xfa273/nightfall-fw/tools/vision/README.md

# Video trajectory and turn-tuning tools

The operational design, current limitations, and hardware-side next steps are
documented in
[`docs/SMARTPHONE_TURN_TUNING.md`](../../docs/SMARTPHONE_TURN_TUNING.md).

Reusable tools in this directory are:

- `aruco_trajectory.py`: carried-ArUco reference extractor for the existing
  8×8 test board
- `markerless_trajectory.py`: fixed board markers plus blue centre and red front
  labels; no vehicle ArUco marker is used
- `extract_board_metric_lattice.py`: detects the full-board flush calibration
  dot lattice after four-marker frame registration
- `fit_board_metric_geometry.py` / `board_metric_geometry.py`: fit and apply a
  held-out-qualified canonical-pixel to board-mm map
- `verify_board_metric_geometry.py`: rejects a moved or changed rig by checking
  a new lattice observation against the qualified map
- `fit_front_label_heading.py`: fits the fixed image-space bias caused by a
  height difference between the two vehicle labels; local diagnostic only
- `label_plane_geometry.py`: validated ray/plane correction shared by fit,
  application, and downstream safety gates
- `fit_label_plane_camera.py`: fits fixed-camera centre/height from four
  stationary board-spanning poses plus one independent held-out pose
- `apply_label_plane_geometry.py`: creates blue-10-mm/red-2-mm corrected
  trajectories without overwriting the apparent reference-plane CSV
- `trajectory_calibration.py`: verifies the corrected trajectory and every
  bound board/tracking/camera-calibration SHA before safety analysis
- `desk_green_pair_probe.py`: raw-pixel feasibility probe that tracks the two
  separated green PCB regions before a marked maze fixture is available
- `generate_fixed_aruco_print_pack.py`: print-ready A4 PDF and vector SVG
  generator for the four fixed maze-plane markers
- `video_timing_qa.py`: checks encoded frame PTS cadence, gaps, and identical
  192-pixel-wide grayscale fingerprints of decoded neighbors
- `fuse_trace_video.py`: aligns video yaw rate or speed with a firmware trace
- `board_layout.py`: validates a measured fixed-marker/grid layout in mm
- `android_camera_probe/`: Camera2 capability probe, experimental HFR recorder,
  and Xiaomi stock-camera slow-motion collector
- `../tuning/turn_video_tune.py`: converts video endpoints to the firmware turn
  frame and prints a bounded candidate without editing source files

The Android real-time HFR recorder and framed F413 optical START/STOP protocol
are implemented. The Pixel classifies the complete synchronized five-slot
short/long codeword before applying the expected recorder state; markerless
body motion remains diagnostic rather than a hard gate.
Pixel 8 has passed a preview plus 1080p/240
manual-exposure recording trial with per-frame-rate CaptureResult metadata,
and both optical edges passed a stationary no-motor integration trial;
the tested Xiaomi 13 Ultra firmware rejects all public Camera2 constrained-HFR
sessions.
The more-than-four-marker solver, multi-LED solver, session-wide QA runner,
trace-phase segmentation, and whole-path fitter are not implemented yet.

## Host setup and timing QA

FFmpeg supplies frame PTS and ADB is used for the static Android probe.
Create the persistent, Git-ignored Python environment with:

```sh
brew install ffmpeg
brew install --cask android-platform-tools
tools/vision/setup_host.sh
```

The Android build additionally needs JDK 17, Android command-line tools, API
36, and build-tools 36.0.0.

The probe additionally needs SDK packages `platforms;android-36` and
`build-tools;36.0.0`; see
[`android_camera_probe/README.md`](android_camera_probe/README.md).

Check an expected real-time 120 fps file before pose extraction:

```sh
./.venv-vision/bin/python tools/vision/video_timing_qa.py \
  /path/to/capture.mp4 \
  --expected-fps 120 \
  --fps-tolerance-percent 1.0 \
  --maximum-gap-rate 0.001 \
  --maximum-cadence-deviation-percent 10 \
  --maximum-cadence-deviation-rate 0.001 \
  --maximum-content-duplicate-rate 0.001 \
  --report-json /path/to/timing_report.json
```

This checks encoded PTS, both short and long cadence deviations, and exact
equality of decoded frames after resizing them to at most 192 pixels wide and
converting them to grayscale. It is not a full-resolution, full-colour byte
comparison. It cannot prove sensor capture rate or detect all duplicated,
interpolated, or retimed frames. A production recorder must save sensor
timestamp, frame duration, exposure, ISO, rolling-shutter skew, and the
encoded-PTS mapping in a sidecar.

For the Xiaomi stock-camera fallback, use:

```sh
tools/vision/android_camera_probe/collect_stock_slowmo.sh \
  "$SERIAL" /path/to/session-artifacts
```

The collector waits for a new stock Camera MP4, validates the
`com.android.capture.fps` tag, and runs the same timing/content QA. The tested
1080p/240 Xiaomi clip contained 2,823/2,823 valid decoded frames, measured
239.981 fps median PTS cadence, no large PTS gaps, and no identical adjacent
decoded frames.

## Unmarked desk feasibility probe

Before the marked maze fixture is ready, a short hand-moved desk clip can
check whether the green PCB remains visible:

```sh
./.venv-vision/bin/python \
  tools/vision/desk_green_pair_probe.py /path/to/stock_hfr.mp4 \
  --output-dir /path/to/desk-probe \
  --render-fps 60
```

The current Nightfall body presents two separated green PCB components. The
probe pairs them using component area, rigid separation, and motion prediction;
their midpoint is the raw-pixel position and their line is an undirected
heading. The desk test on Xiaomi 13 Ultra tracked all 2,823 frames even with a
hand partly occluding the mouse. Median pair separation was 148.6 px.

Outputs are `trajectory_image_px.csv`, `trajectory_image_px.png`, an optional
annotated MP4, and `desk_green_pair_report.json`. These values have no metric
scale, board homography, lens correction, or absolute front/back direction.
They prove visibility only. Use fixed perimeter markers and
`markerless_trajectory.py` for maze measurements.

## Markerless vehicle pose

`markerless_trajectory.py` never detects a carried ArUco ID. Its current
pipeline is:

1. per-frame rectification from the fixed board markers;
2. a narrow blue-colour mask for the 8 mm circular vehicle-centre label;
3. expected metric area, circularity, and temporal prediction to distinguish
   the label from the bluer optical START/STOP LEDs;
4. an 8 mm red label 24 mm in front of the blue label, with expected area,
   baseline, circularity, and temporal prediction to reject red walls and the
   rear status LED;
5. the directed blue-to-red vector as the primary heading measurement;
6. a 41-frame temporal-median background plus the green PCB to estimate the
   body silhouette;
7. the legacy red body-centroid cue and gated foreground principal axis as
   heading fallbacks.

### Full-board metric calibration

The four outer markers are a registration frame, not by themselves a dense
metric calibration. A homography can make all four marker centres exact while
the interior remains wrong because of a measured-layout scale error, lens
distortion, or a non-flat support. This failure was observed on the current
8x8 rig: four ruler-placed blue-label positions were reported 26--30 mm inward
near the corners. The cause was then measured directly with the 90 mm
orthogonal centre-line grid: marker IDs 6/4/5/7 lie on the four outer grid
intersections, so their centres span 720 mm, not the previously declared
780 mm. `board_layout_8x8_60mm.json` now records ID6=(0,0), ID4=(720,0),
ID5=(0,720), and ID7=(720,720) mm. Artifacts bound to the earlier layout SHA
are intentionally invalidated and remain diagnostic-only.

The permanent orthogonal lines provide a quick repeatable distortion check:

```sh
./.venv-vision/bin/python tools/vision/probe_board_line_grid.py \
  path/to/empty-board.mp4 \
  --board-layout tools/vision/data/board_layout_8x8_60mm.json \
  --output-dir path/to/line-grid-probe
```

The tool fixes the ambiguous outer chalk-line peaks to the four detected
marker centres, measures the seven interior lines and local pitch across the
field, and reports global scale separately from residual non-uniformity. Its
residual includes hand-drawn-line error, board flatness, and detector error;
it is a diagnostic and does not by itself produce a safety-qualified metric
map.

Install a distributed reference pattern before using the camera for absolute
turn clearance. The preferred permanent pattern is one matte white circular
mark, 8 mm diameter, centred in every 90 mm half-cell: `(45+90*i,45+90*j)` mm
for `i,j=0..7`. Use a flush vinyl/paint/inlay surface; a raised calibration
piece changes parallax and must declare its measured absolute height. Cell
centres stay 45 mm from maze walls and are less likely to merge with white wall
tops than boundary lines. Periodic lines can also work, but equal lines have
ambiguous correspondences, are occluded by walls, and their elevated wall-top
edges are not coplanar. If lines are used, retain the four unique ArUco anchors
and add indexed/double marks so every detected intersection has a unique grid
coordinate.

Capture one stationary, empty-board 0.5.7 clip without moving the camera or
outer markers. Extract at least 32 of the 64 dots, including at least eight
automatically reserved held-out points:

```sh
./.venv-vision/bin/python tools/vision/extract_board_metric_lattice.py \
  path/to/lattice.mp4 \
  --board-layout tools/vision/data/board_layout_8x8_60mm.json \
  --output-csv path/to/board_metric_observations.csv
```

Inspect the generated overlay: every label must name the actual cell centre.
Then copy `tools/vision/data/board_metric_fit_manifest.template.json`, point it
at the observations, set the physical reference-plane height, and fit:

```sh
./.venv-vision/bin/python tools/vision/fit_board_metric_geometry.py \
  path/to/board_metric_fit_manifest.json \
  --output path/to/board_metric_geometry.json
```

The output is safety-qualified only with 32+ full-board points, 8+ independent
held-out points, fit p95 <=0.75 mm, held-out p95 <=1.0 mm, and held-out maximum
<=1.5 mm. Four corner mouse placements are useful for diagnosing the present
scale error but cannot qualify this map. Pass the qualified artifact to normal
extraction:

```sh
./.venv-vision/bin/python tools/vision/markerless_trajectory.py \
  path/to/capture.mp4 \
  --board-layout tools/vision/data/board_layout_8x8_60mm.json \
  --board-metric-geometry path/to/board_metric_geometry.json \
  --position-source label --label-colour blue \
  --front-label-colour red --cue-colour none
```

The corrected `x_mm/y_mm` and their derivatives then come from the dense map;
canonical pixels remain in the CSV for audit. Add the same
`board_metric_geometry` path to the known-pose label-plane manifest and pass
`--board-metric-geometry` to `apply_label_plane_geometry.py`. Metric mapping
must be qualified before the 10/2 mm label-height fit; otherwise camera-plane
parameters absorb a board scale error and become physically meaningless.
If the dots remain on the maze, extract them from an empty/background clip
after any camera or maze handling and compare against the stored map:

```sh
./.venv-vision/bin/python tools/vision/verify_board_metric_geometry.py \
  path/to/board_metric_geometry.json \
  path/to/current_board_metric_observations.csv \
  --output-json path/to/board_metric_verification.json
```

This requires 32 matched points including eight held out and rejects p95 above
1.0 mm or maximum error above 1.5 mm. Treat failure as a moved rig/board/marker
or damaged pattern and recalibrate before accepting trajectories.

For a future removable target, a rigid ChArUco/dot plate covering the full
board is preferable to hand-drawn lines. It must lie on a measured plane and
the rig must not move after removal. A dedicated low-distortion global-shutter
camera is the next hardware step if calibrated Pixel data still fail the 1 mm
held-out gate; it reduces rolling-shutter and focus-breathing risk, but does not
remove the need for the same full-board calibration.

The blue label is the default position source. Its position and the two-label
heading stay valid even when green-PCB or body extraction fails. This is still
not a general colour tracker: the HSV/channel gates were measured for the
current Pixel 8 exposure, lighting, and labels. Revalidate them after changing
label material, camera processing, or illumination. Maximum yaw rate gates
`heading_valid` independently of position validity. `qa_report.json` records
both label detection rates, areas, observed baseline, selected heading source,
and the applied heading calibration.

The measured `mini_r2_0_unit001` label surfaces are not coplanar: the blue
centre label is 10 mm above the maze floor and the red front label is 2 mm
above it. The old homography reference was the 3D-printed ArUco top surface,
also 2 mm above the floor; it left red unchanged but displaced blue. The new
dense board metric reference is the flush maze floor at 0 mm, so both red and
blue are corrected from their measured 2/10 mm planes. The blue-to-red yaw
error changes across the field of view. `fit_front_label_heading.py` can still fit an older constant
image-space bias, but that result is a local diagnostic only. Do not apply it
in the absolute position/yaw or swept-clearance workflow below.

For full-board correction, use the measured heights and a stationary known-pose
calibration. The current 3D-printed ArUco markers have a user-confirmed common
top surface 2.0 mm above the maze floor, but they are registration anchors only.
With flush painted/inlaid lattice dots, set the qualified board-metric reference
plane to the maze floor at 0.0 mm; the red label is corrected by 2.0 mm and the
blue label by 10.0 mm. A raised removable target must instead declare its own
measured absolute height. Keep the camera
and markers fixed, then record at least five stationary poses spanning the
camera field. A practical 8x8 set is:

- fit: blue centre `(45,45)` mm, heading `0 deg`;
- fit: `(675,45)` mm, heading `180 deg`;
- fit: `(45,675)` mm, heading `0 deg`;
- fit: `(675,675)` mm, heading `180 deg`;
- held-out validation: `(315,405)` mm, heading `90 deg`.

Use a placement jig so the blue centre and cardinal heading are known. The
poses may be non-overlapping holds in one continuous video or five independent
manual one-shot captures. Every pose must be held still for at least three
seconds and its `start_s`/`end_s` interval must be recorded. Use the
same fixed camera, marker layout, Camera2 physical lens/crop/zoom, fixed
1.05-diopter focus, and recording profile as the runs the calibration will
qualify. Absolute qualification requires HFR Recorder 0.5.7 or newer. Recorder
0.5.6 introduced much of the Camera2 geometry metadata, but it does not satisfy
the final same-run SHA/integrity and fixed-focus contract; 0.5.6 and earlier
captures remain diagnostic-only. A qualified 0.5.7 capture must report AF off,
the requested 1.05-diopter focus, stationary and unchanged per-frame lens
metadata, and a matching camera-setup fingerprint.
The manifest schema is `nightfall_label_plane_known_pose_manifest_v3`; it names
the committed board layout, the measured footprint/tracking geometry, the
absolute ArUco reference-plane height, each trajectory interval, and the
`nightfall_camera_capture_session_v1` artifact set used to prove the camera,
physical lens, crop, zoom, raw video, QA, and source trajectory are coherent.
Fit the camera geometry with:

```sh
./.venv-vision/bin/python tools/vision/fit_label_plane_camera.py \
  path/to/known_pose_manifest.json \
  --output path/to/label_plane_geometry.json
```

Copy `tools/vision/data/label_plane_known_pose_manifest.template.json`, replace
the qualified `board_metric_geometry`, the six paths in every placement's
`capture_session`, its matching trajectory, and the five time windows. Its
0.0 mm reference is valid only for a flush floor pattern. If separate captures are used, all five
fingerprints must have the same `camera_setup_sha256`; the fit fails closed on
any camera, lens, focus, crop, zoom, or recording-profile difference. Start each
0.5.7 manual one-shot first, wait at least one second for the fixed-focus camera
pipeline and scene to settle, and only then begin its three-second pose hold.

The fit requires four spatially distinct non-collinear positions spanning at
least 400 mm in both axes and 120000 mm² of convex-hull area, plus an independent
held-out position inside that hull. It fails closed unless stationary
stability, fit residual, and held-out error are
within the recorded limits. It implements the ray/plane relationship
`P=C+(H-h)/(H-h_ref)*(Q-C)` separately for blue and red. The committed board
layout corresponding byte-for-byte to the current 60 mm-marker setup is
`tools/vision/data/board_layout_8x8_60mm.json`.

After qualification, existing trajectory CSVs can be corrected without
decoding their videos again because they retain both rectified label centres:

```sh
./.venv-vision/bin/python tools/vision/apply_label_plane_geometry.py \
  path/to/trajectory.csv \
  --board-layout tools/vision/data/board_layout_8x8_60mm.json \
  --board-metric-geometry path/to/board_metric_geometry.json \
  --tracking-geometry tools/tuning/data/mini_r2_0_footprint.json \
  --label-plane-geometry path/to/label_plane_geometry.json \
  --capture-session-manifest path/to/this_run_capture_session.json \
  --confirm-unchanged-camera-board-setup
```

This writes a new `*_height_corrected.csv` and a hash-bound calibration
sidecar; it never overwrites the apparent reference-plane trajectory.
Parameter proposals and absolute-clearance checks require the matching
sidecar. The capture-session manifest binds and revalidates this run's report,
Camera2 rows, raw video, QA, trajectory, and board calibration. The report's
artifact-integrity SHA-256 values must identify the same-run raw video and
Camera2 sidecar, QA must bind that video and trajectory, and every referenced
artifact is independently hash-bound by the capture fingerprint. Its physical
camera/lens/crop/zoom/fixed-focus setup fingerprint must match the stationary
calibration.
Repeat the stationary calibration after moving the camera or markers, changing
crop or lens selection, or changing either label height. The confirmation
option remains an explicit assertion that the rigid camera-to-board pose was
not moved; metadata can prove the camera configuration but not that physical
rig transform by itself. Do not use it across a moved rig.

For a parameter proposal, all five repeats must use height-correction sidecars
that bind the same board layout, tracking geometry, and label-plane geometry.
The proposal path fixes the tracked anchor at zero (the blue centre is the
machine/turn centre) and does not allow its five-repeat, valid-fraction,
repeatability, or bounded-step limits to be weakened from the command line.

Without `--background-video`, the median background assumes that the vehicle
does not occupy the same pixel in half or more of the sampled run frames.
Prefer a separate empty-maze clip captured with unchanged camera/exposure.

The legacy fixed-marker transform is specific to the existing test board:

- IDs 5, 7, 4, and 6 are top-left, top-right, bottom-right, and bottom-left.
- Only 5, 4, and 6 enter the homography. ID 7 is detection-count QA only.
- Marker centers are assumed to form a square, all markers have the same
  orientation and size, and with the defaults the black-side/center-span ratio
  must be about 4.95%.

Do not place arbitrary perimeter markers and treat the legacy transform as
metric. New setups should copy and then replace the measured values in
`board_layout_4x4_example.json`. Its `nightfall_vision_board_layout_v1` schema
maps marker center, black-side length, rotation, and the analysis grid in mm.
With a measured layout and all four markers visible, the solver uses the four
marker centres. This prevents frame-to-frame switching between incompatible
corner and centre fits in the presence of lens distortion. If a measured
marker is hidden, the bounded fallback first attempts a corner RANSAC with at
least three markers. Legacy mode still uses IDs 5, 4, and 6 for homography and
treats ID 7 as QA-only.
Coordinates are +x right and +y forward/up in the rectified view. At
`rotation_deg: 0`, every printed marker's top edge faces +y and its top edge
runs left-to-right along +x; positive rotation is counter-clockwise in the
maze plane. `canvas_bounds_mm` must be square because the canonical output uses
one metric scale on both axes.

The example's `-55..775 mm` bounds are an 830 mm analysis crop, not a paper
edge, fixture edge, or required-FOV edge. The outer black marker edges reach
`-50..770 mm`. Provide at least 7 mm of white quiet zone outside them; 10 mm is
recommended, giving an approximately 840 mm physical visible span. Add vehicle
travel and placement margin beyond that when selecting the camera FOV.

Generate the fixed-marker print pack with:

```sh
./.venv-vision/bin/python tools/vision/generate_fixed_aruco_print_pack.py
```

The A4 PDF has a recommended 60 mm black-side page and a compact 40 mm page.
Print exactly one page at `100%` / `Actual Size`; do not mix sizes. Verify the
printed 100 mm scale line and measure the black outer square. The four distinct
`DICT_4X4_50` markers are ID 5 top-left, ID 7 top-right, ID 4 bottom-right, and
ID 6 bottom-left. Keep at least the supplied white quiet zone and place all
four marker faces coplanar. The current 3D-printed set has a measured common
top-surface height of 2.0 mm above the maze floor; use 2.0 mm as the label-plane
reference height. A paper/flush marker or a changed fixture requires a new
height measurement and stationary calibration.

For 1080-pixel short-side video, aim for at least 40 pixels across a marker's
black side:

```text
black_side_mm >= visible_short_span_mm * 40 / 1080
```

Thus, 60 mm is suitable up to about a 1.5 m visible short-side span. A wider
view, such as a complete full-size 16x16 maze, needs larger markers and a
different print layout.

For a measured 4×4 setup, run:

```sh
./.venv-vision/bin/python \
  tools/vision/markerless_trajectory.py /path/to/capture.mp4 \
  --board-layout /path/to/board_layout.json \
  --background-video /path/to/empty_background.mp4 \
  --position-source label \
  --label-colour blue \
  --label-diameter-mm 8 \
  --front-label-colour red \
  --front-label-diameter-mm 8 \
  --front-label-distance-mm 24 \
  --cue-colour none \
  --maximum-missing-fraction 0.01
```

This command produces the apparent reference-plane trajectory. For absolute
analysis, do not add the legacy constant-bias calibration; run the qualified
five-pose fit and `apply_label_plane_geometry.py` workflow above instead.

For a one-label position-only analysis, set `--front-label-colour none` and add
`--position-only`. That mode exports any fallback heading but does not make an
unreliable foreground heading accurate. A two-label run does not require the
empty-maze background for its primary position and heading; the background is
still useful for body/fallback diagnostics.

In legacy mode without `--board-layout`, `--grid-cells` is the number of
visible analysis-grid pitches, not the nominal cell count of the complete
maze. A view containing 4×4 standard 180 mm cells has eight 90 mm pitches and
uses `--grid-cells 8 --cell-size-mm 90 --cell-size-confirmed`.

`--cue-yaw-offset-deg` must be calibrated for the chosen cue. The anchor passed
to `turn_video_tune.py` has the direction **control reference to tracked
point**, resolved along the vehicle-right and vehicle-forward axes. For a cue
23 mm behind the control reference, use `--anchor-forward-mm -23`, not `+23`.

Use `--position-source green` when the foreground silhouette touches maze
walls and its centroid becomes biased. This tracks the green-PCB centroid and
still uses the foreground principal axis for cue-less heading. The PCB centroid
is not the vehicle control reference, so measure its fixed right/forward offset
and pass the corresponding anchor correction to downstream turn analysis.

For a rigidly mounted camera, a hand may briefly hide multiple board markers
while starting the vehicle. In that case, set both
`--maximum-consecutive-homography-fallback-frames` and
`--maximum-homography-fallback-fraction` to explicit bounded values. The
tracker reuses the last marker-supported transform during that interval. Keep
the default five-frame consecutive limit when the camera can move.

The board transform alone does not remove lens distortion or height parallax.
The qualified label-plane workflow above corrects the measured 10/2 mm height
planes and uses full-board fit plus held-out residual gates; any residual lens
distortion is included in those measured errors and the downstream position
uncertainty. A future explicit lens-undistortion stage must be recalibrated as
a different pipeline rather than mixed with an existing geometry artifact.

On `IMG_1592.mov`, fixed board markers were the only pose-estimation markers and
ID 3 was used only as post-hoc ground truth. The prototype tracked all 515
frames; a stationary calibration followed by active-run hold-out evaluation
gave about 6.3 mm position RMSE and 4.0 degrees yaw RMSE. This 720p/30 fps
one-video result establishes feasibility only and does not meet the intended
automatic-tuning gate: its detected start pose window has a 21.4 mm/s median
speed and is rejected by the default 10 mm/s stationarity limit.

## Trace alignment

Align one short, distinctive turn and require the stricter operational
correlation gate:

```sh
./.venv-vision/bin/python \
  tools/vision/fuse_trace_video.py \
  /path/to/trajectory.csv /path/to/trace.csv \
  --minimum-correlation 0.70 \
  --yaw-sign same \
  --minimum-correlation-margin 0.02 \
  --output-dir /path/to/analysis/fused
```

The output is `/path/to/analysis/fused/fused.csv` plus
`sync_report.json`. The fused CSV keeps every source trace CSV data row and
column, then adds the video measurements. Parsed `#key=value` comment metadata
is stored in `sync_report.json`; blank lines, other comments, and comment order
are not copied to `fused.csv`. Inspect the selected offset, `video_sign`,
second peak margin, signal gain, bias, and RMSE as well as correlation. The
default expects both Nightfall and video yaw to be CCW-positive. An inverted
sign is a calibration failure, not permission to proceed.

Repeated similar turns can produce an ambiguous correlation peak. Motion
correlation is a provisional synchronizer; start/end LED patterns tied to
firmware ticks are the planned robust synchronizer.

## Endpoint candidate

The current candidate tool uses final position and yaw only. It does not use
the fused trace, path shape, duration, or trace phase in the fit.

Use five identical dedicated trials whose motion boundaries match the turn
model and have at least 150 ms of stationary pose before and after. Do not use
an unsegmented run containing approach/exit straights or multiple turns.
The command below hard-gates each 150 ms pose window at 80% time coverage
(at least 120 ms of samples) and at a median speed no greater than 10 mm/s.
These gates do not replace the requirement to record the full stationary
period.

```sh
./.venv-vision/bin/python \
  tools/tuning/turn_video_tune.py \
  trial01/trajectory_height_corrected.csv \
  trial02/trajectory_height_corrected.csv \
  trial03/trajectory_height_corrected.csv \
  trial04/trajectory_height_corrected.csv \
  trial05/trajectory_height_corrected.csv \
  --height-correction-sidecar \
    trial01/trajectory_height_corrected.calibration.json \
  --height-correction-sidecar \
    trial02/trajectory_height_corrected.calibration.json \
  --height-correction-sidecar \
    trial03/trajectory_height_corrected.calibration.json \
  --height-correction-sidecar \
    trial04/trajectory_height_corrected.calibration.json \
  --height-correction-sidecar \
    trial05/trajectory_height_corrected.calibration.json \
  --runner shortest --mode 2 --code 501 \
  --anchor-forward-mm 0 --anchor-right-mm 0 \
  --minimum-valid-fraction 0.99 \
  --minimum-heading-valid-fraction 0.99 \
  --maximum-pose-window-speed-mm-s 10 \
  --minimum-pose-window-coverage 0.8 \
  --minimum-fit-trials 5 \
  --maximum-endpoint-std-mm 2.0 \
  --maximum-yaw-std-deg 1.0 \
  --maximum-turn-yaw-error-deg 30 \
  --vary angle \
  --propose-fit --feedback-gain 0.5 \
  --report-json turn_report.json
```

The zero anchor is exact for the user-confirmed blue label at the coincident
machine/turn centre. `--vary angle` intentionally overrides the fitter's
multi-parameter default for the first staged tuning pass. The fitter prints an
experiment candidate only. It does not edit params, build, flash, spin the fan,
or start a run. Any floor/maze trial requires explicit authorization for that
specific motion under
`docs/ai/HIL_SAFETY.md`.

When unequal label heights make heading depend on board position, trials with
long initial and final straights can instead use `--heading-source trajectory`.
It fits the ordered centre-label path over cumulative-distance fractions
8--32% and 68--92%. The default gates require at least 30 mm projected span and
at most 3 mm p95 perpendicular residual in both fits. Curved or corrupted fit
windows are rejected. This mode uses position only and therefore requires both
anchor offsets to remain zero.

## Carried-ArUco reference extraction

`aruco_trajectory.py` extracts a mouse trajectory from an overhead video of
the Nightfall 8×8 tracking board.

The default layout is:

- ID 5: board top-left
- ID 7: board top-right
- ID 4: board bottom-right
- ID 6: board bottom-left
- ID 3: marker carried by the mouse

The fixed markers provide a per-frame planar transform, so camera drift and
perspective do not appear as mouse motion. The carried marker is tracked from
its known ArUco bit pattern. Green PCB pixels are used only to constrain the
initial search and any low-confidence recovery search.

The transform consistently uses IDs 5, 4, and 6, which span the board and are
readable throughout the supplied recording. ID 7 is still detected and drawn
for QA, but is not mixed intermittently into the transform because glare makes
its detection much less stable.

## Setup

```sh
tools/vision/setup_host.sh
```

## Run

Without a known physical scale:

```sh
./.venv-vision/bin/python tools/vision/aruco_trajectory.py \
  /path/to/video.mov
```

With a 90 mm grid pitch that has not been independently measured:

```sh
./.venv-vision/bin/python tools/vision/aruco_trajectory.py \
  /path/to/video.mov \
  --cell-size-mm 90
```

Add `--cell-size-confirmed` only when the pitch has been measured or otherwise
confirmed. Cell coordinates remain available regardless of metric scale.

The coordinate system has its origin at the bottom-left grid intersection,
with +x to the right and +y upward. Yaw is zero toward +x and increases
counter-clockwise. The default `--yaw-offset-deg 90` matches the ID 3 mounting
in `IMG_1592.mov`; use the measured marker-to-vehicle rotation for other
mountings. The reported position is the marker center, not a separately
calibrated geometric vehicle center.

## Outputs

The default output directory is `<video stem>_trajectory` beside the input:

- `trajectory.csv`: raw and smoothed positions, yaw, velocity, marker score,
  fixed-marker IDs, and homography residual
- `trajectory.png`: time-colored top-view path
- `trajectory_overlay.mp4`: trajectory over the source view
- `trajectory_topview.mp4`: stabilized top view with the trajectory
- `reference_topview.png`: stabilized reference frame
- `calibration.json`: marker/grid coordinate mapping
- `qa_report.json`: detection rates and trajectory quality metrics

Metric columns in the CSV are blank unless `--cell-size-mm` is supplied.
If the local OpenCV build cannot encode MP4, the two videos use `.avi`
instead; `qa_report.json` always records the actual filenames.

Generated CSV, image, JSON, and video files are run artifacts and should stay
outside Git. Only the reusable files under `tools/vision/` belong in the
repository.

## Notes

- The detector uses OpenCV `DICT_4X4_50`. Larger OpenCV 4×4 dictionaries share
  these low-numbered code words, so the exact dictionary used to print the
  markers cannot be inferred from the video alone.
- The planar transform removes camera motion but does not model lens
  distortion. If sub-millimetre accuracy is required, calibrate the camera and
  undistort frames first.
- `--no-videos` skips the two MP4 renders when only numeric output is needed.
