xfa273/nightfall-fw/_sandbox/f413_preorder/README.md

# _sandbox/f413_preorder

このディレクトリは実験・作業途中データの退避用です。

正式な参照先は以下です。

- ハードウェア資料: `hardware/mini_r2_0/`
- F413 CubeMX/platform 素材: `platform/stm32f413/HM_Nightfall_f413_preorder/`

以後の更新は上記の正式ディレクトリ側で実施してください。
