xfa273/nightfall-fw/_sandbox/f413_preorder/cubemx_project/README.md

# _sandbox/f413_preorder/cubemx_project

この配下は旧配置（互換保持）です。

正式な更新先は `platform/stm32f413/HM_Nightfall_f413_preorder/` です。
