xfa273/nightfall-fw/_sandbox/f413_preorder/notes/README.md

# _sandbox/f413_preorder/notes

この配下は旧配置（互換保持）です。

正式な更新先は `hardware/mini_r2_0/` の `cad/` と `notes/` です。
