xfa273/nightfall-fw/hardware/mini_r2_0/notes/kicad/README.md

# KiCad migration notes for mini_r2_0

`HM_Nightfall-mini-2e_v1` を KiCad 10.0.3 で Eagle から初回インポートした結果を保存します。

## 生成ファイル

- `cad/kicad/HM_Nightfall-mini-2e/HM_Nightfall-mini-2e_v1.kicad_pro`
- `cad/kicad/HM_Nightfall-mini-2e/HM_Nightfall-mini-2e_v1.kicad_sch`
- `cad/kicad/HM_Nightfall-mini-2e/HM_Nightfall-mini-2e_v1.kicad_pcb`
- `cad/kicad/HM_Nightfall-mini-2e/HM_Nightfall-mini-2e_v1-eagle-import.kicad_sym`
- `cad/kicad/HM_Nightfall-mini-2e/sym-lib-table`

## 初回チェック結果

- ERC: 46 errors / 88 warnings
- DRC: 544 errors / 306 warnings
- JLCPCB 向けルール適用後 DRC: 4 errors / 112 warnings
- 本体基板は Eagle 原本の `GND` / `GND2` ポリゴンを KiCad ゾーンとして復元済みです。

## JLCPCB 発注データ

- 2026-09-21に本体基板の取付穴4か所をØ1.6 mmへ変更し、周辺配線を調整しました。[更新後の発注用ZIP・加工図](../../cad/export/jlcpcb/main_mount_1p6_20260921/README.md) を使用してください。以下の20260606候補は変更前です。詳細は [MAIN_MOUNT_HOLES.md](MAIN_MOUNT_HOLES.md) を参照してください。
- 旧 Eagle 発注済み Gerber: `cad/export/reference/eagle_ordered_2026-03-22/HM_Nightfall-mini-2e_v1_eagle_ordered_2026-03-22.zip`
- KiCad 正式候補 Gerber: `cad/export/jlcpcb/HM_Nightfall-mini-2e_v1_kicad_jlcpcb_candidate_20260606/HM_Nightfall-mini-2e_v1_kicad_jlcpcb_candidate_20260606.zip`
- Eagle 参照アーカイブ: `cad/export/reference/eagle_archive_20260606/mini_r2_0_eagle_sources_20260606.zip` / `mini_r2_0_eagle_exports_20260606.zip`
- KiCad 正式候補は JLCPCB Gerber Viewer で旧 Eagle 発注データと比較し、外形・穴・主要配線・旧 `GTO` 相当のトップシルクが概ね一致することを確認済みです。
- Eagle 参照アーカイブには、本体基板・左右エンコーダ基板・ST-LINK変換基板・UART変換基板の Eagle 原本、CAM出力、ドリル、ネットリスト、部品表、ボード画像を保存しています。

## レビュー方針

- 初回インポート直後の ERC/DRC 違反は変換レビュー対象として残します。
- 回路図では未接続ピン、未解決テキスト変数、電源駆動、フットプリントライブラリ参照を優先確認します。
- PCBではクリアランス、外形、GNDポリゴン、モータドライバ周辺、SWD/UART、IMU/FRAM SPI2 周辺を優先確認します。
- レビュー完了までは Eagle 原本を併存させます。
- 詳細な分類と優先度は `REVIEW.md` に記録します。

## サブ基板

### 2026-09-21: エンコーダ端子の半穴化

左右エンコーダ基板のKiCad PCBを編集正として、端の4端子を
Ø0.30 mmのめっき半穴と表裏ランドへ変更しました。
外形を維持するための特殊加工案です。寸法、DRC差分、製造照会条件は
[ENCODER_CASTELLATED_PADS.md](ENCODER_CASTELLATED_PADS.md)を参照してください。
以下の初回レポートとEagleアーカイブは変更前の記録です。

以下の Eagle 原本は本体基板とは独立した小基板として、KiCad でも 1 基板 1 プロジェクトで管理します。

| 用途 | Eagle 原本 | KiCad 出力先 |
| --- | --- | --- |
| 左エンコーダ基板 | `cad/eagle/HM_Nightfall-mini-2e_Encoder-PCB-L_v1.sch` / `.brd` | `cad/kicad/HM_Nightfall-mini-2e_Encoder-PCB-L/` |
| 右エンコーダ基板 | `cad/eagle/HM_Nightfall-mini-2e_Encoder-PCB-R_v1.sch` / `.brd` | `cad/kicad/HM_Nightfall-mini-2e_Encoder-PCB-R/` |
| ST-LINK 変換基板 | `cad/eagle/STLink-Adapter.sch` / `.brd` | `cad/kicad/STLink-Adapter/` |
| UART 変換基板 | `cad/eagle/UART-Adapter.sch` / `.brd` | `cad/kicad/UART-Adapter/` |
| WeAct 5 V変換基板 | ST-LINK変換基板から派生 | `cad/kicad/WeAct-Adapter-5V/` |

### 左エンコーダ基板 初回チェック結果

- ERC: 7 errors / 7 warnings
- DRC: 12 errors / 13 warnings
- JLCPCB 向けルール適用後 DRC: 10 errors / 0 warnings

### 右エンコーダ基板 初回チェック結果

- ERC: 6 errors / 7 warnings
- DRC: 5 errors / 12 warnings
- JLCPCB 向けルール適用後 DRC: 10 errors / 0 warnings

### ST-LINK 変換基板 初回チェック結果

- ERC: 3 errors / 5 warnings
- DRC: 40 errors / 6 warnings
- JLCPCB 向けルール適用後 DRC: 0 errors / 26 warnings

### UART 変換基板 初回チェック結果

- ERC: 4 errors / 8 warnings
- DRC: 39 errors / 35 warnings
- JLCPCB 向けルール適用後 DRC: 0 errors / 26 warnings

### WeAct 5 V変換基板 チェック結果

- KiCad 10.0.3で設計
- ERC: 3 errors / 6 warnings（Eagleインポート由来の既知事項）
- DRC: 0 errors / 26 warnings、未配線0（警告数はST-LINK変換基板と同じ）
- 発注用Gerber: `cad/kicad/WeAct-Adapter-5V/fabrication/WeAct-Adapter-5V-gerbers.zip`
