xfa273/nightfall-fw/docs/blog/machines/nightfall-air-2025/README.md

# Nightfall-Air (2025)

## 写真

（ここに写真を挿入）

## スペック

| 項目 | 内容 |
| --- | --- |
| 機体名 | Nightfall-Air |
| 主な大会結果 | （編集してください） |
| 寸法 | （編集してください） |
| 重量 | （編集してください） |
| モータ | （編集してください） |
| バッテリ | （編集してください） |
| マイコン | （編集してください） |
| IMU | （編集してください） |
| モータドライバ | （編集してください） |
| 紹介記事 | （関連する記事リンクを追記してください） |

## コメント

（ここにコメントを記載）
