xfa273/nightfall-fw/hardware/mini_r2_0/cad/export/jlcpcb/main_mount_1p6_20260921/README.md

# 本体基板 発注用データ（取付穴 Ø1.6 mm、2026-09-21）

`HM_Nightfall-mini-2e_v1` の取付穴4か所をØ1.6 mmに変更した基板製造用データです。

- [発注用ZIP](HM_Nightfall-mini-2e_v1_mount-1p6_order_20260921.zip)
- [加工図PDF（ZIPにも同梱）](HM_Nightfall-mini-2e_v1_mount-1p6_fabrication.pdf)

発注先へ提出するファイルは上記ZIPです。20260606版の本体発注候補ZIPを置き換えるものです。
左右Encoder基板のZIPとは混ぜず、別の基板設計として提出してください。
単板の裸基板データで、面付け・実装BOM・実装座標・ペースト層は含みません。

## 内容物（14ファイル）

- Gerber 7層: 表裏銅箔、表裏レジスト、表裏シルク、外形
- Excellon 2ファイル: めっき穴199個、非めっき穴Ø0.9 mmを2個
- `-job.gbrjob`: レイヤー対応・基板設定
- `docs/` 内: 加工図PDF、英語加工指定、出力元・SHA-256を記録したmanifest
- `SHA256SUMS.txt`: 内容物のチェックサム

**Ø1.6 mmの取付穴4個は、非めっきの内形として外形Gerberに含まれます。**
Excellonには含まれないため、ドリル穴数へ重複して追加しないでください。
上側2穴と基板端の残り幅は各0.20 mmです。この寸法と加工時の保持条件を
同梱の加工図・英語指定文で発注先へ伝えます。

## 発注設定

- 2層FR-4、外形の概寸39 × 70 mm、元PCBの板厚設定は1.60 mm。
- 銅厚・レジスト色・表面処理は発注時に指定してください。jobの銅厚35 µmは
  KiCadの既定値、`Finish: None` は表面処理未指定を表します。
- 表シルクは以前の発注候補で確認済みのEagle由来データを、そのまま継承しています。
  裏シルクは空です。KiCadインポート時の大きな部品参照番号は使っていません。
- 全レイヤーは共通の絶対原点です。裏面を個別に反転しないでください。

## 出力元と検証

- ソースcommit: `e2ba19b74438`。PCB、プロジェクト、ルール、継承シルクの
  元ファイルパス・SHA-256はZIP内の `docs/SOURCE_MANIFEST.json` に収録。
- KiCad 10.0.3で銅箔・レジスト・外形・ドリルを再出力。今回PCB自体は変更していません。
- 変更後に確認したCAMとの銅箔・レジスト・外形の一致、Ø1.6 mm円4個、
  めっき/非めっき穴数、移動したBOOT0ビアの新座標を確認。
- 継承シルクと拡大穴が重ならないことを確認（最小間隔0.1969 mm）。
- DRCは既存エラー4件・警告112件・未配線0件で、新規違反0件。
  既存エラーはC14の外形クリアランス2件とU5のサーマル接続不足2件。
- 加工図を描画して確認し、ZIPのCRC、全チェックサム、同梱PDFと単独PDFの一致を検証。
- 取付強度・実物の組付け・発注先の加工承認は未確認。発注・決済は行っていません。

寸法・配線変更の詳細は [設計記録](../../../../notes/kicad/MAIN_MOUNT_HOLES.md) を参照してください。
