xfa273/nightfall-fw/hardware/mini_r2_0/cad/export/jlcpcb/HM_Nightfall-mini-2e_v1_kicad_jlcpcb_candidate_20260606/README.md

# KiCad JLCPCB candidate 2026-06-06

This directory stores the KiCad-generated JLCPCB candidate Gerber data for `HM_Nightfall-mini-2e_v1`.

- Zip: `HM_Nightfall-mini-2e_v1_kicad_jlcpcb_candidate_20260606.zip`
- Generated with KiCad 10.0.3 from `hardware/mini_r2_0/cad/kicad/HM_Nightfall-mini-2e/HM_Nightfall-mini-2e_v1.kicad_pcb`
- Top silkscreen is based on the previously ordered Eagle `GTO`, translated to KiCad Gerber coordinates.
- Bottom silkscreen is based on the previously ordered Eagle `GBO`, which is effectively empty.

JLCPCB Gerber Viewer comparison against the previous Eagle order showed matching board outline, drills, major routing, and top silkscreen placement.
