xfa273/nightfall-fw/hardware/mini_r2_0/notes/kicad/HM_Nightfall-mini-2e_v1.erc-report.txt

ERC report (2026-06-06T14:10:01, Encoding UTF8)
Report includes: Errors, Warnings, Exclusions

***** Sheet /
[wire_dangling]: Wires not connected to anything
    ; error
    @(91.44 mm, 137.16 mm): 水平ワイヤー, 長さ 5.08 mm
    @(86.36 mm, 137.16 mm): 垂直ワイヤー, 長さ 2.54 mm
[pin_not_connected]: Pin not connected
    ; error
    @(91.44 mm, 193.04 mm): Symbol U5 ピン 33 [PA12, 双方向, ライン]
[pin_not_connected]: Pin not connected
    ; error
    @(91.44 mm, 215.90 mm): Symbol U5 ピン 40 [PB4, 双方向, ライン]
[pin_not_connected]: Pin not connected
    ; error
    @(91.44 mm, 299.72 mm): Symbol U3 ピン 11 [CM1, 出力, ライン]
[pin_not_connected]: Pin not connected
    ; error
    @(91.44 mm, 302.26 mm): Symbol U3 ピン 7 [CM2, 出力, ライン]
[pin_not_connected]: Pin not connected
    ; error
    @(91.44 mm, 307.34 mm): Symbol U3 ピン 12 [NFAULT, 出力, ライン]
[pin_to_pin]: ピンのタイプ 出力 と 出力 が接続されています
    ; error
    @(91.44 mm, 312.42 mm): Symbol U3 ピン 1 [OUT1_2, 出力, ライン]
    @(91.44 mm, 314.96 mm): Symbol U3 ピン 10 [OUT1, 出力, ライン]
[pin_to_pin]: ピンのタイプ 出力 と 出力 が接続されています
    ; error
    @(91.44 mm, 317.50 mm): Symbol U3 ピン 3 [OUT2_2, 出力, ライン]
    @(91.44 mm, 320.04 mm): Symbol U3 ピン 8 [OUT2, 出力, ライン]
[unresolved_variable]: Unresolved text variable
    ; error
    @(93.98 mm, 373.38 mm): シンボル TP1 [TPB1,27]
[unresolved_variable]: Unresolved text variable
    ; error
    @(93.98 mm, 378.46 mm): シンボル TP3 [TPB1,27]
[unresolved_variable]: Unresolved text variable
    ; error
    @(96.52 mm, 381.00 mm): シンボル TP4 [TPB1,27]
[pin_not_connected]: Pin not connected
    ; error
    @(109.22 mm, 43.18 mm): Symbol U6 ピン 7 [DNU, パッシブ, ライン]
[wire_dangling]: Wires not connected to anything
    ; error
    @(114.30 mm, 50.80 mm): 水平ワイヤー, 長さ 35.56 mm
[unresolved_variable]: Unresolved text variable
    ; error
    @(137.16 mm, 370.84 mm): シンボル EC_L1 [PTR1TP06SQ]
[unresolved_variable]: Unresolved text variable
    ; error
    @(142.24 mm, 370.84 mm): シンボル EC_L2 [PTR1TP06SQ]
[unresolved_variable]: Unresolved text variable
    ; error
    @(147.32 mm, 370.84 mm): シンボル EC_L3 [PTR1TP06SQ]
[power_pin_not_driven]: Input Power pin not driven by any Output Power pins
    ; error
    @(137.16 mm, 373.38 mm): Symbol EC_L1 ピン TP [TP, 入力, ライン]
[unresolved_variable]: Unresolved text variable
    ; error
    @(152.40 mm, 370.84 mm): シンボル EC_L4 [PTR1TP06SQ]
[power_pin_not_driven]: Input Power pin not driven by any Output Power pins
    ; error
    @(142.24 mm, 373.38 mm): Symbol EC_L2 ピン TP [TP, 入力, ライン]
[pin_not_connected]: Pin not connected
    ; error
    @(154.94 mm, 63.50 mm): Symbol U4 ピン 11 [SDO_AUX, 双方向, ライン]
[pin_not_connected]: Pin not connected
    ; error
    @(154.94 mm, 66.04 mm): Symbol U4 ピン 10 [OCS_AUX, 双方向, ライン]
[pin_not_connected]: Pin not connected
    ; error
    @(190.50 mm, 45.72 mm): Symbol U4 ピン 4 [INT1, 出力, ライン]
[pin_not_connected]: Pin not connected
    ; error
    @(190.50 mm, 48.26 mm): Symbol U4 ピン 9 [INT2, 出力, ライン]
[pin_not_connected]: Pin not connected
    ; error
    @(190.50 mm, 299.72 mm): Symbol U2 ピン 11 [CM1, 出力, ライン]
[pin_not_connected]: Pin not connected
    ; error
    @(190.50 mm, 302.26 mm): Symbol U2 ピン 7 [CM2, 出力, ライン]
[pin_not_connected]: Pin not connected
    ; error
    @(190.50 mm, 307.34 mm): Symbol U2 ピン 12 [NFAULT, 出力, ライン]
[pin_to_pin]: ピンのタイプ 出力 と 出力 が接続されています
    ; error
    @(190.50 mm, 312.42 mm): Symbol U2 ピン 1 [OUT1_2, 出力, ライン]
    @(190.50 mm, 314.96 mm): Symbol U2 ピン 10 [OUT1, 出力, ライン]
[pin_to_pin]: ピンのタイプ 出力 と 出力 が接続されています
    ; error
    @(190.50 mm, 317.50 mm): Symbol U2 ピン 3 [OUT2_2, 出力, ライン]
    @(190.50 mm, 320.04 mm): Symbol U2 ピン 8 [OUT2, 出力, ライン]
[wire_dangling]: Wires not connected to anything
    ; error
    @(256.54 mm, 220.98 mm): 垂直ワイヤー, 長さ 15.24 mm
    @(256.54 mm, 205.74 mm): 水平ワイヤー, 長さ 7.62 mm
[wire_dangling]: Wires not connected to anything
    ; error
    @(264.16 mm, 226.06 mm): 水平ワイヤー, 長さ 10.16 mm
    @(264.16 mm, 220.98 mm): 垂直ワイヤー, 長さ 5.08 mm
[power_pin_not_driven]: Input Power pin not driven by any Output Power pins
    ; error
    @(266.70 mm, 50.80 mm): Symbol U1 ピン 3 [VIN, 入力, ライン]
[pin_not_connected]: Pin not connected
    ; error
    @(284.48 mm, 208.28 mm): Symbol POWER0 ピン 3 [3, パッシブ, ライン]
[power_pin_not_driven]: Input Power pin not driven by any Output Power pins
    ; error
    @(292.10 mm, 53.34 mm): Symbol U1 ピン 1 [GND, 電源入力, ライン]
[wire_dangling]: Wires not connected to anything
    ; error
    @(345.44 mm, 185.42 mm): 水平ワイヤー, 長さ 2.54 mm
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
[footprint_link_issues]: 現在の構成にはフットプリント ライブラリ 'HM_Nightfall-mini-2e_v1' が含まれていません
    ; warning
    @(411.48 mm, 375.92 mm): シンボル R4R0 [R-EU_R0402]
[footprint_link_issues]: 現在の構成にはフットプリント ライブラリ 'HM_Nightfall-mini-2e_v1' が含まれていません
    ; warning
    @(416.56 mm, 144.78 mm): シンボル SPK1 [SMT-0540-S-R]
[footprint_link_issues]: 現在の構成にはフットプリント ライブラリ 'HM_Nightfall-mini-2e_v1' が含まれていません
    ; warning
    @(426.72 mm, 218.44 mm): シンボル R27 [R-EU_R0402]
[footprint_link_issues]: 現在の構成にはフットプリント ライブラリ 'HM_Nightfall-mini-2e_v1' が含まれていません
    ; warning
    @(436.88 mm, 218.44 mm): シンボル LED2 [LEDCHIPLED_0603]
[footprint_link_issues]: 現在の構成にはフットプリント ライブラリ 'HM_Nightfall-mini-2e_v1' が含まれていません
    ; warning
    @(439.42 mm, 314.96 mm): シンボル UFR0 [2N7002TQ-7-F]
[footprint_link_issues]: 現在の構成にはフットプリント ライブラリ 'HM_Nightfall-mini-2e_v1' が含まれていません
    ; warning
    @(439.42 mm, 370.84 mm): シンボル UR0 [2N7002TQ-7-F]
[footprint_link_issues]: 現在の構成にはフットプリント ライブラリ 'HM_Nightfall-mini-2e_v1' が含まれていません
    ; warning
    @(462.28 mm, 284.48 mm): シンボル R1FR0 [R-EU_R0402]
[footprint_link_issues]: 現在の構成にはフットプリント ライブラリ 'HM_Nightfall-mini-2e_v1' が含まれていません
    ; warning
    @(462.28 mm, 302.26 mm): シンボル IR_LED_FR0 [LED3MM]
[footprint_link_issues]: 現在の構成にはフットプリント ライブラリ 'HM_Nightfall-mini-2e_v1' が含まれていません
    ; warning
    @(462.28 mm, 340.36 mm): シンボル R1R0 [R-EU_R0402]
[footprint_link_issues]: 現在の構成にはフットプリント ライブラリ 'HM_Nightfall-mini-2e_v1' が含まれていません
    ; warning
    @(462.28 mm, 358.14 mm): シンボル IR_LED_R0 [LED3MM]

 ** ERC messages: 134  Errors 46  Warnings 88

 ** Ignored checks:
    - Global label only appears once in the schematic
    - Four connection points are joined together
    - SPICE model issue
    - Assigned footprint doesn't match footprint filters
