xfa273/nightfall-fw/docs/F413_MACHINE_CONFIG.md

# F413 共通ファームと機種・個体設定

2026-09-06 実装。方針の正本は `NIGHTFALL_FW_DEV_POLICY.md` §7。

## 選んだ方式

`nightfall_stm32f413.elf/.bin` は **全F413機で同じもの**を使用する。
内蔵Flash sector 15のidentityを起動時に検証し、
`(family, board_id, unit_serial)` から設定を一度だけ選択する。
走行中の再選択・設定変更はしない。F405の既存mini/classic別ビルドは変更しない。

| 層 | キー／保存場所 | 内容 |
| --- | --- | --- |
| MCU | `nightfall_stm32f413` | Clock、HAL、固定バッファ上限、割り込み周期 |
| 機種 | `family + board_id`、`board/f413/f413_registry.c` | ピン構成の互換ID、搭載機能、標準ハード設定、既定profile |
| 個体 | 上記 + `unit_serial`、同registry | 配線変更等のハード上書き、個体専用profileへの差し替え |
| 走行profile | `params/<profile>/profile.c`等、共通binary内 | 寸法・PID/FF・フィルタ・壁閾値、探索2組、最短mode2..7各9case、センサLUT |
| 校正 | 各機のFRAM、既存NVM API | 壁オフセット・基準値・距離warp。共通フォーマットで個体ごとに保存 |

`board_id` は `0x00MMNNVV`（major/minor/variant）。miniとclassicは別namespaceで、
同じboard_idでも衝突しない。`unit_serial` は機種内連番であり、F413全体の台数ではない。
従って今回の2機目は `mini_r3_0_unit001` とする。

## 現在の登録

| 個体 | family / board_id / unit | 走行profile | 左前進IN2 | Fan |
| --- | --- | --- | --- | --- |
| mini_r2_0_unit001 | mini / `0x00020000` / 1 | `0x00020001` / `f413pre-run-params-t0.2` | Low（元の配線） | なし |
| mini_r3_0_unit001 | mini / `0x00030000` / 1 | `0x00030001` / `mini-r3-runtime-params-t0.24`（共通値、故障機の駆動は禁止） | High（左配線を反転済み） | あり |
| mini_r3_0_unit002 | mini / `0x00030000` / 2 | `0x00030001` / `mini-r3-runtime-params-t0.24`（実機反映待ち） | High（unit001同様の左配線を確認） | あり |

登録済み各機とも現時点は右前進IN2 High、encoder符号 L=+1/R=-1、TIM2 PSC=0/ARR=1000。
r3の左配線反転は**機種標準ではなく各個体の上書き**。
unit002は2026-09-20登録時は標準Lowとし、2026-09-21に実装後の目視とencoderで
左だけ逆回転を確認したため、ユーザ指示でunit001同様のHighへ変更した。
encoder符号は変更せず、以後は正常な方向確認手段として扱う。
unit002のMCU UIDは `001D0038-32345108-36383936`。IMU・壁センサ・エンコーダ・
走行モータ・吸引モータは実装済みで、吸引動作もユーザ確認済み。
unit002の非吸引ゲイン・基本走行は2026-09-21ユーザ確認済み。前壁補正・
距離精度の独立検証、全mode/速度域・吸引・3Sの資格確認を意味しない。
2026-09-21、同じ壁センサをunit001から移植したユーザの指示により、遮光後の
sensor校正68B（offset FR82/FL66/R27/L43）をunit002へ暫定コピー済み。
校正コピー時の距離LUTは共通t0.5で、後述のt0.9で前壁のみ拡張。
unit001の無効な診断用distance blobはコピーしない。
横壁中央基準は保存0のためL1941/R1989の暫定値で、実機確認・調整が必要。
適用範囲と検証は `docs/MINI_R3_UNIT002_BRINGUP.md` を参照。
2026-09-21の浮上粗調整t0.6からt0.7で直進のIMU併用へ戻し、ユーザの床上調整後に
t0.8として速度P0.24・角速度P0.45を保存。他のゲインと角速度profile中のencoder
例外は維持。同日の追加測定を受領しt0.9で前壁40..110mmへ拡張、ゲインは不変。
このLUT更新の実機書込・前壁補正の床上追試、吸引・3Sは未検証。
unit001のU2故障による駆動禁止は解除しない。保存点は
`stable/mini/unit002/s20260921-mini-r3-2s-fan-off/`。
詳細 `docs/MINI_R3_UNIT002_TRANSLATION_TUNING.md`。
旧 `NIGHTFALL_F413_MOTOR_LEFT_FORWARD_IN2_HIGH` ビルド指定は廃止し、指定時はコンパイルエラー。

r2の既存数値は維持した。r3はr2の走行値を独立コピーしたprofileである。
2026-09-06にユーザーが同一外形・足回り構成を確認したため、寸法・encoder CPRを継承する。
unit002の非吸引負荷時ゲインはユーザ調整済み。有効タイヤ径の独立実測や
側壁制御基準値、未試験条件の確認は別途。ターン前壁補正の換算と追加測定条件は
`docs/MINI_R3_FRONT_TURN_REFERENCE.md`を参照。
前壁FR/FL/合計LUTは遮光後の09-12測定40..75mmと09-21追加測定80..110mmを
合成した15点を使用し、80mmは最新FR599/FL568へ置換（90mmは422/422）。
前壁合わせ目標45mmを維持する。t0.11では42.5mmによる打切りを廃止し、
目標－許容誤差43.5mmより近い側があれば後退を優先（飽和・近距離範囲外も対象）。
補正全体1秒・後退12mmの上限は維持し、未収束なら駆動停止する。
遮光前の85..110mmの点は混ぜない。profileの
`front_distance_body_centre` は前壁だけの基準を表し、起動・UART `:`・CSV metaにも表示する。
09-12の側壁測定L/R各12点（中心基準23..80mm）は `side_distance_lut.c` に維持し、
`side_distance_body_centre` はtrueを維持する。45mm時のR/Lは640/733。
側壁距離は診断表示用で、横壁制御・壁切れ判定は引き続きADC deltaを使用する。
生値閾値・ゲイン・FRAMの側壁基準値は変更しない。距離有効判定のdelta>300も保持するため、
測定範囲内でもL/Rとも65..80mmの点はlow-signalとなる。
新規の距離テーブルは機体中心基準で採取する。mini_r2は旧基準のLUT/目標7mmを保持し、
旧測定原点が不明なら中心基準で再測定してから移行する。
基準や元LUTの識別子を持たない既存v1 FRAM warpは中心基準profileでは読込適用しない
（`distance=MISS` / `params=0` が正常）。FRAMの内容は消さず、壁オフセットも保持する。
測定元と再生成手順は `params/mini_r3_0/calibration/README.md`、実機確認は
`MINI_R3_COMMISSIONING.md` を参照。これだけで床上の前壁合わせ制御を検証済みとはしない。
2026-09-23時点ではr3の通常走行fan制御・FAN_ONゲイン選択も接続済み。
モード別の現在値と調整範囲は `MINI_R3_SUCTION_MODE_LADDER.md` を参照。

r3のIMUはKiCad上でr2比180度回転しているため、前進加速度は-Y（r2は+Y）、
yaw gyroは両機+Z。旋回中心より後方2.5mmの補正をr3だけに適用する。
電池電圧の分圧比もr2の3.2からr3の127/27へ機種別に選択する。
これはセル数判定や3Sでのモータ／fan安全上限の実装ではない。
浮上固定での検証結果と次の校正手順は `MINI_R3_COMMISSIONING.md` を参照。

## 起動と保護

1. `HAL_Init()`直後にidentityを読み、checksum/schema/revision整合性を検証する。
2. 機種・個体が登録済みか、対応するpin layoutか、profileのfamily/boardが一致するかを検証する。
3. ID内UIDが非zeroなら実MCU UIDとの一致を必須とする。r3等の新規個体はzero UIDを拒否する。
   r2 unit001のみ既存のzero UIDを互換許可する。
4. `default_param_profile=0` はその個体のregistry指定を使う。非zeroは選択profile IDとの一致を要求する。
   別機種profileへの任意切替スイッチではない。`capability_flags=0` は機種定義を継承し、非zeroなら一致を要求する。
5. 選択完了後にboard GPIO・ADC・SPI・TIM等を初期化する。実効値は外部から書換不能なgetterで使用する。

IDなし、破損、未知機種、未知個体、UID不一致、未対応pin layout、profile不一致はすべて停止する。
その場合はF413共通の診断UART（USART1 PA9/PA10）だけで `[SAFE] machine=...` とUIDを表示し、
board GPIO・motor/fan timer・制御IRQ・OP UIは初期化しない。復旧はSWDで行う。
さらにopen-loop motor、closed-loop start、fan testにもidentity/capability gateを置く。
診断UARTのピン対は将来F413基板でも予約すること。

## 設定の変更方法

- r2の数値: `params/f413_preorder/`（既存調整ツール互換のため旧directory名を維持）。
- r3の数値: `params/mini_r3_0/`。ここを変えてもr2の値は変わらない。
- 配線極性、encoder符号/CPR、トレッド、PWM prescaler、IMU前後軸・中心からの前後距離、電池分圧比: registryの機種定義または個体上書き。
- 同じ機種の個体ごとに走行値を変える場合: 独立profileを作成し、対象unitの`profile_override`で指定する。
  profile IDは非zeroの未使用値を割り当て、family/board_idを元機種に合わせる。
  mode/case配列とLUTを含むprofile全体が切り替わる。個体が増えてもbinaryは増やさない。
- 数値変更時は `PARAMS_TUNE_VERSION` を上げ、共通ファームを再ビルド・書き込む。
  本実装は「IDはNVM、設定値はversion管理した共通binary内」の方式。UARTでの任意値更新や
  走行parameter blobのFRAM保存は追加していない。通常の調整にidentity再書き込みは不要。

`f413_param_fields.def` がruntime scalarの型一覧、`f413_runtime_aliases.h` が既存コード向けの読取facade。
新しいscalarを加える際は両方と全profileの定義・host試験を更新する。
2026-09-23、共通アプリの `params.h` を `board/f413/runtime/params.h` に変更した。
共通コードには特定機体の数値ヘッダをincludeせず、`profile.c` だけが隣の機体ヘッダを読む。
全160 scalar（寸法、PID/FF、フィルタ、壁閾値、GOAL_X/Y・GOAL1..9・START_X/Y、撮影設定等）、
探索2組、最短mode2..7各9case、機体LUTが選択対象となる。
共有 `sensor_distance.c` のF413用SENSOR_DIST_GAIN=1固定も撤去した。
DIR_*の重複した旧固定値は削除し、互換名も選択済み機種/個体hardwareを参照する。
個体の配線上書き、FRAM校正、既存ゲインとfan立上げ手順は維持する。
F405専用の旧制御でだけ使う項目もprofileとして保持するが、この修正でF413に旧機能を追加はしない。

GOAL/STARTは探索の到達判定・歩数マップ・帰路、共有solver、保存迷路からの最短経路で
同じ機体値を使う。全座標の負値/範囲外と全ゴール未設定を起動時に拒否する。
(0,0)は従来どおり未使用ゴールslotで、GOAL1の既定値がGOAL_X/Yに追従する。
診断専用の内蔵迷路previewは明示された中央2x2ゴールを維持する。

**MAZE_SIZEは共通binaryの配列/保存形式・compact plannerの16x16契約**。
profileにも値を取り込み、16以外は設定エラーで起動停止する。
単体host solverが32x32を扱えることは共通F413 binaryの対応を意味しない。
診断刺激の時間とMCU共通の上限は機体profileの項目ではない。
区画寸法（mini half-cell=45mm、classic=90mm）と走行距離はruntime profile値を使う。

ビルド時の `check_f413_param_coverage.py` は全機体ヘッダとschema/aliasの差分を検出する。
`--compile-commands` を付けると実際の52 application TUを前処理し、機体macroが固定値へ
戻っていないかも検査する。新規機体追加時も同じチェックを通す。

## classic F413を追加するとき

classicをmini扱いするfallbackは存在しない。まだclassic実機のピン／寸法／調整値を登録していないため、
現在のbinaryはclassic IDを安全停止させる。将来は以下で同じ仕組みに追加できる。

1. `family=classic` と固有の機種board_idを登録する。
2. 現在のCubeMX pin/peripheral contractと同一なら `F413_LAYOUT_MINI_R2` を使用可能。
   異なる場合は新layoutとplatform初期化分岐を実装する。MCUが同じという理由だけで既存layoutを指定しない。
3. classic固有のprofileを作り、half-cell=90mm、メカ寸法、極性、センサ校正、各走行値を設定する。
4. unitを登録し、下記のID登録と段階的HILを実施する。

型・resolver・profileの仕組みはclassicでも共通。host試験ではminiと同じboard_idのclassic、
異なる寸法／ゲインの選択、mini profile混入の拒否を確認する。

### 事前計算済み経路テーブルの注意

現在のKERI mode2 case6..9用テーブルはr2専用である。
`route_precomputed_compatible` はr2のみtrue、r3はfalse。
別profileでUART `K`、保存迷路からのKERI経路生成を要求すると拒否し、r2用テーブルを流用しない。
mode2 case6の固定検証pathは撤去済み。case6..9は保存迷路と対応profileのテーブルが必要。
新機種へのKERI対応はprofile別のgeometry/timeテーブル生成・選択と実測確認が必要。
r2値を変更した場合も `tools/route_precompute/generate.py` / `--check` を必ず実行する。

## 初回ID登録（現在接続機を必ず確認）

通常のapp更新ではidentityを保持する。新機体は先にcommon appを書き込み、未登録SAFEを確認する。
F413 linkerのアプリFlash上限は1MiBとし、既存ツールの保護対象sector12..15へ
コード／profileが配置される前にビルドエラーにする。CubeMX再生成時もこの予約を維持する。

```sh
python3 tools/flashing/f413_identity.py inspect --sn <STLINK_SN>
python3 tools/flashing/f413_identity.py provision-empty \
  --sn <STLINK_SN> --machine mini_r3_0 --unit-serial 1 \
  --expected-uid <inspectで確認したXXXXXXXX-XXXXXXXX-XXXXXXXX> \
  --backup-dir build/identity/<新しい一意なbackup名> --allow-identity-write
```

このツールはMCU IDとUIDを確認し、sector15全128KiBを退避してから**全域が空の場合だけ**
68byteのidentityを `--skipErase` で書く。eraseコマンドは持たない。
書き込み後は全sectorを再読し、identity以外のbyteが変化していないことも検証する。
既存identity・非blank sector・UID不一致は書き込まない。backupディレクトリは再利用不可。
生成identity.binとmanifestは再登録用に別媒体にも保管する。既存IDの改名／置換はこのツールで行わず、
退避・対象・復旧方法を確認して保護領域の明示的更新手順を別途実施する。

リセット後に `ID machine=... unit_name=...` と `[MACHINE] profile=...`、
極性・encoder符号・half-cell・fan表示を確認する。CSVにはprofile ID、tune version、実効極性を併記する。
設定metaはdump時の設定なので、旧ファームのFRAMログは更新前にdumpして保管する。
調整記録・安定版manifestは `FW_TARGET + family + board_id + unit_serial + FW SHA + tune version` を一組で残す。

## 検証

```sh
sh tools/hil/run_f413_machine_tests.sh
python3 tools/hil/run_f413_runtime_goal_tests.py
python3 tools/hil/check_f413_param_coverage.py --compile-commands build/Debug/compile_commands.json
sh tools/hil/run_f413_motor_pwm_tests.sh
python3 -m unittest discover -s tools/flashing -p test_f413_identity.py
python3 tools/route_precompute/generate.py --check
cmake --build --preset Debug-stm32f413
cmake --build --preset Debug-stm32f405
git diff --check
```

2026-09-06、接続中のr3で以下を確認済み（`GIT=49497cc DIRTY=1`）。

- 空IDでは `[SAFE] machine=identity-invalid`、モータ／ファンtimer未初期化。
- UID `00280047-31335117-34313932` を `mini_r3_0_unit001` として登録。
  全sectorの退避・空判定・eraseなし書込み・全sector読戻し比較が成功。
- 起動時にprofile `0x00030001`、左右前進IN2 High、half-cell 45mmを自動選択。
- UART `i,w` はIMU WHO_AM_I `0x6B`、壁ADC取得ともPASS。
  `K,+` は非対応のr2事前計算テーブル利用を拒否。いずれも非モータ／NVM読取のみ。
- 通常のapp更新を再実施してもidentityと選択結果を保持。
- 最終SWD確認でモータPWM・STBY・方向出力およびfan dutyはOFF、CFSR/HFSR=0。

退避先は `build/identity/mini_r3_0_unit001_20260906_0203/`、詳細・ログ名・hashは
`docs/ai/WORKLOG.md` に記録。host試験とF413/F405ビルドもPASS。
今回モータは動かしていない。r2の実機確認、r3の走行調整、classic実機の追加は別途必要。
モータや床上走行は `docs/ai/HIL_SAFETY.md` に従う。
