xfa273/nightfall-fw/docs/MINI_R3_FRONT_TURN_REFERENCE.md

# mini_r3 ターン前壁補正の換算基準（2026-09-21）

t0.16追記: 吸引調整用mode6の入口距離を0.9 mmへ変更し、r3前壁目標は
89.1 mmとなる（r2のmode6は2.0 mm/50.0 mmのまま）。t0.12のmode4は
入口0.6 mm/目標89.4 mm（r2は4.0 mm/48.0 mm）を維持。
詳細は `MINI_R3_MODE6_SUCTION_TUNING.md` と `MINI_R3_MODE4_SUCTION_TUNING.md`。
以下の「変更しない」はt0.9 LUT更新時の記録。

## 結論

追加測定を受領し、t0.9で前壁LUTを**40..110mmの15点**へ拡張した。
80mmは再測定FR599/FL568で置換、85..110mmを追加、40..75mmは維持。
90mm入口と以下の全目標が測定範囲内になった。補正式・ゲイン・入口距離は
変更しない。今回はソース更新とホスト検証までで、実機書き込み・走行は未実施。

F413の探索小回りと最短小回りは、既に前壁FR+FLの**距離換算値**で
旋回開始位置を補正する。`val_offset_in`（630/650等）や`fwall_kx`は
F405互換のパラメータで、現F413のこの補正処理では使用しない。
これらのADC値を換算してもF413の旋回開始は変わらない。

実処理は `f413_search_step.c` と `f413_path_run.c` の
`drive_front_wall_entry_segment`。両方とも以下の式で目標を作る。

```text
前壁距離目標 = F_ALIGN_TARGET_MM + DIST_HALF_SEC - dist_offset_in
mini_r2     = 7  + 45 - dist_offset_in   （旧テーブルの距離基準）
mini_r3     = 45 + 45 - dist_offset_in   （機体中心から壁まで）
```

従って既存の同じ中心合わせ目標に対応させる換算は **r3 = r2 + 38 mm**。
これは既存の制御目標7/45mmに基づく対応であり、mini_r2の旧治具原点を
今回独立に実測・同定したものではない。mini_r2のLUT自体は変更しない。
mini_r3の `F_ALIGN_TARGET_MM=45` への移行時点でこの換算は適用済み。
今回、幾何パラメータや未使用ADC閾値に追加の変更は行わない。

## 調整の出発値

| 小回りターンの設定 | 入口距離 mm | r2旧基準の目標 mm | r3中心基準の目標 mm | r3現LUT内か |
| --- | ---: | ---: | ---: | --- |
| 探索・標準300 mm/s（配列0） | 8.0 | 44.0 | 82.0 | 範囲内 |
| 探索・低速250 mm/s（配列1） | 10.0 | 42.0 | 80.0 | 範囲内 |
| 最短mode2 | 7.2 | 44.8 | 82.8 | 範囲内 |
| 最短mode3 | 4.0 | 48.0 | 86.0 | 範囲内 |
| 最短mode4（r3 t0.12） | 0.6（r2:4.0） | 48.0 | 89.4 | 範囲内 |
| 最短mode5 | 4.0 | 48.0 | 86.0 | 範囲内 |
| 最短mode6（r3 t0.16） | 0.9（r2:2.0） | 50.0 | 89.1 | 範囲内 |
| 最短mode7 | 10.0 | 42.0 | 80.0 | 範囲内 |

上表は前壁距離の換算であり、t0.12のmode4・t0.16のmode6ターン幾何はmini_r2と異なる。
mode3以降や高速走行を今回検証済みとする表ではなく、式の換算表である。

## 追加測定で解消した範囲不足（履歴）

追加測定前のmini_r3前壁LUTは中心基準40..80mmの実測9点だった。
80mmのFR/FL/合計は **565 / 595 / 1160**、45mmは
**2508 / 2494 / 5002**だった。遠距離の実測不足は今回の追加データで解消した。

`f413_wall_distance_convert_snapshot` はテーブル外の値を無効とし、
`front_unwarped_mm` はその値を制御へ渡さない。ターン入口処理も、開始時に
有効な前壁距離が取れなければ、センサ補正なしのエンコーダ距離走行へ戻る。
区画入口の名目距離は中心から90mmなので、**目標が80mmの設定でも、
入口90mmを測れなければ補正が開始されない**。
この条件はコードからの確認で、ユーザの今回の各走行ログは未取得。

このため、ADC閾値だけの換算では問題を解決できない。
中心基準80..110mmの新しい実測を受領し、PCHIP・有効範囲を更新した。
測定元と再生成手順は `params/mini_r3_0/calibration/README.md` を参照。
遮光前データの混在、外挿値の実測扱い、有効範囲ガードの解除はしない。

前壁補正のみの独立オフセットは現状ない。`dist_offset_in`を変えると
前壁なし時の入口幾何も変わるため、未使用の`val_offset_in`と混同せず、
次は追加LUTを書き込んで前壁あり/なしの差を確認し、必要な調整を決める。

## 保存済みゲイン

ユーザが非吸引調整を完了とした値はsource `929f000`、
profile `mini-r3-2s-fanoff-t0.8` に保存。
復元用記録は `stable/mini/unit002/s20260921-mini-r3-2s-fan-off/`。
前壁補正は未完了として分離し、吸引・3S・unit001の故障解除を含めない。
今回はホスト上の保存・換算監査・ビルドのみ。実機書き込み・走行は行わない。
