xfa273/nightfall-fw/docs/MINI_R3_SUCTION_GAIN_REVIEW.md

# mini_r3 吸引ゲイン再確認（2026-09-22 10:17ログ）

追記: 10:34/10:36のR90/R180で旋回改善を確認。残る発進ずれと停止待ちを
[t0.20の対策](MINI_R3_SUCTION_STARTUP_FIX.md)で修正した。以下はt0.19の記録。

並進FF更新後の90°大回りは1.5 m/sへ到達し、停止も収束した。
ただし開始時の方位ずれと旋回中の角度遅れが残るため、t0.19で角度P・角速度FF・
角加速度FFを追加調整する。新設定を同じmode6/case0/sub1で再確認してから180°へ進む。
新設定の実機書込・駆動は行っていない。

## ログで確認できたこと

`trace_bin_20260922_101705.csv`、3729行、mode6/case0/sub1、schema `0x00060000`。
SHA-256: `d10a3b102e19ae8ba5a62a379157b226ef03bbc204dfe2bfdfdb8f75193a01c8`。
以下は走行開始timestamp=28464 msを0とする。
実機FW SHA・ゲイン・ファンdutyの直接メタデータはない。
定速中の出力再構成はt0.18の速度P0.35/I0.001とFF230‰に一致
（未知の初期積分を含む定数229.868‰、残差RMS0.227‰）。
角速度出力もP0.8/I0.006、4 ms先行補償、角速度FFゼロにRMS0.222‰で一致する。

| 観測 | 結果 |
|---|---|
| 直進後半0.280..0.355 s | 目標1.500、feedback平均1.505、encoder平均1.498 m/s、速度誤差RMS0.0103 m/s |
| 旋回0.163..0.263 s | feedback平均1.453、encoder平均1.450 m/s、feedback最小1.392 m/s |
| 角速度 | 目標ピーク−1695.6、実測ピーク−1707.1 deg/s、旋回中追従誤差RMS67.0 deg/s |
| 方位 | 発進時+1.427°、旋回開始+1.247°、旋回中最大遅れ3.104° |
| PWM | 全ログ最大絶対値50.8%、±100%飽和なし |
| 停止保持0.480..0.577 s | 目標との差はログ上+0.000265 m、feedback平均0.00045 m/s、並進PWM平均0.488% |
| 終了 | 0.577 sにcleanup、0.636 sに出力停止。共通timeout/encoder flagなし。最終角度−89.829° |

停止距離の実測列は0.001 m刻みなので、上記端数は絶対位置の測定精度を意味しない。
前回の停止誤差−0.0136 mと約7%の前進積分残留は解消している。
停止直前にfeedbackは−0.071 m/sとなるが、0.390..0.580 sの左右平均エンコーダに
負方向の移動はなく、IMU併用推定の過渡応答を実際の後退とみなしてゲインを上げない。
UARTの終了理由文字列はなく、正常cleanupと整合するログ状態を確認したもの。

## 全制御ゲインの判断

数値はファーム内のmm・deg・PWM‰基準。Iは1 msごとの誤差和に掛ける。

| FAN_ON制御 | t0.19の値 | 判断 |
|---|---|---|
| 速度P/I/D | 0.35 / 0.001 / 0 | 維持。直進後半・停止は改善、旋回中の約0.05 m/s低下は次も監視 |
| 並進FF static/velocity/accel | 65 / 0.110 / 0.0100 | t0.18を維持 |
| 距離P/I/D、FF | 2 / 0 / 0、1 | 維持。停止は位置許容範囲へ収束し、Iを足す根拠なし |
| 角度P/I/D、FF | **15** / 0.1 / 0、1 | Pのみ10→15。発進前後の方位ずれと角度回復を改善する初期値 |
| 角速度P/I/D | 0.8 / 0.006 / 0 | 維持。発振や飽和を抑える目的でさらにP/Iを増やす根拠はない |
| 角速度FF | **0.040** | 0から追加。回転速度に応じた負荷をP/Iから分担 |
| 角加速度FF | **0.0008** | 0から追加。既存先行補償を含めた不足分のみ |
| 角速度先行補償 | 0.004 s、上限120 deg/s | 維持。FAN_OFFとも共通なので変更しない |
| 壁・斜め壁制御 | 現走行paramsを維持 | このR90ログから壁誤差への閉ループ応答は同定できない。斜め区間もなく調整根拠なし |

角速度FFの符号は既存実装に従う。`(右PWM−左PWM)/2`を正の旋回出力とすると、
FF追加分は百分率で `0.004 ω[deg/s] + 0.00008 α[deg/s²]`。
|ω|=1700 deg/sで6.8%、|α|=60000 deg/s²で4.8%の寄与となる。
全mini_r3吸引モードで共用され、mode4の50%や逆方向への適合は別途確認が必要。
FAN_OFF・mini_r2・F405のゲイン、fan100%と立上げ、走行速度/加減速度・ターン形状は不変。

## 旋回FFの見積もり

1 ms格子へ補間したgyroを中央9サンプル平均し、0.169..0.254 s付近の
15 ms窓（開始2 ms刻み）で、左右出力差/2を角速度と角加速度へ最小二乗近似した。
入力PWMの遅れ0..5 msを比較し、2 ms遅れで再構成RMS0.332 percentage point。
そのモデルはPWM‰で `u ≈ −4.02 + 0.0464 ω + 0.00264 α`。
遅れを0 msに固定すると速度項は約0.0283となり、慣性項は約0.00272。
短い単一右ターンからの同定で、定数項と速度項・遅れの分離には不確かさがある。

速度FFはその範囲の0.040を採用。慣性項を丸ごと追加すると、既存の
`Pω × clamp(0.004 α, ±120)`と重複する。
α=60000で既存先行補償は96‰、同定上の慣性出力は約159‰となるため、
追加加速度FFは48‰に相当する0.0008へ抑えた。

同定モデルへ実測角度指令を入力し、角度/角速度PIと先行補償を含めて試算した。
旧設定は旋回中の角度を実測にRMS0.081°、角速度をRMS27.0 deg/sで近似。
最大角度誤差はモデル上で旧3.18°→候補1.44°、旋回終了時1.19°→0.60°。
慣性±20%・遅れ1..3 msでも候補最大誤差は約1.25..2.17°だが、
これは採用候補の感度確認に過ぎず、新設定の実測値ではない。
停止摩擦・吸引反力・左右差・壁やタイヤの横滑り・速度依存性はモデルに含めていない。
解析コード、出力、実測グラフはGit対象外 `build/suction_gain_101705/`。

## 次の走行

mode6/case0/sub1、現在のファン100%のまま90°大回りを再測定する。
発進前後の方位ずれ、旋回中の角度/角速度誤差、出口での逆振れと停止収束を比較する。
次の180°大回りはsub2。ただし現在の角加速度係数は90°が45500、180°が41000 deg/s²で、
180°の方が大きい設定ではない。cosineプロファイルの実角加速度ピークも
それぞれ約59559 / 53669 deg/s²。180°は主に角速度2200 deg/sへの到達と継続時間が
増える確認になる。係数やオフセットを変える場合は再シミュレーションが必要で、今回は変更しない。

## 検証

機体runtime profile、停止/位置保持、全軸ON/OFF選択、高速feedbackのASan/UBSan試験と
F413/F405 Debug build、diff checkを実施。
既存ゲイン試験の「角速度FFゼロ」前提でPWM比較が失敗したため、FFを含む期待値へ修正し、
両旋回方向・両fan状態で、最初の速度FFと次サンプルの角加速度FF＋先行補償の符号/出力を検証。
修正後は全てPASS。F413 RAM274160 B / Flash371924 B。
共通制御実装・NVM/ログschema・`.ioc`・stable保存点に変更なし。
ハードウェアコマンド列なし、書込・リセット・UART・モータ/ファン・走行・NVM操作なし。
