xfa273/nightfall-fw/docs/MODE_CASE_20260214.md

# 2026-02-14 Mode/Case Matrix

対象状態: `0d4d22052f6977d251987b7f5cd1125abf48541c`

日時: 2026-02-14 21:57:02 +0900

ビルドターゲット:

- mini: `nightfall_mini_v1_1` / `params/mini_v1_1`
- classic: `nightfall_classic_v2` / `params/classic_v2`

## 操作

- `PUSH_IN_1` を押すたびに番号が 1 つ進む。`9` の次は `0`。
- 決定は右前センサだけを見る: `ad_fr > WALL_BASE_FR && ad_fl < WALL_BASE_FL`。
- top-level の mode を選んだ後、mode 内でも同じ操作で case を選ぶ。
- `mode1 case0` と `mode2`-`mode7 case0` はさらに sub-mode を同じ操作で選ぶ。

## Top-Level Mode

| mode | 内容 |
|---:|---|
| 0 | LED 3 個を点灯したまま無限ループ。走行しない |
| 1 | 探索走行 |
| 2 | 最短走行プリセット 2 |
| 3 | 最短走行プリセット 3 |
| 4 | 最短走行プリセット 4 |
| 5 | 最短走行プリセット 5 |
| 6 | 最短走行プリセット 6 |
| 7 | 最短走行プリセット 7 |
| 8 | `test_run()`。ハードコードされた走行テスト |
| 9 | `test_mode()`。センサ/ログ/キャリブレーション系テスト |

## Mode 1: 探索走行

### Case

| case | 内容 |
|---:|---|
| 0 | 探索走行テスト。sub 0-3 を追加選択 |
| 1 | 標準速度: ゴール探索 -> 全面探索。全面探索後にマップ保存 |
| 2 | 標準速度: 最初から全面探索 |
| 3 | 標準速度: ゴール探索 -> スタートへ帰り探索 |
| 4 | 標準速度: ゴール探索のみ。ゴール到達で終了 |
| 5 | 低速: ゴール探索 -> 全面探索。全面探索後にマップ保存 |
| 6 | 低速: 最初から全面探索 |
| 7 | 低速: ゴール探索 -> スタートへ帰り探索 |
| 8 | 低速: ゴール探索のみ。ゴール到達で終了 |
| 9 | 実装なし。選んでも走行処理なし |

### Case 0 Sub-Mode

| sub | 内容 |
|---:|---|
| 0 | 予約。未実装 |
| 1 | 標準速度の小回り R90 テスト。ログは FR=omega / FL=angle |
| 2 | 低速の小回り R90 テスト。ログは FR=omega / FL=angle |
| 3 | 標準速度の直進 3 区画テスト。ログは FR=velocity |

### Search Parameters

探索中の `one_sectionU()` は、直前の `first_sectionA()+half_sectionA()` で作った `speed_now` を等速維持する。下表の「直進目安」はその初期巡航の計算値。
探索走行には最短走行の `velocity_straight` に相当する独立した最高速度パラメータはなく、加速後の `speed_now` が等速直進で使われる。

| 機体 | 種別 | mode1 cases | turn90 [mm/s] | 直進目安 [mm/s] | acc / acc_dash [mm/s^2] | fan | 壁合わせ |
|---|---|---|---:|---:|---:|---:|---|
| mini | 標準 | 1-4, 0-sub1/3 | 300 | 341 | 1000 / 1500 | 0 | 有効 |
| mini | 低速 | 5-8, 0-sub2 | 250 | 284 | 694.44 / 1000 | 0 | 無効 |
| classic | 標準 | 1-4, 0-sub1/3 | 1000 | 1215 | 5555.6 / 7000 | 100 | 有効 |
| classic | 低速 | 5-8, 0-sub2 | 600 | 729 | 2000 / 3000 | 0 | 無効 |

## Mode 2-7: 最短走行

共通動作:

- case 選択後、保存済みマップから `solver_build_path(mode, case)` で経路生成。
- case ごとの直線速度/加速度を適用。
- mode ごとの小回り/大回り/斜めターン速度と fan を適用。
- `drive_fan(fan_power)` 後に `run()`。

経路タイプ:

- case1: 小回り中心。`path_type=0`
- case2-7: 大回り変換あり。`path_type=1`
- case8-9: 斜め変換あり。`path_type=2`

注意: `mode2` の UI だけ、case3 が `run_shortest(2, 4)` を呼ぶ。つまり mode2 case3 は parameter case4 と同じ。mode2 parameter case3 は UI から直接は使われない。

### Mini: Mode Common Turn/Fan Parameters

| mode | small R/L90 [mm/s] | large 90 [mm/s] | large 180 [mm/s] | diagonal turns [mm/s] | fan |
|---:|---:|---:|---:|---:|---:|
| 2 | 300 | 500 | 500 | 500 | 1000 |
| 3 | 600 | 1000 | 1000 | 1000 | 1000 |
| 4 | 800 | 1000 | 1000 | 1200 | 1000 |
| 5 | 1000 | 1200 | 1200 | 0 | 1000 |
| 6 | 1000 | 1400 | 1400 | 0 | 1000 |
| 7 | 1400 | 2200 | 2200 | 0 | 200 |

### Mini: Case Straight Parameters

表記: `直:a/a2/v` = 通常直進の `acceleration_straight / acceleration_straight_dash / velocity_straight`、`斜:da/da2/dv` = 斜め直進の `acceleration_d_straight / acceleration_d_straight_dash / velocity_d_straight`。単位は速度 `[mm/s]`、加速度 `[mm/s^2]`。`S`=標準プロファイル、`SS`=直進強優先。

| mode | case1 | case2 | case3 | case4 | case5 | case6 | case7 | case8 | case9 |
|---:|---|---|---|---|---|---|---|---|---|
| 2 | 直:2000.0/2000.0/1500.0 S | 直:2000.0/2000.0/1500.0 SS | 直:1000.0/3000.0/4000.0 SS | 直:1000.0/3000.0/4000.0 SS | 直:1000.0/3500.0/4000.0 SS | 直:1000.0/2000.0/1000.0 S<br>斜:1000.0/2000.0/1000.0 | 直:1000.0/3500.0/4000.0 S<br>斜:1000.0/3000.0/3000.0 | 直:1000.0/2000.0/1000.0 S<br>斜:1000.0/2000.0/1000.0 | 直:1000.0/3500.0/4000.0 S<br>斜:1000.0/3000.0/3000.0 |
| 3 | 直:4000.0/4000.0/1000.0 S | 直:4000.0/4000.0/1000.0 SS | 直:8000.0/4000.0/2500.0 SS | 直:10000.0/4000.0/2500.0 SS | 直:12000.0/4000.0/2500.0 SS | 直:4000.0/4000.0/4000.0 SS<br>斜:4000.0/8000.0/2500.0 | 直:4000.0/20000.0/4000.0 SS<br>斜:4000.0/8000.0/2500.0 | 直:4000.0/10000.0/3000.0 S<br>斜:4000.0/8000.0/2500.0 | 直:4000.0/14000.0/3000.0 S<br>斜:4000.0/8000.0/2500.0 |
| 4 | 直:6000.0/3000.0/2000.0 S | 直:6000.0/3000.0/2000.0 SS | 直:6000.0/3000.0/2000.0 SS | 直:8000.0/6000.0/2500.0 SS | 直:10000.0/6000.0/2500.0 SS | 直:7111.11/16000.0/3500.0 SS<br>斜:4000.0/8000.0/2000.0 | 直:7111.11/18000.0/3500.0 SS<br>斜:4500.0/9000.0/2500.0 | 直:7111.11/12000.0/2000.0 S<br>斜:4000.0/8000.0/2000.0 | 直:7111.11/12000.0/3000.0 S<br>斜:5000.0/8000.0/2000.0 |
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

mode2 の parameter case3 は `直:1000.0/3000.0/3000.0 SS` だが、UI の mode2 case3 からは呼ばれないため、上表は実際に呼ばれる case4 の値を載せている。

## Mode 8: `test_run()` Cases

ハードコード値を使うテスト。mini/classic で共通ソースだが、距離定数は各ビルドの `params.h` に従う。

| case | 内容 |
|---:|---|
| 0 | 尻当て `set_position()` |
| 1 | 速度ログ用。半区画加速 -> 1 区画等速 -> 半区画減速 |
| 2 | 距離ログ用。半区画加速 -> 3 区画等速 -> 半区画減速 |
| 3 | omega ログ用。半区画加速 -> 小回り R90 -> 半区画減速 |
| 4 | fan 1000、速度 700 で小回り R90 テスト |
| 5 | fan 1000、大回り R90 テスト |
| 6 | `first_sectionA()` -> 半区画等速 7 回 -> 小回り R90 |
| 7 | 大回り速度へ半区画加速 -> 大回り R90 |
| 8 | 前壁センサで非接触中央合わせ `match_position(0)` |
| 9 | 現在のログを出力 |

### Mode 8 Straight Parameters

表記は `a/a2/v` = `acceleration_straight / acceleration_straight_dash / velocity_straight`。単位は速度 `[mm/s]`、加速度 `[mm/s^2]`。case8/9 は直進パラメータを設定しない。

| case | 直進パラメータ |
|---:|---|
| 0 | 2777.778 / 3000 / 500 |
| 1 | 2777.778 / 3000 / 500 |
| 2 | 2777.778 / 3000 / 500 |
| 3 | 2777.778 / 3000 / 500 |
| 4 | 5444.44 / 8000 / 700 |
| 5 | 11111.11 / 10000 / 1000 |
| 6 | 2777.778 / 3000 / 500 |
| 7 | 2777.778 / 3000 / 500 |
| 8 | 設定なし |
| 9 | 設定なし |

## Mode 9: `test_mode()` Cases

| case | 内容 |
|---:|---|
| 0 | 内側ループ調整。axis=速度/omega、set=500/1000/2000、pattern=step/ramp/trapezoid を追加選択 |
| 1 | IMU チェック。fan 250、omega/angle/accel を連続表示 |
| 2 | エンコーダチェック。左右速度と距離を連続表示 |
| 3 | センサ AD 値チェック。R/L/FR/FL/BAT と前距離を表示 |
| 4 | fan ノイズチェック。sub0=fan 500 維持、sub1=fan 700 でノイズログ取得 |
| 5 | モータシーケンス。前後方向、両輪、duty 10/30/60%、各 2 秒 |
| 6 | 大回り R90 を含む周回テスト。classic 寄りの固定値 |
| 7 | 前壁距離 3 点ワープキャリブレーション。Flash Sector 9 へ保存 |
| 8 | 側壁 L/R ベースライン自動キャリブレーション。Flash 保存 |
| 9 | センサパラメータ再キャリブレーションと Flash 保存 |

### Mode 9 Straight Parameters

`test_mode()` で直進パラメータを明示的に設定するのは case6 のみ。

| case | 直進パラメータ |
|---:|---|
| 0 | 設定なし。内側ループテストは axis/set/pattern で制御 |
| 1 | 設定なし |
| 2 | 設定なし |
| 3 | 設定なし |
| 4 | 設定なし |
| 5 | 設定なし |
| 6 | 3555.6 / 10000 / 3000 |
| 7 | 設定なし |
| 8 | 設定なし |
| 9 | 設定なし |
