xfa273/nightfall-fw/docs/blog/README.md

マイクロマウス関連の記事をまとめています．

現行ソフトは[nightfall-fw](https://github.com/xfa273/nightfall-fw)です．

## 機体一覧
### クラシックマウス

- [歴史とはミックスジュース (2019)](./machines/history-mix-juice-2019/README.md)
- [WMMC標準Nucleoマウス (2022)](./machines/wmmc-standard-nucleo-2022/README.md)
- [Nightfall (2023)](./machines/nightfall-2023/README.md)
- [Nightfall-Lite (2024)](./machines/nightfall-lite-2024/README.md)
- [Nightfall-Air (2025)](./machines/nightfall-air-2025/README.md)

### マイクロマウス(ハーフマウス)

- [歴史とは50%ミックスジュース (2020)](./machines/history-half-mix-juice-2020/README.md)
- [CyberRat (2024)](./machines/cyberrat-2024/README.md)
- [Nightfall-mini (2025)](./machines/nightfall-mini-2025/README.md)

## 記事一覧

- [【改良版】既製品で作るクラシックサイズDCマイクロマウスの足回り（公開日: 2026-04-05）](./posts/2026-04-05_classic-dc-footwork-improved/README.md)
- [今年のマイクロマウス振り返り（公開日: 2025-12-14）](./posts/2025-12-14_2025-micromouse-retrospective/README.md)
- [2024シーズンの機体紹介（公開日: 2024-12-26）](./posts/2024-12-26_2024-season-machines/README.md)
- [【既製品で作る】クラシックサイズDCマイクロマウスの足回り（公開日: 2024-05-09）](./posts/2024-05-09_classic-dc-footwork/README.md)
- [クラシックサイズDCマイクロマウス"Nightfall"のパーツ紹介（公開日: 2024-05-04）](./posts/2024-05-04_nightfall-parts/README.md)
- [クラシックマウス "Ca.161/bis" の紹介（公開日: 2023-12-19）](./posts/2023-12-19_ca-161-bis-introduction/README.md)
- [マイクロマウスを持ち運ぶケースを作る（公開日: 2023-12-08）](./posts/2023-12-08_micromouse-carrying-case/README.md)
- [標準マウスのNucleo版を作ってみる ＜WMMCアドベントカレンダーDay15＞（公開日: 2022-12-15）](./posts/2022-12-15_nucleo-standard-mouse/README.md)

## このブログについて

- [xfa273のチラシの裏](https://xfa273-backofchirashi.hatenablog.com/)から移行しました．(移行中)
- これは所詮「チラシの裏」だと思ってください．製作者が書いていたり，AIが書いていたりします．
