xfa273/nightfall-fw/docs/blog/posts/2024-12-26_2024-season-machines/README.md

# 2024シーズンの機体紹介

##### お詫び

東日本大会前の限界開発により力尽き，そして修論の発注を急いでいたため，投稿が間に合いませんでした．大変申し訳ありません．

これはマイクロマウスAdvent Calendar2024の22日目のはずだった記事です．

[adventar.org](https://adventar.org/calendars/9933)

昨日はyukiさんの[「マイクロマウｽﾀｯｸﾁｬﾝハーフ化計画」](https://yuki-maelstrom.hatenablog.com/entry/2024/12/21/060503)でした．ｽﾀｯｸﾁｬﾝはかわいいのでいずれ作ってみたいですね．

今シーズンは去年12月に作った旧作"Nightfall"に加え，新作クラシックマウス"Nightfall-Lite"と（ほぼ）初めて作ったマイクロマウス"CyberRat"を製作し，大会に出場していました．どちらもそれなりに走るようになったので，これから機体を作る人の参考になればと思います．各機体について多少工夫のある部分のみ解説していますが，他にも知りたい箇所があれば[Twitter](https://x.com/xfa273)や[Discord](https://discord.gg/q8m6aqwFR6)で聞いて貰えればと思います．

### クラシックマウス"Nightfall-Lite"

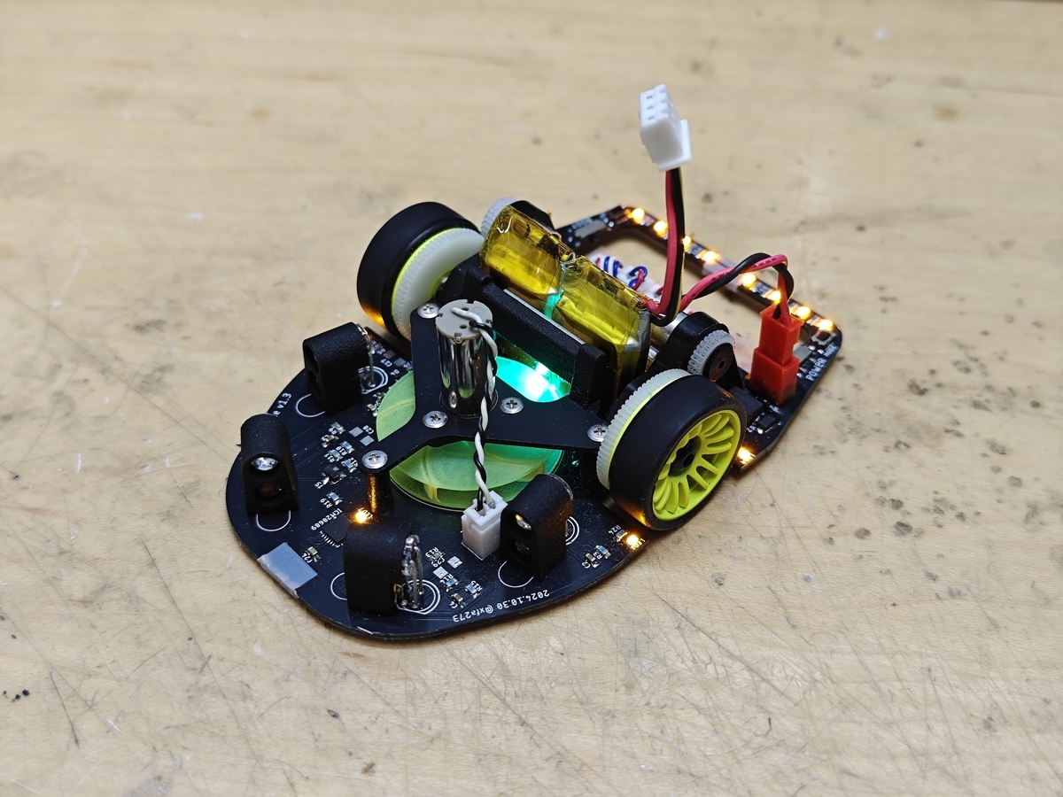
[picture p35: docs/blog/posts/2024-12-26_2024-season-machines/resources/image-1.jpg]


#### 戦績

九州地区大会:  9'538 **優勝**
学生大会:  4'052 **2位**
東日本地区大会:  5'835 4位

#### 概要

前作"Nightfall"を軽量化してより速く走れるようにした新機体です．最近流行りの軽量低イナーシャな2輪機で，パーツ構成は全日本大会で上位だった["XM-702 Carmine"](https://b4rracud4.hatenadiary.jp/entry/20240221/1708511889)，全体的な機体の作りは["雪風8AS"](http://4th-laboratory.cocolog-nifty.com/diary/2024/02/post-bec085.html)を参考にしています．回路は前作からほぼ変更しておらず，前作のソフトがほぼそのまま使えます．
まだ斜め走行ができておらず大回りのみでこのタイムと順位なので，機体性能としてはそれなりに高く作れたのかなと思います．斜め出来ないようなやつが入賞してしまうとは，やはり時代はハーフマウス...
現状のそれなりに走れる最高パラメータは
直進最高速度: 5.0m/s
直進加速度: 28.0m/ss
小回りターン: 1.4m/s
大回りターン: 2.2m/s
です．学生大会の最速タイムはこれだったはずです．

#### 基板

へえ，こんなんで動くんだ...（適当

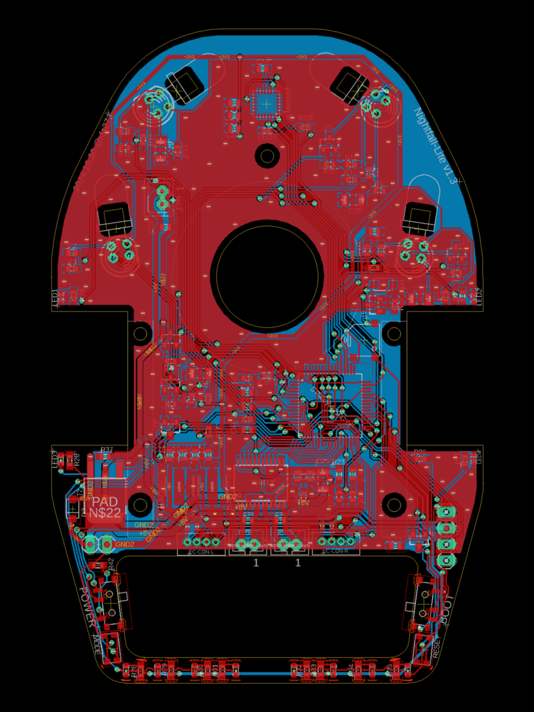
[picture p36: docs/blog/posts/2024-12-26_2024-season-machines/resources/image-2.png]


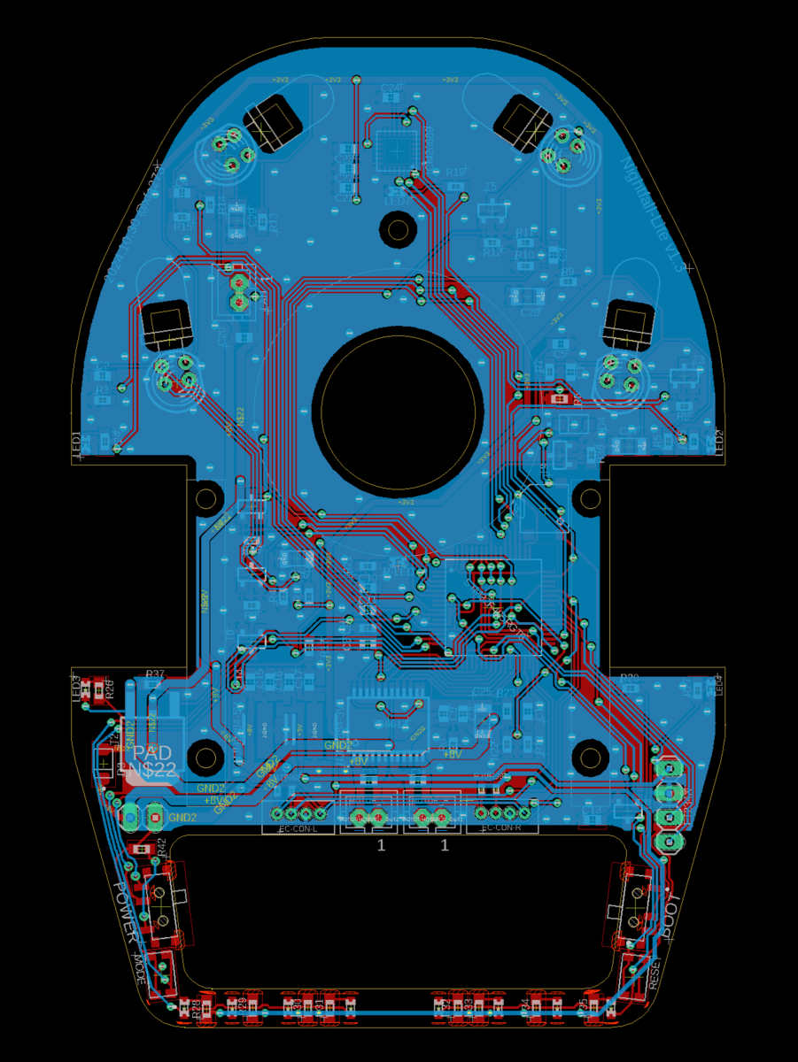
[picture p37: docs/blog/posts/2024-12-26_2024-season-machines/resources/image-3.png]


#### モーターマウント

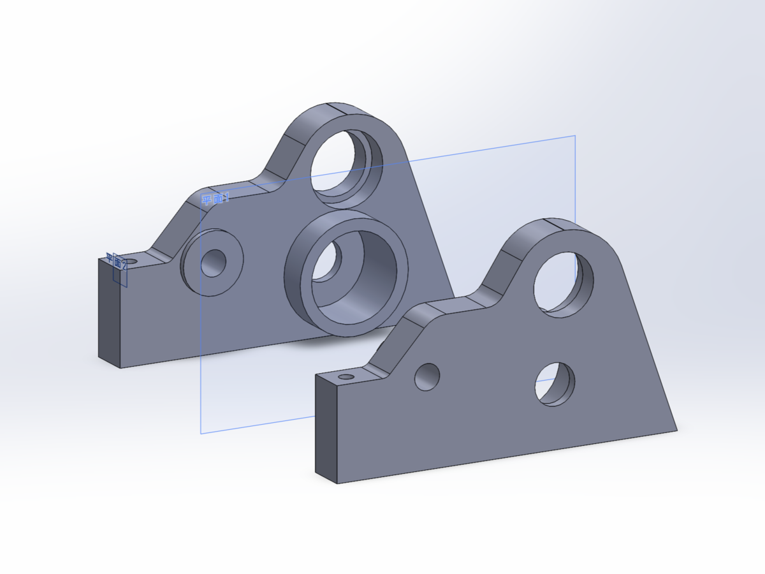
[picture p38: docs/blog/posts/2024-12-26_2024-season-machines/resources/image-4.png]


雪風のものを参考に設計し，JLCPCBのPOM切削で発注しました．ミスミMeviyと比べて仕上がりの個体差は大きいものの，より細かく複雑な形状まで対応してくれるので，マウスの部品を作るのには使いやすいと思います．左右合わせて$45ぐらいでした．（為替レートの影響で予備機の方がちょっと高い）
モーターはカプトンテープを巻いてキツさを調整しながら押し込んで固定，エンコーダはそのまま押し込んで固定しています．
ホイール軸，基板，ファンマウントの固定はM2/M3の下穴をあけるように発注し，手動でタップを切りました．固定用なら問題ありませんが，ホイール軸はタップ切りを上手くやらないと傾くので，他の方法を考えた方が良いかもしれません．

#### モーター

8520サイズで，[AliExpressで購入](https://ja.aliexpress.com/item/1005005530264040.html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)したもの．
理論的なモーター選定は行っていないのですが，以下3点を考慮して選びました．個体の選別はしていません．
・定格7.4V...電流が流れすぎなくて使いやすそうな気がする
・ギヤを通して減速する用途のもの...雪風が小型RC飛行機用のギヤ付きのものを使っていたので，プロペラを直付けする用のものより高トルクで良いのかなという想像
・軸の軸方向の遊びが少ない...機械的な作りが良さそうな気がする

#### ギヤ

XM-702と同じ構成です．バックラッシは0.1mmで設計し，特に問題なさそうです．
モーター側: M0.3 15T t2.0 真鍮 KKPMOで発注
ホイール側: M0.3 71T t2.0 POM ミスミCナビで発注
エンコーダ: M0.3 29T t2.0 POM ミスミCナビで発注
エンコーダのギヤはミスミだと穴径の小さいものが変えないので，3Dプリント製のスペーサーを挟んで使っています．

#### ファン

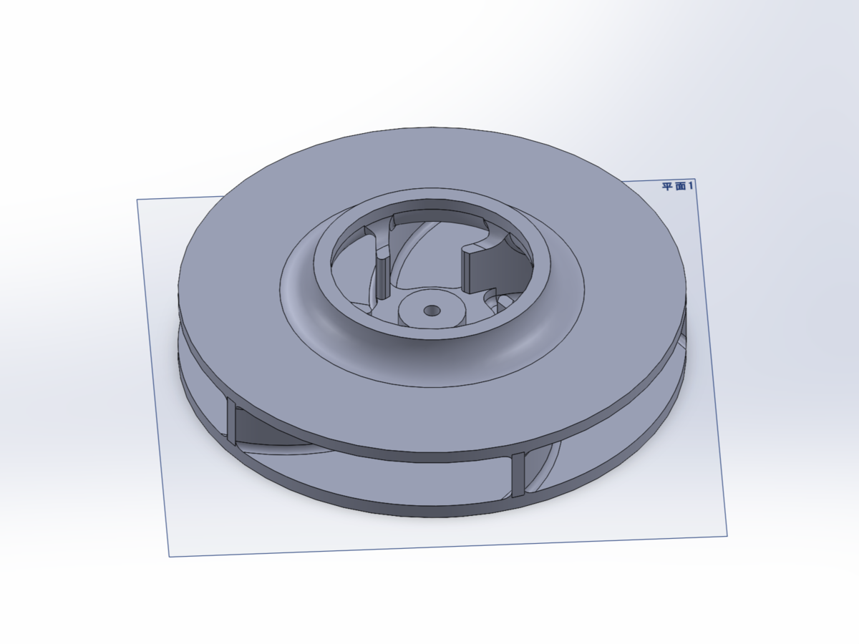
[picture p39: docs/blog/posts/2024-12-26_2024-season-machines/resources/image-5.png]


直径30mm，高さ5mmで，DMM.makeの高精細アクリルで発注しました．
基板のファン下部分に部品はありませんが，ダクト付きの形状にすることでクラッシュ時にファンの羽と基板が当たってファンが割れるのを防止しています．実際，フェイルセーフが上手く機能しない状態で吸引走行を行ってクラッシュしてもファンが割れることはありませんでした．
モーター軸との固定は圧入+接着剤（ロックタイト480）で，穴径はモーター軸径-0.03mmにしました．

#### ファンマウント

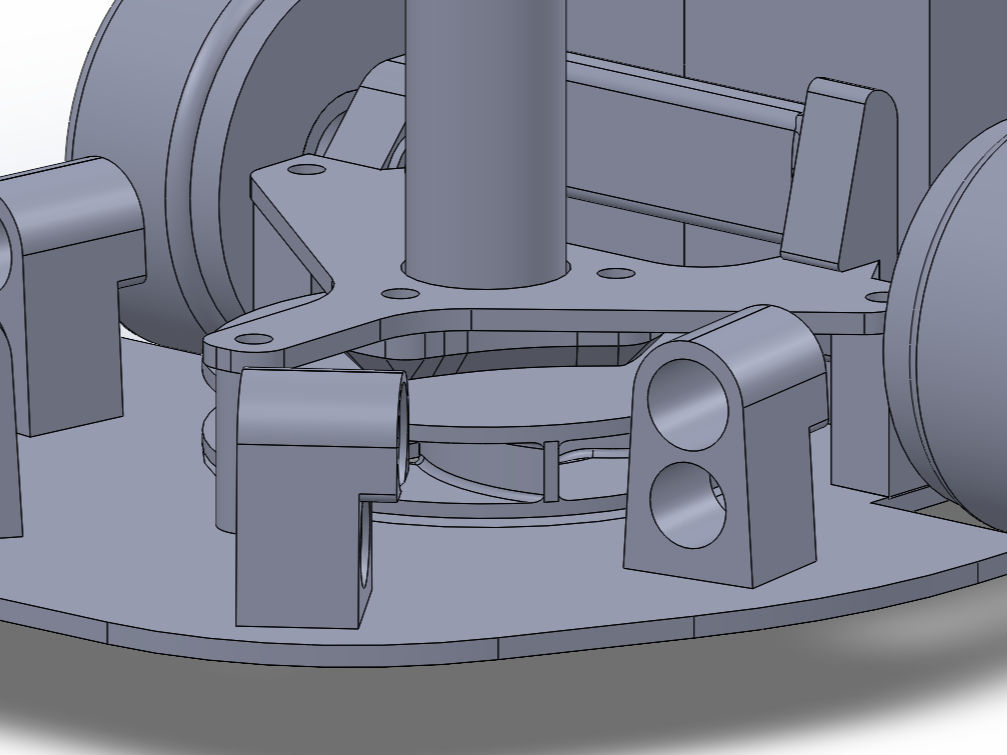
[picture p40: docs/blog/posts/2024-12-26_2024-season-machines/resources/image-6.png]


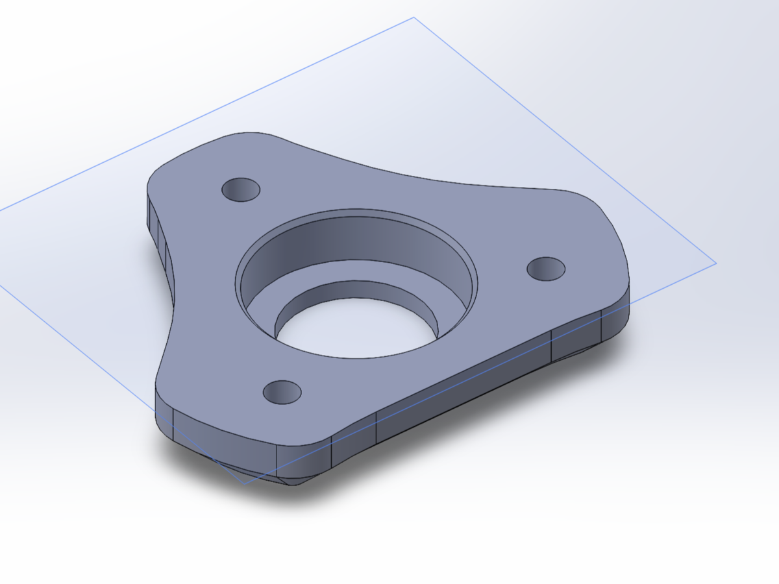
[picture p41: docs/blog/posts/2024-12-26_2024-season-machines/resources/image-7.png]


t1.2mmのPCBと3Dプリント部品（MJF PA12）を組み合わせています．プリント部品には薄い底面（0.8mm）があるため，ファンモータが緩んで落ちることはありません．
モーターとプリント部品は接着（ロックタイト480）し，プリント部品とPCBはプリント部品に下穴をあけて発注してタップを切りM2ねじでPCBに固定しています．
また，PCBに別のプリント部品を接着し，これによってバッテリーを走行モーターとの間で挟み込んで固定しています．

### マイクロマウス（旧ハーフサイズ）"CyberRat"

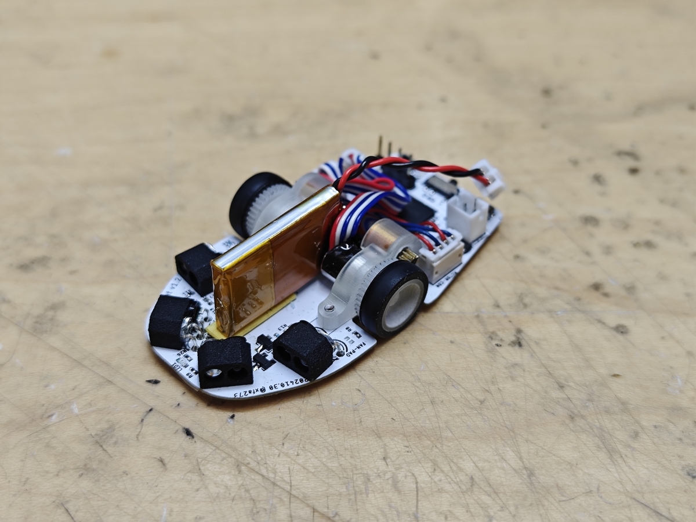
[picture p42: docs/blog/posts/2024-12-26_2024-season-machines/resources/image-8.jpg]


#### 戦績

九州地区大会:  8'005 11位
学生大会:  7'073 8位
東日本地区大会:  9'042 8位

#### 概要

DCモータ搭載のマイクロマウスとしては初めて製作した機体です．ハーフサイズで多く使われている磁気式エンコーダは実用にするのに様々なノウハウが要ると聞くので，[既製品の光学式エンコーダ](http://www.piezon.co.jp/ecc/html/products/detail.php?product_id=6)を使うことでこれを回避して手っ取り早く走るようにしたいという狙いでした．機体性能は大した事ないので上位には入れませんが，毎回最短走行を成功させており，目標としていたちゃんと走るハーフマウスにはなれたと思います．
基板面積を広く取れる設計でクラシックマウスと同じマイコンを搭載しており，ほぼ共通のプログラムで走ることが出来ます．（なので恐らく32x32だと探索が計算量溢れてダメ）
同様の既製品光学式エンコーダを搭載した機体として，["小天旋2 verMTL”](http://anikinonikki.cocolog-nifty.com/blog/2012/10/s-a467.html)を参考にしています．あとはBeeClone．

### 基板

パスコンの置き方が終わってるけど意外と普通に動いた．

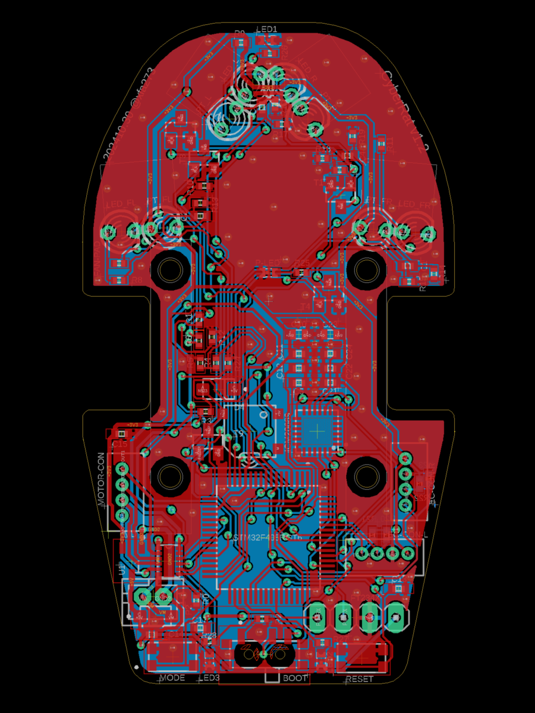
[picture p43: docs/blog/posts/2024-12-26_2024-season-machines/resources/image-9.png]


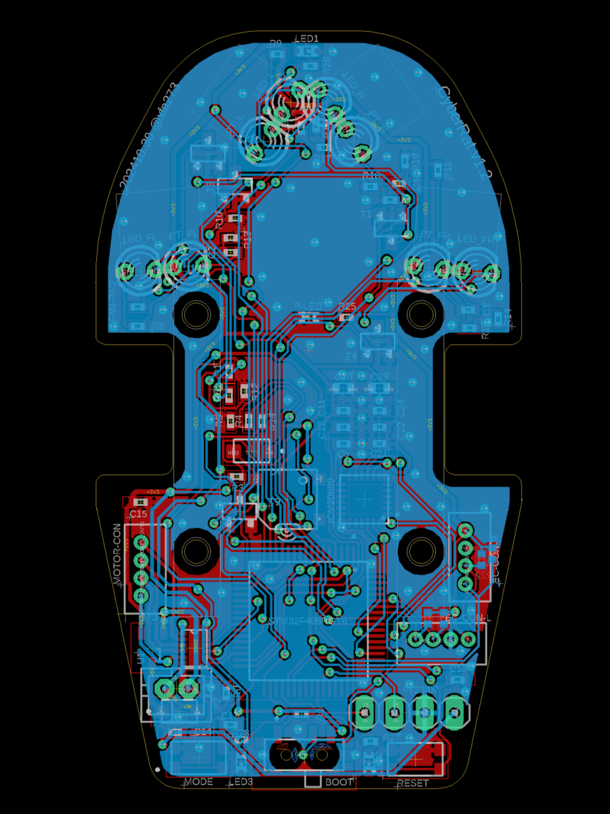
[picture p44: docs/blog/posts/2024-12-26_2024-season-machines/resources/image-10.png]


#### モーターマウント

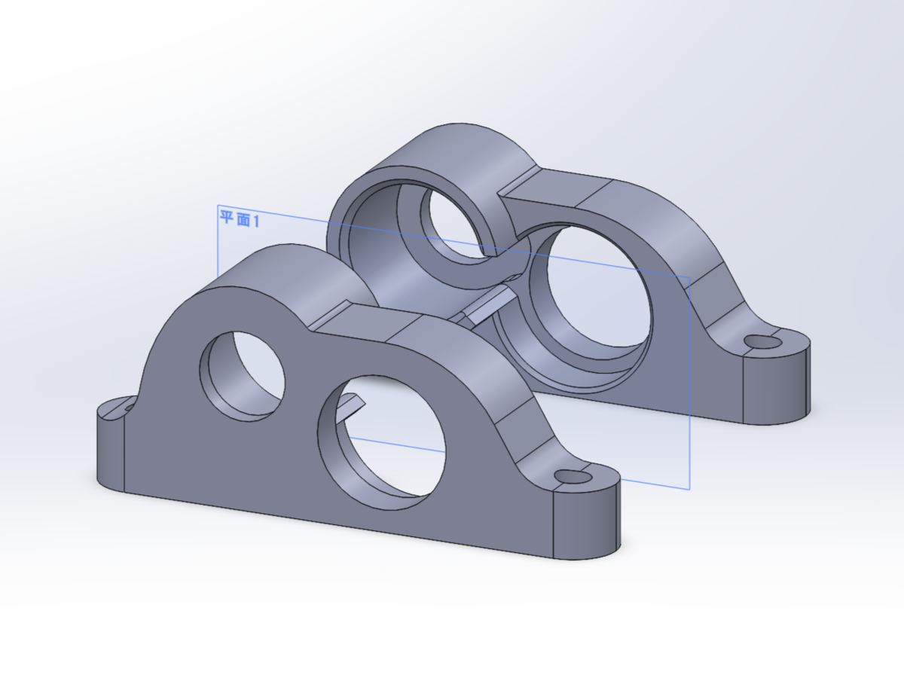
[picture p45: docs/blog/posts/2024-12-26_2024-season-machines/resources/image-11.png]


DMM.makeの高精細アクリルで作りました．クラシックと同様に，モーターはカプトンテープを巻いてキツさを調整しながら押し込んで固定，エンコーダはそのまま押し込んで固定しています．ネミコン7Sエンコーダ（やMTLの6mmのもの）は軸にベアリングが入っているので，エンコーダ軸に直接ホイールを差し込み，ホイールマウントを兼ねています.

#### モーター

何となく機体幅が狭い方が走りやすくて良いかなという理由で[610サイズのアリエク謎モーター](https://ja.aliexpress.com/item/1005005211443718.html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)を使いました．しかし，同仕様のはずなのに挙動の全然違うハズレモーターがあったり，そもそもトルク不足ぎみだったりするので，大人しくMk06とかを使った方が良さそうです．

#### ギヤ

モーター側: M0.3 9T t2.0 真鍮 RTで売っている
ホイール側: M0.3 35T t2.0 POM ミスミCナビで発注
今なら[Zilconia v2用のギヤがRTで売っている](https://www.rt-shop.jp/index.php?main_page=index&cPath=1002_1024_1283)ので，それを使うのが良い気がします．

### まとめ？

という感じで，今シーズンの機体紹介でした．シーズンというと全日本大会が残っていますが，去年と違って流石にもう新しいのは作らない予定です．多少の改修はしたいかもですが...

明日（もうとっくに数日前）の記事はエアプ回路レビュワーさんの[「小容量・小型LiPoバッテリーの研究とスポット溶接」](https://qiita.com/tanutanup/items/c2a9711e5febdee0d3cf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)です．自分も初めてハーフマウスを作ってLi-Po選び難しいなぁとなったので，参考にしたいと思います．お楽しみに．
