xfa273/nightfall-fw/docs/MINI_R3_SUCTION_MODE_LADDER.md

# mini_r3 吸引モード構成（t0.22）

2026-09-22 JST。`mini-r3-suction-modes-t0.22`。
mode3〜7を指定された速度/吸引率で再構成した。
mode2は既存のmini_r2由来設定を維持し、作業前から存在するローカル調整にも触れていない。
本書がt0.15〜t0.21のmode4/6/7構成に優先する。

## 手動調整と自動撮影の切り替え（t0.23）

`params/mini_r3_0/params.h` の `ENABLE_AUTO_VIDEO_CAPTURE` で切り替える。
mini_r3は手動調整用に `0U`（OFF）を初期値とし、`1U`（ON）で自動撮影を使う。
mini_r2は `params/f413_preorder/params.h` の同じ項目で設定し、既存動作を維持する `1U`。
設定を変更したら再ビルド・書き込みが必要。共通F413バイナリは機体IDに対応する設定を使う。

OFFでは全走行の撮影用START/STOP点滅、START後の300 ms待機、
撮影信号中だけの制御停止を省き、自動撮影導入前のログ開始/終了処理に戻す。
UARTの光学信号テスト `;` / `,` もdisabled表示だけになる。
ONでは従来の光学信号と待機を維持する（START 9.75秒+待機0.30秒、STOP 9.75秒）。
通常のモード表示LED・走行ログ・IMU校正・吸引ランプ・吸引到達後300 ms待機は両設定で有効。
走行パラメータ/ゲインと本書の停止位置は変更しない。

ON/OFF両方の実装をhostで確認済み（LED信号、走行開始/終了、吸引順序、機体設定選択）。
実機への書き込み・走行確認は未実施。mini_r3の版名は `mini-r3-manual-tuning-t0.23`。

## モードと当面の操作

| mode | 小回り m/s | 大回り90°/180° m/s | fan | 仮置き斜め m/s |
| --- | ---: | ---: | ---: | ---: |
| 2 | 現状維持 | 現状維持 | 現状維持 | 現状維持 |
| 3 | 0.8 | 1.0 | 50% | 1.0 |
| 4 | 1.0 | 1.4 | 70% | 1.4 |
| 5 | 1.2 | 1.7 | 100% | 1.5 |
| 6 | 1.2 | 2.0 | 100% | 1.5 |
| 7 | 1.4 | 2.2 | 100% | 1.5 |

斜め速度は未指定のため、既存の1.5 m/sを上限とし、大回り以下で仮置き。
各角加速度/オフセットはシミュレータから設定したが、斜めの実走は
mini_r2で安定動作確認後とする。パラメータと選択項目は用意した状態で保留する。

mode3〜7の吸引case0は次の共通配置。

| sub | 試験 | 使用するcase | 当面の扱い |
| --- | --- | --- | --- |
| 0 | 小回りR90 | case1 | 調整対象 |
| 1 | 大回りR90 | case2 | 調整対象 |
| 2 | 大回りR180 | case2 | 調整対象 |
| 3 | R45 in | case8 | 斜め確認後 |
| 4 | L45 out（R45 inから進入） | case8 | 斜め確認後 |
| 5 | L-V90（R45 inから進入） | case8 | 斜め確認後 |
| 6 | R135 in | case8 | 斜め確認後 |
| 7 | L135 out（R135 inから進入） | case8 | 斜め確認後 |
| 8 | 直進 | case1 | 調整対象 |
| 9 | 直進 | case5 | 調整対象 |

通常最短もcase1〜7を当面の対象とし、斜めを含むcase8/9は保留。
case0のターン試験ではt0.21の修正を継承し、前後直進も対象ターン速度以下。
直進のみのsub8/9は各caseの直進設定を使う。
mini_r2のfan-off case0には従来の割当てを適用する。

2026-09-22追記: 後部を壁につけた開始で大回り180°の停止前に接触するという
実機報告を受け、**mode2〜7のcase0にある全180°試験のターン前直進を90 mm延長**した。
吸引mode3〜7/sub2は `S4,R180,S3` → **`S6,R180,S3`**（180→270 mm）。
非吸引側も該当する先行S3/S4をS5/S6へ変更し、mini_r2にも共通適用する。
非吸引mode7の180°試験は従来どおりsub7にある。
ターン速度/角加速度/オフセット、後続直進、停止距離の計算は変えない。

吸引mode3〜7のcase0の設計停止位置（開始時の機体中心を原点、前方/右方向）は次のとおり。
発進10 mmと停止45 mmを含む。ログの累積走行距離とは異なる。

| sub | 試験 | 前方への変位 mm | 右への変位 mm | 停止時の向き |
| --- | --- | ---: | ---: | --- |
| 0 | 小回りR90 | 190 | 225 | 右 |
| 1 | 大回りR90 | 280 | 270 | 右 |
| 2 | 大回りR180 | **100** | **90** | 後ろ |

180°の旧停止位置は前方10 mm・右90 mmだったため、停止位置を開始壁から90 mm離す変更となる。
mode2/sub2の停止位置は前方 `235 - stop_mm`、右90 mm。
現ローカル加減速度2 m/s²の `stop_mm=62.500` では前方172.5 mm、
1 m/s²の `stop_mm=125.000` では前方110 mmとなる。
今回の追記はhost-onlyの経路変更で、延長後の実機停止位置は未確認。

## 直進速度・加減速度

通常の経路生成はcase1が小回りのみ、case2〜7が大回り変換、case8/9が斜め。
そのためcase1の最低値は小回り速度、case2の最低値は大回り速度から計算する。
大回りcase0はcase2に切り替え、case1の上限を引き上げず試験可能にした。

最低加減速度は、ターン速度から半区画0.045 mで停止できる
`a = v_turn² / (2 × 0.045)`を **1 m/s²単位で切り上げた値**。
低速/高速加速度には同じ値を入れ、切替速度は大回り速度とする。

| mode | case1速度 m/s | case1加減速度 m/s² | case2速度 m/s | case2加減速度 m/s² |
| --- | ---: | ---: | ---: | ---: |
| 3 | 0.8 | 8 | 1.0 | 12 |
| 4 | 1.0 | 12 | 1.4 | 22 |
| 5 | 1.2 | 16 | 1.7 | 33 |
| 6 | 1.2 | 16 | 2.0 | 45 |
| 7 | 1.4 | 22 | 2.2 | 54 |

case3〜9はcase2を基準として、`n = case - 2`ごとに
直進速度を`+0.2 × n m/s`、加減速度を`+1 × n m/s²`増やす。
例えばmode7はcase3=2.4 m/s・55 m/s²、case5=2.8・57、case7=3.2・59、case9=3.6・61。
長い直線でこれらの上限へ加速するため、高いcaseの実機追従は順に確認する。

斜め直進は仮置きターン速度をbaselineとし、同じ半区画停止式で加速度を設定。
case3以降は速度+0.1 m/s、加減速度+1 m/s²ずつとした（現時点では運用保留）。
既存の各caseの壁/斜めゲイン、solver profile、モードの壁しきい値は維持。
FAN_ON/OFFのPID・FFゲインも変更していない。

## シミュレータ

[PR #21](https://github.com/xfa273/nightfall-fw/pull/21)、
commit `ab377c8b937db2fdbc515d2d55970becd16866be` の
`turn_simulator.simulation()`、理想応答 `DynamicsModel()` を使用。
全吸引モードで1 kHz、rounding=1.2、`turn_omega_max=3000 deg/s`を明示した。
既存のmini_r2実測モデルは今回のmini_r3吸引条件には流用しない。

alphaを500 deg/s²刻みで走査し、コア終点から正の入口/出口距離を解く。
180°は横方向誤差0.001 m以下を要求し、入口0.001..0.039 mを0.002 m刻みで走査。
オフセットは0.0001 m単位へ丸め、PR21の終点誤差0.001 m以下で絞る。
公称壁余裕の最大から0.00025 m以内の候補のうちalpha最小を選ぶ。
同じ速度・3000 deg/s条件のt0.21候補は再利用し、最終C初期値を全て再検証した。

| mode | ターン | 速度 m/s | alpha deg/s² | 入口 m | 出口 m |
| --- | --- | ---: | ---: | ---: | ---: |
| 3 | 小回り90° | 0.8 | 50000 | 0.0006 | 0.0010 |
| 3 | 大回り90° | 1.0 | 20500 | 0.0036 | 0.0037 |
| 3 | 大回り180° | 1.0 | 18000 | 0.0010 | 0.0015 |
| 4 | 小回り90° | 1.0 | 79000 | 0.0008 | 0.0012 |
| 4 | 大回り90° | 1.4 | 40500 | 0.0038 | 0.0051 |
| 4 | 大回り180° | 1.4 | 35000 | 0.0010 | 0.0011 |
| 5 | 小回り90° | 1.2 | 115000 | 0.0009 | 0.0017 |
| 5 | 大回り90° | 1.7 | 56000 | 0.0008 | 0.0015 |
| 5 | 大回り180° | 1.7 | 52000 | 0.0010 | 0.0022 |
| 6 | 小回り90° | 1.2 | 115000 | 0.0009 | 0.0017 |
| 6 | 大回り90° | 2.0 | 87000 | 0.0057 | 0.0075 |
| 6 | 大回り180° | 2.0 | 72000 | 0.0010 | 0.0015 |
| 7 | 小回り90° | 1.4 | 163500 | 0.0014 | 0.0014 |
| 7 | 大回り90° | 2.2 | 107000 | 0.0062 | 0.0083 |
| 7 | 大回り180° | 2.2 | 105000 | 0.0030 | 0.0036 |

設定alphaは平滑化profileの係数であり、瞬間角加速度の最大値とは異なる。
1.2 m/s小回りは旧mode6の2200 deg/s上限から3000 deg/s上限で再計算し、
alpha134000→115000、名目最大omega約2626.8 deg/sとなる。
1.4 m/s小回りはt0.21と同じalpha163500・3000 deg/sを維持。

斜めの仮置き値（mode5/6/7は共通）:

| mode | ターン | 速度 m/s | alpha deg/s² | 入口 m | 出口 m |
| --- | --- | ---: | ---: | ---: | ---: |
| 3 | 45° in | 1.0 | 30500 | 0.0007 | 0.0200 |
| 3 | 45° out | 1.0 | 30000 | 0.0189 | 0.0007 |
| 3 | V90° | 1.0 | 77000 | 0.0188 | 0.0192 |
| 3 | 135° in | 1.0 | 33000 | 0.0167 | 0.0090 |
| 3 | 135° out | 1.0 | 35000 | 0.0124 | 0.0210 |
| 4 | 45° in | 1.4 | 61500 | 0.0011 | 0.0206 |
| 4 | 45° out | 1.4 | 57000 | 0.0181 | 0.0007 |
| 4 | V90° | 1.4 | 146000 | 0.0179 | 0.0189 |
| 4 | 135° in | 1.4 | 66500 | 0.0181 | 0.0108 |
| 4 | 135° out | 1.4 | 68000 | 0.0117 | 0.0197 |
| 5/6/7 | 45° in | 1.5 | 71000 | 0.0012 | 0.0205 |
| 5/6/7 | 45° out | 1.5 | 65500 | 0.0180 | 0.0006 |
| 5/6/7 | V90° | 1.5 | 144500 | 0.0144 | 0.0144 |
| 5/6/7 | 135° in | 1.5 | 74000 | 0.0162 | 0.0088 |
| 5/6/7 | 135° out | 1.5 | 77000 | 0.0108 | 0.0190 |

左右合計80ターンで終点誤差最大0.000952 m、角度誤差0.000254°、
名目最大角速度3000 deg/s。0.070×0.039 m矩形機体と0.090 m区画・0.006 m壁/柱、
コーナー補間移動量0.0005 m以下で公称衝突なし。
全体最小公称壁余裕0.007461 m、モデル位置誤差0.005 m等を差し引いた
有効最小余裕0.001486 mは要求0.003 m未達。特に斜めは保留のままとする。
シミュレーションは実機追従・duty余裕・実迷路の検証ではない。

ローカル解析ファイル: `build/mini_r3_mode_ladder/`の
`scan_cardinal.py`、`scan_diagonal.py`、`selected_*`、`verify.py`、`final_verified.json`。
alpha走査範囲はcardinal順に小800:40000..100000、小1000:65000..140000、
小1200:90000..180000、大90/1000:18000..35000、大180/1000:14000..30000、
大90/1400:30000..65000、大180/1400:30000..60000、
大90/1700:50000..100000、大180/1700:40000..80000、
大90/2200:90000..170000、大180/2200:75000..180000。
小1400・大2000・斜め1500はt0.21の走査記録を参照。
斜め1000は45in/out:25000..60000、V90:40000..110000、135in/out:25000..65000。
斜め1400は45in/out:50000..100000、V90:85000..180000、135in/out:50000..110000。

## 直近ログ

| CSV時刻（20260922） | mode7 sub | ターン速度 m/s | 最大duty | 飽和サンプル |
| --- | ---: | ---: | ---: | ---: |
| 115632 | 0 | 1.4 | 100% | 13 |
| 115910 | 1 | 2.0 | 85.1% | 0 |
| 120132 | 2 | 2.0 | 85.0% | 0 |

小回りの旋回実角速度最大3276.8 deg/s、目標速度profile最大1.4 m/sで、
前回の1.5 m/s指令問題は再発していない。feedback速度には最大1.606 m/sの追従overshootがある。
大90/180の旋回中feedback速度は1.694..1.996 / 1.573..1.987 m/s。
余裕のある大回りを上げ、小回りは指定の1.4 m/sまでとする構成を設定した。
CSVに実機のFW SHA/全gain情報はないため、実機設定との完全一致は断定しない。

CSV SHA256（ログ本体はGit管理外）:

- 115632: `ee0ae9d932d00e1b5ac09a48cb357127506878dca0d6a181e8320c07b0284f02`
- 115910: `7bf65e17fecae3008e866fade66febfdd706860a14be653e68e20b25245c6e35`
- 120132: `c282cf1ab5e9bb7889fad94606ab4f0deac158d4b7cf7f1a481208668d9f4baf`

## 検証・実機操作

- 全5モード、case0全50項目のpreflightと全速度phase。case1/2最低値から1 m/s²下げると停止条件を満たさないことも検証。
- 各モード2444経路（計12220）。case1は小回り、case2〜9は全ターンの最短S1/DS1接続・開始・停止を壁切れon/offで検証。
- 実production sessionで小回り/大90/大180の15試験が最大速度どおり・正常終了。fan50/70/100%、70%まで840 msを含むrampと到達後300 ms待機を確認。
- mini_r2の全5モード×10 subのlegacy割当て維持。runtime profile/ゲイン非変更、mode4回帰、両機体全6モード×9caseのパラメータ反映、fan中断/cleanup。
- ASan/UBSanホスト検証、F413/F405 build、`git diff --check`。

F413 RAM274160 B / Flash373620 B。HIL区分はhost-only。
実機UART・flash・reset・モータ・ファン・走行・NVMコマンドは実行していない。
制御loop・fan ramp/待機時間・F405ソース・mini_r2パラメータ・NVM/log schema・CubeMX・stable設定は不変。
既存ローカルのmode2加速度、flashing tool、CAD変更は保持し、本コミットから除外する。
