xfa273/nightfall-fw/docs/ai/INDEPENDENT_PR_INTEGRATION_20260923.md

# 2026-09-23 独立PRの統合と保留

ユーザ指示により、mini_r3調整中のファーム本体に影響しないPR #16/#20/#21をmainへ統合する。ファーム/共通経路処理に影響するPR #1/#17/#18/#19は、mini_r3調整完了後まで保留する。

## 今回の統合

| PR | 元head | 範囲 |
|---|---|---|
| [#16](https://github.com/xfa273/nightfall-fw/pull/16) | `cfd8dc836f9dc70b60fb80240a6ec27940411ac6` | WeAct adapterのCAD/製造データ/設計記録 |
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
