xfa273/nightfall-fw/docs/blog/posts/2023-12-19_ca-161-bis-introduction/resources/image-13.jpg

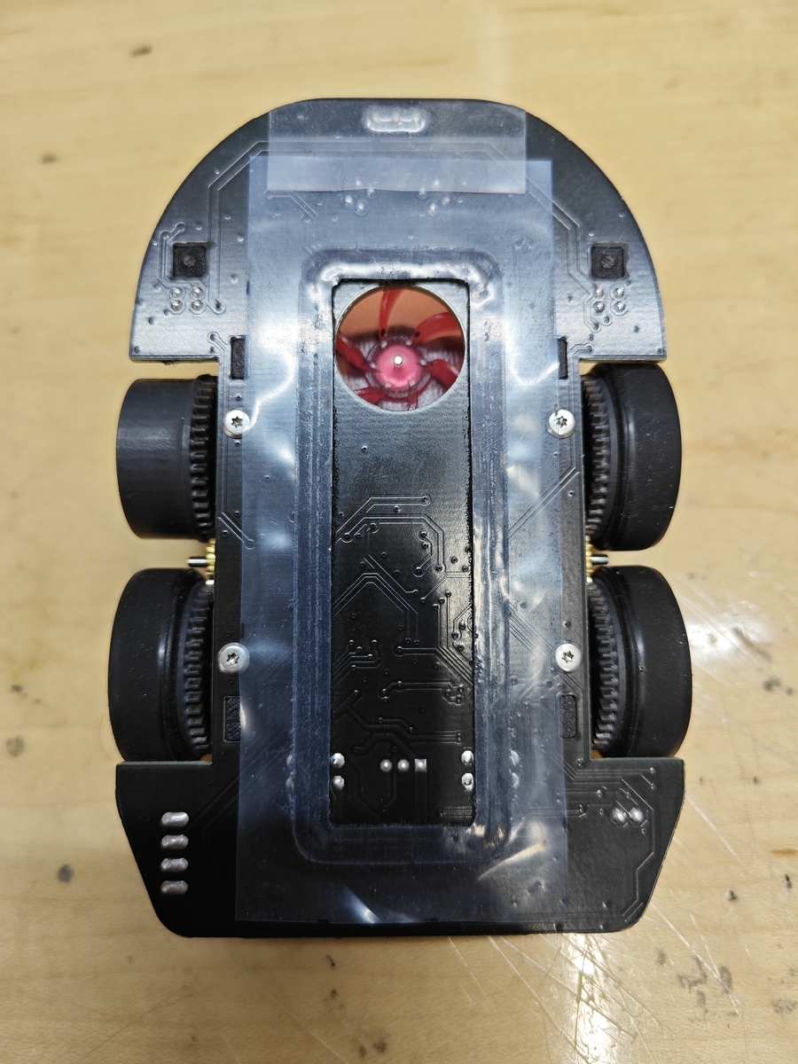
docs/blog/posts/2023-12-19_ca-161-bis-introduction/resources/image-13.jpg
