xfa273/nightfall-fw/hardware/mini_r2_0/cad/kicad/WeAct-Adapter-5V/preview/bottom.png

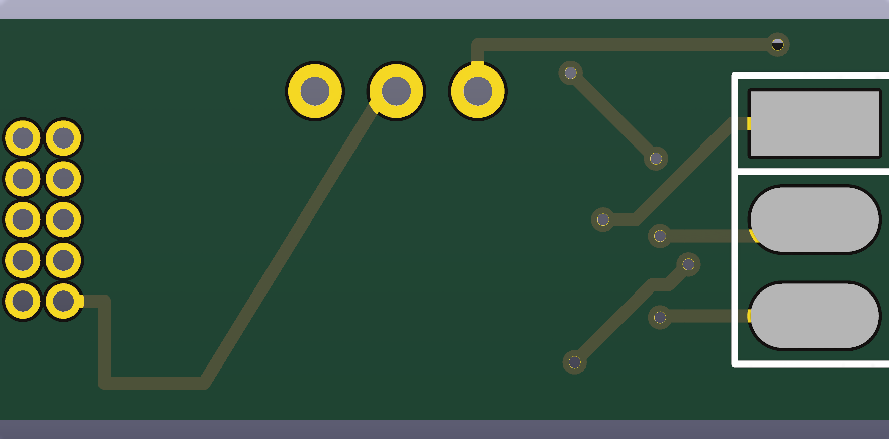
hardware/mini_r2_0/cad/kicad/WeAct-Adapter-5V/preview/bottom.png
