xfa273/nightfall-fw/hardware/mini_r2_0/notes/erc.png

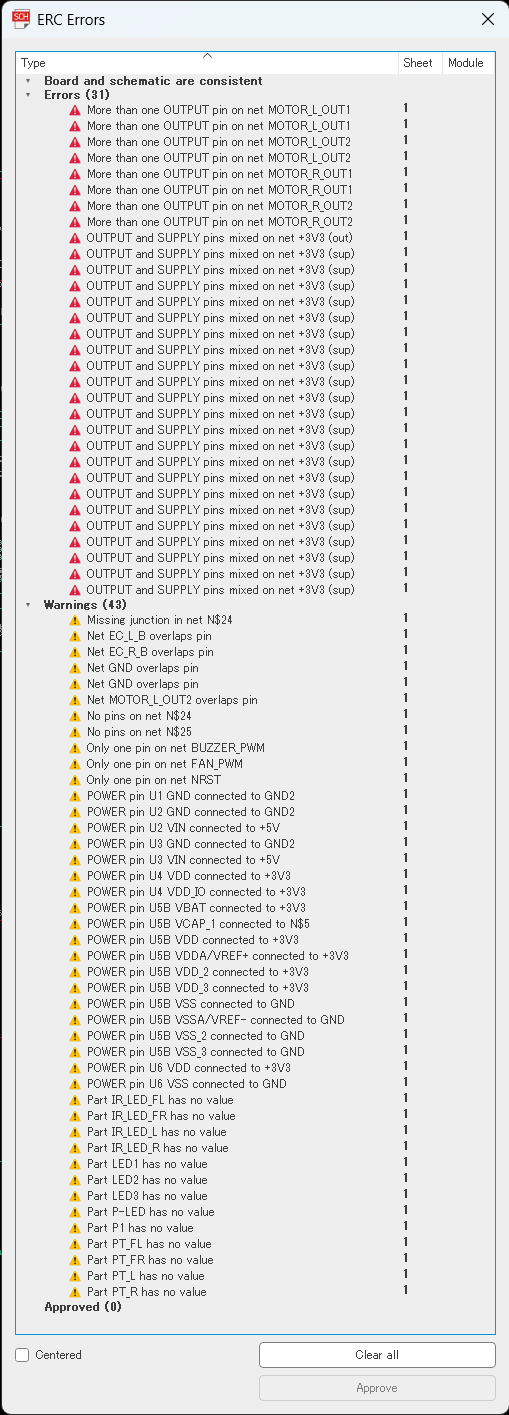
hardware/mini_r2_0/notes/erc.png
