xfa273/nightfall-fw/hardware/mini_r2_0/notes/スクリーンショット 2026-03-22 15.33.39.png

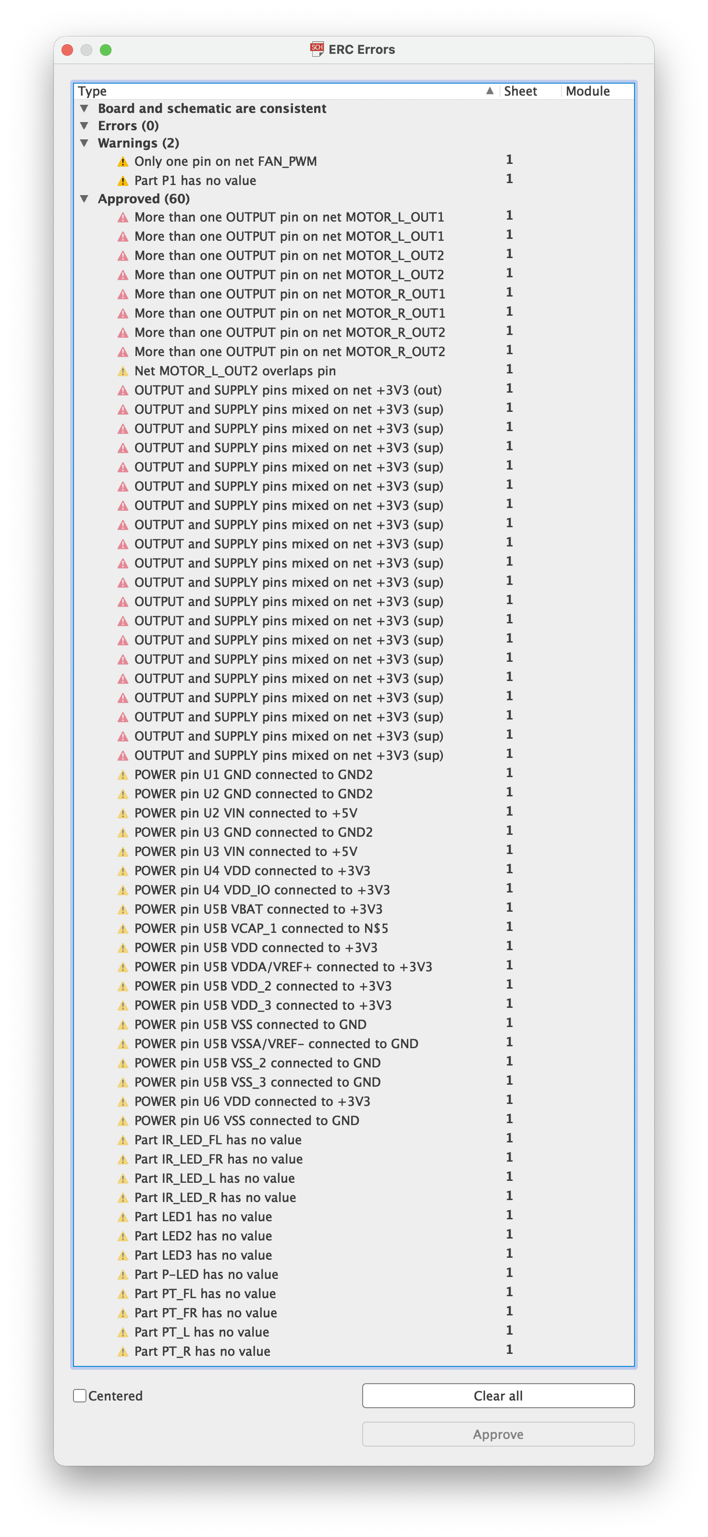
hardware/mini_r2_0/notes/スクリーンショット 2026-03-22 15.33.39.png
