xfa273/nightfall-fw/hardware/mini_r2_0/cad/export/reference/eagle_ordered_2026-03-22/README.md

# Eagle ordered Gerber 2026-03-22

This directory stores the Gerber zip that was actually ordered from JLCPCB and confirmed working for `HM_Nightfall-mini-2e_v1`.

- Source file: `/Users/xfa273/Downloads/HM_Nightfall-mini-2e_v1_2026-03-22.zip`
- Stored file: `HM_Nightfall-mini-2e_v1_eagle_ordered_2026-03-22.zip`
- CAD source: `hardware/mini_r2_0/cad/eagle/HM_Nightfall-mini-2e_v1.sch` / `.brd`
- CAM source: `hardware/mini_r2_0/cad/eagle/HM_Nightfall-mini_v1.cam`

Use this zip as the visual and manufacturing reference when comparing KiCad-generated Gerbers.
