xfa273/nightfall-fw/hardware/mini_r2_0/cad/export/jlcpcb/main_mount_1p6_20260921/HM_Nightfall-mini-2e_v1_mount-1p6_fabrication.pdf

# MAIN PCB | FABRICATION DRAWING

HM_Nightfall-mini-2e_v1 / 2026-09-21

## 4 x D1.60 NON-PLATED MOUNTING HOLES

Units: mm | Nominal dimensions | Do not scale | All CAM files share the same origin

Full profile - viewed from top

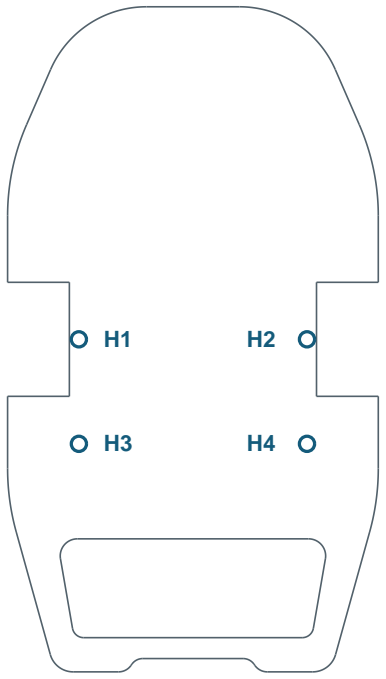
[picture p64: figure]

39.00
Overall nominal size: 39.00 x 70.00

Upper holes - edge detail

0.20

D1.60

BOARD MATERIAL

Edge

0.20 mm web applies to H1 and H2. Preserve hole centers and final profile.

Mounting centers - CAM coordinates (Gerber Y is negative)

Hole | Position | X | Y | Diameter
H1 | Upper left | 136.501098 | -105.003598 | 1.60 NP
H2 | Upper right | 160.501098 | -105.003598 | 1.60 NP
H3 | Lower left | 136.503667 | -116.003598 | 1.60 NP
H4 | Lower right | 160.501098 | -116.003598 | 1.60 NP

### Fabrication instructions

1. Two copper layers, FR-4; nominal board thickness 1.60 mm from the source PCB.
2. H1-H4 are NON-PLATED circular internal profiles in Edge.Cuts, not in the drill files. Produce four finished D1.60 holes. Do not add plating or duplicate these features.
3. Separate drills: 199 plated holes and two D0.90 non-plated switch mounting holes.
4. Keep the 0.20 mm webs at H1/H2. Review routing support before manufacture.
5. Use the included top legend; the bottom legend is empty. Do not mirror CAM layers.
6. Bare PCB package only. Copper weight and finish are selected with the manufacturer.

Source DRC: 4 existing errors / 112 warnings / 0 unconnected. See FABRICATION_NOTES.txt. Physical mounting strength and assembly fit have not been tested.

Source: e2ba19b74438 | KiCad 10.0.3 | Detailed provenance: SOURCE_MANIFEST.json
