xfa273/nightfall-fw/docs/MINI_R3_MODE6_SUCTION_TUNING.md

# mini_r3 mode6 吸引ゲイン調整（2026-09-21）

追記（t0.22）: 現在の速度・吸引率・case0割当ては[吸引モード構成](MINI_R3_SUCTION_MODE_LADDER.md)を参照。以下は変更前の記録。

追記（t0.21）: [mode7追加とcase0速度修正](MINI_R3_MODE7_SUCTION_TUNING.md)。mode6/sub0の前後直進も小回り設定1.2 m/s以下に統一。

追記（t0.20）: [発進時の積分残留対策・case0停止待ち修正](MINI_R3_SUCTION_STARTUP_FIX.md)。

追記（t0.19）: 並進FFの実測改善後、角度Pと旋回FFを追加調整。
[全ゲイン再確認](MINI_R3_SUCTION_GAIN_REVIEW.md)を参照。

追記（t0.18、2026-09-22）: 現在のmode6ファン100%・速度P=0.35・角速度P=0.8を
引き継ぎ、09:52ログから並進FFを65/0.110/0.0100へ更新した。
[FF調整記録](MINI_R3_SUCTION_FF_TUNING.md)を参照。以下のファン50%・ゲイン表は初期値の履歴。

追記（t0.17）: 共通の固定速度制限を撤去し、omega 2200 deg/sはモードの
`turn_omega_max`へ明示。case0の停止距離は設定加速度に従う。
現在の仕様は [固定上書き撤去](F413_RUN_PARAMETER_LIMITS.md) を参照。以下は準備時の記録。

識別版 `mini-r3-mode6-fan50-t0.16`。ユーザからt0.15の吸引走行が安定したと
報告を受け、mode6を小回り1.2 m/s、大回り・斜め1.5 m/sのcase0調整用に設定。
ファン50%、50%到達600 ms・到達後300 ms待機、開始前20 msの位置・角度保持を継承する。
今回の変更はホスト検証までで、実機書込・駆動は行っていない。

## 吸引ゲイン

F413制御が `f413_hw_fan_is_running()` によってゲインを選ぶ。
ファンPWM開始成功後はランプ中から `FAN_ON`、開始前・停止後・開始失敗時は
`FAN_OFF`。PWM駆動状態の判定であり、実回転数の計測ではない。
制御・姿勢基準のリセットは追加しない。mode4にも同じ切替が適用される。

`params/mini_r3_0/params.h` のFAN_ON全19項目を現在のFAN_OFFと同じ数値にした。
独立した定数なので、以後FAN_ONだけを変更して吸引時の調整を進められる。

| 制御 | P | I（1 ms周期） | D | FF |
|---|---:|---:|---:|---|
| 速度 | 0.24 | 0.001 | 0 | static=35、velocity=0.035、accel=0.004 |
| 距離 | 2 | 0 | 0 | 1 |
| 角度 | 10 | 0.1 | 0 | 1 |
| 角速度 | 0.45 | 0.006 | 0 | omega=0、alpha=0 |

## シミュレータによるターン初期値

[PR #21](https://github.com/xfa273/nightfall-fw/pull/21)の
`ab377c8b937db2fdbc515d2d55970becd16866be` にある
`turn_simulator.simulation()` の理想モデルを使用。1 kHz、rounding=1.2、
omega上限2200 deg/s、角度は正確な90/180/45/135度とした。
既存のmini_r2右135-in・500 mm/sの実測モデルは今回の条件に外挿しない。
alphaはファームのプロファイル係数であり、実角加速度ピークではない
（上限非飽和時のcosine微分ピークは約1.309倍）。左右には同じ係数・距離を設定した。

| ターン | 速度 mm/s | alpha deg/s² | 入口 mm | 出口 mm | 理想終点誤差 mm | 最小外形余裕 mm |
|---|---:|---:|---:|---:|---:|---:|
| 小回り90 | 1200 | 134000 | 0.9 | 1.7 | 0.788 | 11.758 |
| 大回り90 | 1500 | 45500 | 2.8 | 2.9 | 0.223 | 15.751 |
| 大回り180 | 1500 | 41000 | 1.0 | 1.3 | 0.994 | 14.308 |
| 45-in | 1500 | 71000 | 1.2 | 20.5 | 0.737 | 7.834 |
| 45-out | 1500 | 65500 | 18.0 | 0.6 | 0.925 | 8.006 |
| V90 | 1500 | 159500 | 11.1 | 11.7 | 0.980 | 5.947 |
| 135-in | 1500 | 98000 | 17.4 | 10.2 | 0.407 | 7.648 |
| 135-out | 1500 | 117000 | 13.7 | 22.8 | 0.984 | 7.689 |

同PRの自動tune既定alpha上限40000では今回の高速ターンが閉じないため、
simulationをalpha刻み500で走査。表の順に探索範囲は110000..200000、
40000..90000、30000..60000、60000..160000、60000..140000、
90000..200000、55000..140000、55000..140000。
`turn_clearance.canonical_scene()` の目標へ入口・出口を解き、0.1 mmに丸め、
各距離0.5..60 mmかつPR21の終点誤差1 mm以内の候補を選ぶ。
180度はコア横誤差1 mm以内、入口1..39 mmを2 mm刻みで走査し出口を解く。
70×39 mm外形・90 mm区画・6 mm壁/柱で外形余裕を比較し、最大余裕から
0.25 mm以内の候補中で最小alpha、次に最小終点誤差を採用した。

実際のC初期値を読み戻し、左右16ターンをPR21で再計算した結果は
終点誤差最大0.995 mm未満、角度誤差0.001度未満。
外形の角の移動を0.5 mm刻みまで補間した名目軌道では接触しない。
ただし位置/モデル誤差5 mmと既定の機械・角度・補間誤差を引くと、
斜めの有効余裕は約-0.027..2.032 mmで、要求3 mmを満たさない。
特にV90はomega上限2200 deg/sに達し、実角加速度ピーク約208283 deg/s²、
横加速度約57.6 m/s²となる。実機の追従性・飽和・壁余裕は未確認で、
`safe_recommendation_available=false`。case0調整用の初期値であり、
迷路走行のクリアランスを保証するものではない。
計算スクリプト・各候補・再検証JSONはローカル `build/mini_r3_mode6/` に保存（Git対象外）。

## case0操作

通常のOP UIでmode6 → case0 → subを選択する。ファン始動順序は
[mode4の記録](MINI_R3_MODE4_SUCTION_TUNING.md)と同じ。

| sub | 対象 | 実際の経路 |
|---|---|---|
| 0 | 小回り右90 | S3、小回りR90、S3 |
| 1 | 大回り右90 | S4、大回りR90、S3 |
| 2 | 大回り右180 | S4、大回りR180、S3 |
| 3 | 右45-in | S4、R45-in、DS3 |
| 4 | 左45-out | S4、R45-in、DS3、L45-out、S3 |
| 5 | 左V90 | S4、R45-in、DS3、L-V90、DS3 |
| 6 | 右135-in | S4、R135-in、DS3 |
| 7 | 左135-out | S4、R135-in、DS3、L135-out、S3 |
| 8 | 直進case1 | S9 |
| 9 | 直進case5 | S9 |

S1は45 mm、DS1は45√2 mm。各経路には既存の開始10 mm・停止45 mmを含む。
sub0..2/8はcase1、sub3..7はcase8、sub9はcase5を使用。
正確な角度積算を使用し、前壁/壁切れ補正は無効、壁制御は既存設定を継承。
mode6の小回り入口変更で通常走行時の前壁目標は89.1 mmとなるが、case0では使わない。

## 直進と接続性

mode6の全9ケースは縦・斜めの最高速度1500 mm/s、加速・減速とも
25000 mm/s²に統一。直進をターンより速くせず、短い接続区間を成立させる。
最小S1で1200↔1500 mm/sをつなぐには9000 mm/s²、開始10+45 mmで
0→1500 mm/sには20455 mm/s²弱、最後の45 mmで1500→0 mm/sには
`1500²/(2×45)=25000 mm/s²` が必要。最後の停止条件を満たす値を採用した。
これは経路の計算上の成立条件であり、実機で25 m/s²を達成できるかは未検証。

実production preflightで、全ケース・壁切れ補正ON/OFFについて、左右16ターンの
最短発進/停止および方向の整合する全ターン対を最小S1/DS1で接続し、
計2736経路が成立。case0の10経路も実dispatcherから検証した。
任意の不正なコード列・異なる速度のターンを直進なしで直結する列までの保証ではない。
既存preflightの加減速制約を緩める変更はない。

## 検証と適用範囲

- ASan/UBSan: mode6 case0全10項目・2736接続経路、既存mode4全10項目・path-linear225件。
- 実1 kHz制御を使用した別値ON/OFFの選択試験：速度/FF・距離・角度・角速度。
  既存停止/位置保持試験、PWM開始/失敗/停止状態、mode6吸引セッションもPASS。
- 機体runtime profile/ゲイン19項目/前壁目標、route precompute14210件、F413/F405 Debug build、diff check PASS。
- mode4のターン値、r2のパラメータ・fanless case0、F405ソースを維持。
  FAN_ON選択は共通F413制御の変更だが、r2はfan capabilityなしでFAN_OFFを継続する。
- mode2専用事前計算表の数値は不変。共通runner変更による入力SHAのみ更新し、
  commit用SHAは無関係なローカルmode2編集を除外。r3用事前計算表の追加はない。
- 実機コマンド列なし。UART/flash/reset/motor/fan/NVM操作・LUT・schema・`.ioc`・stable保存点の変更なし。
  t0.15の安定報告はユーザ評価であり、t0.16の高速ターン実測確認とは区別する。
