xfa273/nightfall-fw/docs/MINI_R3_SUCTION_FF_TUNING.md

# mini_r3 吸引FF初期調整（2026-09-22）

追記: 10:17の再走行で並進・停止の改善を確認し、t0.19で旋回側を追加調整した。
最新状態は[全ゲイン再確認](MINI_R3_SUCTION_GAIN_REVIEW.md)を参照。以下はt0.18の記録。

調整版 `mini-r3-suction-ff-t0.18`。ユーザの再走行用の暫定値であり、実機未検証。
現ローカルの速度P=0.35、角速度P=0.8、mode6ファン100%を変更せず設定として保存し、
並進FFの摩擦・速度・加速度補償を更新した。I/D・角度/距離/角速度FF・走行速度・
加減速度・ターン形状は今回変更しない。mode2の既存ローカル加速度変更はこの保存に含めない。

## 設定値と単位

ファームはPWM ±1000を±100%、速度mm/s、加速度mm/s²として計算する。
下表は `params/mini_r3_0/params.h` の数値で、FAN_ONのみを対象とする。

| 項目 | 旧値 | 新値 | ファーム内の単位 |
|---|---:|---:|---|
| FF_TRANSLATION_STATIC_PWM_FAN_ON | 35 | 65 | ‰ |
| FF_TRANSLATION_VELOCITY_PWM_FAN_ON | 0.035 | 0.110 | ‰/(mm/s) |
| FF_TRANSLATION_ACCEL_PWM_FAN_ON | 0.0040 | 0.0100 | ‰/(mm/s²) |
| KP_VELOCITY_FAN_ON | 0.35 | 0.35 | ‰/(mm/s) |
| KI_VELOCITY_FAN_ON | 0.001 | 0.001 | 1 msごとの誤差和に掛ける係数 |
| KD_VELOCITY_FAN_ON | 0 | 0 | — |

SIの速度・加速度を用いると、PWM出力百分率は次になる。

`u_FF[%] = 6.5 sign(v) + 11.0 v[m/s] + 1.0 a[m/s²]`

1.5 m/s定速で旧8.75%→新23.0%。同速度で+25 m/s²なら48.0%、
−25 m/s²なら−2.0%となる。これはFF単独の値で、P/Iと旋回出力がさらに加わる。
速度/加速度ゼロではFFもゼロ。通常はプロファイルの速度・加速度指令を使い、
停止プロファイル完了後のみ位置補正後の速度指令を使う既存実装を維持した。

## 使用ログと同定方法

- `tools/logging/logs/trace_bin_20260922_095200.csv`、3866行、schema `0x00060000`。
- SHA-256: `7e4d41c0fe78205131705027f03a080951421f8a555a2003de81fbc65c397968`。
- mode6/case0/sub1、大回りR90、走行開始timestamp=31544 ms。
- 実機FW SHA・ゲイン・ファンdutyの直接メタデータはない。
  PWM再構成は現ローカルP=0.35/I=0.001/旧FFにRMS 0.0256 percentage pointで一致し、
  ファン始動時間も現在の100%設定と整合する。直接読み出した設定値とは区別する。

左右PWM平均を並進出力とし、タイヤ直径0.01413 m・200 CPRからエンコーダ速度を復元。
1 ms格子へ線形補間し、エンコーダ速度を中央11サンプル平均で平滑化した。
旋回と停止保持を除き、走行開始後12..190、320..401、415..473 msを選択。
各区間の先頭から5 ms刻み、幅20 msの窓を取り、窓内平均速度と平均PWM、
窓の両端の平滑化速度差/0.020 sを用いて次を最小二乗推定した。
全窓の速度は前進なので、摩擦補償は定数項となる。

`u_mean[%] ≈ Ks + Kv v_encoder[m/s] + Ka a_encoder[m/s²]`

推定結果は `Ks=6.9654%`、`Kv=10.6505%/(m/s)`、`Ka=1.01335%/(m/s²)`、
PWM再構成RMS 0.8217 percentage point。
窓幅15/25/30 msでもKs=6.83..6.96、Kv=10.64..10.78、Ka=1.012..1.016で近い。
丸めた採用値はKs=6.5、Kv=11.0、Ka=1.0。
20 ms窓の加速/定速/減速各区間で採用値の再構成RMSは0.989/0.648/0.417 percentage point。
従来値では14.855/13.293/2.625となり、主に前進側FFが不足していた。

これは実測された運動に必要な出力の近似であり、新設定で走行した際の速度予測ではない。
一つの短い前進ログで、Ksは走行摩擦の切片であって静止摩擦の独立測定ではない。
加速または減速区間を外すとKs/Kvの配分が動き、15..30 ms窓の区間除外検証で
最大約3.95 percentage pointの外挿誤差がある。逆転・低速・電池電圧違いは未同定。
解析スクリプト・数値出力はGit対象外の `build/velocity_tracking/` に保存。

## PIDを維持する理由と次回の確認

旧ログでは1.5 m/s指令を336 ms保持したが、実速度最大1.393 m/s。
直進後半のエンコーダ平均1.369 m/sで平均PWM21.75%を要し、
FF8.75%の不足分をP/Iが負担していた。停止保持でも積分寄与が約7%残り、
距離超過0.0136 m・後退指令−0.027 m/sに対して前進出力が残った。
新FFでこの偏りを減らすのが先であり、今回Iを増やす根拠はない。
P=0.35も追加で上げず、FF変更の効果を同じゲインで確認する。

次は同じmode6/case0/sub1、現在のファン100%で比較する。
定速1.5 m/sへの到達、加速/減速の追従、停止後の位置誤差・微小往復・終了理由を確認する。
停止近傍では摩擦補償の符号切替が大きくなるため、微小往復が出ればKsと位置保持を再評価する。
並進追従が整うまでターンオフセットや角速度FFはこのログだけでは追加調整しない。

FAN_ONはmode6専用ではなくmini_r3の全吸引走行で共有される。
mode4の50%でも新FFを使うが、その負荷での適合は未確認。
FAN_OFF・mini_r2・F405の値は変更しない。NVM/ログ形式・`.ioc`・共通制御実装も変更なし。

## 検証

- `sh tools/hil/run_f413_machine_tests.sh`: ASan/UBSan、r2/r3のruntime profile・
  r3両個体・全FAN_ON/OFF項目のprofile反映、front reference、未登録SAFE判定PASS。
- `sh tools/hil/run_f413_stop_approach_tests.sh`: ASan/UBSan、productionの
  停止/位置保持・FF符号・ON/OFF全軸ゲイン切替・高速速度feedback試験PASS。
  ホストのセンサ入力による試験で、実機の低速振動や停止収束を保証するものではない。
- `cmake --build --preset Debug-stm32f413` / `Debug-stm32f405`、`git diff --check` PASS。
  F413 RAM 274160 B、Flash 371924 B。

実機コマンド列なし。
書込・リセット・UART・モータ/ファン・走行・NVM操作は行っていない。
