xfa273/nightfall-fw/docs/MINI_R3_MODE7_SUCTION_TUNING.md

# mini_r3 mode7 吸引ターン調整（t0.21）

追記（t0.22）: 現在の速度・吸引率・case0割当ては[吸引モード構成](MINI_R3_SUCTION_MODE_LADDER.md)を参照。以下は変更前の記録。

2026-09-22 JST。`mini-r3-suction-mode7-t0.21`。
小回り1.4 m/s、大回り90°/180° 2.0 m/s。斜めはmode6と同じ1.5 m/s。
mode6で現在使用しているfan100%とFAN_ONゲインを継承する。
この変更でゲイン自体は変更していない。

## 直近ログとcase0速度修正

`tools/logging/logs/trace_bin_20260922_113152.csv`、3558行、
mode6/case0/sub0。SHA256:
`cdf6784b01dd33c09783f6dc21920ae10107ae755b67239f5a1f8d82e378c3a9`。
保存CSVには実機のFW SHA/ゲイン値はないため、それらの一致は断定しない。

小回り旋回中の目標は1.2 m/sだが、旋回前・後の直進で1.5 m/sを指令。
feedback最大はそれぞれ1.553/1.558 m/s。
通常走行用case1の直進上限1.5 m/sをcase0も使用していたため。
直進で速く走り、ターン前に減速する通常最短の挙動が調整試験にも適用されていた。

`f413_path_run_session_case_params()`で、test-modeかつターンを含む経路だけ、
直進/斜めの上限を経路内の最大ターン速度以下にする。
パラメータのコピーを作り、発進速度・preflight・全直進profile・実行を同じ値で計算。
複数ターンの場合は接続に必要な最大値を採用し、既存case上限を引き上げない。
数値の固定上書きではなく、そのモードのターン設定から毎回導出する。
これによりmode6/sub0の全速度profileは1.2 m/s以下、mode7/sub0は1.4 m/s以下となる。
距離/角度のフィードバック補正や実速度のオーバーシュートを制限する変更ではない。

このcase0修正はF413のmini_r2/mini_r3共通。
通常最短のtest-mode=false、およびターンを含まない直進調整はcase本来の上限を使用する。
F405の実装・パラメータは変更しない。

小回りログの旋回中duty瞬間最大は93.0%（左）、85.0%（右）、
実角速度最大2504.2 deg/s。前後直進の速度誤りは修正するが、
このログだけで1.4 m/s小回りの出力余裕が十分とは判断しない。
次回は追従・左右duty・角度誤差を確認する。

## シミュレータによるパラメータ生成

ユーザ指定[PR #21](https://github.com/xfa273/nightfall-fw/pull/21)、
commit `ab377c8b937db2fdbc515d2d55970becd16866be`の
`tools/tuning/turn_simulator.py`の`simulation()`を使用。
実測同定は行わず、`DynamicsModel()`既定の理想応答。
`constants={rounding_scale:1.2, omega_cap_deg_s:3000}`を明示したartifact
（coefficients={}, coverage={}, regime="positive-entry"）を渡す。
FWのmode7にも`turn_omega_max=3000`を設定した。
mode6の2200 deg/sから変更するため、斜めの角加速度/オフセットも再計算している。

候補探索はalphaを500 deg/s²刻み。範囲は小回り130000..200000、
大90 75000..130000、大180 60000..100000、45in 60000..130000、
45out 60000..110000、V90 80000..170000、135in/out 55000..130000。
`turn_tune`でコア終点を計算し、`turn_clearance.canonical_scene()`の目標に
入口/出口直線で合わせる。180°は横方向誤差0.001 m以下のコアを選び、
入口0.001..0.039 mを0.002 m刻みで探索して出口を解く。
オフセットを0.0001 m単位に丸め、PR21で終点誤差0.001 m以下を再確認。
機体の公称壁余裕が最大値から0.00025 m以内の候補のうち、alpha最小を採用。
ローカル作業記録は`build/mini_r3_mode7/{scan.py,verify.py,final_verified.json}`。

表のalphaは設定値。正弦形の角加速度の瞬間最大とは異なる。
左右とも角度は正確な90/180/45/135°を使用する。

| ターン | 速度 m/s | alpha deg/s² | 入口 m | 出口 m | 最大omega deg/s | 理想終点誤差 m |
| --- | ---: | ---: | ---: | ---: | ---: | ---: |
| 小回り90° | 1.4 | 163500 | 0.0014 | 0.0014 | 3000.0 | 0.000018 |
| 大回り90° | 2.0 | 87000 | 0.0057 | 0.0075 | 2284.7 | 0.000641 |
| 大回り180° | 2.0 | 72000 | 0.0010 | 0.0015 | 2939.4 | 0.000897 |
| 45° in | 1.5 | 71000 | 0.0012 | 0.0205 | 1459.5 | 0.000737 |
| 45° out | 1.5 | 65500 | 0.0180 | 0.0006 | 1401.8 | 0.000925 |
| V90° | 1.5 | 144500 | 0.0144 | 0.0144 | 2944.5 | 0.000853 |
| 135° in | 1.5 | 74000 | 0.0162 | 0.0088 | 2580.7 | 0.000198 |
| 135° out | 1.5 | 77000 | 0.0108 | 0.0190 | 2632.5 | 0.000893 |

左右16ターンで理想終点誤差最大0.000925 m、姿勢誤差0.0002°未満。
小回り角加速度の瞬間最大は約213315 deg/s²。
大180°の横加速度最大は約102.6 m/s²。これらは理想指令値で、実機追従の検証ではない。

壁評価は従来と同じ0.070×0.039 m矩形機体、0.090 m区画・0.006 m壁/柱、
コーナー補間移動量0.0005 m以下。公称衝突なし。
公称最小余裕は小回り0.011573 m、大90 0.015780 m、大180 0.012981 m、
斜め全体の最小0.007461 m。
位置/モデル誤差0.005 mと既定機械/角度/補間予算を引くと、
斜め有効余裕最小0.001486 mで要求0.003 mを満たさない。
単独ターン調整の初期値であり、迷路壁クリアランスや高負荷時の追従は未確認。

## case0操作と直進設定

mode7 → case0 → subを選択。吸引時はmode6と同じ並びに統一。
非吸引のmini_r2 mode7は従来のsub割当てを保持する。

| sub | 内容 | 試験中の最大速度 m/s | 経路コード |
| --- | --- | ---: | --- |
| 0 | 小回りR90 | 1.4 | 203,300,203 |
| 1 | 大回りR90 | 2.0 | 204,501,203 |
| 2 | 大回りR180 | 2.0 | 204,502,203 |
| 3 | R45 in | 1.5 | 204,701,1003 |
| 4 | L45 out（R45 inから進入） | 1.5 | 204,701,1003,704,203 |
| 5 | L-V90（R45 inから進入） | 1.5 | 204,701,1003,802,1003 |
| 6 | R135 in | 1.5 | 204,901,1003 |
| 7 | L135 out（R135 inから進入） | 1.5 | 204,901,1003,904,203 |
| 8 | 直進case1 | 2.0 | 209 |
| 9 | 直進case5 | 2.0 | 209 |

全9ケースの直進上限2.0 m/s、斜め上限1.5 m/s。
直進加減速度45 m/s²、斜め25 m/s²（低速/高速側とも同値）。
2.0 m/sから0.045 mで停止するのに44.444… m/s²が必要なため45とした。
初期0.010 mの発進、方向が合う全16種類のターン対の最短S1/DS1接続、
0.045 m停止を含む2736経路が全9ケース・壁切れon/offで成立。

fan100%まで1200 msのramp、到達後300 ms待機、制御先行20 msを継承。
case0は角度積算on、壁切れ/前壁補正off、選択caseの壁/斜めゲインを使用。
通常最短時の小回り前壁目標は0.0886 mだがcase0では使用しない。

## 検証と実機操作

- ASan/UBSan: mode6/7の全10 sub、全速度phaseの上限・到達、各2736接続経路。
- production sessionのmode6/7小回りで開始から終了までの最大指令1.2/1.4 m/s、正常終了を確認。
- mini_r2/mini_r3全6モード×9ケースで、通常最短/直進のみは元設定、ターン試験のみ設定由来の上限。
- 既存mode4全10 sub、path-linear219、機体runtime profile・fan ramp/abort/cleanup、route table14210。
- F413/F405ビルド、`git diff --check`。

F413 RAM274160 B / Flash372892 B。HIL区分はhost-only。
UART/flash/reset/モータ/ファン/走行/NVMの実機コマンドは一切実行していない。
モータ駆動許可を取得した工程はない。制御loop・NVM/ログschema・CubeMX設定は不変。
route tableはpath runnerのソースhashのみ更新し、数値表は同一。
既存ローカルのmode2加速度・flashing tool・CAD編集はコミットから除外する。
