xfa273/nightfall-fw/tools/tuning/turn_simulator.html

NIGHTFALL / MOTION LAB

# ターンシミュレータ

走行動画の実測軌跡と理想軌道から、次のパラメータを検討する。

STM32F413 · mini_r2_0 · HOST ONLY

## 走行パラメータ

読込中

01 / TURN PROFILE

02 / TARGET POSE

開始点を (0, 0)、前方を +Y とした終点。左回りが正の角度です。

軌跡を計算初期値

目標位置・角度に合わせる

速度と旋回角を固定し、角加速度・入口距離・出口距離の候補を計算します。

モデルを読み込んでいます…

### モデルの適用範囲

確認中

終点の位置誤差

—mm

目標に対する予測

終点の角度誤差

—deg

目標に対する予測

走行時間

—ms

入口直進から出口まで

予測終点

—

X / Y [mm]

## 走行軌跡

予測理想実測

X：右 / Y：前方 [mm] · 縦横は等縮尺 · 紫の十字：目標終点 · 実測は個別の過去試行

▶ 再生— ms

## 姿勢角の時間変化

左回り ＋ / 右回り −

## 予測の根拠と制約

実機検証前

シミュレーションの小さな終点誤差だけでは、迷路での走行成立を判定できません。実測範囲と検証誤差を併せて確認してください。

表示中の実測データ

モデルの検証指標

## パラメータ候補

JSON を保存 ↓

計算結果と適用範囲を保存して、実測結果との比較に使えます。

計算結果がここに表示されます。

NIGHTFALL TURN SIMULATOR · ホスト上の軌跡検討ツール · 実機での予測精度・迷路走行は別途検証が必要です。
