xfa273/nightfall-fw/params/mini_r3_0/calibration/front_centre_extension_20260921.csv

distance_mm | fr_delta | fl_delta | r_delta | l_delta
80 | 599 | 568 | 12 | 24
85 | 504 | 488 | 12 | 24
90 | 422 | 422 | 12 | 24
95 | 357 | 364 | 12 | 24
100 | 306 | 312 | 12 | 24
105 | 260 | 269 | 13 | 24
110 | 223 | 233 | 12 | 25
