xfa273/nightfall-fw/params/mini_r3_0/calibration/side_centre_20260906.csv

distance_mm | r_delta | l_delta
23 | 2475 | 2498
30 | 1598 | 1794
35 | 1165 | 1271
40 | 876 | 942
45 | 673 | 720
50 | 522 | 564
55 | 415 | 451
60 | 339 | 371
65 | 297 | 310
70 | 240 | 263
75 | 198 | 224
80 | 165 | 188
