xfa273/nightfall-fw/params/mini_r3_0/calibration/side_centre_20260912.csv

distance_mm | r_delta | l_delta
23 | 2507 | 2919
30 | 1572 | 1905
35 | 1138 | 1361
40 | 848 | 990
45 | 640 | 733
50 | 492 | 567
55 | 387 | 448
60 | 316 | 361
65 | 253 | 298
70 | 211 | 249
75 | 176 | 210
80 | 150 | 176
