xfa273/nightfall-fw/docs/ai/WORKLOG.md

# AI Worklog

AI運用上の重要イベントを時系列で記録します。

| UTC Timestamp | Task ID | Title | Codex Exit | Applied | Notes |
| --- | --- | --- | --- | --- | --- |
| 20260927-040158 | 20260927-stlink-v3-recovery | V3MINIE・専用ケーブルへの交換でアプリ復旧、全域照合と起動確認 | dfbfc9e-dirty; flash/verify/boot/readback PASS | HIL/docs | Resumed after user changed hub/A-C cable/WeAct unit; SN066BFF545771485067014053 V2J43M28 still yields inconsistent4096B immutable ROM reads, identity preserved. User confirms same WeAct adapter and SWD cable, no spare for that cable. User then swaps to V3MINIE and dedicated cable: SN003B00273234511537333934 V3J16M8, VDD3.24V, same mini_r3_0 unit2/UID; three ROM reads identical at1000kHz before write. Previously successful build Debug-stm32f413 2026-09-27T03:13:00Z RAM274264/Flash377052, ELF hash rechecked unchanged. flash_stlink --image build/Debug/nightfall_stm32f413.elf --sn003B00273234511537333934 --freq1000 --modeUR --reset-modeHWrst succeeds once, only application sectors0–6, verify/reset. UART11102/921600 boot dfbfc9e dirty1/tune mini-r3-wall-case3-t0.28, NVM-GUARD LOCKED, OPmode0 idle. Post-reset HOTPLUG full377052B readback equals ELF binary,128KiB identity equals original backup, three more ROM reads identical. UART i,w PASS; leave app running, captures closed. No motors/fan/run allowed or commanded; no option/protected-sector/identity/calibration/maze/trace writes or mass erase, no probe FW update, no firmware source/params edits. Fault within WeAct/adapter/cable/common compatibility not isolated because V3 change replaces the full path; use working V3 path, no long-term failure-rate claim. Logs/hashes/commands: docs/ai/STLINK_ERASE_FAILURE_20260927.md. |
| 20260927-034102 | 20260927-stlink-live-erase-investigation | ST-LINK消去失敗と不変ROM読出し不一致を実機確認、復旧未完 | dfbfc9e-dirty build PASS; app recovery incomplete | diagnostics/docs | User explicitly requested hardware diagnosis. F413 build 2026-09-27T03:13:00Z RAM274264/Flash377052; mini_r3_0 unit2, ST-LINK V2-1 SN066CFF545771485067013914 V2J43M28, VDD3.24V. Original user failure had already erased vectors before agent write. Application sectors0–6 attempts with UR/HWrst1000/400kHz, USB soft reset/replug and ARM/Intel Cube2.21 fail erase; installed OpenOCD also fails flash-control read during erase. CPU-halted RAM reads disagree after power cycle, SWD reseat, Mac direct USB; Homebrew stlink1.8/libusb1.0.30 also fails immutable system-ROM consistency across50–4000kHz, so success exit is insufficient and no additional erase attempted. Cube temporary libusb swap blocked by library signature validation; no signing/security changes. Official updater checkVer (no update) failed USB mode transition; user replug restored normal original-FW connection. Final identity128KiB byte-identical to initial backup, vectors still FF, core halted, application/boot not restored. UART2124202/921600 reset capture no boot. Spare probe unavailable; request model/replacement cables to isolate link/probe/target hardware, root cause not established. Motors/fan/run not authorized or commanded; no mass erase, option/protected-sector/FRAM/identity/calibration/maze/trace writes. No firmware source/params edits, prior user dirty work preserved. Exact commands, hashes, logs and final state: docs/ai/STLINK_ERASE_FAILURE_20260927.md. |
| 20260927-030819 | 20260927-stlink-erase-diagnostics | ST-LINK消去失敗の接続余裕と診断ログを改善 | host tests PASS; no firmware build/flash | yes | User reports frequent failed-to-erase-memory, recovering after USB replug, and confirms flash_stlink. Read-only native CubeProgrammer2.21.0 probe listing identifies SN066CFF545771485067013914 FW V2J43M28; existing uncommitted USB recovery handles V3MINIE only and does not cover this probe. No saved failure log found; failure/root cause and frequency regression are not reproduced. Lower default requested SWD4000->1000kHz while preserving explicit --freq and NORMAL/SWrst, image/address/verify/reset selections. Add per-operation vendor -log under ignored build/flashing_logs plus exact command/completion status; retain terminal progress, fail on nonzero exit or logged Error, never retry erase/write or issue mass erase/option bytes. Document400kHz and NRST-wired UR/HWrst recovery, USB/cable/debugger checks and official FW updater. 26 flashing host tests and py_compile/diffcheck PASS, covering failure/no-retry, zero-exit error, build failure, logging, reset-only and command compatibility. Native -log -l stlink-only confirms detailed log includes CLI version/SN/FW and saved command; artifact build/flashing_logs/stlink_20260927T030819Z_qg23c6il.log. Hardware sequence: -l stlink-only twice; CLI --help once (host only). Target FW/build id not read; no target connect/reset/erase/write, UART, motors/fan/run or NVM operation; motors not authorized. Firmware/platform/params and prior local USB-recovery/worklog edits preserved. Next normal user flash must assess failure-rate improvement; no claim of hardware repair. |
| 20260923-082400 | 20260923-worktree-removal | 保全済み12ワークツリーを撤去、通常checkoutに集約 | repository-only; main da51e1e via PR43 | yes | User requested step4 after non-firmware integration. PR16/20/21 confirmed MERGED via43; PR1/17/18/19 remain Draft/OPEN and unchanged heads/bases with deferral recorded. Snapshot170950 contains all13 worktrees including ignored data and Git metadata; all-refs bundle verified; each of12 removal targets independently restored. Immediately before deletion, every source/snapshot file list/SHA/mode plus HEAD/status revalidated. Removed nested runtime-scaffold first, then0fb1/165d/1a6f/51c2/6201/6743/9fe5/ab88/acd0/c338/mini-goal77 with git worktree remove --force. 13→1 registered worktree. All branch/tag refs and stash2 unchanged; normal checkout remains fix/f413/search-distance-accounting at a461d4f,185 changed files SHA/mode and status unchanged. CAD editor closed normally first, ignored view state archived; old CUA runtimes not killed. Full snapshots and restore guide retained, no capacity-reduction cleanup. No firmware/params/HIL/UART/STLINK/motor/fan/flash/NVM changes or operations. Details INDEPENDENT_PR_INTEGRATION_20260923.md and external audit steps3-4. |
| 20260923-081909 | 20260923-independent-pr-integration | ファーム非影響のPR16/20/21統合、他4件を保留 | host-only; base066caec | yes | User explicitly requests non-firmware PRs first and remaining firmware-impact PRs deferred until mini_r3 tuning complete, then linked-worktree removal. Merge original16/20/21 heads with WORKLOG additions retained. Production firmware/params/build/NVM/stable trees unchanged. Adapt host profile-parity fixture to current search unlimited/shortest per-mode omega cap; no firmware changes. 39 tuning+22 dataset/simulator tests, compiled-C profile parity, py_compile,localhost HTML/state/simulate/tune and CORS rejection PASS. Historical catalog27 runs/8 groups,1 contact excluded. KiCad DRC matches known WeAct0error/26warn,main4/112,encoder L/R6/0,all0unconnected;4ZIP CRC/source/SHA/PDF/CAM checks PASS. Existing hardware/manufacturing/model-qualification limits remain. PR1/17/18/19 stay Draft/OPEN with unchanged heads/bases. New all13-worktree full snapshot170950 SHA/mode verified, bundle verified, all12 removal targets independently restored. Saved PCB editor closed normally; ignored session preferences/locks preserved. No UART/STLINK/reset/flash/motor/fan/run/NVM actions. Details INDEPENDENT_PR_INTEGRATION_20260923.md. |
| 20260921 | turn-simulator | 動画実測を利用するターンシミュレータを追加 | 0 | yes | added host-only dataset import, reduced dynamics identification, leave-parameter-condition-out validation, bounded parameter tuning, and localhost Japanese browser UI under tools/tuning; primary checkout archive contained 185 trajectory CSVs / 471 capture reports / 398 trace CSVs; exact SHA-bound historical D135 catalog imports 27 non-contact recordings, excludes one contact dataset, and separates 6 zero-entry recordings; positive-entry model fits 21 videos in 6 parameter groups at 500 mm/s right135 mini_r2_0, ideal RMS 7.128mm vs held-out RMS 1.746mm / worst observed path error 4.964mm; fit only velocity gain and effective course lag because XY cannot distinguish yaw vs course lag, retain all provenance/camera/alignment limitations and mark all recommendations hardware-unvalidated; verified 29 host tests including compiled actual F413 profile/control C functions, SHA/contact/duplicate/time/frame gates, synthetic unseen-alpha prediction, group holdout, bounded tuning, and UI simulate/tune/reset/playback/export; no firmware, params, .ioc, NVM, schema or hardware changes; no motor/fan, flash, UART, maze or calibration commands; generated model and candidate JSON stay ignored under build/turn_simulator |
| 20260921-encoder-castellated | 20260921-encoder-castellated-pads | 左右Encoder基板の剥離対策として4端子を両面ランド付き小径半穴へ変更 | n/a | design-only | user selected unchanged 3.45 x 7.00 mm outline with custom-process fabrication review; modified only EC_L1..4 / EC_R1..4 embedded PCB pads to 0.30 mm plated castellations and 0.60 x 1.20 mm copper/mask lands, retaining 0.90 mm inward land; inset outer terminals by 0.1988 / 0.2060 mm to preserve side clearance; set castellated board metadata; retained schematic, nets, IC/R/C placement, tracks and existing vias; KiCad 10.0.3 DRC: L/R 10 -> 6 existing errors each, zero new violations and zero unconnected items; checked Gerber copper/mask, PTH drills, Castellated job metadata and 3D views; manufacturing limitations and residual via DRC documented in hardware/mini_r2_0/notes/kicad/ENCODER_CASTELLATED_PADS.md; host CAD checks only, no fabrication order, live hardware, firmware change or HIL; physical peel strength and custom manufacturing acceptance remain unverified |
| 20260921-encoder-order-files | 20260921-encoder-castellated-order-packages | 左右Encoder基板の発注用ZIPと半穴加工図を作成 | n/a | files-ready | generated separate L/R bare-PCB packages from df315e3044e7 using KiCad 10.0.3; each ZIP contains five Gerber layers (F/B copper, F/B mask, Edge.Cuts), PTH drill (L 5 existing vias + 4 half-holes; R 6 existing vias + 4 half-holes), job metadata, English fabrication notes, one-page PDF, source manifest and SHA-256 list; omitted empty NPTH and overlapping imported silkscreen; validated CAM geometry against prior verified export, hole counts/coordinates, copper/mask alignment, DRC (6 existing errors each, zero warnings/unconnected), ZIP CRC and every file hash; rendered and visually checked both PDFs; corrected the R minimum clearance figures in the design note from 0.1390/0.4390 to calculated 0.1410/0.4410 mm; source PCBs unchanged; user explicitly requested production files so final ZIP/PDF artifacts are versioned under cad/export/jlcpcb/encoder_castellated_20260921; custom-process manufacturing acceptance and physical strength remain pending; no ordering, payment, firmware or live hardware actions |
| 20260921-main-mount-holes | 20260921-main-mount-holes-1p6 | 本体基板のマウント穴4か所をØ1.6 mmへ拡大し周辺配線を調整 | n/a | design-only | changed the four existing Edge.Cuts mounting circles from Ø1.1 to Ø1.6 mm at unchanged centers; rerouted +5V, SWO and BUZZER_PWM, shifting adjacent SWCLK and BOOT0 including one BOOT0 via to maintain clearance; all edited traces remain 0.254 mm wide and the moved via retains 0.7564/0.35 mm copper/drill; refilled and saved four copper zones; KiCad 10.0.3 DRC remains 4 existing errors / 112 existing warnings with zero new violations by type/severity/item UUID and zero unconnected items; verified object-level scope, four Gerber circles at radius 0.80 mm, and 3D hole rendering; unchanged upper-hole centers leave 0.20 mm of board material to the side edges; documented geometry, residual DRC and obsolete 20260606 main-board fabrication candidate in MAIN_MOUNT_HOLES.md; no firmware or live hardware operation, physical mounting strength not tested |
| 20260921-main-order-files | 20260921-main-mount-1p6-order-package | 本体基板のØ1.6 mm取付穴版の発注用ZIPと加工図を作成 | n/a | files-ready | user requested manufacturing files for the updated main PCB; generated copper/mask/profile and separate PTH/NPTH drill files from e2ba19b74438 using KiCad 10.0.3; reused the validated 20260606 top/bottom legend unchanged and recorded provenance; packaged 7 Gerbers, 199 plated drills, 2 non-plated D0.90 switch drills, job metadata, English fabrication instructions, one-page PDF, source manifest and checksums in a 14-file ZIP; four D1.60 non-plated mounts are in Edge.Cuts only, with the 0.20 mm upper-hole webs explicitly documented; verified CAM equivalence to the reviewed source, only the intended BOOT0 via drill coordinate change, legend-to-mount clearance, unchanged 4-error/112-warning/0-unconnected DRC, source commit hashes, PDF render/text and ZIP CRC/SHA-256; PCB source unchanged; final artifacts versioned under cad/export/jlcpcb/main_mount_1p6_20260921 at explicit user request; no manufacturing order, payment, firmware or live hardware actions |
| 20260727-052235 | 20260727-052235-weact-adapter-communication-smoke | WeAct MiniDebugger変換基板のSWD/UART疎通確認 | n/a | yes | after the user corrected the adapter wiring, verified the host checkout as `stable/classic/unit001/s20260404-nationals-267-gb8b6bc0-dirty`; `flash_stlink --list` recognized WeAct MiniDebugger ST-LINK SN `0670FF545771485067014149`, FW `V2J43M28`, and `serial_terminal.py --list` exposed `/dev/cu.usbmodem211202`; `flash_stlink --reset-only` connected over SWD at 4000kHz, measured target voltage `3.22V`, identified Device ID `0x463` as STM32F413/F423 Rev A with 1.5MiB Flash, and completed software reset successfully; a non-motor UART `i` request at 921600 8N1 returned `[HW-TEST][IMU] WHO_AM_I=0x6B expected=0x6B => PASS`; motors/fan were not allowed, and no firmware flash, run/search/shortest command, trace-destructive command, calibration/maze/identity/NVM write, or protected-sector operation was performed |
| 20260923-072214 | 20260923-main-consolidation | 追加調整保全と開発本流のmain統合 | host-only; source a461d4f clean | yes | User explicitly selected main integration as step2. Preserve additional7 mini_r3 tuning fields in cceae900906f, record tip1d20e5e1eb8f, branch backup/20260923-step1-additional-tuning; all13 worktrees re-snapshotted/SHA-mode checked, bundle verified,185 changed files restored and matched. Integrate b55bf0a..a461d4f (290 commits, root261 plus PR22..41/29), retain original SHAs and branches. Only new code change is stale tuning-test expectation following d395d13; firmware/params unchanged from committed tip. F405 mini/classic and F413 builds,160-field/52-TU coverage,8 control/NVM/runtime-goal and18 route/solver checks PASS. F405 sensor old-main differential3,538,944 bit-identical results; flashing17, logging17 with3 deferred then C trace retention+7 tests PASS, tuning32 and vision138 PASS. No ioc or persistent schema changes in range; mini_r2/r3 params and F413 NVM calibration rejection/trace retention behavior included, stable fan-off manifest addition retained. No hardware command sequence, motors not authorized/operated; no UART/STLINK/reset/flash/fan/run/NVM access. Latest floor/high-speed/diagonal/real-FRAM qualification remains pending. Independent PR1/16..21, dirty tuning/CAD/USB/legacy work remain separate. See MAIN_CONSOLIDATION_20260923.md. |
| 20260923-052340 | 20260923-f413-search-distance | 探索中の処理遅延による移動距離累積を補正 | host-only; base eade285 dirty; r2 t0.3 / r3 t0.25 | yes | mini_r1/F405 already subtracts conf_route g_search_coast_mm from the next cell/turn entry/half-cell stop; F413 search lacked this. Latest140247 raw duplicates135925; search run003 nominal55+7x90+45=730mm but target756.387/actual753, final-stop5002ms TIMEOUT; user confirms wall contact. Shortest run004 target730.387/actual739. Carry planned endpoints across sensing/planning/logging/polling delays; issue remaining distance and derive acceleration exit speed from it. Rebase on physical wall corrections, wall end before event logging, smooth/spot turns, reverse and session/phase odometry resets. Entire next segment already consumed fails stopped; stop tolerance/gains unchanged. Production search ASan/UBSan with both profiles:0/3/8/20ms delays,7/15/60cells,730mm commanded endpoint for7cells, known-corridor boost/braking, both90 turns, wall-end/front corrections, alignment,180spin,reverse/restart,abort/reset PASS. Existing stop/control/gain/velocity, machine/runtime-goal tests, shared solver explore simulation,14210 route checks and F413/F405 builds/diffcheck PASS. F413 RAM274264/Flash377060; generated table numeric data unchanged, staged fingerprint excludes user tuning. No F405/shortest behavior, trace schema, NVM layout or ioc changes. Hardware command sequence:none; no UART/STLINK/reset/flash/motor/fan/run/NVM access, no live-motion authorization used. Floor stop at approximately730mm and absence of wall contact pending; ideal host follower qualifies command geometry only. Raw has no execution FW SHA. Preserve/exclude existing user D_TIRE14.4/GOAL0,8, run-table/flashing/worklog/CAD/tool edits. Details docs/F413_SEARCH_DISTANCE_ACCOUNTING.md. |
| 20260923 | 20260923-f413-all-machine-params | 共通F413の機体別params参照漏れを全面修正 | host-only; base270419e dirty; mini-r3-runtime-params-t0.24 | yes | User requests all machine parameters use selected model/unit. Common application includes board/f413/runtime/params.h instead of r2 literals; profile.c retains adjacent tune header. Add START/GOAL1..9/GOAL_XY and maze contract to160-field runtime schema; goal arrays in search/BFS/route initialized at call time, shared solver inherits runtime aliases. Fix shared sensor_distance F413 gain1 bypass. Remove stale DIR literals and resolve compatibility names through existing model/unit hardware registry, preserving rewiring. Validate all signed coordinates, nonempty goals and16x16 compact-planner/storage contract before peripherals; different MAZE_SIZE is rejected, not silently substituted. CMake coverage checker enforces fields/aliases for both profiles; actual52-TU compiler audit PASS, negative new-parameter/fixed-goal checks PASS. ASan/UBSan real-profile fixtures r2 goal1,0/start2,3 vs r3 goal0,8/start0,0 plusGOAL9 and nonunit sensor gains verify production search goal/BFS, route goal loader, shared shortest path (r3 straight-only), all fields/tables and conversion. Existing machine incl r3 units1/2, control/stop/gain/velocity, suction/auto-video/PWM tests PASS; route preview33464 and precompute14210 checks PASS; F413/F405 builds and diffcheck PASS. F413 RAM274256/Flash376404. Generated motion numeric data unchanged; fingerprint regenerated with index inputs excluding user mode2 edits. Runtime struct only; no persistent schema/identity/LUT/gain/fan timing/ioc/stable changes. User local D_TIRE14.4/GOAL0,8/run-table/flashing/CAD/tool changes preserved, excluded from commit; local build uses current tunes. Hardware command sequence:none, no UART/STLINK/reset/flash/motor/fan/run/NVM write, no live-motion authorization used; floor confirmation pending. Details docs/F413_MACHINE_CONFIG.md. |
| 20260923 | 20260923-mini-r3-goal-config-diagnosis | GOAL0,8が探索・最短に反映されず右折する原因確認 | analysis-only; local build064411b dirty 2026-09-23T04:15:28Z | no firmware changes | User mini_r3 params GOAL=(0,8), D_TIRE14.4 edits preserved. Common F413 translation units include f413_preorder params GOAL=(1,0); GOAL_X/Y and GOAL1..9 absent from runtime scalar/profile/aliases. Actual compiler preprocessing confirms both f413_search_step goal arrays, f413_route_preview run goals and shared solver use(1,0); existing ARM search/route object rodata begins0100 followed by zero unused slots. Latest131914 dump: run004(mode1case4) at(0,8)step11/forward, then(0,9)right; run005/006/008 fail no_current_step at(0,8) instead of reaching goal. Latest moving run007(mode2case3) first turn at15604ms/distance295mm, target angle delta-90deg and peak commanded omega-915.1deg/s confirms planned right turn; latest run009 has672 stationary startup samples. Goal-setting omission in common-machine migration explains wrong destination in exploration and shortest; no gain/parameter patch or firmware build performed. Raw has no capture FW SHA, live binary identity not verified. Next repair should connect per-machine goals to every search/route/solver consumer with bounds and differing-r2/r3 host checks. No physical UART/STLINK/reset/flash/motor/fan/NVM actions. All unrelated local edits retained. |
| 20260922 | 20260922-capture-run-split | 結合CSVの走行別復旧とキャプチャ更新検知 | host-only; base 97c6e46 dirty | yes | Latest trace_bin_20260922_173626.csv lacked run metadata because capture PID15365 started2026-09-21 23:03 before multi-run update. Its6301 rows span mode4 case0 sub1 (seq418..3312,14354..17374ms) and sub2 (seq0..3405,15700..19244ms), causing backward chart time. Existing write_run_csvs works; redecoded saved raw to run0012895rows/3.020s/partial and run0023406rows/3.544s/full, all6301 rows exactly match combinedCSV/raw; unchanged viewer produces monotone0-based time and86series each. Original combinedCSV archived under logs/combined_originals, raw SHA25668fcb5b4ef1f2e3eab0ef1cb667a09d5a0c9fc0eeeec40e96c5525f20e9f9f49 unchanged. Added startup per-run output banner and one-time source-update warning without automatic restart/command replay; added actual capture fakePTY regression for fragmented binary, consecutive dumps, reboot timestamps and partial run. Real serializer/retention+7Python tests,10display tests,py_compile/diffcheck PASS. No viewer/FW/params/schema changes or physical UART/flash/NVM/motor/fan actions. CUA Terminal access rejected for safety; old process left untouched and user instructed to restart manually after dump. Unrelated local edits excluded. |
| 20260922 | 20260922-f413-optional-auto-video | params.hで自動撮影動作をON/OFF | host-only; base 2faf46a dirty; mini-r3-manual-tuning-t0.23 | yes | Add ENABLE_AUTO_VIDEO_CAPTURE to per-machine RAM scalar/alias with0..1 validation: mini_r3 OFF for manual tuning, mini_r2 ON preserves current behavior. Gate all main/path/search START/STOP tokens, camera START guard300ms and optical-only ctrl_stop; low-level OFF performs no LED writes/delays, UART token tests report disabled. OFF restores trace-only hooks; ON keeps9.75s tokens plus300ms START guard. Normal LEDs, trace append/tail, IMU calibration, fan slew and post-ramp300ms, control/stop logic and turn parameters unchanged. ASan/UBSan real GPIO patterns and real path hooks/suction+fan-off sessions OFF/ON, fan failures/all-phase abort cleanup, runtime machine defaults/invalid flag and route14210 checks PASS; F413/F405 builds PASS (F413 RAM274168/FLASH374004). Generated route tables fingerprint only; numeric data unchanged. No hardware commands, flash/reset/UART/motors/fan/run or physical NVM access; floor HIL pending. No F405 behavior, NVM layout/schema, IOC or stable changes. Preserve/exclude unrelated params/flashing/worklog edits. Details docs/MINI_R3_SUCTION_MODE_LADDER.md. |
| 20260922 | 20260922-case0-r180-runup | case0大回り180度の先行直進を90mm延長 | host-only; base fae343e dirty | yes | User reports wall contact before stopping when starting with chassis rear against wall. Extend only preceding straight of all11 F413 mode2..7 case0 R180 entries by2 half-cells: legacy203->205/204->206, suction204->206. mini_r2 legacy paths included; legacy mode7 remains sub7. Suction mode3..7/sub2 becomes S6,R180,S3 with10mm launch/45mm terminal retained; nominal endpoint shifts from forward10/right90 to forward100/right90mm. Mode2 endpoint forward235-stop_mm/right90. Turn geometry/velocity, gains, trailing straight/braking, normal shortest and F405 paths unchanged; no params/NVM/log/ioc/stable edits. Diff audit confirms exactly11 first-code increments and every other dispatch entry unchanged. ASan/UBSan all5 suction profiles/50sub/12220 connector preflights and50 mini_r2 dispatch selections; production15 cardinal sessions with updated180 fixture, fan timing/abort/cleanup, mode2 dispatch40 and both MCU builds PASS. F413 RAM274160/FLASH373772. Hardware command sequence:none; no flash/reset/UART/motors/fan/run/NVM access, extended path floor HIL pending. Preserve/exclude existing params/flashing/generated fingerprints and earlier worklog edits. See docs/MINI_R3_SUCTION_MODE_LADDER.md. |
| 20260922 | 20260922-f413-multi-run-trace | FRAMへ複数走行を追記し全保持ログを走行別に書き出す | host-only; base d395d13 dirty | yes | Auto trace and search-event start reopen valid v6 headers instead of formatting. Initialize only uniform 00/FF blank headers; preserve unknown/corrupt schema and I/O errors. Existing 640KiB region/104B records holds6301 samples (~6.3s total at1kHz); retain ring eviction of oldest records, label partial first run; saturate lifetime count atUINT32_MAX. Mode9/case5 and > binary all, V CSV all; no erase on dump. Host capture/decoder split seq=0 into per-run CSV, retain single raw frame and single-run filename; per-run op context, explicit dump-time FW SHA/dirty/extra metadata and unknown capture FW, avoid latest test target reuse. Real serializer+auto+dump ASan/UBSan host test: blank/reopen/reboot/one-sample/empty/full/wrapped sessions, no FRAM writes during motion, outside-area access assertions, corrupted/old header and read/write failures, lifetime counter saturation. Production dump decoded/streamed over fake PTY, full6301-frame checksum and v3..6 fixtures; compact,10 display-unit tests, NVM destructive guard off/on, Python compile and both MCU builds PASS (F413 RAM274160/FLASH373772). Hardware command sequence:none; no STLINK/UART/flash/reset/motor/fan/physical NVM access. FRAM map/schema/sampling/control and F405 run behavior unchanged; physical retention HIL pending, existing RAM4092 staging and8-record commit/power-loss limits remain. Preserve/exclude pre-existing params, generated fingerprints, flashing and worklog edits. See tools/logging/README.md. |
| 20260922 | 20260922-mini-r3-mode-ladder | mode3〜7吸引速度段階と最低接続加速度を設定 | mini-r3-suction-modes-t0.22 (host only) | yes | Mode3 small0.8/large1.0/fan50pct; mode4 1.0/1.4/70pct; mode5 1.2/1.7/100pct; mode6 1.2/2.0/100pct; mode7 1.4/2.2/100pct. Mode2 left unchanged including pre-existing local tuning. PR21 ab377c8 ideal model/1kHz/rounding1.2/omega3000, 80 mirrored turns max closure0.952mm, no nominal collision; diagonal effective margin1.486mm below3mm target. Diagonal placeholder1.0/1.4/1.5/1.5/1.5m/s, defer sub3..7 and case8/9 until mini_r2 validation. Case1 small-only minimum, case2 large minimum: ceil(v^2/(2*45mm)) in1000mm/s2 steps; case3+ vmax+200mm/s and accel+1000mm/s2 per case. Case0 cardinal sub0/1/2 consistently uses case1/2/2; all gains, wall thresholds, fan slew and300ms wait preserved. Latest115632/115910/120132 logs show small1.4 saturates13samples, large2.0 peaks85.1/85.0pct; SHA provenance in dedicated doc, live FW metadata absent. ASan/UBSan all50sub+12220 connectors,15 production sessions including50/70/100pct and840ms70pct ramp, lower-accel infeasibility, r2legacy50sub, runtime profiles, both profiles6modesx9cases and fan cleanup PASS. F413/F405 builds/diffcheck PASS; RAM274160/Flash373620. No UART/flash/reset/motor/fan/session/NVM/schema/ioc/stable hardware actions or motor permission. Control loop/F405/r2 params unchanged; unrelated local mode2/tool/CAD edits excluded. Details docs/MINI_R3_SUCTION_MODE_LADDER.md. |
| 20260922 | 20260922-mini-r3-mode7 | mode7高速吸引ターンとcase0速度指令修正 | mini-r3-suction-mode7-t0.21 (host only) | yes | PR21 ab377c8 ideal simulation, rounding1.2/omega3000; small1.4, large90/1802.0, diagonal1.5m/s; 16 mirrored endpoint errors <=0.925mm, nominal body collision-free but diagonal effective margin1.486mm below3mm requirement. Fan100pct, existing gains and1200ms ramp/300ms wait retained. Mode7 case0 all10 sub match mode6; straight2m/s45m/s2, diagonal1.5m/s25m/s2. Latest113152 CSV3558 rows SHA cdf6784b01dd33c09783f6dc21920ae10107ae755b67239f5a1f8d82e378c3a9 shows pre/post target1.5 vs small core1.2, feedback max1.553/1.558, turn duty93pct; no live FW metadata. F413 test-mode session derives straight/diagonal ceiling from configured maximum turn speed before initial speed/preflight/execution, preserving normal shortest, straight-only and source params; applies r2/r3. ASan/UBSan mode6/7 all10 paths+phase peaks+2736 connectors each, full small-turn sessions max1.2/1.4 and successful end, r2/r3 all6x9 params tests, mode4, machine, suction safety, linear219 and route14210 PASS; F413/F405 builds/diffcheck PASS. RAM274160/Flash372892. Generated route numeric tables identical, hash updated. No UART/flash/reset/motor/fan/run/NVM/schema/ioc/stable hardware actions or motor permission. Source contains unrelated local mode2/flashing/CAD changes kept out of commit. Details docs/MINI_R3_MODE7_SUCTION_TUNING.md. |
| 20260922 | 20260922-mini-r3-suction-start | 2走行の発進積分残留とcase0停止待ちを修正 | mini-r3-suction-start-t0.20 (host only) | yes | Reviewed trace_bin_20260922_103448.csv (4411 rows, SHA bcb33a8585438c34fed5fddc66720694fa5e78ed4c0598aa19292e95a232b9b2) R90 and103627 (3678 rows, SHA0976fb880340626bcffd5031522e8397df32cf09a9f3a73df8d0bccd89346107) R180. Turn max angle error1.073/1.211deg, rate RMS50.1/43.5dps; start yaw+0.702/+0.128 grows to+1.267/+0.764 within70ms, with matching encoder direction. Reconstructed outer angleI contribution+14/+13dps and inner yawI output+2.8/+1.8pct survive hold, explaining extra left yaw during launch; live FW/gain/duty metadata absent. Set FAN_ON angleI0.1->0, velocityP0.35->0.45 for R180 mean1.391/min1.264m/s without saturation(max49.2pct); all FF/other gains retained. Atomic suction stationary-hold release clears omega I/D and FF derivative history when publishing zero->nonzero velocity profile, preserving pose/angle target/translation I; moving/rotating/fan-off paths unaffected. R90 stops just short at target522.379/log522mm and waits until1.4s+, with0.657s gap at seq4091->4092; no exact end reason claimed. Test-mode runner now hands completed stop profile to existing0.75mm/20mm/s/250ms settle check rather than waiting for exact crossing; regular maze behavior/tolerances unchanged. Production-tick both fan states/yaw signs/forward-reverse release/preservation, session completion/position and speed timeout/normal-maze nonchange, existing gain/stop/velocity/machine ASan/UBSan, path219/mode6all10+2736/route14210, F413/F405 builds and diffcheck PASS. F413 RAM274160/Flash372148. Route numeric table unchanged, staged SHA39ec8c42 excludes unrelated local mode2 input edits (worktree SHA75912ca3). No hardware command sequence, UART/flash/reset/motor/fan/session/NVM/schema/ioc/stable action. Fan ramp and300ms wait preserved without a new settling gate. R90 then R180 user validation pending; details docs/MINI_R3_SUCTION_STARTUP_FIX.md. |
| 20260922 | 20260922-mini-r3-suction-yaw | 並進FFの実測改善を確認し角度P・旋回FFを追加調整 | mini-r3-suction-yaw-t0.19 (host only) | yes | Reviewed all control gains against trace_bin_20260922_101705.csv (3729 rows, SHA256 d10a3b102e19ae8ba5a62a379157b226ef03bbc204dfe2bfdfdb8f75193a01c8), mode6/case0/sub1 R90. Late straight feedback1.505/encoder1.498m/s; turn mean1.453/min1.392; start angle+1.427deg, turn peak error3.104deg, omega RMS67deg/s; global motor max50.8pct. Stop logged position error+0.000265m (distance column quantized1mm), mean translation PWM0.488pct, no0x0400 abort flag, cleanup577ms/output-off636ms, final-89.829deg. Translation/angular command reconstruction supports t0.18 settings (RMS0.227/0.222 per-mille), but live FW/gain/duty metadata absent. Add FAN_ON angleP15 (was10), omegaFF0.040 and alphaFF0.0008 (were0), keeping existing4ms/120deg/s lead, omegaP0.8/I0.006, translation/distance gains and fan100pct. Fit yaw plant to gyro/PWM with2ms lag gives0.0464 speed/0.00264 inertia in per-mille/deg units; partial inertia FF avoids duplicating capped lead. Host model suggests smaller turn angle lag, not hardware qualification. No average encoder reverse at stop despite feedback-0.071m/s; do not tune PID against that estimator transient. Wall/diagonal gains lack excitation and retained. Existing host assertion assumed zero angularFF; updated expected output and checked FF+lead both signs/fan states. Machine/stop/gains/velocity ASan/UBSan, both MCU builds/diffcheck PASS, RAM274160/Flash371924. Require next user R90 log before judging180 readiness; current180 alpha41000 is below90 alpha45500 and mainly raises omega to2200. No hardware commands, UART/flash/reset/motor/fan/session/NVM/schema/ioc/stable action; unrelated local edits preserved. Details docs/MINI_R3_SUCTION_GAIN_REVIEW.md. |
| 20260922 | 20260922-mini-r3-suction-ff | 直進実測から吸引FF初期値を設定し再走行用に保存 | mini-r3-suction-ff-t0.18 (host only) | yes | Fit trace_bin_20260922_095200.csv SHA256 7e4d41c0fe78205131705027f03a080951421f8a555a2003de81fbc65c397968 using mean motor PWM, encoder speed (14.13mm/200CPR), 11ms smoothing and 20ms finite-difference acceleration in straight accel/cruise/decel windows; fitted PWM-percent coefficients6.9654/10.6505/1.01335, RMS0.8217 percentage point, similar15..30ms estimates. Set FAN_ON static65/velocity0.110/accel0.0100 (per-mille, mm/s, mm/s2); FF at1.5m/s becomes23pct vs8.75pct, reducing feedforward deficit and expected PI accumulation. Preserve and capture existing user velocityP0.35/omegaP0.8/mode6 fan100pct as trial baseline; I0.001/D0 and angularFF/geometry/ramp unchanged. Single forward log has no live FW/gain/duty metadata; local gain reconstruction and ramp timing support, but do not prove, baseline. Static term is moving-friction intercept; low-speed/reverse/lower fan duty unvalidated, FAN_ON also affects mode4 at50pct. Production machine/profile, stop/hold, distinct fan gains, velocity feedback ASan/UBSan and both MCU builds/diffcheck PASS; F413 RAM274160/Flash371924. No hardware commands, motor/fan authorization or operation, UART/flash/reset/session/NVM/schema/ioc/stable change. Local model artifacts build/velocity_tracking, details docs/MINI_R3_SUCTION_FF_TUNING.md. Existing mode2 acceleration, flashing/tool/CAD edits excluded. |
| 20260922 | 20260922-mini-r3-velocity-tracking | 上限撤去後の1.5m/s未達をFF/PID追従不足として切分け | source349dea2; live FW SHA absent | no | User asks whether latest speed deficit is tuning rather than another override. Analyzed trace_bin_20260922_095200.csv (3866 rows, SHA256 7e4d41c0fe78205131705027f03a080951421f8a555a2003de81fbc65c397968), mode6/case0/sub1 R90. Target reaches1500mm/s and remains there336ms; feedback max1393 with no1200 plateau. At motion340..405ms, mean feedback1374.9/encoder1369.3mm/s and mean L/R PWM217.52 per-mille; global abs max451. Encoder uses14.13mm tire/200CPR and agrees with estimator. At95..400ms, translation output reconstructed with local Kp0.35/Ki0.001 and FF35+0.035*1500 has RMS0.256 per-mille; free fit Kp0.34905/Ki0.00099335 supports configured FAN_ON gains, not hidden output cap. FF only8.75pct while actual running requires roughly22pct, with P contribution declining as slow I accumulates. Startup timing also agrees with local100pct fan ramp, but fan duty/live FW metadata not directly logged. Stop target506.398mm vs measured520mm; at600..700ms target-27mm/s but residual I about7pct leaves forward PWM2.45pct. Cleanup at701ms followed by shared timeout/encoder flag763ms is consistent with250ms settle timeout, not proof of encoder failure. Recommend tuning translation FF/P before increasing I alone; current25m/s2 ramp is demanding. Host-only ignored reconstruction/fit/plot under build/velocity_tracking; no firmware/params edits, build, flash, UART, motors/fan or NVM action. |
| 20260921 | 20260921-f413-run-parameter-limits | F413固定速度制限と調整用上書きを撤去 | r3 t0.17 / r2 t0.2 (host only) | yes | User explicitly requests removal across machines. Removed common estimator +/-1200 and straight/diagonal/turn bring-up ceilings including mode4/6 exceptions; runtime and precompute use selected params. Angular ceiling becomes optional mode turn_omega_max (r3 mode4/6 explicitly2200 preserves PR21 geometry, other modes/search uncapped). Invalid shortest alpha/angle no longer get tuning fallbacks. Case0 forced3000 deceleration replaced with precomputed parameter-compliant tail (500@1000 needs125mm; mode6 still45mm), shown as stop_mm; normal maze stop feasibility remains fail-closed. Restored mode2 case6 saved-maze planner and declared wall features. Translation PID fixture now uses selected FAN_ON/OFF angle gains instead of4/0/0. F405 has no corresponding velocity ceilings; executable F405 code unchanged. Retained physical PWM, correction/fixture bounds, session guards and documented UI case mappings. Production control ASan/UBSan verifies both-sign feedback to4.5m/s, overspeed, fan/turn states and distinct gains; both machine profiles/all6modes/9cases plus5m/s straight,4.5m/s diagonal,4.3m/s turn params; path219, case0 mode4/6 and2736connections, route33464/precompute14210/slalom837, suction sequencing/PWM, machine and simulator32 PASS, both MCU builds PASS. Tables regenerated with runtime rounding and input fingerprints; no NVM/trace schema change. No STLINK/UART/flash/reset/motor/fan/session/NVM action. Physical behavior above former ceilings unvalidated. Existing user gain/duty/mode2 acceleration, flashing and hardware edits preserved and excluded. See docs/F413_RUN_PARAMETER_LIMITS.md. |
| 20260921 | 20260921-mini-r3-velocity-ceiling-diagnosis | mode6速度表示1.2m/s頭打ちと制御feedback clipを特定 | host diagnosis; live FW id absent | no | Latest trace_bin_20260921_232626.csv SHA256 9f7238cde57e930081323db64f437195959c55dd7e71e0c192b59ecb69abba92:3832 mode6/case0/sub1 rows. Source F413_CTRL_VEL_EST_MAX=1200 clips accel-comp velocity before straight feedback selection;213 real-velocity samples and313 accel-velocity samples equal1200 exactly. At3.055..3.095s target1.4994m/s,feedback1.2000,encoder-average1.5943m/s using14.13mm tyre/200CPR/1ms; logged distance change gives1.60m/s. PWM L/R28.20/27.89pct,whole-log abs max42.2pct, so not actuator saturation. During omega profile feedback switches to uncapped encoder LPF and can exceed1.2, then clips again on exit. Temporary host probe includes actual production control tick and existing HAL stubs:steady encoder/LPF1500->accel/feedback1200,target1500,PWM252/252,ASan/UBSan PASS. This fixed estimate ceiling was missed when preparing mode6 at1.5m/s; it causes artificial PI error and undermines gain tuning. User asked diagnosis only; no firmware/params fix, no live UART/flash/reset/motor/fan/NVM action. Current dirty gain edits0.35/0.8 preserved,not asserted as captured FW settings. Local analysis/probe artifacts build/velocity_ceiling. |
| 20260921 | 20260921-trace-display-si-units | mdps/deg混在を修正しSI基準・角度degの表示へ統一 | host tools only; source f8b3a2f | yes | User reports implausible1.5Mdps plot. Latest trace_bin_20260921_230442.csv SHA256 ec97e823eaaf729bdbafd0fbaffaf41ed27c3df7b43cce5d64ee584229736b73 has3866 mode6/case0/sub1 rows over3.986s, actual omega min-1684200mdps=-1684.2dps. Firmware samples dps*1000 correctly; Web overlaid raw mdps with derived dps on deg/s axes and mdeg with deg. Shared host conversion now emits one channel per quantity: s,m,m/s,m/s2,deg,deg/s,signed motor fraction; user follow-up explicitly keeps angular quantities in degrees; raw ADC/encoder/flags/reserved remain explicitly uncalibrated. Separate PlotJuggler angle/omega panels and update default template; --legacy-units supports custom old layouts. Require TUNE flag+axis instead of inferring from wall-derivative reserved values, omit unavailable channels, preserve metadata/rows/source files. Ten unit/figure/schema3..6/tune-axis/CLI/template regressions PASS; real latest replay and browser display labels/omega about-1700 range confirmed after restarting stale-import Streamlit process. Python compile/diff checks PASS. No firmware/params/NVM/schema/ioc/stable edits or live hardware commands; preserve user gain tuning and other dirty changes. |
| 20260921 | 20260921-mini-r3-mode6-fan-on-gains | mode6高速吸引case0とFAN_ON独立ゲインを準備 | mini-r3-mode6-fan50-t0.16 (host only) | yes | User reports stable t0.15 suction and requests1200mm/s small,1500mm/s large/diagonal gain tuning, then FAN_ON selection initialized from FAN_OFF. PR21 ab377c8 ideal simulation generates alpha/in/out; all16 mirrored C initializers close within0.995mm/0.001deg, nominal body gap>=5.947mm; conservative diagonal margin fails3mm target and V90 effective-0.027mm, so physical tracking/maze clearance remain unqualified. Set all9 mode6 cases straight/diagonal1500mm/s and accel/decel25000mm/s2, minimum for1500->0 in45mm; actual dispatcher10 subs and production preflight2736 shortest start/compatible-turn-pair/stop paths PASS. Preserve fan50pct,600ms ramp,300ms target wait,continuous original-pose hold. Shared F413 controller now selects FAN_ON during successful fan PWM operation, including ramp; independent19 r3 ON constants copy current OFF. Actual1kHz control with deliberately different ON/OFF gains, stop/hold, PWM state/failure cleanup, mode6 suction session, machine/profile/front89.1mm, mode4 regressions,path225,route14210 and F413/F405 Debug builds/diffcheck PASS. Route numeric data unchanged, staged metadata excludes unrelated r2 mode2 edits. r2 fanless/F405 and mode4 geometry retained. Hardware command sequence:none; no live authorization requested or used, no UART/flash/reset/motor/fan/NVM/schema/ioc/stable operation. User report is not new-speed HIL; traction,25m/s2 linear limits and V90 saturation require user trials. Preserve pre-existing worktree edits. Details docs/MINI_R3_MODE6_SUCTION_TUNING.md. |
| 20260921 | 20260921-mini-r3-suction-slower-ramp | 吸引レート半減と到達後300ms待機 | mini-r3-mode4-fan50-t0.15 (host only) | yes | User reports major improvement with residual instability and specifies50pct/600ms,100pct/1200ms plus300ms post-target delay. Scale ramp duration with requested per-mille duty using1200ms full scale; keep elapsed-time guarded PWM updates and continuous original-pose control. Change mini_r3 runtime SUCTION_FAN_STABILIZE_DELAY_MS100->300; configured mode4 duty remains500/1000. Diagnostic message shows actual ramp/wait. Existing ASan/UBSan session tests verify25/50/75/100pct at300/600/900/1200ms,300ms post-target wait, late polling/tick wrap/all-phase guards/failure cleanup/fan-off order; production PWM, runtime machine/profile, route14210 checks, F413/F405 build and diffcheck PASS. Table numeric data unchanged, input SHA refreshed separately for staged and dirty params. No UART/flash/reset/motor/fan/NVM operation; physical follow-up pending. Pre-existing user edits preserved. |
| 20260921 | 20260921-mini-r3-suction-start-timeout | 吸引後即終了の整定timeoutを撤去しfan立上げを緩和 | mini-r3-mode4-fan50-t0.14 (host only) | yes | User reports fan spins then exits. Local22:07 mode4/case0/sub2 trace2777 rows: ctrl1205ms, cleanup2325ms, timeout/encoder-class flag2386ms, no forward path; yaw-1.717..+2.664deg fails added0.5deg gate. Timing matches20ms lead+100ms fan+1000ms gate timeout; no live FW ID read. Remove unvalidated startup settling gate, retain fan-off calibration/20ms pose-control lead, ramp fan1/1000 to500/1000 over300ms then existing100ms guarded wait and continuous control departure without angle reset. Add guarded running-duty update without PWM restart. Gains/turns/non-suction/F405 unchanged. Production session ASan/UBSan monotonic ramp/delayed wait/tick wrap/observed pose regression/all guard phases/start-update failures/cleanup; PWM500 continuous updates/idle-cap-stop-range refusal; control/10 mode4 paths/225 linear/14210 route checks and both Debug builds/diffcheck PASS. Route numeric metadata only. Physical yaw suppression is unverified; original hold-only direction tests did not prove real settling. Hardware command sequence:none; no UART/flash/reset/motor/fan/NVM operation. Preserve pre-existing edits; docs/MINI_R3_MODE4_SUCTION_TUNING.md records evidence and limits. |
| 20260921 | 20260921-mini-r3-suction-start-hold | 吸引始動前にIMU校正と位置・角度保持を開始 | mini-r3-mode4-fan50-t0.13 (host only) | yes | Latest local21:50 trace mode4/case0/sub2/test80 has2762 rows, initial motion/control fields stale until1321ms. Code starts fan before100ms wait and blocking IMU calibration/control reset, leaving startup impulse unopposed and unobservable in yaw trace; decoded log has no FW SHA, no live ID read. Reorder fan-off calibration/control,20ms original position/angle hold,50pct fan,100ms minimum spinup under hold, then20 consecutive guarded samples (normally40ms with HAL delay) within0.5deg/10dps/1mm/10mmps; additional1s nonsettling aborts without path motion. Never restart/reset yaw after fan. MOTOR_COAST flags defer SPI/NVM trace flush during hold. Existing gains, fan duty, turn params, no-fan order and F405 unchanged. ASan/UBSan production session1/2ms polling/ordering/recovery/individual settling failure/all guard phases/PWM failure/cleanup/no-fan regressions and actual1kHz yaw/position opposing output PASS; mode4 all10 preflights,225 path and14210 route checks, F413/F405 builds/diffcheck PASS. Route numeric table unchanged, input SHA refreshed excluding unrelated staged params. Hardware command sequence:none; no motor/fan authorization or operation, UART/flash/reset/NVM unchanged. Physical startup suppression/traction remains unverified. Preserved pre-existing edits. Details docs/MINI_R3_MODE4_SUCTION_TUNING.md. |
| 20260921 | 20260921-mini-r3-mode4-suction-seed | mini_r3 mode4吸引50%とcase0ターン調整を準備 | mini-r3-mode4-fan50-t0.12 (host only) | yes | User confirms fan-off exploration/mode2 shortest and requests r2-mode4 speeds with PR21 simulator geometry. Used ab377c8 ideal response, no out-of-scope r2 empirical fit; 16 mirrored primitives close within0.988mm/<0.1deg, raw70x39mm clearance>=7.588mm, conservative diagonal effective1.61..2.08mm below3mm target: initial tuning only. Set r3 mode4 fan500/1000; retain800/1000/1200mm/s, exact angles, existing gains and r2 case ladder. Wire TIM10 capability/stop/PWM guards,100ms guarded stabilization and all-exit cleanup into path runner; suction-mode4 turn/diagonal caps1200, straight1500 unchanged. Replace suction-only case0 invalid diagonal entries with all10 valid tests and sufficient braking tails; r2 mapping unchanged. ASan/UBSan10-path dispatch/preflight, production session finish/start-fail/all aborts/timeout/refusal, real PWM helper, machine/front-reference tests, existing225 path checks,14210 route precompute numeric checks, F413/F405 build/diffcheck PASS. Route numeric table unchanged, metadata refreshed. Hardware command sequence:none; motors/fan not authorized or operated, no UART/flash/reset/NVM/schema/ioc/stable change. Physical suction/turn saturation/wall clearance unverified. Preserved/excluded pre-existing mode2/flashing/CAD/exploration edits. Details docs/MINI_R3_MODE4_SUCTION_TUNING.md. |
| 20260921-111941 | 20260921-f413-near-wall-recovery | 近接打切りを廃止し後退優先の位置合わせと実時間上限へ変更 | mini-r3-2s-fanoff-t0.11 (host only) | yes | User explicitly requests attempting alignment despite near/uncertain readings and stopping bounded failed correction/contact. Latest20:02 log: smap9/back,138ms wall_fault, speed168, FR/FL2862/2696=41.75/43.18mm, no front-match. Remove42.5 proximity abort; near/saturation latch braking handoff even with invalid LUT range, then retreat before yaw when either side is closer than target-tolerance. Reverse-30 clears forward velocity integration without resetting odometry/IMU, requires20 recovered observations and>=0.5mm signed retreat;12mm absolute per-retreat limit. Alignment including nested recovery uses1000ms wall-clock deadline; timeout disables drive and propagates instead of silently spinning. Continuous alignment acquisition also bounded, motor-off holding/waiting exempt. Preserve missing/nonfinite/stale20ms and run guards; remove synchronous braking/retreat-entry prints. Shared F413 r2/r3 policy, F405 untouched; gains/LUT/IMU/geometry/NVM/schema/stable unchanged, tune-label only t0.11. Production wait/alignment/state-machine/control-tick ASan/UBSan tests cover38..50mm recovery, asymmetry, saturated/out-of-range samples, forward/reverse stall,12mm bound, continuous timeout, stale/missing/nonfinite/switch and positive-integral reversal; real LUT replays all3 failed pairs as handoff. Machine profiles/NVM guard/path225/solver internal sample/F413/F405 builds and diffcheck PASS. Hardware command sequence:none, no live authorization requested/used, no probe/UART/reset/flash/motor/fan/run/NVM write. Physical braking/retreat/calibration/maze success remain pending. Unrelated flashing/CAD/tool files excluded. |
| 20260921-105119 | 20260921-f413-stop-approach | ゴール区画の折り返し前減速停止timeoutを修正 | mini-r3-2s-fanoff-t0.10 (host only) | yes | User authorizes fix after inspection of19:34/19:36 event logs: full exploration smap9/back at(1,0,S),5000ms timeout before any front-match record, not route failure. Fix shared F413 velocity profile residual acceleration/FF, preserve nonzero clamp direction, exact zero-speed endpoint and bounded +/-30mm/s position correction; publish/cancel profile atomically. Search stop requires profile completion,1mm error and10mm/s speed for20 samples. Alignment-enabled back-turn approach hands off at valid front target45mm; near42.5mm, saturation, missing/nonfinite/stale20ms or lost handoff validity disables drive and prevents downstream map-save/spin. r2 uses its own7/4.5mm references and shares control fix; F405 unchanged. Added production wait/control-tick ASan/UBSan regression tests with hardware mocks, and real-LUT replay of both failed ADC pairs. New tests, machine profiles, NVM guard, path-linear225 checks, solver internal maze and F413/F405 builds/diffcheck PASS. Gains/IMU/LUT/geometry/identity/NVM/schema/stable unchanged; t0.10 labels motion change only. No hardware command sequence (none), motors not allowed or run, no probe/UART/reset/flash/NVM writes. Physical braking, calibration and maze retry pending; host model is not HIL qualification. Details docs/F413_STOP_APPROACH_FIX.md. Unrelated flashing/CAD/tool changes preserved/excluded. |
| 20260921-043601 | 20260921-mini-r3-front-range-extension | 前壁の80..110mm追加測定を反映し入口90mmの有効範囲を確保 | mini-r3-2s-fanoff-t0.9 (host only) | yes | User supplies seven new distance,FR,FL,R,L delta-mean rows80..110mm. Preserve shielded09-12 knots40..75; replace80mm565/595 with latest599/568 (no averaging or channel swap), append85..110; retain full supplied rows in extension CSV and active15-point merged fixture. R/L cross-readings unused, side LUTs unchanged. FR/FL/sum ranges223..3048/233..3043/456..6091,90mm422/422/844; all110mm signals pass existing160/channel gate. Generated C matches exactly, monotonic data need no adjustment. Real converter ASan/UBSan tests verify every knot, every in-range ADC,90mm production distance accessor,82mm crossing and near/far/no-wall/single-invalid/raw-saturation rejection; r2/both r3 profiles and NVM params/guard suites PASS. F413/F405 builds/diffcheck PASS (F413 RAM274120/Flash367188). Allt0.8 user gains, IMU policy, geometric entry targets, raw thresholds, identity/FRAM formats and immutable stable checkpoint unchanged. Updated calibration provenance and front-reference docs. No probe/UART/flash/reset/motor/fan/run/NVM action; firmware deployment and physical front-correction accuracy remain unverified. Existing local flashing/CAD/tooling edits preserved and excluded. |
| 20260921-042531 | 20260921-mini-r3-fanoff-baseline | 非吸引調整値を保存、前壁補正の換算監査と追加測定待ちを分離 | 929f000 / mini-r3-2s-fanoff-t0.8 | yes | User accepts non-suction tuning and reports basic maze motion works with r2 run arrays, except front-turn correction. Saved user's velocityP0.24/omegaP0.45 with all other current gains/IMU feedback preserved; versiont0.8. Added scoped parameter checkpoint manifest/notes/runtime reference under stable/mini/unit002/s20260921-mini-r3-2s-fan-off with exact source commit and five file hashes, not a complete FRAM/binary recovery image. Audited F413 search/path front entry: val_offset_in/fwall_kx unused, actual target=F_ALIGN_TARGET_MM+45-entry; r2 target7/r3 target45 already implements +38mm reference correspondence. Recorded targets search82/80, modes2..7 82.8/86/86/86/88/80 and nominal entry90mm; r3 LUT measured40..80 and initial invalid reading selects encoder-only segment, so raw ADC rescaling cannot solve missing coverage. Requested85/90/95mm delta measurements; user explicitly defers measurements and asks to finish everything else. No LUT, raw threshold, turn geometry, or runner control edits. ASan/UBSan machine tests incl r2/both r3 units and front-reference audit PASS, F413/F405 builds PASS (F413 RAM274120/Flash367116), all checkpoint hashes/YAML and diffcheck PASS. No STLINK/UART/flash/reset/motor/fan/run/NVM operation this task; live binary/FRAM not read. Floor acceptance is user-reported, not agent HIL or exhaustive speed/mode/3S/suction qualification. Existing unrelated flashing/CAD/tooling worktree edits preserved. |
| 20260921-0310 | 20260921-mini-r3-imu-velocity-restore | mini_r3のIMU併用速度feedbackを復帰、SWD通信不良で実機書込保留 | 82157c1-dirty/t0.7 (build only) | partial | User requests IMU-assisted feedback for actual floor gain tuning. ENABLE_CONTROL0->1, previous ENABLE_DURING_OMEGA_PROFILE0 retained; window30ms/gain1 and translation/distance PI/FF unchanged. Preserve user's dirty omegaP0.2, excluded from commit but included in local binary. ASan/UBSan machine tests PASS after invoking non-executable runner via sh; F413/F405 builds PASS, RAM274120/Flash367124, diffcheck PASS. BIN SHA6cdc5dfb1500c9fe55ab6ed5efcad2f3f4b3c4338004e59a3b354068a0c5dac5. UART initially busy with user's serial_capture process; requested close and did not take over/send. Native CubeCLI STLINK066CFF545771485067013914 list succeeds; HOTPLUG4MHz -u0x08160000/0x20000 and retry1MHz -r32UID/-u fail with USB transfer timeouts, Unable to get core ID / No STM32 target found (VDD3.24V). No backup file produced and no erase/write/reset attempted. Existing V3MINIE-only USB recovery helper reports no matching VID/PID and performs no reset. No UART, motor/fan/run, calibration/map/trace/identity mutation; no fresh live build/runtime flag verification. Last agent-confirmed flash0020011dirty/t0.6 remains the reference, not the newly built t0.7. Need target power/debug connector/USB reseat before app flash and non-motor readback. |
| 20260921-0257 | 20260921-cube-cli-native-arm64 | macOS arm64用CubeProgrammerの自動選択と実行配置を修正 | host-only (base06b2218) | yes | Reproduced flash_stlink --list failure with errno86 Bad CPU type on arm64 macOS27.0/26A428: installed CubeProgrammer2.21 bin CLI is x86_64-only, api/lib CLI is universal x86_64+arm64. Added same-install native selection and context-managed private temporary bin layout with copied CLI and linked SDK dylibs/frameworks, Data_Base, FlashLoader and Drivers; no vendor app, signing, Rosetta or security-setting change. Preserve explicit CLI/install selection, existing local USB recovery changes, and user's KP_OMEGA_FAN_OFF edit. 13 new host tests plus4 identity tests PASS, py_compile/diffcheck PASS. Live operations only default flash_stlink --list, compatibility wrapper --list, and native CLI -c port=SWD mode=HOTPLUG freq=4000 sn=066CFF545771485067013914 -r32 0x1FFF7A10 0xC: PASS, VDD3.24V/device0463/UID001D0038-32345108-36383936 (unit002). No firmware build/flash/reset, UART, motor/fan/run, identity/calibration/map/trace mutation; last known firmware0020011dirty not re-read. Actual application write remains for user's next normal --build invocation; command construction checked by mocks without changing write/verify/reset arguments. Temporary runtime removed on normal/error exit. |
| 20260920-205156 | 20260921-mini-r3-unit002-translation-tune | UART復旧、2S非吸引の浮上並進ゲインを粗調整 | 0020011-dirty | yes | User reseats connector, UART921600 resumes; prior request authorizes lifted secured translation-only8V2A/debugger5Voff. Initial w/i PASS; pipe,V backs up existing2544-record trace (maze already60 known cells). Baseline974b280dirty t0.5 !300step shows sustained oscillation/167 saturated samples/minVBAT1349, stopped normally and not repeated. Rc1 encoder3msLPF/P0.08/I0.001 with temporary18pct cap passes ! and double-quote300; rc2 staticFF35 plus temporary velocityset1=500 passes (, then ^ shows inherited outer-loop oscillation. Final r3 distanceP2/I0, all temporary control.c changes removed, versiont0.6/source0020011 committed/pushed, rebuilt/flashed/verified app sectors0..6 only. Final ^300mm/s270mm gives269mm/peakPWM54; !300 gives steady303.73 SD15.43mm/s/peak356/peakPWM73/minVBAT2067. Both full dumps complete, all run traces no drops/errors. Normal guardLOCKED/unit2 confirmed. F413/F405 builds, ASan/UBSan machine suite with r2 unchanged and r3-specific gain assertions, both PWM and guard suites/diffcheck PASS. Final i,w,pipe PASS, identity128KiB equals backup and both calibration256B prefixes unchanged, maze_known60 unchanged, no fan/rotation/floor/calibration/map/identity write; normal run trace replaced intentionally. HOTPLUG fault0, TIM2CCER/CCR1/CCR3=0 DIR/STBYlow fanCCR0, mode0 UARTclosed. Physical heat/noise/current-meter reply pending; floor dynamics/straightness/accelerationFF not qualified. Full commands, metrics, build/log hashes in docs/MINI_R3_UNIT002_TRANSLATION_TUNING.md. Pre-existing user tooling/CAD files preserved. |
| 20260920-203601 | 20260921-mini-r3-unit002-translation-precheck | 浮上並進ゲイン調整はUART無応答のため駆動前に保留 | unchanged (last flashed974b280-dirty) | no | User requests2S/fanOFF translation-only lifted/secured coarse tuning. Reviewed velocity300mm/s set0 step/trapezoid and distance tune; no motion shortcut was sent. STLINK066CFF545771485067013914 software reset succeeds, UID confirms unit002, VDD3.24V, uwTick advances and CFSR/HFSR0. UART /dev/cu.usbmodem211202 921600 exclusive terminal opens but no boot/status/dump bytes received; attempted only i,w,pipe,V then w, reopened raw serial with flow-control disabled/DTR/RTS asserted and w, still no response. MCU USART1 BRR0x6C/CR1 0x200C and last DR0x77 are consistent with configured UART and last w, but end-to-end receive remains unavailable; not enough evidence to assign hardware/software root cause. No build/flash/gain/identity/calibration/maze/trace-write or motor/fan operation. Final TIM2CCER/CCR1/CCR3=0 DIR/STBYlow TIM10CCR1=0, UARTclosed. Asked user to reseat USB and target debug connector while preserving8V2A/debugger5Voff. Empty capture mini_r3_unit002_translation_baseline_20260921.log is not a valid run log. Resume communication check before any tuning. |
| 20260920-2015 | 20260921-mini-r3-unit002-wall-transfer | unit001遮光後の壁校正をunit002へ暫定移植 | 974b280-dirty | yes | User transplanted same sensors and authorized calibration reuse. Backed up zero sensor/distance256B prefixes over UART921600. Exact UID001D0038-32345108-36383936/unit2/layout/empty-prefix gated temporary pre-timer hook saves only sensor68B FR82/FL66/R27/L43, checksumDA, verifies and rolls back on failure; host ASan/UBSan success/rejection/read-fail/partial-write/verify-fail rollback/idempotence PASS, existing params and both guard suites PASS. Built/flashed temporary app with global destructive diagnostics OFF, transfer PASS, removed hook, built/flashed normal Debug app; both STLINK066CFF545771485067013914 app sectors0..6 verify/reset PASS. Normal boot974b280dirty LOCKED unit2 t0.5 L/R1/1. UART baseline pipe,w; temporary flash/pipe; normal flash/w,colon,pipe. Effective512 means17/6/35/63 allwalloff ready03 no saturation. Source and both resulting sensor256B dumps exactly equal; bytes68..255/distance zero unchanged, identity128KiB matches registration, trace400. Unit001 invalid diagnostic distance fixture deliberately not copied; side bases remain provisional1941/1989. No motor/fan/run commands or identity/maze/trace writes; final HOTPLUG fault0 motor/fan PWM/enable/direction off, mode0 UARTclosed. Log mini_r3_unit002_sensor_transfer_20260921.log; hashes and tuning/fan/3S/route software gates in docs/MINI_R3_UNIT002_BRINGUP.md. Permanent changes documentation only; user's dirty tooling preserved. |
| 20260920-200059 | 20260921-mini-r3-unit002-left-polarity | unit002左極性を配線に合わせ、全4方向encoder符号PASS | 18c5660-dirty | yes | User visually confirms left-only inverse rotation, authorizes setting change and accepts encoders as direction reference. Added unit002-only MINI_R3_HW(true) override; encoderL+1/R-1/right/model/r2/unit1/params/NVM unchanged. Extended machine resolver/runtime PWM tests; ASan/UBSan machine suite incl unit2 and both262144-case PWM tests PASS, Debug-stm32f413/F405 and diffcheck PASS. Committed18c5660, rebuilt F413 RAM274120/Flash367124B, flashed build/Debug/nightfall_stm32f413.elf via temporary native CubeCLI/STLINK066CFF545771485067013914, sectors0..6 only verify/reset PASS. Boot18c5660dirty unit2 L/R forwardIN2=1/1 enc=1/-1 PSC0 LOCKED. Same authorized lifted/secured8V2A/debugger5Voff. UART921600 /dev/cu.usbmodem211202 baseline pipe then flash/w,p,6,7,8,9,i,pipe:12pct500ms plus300ms coast gives LF+2577 RF+2569 LR-2233 RR-2236 inactive0, all signs correct. IMU6B/config74,71,44 PASS; ADCready03/no saturation. Full128KiB identity equals registration backup, both256B calibration prefixes unchanged and trace remains400. Final HOTPLUG CFSR/HFSR0 TIM2CCER/CCR1/CCR3=0 DIR/STBYlow fanCCR=0, mode0 UARTclosed. No FRAM/identity write or closed-loop/floor/turn/fan run; existing user's dirty tooling preserved. Log mini_r3_unit002_left_polarity_20260921.log; binary SHA d8185c3d84602e69ab6417fdd947878794e37e2742bc27d2639d9ab5c72b0e02. |
| 20260920-195703 | 20260921-mini-r3-unit002-direction-repeat | 吸引OK追認、左符号逆の方向目視用再試験 | 001d688-dirty | no | User confirms fan/suction OK, missed wheel directions and explicitly requests repeat; wiring should match unit001. Continued same lifted/secured8V2A/debugger5Voff session. UART921600 /dev/cu.usbmodem211202 sequence p,6,7,8,9 with5s lead-in/gaps and per-direction announcements. Each12pct500ms plus300ms disabled coast: Lfwd-2195/Rfwd2570/Lrev2568/Rrev-2225, other encoder0. Left sign reversal reproducible; physical direction reply pending, no polarity/encoder edit or closed-loop test. No build/flash/reset/fan rerun/NVM write. STLINK066CFF545771485067013914 HOTPLUG VDD3.24, CFSR/HFSR0, TIM2CCER/CCR1/CCR3=0 DIR/STBYlow TIM10CCR1=0. Final mode0 UARTclosed; log mini_r3_unit002_direction_repeat_20260921.log. |
| 20260920-1954 | 20260921-mini-r3-unit002-wall-clear | unit002壁撤去後に全壁なしへ復帰 | 001d688-dirty | no | User confirms wall/paper removal. Reopened UART921600, read-only w and colon: allwall flags0, ready03, no saturation, offsets0;512-sample means FR71 FL58 R35 L48, SD4.54/3.38/3.09/2.83. Four optical channels now verified wall-on and wall-off; no calibration/LUT accuracy claim or write. Log mini_r3_unit002_wall_clear_20260921.log. No further motion/reset/flash/NVM; UARTclosed mode0. Left physical direction and fan observations still pending. |
| 20260920-195307 | 20260921-mini-r3-unit002-wall-response | unit002全壁センサの反射応答を確認 | 001d688-dirty | no | User places front/right/left walls or paper. UART w reports FR1247 FL842 R1759 L1856 and front/right/left flags all1, no saturation. Read-only colon512-sample/1024ms average FR1235 FL837 R1757 L1863, SD4.60/3.61/3.67/3.55. All four optical channels respond versus earlier about100; fixture distance unspecified, provisional unit001 LUT not used to qualify accuracy. Requested removal for return-to-no-wall check. Left-wheel visual direction and fan/noise/heat/current-limit observations also pending. No further motor/fan/NVM action; UART released, mode0 drive outputs off. |
| 20260920-195113 | 20260921-mini-r3-unit002-populated-hw | unit002追加実装の駆動/encoder/壁ADC確認、左符号逆の目視確認待ち | 001d688-dirty | no | User confirms newly populated wall sensors/encoders/motors/fan, lifted secured bench8V2A/debugger5V OFF. STLINK066CFF545771485067013914 temporary native CubeCLI reset-only, UART /dev/cu.usbmodem211202 921600 log mini_r3_unit002_full_hw_20260921.log. Boot unit2 correct normal LOCKED, L/R forwardIN2=0/1 enc=1/-1 PSC0. UART i,w,p,pipe then6,7,8,9 each12pct500ms: counts Lfwd-2192/Rfwd2535/Lrev2581/Rrev-2210 inactive-side0. Opposite left sign requires visual direction confirmation; no closed-loop/sweep/polarity edit. OP-UART P x9/E/P x4/E with state checks invokes fan20/50/80pct each1200ms thenoff; physical rotation/suction/noise/heat/current-limit feedback requested. Wall deltas initially FR98 FL100 R104 L101, later98/98/77/93, offsets0 ready03 no saturation; requested walls for optical-response test, pending. Reset backmode0; SWD HOTPLUG CFSR/HFSR0 motorTIM2CCER/CCR1/CCR3=0 DIR/STBYlow fanTIM10CCR1=0. Calibration prefixes allzero unchanged, trace400 records already present initially and unchanged finally. No firmware build/flash/source change, NVM/identity/calibration/map/trace-format write or floor motion. |
| 20260920-092410 | 20260920-mini-r3-unit002-fram-probe | unit002 FRAM書込み・読戻し・元データ復元PASS | 001d688-dirty | yes | User explicitly authorizes FRAM test on new empty unit002. Verified UID001D0038-32345108-36383936/identity2 through STLINK066CFF545771485067013914. Temporary maintenance-only UART closing-brace command restricted to exact UID/unit2/idle mode0/no control-test-autotrace; backed up four256B trace samples at physical0x60000/0x7FF00/0xBFF00/0xFFF00 to RAM and UART before writes, then00/FF/55/AA/location-dependent pattern all PASS, original1024B restored and readback PASS. Host ASan/UBSan normal/failure-recovery/no-write-on-backup-failure/alias checks and both NVM guard configurations PASS. Built maintenance application, flashed/verified app sectors0..6, executed probe, removed all temporary main.c edits, rebuilt normal Debug-stm32f413 with destructive diagnostics OFF, flashed/verified sectors0..6 again. Both builds001d688 DIRTY1; final binary SHA135ce79fdfc9559256f2c88ddb019e1b9301c3d2479f0e82de9bfc6bac497d89. UART921600 sequence baseline pipe, maintenance boot/closing-brace, normal boot/i,w,k,pipe; k only on LOCKED normal firmware and refused. IMU6B/config74,71,44 PASS, ADCready03/VBAT2089, CFSR/HFSR0, motor TIM2CCER/CCR1/CCR3 and DIR/STBYlow, fanTIM10CCR1=0. Identity full128KiB equals registered backup and both256B calibration prefixes unchanged. No motor/fan permission or commands, no calibration/map/trace-format append or identity write. Final mode0/UARTclosed; log tools/logging/logs/mini_r3_unit002_fram_20260920.log. Basic sampled integrity only, not full-capacity/power-cycle-retention qualification. Final tracked changes are documentation only; user's dirty tooling preserved. |
| 20260920-0912 | 20260920-mini-r3-unit002-user-led-current | unit002全LED目視確認と無負荷電流74mA | 3ee4d27-dirty | no | User confirms all LEDs illuminated during test and bench supply current0.074A at8V. Recorded as idle whole-board input baseline, not driver load/thermal qualification. No additional live command or NVM operation; FRAM write/readback authorization still pending. |
| 20260920 | 20260920-mini-r3-unit002-register-nonmotor | mini r3 unit002登録とIMU/ADC非駆動HIL | 3ee4d27-dirty | yes | User explicitly approves unit002 identity and confirms IMU populated. Added UID-required unit2 registry with model-standard L-forward-IN2low, no unit001 lead-swap override; extended host resolver/runtime-boot tests including zero/mismatched UID rejection. Machine/PWM/identity host tests, F413/F405 builds and diff check PASS. Source commit3ee4d27, rebuilt and flashed app sectors0..6 only with verify through temporary native CubeCLI; UART SAFE verified before provisioning. `f413_identity.py provision-empty --sn 066CFF545771485067013914 --machine mini_r3_0 --unit-serial 2 --expected-uid 001D0038-32345108-36383936 --backup-dir build/identity/mini_r3_0_unit002_20260920 --allow-identity-write` backed up full128KiB sector15, confirmed empty and repeated UID, wrote68B without erase, verified full-sector unchanged except identity. Reset correctly selects unit2/profile0x30001 and left/right IN2=0/1. UART921600 sequence i,w,p,pipe,I,c,l then reset/i,w,pipe; log tools/logging/logs/mini_r3_unit002_nonmotor_20260920.log. IMU0x6B/config74,71,44 PASS, gyro offset0.38dps and eight-second final0.0deg, acceleration mean57.8/-187.8/9906mm/s2 about1.01g. Wall ADC0..1, battery2100..2103 about7.96..7.97V nominal-reference, STLINK3.24V. Switch releasedhigh only; LED30s command completed, physical confirmation pending. FRAM calibration prefixes allzero unchanged after reset, read status0 but no write/readback integrity proof; requested separate write-test permission, none executed yet. Legacy zero-map fallback explains maze=OK known0, not a qualified saved maze. Post-diagnostic CFSR/HFSR0, motor TIM2CCER/CCR1/CCR3=0 and DIR/STBYlow, fan/buzzerCCR=0. Final mode0/UARTclosed. Only authorized identity persisted; no FRAM/calibration/map/trace writes, no motor/fan/run/buzzer diagnostic (normal boot buzzer output still occurs with buzzer absent). Source and HIL limits documented in docs/MINI_R3_UNIT002_BRINGUP.md. |
| 20260920-090406 | 20260920-mini-r3-newboard-preidentity | mini r3新基板のMCU・Flash・UARTを確認、個体ID登録承認待ち | 1bf4966-dirty | no | User reports newly soldered PCB connected on 8V/2A bench supply, no noticed heating, sensors/motors/buzzer absent; IMU population clarification requested. Existing uncommitted tooling/CAD files preserved. Default CubeCLI and IDE OpenOCD are x86-only and fail with Bad CPU type; used installed CubeProgrammer2.21 ARM-capable api/lib CLI copied into `/tmp/mini-r3-cube-arm64.IPtRtX/bin/`, linked existing dylibs/frameworks/Data_Base/FlashLoader, without modifying installed applications. ST-LINK SN066CFF545771485067013914 reports VDD3.24V; SWD HOTPLUG at4MHz identifies0x463 and UID001D0038-32345108-36383936, identity68B empty, application first32B erased. `cmake --build --preset Debug-stm32f413` PASS (RAM274120B, Flash367068B); `flash_stlink --cli <temporary ARM CLI> --sn <SN> --image build/Debug/nightfall_stm32f413.elf` programs only sectors0..6, verifies, software-resets. UART921600 `/dev/cu.usbmodem211202` captures `[SAFE] machine=identity-invalid identity_status=3 GIT=1bf4966 DIRTY=1` with new UID; log `tools/logging/logs/mini_r3_newboard_20260920.log`. A pre-flash UART i received no response; no subsequent peripheral command issued. Running HOTPLUG reads show CFSR/HFSR0, RCC_CR03007C83/PLLCFGR22003210 (configured100MHz), TIM2_CR1=0, TIM10_CCR1=0, GPIOB_ODR0280 with STBYbit2low. SAFE deliberately skips board GPIO/SPI/ADC/control/UI initialization, so IMU/FRAM/ADC/LED/switch function is NOT yet verified. Requested permission to register distinct mini_r3_0_unit002 without copying unit001 calibration or left-lead swap; no registry/identity/FRAM mutation performed pending reply. UART closed; no motor/fan/buzzer diagnostic, run, calibration/map/trace write or protected-sector erase. Old unit001 U2 thermal fault remains separate and uncleared. |
| 20260915-060422 | 20260915-mini-r3-c21-nrst-omission | ブザー干渉によるNRSTコンデンサC21未実装の影響を評価 | aba28d5-dirty (last observed) | no | User reports C21 cannot fit beneath/near buzzer, left DNP, no noticed false reset; wants eventual maze validation before PCB respin. Local CAD confirms100nF NRST-GND, U5pin7/RESET0/K1pin5; ST AN4488 section3.1 and F413 DS11581 confirm optional external reset circuit for nominal startup, recommended noise capacitor, internal pull-up/filter, UFQFPN48 internal supervisor always on. C21 omission does not disable POR/PDR/BOR settings or directly explain U2 idle heating. Risks: parasitic resets, volatile run-state loss and interrupted writes; no blanket NVM-erasure claim. Current MX_GPIO init drives STBY/DIRlow and OP starts0; not a loaded-reset safety qualification. Healthy new assembly on same PCB may proceed through separately authorized staged low-speed checks with reset monitoring; defective U2 unit remains unpowered. Dedicated reset-cause capture not found in F413 Core, proposed not implemented. C21 relocation/optional short-wire100nF patch and pad-to-buzzer insulation noted; no physical clearance check. No live probe/reset/UART/motor/fan/flash/NVM, no source/CAD change. |
| 20260915-054005 | 20260915-mini-r3-assembly-recurrence-prevention | 劣化ペーストと隠れた実装不良によるU2二次損傷仮説、次基板の予防策を整理 | aba28d5-dirty (last observed) | no | User sees no U2-area defect under magnification; dense SMT makes rework impractical; apparently degraded paste and other repaired solder defects motivate assembling another board. Read-only CAD confirms U2 pin9 GND, C6 100nF/C7 10uF local bypass. MPS/Indium/TI primary sources support assembly-process risk and transient mechanisms, not a proven cause on this board. Hypotheses: GND/reference fault, hidden bridge or lost bypass leading to secondary U2 damage; simple output/EN open or thermal contact alone does not explain valid-sleep heating, EN has internal pull-down. Recommend fresh paste/new ICs, controlled deposition and paste-specific thermal profile, power/GND/bypass joint inspection, cold checks then unloaded idle-current/temperature baseline before bounded open-loop tests. No fixed-body gyro turn/high duty/3S qualification; SR0ohm allowed but switching surge margin unmeasured. Further bulk/clamp/slew changes need separate review. No live probe/reset/UART/motor/fan/build/flash/NVM or source/CAD change, no physical rework; existing damaged board remains out of powered testing. |
| 20260912-082141 | 20260912-mini-r3-u2-u3-cold-comparison | U2/U3出力測定比較、接続確認後のU2実装確認・交換を提案 | aba28d5-dirty (last observed) | no | User explicitly confirms left motor disconnected; requested right TP1/TP2 black-to-GND then reversed readings0.420/0.344V and0.422/0.345V, versus left0.507/0.317V and0.506/0.317V. Tens-of-mV differences are not a specified defect threshold; no near-zero hard-short indication and no normal-operation clearance. Idle U2 heating plus no rotation remain key. Local CAD confirms shared U2/U3 VIN pin2, GND pin9, EN pins4/14 nets. Recommend unpowered direct-terminal continuity and bridge/contact inspection if accessible, then U2 removal/underside-pad inspection/new-part replacement if no connection defect found. No automatic attribution to R35/PWM/motor change and no powered retest/reset/UART/flash/NVM/firmware or hardware modification performed. |
| 20260912 | 20260912-mini-r3-u2-cold-diode-readings | U2出力のダイオード測定値を記録、正常右側との比較待ち | aba28d5-dirty (last observed) | no | User measurements black lead GND then reversed: TP3 0.507/0.317V, TP4 0.506/0.317V. No near-zero hard-short indication, not proof of normal U2 or explanation of idle heating. Motor-lead isolation not explicitly confirmed; windings may couple outputs and shared rails/body diodes affect in-circuit measurements. Requested matched unpowered TP1/TP2 right-side comparison and isolation confirmation. No live hardware access/reset/flash/UART/motor/fan/NVM operation; powered testing remains suspended. |
| 20260912-080537 | 20260912-mini-r3-u2-idle-heating | 左ドライバU2の停止時発熱報告を受け通電試験を中止 | aba28d5-dirty (last observed) | no | User reports mechanics appear OK, U2 heats on power-up without drive, bench8V input about0.23A, prior healthy idle current unknown. Requested disconnecting supply and debugger/cooling; not yet confirmed. No live probe/reset/UART/flash/motor/fan/NVM action after report. MPS MP6551 Rev1.0 pp4/10 confirms both ENlow sleep/internal circuitry off; sleep10.5uA typ, awake no-load2.5mA typ at4V25C. Whole-board1.84W does not establish U2 dissipation or rule out local damage. Prior MCU STBYlow does not prove U2 pins4/14 or GND contact. Suspect internal damage/bridging/EN-GND assembly fault, with conducted heat not excluded; 0ohm SR is supported and does not itself explain idle heating. PowerOFF visual and isolated motor/output checks next; TP3/4 left, TP1/2 right verified from local CAD. No part replacement or firmware fix performed, original damage mechanism unproven. |
| 20260912-075723 | 20260912-mini-r3-left-motor-recheck | mini_r3左モータ両方向無動作を再現、ハード確認へ引継ぎ | aba28d5-dirty | no | User freshly reconfirmed lifted/secured bench8V/2A and later requested left-only visual repeat. Existing boot aba28d5 DIRTY1 t0.5, mini_r3unit001 profile0x30001 both forward IN2high enc1/-1, NVM guard LOCKED; no source/build/flash/NVM write. STLINK066CFF545771485067013914 UID00280047-31335117-34313932 VDD3.24V; UART /dev/cu.usbmodem211202 921600 log mini_r3_left_motor_recheck_20260912.log. Before reset backed up calibration and full2112-row trace with read-only vertical-bar,V; completed37-column seq0..2111 CSV. Old mode2case0sub1 large90 trace has left encoder always0 despite commands up to1000, right encoder-20..21/sample, nearly static gyro; no closed-loop turn rerun. Software reset mode0,p,w,6,p,8,7,9 then user-requested6,8,w,vertical-bar,p. Each single-wheel pulse12pct500ms plus disabled300ms coast; LF0/LR0/RF2421/RR-2146; LF/LR repeat both0, other wheel always0. User confirms left completely motionless and no visible current change. Pulse OK is completion only. No escalation/fan/manual-encoder/run. Static SWD GPIO AF/DIR, encoder enable and timer config match; drive helper/mapping/init unchanged since0906 pass. Two attempted mid-pulse reads caught only stopped outputs, so active PWM/waveform unverified. Hardware motor/lead/U2/R35 checks powerOFF next; no confirmed failed part or justified software fix. Existing offsetsFR82 FL66 R27 L43 preserved, sensor256B SHAef65dd1b727fee87a65d1ab159834bcf6ba640e77124df4011651d40bd773cde and distance SHA2682a96bfb5aaf9a7614c3f6dcbba9e82a3d8b19153fb9b4ceef1adc74f87c7f byte-identical, trace2112 unchanged. Final VBAT2103/allwall0/switchreleased, TIM2/TIM10 enables/compares0 DIR/STBYlow CFSR/HFSR0, mode0 UARTclosed. Current t0.5 presence supersedes previous pending-flash record; intervening flash/calibration not observed, new45mm physical LUT verification still pending. |
| 20260912-052334 | 20260912-mini-r3-shielded-wall-luts | 遮光テープ追加後の前壁・左右LUTをt0.5へ更新、実機反映はUART解放待ち | 3cc013e-dirty | yes | User remeasured after LED/phototransistor shielding. Used front columns2/3 FR/FL for9points40..80mm and their sum; R sweep column4 and L sweep column5 for12points23,30,35,...80mm each. Body-centre reference retained, front45mm2508/2494 sum5002, side45mmR640/L733. Curated dated CSVs and exact generated tables; old0906 CSVs historical, old front85..110mm removed rather than mixed with changed optics. Tune t0.5; PCHIP, front target45/too-close42.5, raw side control, gains/bases/thresholds/NVMschema/diagnostic-write guard unchanged. Both sides65..80mm low-signal-invalid under retained delta>300. No offsets inferred/subtracted/saved; asked whether corrected delta contract and post-shield offset recalibration were used. Host real-converter ASan/UBSan all knots, every integer ADC range/monotonicity, old-tail/out-of-range/no-wall/saturation/300gate and r2 isolation PASS; NVMwarp/guard tests, C generator equality, route freshness, F413/bothF405 builds, diff checks PASS. Source3cc013e; rebuilt RAM274120 Flash367068 ELF0276550f1facb8e5f963d6b02d7fe404de60f9aa0a836b88c16faa9a55f6221e BINc1252462d1a375c445e49f40201b07ed891a49785602e0d200ec1d60d3a4558c, diagnostic optionOFF. HIL not performed: listed UART /dev/cu.usbmodem211202 and read-only lsof/ps show user serial terminal PID84832 owns it; did not steal connection or kill process. No STLINK/reset/flash/UART command/NVM write/motor/fan/run. Requested terminal closure, acquisition-offset confirmation and front45mm setup for future prefix-backup/application-only-flash/nonmotor verification. Latest hardware offsets not known; do not restore pre-shield0906 values. |
| 20260906-090028 | 20260906-mini-r3-calibration-restore-guard | mini_r3校正68Bを完全復元し破壊的NVM診断を通常ビルドで禁止 | d5099d8-dirty | yes | User explicitly approved exact calibration recovery and diagnostic-write protection; motors/fan/runs not allowed or issued. Added default-OFF CMake NIGHTFALL_F413_DESTRUCTIVE_NVM_DIAGNOSTICS and lower-level guards for a/d/s/m/t and trace q/Q/r/k, no UART unlock; intentional OP calibration/normal maze saves/run logging unchanged. ASan/UBSan real diagnostic+NVM serializer tests prove all8 entry points preserve all mock NVM bytes while normal sensor save/load works; opt-in tested only in host memory. Machine/LUT, NVM warp, exhaustive PWM, route freshness, F413 and both F405 builds/diff checks PASS. Committed/pushed d5099d8. Free UART /dev/cu.usbmodem211202 921600, STLINK066CFF545771485067013914 VDD3.24V; pre reset, vertical-bar,w confirmed original dummy and trace16; SWD UID00280047-31335117-34313932. Temporary USER CODE boot block gated exact UID/valid board0x30000 unit1 profile0x30001/FRAM layout and full current68B dummy, then normal sensor save/readback restored FR708 FL681 R551 L570, bases0 gyro0 reserved0 checksum0x1D6. Only68B sensor write, FRAM erase no-op; no identity/distance/maze/trace write. Recovery ELF SHA02d3d569003492cef8128c7f3f7abc214b85525563e397e68438dae17656fc0b Flash368060; PASS logged. Removed temporary hook/includes completely, rebuilt/reflashed normal d5099d8 DIRTY1 t0.4 RAM274120 Flash367140, ELF SHAff4d100fd43a0528948a36f3b0f51eed97eca506742434cd8a08ec919e1a4dbb BIN SHAc022d94eb67b941cd924c63bb6fdd5413f72baec87b34a07cde84af456b6e68c. Both flashes application sectors0..6 verify/reset only, protected12..15 preserved. Verified final LOCKED boot and no recovery hook before sending a,d,s,m,t,q,Q,r,k separately; all9 refused. Vertical-bar before/after and after another reset: sensor256B SHA b1b8a0fdbd929eaa00983c23555e46ed66440018fbcfd1586c56fe1f6498376c exactly previous good, distance256B SHA2682a96bfb5aaf9a7614c3f6dcbba9e82a3d8b19153fb9b4ceef1adc74f87c7f unchanged, trace16 unchanged. Colon512samples1024ms meansFR10 FL14 R45 L76, min/max0..26/3..26/30..59/62..85 SD4.03/3.32/3.75/3.09; w allwall0 sat0 correctoffsets. No re-zero/LUT/threshold/control changes; sidebases fallback1941/1989 remain unqualified. Final SWD PWM/enables0 DIR/STBYlow CFSR/HFSR0; further reset retained calibration, p released, UART closed mode0. Human FR-only hand check requested but pending at handoff. Logs mini_r3_calibration_restore_pre_20260906.log, mini_r3_calibration_restore_20260906.log, mini_r3_calibration_guard_verified_20260906.log; ignored temporary patch and SHA recorded in commissioning doc. |
| 20260906-084111 | 20260906-mini-r3-offset-diagnosis | OP不安定の原因として校正領域の診断ダミー再混入を確認、変更せず報告 | d4ff9d6-dirty | no | User asked current offsets and provided approximately no-wall setup; diagnosis only. Opened free UART /dev/cu.usbmodem211202 921600, STLINK066CFF545771485067013914 software reset to safe mode0, boot d4ff9d6 DIRTY1 t0.4 profile0x30001. Commands vertical-bar,w,colon,colon,p only. Stored sensor fields exactly match diagnostic bases1111/1222/1333 offsetsFR220 FL230 R200 L210 imu1.25; existing wall-driver dummy guard rejects blob and defaults effective all offsets0. Two512-sample1024ms averages bothFR721 FL694 R597 L648, combined min/maxFR706..735 FL681..710 R585..608 L634..664 SD2.27..3.79. OP requiresFR>=150 AND FL<=250 for3polls40ms; uncoveredFL694 blocks entry. LUT unused in OP. Previous good offsetsFR708 FL681 R551 L570 and full68Bblob recoverable from mini_r3_side_centre_verified_20260906.log; sensor256B SHA changed b1b8a0fdbd929eaa00983c23555e46ed66440018fbcfd1586c56fe1f6498376c ->059f6a046b8a8b8dc1e9ebf89f108be2f1e1407ca3c586e287e75e7d7ddee760, exactly prior dummy; trace1212->16. Source confirms UART a/s saves this payload into real sensor area, but actual input/source/time unobserved and not attributed. No build/flash/source/params change, no NVM/calibration/maze/trace write, no motor/fan/run command; retained evidence and await direction for exact restore plus diagnostic-write guard, not approximate re-zero that shifts LUT origin. Final hotplug SWD TIM2/TIM10 enable/PWM0 DIR/STBYlow CFSR/HFSR0 VDD3.24V, switchreleased UARTclosed mode0. Log mini_r3_offset_diagnosis_20260906.log. |
| 20260906-075518 | 20260906-mini-r3-side-centre-lut | mini r3左右センサ12点を中心基準LUTへ反映、横壁制御は生値のまま維持 | d4ff9d6-dirty | yes | Used only column5 L from user's left sweep and column4 R from right sweep (distance,FR,FL,R,L); each12 points23,30,35,...80mm preserved exactly in curated side_centre_20260906.csv and separate generated side_distance_lut.c. PCHIP retained, no smoothing/subtraction/side-control integration. New r3 tune mini-r3-wall-centre-t0.4 flags front/side body_centre; front LUT/45mm target, r2/F405, thresholds/gains/side bases/NVM policy unchanged. Host ASan/UBSan tests PASS for all24side+15front knots, all in-range integerADC monotonicity, no-wall/range/saturation, 300/301gate and legacy r2; NVM tests, F413/bothF405 builds, generator equality and route freshness PASS. User closed occupied UART; pre vertical-bar backed up calibration prefixes. Committed/pushed d4ff9d6, built RAM274120 Flash366764; ELF SHA7645c3399b7e67ba9f61461aafb5d43726bf977f04df226f36ec7859e5a1fe8f BIN SHAfb1b4ebd9781415e769fd5bf6781c4c7a8828eb1734f379fd30d11cd2494b555. CubeProgrammer STLINK066CFF545771485067013914 NORMAL/SWrst wrote/verified application sectors0..6 only, reset captured UART /dev/cu.usbmodem211202 921600 mode0 identitymini_r3unit001 profile0x30001 d4ff9d6 DIRTY1 body_centre front+side side_control=adc_delta. Post commands colon,i,vertical-bar,p only; 512samples1025ms FR/FL/R/L0/0/173/29, R78.70mm in-LUT but low-signal-invalid, L102.90mm extrapolated invalid, valid0 extrap0x1D low0x1F sat0. No known fixture distance for this HIL; no independent physical accuracy claim. IMU0x6B/config74,71,44 PASS; switch released. Prefix256B sensor SHA b1b8a0fdbd929eaa00983c23555e46ed66440018fbcfd1586c56fe1f6498376c and distance SHA2682a96bfb5aaf9a7614c3f6dcbba9e82a3d8b19153fb9b4ceef1adc74f87c7f unchanged; offsetsFR708 FL681 R551 L570 preserved, trace1212 unchanged. No motor/fan/run or NVM/identity/calibration/maze/trace writes. Hotplug SWD VDD3.24V, TIM2/TIM10 enable/PWM0, DIR/STBYlow,CFSR/HFSR0; UART closed mode0. Logs mini_r3_side_centre_pre_20260906.log and mini_r3_side_centre_verified_20260906.log. Existing delta>300 rejects supplied L70..80/R65..80mm from distance-validity; retained deliberately until future distance-controller qualification. |
| 20260906-071045 | 20260906-mini-r3-front-centre-lut | mini r3前壁15点を機体中心基準に移行し45mm治具で確認 | b0a5a88-dirty | yes | Used only user-supplied corrected FR/FL means at40..110mm step5, retained all15 points and generated matching front-sum LUT; no-wall0/0 and front-jig R/L columns excluded. r3 tune mini-r3-front-centre-t0.3 marks body-centre reference, target45/too-close42.5mm; r2 legacy7/4.5mm, side tables/bases, thresholds and F405 unchanged. Reference-less v1 NVM warps skipped/cleared in RAM only for centre profiles, including diagnostic load; genuine r2 legacy calibration preserved. Curated fixture/provenance under params/mini_r3_0/calibration. ASan/UBSan real LUT/range/monotonic/saturation/profile and NVM no-write tests PASS, F413/bothF405 builds PASS, 524288PWM cases, route-table freshness and generator equality PASS. User closed measurement UART and set jig45mm; preflash commands p, vertical-bar read-only, colon found existing user-updated offsets FR708 FL681 R551 L570 and means2310/2375. Committed/pushed b0a5a88, rebuilt RAM274120 Flash366260, ELF SHA03ae228b692c95d63176aac28e5892701cd3100f02259360b151ab009c8e5c70 BIN SHA6520df472acd2a9c6b4cfa78425e0c22af159421cda2e565ec365ad06bad8767; direct CubeProgrammer STLINK066CFF545771485067013914 NORMAL/SWrst wrote/verified only application sectors0..6 and reset. UART /dev/cu.usbmodem211202 921600 captured b0a5a88 DIRTY1 profile0x30001 body_centre target45/42.5 mode0; postreset commands colon,i,colon,vertical-bar,w,p only. Two512-sample1024/1025ms blocks gave FR/FL/SUM45.00/45.04/45.02 and45.02/45.12/45.06mm, valid0x1F extrap/sat/low0, params0 expected. IMU0x6B/config74,71,44 PASS; final VBAT ADC2102 and released switch. No motor/fan permission exercised, no drive/run or NVM/calibration/maze/identity/trace write. Both256B calibration prefixes byte-identical; sensor SHA b1b8a0fdbd929eaa00983c23555e46ed66440018fbcfd1586c56fe1f6498376c, distance SHA2682a96bfb5aaf9a7614c3f6dcbba9e82a3d8b19153fb9b4ceef1adc74f87c7f; trace1212 unchanged. Hotplug SWD TIM2/TIM10 enable/PWM0, DIR/STBY low, CFSR/HFSR0,VDD3.24V; UART closed mode0. Logs mini_r3_front_centre_pre_20260906.log and mini_r3_front_centre_verified_20260906.log. 45mm repeat check is not full-range/physical sub-mm/floor-control qualification; held-out near/far points and lateral calibration remain next. |
| 20260906-051115 | 20260906-mini-r3-open-wall-offset | mini r3壁なし暫定オフセット保存で手かざし操作を復旧 | 40e96ea-dirty | yes | User removed walls in all directions and explicitly requested acquisition and provisional no-wall setup before distance-jig LUT calibration. No motor/fan/run permission was exercised; no firmware source, params profile, build or flash change. Reset existing GIT=40e96ea DIRTY=1, profile0x30001 mini-r3-bench-t0.2, machine mini_r3_0_unit001 to safe mode0 through ST-LINK066CFF545771485067013914; UART /dev/cu.usbmodem211202 921600. Before calibration w,:, : showed raw on-minus-off FR701/702 FL665 R562 L575 (two512-sample blocks, SD2.47..4.15), all false wall-present flags. Existing unchanged OP condition FR>=150 and FL<=250 was blocked by uncovered FL665. Announced and backed up both256-byte calibration prefixes with the vertical-bar read-only command, then selected OP mode9/case9 using spaced P x9,E,P x9,E, verifying final selection before execute; calibration is non-motor, 1500ms settle and10 samples x10ms. Saved no-wall offsets FR700 FL664 R563 L574 to sensor FRAM area only. Existing editor rejects the known dummy, initializes defaults, so dummy base1111/1222/1333 and imu_z1.25 became stored0/0/0 and0; effective side-base fallbacks remain1941/1989, no genuine centre or gyro calibration was overwritten. Post w,: yielded corrected means FR/FL/R/L2/2/1/1, maxima11/13/14/12, SD1.80/2.39/1.53/1.80, front/right/left detection0/0/0, saturation0; low/extrap flags at no-wall are expected and seed LUT not qualified. Readback sensor schema0x10001 length68 checksum0x1CD PASS; reset retained the same offsets and byte-identical after prefixes. OP thresholds were not lowered and r2/F405 are untouched. In mode0 asked user to cover onlyFR for1s and release2-3 times without pressing PUSH; UART observed exactly3 execute-mode0-idle events without UART E, and user confirmed sound/LED operation restored. Identity/distance/maze/trace were not written; distance-prefix SHA2682a96bfb5aaf9a7614c3f6dcbba9e82a3d8b19153fb9b4ceef1adc74f87c7f unchanged, trace status still1212 records. Sensor256B prefix SHA before059f6a046b8a8b8dc1e9ebf89f108be2f1e1407ca3c586e287e75e7d7ddee760 after00afa8d579a418414e21d1de763794428f19a982858c7f1569e7b2a5dd528695; full old68B dummy recoverable from backed-up prefix, not recommended for operation. Logs mini_r3_open_wall_20260906.log, mini_r3_open_wall_verified_20260906.log, boot f413_boot_20260906_140749/140954.log under tools/logging/logs. Final running hot-plug SWD VDD3.24V, TIM2 CCER/CCR1/CCR3=0 PSC0 ARR1000, TIM10 CCER/CCR1=0, DIR/STBY low, CFSR/HFSR0; UART closed in mode0. Recorded provisional calibration label mini-r3-open-wall-temp-20260906 in docs/MINI_R3_COMMISSIONING.md. Large background is setup-specific and unexplained; prior wall flags alone did not validate contrast. Recheck no-wall offsets in the final-height/light/surface jig before LUT/threshold/centre calibration or floor wall control. No further physical or NVM test is pending for temporary OP recovery; distance table remains a later user-assisted task. |
| 20260906-040144 | 20260906-mini-r3-fixed-commissioning | mini r3固定機体での準備・IMU搭載補正・校正由来確認・駆動再現性試験 | 40e96ea-dirty | yes | User confirmed identical r2/r3 external/drivetrain geometry, same IMU/encoders, IMU 2.5mm behind yaw centre, larger NFP-D0812 motors, suction and 2S/3S-capable hardware; explicitly lifted/secured and reconfirmed bench 8V/2A. KiCad U4 changed from F.Cu 0deg at (148.501098,105.003598) to 180deg at (148.501098,107.4); same pad1/pin mapping proves a relative yaw rotation. Commit a99db92 selects r3 forward accel -Y (r2 +Y), gyro +Z unchanged, and applies centreline rigid-body forward correction omega_rad_s^2 times -2.5mm before accel filtering. Uses user yaw-centre dimension, not CAD coordinate delta. Added per-board battery divider r2=3.2/r3=127/27 (CAD R4/R5 100k/27k), boot/CSV mounting metadata, IMU config readback, lifted-only bounded 7..9V sweep, readonly calibration-prefix dump, and host tests; profile mini-r3-bench-t0.2. No PID/FF/PWM/turn/fan-run tuning, 3S test, floor/maze/closed-loop turn, or CubeMX/CAD modification. Readonly calibration dump found exact historical distance and sensor NVM test fixtures; wall driver already ignores sensor fixture, but distance fixture caused negative warped distances. Commit 40e96ea rejects only the exact distance fixture without changing stored bytes or genuine r2 calibration; F405 branch unchanged. Initial a99db92 sweep aborted before motor enable due HAL encoder already running; 40e96ea preserves active counters. Host ASan/UBSan machine/measurement boot variants0/2/3, 524288 PWM cases, new no-write dummy/real/CRC/schema NVM tests, F413/both F405 builds, route-table freshness and diff checks PASS. ST-LINK 066CFF545771485067013914, F413 0x463 RevA, VDD3.24V, UID00280047-31335117-34313932; UART /dev/cu.usbmodem211202 921600. Verified app sectors0..6 only; final FW GIT=40e96ea DIRTY=1, RAM274120B Flash365628B, ELF SHA256 8d696117abe71dfa1136956e2d0f4058835526e458faafe691e6b014c52acf87, BIN e84a8e6c998504efcbd01c7b47a6695288f81929d3700e3cbfb00c092ab9c59c. Commands: old-build i,w,:,I,c,p plus unexecuted OP selection (rapid P attempts reached mode2, no E); backed up old222-record trace via binary dump before flash. Intermediate i, calibration-prefix dump, p, aborted sweep,w,c. Final-build i, calibration-prefix dump,:,p, three lifted sweeps,w,I, OP P x9/E/P x4/E fan mode9case4 (each selection verified),w,x,v x2, calibration-prefix dump; reset and binary dump, final i,w,p. Calibration-prefix dump UART is the vertical-bar command; sweep is left brace. Three sweeps passed all42 phases: 6/12/18 percent one-wheel forward/reverse plus12 percent both forward/reverse, each300ms drive/300ms disabled coast. Correct signs, unpowered wheel zero, monotonic count increase; 12 percent single-wheel means LF/RF/LR/RR=1283/1226/-1108/-1074.7 counts, both-forward1292.7/1227.3, both-reverse-1114.7/-1072.7; minimum nominal VBAT7.854V, no guard abort. IMU WHO0x6B/config74,71,44 PASS; static yaw bias0.17dps, 8s drift rounded-0.1deg. Wall512-sample deltas FR/FL/R/L718/691/596/621 with SD2.55/3.85/3.36/3.39; params0, distance MISS expected, unwarped=warped23.54/30.10/26.98mm, not physically calibrated. Fan20/50/80 percent each1.2s completed; CCR1=200 observed while active, final0, no physical tach/airflow/current/thermal claim. Idle x overwrote only backed-up trace area:1212 stored, overflow/dropped/clipped/nvm_error0, reset-persistent checksum-valid full binary seq0..1211, span1528ms (894 one-ms and317 two-ms intervals), all motor outputs0. This is idle-main-loop logging, not active1kHz control verification. First6s binary receive truncated52403B; 35s retry126184B succeeded. Old raw SHA732b021a5d256c4309af958e5fb6d4e3717462a8b44cd8536d67e8955bc8fe5c, new raw6498899cb53e6b711c4ba4ac006f5863e49031162bc6dc5269a631f8b8e0d33b. Both256B calibration prefixes byte-identical twice before/after; no identity/calibration/maze save or erase. Final mode0 idle, TIM2 CCER/CCR1/CCR3=0 PSC0 ARR1000, TIM10 CCER/CCR1=0, DIR/STBY low, CFSR/HFSR0, final wall VBAT2112 sat0 and switch released; UART closed. Logs mini_r3_fixed_precheck/bench/verified/final_20260906.log, mini_r3_before_fixed_20260906.raw/csv, mini_r3_fixed_idle_retry_20260906.raw/csv, boots f413_boot_20260906_125459/125954.log under tools/logging/logs. Detailed results and next fixture/floor gates in docs/MINI_R3_COMMISSIONING.md. User CAD/flashing/tooling dirt preserved; no real calibration or loaded performance claimed. |
| 20260905-172140 | 20260905-172140-f413-runtime-machine-identity | F413共通ファームの機種・個体別設定選択とmini r3 ID登録 | 49497cc-dirty | yes | Implemented the requested one-binary-per-MCU policy in `a3d2dcf`: validated NVM identity selects immutable board/unit hardware configuration and complete scalar/search/shortest/LUT profiles at boot. Registered mini r2 unit001 with original left wiring and mini r3 unit001 with the physically swapped left leads; preserved r2 values, copied independent untuned r3 seed values, and removed the temporary compile-time polarity override. Family is part of every board/unit/profile key, so classic and mini IDs cannot collide; synthetic classic profile selection is tested, but actual classic pin layout/parameters are not yet registered. Missing/corrupt/unknown/mismatched identity fails before board GPIO/control/motor/fan initialization; r3 requires an MCU-bound UID. Existing r2 zero UID is permitted for compatibility. Added capability gates, selected profile/polarity trace metadata, and refusal of r2-only KERI precomputed tables on r3. Existing F405 behavior and NVM/FRAM schemas remain unchanged; r3 tuning, actual r2 HIL, classic hardware support, normal F413 fan-run integration, and profile-specific KERI precomputation are not claimed complete. Added guarded empty-sector identity tooling/tests in `49497cc`, without modifying the user's pre-existing flash_stlink edits. Passed F413/F405 builds, ASan/UBSan machine/profile selection tests (including malformed ID, UID, board/unit/profile mismatches, unit overrides, classic geometry and LUT selection), exhaustive 524288 PWM polarity/duty cases, four identity-tool tests, Python compile checks, solver explore simulation, route generation freshness and 14210 route-precompute checks. HIL scope was explicitly non-motor only; no motor/fan/run/search/shortest command was issued. ST-LINK `066CFF545771485067013914`, F413 device 0x463, VDD 3.24V, MCU UID `00280047-31335117-34313932`, UART `/dev/cu.usbmodem211202` at 921600bps. Flashed verified application sectors 0--6 only, build `GIT=49497cc DIRTY=1`, RAM 274112B/320KiB, Flash 361916B. Flashed ELF SHA-256 `d194edcc33ad1a0c2b50a2aa2a85d896317e9bb0bcfc6c2f2cce95d4b8250aa1`, BIN SHA-256 `ca4b8d337ebe309ad02a342f8845bd191a45ad1ce15b0a47ac81ff7ceab5597e`. Empty-ID boot logged `[SAFE] machine=identity-invalid identity_status=3`, motor/fan timer registers remained zero, CFSR/HFSR=0 (`f413_boot_20260906_020255.log`). Per user intent to implement automatic identification and set up the connected r3, announced and performed `f413_identity.py provision-empty --sn 066CFF545771485067013914 --machine mini_r3_0 --unit-serial 1 --expected-uid 00280047-31335117-34313932 --backup-dir build/identity/mini_r3_0_unit001_20260906_0203 --allow-identity-write`. Backed up all 128KiB of sector15, verified every byte erased, rechecked UID, wrote only 68 identity bytes with `--skipErase`, and verified the full sector including unchanged remainder. No erase occurred. Backup sector SHA-256 `b5a41c3758763bbec72769fab4a2533bf2db0b6312d93d25a695f9e4b9e02260`; identity SHA-256 `ce86735d6b393faca8824bf939735afab5f792e195837b49579b5b75fd91fd57`; manifest and before/after images remain in that untracked backup directory. Registered family=1, board=0x00030000, rev=3.0, unit=1, default_profile=0, capabilities=0, with the UID above. Reset boot selected profile 0x00030001 / mini-r3-seed-t0.1, L/R forward IN2=1/1, enc=+1/-1, PSC=0, half-cell=45mm, fan capability=1, and mode0 idle (`f413_boot_20260906_020404.log`). Non-motor UART command sequence `i,w,K,+` completed: IMU WHO_AM_I=0x6B PASS; wall delta R/L/FR/FL=591/630/755/693, VBAT raw=2104, saturation=0 PASS; KERI requests rejected as intended with motors off and NVM read-only (`mini_r3_identity_nonmotor_20260906.log`). Reflashed the same application, verified identity unchanged with the inspect tool, and reset again to the same r3 selection (`f413_boot_20260906_021105.log`). Final hot-plug SWD reads confirmed TIM2 CCER/CCR1/CCR3=0, PSC=0/ARR=1000, TIM10 CCR1=0, left/right DIR and STBY low, CFSR/HFSR=0; UART closed. Log basenames are under `tools/logging/logs/`. No calibration/maze/trace format or FRAM data was written. Final linker safety follow-up reserves existing protected sectors12--15 by reducing app FLASH length to 1MiB, with an explicit CubeMX regeneration note; normalized that linker script to LF and removed copied r3 trailing whitespace. Rebuild and full-task diff checks PASS; the resulting application BIN remains byte-identical to the HIL-tested SHA above, so no further hardware flash was needed. |
| 20260905-161624 | 20260905-161624-mini-r3-left-motor-rewire-firmware | mini r3左モータ配線反転へFWを対応し左右前進の駆動条件を統一 | 313ebac-dirty | yes | user physically swapped only the left motor leads and requested the corresponding firmware change; retained the explicit lifted/secured motor permission, preceding 8V/2A supply condition, and R34/R35=0ohm hardware state. Added a HAL-independent F413 PWM command encoder shared by `f413_hw_motor_set`, normal `f413_ctrl_tick`, and single-motor diagnostic text so the current mini r3 default maps physical forward to IN2 high plus complementary PWM on both sides. Only left drive polarity changes; right polarity, logical output/trace signs, both encoder signs, 1000-count duty scale, zero-duty input-low behavior, clamp, GPIO/CCR write ordering, STBY/PWM start-stop paths, TIM2 PSC=0/ARR=1000 (about 99.9kHz), CubeMX/.ioc, params/gains, and F405 behavior are unchanged. The explicit compiler override `NIGHTFALL_F413_MOTOR_LEFT_FORWARD_IN2_HIGH=0` preserves original mini r2/unswapped mini r3 wiring; documented that the current default is for swapped-left mini r3 and is not automatic NVM identity selection. Host ASan/UBSan tests exhaustively passed 262144 side/direction/16-bit-duty cases for each default and legacy configuration (524288 total), including zero and saturation, using an independent original-mapping oracle; `Debug-stm32f413`, `Debug-stm32f405`, and diff checks passed. Source/tests commit `313ebac` was rebuilt to RAM 270224B/320KiB and Flash 343756B/1536KiB, ELF SHA-256 `01f2bf44922b7acf66b7b1578d154578e3fe096f323814d4ebc1f5553b39575b`; ELF load addresses were checked before flashing only application sectors 0--6 with `python3 tools/flashing/flash_stlink --image build/Debug/nightfall_stm32f413.elf --sn 066CFF545771485067013914`, verify/software reset PASS and protected NVM preserved. UART `/dev/cu.usbmodem211202` at 921600bps booted `GIT=313ebac DIRTY=1` through the 100MHz ADC-DMA/1kHz controller into mode0 idle; log `tools/logging/logs/mini_r3_left_motor_rewire_20260906.log`. After non-motor `i,w` PASS, executed `6,7,8,9` twice at duty120/1000 for 500ms plus 300ms disabled coast, with each completion checked before continuing. Signed L-fwd/R-fwd/L-rev/R-rev counts were +2322/+2260/-1978/-1959 and +2343/+2270/-2006/-1945, with the non-driven encoder always zero; both forward commands now produce positive counts and IN2 high/complementary PWM, both reverse commands negative counts and IN2 low/direct PWM. Mean forward counts 2332.5/2265 differ by about 3%, and mean reverse magnitudes 1992/1952 differ by about 2%, confirming the formerly strong opposite directions are now aligned to forward on both motors without changing PWM frequency. User visually confirmed all requested directions, final stop, and no abnormal noise/heat. Post-motion running hot-plug reads found VDD=3.24V, CFSR/HFSR=0, TIM2 CCER/CCR1/CCR3=0, left/right DIR and STBY low, and TIM10 CCR1=0; final `i,w` still passed (WHO_AM_I=0x6B, VBAT raw=2112), then UART was closed. Closed-loop output mapping is updated through the tested shared encoder, but HIL was bounded open-loop, fixed-machine only: no controller tune, simultaneous-drive, floor/maze, search/shortest, or fan test was run. No NVM/identity/calibration/maze/trace write, protected-sector write, or destructive erase was performed. |
| 20260905-154900 | 20260905-154900-mini-r3-sr-zero-ohm-retest | mini r3のR34/R35を0Ω化後に正逆駆動を再確認 | 8265908-dirty | no | user replaced both MP6551 SR resistors R34/right and R35/left with 0ohm after the frequency-dependence investigation and requested retesting; continued under the explicit lifted/secured motor permission and preceding 8V/2A bench-supply condition, announced the bounded sequence, and used ST-LINK SN `066CFF545771485067013914` plus UART `/dev/cu.usbmodem211202` at 921600bps, log `tools/logging/logs/mini_r3_motor_sr_zero_20260906.log`. No build, flash, firmware/parameter change, or CAD/BOM edit was made; reset the existing 100MHz application (GIT=8265908 DIRTY=1), verified IMU 0x6B and wall ADC completion (initial VBAT raw=2097), and confirmed TIM2 PSC=0/ARR=1000 and stopped outputs. At the original approximately 99.9kHz PWM, executed `6,7,8,9`, repeated `6,7,8,9`, then reversed the test order `9,8,7,6`, always 120/1000 duty for 500ms followed by automatic disable and 300ms coast, checking every completion before continuing. Signed counts in L-fwd/R-fwd/L-rev/R-rev order were +2001/+2263/-2305/-1945, +2029/+2282/-2333/-1972, and +2036/+2299/-2325/-1971; non-driven counts were always zero. Means were L-fwd 2022, R-fwd 2281.3, L-rev -2321, R-rev -1962.7. The former almost-stalled right-forward/left-reverse behavior is removed without any software change, localizing the large anomaly to the SR circuit/rework rather than direction arithmetic, but a smaller and reversed directional imbalance remains: left-reverse about 14.8% above left-forward, right-forward about 16.2% above right-reverse. With outputs confirmed disabled, temporarily wrote only TIM2 PSC=4 while halted and resumed, retaining ARR and duty, then ran `6,7,8,9` followed by `9,8,7,6` at approximately 19.98kHz. Counts were +2157/+2130/-2202/-2108 and +2161/+2141/-2203/-2100, with all non-driven counts zero; average same-motor directional differences fell to about 2.0% left and 1.5% right, showing that the smaller residual also depends on PWM frequency. User visually confirmed all four directions rotated and finally stopped and reported no concerning behavior after being asked about noise, heat, and current-limit operation. Original removed resistance and SR solder integrity were not measured, so this does not distinguish a correctly fitted but unsuitable 220k design value from wrong-value/contact issues. No physical waveform, higher-duty/load, simultaneous-drive, closed-loop, or EMI qualification was performed. Final software reset restored original approximately 100kHz PSC=0 and mode0 idle; final `i,w` passed (WHO_AM_I=0x6B, VBAT raw=2107), and running hot-plug reads found VDD=3.24V, CFSR/HFSR=0, TIM2 CCER/CCR1/CCR3=0, motor DIR/STBY low, and TIM10 CCR1=0; closed UART. No fan command, run/search/shortest session, NVM/identity/calibration/maze/trace mutation, protected-sector operation, or destructive erase occurred; 20kHz is a measured candidate for a subsequent permanent PWM change, not yet adopted or floor-qualified. |
| 20260905-150250 | 20260905-150250-mini-r3-motor-pwm-asymmetry-isolation | mini r3正逆出力偏りのPWM周波数依存を確認しSR抵抗の実装確認へ | 8265908-dirty | no | user explicitly authorized further motor tests with the robot still lifted/secured; retained the preceding 8V/2A bench-supply condition and existing 100MHz application (GIT=8265908 DIRTY=1), ST-LINK SN `066CFF545771485067013914`, UART `/dev/cu.usbmodem211202` at 921600bps, log `tools/logging/logs/mini_r3_motor_asymmetry_20260905.log`; no build/flash or permanent source change was needed. Audited both open-loop `f413_hw_motor_set` and closed-loop output mapping, TIM2 PWM1/active-high configuration, ADC pin ownership, and mini r3 schematic/PCB: weak left-reverse and right-forward both use IN2/DIR high with complementary IN1/PWM, U2 is left with R35 and U3 is right with R34, both SR resistors are specified as 220k to GND2, and PWM/DIR connect directly to MCU pins without an external input RC filter. With motors stopped, temporarily changed only TIM2 PSC through SWD, retaining ARR=1000, 120/1000 duty, 500ms drive plus 300ms disabled coast, and UART `6,7,8,9` in that order. Signed driven-encoder counts at nominal 20kHz (PSC=4) were +2802/+1495/-1770/-2715; at 5kHz (PSC=19), +2326/+1918/-2030/-2235; at 1kHz (PSC=99), +2159/+2032/-2082/-2086. Actual frequencies are 100MHz/((PSC+1)*1001). The non-driven encoder was zero except +2 left counts during the 1kHz right-reverse test. Restored PSC=0 (about 100kHz) and changed only PA5/PB10 OSPEEDR fields from low to very-high speed, preserving other pins; counts +5527/+416/-484/-5376 reproduced the earlier severe asymmetry, excluding the low-speed GPIO setting as an effective remedy. One further `7` returned +413 while running hot-plug, non-halting reads confirmed PSC=0, ARR=1000, CCR3=880, CCR1=0, CCMR1/2=0x68, CCER=0x101, GPIOB ODR=0x1006 (right DIR and STBY high), and push-pull configuration. ARR versus duty-scale has only a one-tick complementary difference and cannot explain the observed magnitude. The directional count ratio improves from roughly 8% at 100kHz to 86--87% at 5kHz and 96--97% at 1kHz, strongly localizing the symptom to frequency-dependent electrical switching behavior rather than solely mechanical friction or direction arithmetic, but physical IN/OUT waveforms remain unmeasured. MP6551 Rev.1.0 specifies SR-controlled rise/fall time proportional to resistance, approximately 100ns with SR grounded and 3us at 3Mohm; therefore wrong/high/open R34/R35, SR solder/connectivity, or driver behavior under this loading are the next checks, not a confirmed resistor fault. User believes 220k was fitted but cannot exclude a mix-up; request powered-off measurements of R34/right and R35/left, allowing for in-circuit semiconductor paths and isolated measurement if ambiguous. Lower-frequency software operation mitigates the symptom but was not adopted permanently before checking hardware integrity. An initial write/verify attempt on self-clearing TIM2 EGR failed and left the core halted; no completion was received for queued UART tests, so software reset cleared the pending commands before resuming and the PSC-only sequences above were then run with completion checks. Final software reset restored PSC=0 and original GPIO speed, booted mode0 idle, and read-only `i,w` passed (WHO_AM_I=0x6B, VBAT raw=2109); final hot-plug reads found CFSR/HFSR=0, TIM2 CCER/CCR1/CCR3=0, motor DIR/STBY low, TIM10 CCR1=0, VDD=3.24V, and UART was closed. No fan test, closed-loop/floor/maze run, NVM/identity/calibration/maze/trace write, protected-sector operation, or destructive erase occurred. |
| 20260829-083035 | 20260829-083035-f413-r45-entry-second-validation | 段階補正後R45-inを3走行で検証し安全余裕境界で確定 | n/a | no | verified recorder-0.5.8 session `manual-1787989153200-run0001..0003` as three mode2/case0/sub3 captures: runs1/3 had exact distinct START/STOP and 4125/4117 frames, while run2 had exact START but missed STOP and retained the complete motion in a 6277-frame/26.17s file; transferred about 536MB to Ubuntu worker `BD790`, processed runs1/3 directly and an 18s motion-only trim of run2 so the extra stopped tail could not corrupt temporal-background estimation, and recovered the 10mm blue centre on every analyzed frame with zero four-marker homography fallback; after the saved 10mm-label versus 2mm-marker height correction and per-run initial-straight pose normalization, measured diagonal-output perpendicular centre-line residuals `-4.678/-7.708/-6.956mm` (mean `-6.447mm`) versus the preceding mean `-7.523mm`, while output headings remained `45.231/45.015/45.030deg`; therefore confirmed that entry `8.5->5.5mm` plus exit `27.5->29.6mm` moved the line in the intended direction by about 1.08mm without introducing angular error, but did not fully centre it; searched alpha `10500..14000deg/s2`, entry `5.0..10.0mm`, and along-line-preserving exit candidates against the measured 70x39mm footprint with 1mm mechanical + 1mm position + 0.5deg heading uncertainty; every materially larger correction violated the required 3mm effective clearance, and the best passing alternative improved commanded normal position by only about 0.23mm at `3.07mm` effective margin, below observed run dispersion; retained firmware/parameters at `6cf2edf` rather than consume the remaining safety margin, returned Pixel to continuous optical standby at saved/acknowledged 416/416, and issued no build/flash/reset, motor, fan, run/search/shortest, identity/calibration/maze/trace-format/protected-NVM operation. |
| 20260829-073918 | 20260829-073918-f413-r45-entry-second-iteration | R45-in追試から機体幅余裕を保つ段階的入口補正 | 6cf2edf | yes | verified recorder-0.5.8 session `manual-1787985373246-run0001..0003` as three complete mode2/case0/sub3 captures with exact distinct optical START/STOP tokens, 4125/4132/4141 encoded frames at measured 240fps, zero Camera2 capture failures, and about 468MB of complete artifacts; transferred the runs to Ubuntu worker `BD790` and processed all roughly 12.4k frames in parallel with the saved 10mm-blue-label versus 2mm-marker-plane height correction, four fixed-marker registration with zero homography fallback, and per-run initial-straight pose normalization; recovered the blue centre in every frame and measured diagonal-output perpendicular centre-line residuals `-7.471/-7.941/-7.157mm` (mean `-7.523mm`) versus the preceding `-7.424/-7.401/-5.419mm`, so the prior alpha/offset edit did not improve physical lateral placement; output-line headings remained `45.126/45.155/45.642deg`, therefore retained alpha `11200deg/s2` and configured angle `44.6deg`, changed only R45-in entry `8.5->5.5mm` and exit `27.5->29.6mm` to move the output line outward while approximately preserving along-line endpoint timing; rejected the tempting entry-zero candidate because its measured 70x39mm footprint gate had only `2.008mm` raw clearance and negative effective margin; the applied candidate has simulated endpoint `(forward,lateral)=(88.170,46.504)mm`, raw/effective post clearance `5.897/3.297mm` after 1mm mechanical + 1mm position + 0.5deg heading uncertainty, no physical collision, and passes the required 3mm margin while remaining subject to repeated video qualification; regenerated the PC motion table at input SHA `8f589e5b...4ed7` and updated representative route timing by `-3.600ms`; passed 14210 precompute, 33464 route-preview, 837 profile-audit, 225 path-linear, 1195 route-motion, 53 clearance, F413/F405 Debug builds, Python compilation, and diff checks; committed/pushed `6cf2edf`, rebuilt F413 ELF SHA-256 `10ccc456...aaba`, flashed/verified/software-reset application sectors 0--6 only through ST-LINK `066CFF545771485067013914` at 3.24V, and confirmed firmware `6cf2edf-dirty`, IMU WHO_AM_I `0x6B` PASS, and wall measurement PASS in non-motor log `stm32_log_20260829_163902.csv`; returned Pixel to continuous optical standby at saved/acknowledged 413/413; Codex issued no motor, fan, run/search/shortest, identity/calibration/maze/trace-format/protected-NVM operation. |
| 20260829-063623 | 20260829-063623-f413-isolated-r45-retune | 分離sub3/sub5動画からmode2 R45-inのみを安全側へ再調整 | 55162ac | yes | verified recorder-0.5.8 session `manual-1787977430277-run0001..0006` as three mode2/case0/sub3 and three sub5 runs: all six had exact START, runs2--6 had exact STOP and zero Camera2 failures at about 239.98fps, while run1 missed STOP but retained the complete motion in 5221 frames; transferred about 994MB to Ubuntu worker `BD790` at about 112.6MB/s and applied the saved camera-centre/height correction for the 10mm blue label versus the 2mm marker plane; the three smooth sub3 trajectories measured R45-in output centre-line residuals `-7.419/-7.415/-5.412mm`, whereas sub5's wide blue tracker visibly switched to nearby running LEDs and produced jagged false positions, strict 6--10px tracking lost the blurred matte label, and relaxed red/blue pairs also selected illuminated hardware, so deliberately made no V90 parameter change from invalid image evidence; retrieved the matching latest binary trace read-only (3266 records, firmware `c131b06-dirty`) and confirmed healthy approximately `-45.8/+91.0deg` R45/V90 angle tracking, no motor saturation, and only a few millimetres of V90 translational shortfall, further disproving the false 16--22mm video residual; changed mode2 R45-in `alpha 12400->11200deg/s2`, entry `10.0->8.5mm`, and exit `29.0->27.5mm`, for a canonical PC endpoint `(forward,lateral)=(89.685,45.019)mm`, raw/effective footprint clearance `8.017/5.417mm`, and positive 3mm required margin; changed markerless prediction gating so explicitly narrow 240fps tracking radii are no longer expanded to a 20px LED-switching radius while retaining a 4px blur floor; regenerated the PC motion table at input SHA `e3da55be...a0b1`, synchronized the previously stale V90 host baseline with the already-active firmware values, and updated route timing by +1.866ms; passed F413/F405 Debug builds, 14210 precompute, 33464 route-preview, 837 profile-audit, 225 path-linear, 1195 route-motion, 53 clearance, and 36 remote vision checks plus Python compilation/diff checks; committed/pushed `55162ac`, rebuilt F413 ELF SHA-256 `0024dadb...e6`, flashed/verified/software-reset application sectors 0--6 only through ST-LINK `066CFF545771485067013914` at 3.24V, and confirmed firmware `55162ac-dirty`, IMU WHO_AM_I `0x6B` PASS, and wall measurement PASS in non-motor log `stm32_log_20260829_153550.csv`; returned Pixel to continuous optical standby at saved/acknowledged 410/410; Codex issued no motor, fan, run/search/shortest, identity/calibration/maze/trace-format/protected-NVM operation. |
| 20260829-042348 | 20260829-042348-f413-turn-velocity-lpf-case6-validation | 3ms旋回速度LPF版case6を3走行で検証 | n/a | no | verified recorder-0.5.8 session `manual-1787974974018-run0001..0003` as three complete mode2 case6 captures with exact optical START/STOP tokens, 4485--4501 frames, `239.98fps`, maximum encoded interval at most 4.534ms, and zero Camera2 result failures; transferred about 508MB to Ubuntu worker `BD790` and retained zero four-marker homography fallback; the matte 10mm blue label was glare-sensitive in runs1/3, so used the fully valid run2 blue-centre trajectory to calibrate motion-only foreground-centroid recovery for all three rather than accepting predicted missing-label positions; after the saved 10mm-label/2mm-marker height correction and per-run initial-line position/heading normalization, measured first-diagonal centre-line residuals `-6.19/-6.58/-6.80mm` and V90-output residuals `+18.30/+20.51/+20.73mm`, proving small repeat dispersion but material deterministic composite-path bias; retrieved the matching latest 1ms trace read-only as `trace_bin_20260829_case6_turn_encoder_lpf.{raw,csv}` (3563 records, raw SHA-256 `02e7518f...46e`, mode2/case6, firmware `c131b06-dirty`) and confirmed R45-in/V90/R45-out turn-core target/encoder travel `66.5/67`, `79.5/78`, and `75.5/76mm`; relative to the preceding 30ms-window trace, V90 recovered from 73mm to 78mm while the turn LPF reported about 487mm/s, although the current battery ADC was about 2440 versus 2192 previously and V90 translation PWM remained noisy at about 100.5 mean / 66.1 standard deviation; retained the 3ms encoder LPF and every turn parameter because the physical improvement and repeatability are real, while a direct composite-residual compensation candidate failed the measured 70x39mm footprint clearance gate (negative effective margin), so the residual must be separated with fresh isolated R45-in and V90 trials before a safe parameter edit; returned Pixel to continuous standby at saved/acknowledged 404/404; Codex issued no motor, fan, run/search/shortest, flash/reset, identity/calibration/maze/trace-format/protected-NVM operation. |
| 20260829-034307 | 20260829-034307-f413-turn-velocity-lpf-feedback | case6追試から旋回速度フィードバックの30ms遅延を除去 | c131b06 | yes | verified recorder-0.5.8 runs `manual-1787971432354-run0001..0003` as three complete mode2 case6 captures with exact optical START/STOP, 4493--4541 frames, about 239.84fps, and zero Camera2 result failures; transferred about 509MB to Ubuntu worker `BD790`; corrected the analysis invocation from the erroneous 8mm/8mm label assumption to the measured 10mm blue centre label and disabled the 2mm red heading label for position tracking, retaining runs0002/0003 while excluding run0001 from trajectory tuning because glare hid the blue label for 624/4509 frames; the two usable height-corrected/start-normalized trajectories showed R45-in line residuals about `-9.3/-12.2mm`, V90-output residuals about `+48.9/+29.5mm`, and final lateral residuals about `+2.8/+12.0mm`, so the preceding 30ms-window feedback neither improved the V90 nor its repeatability; retrieved the exact latest 1ms trace read-only as `trace_bin_20260829_case6_turn_encoder_feedback.{raw,csv}` (3535 records, raw SHA-256 `7afebd23...7f42`, firmware `b01d0fc-dirty`) and confirmed R45-in/core/out travel `67/73/75mm` against `66.5/79.0/75.5mm`; the V90 used the intended encoder-window control estimate (`471.6mm/s`) instead of the accelerometer estimate (`485.4mm/s`) and raised translation PWM mean `109.3 -> 116.8`, but still traveled the same 73mm and retained about 51PWM standard deviation, demonstrating that the roughly 15ms group delay of the 30ms window replaced one bias with a delayed feedback loop; retained all turn parameters and `D_TIRE`, changed turn-only velocity feedback to the existing independent 3ms wheel-encoder LPF, retained the 30ms accelerometer estimator for logging/straight control, and added trace metadata `velocity_turn_control_source=encoder_lpf`; F413/F405 Debug builds, 225 path-linear checks and `git diff --check` passed; committed/pushed `c131b06`, rebuilt F413 ELF SHA-256 `8553a4d9...62d8`, flashed/verified/software-reset application sectors 0--6 only through ST-LINK `066CFF545771485067013914` at 3.24V, and confirmed firmware `c131b06-dirty`, the new source metadata, IMU WHO_AM_I `0x6B` PASS, and wall measurement PASS in non-motor log `stm32_log_20260829_124227.csv`; returned Pixel to continuous optical standby at saved/acknowledged 401/401; Codex issued no motor, fan, run/search/shortest, identity/calibration/maze/trace-format/protected-NVM operation. |
| 20260829-024500 | 20260829-024500-f413-turn-encoder-velocity-feedback | case6動画・1msログから旋回中の加速度速度推定混入を除去 | b01d0fc | yes | verified recorder-0.5.8 runs `manual-1787968818484-run0001..0003` as three complete 1920x1080 captures of mode2 case6 at `239.842--239.845fps`, with exact distinct optical START/STOP tokens and 4485/4517/4493 encoded frames; transferred about 508MB to Ubuntu worker `BD790` at about 116MB/s and processed all three in parallel, recovering the blue centre on 4480/4485, 4513/4517, and 4493/4493 frames with zero four-marker fallback; after the saved 10mm-label/2mm-marker height correction and per-run initial-pose normalization, measured median intended-line residuals `+0.17mm` initial, `-7.20mm` after R45-in, `+23.17mm` after V90, and `+6.17mm` final, with the V90 output still unsuitable for parameter retuning; retrieved the exact latest 1ms trace read-only as `trace_bin_20260829_case6_constant_velocity_full.{raw,csv}` (3577 records, raw SHA-256 `bb365a7c...377`, firmware `15be07c-dirty`) and confirmed every turn core now held the nominal target strictly at `500mm/s`; the R45-in and R45-out encoder regressions were about `510/498mm/s`, but the 159ms V90 core advanced only `73mm` (about `454mm/s`) while the accelerometer-compensated control estimate averaged `479mm/s`, forward acceleration averaged `+1093mm/s2`, and translation PWM oscillated from about 31 to 194 as lateral acceleration entered the forward estimator; retained every turn parameter and `D_TIRE`, added `VELOCITY_ACCEL_COMP_ENABLE_DURING_OMEGA_PROFILE=0`, kept the compensated estimate logged, and selected the existing 30ms windowed encoder velocity only while an omega profile is active; F413/F405 Debug builds, 225 path-linear checks and `git diff --check` passed; committed/pushed `b01d0fc`, rebuilt F413 ELF SHA-256 `1df3c242...8e3`, flashed/verified/software-reset application sectors 0--6 only through ST-LINK `066CFF545771485067013914` at 3.24V, and confirmed firmware `b01d0fc-dirty`, metadata `velocity_accel_comp_turn_control=0`, IMU WHO_AM_I `0x6B` PASS, and wall measurement PASS in non-motor log `stm32_log_20260829_114337.csv`; returned Pixel to continuous optical standby at saved/acknowledged 398/398; Codex issued no motor, fan, run/search/shortest, identity/calibration/maze/trace-format/protected-NVM operation. |
| 20260829-015752 | 20260829-015752-f413-turn-core-distance-feedback-revert | case6追試からターンコア距離外側ループを撤回 | 15be07c | yes | verified recorder-0.5.8 runs `manual-1787966296891-run0001..0003` as three complete 1080p240 mode2 case6 captures at about 239.845fps with exact optical START/STOP and all four board markers in every frame; processed the videos on Ubuntu worker `BD790`, recovered the blue centre on all frames in runs1/2 and `4482/4485` frames in run3 using a stricter 60px/colour-tolerance-4 reacquisition, and applied the saved 10mm-label/2mm-marker plane correction plus per-run initial-pose normalization; measured median intended-line residuals `-0.26mm` initial, `-3.77mm` after R45-in, `+12.17mm` after V90, and `+1.59mm` final, so the final lateral closure hid an unacceptable intermediate shift; retrieved the matching latest 1ms trace read-only as `trace_bin_20260829_case6_retry.{raw,csv}` (3576 records, raw SHA-256 `f87aa5fb...553`, mode2/case6, firmware `4aed7cf-dirty`) and found that the new turn-core distance outer loop did not recover V90 travel (`79.0mm` target versus `76mm` encoder, essentially the same 3.5mm deficit as before) while moving the nominal 500mm/s target through `487..524mm/s` and measured velocity through `379..607mm/s`; retained all calibrated turn parameters and the corrected `D_TIRE=14.13mm`, removed `f413_ctrl_set_velocity_tracking()`, and restored one constant `f413_ctrl_set_velocity()` command per timed turn core without the old redundant per-millisecond calls; F413/F405 Debug builds, 225 path-linear checks, and `git diff --check` passed; committed/pushed `15be07c`, rebuilt F413 ELF SHA-256 `72b8cb0f...8a05`, flashed/verified/software-reset application sectors 0--6 only through ST-LINK `066CFF545771485067013914` at 3.24V, and confirmed firmware `15be07c-dirty`, IMU WHO_AM_I `0x6B` PASS, wall measurement PASS, and zero motor outputs in non-motor smoke log `stm32_log_20260829_105918.csv`; no motor, fan, run/search/shortest, calibration/maze/trace-format/protected-NVM operation was issued by Codex. |
| 20260823-073204 | 20260823-073204-f413-turn-core-distance-tracking | case6動画・1msログからターンコアの距離追従欠落を修正 | 4aed7cf | yes | verified recorder-0.5.8 runs `manual-1787466920282-run0001..0003` as three complete 1080p240 post-`D_TIRE=14.13mm` mode2 case6 captures, transferred about 508MB to Ubuntu worker `BD790`, and recovered both labels on every `4509/4485/4477` frame with zero four-marker fallback; after 10mm/2mm label-plane correction and removal of each roughly one-degree initial placement heading, measured final local poses `3.46/641.85`, `5.43/640.57`, and `4.46/639.65mm` right/forward against runner model `-0.18/639.46mm`, with median line-normal residual about `-1.50mm` after R45-in, `+8.32mm` after V90, and final lateral `+4.70mm`; retrieved the exact latest 1ms trace read-only as `trace_bin_20260823_160940.csv` (3588 records, mode2/case6, raw SHA-256 `d13ceaea...da16`) and found healthy angle tracking/no saturation but a deterministic translational control defect: the V90 timed core advanced target distance `77.5mm` while encoder/physical motion advanced only `74mm`, real velocity averaged `488.15mm/s` for the 500mm/s contract, and motor peak was only 416; root cause was `f413_path_run_wait_smooth_turn_profile()` calling `f413_ctrl_set_velocity()` before and during the core, which disables and repeatedly re-synchronises the distance outer loop, making load-induced under-travel impossible to recover; added `f413_ctrl_set_velocity_tracking()` to preserve the constant-rate distance reference and outer feedback through timed turn cores, removed the per-millisecond disabling call, retained all turn parameters and diagonal-distance constants, regenerated the PC table at input SHA `1fb6b770...10a0`, and passed 14210 precompute, 225 runner-linear, 33464 route-preview/production-runner integration, 1195 route-motion, F413/F405 Debug builds and diff checks; committed/pushed `4aed7cf`, rebuilt the intentionally dirty F413 application at RAM `270224B/320KiB` (82.47%) and Flash `343436B/1536KiB` (21.84%), ELF SHA-256 `63be0f46...7b1`, flashed/verified/software-reset only application sectors 0--6 through ST-LINK `066CFF545771485067013914` at 3.24V, confirmed non-motor UART IMU WHO_AM_I `0x6B` PASS in `f413_postflash_20260823_turn_distance_tracking.log`, and returned Pixel to continuous optical standby; Codex issued no motor, fan, run/search/shortest, identity/calibration/maze/trace-format/protected-NVM operation. |
| 20260823-063525 | 20260823-063525-f413-straight-distance-scale-validation | 修正後sub8の3走行でF413距離換算を再検証 | n/a | no | verified recorder-0.5.8 runs `manual-1787463620258-run0001..0003` as three complete 1080p240 mode2 case0 sub8 captures, transferred about 454MB over wired USB/Mac storage and processed the videos in parallel on Ubuntu worker `BD790`; recovered the blue centre and red front labels on every `4029/3997/4021` frame with zero four-marker fallback, recovered a stable camera centre near `(395.12,465.17,1067.58)mm`, and corrected the blue label from its 10mm plane to the 2mm ArUco reference plane; corrected stopped displacements were `460.23/456.56/458.84mm` (median `458.84mm`) versus `451.84/449.26/448.88mm` before the `D_TIRE` change, with the remaining `7.0--9.5mm` lateral displacement corresponding to about a one-degree initial placement heading rather than distance scale; retrieved the matching latest 1ms trace read-only as `trace_bin_20260823_152829.csv` (2744 records, mode2/case0/sub8), confirmed target maximum `460.444mm`, encoder maximum `464mm`, final target/encoder `460.444/460mm`, final angle `+0.347deg`, and no motor saturation; time-aligned run0003 to that trace and regressed 194 moving samples, obtaining physical/encoder scale `1.001813` with `0.466mm` RMSE, so retained `D_TIRE=14.13mm` and made no turn or source change; Pixel recorder was returned to continuous optical standby for the next three mode2 case6 open-floor runs; Codex issued no motor, fan, run/search/shortest, flash/reset, identity/calibration/maze/trace-format/protected-NVM operation. |
| 20260823-053815 | 20260823-053815-f413-straight-distance-scale | sub8直進動画と1msログからF413距離換算を再校正 | c974b75 | yes | verified recorder-0.5.8 runs `manual-1787462453976-run0001..0003` as three complete 1080p240 mode2 case0 sub8 captures, transferred about 485MB including analysis tools to Ubuntu worker `BD790`, processed all three videos in parallel, and recovered both blue-centre and red-front labels on every `4005/4013/4013` frame with zero four-marker fallback; used the saved Pixel camera intrinsics and all sixteen ArUco corners to recover a stable camera centre near `(392.85,466.81,1070.88)mm` with about 0.94--1.21px reprojection RMSE, then corrected the blue label from its 10mm plane to the 2mm ArUco reference plane; corrected stopped displacements were `451.84/449.26/448.88mm` for the nominal 460mm straight, while the last run rolled back about 4mm after braking, so did not calibrate from the stopped endpoint alone; retrieved the matching last 1ms trace read-only as `trace_bin_20260823_143515.csv` (2748 records, mode2/case0/sub8, raw SHA-256 `1be8e01f...ce4`), confirmed target maximum `460.552mm`, encoder maximum `465mm`, final target/encoder about `459.255/464mm`, final angle `-0.152deg`, motor peak 185 and no turn; time-aligned the height-corrected video to the trace and regressed 215 moving samples against encoder distance, obtaining physical/encoder scale `0.981663` with `0.637mm` RMSE, therefore changed `D_TIRE 14.39 -> 14.13mm` while retaining every turn-specific parameter; regenerated the PC route table at input SHA `f942f2c8...19d8` and passed 14210 precompute, 225 runner-linear, 33464 saved-route/production-runner integration, 1195 route-motion, F413/F405 Debug builds, and diff checks; committed/pushed `c974b75`, rebuilt the intentionally dirty F413 application at RAM `270224B/320KiB` (82.47%) and Flash `343356B/1536KiB` (21.83%), ELF SHA-256 `2398b6c6...24ef`, flashed/verified/software-reset only application sectors 0--6 through ST-LINK `066CFF545771485067013914` at 3.24V, and recorded non-motor UART IMU WHO_AM_I `0x6B` PASS in `tools/logging/logs/f413_postflash_20260823_distance_scale.log`; Codex issued no motor, fan, run/search/shortest, identity/calibration/maze/trace-format/protected-NVM operation. |
| 20260823-050135 | 20260823-050135-mode2-case6-open-floor-video-validation | 後端壁当てcase6複合斜め軌跡を3走行で検証 | n/a | no | excluded user-designated collision run `manual-1787459096705-run0001` and verified runs0002--0004 as three complete recorder-0.5.8 captures with exact optical START/STOP votes, 4469/4493/4493 encoded samples at 239.98fps, maximum PTS intervals 4.667/4.522/4.644ms, and zero Camera2 failures; transferred about 507MB at about 113MB/s to Ubuntu worker `BD790`, extracted all frames in parallel with four-marker registration, recovered both blue-centre and red-front labels on every frame, and used no homography fallback; absolute 90mm-grid fits had p95 residual only 0.13--0.30mm but showed median centre-line errors `-3.40mm` on the initial orthogonal, `-4.95mm` on the first diagonal `x-y=-90`, `-4.09mm` on the second diagonal `x+y=540`, and `-6.30mm` on the final orthogonal `x=90`, with median stopped board pose about `(82.95,624.23)mm`; the rear-wall placement itself was repeatable within about 0.3mm, but its moving initial line was consistently `0.92--1.02deg` left of board +y, so absolute and turn-chain errors partly cancel; after removing that initial pose/heading, the measured segment headings were `+45.77/-45.17/+0.18deg`, the final local pose was median `(5.42,634.75)mm` versus the current runner-model `(-0.18,639.46)mm`, and the first/V90/final line-normal residuals versus the model were about `+1.76/+5.20/+5.10mm`, identifying a repeatable approximately `+5.6mm` lateral and `-4.7mm` longitudinal composite residual with the V90 transition as the largest incremental contributor; corrected the prior worklog's manually stated 92.31mm sweep estimate: direct composition of the current runner turn models gives maximum local right displacement `121.705mm`, consistent in scale with the measured `125.43--126.44mm`; retained all turn parameters pending one clean matching 1ms trace because repeated read-only UART full-log attempts lost/corrupted the frame header/column stream, and changing offsets without separating gyro overshoot, physical slip, and distance scale would hide the cause; no source/parameter/table/build/flash/reset, motor, fan, Codex-triggered run/search/shortest, identity/calibration/maze/trace-format/protected-NVM operation was issued. |
| 20260823-043512 | 20260823-043512-f413-rear-wall-first-section | 後端壁当て始動に合わせてF413 first_sectionを10mm化 | 7c9f304 | yes | defined the F413 rear overhang as `35.0mm` from the user-confirmed centred 70mm body and derived `DIST_FIRST_SEC=45-35=10.0mm`, so a rear-wall-contact start moves the machine centre from 35mm to the first 45mm cell centre before executing either the fixed open-floor case6 path or a normal shortest/search path; factored the existing initial motion into the named `f413_path_run_first_section()` step with run telemetry, removed the route-preview hardcoded 5mm assumption, regenerated the case6--9 PC motion table at input SHA `b3d8e68a...1eb8`, synchronized host timing/geometry baselines, and added first-section geometry/profile regressions; passed 14210 precompute checks, 225 runner-linear checks, 33464 route-preview/production-runner integration checks, 209 slalom-time checks, 27 mode2-dispatch checks, F413/F405 Debug builds, and diff checks; committed `7c9f304`, rebuilt F413 at RAM `270224B/320KiB` (82.47%) and Flash `343356B/1536KiB` (21.83%), ELF SHA-256 `3b6c008838894ee8652ac4d42ba1728f8a05b03ecd53a3c010cb8a5c68cc64f3`, flashed/verified/software-reset only application sectors 0--6 through ST-LINK `066CFF545771485067013914` at 3.24V, and recorded non-motor UART IMU WHO_AM_I `0x6B` PASS in `tools/logging/logs/f413_postflash_20260823_first_section10.log`; Pixel recorder 0.5.8 remained continuously armed, and no motor, fan, Codex-triggered run/search/shortest, identity/calibration/maze/trace-format/protected-NVM operation was issued. |
| 20260823-042405 | 20260823-042405-mode2-case6-open-floor-diagonal | 壁・柱なし複合斜め軌跡を検証する固定case6を追加 | c2e34f5 | yes | temporarily replaced mode2 case6 saved-maze route generation with the deterministic legacy-code path `S3,R45-in,DS1,L-V90,DS1,R45-out,S2` (`203,701,1001,802,1001,703,202`), using the low case6 profile and no wall control, wall-end correction, or front-wall correction; retained canonical accumulated gyro-angle targets because those define the exact 45/90deg turn commands used during tuning rather than an environmental correction; host integration predicts a symmetric S trajectory with maximum right displacement about `92.31mm` and final pose about `x=-0.18mm, y=639.61mm, heading=0deg` including the implicit 5mm start and 45mm stop segments; added a feature-configurable fixed-path entry point, explicit OP UI label/feature telemetry, a 27-check mode2 dispatch regression proving case7 remains on the saved-maze KERI planner, and a production-runner preflight regression; passed 223 runner-linear checks, legacy validation, 33464 route-preview/runner integration checks, F413/F405 Debug builds, and diff checks; committed `c2e34f5`, rebuilt the intentionally dirty F413 application while preserving unrelated flashing/CAD changes at RAM `270224B/320KiB` (82.47%) and Flash `343204B/1536KiB` (21.82%), ELF SHA-256 `8cb83f35c7319c0b1dde901f173c36ced75dbb7c881b4ddb0c99bad69290717b`, flashed/verified/software-reset only application sectors 0--6 through ST-LINK `066CFF545771485067013914` at 3.24V, and recorded non-motor UART `i` IMU WHO_AM_I `0x6B` PASS in `tools/logging/logs/f413_postflash_20260823_open_floor_case6.log`; no motor, fan, Codex-triggered run/search/shortest, identity/calibration/maze/trace-format/protected-NVM operation was issued. |
| 20260823-040330 | 20260823-040330-mode2-v90-restored-validation | sub5復元設定の3走行検証とV90収束判定 | n/a | no | verified the three newest recorder-0.5.8 runs `manual-1787456631461-run0001..0003` as complete mode2 case0 sub5 captures with exact optical START `5/0/0` and STOP `0/5/0`, 4301--4317 encoded samples at 239.98fps, Camera2 failures `1/0/0`, and no material encoded gap; transferred about 454MB to Ubuntu worker `BD790`, recovered the blue centre on all frames in runs1/3, and reprocessed run2 with a wider seeded-label search after the default 82px tracker lost the label at 2.62s, recovering all 4301 frames with zero four-marker fallback and visually continuous trajectory; measured late diagonal exit-line errors `-2.051/-5.178/-4.165mm` against start-local `x_right+y_forward=455mm` (median `-4.165mm`, sample SD `1.595mm`, line-fit p95 residual `0.095/0.165/0.111mm`, output-line heading median `-44.335deg`) while the incoming diagonal coordinate varied only `1.898mm` peak-to-peak; this agrees with the immediately preceding post-FRAM-fix median `-3.987mm` and shows that changing between two simulator-closed V90 parameter triples repartitions the adjacent diagonal straights without materially translating the complete-path exit line; retained the already-flashed mode2 V90 `500mm/s,17500deg/s2,17.0/17.0mm`, whose diagnostic 70x39mm raw/effective clearance remains `7.717/3.618mm`, rather than deliberately breaking primitive closure and reducing safety margin to chase a roughly 4mm normalized-video residual that is comparable to the remaining unqualified blue-label-height/parallax systematic; two read-only attempts to retrieve the latest binary trace over UART received truncated frames and were discarded without changing the stored trace; no parameter/table/source/build/flash/reset, motor, fan, Codex-triggered run/search/shortest, identity/calibration/maze/trace-format/protected-NVM operation was issued. |
| 20260823-033859 | 20260823-033859-mode2-v90-postflush-retune | sub5再現性確認とFRAM待ち影響下のV90調整を訂正 | 09a1b5a | yes | paired the three newest recorder-0.5.8 runs `manual-1787454908307-run0001..0003` with one-millisecond traces `trace_bin_20260823_121717/121854/122057.csv`; all recordings had exact optical START `5/0/0` and STOP `0/5/0`, 4317--4325 encoded samples at 239.98fps, maximum PTS intervals `4.511/4.489/4.478ms`, and Camera2 failures `0/3/0`; transferred about 456MB to Ubuntu worker `BD790`, recovered blue-centre labels on `4324/4325`, `4315/4317`, and `4317/4317` frames with zero four-marker fallback, and measured late diagonal exit-line errors `-4.425/-3.987/-3.550mm` against the established start-local `x_right+y_forward=455mm` reference (median `-3.987mm`, sample SD `0.438mm`, line-fit p95 residual `0.097/0.194/0.143mm`); the traces were exact mode2/case0/sub5 and proved the motor-trace fix: every powered straight/turn offset now remained `0x9084`, the distance between R45-in and V90 cores was `111/110/111mm` instead of the preceding `110/120/120mm`, and no moving `0x9080` phase remained; V90 real angle deltas were `90.547/90.690/90.673deg` for 90deg target, omega RMSE `26.05/28.52/25.81deg/s`, motor peaks `274/285/303`, and no saturation; re-audited the earlier `17500deg/s2,17/17mm` evidence and found all three supposedly slip-displaced runs had actually traveled about 25mm during the nominal 17mm entry because the same synchronous FRAM wait was active, invalidating the prior slip diagnosis; restored mode2 V90 to `500mm/s,17500deg/s2,17.0/17.0mm`, whose nominal endpoint error is `0.073mm` and 70x39mm diagnostic raw/effective clearance is `7.717/3.618mm` with no physical collision, regenerated the PC route table at input SHA `345c4943...162`, and passed 14210 precompute, 222 runner-linear, 33464 saved-route/runner integration, 1195 route-motion, 29 clearance tests, F413/F405 Debug builds and diff checks; committed/pushed `09a1b5a`, built F413 at RAM `270224B/320KiB` (82.47%) and Flash `342724B/1536KiB` (21.79%), ELF SHA-256 `1ec265bf...96c3`, flashed/verified/software-reset only application sectors 0--6 via ST-LINK `066CFF545771485067013914` at 3.24V, and recorded non-motor UART `i` IMU WHO_AM_I `0x6B` PASS in `tools/logging/logs/f413_postflash_20260823_v90_restore_retry.log`; no motor, fan, Codex-triggered run/search/shortest, identity/calibration/maze/trace-format/protected-NVM operation was issued. |
| 20260823-025312 | 20260823-025312-mode2-v90-trace-flush-gap | sub5動画・1msログから斜めターン入口の走行中FRAM書込みを除去 | 6dd9c2d | yes | excluded the user-designated third of four newest Pixel recordings and paired retained runs `manual-1787451818487-run0001`, `run0002`, and `run0004` with one-millisecond traces `trace_bin_20260823_112524/112701/112947.csv`; all three recordings had complete optical START/STOP, recovered blue/red labels on every `4285/4277/4293` encoded frame with zero four-marker fallback, and measured late diagonal exit-line perpendicular errors `+1.305/+10.787/+7.273mm` against `x_right+y_forward=455mm` (median `+7.273mm`, sample SD `4.813mm`, line-fit p95 residual `0.106/0.203/0.161mm`), while the incoming diagonal line varied only `1.41mm` peak-to-peak; the traces were all exact mode2/case0/sub5 and showed healthy V90 angle tracking (`90.885/90.862/91.027deg` real for 90deg target, omega RMSE `31.99/34.99/32.81deg/s`, no motor saturation), but exposed that diagonal turn offsets used trace flags `0x9080` without any motor bit, so `f413_trace_log_auto_defer_nvm_flush()` resumed blocking FRAM writes even though the motors still drove at 500mm/s; the nominal 13.5mm V90 entry therefore occupied `22/38/37` trace records and physically traveled `13/25/24mm`, explaining the video displacement without changing the calibrated turn; changed all powered turn entry/exit offsets to carry `MOTOR_FWD` independently of wall-control enable, added a host regression for motor-flag replacement/preservation, regenerated the PC route table at input SHA `9e9a8c5d...b4cd`, and passed 222 runner-linear, 33464 saved-route/runner integration, 14210 precompute, 1195 route-motion, 53 route-clearance, F413/F405 Debug builds and diff checks; committed/pushed `6dd9c2d`, rebuilt the intentionally dirty F413 app at RAM `270224B/320KiB` (82.47%) and Flash `342724B/1536KiB` (21.79%), ELF SHA-256 `d92fb0fe...1bef`, flashed/verified/software-reset only application sectors 0--6 via ST-LINK `066CFF545771485067013914` at 3.24V, and recorded non-motor UART `i` IMU WHO_AM_I `0x6B` PASS in `tools/logging/logs/f413_postflash_20260823_turn_trace_defer.log`; retained V90 `500mm/s,15000deg/s2,13.5/13.5mm`, and issued no motor, fan, Codex-triggered run/search/shortest, identity/calibration/maze/trace-format/protected-NVM operation. |
| 20260823-021927 | 20260823-021927-mode2-v90-alpha15000-validation | sub5低横加速度版の動画検証と速度低下案の安全棄却 | n/a | no | verified recorder-0.5.8 runs `manual-1787450534406-run0001..0003` as three complete mode2 case0 sub5 captures with exact START `5/0/0` and STOP `0/5/0`, 4261--4293 encoded samples at 239.98fps, and maximum PTS interval at most 4.59ms; transferred about 452MB to Ubuntu worker `BD790`, recovered blue/red labels on every `4277/4293/4261` frame with zero four-marker homography fallback, and measured the same late-moving diagonal exit-line perpendicular errors `-4.380/+7.246/+0.184mm` against `x_right+y_forward=455mm` (median `+0.184mm`, sample SD `5.858mm`, line-fit p95 residual `0.092--0.156mm`); the incoming diagonal line varied only about `1.85mm` perpendicular peak-to-peak while the outgoing line varied `11.63mm`, so alpha 15000 centred the median but did not remove V90 translational variability; evaluated a dynamically similar 450mm/s,12150deg/s2,13.5/13.5mm V90 candidate, which reduced nominal peak omega/lateral demand to about `854deg/s`/`0.68g` while retaining diagnostic raw/effective clearance `7.361/3.261mm`, but the production saved-maze runner preflight correctly rejected case7 at a zero-connector 500mm/s turn-to-450mm/s V90 transition (`status=4`, legacy index2/code802); rejected rather than bypassed that physical speed-discontinuity gate, reverted all candidate/table/audit edits, and left the already-flashed mode2 V90 at `500mm/s,15000deg/s2,13.5/13.5mm`; attempted a read-only latest full trace dump after the runs, but the UART capture missed/corrupted the binary frame header, so no control-log conclusion was drawn from it; no commit-worthy parameter/table/firmware change, flash/reset, motor, fan, Codex-triggered run/search/shortest, identity/calibration/maze/trace-format/protected-NVM operation was issued. |
| 20260823-015809 | 20260823-015809-mode2-v90-slip-retune | sub5動画・1msログからV90横滑りを抑える再調整 | 68c6060 | yes | verified the three newest recorder-0.5.8 runs `manual-1787448846583-run0001..0003` as mode2 case0 sub5, transferred about 473MB to Ubuntu worker `BD790`, recovered blue/red labels on all `4277/4268/4285` frames with four-marker registration and zero homography fallback, and measured late diagonal exit-line perpendicular errors `+7.555/+8.886/+7.416mm` against `x_right+y_forward=455mm` (median `+7.555mm`, sample SD `0.811mm`, line-fit p95 residual at most `0.184mm`); run2 reported 38 Camera2 result failures and zero report-side encoded timestamp samples, but its complete 4268-frame MP4 trajectory agreed with the other repeats and was retained; paired the user-supplied one-millisecond traces `trace_bin_20260823_103541/103720/103857.csv` in order (3248/3220/3270 records, all mode2/case0/sub5) and found V90 target/real angle deltas about `89.96/90.76`, `89.96/91.00`, and `89.96/90.76deg`, omega RMSE `37.71/44.07/41.25deg/s`, real peaks `1070.1/1069.0/1062.0deg/s`, real speed ranges about `403--554mm/s`, motor peaks `416/389/422`, and no saturation; because angle/gyro tracking was repeatable while the physical exit remained displaced, treated the approximately `0.93g` lateral demand as translational tire slip rather than an angle-controller or encoder failure; rejected a direct entry-offset correction because it reduced the 70x39mm swept-body clearance below the 3mm effective gate, and instead changed mode2 V90 at unchanged 500mm/s/runtime-exact 90deg from `alpha/in/out 17500/17.0/17.0` to `15000deg/s2/13.5/13.5mm`, reducing nominal peak omega from about `1025` to `949deg/s` and lateral demand from about `0.93g` to `0.84g` while keeping nominal endpoint error `0.31mm` and diagnostic raw/effective clearance `7.347/3.248mm`; regenerated the PC route table at input SHA `ea514052ba00c2e85fda7865b0811ec100164a1e8dc8f652402502741037cdb7`, synchronized the host baseline, and passed 14210 precompute, 217 runner-linear, 209 slalom-host, 903 slalom-planner, 837 profile-audit, 1195 route-motion, 33464 route-preview, 17954 legacy-codec, validator, 30 slalom-codec, 53 route-clearance, and 29 Python clearance checks plus F413/F405 Debug builds and diff checks; committed and pushed `68c6060`, rebuilt F413 at RAM `270224B/320KiB` (82.47%) and Flash `342708B/1536KiB` (21.79%), ELF SHA-256 `82b18a6223b7db56e9746bd056852cadbd2a346d8ffcf2ce99e9763f133e1a0a`, flashed/verified/software-reset only application sectors 0--6 through ST-LINK `066CFF545771485067013914` at 3.24V, and recorded non-motor UART `i` IMU PASS in `tools/logging/logs/f413_postflash_20260823_v90_slip.log`; no motor, fan, Codex-triggered run/search/shortest, identity/calibration/maze/trace-format/protected-NVM operation was issued. |
| 20260823-013112 | 20260823-013112-mode2-l135out-core8500-validation | sub7コア8500版の3走行収束確認とsub5変動再監査 | n/a | no | confirmed that only three new Pixel recordings were present and that all three supplied one-millisecond traces were mode2 case0 sub7, not sub5; recorder-0.5.8 runs `manual-1787446848090-run0001..0003` retained complete 1080p240 motion with 4941/5245/5085 encoded frames, zero Camera2 failures, exact START `5/0/0`, and manually ended after STOP misses; transferred about 562MB to Ubuntu worker `BD790`, used four-marker per-frame registration with zero homography fallback, and recovered 4888/4941, 5245/5245, and 4893/5085 blue-centre frames; because runs1/3 temporarily switched from the blue centre to status LEDs near the exit, measured the same-orientation initial/final foreground-body centreline using the high-confidence blue initial heading, obtaining sub7 lateral offsets `221.968/224.006/225.779mm` against 225mm (`-3.032/-0.994/+0.779mm`, median `-0.994mm`, sample SD `1.907mm`), a 4.75mm median improvement over the preceding `-5.748mm` batch; paired traces `trace_bin_20260823_100250/100432/100612.csv` in order and found R135-in omega RMSE `12.62/13.00/13.35deg/s`, L135-out omega RMSE `16.29/19.06/17.14deg/s`, global motor peaks `220/242/232`, final target/real distances `607.589/607`, `607.928/608`, `608.154/608mm`, and final target/real angles `-0.033/-0.007`, `-0.027/-0.019`, `-0.037/-0.202deg`, with no saturation; accepted L135-out `500mm/s,8500deg/s2,12.5/22.0mm` as centred and made no additional change; reprocessed the preceding sub5 videos with a late moving-line fit and confirmed V90 exit-line perpendicular errors `+2.49/+8.49/+13.02mm` (median `+8.49mm`, sample SD `5.27mm`) while initial R45-in/diagonal approach overlapped and exit-line heading errors remained within 0.5deg, proving a real V90 swept-path variation rather than a fixed tracking/endpoint bias; because no sub5 trace exists and the preceding batch varied in the opposite order, retained V90 `500mm/s,17500deg/s2,17/17mm` pending three sub5 runs with a trace saved after each; no parameter/table/build/flash/reset, motor, fan, run/search/shortest, identity/calibration/maze/trace-format/protected-NVM operation was issued by Codex. |
| 20260822-180720 | 20260822-180720-mode2-l135out-core8500-flash | L135-outコア8500版をF413へ反映 | 255b173 | yes | committed and pushed the tested L135-out correction as `255b173`; rebuilt the intentionally dirty F413 application while preserving unrelated flashing-document/script and CAD worktree changes, producing RAM `270224B/320KiB` (82.47%), Flash `342708B/1536KiB` (21.79%), and ELF SHA-256 `eeebfdd09a625387f95344e96d73920e053707684adee16296e0b221dad09225`; confirmed ELF application sections ended at `0x0805389f`, then flashed, verified, and software-reset only application sectors 0--6 through ST-LINK `066CFF545771485067013914` at 3.24V; non-motor UART command `i` on `/dev/cu.usbmodem211202` returned IMU WHO_AM_I `0x6B` PASS and was saved in `tools/logging/logs/f413_postflash_20260823_l135out_core8500.log`; no motor, fan, run/search/shortest, identity/calibration/maze/trace-format/protected-NVM command was issued. |
| 20260822-180600 | 20260822-180600-mode2-v90-l135out-validation2 | sub5/sub7各3本の追試からL135-outターンコアを再調整 | n/a | yes | verified recorder runs `manual-1787420344672-run0001..0006` as mode2 case0 sub5 three times followed by sub7 three times; all six retained complete 1080p240 motion with zero Camera2 failures and exact START `5/0/0`, runs1--3 decoded STOP `0/5/0`, and runs4--6 were manually ended after STOP misses; transferred and processed all MP4s on Ubuntu worker `BD790`, recovered the blue centre on every encoded frame, and fitted start-local centreline coordinates with initial-straight residual p95 `0.137--0.315mm`; sub5 diagonal exit-line normal errors against `x_right+y_forward=455mm` were `+1.924/+9.298/+12.238mm` (median `+9.298mm`, sample SD `5.313mm`) and reversed the preceding batch's trend, so V90 `17500deg/s2,17/17mm` was deliberately left unchanged pending per-run trace diagnosis; sub7 cardinal exit errors against `x_right=225mm` were `-3.827/-5.748/-6.122mm` (median `-5.748mm`, sample SD `1.231mm`), identifying a repeatable turn-core bias; read the matching latest trace non-destructively as `trace_bin_20260823_025538.csv` (3359 one-millisecond records, SHA-256 `3f7ffb8d45e1be0ce42e4bf00540ffbd18f66a1927cebc6bbd29ad2b4949f377`, mode2/case0/sub7), confirmed R135-in/L135-out omega RMSE `15.46/25.10deg/s`, real turn-speed medians near 500mm/s, motor peaks `232/264`, no saturation, and final target/real angle `-0.116/-0.327deg`; changed L135-out at unchanged 500mm/s/runtime-exact 135deg from `alpha/in/out 10000/12.5/27.5` to `8500deg/s2/12.5/22.0mm`, predicting approximately `+0.66mm` residual in the cardinal exit and near-zero orthogonal endpoint residual; the 70x39mm diagnostic sweep remained collision-free with raw/effective clearance `7.834/3.734mm`; regenerated the PC route table at input SHA `0658896193b847932bba422c2fe9bc8547e8b93ac4cda4384c6368a8a2ba3f28`, synchronized host timing/geometry baselines, and passed 14210 precompute, 217 runner-linear, 209 slalom-host, 903 slalom-planner, 837 profile-audit, 1195 route-motion, 33464 route-preview, 17954 legacy-codec, 30 slalom-codec, 53 route-clearance, and 29 Python clearance checks plus F413/F405 Debug builds and diff checks; Codex issued only the read-only trace dump during analysis and no motor, fan, run/search/shortest, identity/calibration/maze/trace-format/protected-NVM operation. |
| 20260822-173226 | 20260822-173226-mode2-v90-135out-case6-flash | V90・135-out再調整版をF413へ反映 | e1062b4 | yes | committed and pushed the tested mode2 V90/L135-out correction as `e1062b4`; rebuilt the intentionally dirty F413 application with only the preserved unrelated flashing-document/script and CAD worktree changes outside the commit, producing RAM `270224B/320KiB` (82.47%), Flash `342708B/1536KiB` (21.79%), and ELF SHA-256 `1105f8283bed2d4a8d959955eb71a903301290a807ac02b1459a1d0c7dea8c8f`; confirmed ELF alloc sections ended at `0x0805389f`, then flashed, verified, and software-reset only application sectors 0--6 through ST-LINK `066CFF545771485067013914` at 3.24V; non-motor UART command `i` on `/dev/cu.usbmodem211202` returned IMU WHO_AM_I `0x6B` PASS and was saved in `tools/logging/logs/f413_postflash_20260823_v90_135out.log`; no motor, fan, run/search/shortest, identity/calibration/maze/trace-format/protected-NVM command was issued. |
| 20260822-173058 | 20260822-173058-mode2-v90-135out-case6-retune | case6条件のV90・135-out出口線を車体余裕込みで再調整 | n/a | yes | verified recorder-0.5.8 runs `manual-1787417532524-run0001..0006` as mode2 case0 sub5 three times followed by sub7 three times; all six reports were complete 1080p240 captures with zero Camera2 failures and exact START `5/0/0`, runs1--3 decoded STOP `0/5/0`, and runs4--6 retained complete motion after STOP misses/manual end; transferred the six MP4s to Ubuntu worker `BD790`, recovered the blue centre on every frame of runs1--3/5--6, and excluded run4 from parameter statistics because post-run status LEDs displaced the blue candidate before a trustworthy 135-out exit line could be fitted; measured sub5 diagonal exit-line normal errors `+11.315/+7.213/+3.071mm` against `x_right+y_forward=455mm` (median `+7.213mm`, sample SD `4.122mm`), and the two valid sub7 cardinal exit-line errors `-1.610/-3.867mm` against `x_right=225mm`; read the matching latest trace non-destructively as `trace_bin_20260823_022209.csv` (3339 one-millisecond records, SHA-256 `fc96da9b...3f218`, mode2/case0/sub7) and confirmed target/real final distance `584.307/584mm`, angle `-0.262/-0.279deg`, R135-in/L135-out omega RMSE `16.75/22.94deg/s`, mean turn velocities `495.7/493.1mm/s`, motor peaks `234/284`, and no saturation; selected bounded simulator/video corrections at unchanged 500mm/s and runtime-exact angles: V90 `alpha/in/out 12200/12.8/27.2 -> 17500deg/s2/17.0/17.0mm`, whose model shifts the complete-path exit-line normal by `-7.331mm` and therefore predicts about `-0.12mm` residual while improving the measured 70x39mm diagnostic raw/effective clearance to `7.717/3.618mm`; L135-out retained alpha 10000 and changed `in/out 8.5/9.5 -> 12.5/27.5mm`, whose model shifts the cardinal exit `+2.828/+15.172mm` and predicts about `225.1/229.7mm`, with raw/effective clearance improved to `7.754/3.654mm`; regenerated the PC route table at input SHA `02274e7a...b8ddd`, synchronized host geometry/timing baselines, and passed 14210 precompute, 217 runner-linear, 903 slalom-planner, 209 slalom-host, 837 profile-audit, 1195 route-motion, 33464 route-preview, 17954 legacy-codec, 30 slalom-codec, 53 route-clearance, and 29 Python clearance checks plus F413/F405 Debug builds and diff checks; the nominal models remain candidate-only and the new values require three-run video validation; Codex issued only the read-only trace dump and no motor, fan, run/search/shortest, flash/reset, identity/calibration/maze/trace-format/protected-NVM operation. |
| 20260822-162314 | 20260822-162314-mode2-l45out-core9500-validation | 4走行で45-outコア9500版の収束を確認 | n/a | no | verified recorder-0.5.8 runs `manual-1787414390043-run0001..0004` as four complete mode2 case0 sub4 captures with zero Camera2 failures, exact optical START/STOP tokens, 239.98fps encoded timing, and maximum PTS interval at most 4.80ms; transferred about 617MB to Ubuntu worker `BD790` and recovered both labels on all frames in runs1--3; run4 briefly lost the blue label for six motion frames and wide-radius reacquisition selected a false candidate, yielding a 12.97mm exit-line residual, so it was retained as a capture/tracker diagnostic but excluded from parameter statistics; the three valid high-speed exit-line offsets at local forward 370mm were `132.136`, `134.330`, and `135.169mm` against target 135mm, giving median error `-0.670mm`, sample SD `1.566mm`, and median line heading `-0.538deg`; this is a measured `+5.30mm` median correction from the preceding 7000deg/s2 batch and agrees with the predicted approximately 6mm turn-core shift; read the matching latest trace non-destructively as `trace_bin_20260823_sub4_core9500_validation.csv` (3070 one-millisecond records, mode2/case0/sub4) and confirmed target/real distance `467.673/468mm`, target/real final angle delta `+0.007/+0.080deg`, R45-in/L45-out omega RMSE `22.27/17.11deg/s`, L45-out real turn `45.198deg`, motor peak `230/1000`, and no saturation; accepted mode2 L45-out `500mm/s,9500deg/s2,24.0/6.0mm` as converged and made no parameter, table, firmware, flash, reset, motor, fan, run/search/shortest, identity/calibration/maze/trace-format, or protected-NVM change. |
| 20260822-154931 | 20260822-154931-mode2-l45out-core9500-flash | 45-outコア9500deg/s2版をF413へ反映 | 63e3111 | yes | committed and pushed the tested turn-core correction as `63e3111`; rebuilt the intentionally dirty F413 application with only the preserved unrelated flashing-document/script and CAD changes outside the commit, producing RAM `270224B/320KiB` (82.47%), Flash `342708B/1536KiB` (21.79%), and ELF SHA-256 `2ef3cade0afd30ef8af16fc3f3c5e1edb5ed2f00d262fdce9bc5bc408a29a60c`; flashed, verified, and software-reset only application sectors 0--6 through ST-LINK `066CFF545771485067013914` at 3.24V; non-motor UART command `i` on `/dev/cu.usbmodem211202` returned IMU WHO_AM_I `0x6B` PASS and was saved in `tools/logging/logs/f413_postflash_20260823_l45out_core9500.log`; no motor, fan, run/search/shortest, identity/calibration/maze/trace-format/protected-NVM command was issued. |
| 20260822-154824 | 20260822-154824-mode2-l45out-core-retune | sub4追試から45-outターンコア形状を補正 | n/a | yes | verified recorder-0.5.8 runs `manual-1787412367010-run0001..0003` as three complete mode2 case0 sub4 captures with exact optical START/STOP tokens; Camera2 result failures were `0/5/40`, but all MP4s remained continuous at 239.98fps with maximum encoded PTS interval at most 4.70ms; transferred about 465MB to Ubuntu worker `BD790`, recovered the blue label on all 4213/4189/4229 frames and the red label on all but two frames, and fitted the same high-speed exit segment at local forward 370mm; right offsets were `129.030`, `129.018`, and `130.578mm` against target 135mm (median `129.030mm`, sample SD `0.897mm`) with line headings `-0.574`, `-0.845`, and `-0.042deg`; read the matching trace non-destructively as `trace_bin_20260823_sub4_entry125_validation.csv` (3138 one-millisecond records, mode2/case0/sub4) and confirmed target/real distance `470.951/471mm`, final target/real angle delta `+0.015/+0.058deg`, R45-in/L45-out omega RMSE `22.99/13.54deg/s`, and no motor saturation; found that changing only `dist_in/out` in a continuous legacy path merely repartitions adjacent straight segments and therefore cannot reliably translate the exit lane, while the 7000deg/s2 turn-core simulator independently predicted about 6.1mm excess left displacement, matching video; changed L45-out `alpha/in/out 7000/12.5/8.0 -> 9500deg/s2/24.0/6.0mm`, below the previously exercised 10500deg/s2 and restoring the canonical endpoint to 0.111mm while preserving raw/effective 70x39mm swept clearance `8.066/3.966mm`; regenerated the PC route table at input SHA `cee4fd06...bdb0` and passed 14210 precompute, 217 runner-linear, 903 slalom-planner, 209 slalom-host, 1195 route-motion, 33464 route-preview, and 29 Python clearance checks plus F413/F405 Debug builds and diff checks; Codex issued only the read-only trace dump and no motor, fan, run/search/shortest, identity/calibration/maze/trace-format/protected-NVM operation. |
| 20260822-144353 | 20260822-144353-mode2-l45out-entry125-flash | L45-out入口12.5mm版をF413へ反映 | 54c2898 | yes | committed and pushed the tested interpolation correction as `54c2898`; rebuilt the intentionally dirty F413 application with only the preserved unrelated flashing-document/script and CAD changes outside the commit, producing RAM `270224B/320KiB` (82.47%), Flash `342708B/1536KiB` (21.79%), and ELF SHA-256 `23bd917a278c9662c228c8d07f4395923309f9d0bff0d74ccb0927f231f817b4`; flashed, verified, and software-reset only application sectors 0--6 through ST-LINK `066CFF545771485067013914` at 3.24V; non-motor UART command `i` on `/dev/cu.usbmodem211202` returned IMU WHO_AM_I `0x6B` PASS and was saved in `tools/logging/logs/f413_postflash_20260822_l45out_entry125.log`; no motor, fan, run/search/shortest, identity/calibration/maze/trace-format/protected-NVM command was issued. |
| 20260822-144231 | 20260822-144231-mode2-l45out-entry125-retune | sub4出口中心線の追試から入口距離を補間調整 | n/a | yes | verified recorder-0.5.8 runs `manual-1787408933925-run0001..0003` as three complete mode2 case0 sub4 captures with zero Camera2 failures and exact optical START/STOP tokens; transferred about 464MB to Ubuntu worker `BD790` at 110--118MB/s and recovered both labels on every one of the 4189/4189/4197 frames; fitted the high-speed exit straight at local forward 370mm and measured right offsets `129.225`, `131.746`, and `132.615mm` against the 135mm centreline (median `131.746mm`, sample SD `1.761mm`) with line headings `+0.145`, `+1.575`, and `+0.552deg`; compared with the preceding `entry=14mm` batch median `137.149mm`/SD `4.109mm`, confirming that the `14 -> 11mm` correction reduced dispersion but crossed the target, so used the measured response to interpolate entry `11.0 -> 12.5mm` while retaining 500mm/s, 7000deg/s2, exact runtime angle, and exit 8.0mm, predicting the next median near `134.45mm`; read the matching trace non-destructively as `trace_bin_20260822_sub4_exitline_validation.csv` (3075 one-millisecond records) and confirmed target/real distance `471.855/472mm`, final target/real angle delta `+0.019/+0.124deg`, R45-in/L45-out omega RMSE `23.41/18.21deg/s`, and no motor saturation; the measured 70x39mm host model reports no collision and raw/effective clearance `7.767/3.668mm`, while its endpoint/model scope remains non-qualified and repeated video remains the final gate; regenerated the PC route table at input SHA `38c4dbd4...4731` and passed 14210 precompute, 217 runner-linear, 903 slalom-planner, 209 slalom-host, 1195 route-motion, 33464 route-preview, and 29 Python clearance checks plus F413/F405 Debug builds and diff checks; Codex issued only the read-only trace dump and no motor, fan, run/search/shortest, identity/calibration/maze/trace-format/protected-NVM operation. |
| 20260822-073141 | 20260822-073141-mode2-l45out-exit-line-flash | 出口中心線基準のL45-out補正をF413へ反映 | c23f859 | yes | committed and pushed the tested exit-line correction as `c23f859`; rebuilt the intentionally dirty F413 application with only the preserved unrelated flashing-document/script and CAD changes outside the commit, producing RAM `270224B/320KiB` (82.47%), Flash `342708B/1536KiB` (21.79%), and ELF SHA-256 `e6d1d048eb2f820de19b6c14fe42e0aa5f4a08f56f6a8a9c59e7be285539bd48`; flashed, verified, and software-reset only application sectors 0--6 through ST-LINK `066CFF545771485067013914` at 3.24V; non-motor UART command `i` on `/dev/cu.usbmodem211202` returned IMU WHO_AM_I `0x6B` PASS and was saved in `tools/logging/logs/f413_postflash_20260822_l45out_exitline.log`; no motor, fan, run/search/shortest, identity/calibration/maze/trace-format/protected-NVM command was issued. |
| 20260822-073015 | 20260822-073015-mode2-l45out-exit-line-retune | sub4を停止終点ではなく出口直進線で再評価 | n/a | yes | verified recorder-0.5.8 runs `manual-1787382149375-run0001..0003` as three complete mode2 case0 sub4 captures with zero Camera2 failures and exact optical START/STOP tokens; transferred about 468MB to Ubuntu worker `BD790` at 115--117MB/s and recovered the blue/red labels on all 4237/4253/4205 frames; the earlier `out=22.5mm` extension moved only one repeat by the expected amount while the stopped endpoints remained dominated by run-to-run terminal braking/slip, so changed the tuning metric to the high-speed exit straight against the board centreline, which is the behavior used by a continuing shortest run; at local forward 370mm the three fitted exit-line right offsets were `137.149`, `130.053`, and `137.192mm` against target `135mm`, with final-line heading offsets `+0.641`, `+0.102`, and `+1.251deg`; combining the preceding and current batches gave median line offset about `137.17mm`, whereas extending `dist_out` cannot correct this perpendicular error; read the latest retained trace non-destructively as `trace_bin_20260822_sub4_exit225_validation.csv` (3123 one-millisecond records) and confirmed target/real distance `496.719/497mm`, target/real final angle `-0.008/+0.313deg`, L45-out omega RMSE `12.38deg/s`, mean real turn velocity `487.6mm/s`, and no motor saturation; therefore retained 500mm/s, 7000deg/s2 and exact runtime angle, reverted the ineffective exit extension `22.5 -> 8.0mm`, and shortened entry `14.0 -> 11.0mm` to move the fitted exit lane about 2.12mm toward centre; the 70x39mm diagnostic simulator still reports no collision and raw/effective clearance `7.652/3.552mm`, while its endpoint/model scope remains explicitly non-qualified and video remains the final gate; regenerated the PC route table at input SHA `e42e23d6...74152` and passed 14210 precompute, 217 runner-linear, 903 slalom-planner, 209 slalom-host, 1195 route-motion, 33464 route-preview, and 29 Python clearance checks plus F413/F405 builds and diff checks; Codex issued only the read-only trace dump and no motor, fan, run/search/shortest, identity/calibration/maze/trace-format/protected-NVM command. |
| 20260822-053546 | 20260822-053546-mode2-l45out-exit225-flash | 45deg出口22.5mm調整をF413へ反映 | 6d4f59d | yes | committed and pushed the tested L45-out exit correction as `6d4f59d`; rebuilt the intentionally dirty F413 application with only the preserved unrelated flashing-document/script and CAD changes outside the commit, producing RAM `270224B/320KiB` (82.47%), Flash `342708B/1536KiB` (21.79%), and ELF SHA-256 `7f5b8d483303908f8caef2809a9f198771b63cd350580eeffde6b35019a8fb5e`; flashed, verified, and software-reset only application sectors 0--6 through ST-LINK `066CFF545771485067013914` at 3.24V; non-motor UART command `i` on `/dev/cu.usbmodem211202` returned IMU WHO_AM_I `0x6B` PASS and was saved in `tools/logging/logs/f413_postflash_20260822_l45out_exit225.log`; no motor, fan, run/search/shortest, identity/calibration/maze/trace-format/protected-NVM command was issued. |
| 20260822-053400 | 20260822-053400-mode2-l45out-case6-retune | case6条件のsub4再撮影から45deg出口直線を補正 | n/a | yes | verified the three newest Pixel recordings `manual-1787375384087-run0001..0003` as complete mode2 case0 sub4 repeats at 1080p240 with zero Camera2 failures and clean optical START/STOP tokens; transferred about 478MB to Ubuntu worker `BD790` at about 117MB/s and extracted all 4245/4237/4205 encoded frames with essentially complete blue/red-label tracking; stable board-coordinate start-to-end deltas were `136.444/440.830`, `133.683/440.265`, and `127.625/430.413mm` right/forward against target `135/455mm`, giving median error `-1.317/-14.735mm`; the matching non-motor 1ms trace `trace_bin_20260822_sub4_case6.csv` contained 3072 records and confirmed target/real distance `472.081/472mm`, final target/real angle delta `-0.010/+0.319deg`, no motor saturation, R45-in/L45-out omega RMSE `22.7/13.5deg/s`, so the short board displacement was not a controller dropout; retained L45-out speed/alpha/in and changed only its final exit distance `8.0 -> 22.5mm`, predicting board median about `133.68/454.77mm` while leaving the turn-core 70x39mm diagnostic raw/effective clearance unchanged at `7.857/3.757mm`; regenerated the PC route table at input SHA `000c957d...67b`, updated host geometry/timing baselines, and passed 14210 precompute, 217 runner-linear, 903 slalom-planner, 209 slalom-host, 1195 route-motion, 33464 route-preview, and 29 Python clearance checks plus F413/F405 Debug builds and diff checks; Codex issued only the read-only trace dump and no motor, fan, run/search/shortest, identity/calibration/maze/trace-format/protected-NVM operation. |
| 20260822-043058 | 20260822-043058-mode2-case6-diagonal-calibration-flash | case6進入条件の斜めターン診断版をF413へ反映 | 2e1b815 | yes | committed and pushed the tested diagnostic-run update as `2e1b815`; rebuilt the intentionally dirty F413 application with only the preserved unrelated flashing-document/script and CAD changes outside the commit, producing RAM `270224B/320KiB` (82.47%), Flash `342708B/1536KiB` (21.79%), and ELF SHA-256 `755064323137567bb97e5f8d97f39e52d329e1f1339c58acea7cefad8473216f`; flashed, verified, and software-reset only application sectors 0--6 through ST-LINK `066CFF545771485067013914` at 3.24V; non-motor UART command `i` on `/dev/cu.usbmodem211202` returned IMU WHO_AM_I `0x6B` PASS and was saved in `tools/logging/logs/f413_postflash_20260822_case6_calibration.log`; no motor, fan, run/search/shortest, identity/calibration/maze/trace-format/protected-NVM command was issued. |
| 20260822-042934 | 20260822-042934-mode2-case6-diagonal-calibration-approach | 斜めターン診断の進入条件を低速最短case6へ一致 | n/a | yes | verified the six newest recorder runs `manual-1787370751399-run0001..0006` as mode2 case0 sub4 three times followed by sub7 three times; all six were complete 1080p240 captures with zero Camera2 failures and exact START `5/0/0`, runs1--3 decoded STOP `0/5/0`, and runs4--6 retained complete motion after STOP misses/manual end; processed about 960MB in parallel on Ubuntu worker `BD790`, recovered the true settled blue-label centres before status-LED/recovery interference using the four-marker board homography, and measured sub4 deltas `134.117/455.729`, `125.073/435.561`, `126.842/433.891mm` right/forward (median error `-8.158/-19.439mm`, SD `4.79/12.15mm`) and sub7 `225.278/230.882`, `230.194/212.404`, `225.537/219.748mm` (median error `+0.537/-10.252mm`, SD `2.77/9.30mm`); because the first repeat of each primitive was nearly exact while later repeats were short and the divergence began before the exit turn, did not apply another fixed in/out correction that would overcorrect run1 or reduce the current >=3mm swept-body clearance; read the matching latest trace non-destructively as `trace_bin_20260822_131428.csv` (3048 one-millisecond rows, SHA-256 `ed698ccb...d0d112`) and confirmed target/real distance `581.141/581mm`, final target/real angle delta `-0.306/-0.547deg`, no motor saturation, R135-in/L135-out omega RMSE `21.7/22.5deg/s`, but about `9.16mm` integrated forward-path residual and lower active-turn battery telemetry than the prior repeat; found mode2 case0 sub3--7 used case8's `4000mm/s2` approach although the requested low-speed shortest profile case6 uses `1000mm/s2`, so remapped those diagnostics to case6 while retaining the same 500mm/s turn boundary and all tuned turn parameters; added a calibration-only minimum `3000mm/s2` final 45mm stopping contract because case6's route limit cannot stop 500mm/s in that fixed diagnostic tail, without altering approach/turn/normal shortest-path limits; passed 217 runner-linear checks, F413/F405 Debug builds (F413 RAM `270224B`, Flash `342708B`), and diff checks; Codex issued only the read-only trace dump and no motor, fan, run/search/shortest, identity/calibration/maze/trace-format/protected-NVM operation. |
| 20260822-033100 | 20260822-033100-mode2-diagonal-exit-flash | mode2斜め脱出再調整をF413へ反映 | 82a50b9 | yes | committed and pushed the tested sub4/sub7 parameter update as `82a50b9`; rebuilt the intentionally dirty F413 application with only preserved unrelated flashing-document/script and CAD worktree changes outside the commit, yielding RAM `270224B/320KiB` (82.47%), Flash `342580B/1536KiB` (21.78%), and ELF SHA-256 `19697bd7be267bb269336669c91ee6a313cb037085d0f975fecaba75f756dcf6`; flashed, verified, and software-reset only application sectors 0--6 through ST-LINK `066CFF545771485067013914` at 3.24V; non-motor UART command `i` on `/dev/cu.usbmodem211202` returned IMU WHO_AM_I `0x6B` PASS and was saved in `tools/logging/logs/f413_postflash_20260822_diagonal_exit.log`; no motor, fan, run/search/shortest, identity/calibration/maze/trace-format/protected-NVM operation was issued. |
| 20260822-032831 | 20260822-032831-mode2-diagonal-exit-retune | 直近sub4/sub7各3本と1msログから斜め脱出ターンを再調整 | n/a | yes | verified the six newest recorder-0.5.8 runs `manual-1787364818618-run0001..0006` as mode2 case0 sub4 three times followed by sub7 three times; all six retained complete 1080p240 motion with zero Camera2 failures, runs1--3 decoded exact START/STOP while runs4--6 decoded START and were manually stopped after STOP misses; offloaded about 1.06GB to Ubuntu worker `BD790` at about 113MB/s and used late position-only blue-centre reacquisition where machine LEDs competed with the labels; sub4 measured median `122.590/423.201mm` right/forward with sample SD about `3.3/7.9mm` against target `135/455mm`, while sub7 measured `223.861/240.213mm` with SD about `2.1/7.4mm` against `225/230mm`; read the matching retained trace non-destructively as `tools/logging/logs/trace_bin_20260822_122012.csv` (firmware `75ef0fe-dirty`, mode2 case0 sub7, 3086 one-millisecond rows) and confirmed target/real distance `590.974/591mm`, target/real final angle delta `-0.293/-0.598deg`, integrated target/real pose `226.816/229.092` versus `226.215/234.743mm`, no motor saturation, R135-in omega RMSE `14.2deg/s`, and L135-out omega RMSE `23.96deg/s` with velocity-error p95 about `107.3mm/s`; selected bounded simulator/video corrections at unchanged 500mm/s and runtime-exact angles: L45-out `alpha/in/out 10500/7.5/0 -> 7000deg/s2/14.0/8.0mm`, predicted next observed endpoint about `137.9/454.3mm`, raw/effective 70x39mm body clearance `7.857/3.757mm`; L135-out `8850/0/12 -> 10000deg/s2/8.5/9.5mm`, predicted `225.1/229.8mm`, clearance `7.324/3.224mm`; regenerated the PC route table at input SHA `e4b0b024...84ac`, updated host geometry/timing baselines, and passed 14210 precompute, 209 slalom-host, 903 slalom-planner, 1195 route-motion, 214 runner-linear, 29 Python clearance, 53 route-clearance, 17954 legacy-codec, and 33464 route-preview checks plus F413/F405 Debug builds and diff checks; Codex issued only the read-only trace dump and no motor, fan, run/search/shortest, identity/calibration/maze/trace-format/protected-NVM operation. |
| 20260822-021256 | 20260822-021256-mode2-r135in-exit22-validation | R135入りexit22追試を制御ログ込みで検証 | n/a | no | Pixel/host双方で今回の新規保存は3本だけと照合し、recorder-0.5.8 runs `manual-1787363612516-run0001..0003`を解析した。全3本はcomplete 1080p240、Camera2 failure 0、START `5/0/0`、STOP `0/5/0`で、各4037/4029/4053 frameの青中心・赤前方ラベルを100%検出した。Ubuntu worker `BD790`はmDNS・有線IP・Wi-Fi IPすべてSSH timeoutだったため指示どおりMacへ低並列でfallbackした。短い150ms pose窓は停止直後の位置平滑化で出力方向へ約4mm偏ることを確認し、1s静止窓で再評価した結果、R135-in終点は `166.761/111.531/-134.986`, `171.368/105.120/-134.683`, `171.031/111.072/-134.757` mm/deg、中央値 `171.031/111.072/-134.757`、mean `169.720/109.241/-134.809`、sample SD `2.568/3.576/0.158`だった。直近1ms trace `trace_bin_20260822_110931.csv`はmode2 case0 sub6を確認し、指令/実距離 `442.921/443mm`、指令/実角度 `-135.141/-135.139deg`、旋回中実速度mean約493mm/s、target/real omega peak `878.4/887.4deg/s`、motor saturation 0で制御異常なし。現行R135-in `500mm/s,8300deg/s2,17/22mm`の入口短縮またはalpha増加は70x39mm車体のdiagnostic effective clearance `3.324mm`を3mm未満へ落とし、動画ばらつきを吸収する追加変更は危険なのでパラメータ/table/firmwareを維持した。Codexは非motor UART trace readだけを行い、flash/reset、motor/fan/run/search/shortest、identity/calibration/maze/trace-format/protected-NVM操作を実行していない。 |
| 20260816-132536 | 20260816-132536-mode2-r135in-exit-retune | R135入り追試から安全余裕を保った出口補正を反映 | n/a | yes | Pixel/host双方で今回の連続待機に新規保存されたのは3本だけと照合し、`manual-1786885526235-run0001..0003`をUSB経由で約455MB/4.5sでUbuntu worker `BD790`へ送り並列解析した。全3本はcomplete 1080p240、Camera2 failure 0、START `5/0/0`、STOP `0/5/0`で、改善後の2灯・低コントラスト判定がSTOP score `212..428`でも3/3成功した。3本ともmode2 case0 sub6 R135-inで、run3だけ初期の赤ラベル候補が不定だったため既知の初期方位85degを与えて再抽出し、最終的に全3本で全4029 frameの青/赤ラベルを検出した。終点は `166.790/112.094/-134.665`, `167.899/109.668/-134.686`, `165.799/111.795/-134.715` mm/deg、中央値 `166.790/111.795/-134.686`、sample SD約 `1.05/1.32/0.03`で、前候補から右へ3.43mm・前へ-2.37mm改善した。入口を短くする完全補正は70x39mm車体の3mm余裕を失うため却下し、alpha `8300`とentry `17.0mm`を維持してexitだけ `16.0 -> 22.0mm`へ延長した。turn-coreのdiagnostic raw/effective clearanceは `7.423/3.324mm`で不変、次実測予測は約 `171.03/107.55mm`。PC route tableをinput SHA `3e49a1ff...35e4`へ再生成し、14210 precompute、903 slalom planner、209 slalom host、30 codec、1195 route motion、53 clearance、214 runner linear、33464 route preview、837 profile、29 Python checksとF413/F405 buildsを合格させ、`75ef0fe`としてcommit/pushした。F413 ELF SHA-256 `53bac443...d5bd`をST-LINK `066CFF545771485067013914`/3.24Vでapplication sector 0--6だけerase/program/verify/resetし、非motor UART `i`でWHO_AM_I `0x6B` PASSを `f413_postflash_20260816_r135in_exit22.log`へ保存した。Codexはmotor/fan/run/search/shortest、identity/calibration/maze/trace-format/protected-NVM操作を実行していない。次はsub6を3回だけ再撮影する。 |
| 20260816-095500 | 20260816-095500-mode2-r135in-offset-flash | R135入りオフセット再調整をF413へ反映 | n/a | yes | committed and pushed the tested R135-in update as `76e2b31`; rebuilt the intentionally dirty F413 application with only preserved unrelated flashing-document/script and CAD worktree changes outside the commit, yielding RAM 82.47%, Flash 21.78%, and ELF SHA-256 `9b620d1e...bcb`; flashed, verified, and software-reset only application sectors 0--6 through ST-LINK `066CFF545771485067013914` at 3.24V; non-motor UART command `i` on `/dev/cu.usbmodem211202` returned IMU WHO_AM_I `0x6B` PASS and was saved in `tools/logging/logs/f413_postflash_20260816_r135in_offsets.log`; no motor, fan, run/search/shortest, identity/calibration/maze/trace-format/protected-NVM operation was issued. |
| 20260816-095004 | 20260816-095004-mode2-r135in-offset-retune | 斜め入り6本の追試からR135入りを余裕内で再調整 | n/a | yes | verified the six newest transferred recorder-0.5.8 runs `manual-1786871422164-run0001..0006`; all contained complete motion at 239.99998fps with exact 5/0/0 START votes and zero Camera2 failures except 21 result callbacks in run2, while five decoded exact 0/5/0 STOP and run5 retained its full trajectory after a STOP miss/manual end; offloaded 944MB to Ubuntu `BD790` at about 102MB/s and classified runs1--3 as sub3 R45-in and runs4--6 as sub6 R135-in; R45-in centre-label and front-label pairing became ambiguous with on-machine blue/red LEDs near the endpoint, but all three physical motion paths overlapped before the fixed-feature switch, so retained the already clearance-limited `12400deg/s2,10/29mm` rather than tune against false post-motion displacement; R135-in remained fully observable with per-run endpoints `163.356/114.183/-134.753`, `163.659/112.943/-134.947`, and `162.772/114.167/-135.062mm/deg`, median `163.356/114.167/-134.947` against target `169.393/105.607/-135`, and straight-fit residual p95 `0.174..0.217mm`; rejected the full `+6.04/-8.56mm` correction because it reduced diagnostic effective 70x39mm swept clearance below 3mm, retained alpha `8300deg/s2`, and changed only R135-in entry/exit `17.5/11.0 -> 17.0/16.0mm`, whose nominal correction is about `+3.54/-4.04mm` with raw/effective clearance `7.42/3.32mm`; regenerated the PC route table at input SHA `f318008f...731`, updated host geometry/timing baselines, and passed 14210 precompute, 903 slalom-planner, 209 slalom-host, 30 legacy-codec, 1195 route-motion, 53 clearance, 214 runner-linear, 33464 route-preview and 29 Python clearance checks plus F413/F405 Debug builds and diff checks; no motor, fan, Codex-triggered run/search/shortest, identity/calibration/maze/trace-format/protected-NVM operation was issued during analysis. |
| 20260816-073500 | 20260816-073500-mode2-diagonal-entry-flash | mode2斜め入り再調整をF413へ反映 | n/a | yes | committed and pushed the tested turn update as `b978ff6`; rebuilt the intentionally dirty F413 application with only preserved unrelated flashing-document/script and CAD worktree changes outside the commit, yielding RAM 82.47%, Flash 21.78%, and ELF SHA-256 `59b54b2a...2e3d`; flashed, verified, and software-reset only application sectors 0--6 through ST-LINK `066CFF545771485067013914` at 3.24V; non-motor UART command `i` on `/dev/cu.usbmodem211202` returned IMU WHO_AM_I `0x6B` PASS and was saved in `tools/logging/logs/f413_postflash_20260816_diagonal_entry.log`; no motor, fan, run/search/shortest, identity/calibration/maze/trace-format/protected-NVM operation was issued. |
| 20260816-073000 | 20260816-073000-mode2-diagonal-entry-conservative-retune | 直近6本からmode2斜め45/135度入りを安全余裕内で再調整 | n/a | yes | verified the six newest transferred Pixel runs `manual-1786861994345-run0001..0006` as complete 1920x1080@240 recordings with zero Camera2 failures and exact optical START/STOP votes; classified by trajectory rather than assumed order as four sub3 R45-in trials (runs1/2/3/5) and two sub6 R135-in trials (runs4/6); Ubuntu `BD790` parallel extraction measured sub3 median `124.647mm right / 315.328mm forward` with approximately `0.757/1.154mm` sample SD and two clean trajectory headings near `-44.764deg`, and sub6 median `163.386/112.369mm / -135.430deg` with `1.884/0.754mm/0.301deg` sample SD; read the matching latest 1ms trace non-destructively over UART and confirmed the R135 command/actual angle ended at `-135.101/-135.201deg`, real omega peaked near `892deg/s`, and motors did not saturate, so the remaining error was translational turn shape rather than angular control; selected deliberately bounded corrections that retain the measured 70x39mm body's diagnostic effective clearance near `3.71mm`: R45-in alpha `12000 -> 12400deg/s2`, and R135-in alpha/in/out `8400/18.0/10.5 -> 8300deg/s2/17.5/11.0mm`; regenerated the PC route table at input SHA `1a9b3204...63f6`, updated host geometry/timing baselines, and passed 14210 precompute, 903 slalom-planner, 209 slalom-host, 30 legacy-codec, 1195 route-motion, 53 clearance, 214 runner-linear, 33464 route-preview, and 29 Python swept-clearance checks plus F413/F405 Debug builds and diff checks; no motor, fan, Codex-triggered run/search/shortest, identity/calibration/maze/trace-format/protected-NVM command was issued during analysis. |
| 20260816-061100 | 20260816-061100-pixel-optical-two-led-contrast | Pixel光学START/STOPを2灯・低コントラスト終点でも安定化 | n/a | yes | audited the recent recorder-0.5.7 corpus and found 41 decoded START tokens but only 2 decoded STOP tokens; direct 480x270 replay of missed-STOP videos proved the complete 900ms SYNC and five long slots were present, while one endpoint exposed only two LEDs and another exposed three healthy rising components but sustained absolute blue chroma only `49/43/25` over an OFF baseline of `0..5`, so the old three-component/two-pixel acquisition and fixed absolute threshold 48—not firmware timing or illumination—discarded valid tokens; recorder 0.5.8/code22 now starts SYNC only from rising components after a rise-free preamble, bypasses an inflated adaptive threshold while retaining the configured aggregate score/hot gate, prefers three LEDs but accepts a separated two-LED/one-pixel pair, snapshots each learned ROI's OFF baseline and sustains it with `ON>=14/HOLD>=8` contrast hysteresis, and excludes calibration-time LED rises from noise learning; changed F413 SYNC from continuous 900ms to backward-compatible `75ms ON / 50ms OFF / 825ms ON`, where the sub-175ms notch supplies a second edge but remains one logical 950ms SYNC; added regressions for two one-pixel LEDs through the whole token, mixed resolution, real-video dim chroma, static blue triangles, adaptive threshold 900, below-base-gate rejection, exact re-edge timing, and omitted preview callbacks; optical/motion/Wi-Fi host tests, all 137 vision tests, Android app/recorder assemble and lint, F413/F405 Debug builds, shell syntax, and diff checks passed; kept lighting at 50%/4500K after measuring static-frame luma variation below 0.5% and 120Hz amplitude below 0.06%; upgraded Pixel 8 `38301FDJH0009W` in place with APK SHA-256 `d66f693f...a0c5`, preserving 296 runs and Wi-Fi pairing, then flashed/verified/reset F413 ELF SHA-256 `57c848f2...f5b2` through ST-LINK `066CFF545771485067013914` at 3.24V, erasing application sectors 0..6 only; five stationary non-motor UART START/STOP pairs completed and re-armed with exact `5/0/0` and `0/5/0` votes, two learned LEDs and scores `2626..2727`, producing five complete 239.99998fps reports with one total Camera2 capture failure; one additional START decoded correctly but Android's one-time post-install Play Protect package-update restart interrupted that recording and was excluded; Pixel was left armed at saved=301/acknowledged=295 with diagnostics retained; no motor, fan, run/search/shortest, identity/calibration/maze/trace-format/protected-NVM command or deletion was issued. |
| 20260816-052138 | 20260816-052138-f413-path-transition-distance-credit | mode2斜め45deg入り再撮影から区間切替移動の残存加算を修正 | n/a | partial | verified the newest three transferred Pixel runs `manual-1786855747133-run0001..0002` and `manual-1786855972525-run0001` as mode2 case0 sub3 repeats; all retained complete 1920x1080@240 fixed-focus motion with zero Camera2 failures and complete blue/red tracking, while the last run was manually stopped after an optical STOP miss; Ubuntu `BD790` parallel extraction and settled-pose analysis measured median `126.653mm right / 318.638mm forward / -44.698deg` with sample SD `0.565/1.668mm/0.142deg` against the `{S3,R45-in,DS1}` target `124.393/309.393/-45deg`; captured the matching 1ms trace read-only as `stm32_log_20260816_135822.csv`, which showed healthy turn tracking (`-45.022/-44.922deg`, target/real omega peaks `608.5/634.2deg/s`, no motor saturation) but exposed that the controller's final `376.806mm` target was itself extended relative to the correct geometric path length `358.779mm`; rejected offset/alpha compensation because the current 70x39mm diagnostic swept-body clearance is raw/effective `7.943/3.843mm`, while trimming offsets to absorb the residual would reduce effective clearance to `0.576mm` or below; retained R45-in `500mm/s,12000deg/s2,10.0/29.0mm` and changed the F413 runner to maintain absolute endpoints across consecutive straight/offset phases so motion during action-switch latency consumes the next phase instead of extending the path, with empirical timed turn cores explicitly re-anchoring the cursor and the case0 stop gate checking the intended endpoint; added cursor regressions, regenerated the route table at input SHA `c2b519f6...093c`, and passed 214 runner-linear, 14210 precompute, 33464 route-preview, 1195 route-motion, 903 slalom-planner and 53 clearance checks plus F413/F405 Debug builds and diff checks; committed/pushed as `3059cd4`, rebuilt F413 RAM 82.47% / Flash 21.78% with ELF SHA-256 `40ce7622...528`, flashed/verified/reset only application sectors 0--6 through ST-LINK `066CFF545771485067013914` at 3.24V, and confirmed non-motor IMU WHO_AM_I `0x6B` PASS in `f413_postflash_20260816_transition_credit.log`; no motor, fan, Codex-triggered run/search/shortest, identity/calibration/maze/trace-format/protected-NVM operation was issued; next HIL is three more mode2 case0 sub3 repeats, and the matching 1ms trace should finish near `359mm` before any turn-parameter change is considered. |
| 20260816-044703 | 20260816-044703-f413-path-transition-precompute | mode2斜め45deg入りの再撮影から区間切替空走を除去 | n/a | partial | collected the three newest Pixel runs `manual-1786853137708-run0001`, `manual-1786853300517-run0001`, and `manual-1786853300517-run0002` over authenticated USB at about 120MB/s and analyzed them on Ubuntu worker `BD790`; all three retained complete 1920x1080@240 motion with zero Camera2 failures, fixed focus/exposure, clean 5/0/0 START decoding and complete blue/red tracking, while all three missed optical STOP and were manually ended; trajectory-heading analysis measured median `132.788mm right / 331.261mm forward / -44.648deg` with sample SD `1.145/1.772mm/0.098deg`, improving the preceding alpha8000 batch by about `0.90/6.51mm` and substantially improving repeatability; dumped the matching 1ms trace read-only as `stm32_log_20260816_132936.csv` and found the commanded/real turn itself healthy (`-45.000/-45.230deg`, target/real omega peaks `615.2/629.9deg/s`, mean real turn speed `500.6mm/s`, no motor saturation), but the complete nominal `358.779mm` test sequence ended at `395mm`; phase reconstruction showed that the F413 was rebuilding double-precision linear plans and formatting the turn-profile trace after motors were live, leaving the previous 500mm/s command active across action boundaries and adding roughly `36mm` including stop coast, so further offset/alpha compensation would have hidden an execution bug; retained mode2 R45-in `500mm/s,12000deg/s2,10.0/29.0mm`, changed the runner to produce compact linear phase plans during motor-off preflight, execute those cached phases without live `nf_motion_linear_plan()`, move turn-profile formatting before optical START/motor enable, and hold only case0 terminal position until <=20mm/s and <=0.75mm error (250ms maximum); added prepared-plan regressions including `{S3,R45-in,DS1}` and wall-end S1, regenerated the PC table at SHA `d4fb6a82...8c29`, and passed 187 runner-linear, 14210 precompute, 33464 route-preview, 1195 route-motion and 903 slalom checks plus F413/F405 Debug builds and diff checks; committed/pushed as `727dbf6`, rebuilt F413 RAM 82.46% / Flash 21.73% with ELF SHA-256 `49ff8f5b...be3b`, flashed/verified/reset application sectors 0--6 only through ST-LINK `066CFF545771485067013914` at 3.24V, and read zero CFSR/HFSR fault state; the target USB CDC interface was not enumerated after reset (only ST-LINK was visible), so the planned non-motor UART IMU smoke could not be completed and should be retried after reconnecting the machine USB cable; no motor, fan, Codex-triggered run/search/shortest, identity/calibration/maze/trace-format/protected-NVM operation was issued; next motion HIL is the same three mode2 case0 sub3 repeats to verify that total distance and video endpoint contract to the simulator target. |
| 20260816-040326 | 20260816-040326-mode2-r45in-alpha12000 | mode2斜め45deg入りの再撮影を解析し500mm/sを維持した次候補へ更新 | n/a | partial | verified the three newest transferred Pixel runs `manual-1786850760429`, `1786850890425`, and `1786850960929` run0001 as post-`alpha=8000` mode2 case0 sub3 repeats; all retained complete motion at approximately 240fps with zero Camera2 capture failures, fixed focus/exposure, and complete blue position tracking, while all three again missed optical STOP and were manually ended; offloaded 487MB to the Ubuntu `BD790` worker at about 116.8MB/s and reconstructed each final machine centre from the red 2mm reference-plane label minus the measured 24mm baseline, obtaining median `133.718mm right / 338.732mm forward / -44.726deg` with sample SD `2.474/2.038mm/0.295deg` against the `{S3,R45-in,DS1}` full-path target `124.393/309.393/-45deg`; this removed the prior high-alpha outlier but left systematic `+9.325/+29.339mm` translation error; rejected the initially considered 400mm/s candidate after the route/runner contract correctly exposed that an isolated 400mm/s turn cannot transition to the existing 500mm/s turn family across zero-length connectors without a broader runner change, and retained the established common 500mm/s boundary speed; comparison with the prior `alpha=9500` repeats showed the stable pair was roughly `4.6/9.5mm` closer than the `alpha=8000` median, so selected the next full-body simulator-closing candidate `alpha=12000deg/s2, in/out=10.0/29.0mm`, whose nominal endpoint error is `0.261mm` and diagnostic raw/effective 70x39mm clearance is about `7.94/3.84mm`; regenerated the PC table at input SHA `2a24f1d6...11d1`, passed 14210 precompute, 33464 route-preview with `138632/223232B` scratch, 166 runner-linear, 903 slalom-planner, and 837 profile checks plus F413/F405 Debug builds and diff checks; committed/pushed as `3c730a2`, rebuilt F413 RAM 78.40% / Flash 21.69% with ELF SHA-256 `cc5accb3...d264`, flashed/verified/reset application sectors 0--6 only through ST-LINK `066CFF545771485067013914` at 3.24V, and confirmed non-motor IMU WHO_AM_I `0x6B` PASS in `f413_postflash_20260816_diagonal45_alpha12000.log`; no motor, fan, Codex-triggered run/search/shortest, identity/calibration/maze/trace-format/protected-NVM operation was issued; next HIL is three mode2 case0 sub3 repeats only. |
| 20260816-025933 | 20260816-025933-mode2-diagonal-entry-repeatability | mode2斜め入り再撮影からR45再現性を改善しR135安全余裕を維持 | n/a | partial | classified the six newest transferred Pixel recordings in the corrected user-stated order as three mode2 case0 sub3 R45-in runs (`manual-1786844652914-run0001..0003`) followed by three sub6 R135-in runs (`manual-1786844905639`, `1786845088213`, `1786845195106` run0001); all videos retained complete motion at approximately 240fps with zero Camera2 capture failures but all six missed optical STOP and were manually ended; strict whole-video blue/red tracking was contaminated by the blue/red STOP-emitter reflections, so used the board-corrected 720mm marker-span model, straight-trajectory headings, stable blue starts, and the red 2mm-reference-plane front label minus the measured 24mm baseline for endpoint reconstruction; sub6 was repeatable at median `171.444mm right / 113.497mm forward / -135.294deg` with sample SD `0.496/1.133mm/0.163deg`, retained R135-in `8400deg/s2,18.0/10.5mm` because its simulated raw/effective 70x39mm body clearance is `7.700/3.600mm` and offset-only removal of the `+2.05/+7.89mm` position residual would reduce effective clearance below zero or physically hit the canonical post; sub3 had two mutually close results `129.083/329.247/-44.793` with SD `0.912/0.602/0.034`, but the first physically ended at `121.278/311.419/-45.000`, proving a real high-alpha repeatability failure rather than a coordinate-average error; reduced only R45-in alpha `9500->8000deg/s2` and selected simulator-closing in/out `5.5/24.5->2.0/20.5mm`, retaining exact angle accumulation and 500mm/s while preserving raw/effective body clearance `8.047/3.947mm`; regenerated the PC route table at input SHA `a444a0e0...d94`, updated profile/route-time baselines, and passed 14210 precompute, 33464 route-preview, 166 runner-linear, 903 slalom-planner and 837 profile checks plus F413/F405 Debug builds and diff checks; Ubuntu worker SSH remained available but lacked `cc`/CMake, so C/build verification fell back to the Mac pending one-time package installation; committed/pushed the tuning as `a44214d`, built F413 RAM 78.40% / Flash 21.69% with ELF SHA-256 `eeb30541...cd`, flashed/verified/reset only application sectors 0--6 through ST-LINK `066CFF545771485067013914` at 3.24V, and confirmed non-motor UART IMU WHO_AM_I `0x6B` PASS in `f413_postflash_20260816_diagonal45.log`; no motor, fan, Codex-triggered run/search/shortest, identity/calibration/maze/trace-format/protected-NVM operation was issued; next required HIL is three sub3 repeats only. |
| 20260815-123835 | 20260815-123835-mode2-diagonal-entry-retune | 新盤面補正と機体外形余裕でmode2斜め入り45/135degを再調整 | n/a | partial | identified the six newest transferred Pixel runs `manual-1786793625158-run0001..0006` in the user-stated order as three mode2 case0 sub3 R45-in and three sub6 R135-in repeats; five clips missed optical STOP and were manually ended but all contained complete motion; added a glare-restricted pale-blue centre mask and joint blue/red 24mm-pair scoring because the sub3 lighting highlight had hidden the strict blue label in 85--87% of frames, then recovered both labels on every encoded frame of all six runs; trajectory-heading analysis measured blue-centre medians `125.942/347.162mm/-44.749deg` for sub3 and `171.014/90.286mm/-135.118deg` for sub6, with red-label/24mm height-insensitive reconstructions `124.745/344.253mm` and `169.555/88.514mm`; rejected the earlier `135/365` and `180/95mm` tuning targets because they came from the old 780mm marker-span model and do not match the actual `{S3,R45-in,DS1}` / `{S3,R135-in,DS1}` primitive geometry; kept exact angle accumulation and selected full-body simulator candidates against the canonical 45-in `(forward,lateral)=(90,45)mm` and 135-in `(45,90)mm` closures: R45-in `500mm/s, alpha 9500deg/s2, in/out 5.5/24.5mm` (endpoint error 0.033mm, raw/effective clearance 8.064/3.964mm) and R135-in `500mm/s, alpha 8400deg/s2, in/out 18.0/10.5mm` (0.016mm, 7.700/3.600mm) for the measured 70x39mm body; these are candidate-only because the empirical swept model is not yet safety-qualified and require three new videos each for final trim; regenerated the PC route table at input SHA `02ce6f6b...bef`, updated current-profile and route-time baselines, and passed 137 vision tests, 29 clearance tests, 14210 precompute checks, 33464 route-preview checks, 166 runner checks, 837 profile checks, solver exploration, F413/F405 builds, Python compile, and diff checks; committed tracking as `7f74aca` and tuning as `7defb8b`, built F413 RAM 78.40% / Flash 21.69% with ELF SHA-256 `72266a1e...6ad`, then flashed/verified/reset only application sectors 0--6 through ST-LINK `066CFF545771485067013914` at 3.24V and confirmed non-motor UART IMU WHO_AM_I `0x6B` PASS; no motor, fan, Codex-triggered run/search/shortest, identity/calibration/maze/trace-format/NVM operation was issued. |
| 20260815-113106 | 20260815-113106-mode2-small-r90-postflash-validation | mode2小回りR90の再撮影で1mm級収束を確認 | n/a | no | verified the three newest transferred Pixel runs `manual-1786792755718-run0001..0003` as post-flash mode2 case0 sub0 repeats; all reports were complete/acknowledged, START decoded cleanly as 5/0/0 votes, fixed focus/exposure and 239.999981fps sensor timing held, Camera2 failures were 0/5/0 with maximum encoded PTS interval <=4.900ms, and BD790 extraction found both centre-blue and front-red labels on every one of 4405/4541/4629 encoded frames; trajectory-heading analysis measured median `89.232mm right / 185.547mm forward / -87.354deg` with sample SD `0.337/0.274mm/0.599deg` against the `90/185/-90` full-path target, improving the pre-change `91.863/185.782mm` position and leaving only `-0.768/+0.547mm` error, so retained small-R90 `10200deg/s2, in/out 7.2/11.1mm` and made no further parameter/table/firmware change; the three swept paths visually overlapped without a contact discontinuity, while final-straight heading fits had 2.015..2.533mm p95 residual and therefore were not used to alter the exact 90deg angle-accumulator contract; separately found STOP token fields absent in all three 18.6..19.5s videos and in the preceding twelve videos, confirming a systematic optical-STOP regression masked by manual finish-run rather than a one-off miss; no build, flash/reset, UART, motor, fan, Codex-triggered run/search/shortest, or identity/calibration/maze/trace-format/NVM operation was issued. |
| 20260815-111422 | 20260815-111422-mode2-r90-validation-usb-transfer | mode2大小R90を再検証しPixel転送をUSB優先化 | n/a | partial | identified the newest six recorder runs `manual-1786790449443-run0001..0006` in the user-stated order as three mode2 case0 sub1 large-R90 and three sub0 small-R90 repeats, rsynced 1.05GB to Ubuntu worker `BD790`, and ran markerless extraction there in parallel; two long-tail sub1 videos had 2.1%/20.6% whole-video blue-label loss but all three retained at least 99.1% valid selected motion, and their relaxed diagnostic measured median `135.805mm right / 229.343mm forward / -88.436deg` with sample SD `0.942/0.622mm/0.325deg` against the `135/230/-90` target, so retained the newly tuned large-R90 `6900/13.0/20.5`; sub0 had complete tracking and measured median `91.863/185.782mm/-87.993deg` with SD `0.789/0.376mm/0.040deg` against `90/185/-90`, so retained speed/alpha/angle and applied one residual-limited offset correction `small-R90 in/out 8.0/12.8 -> 7.2/11.1mm`, predicting approximately `90.1/184.9mm` next video; the measured 70x39mm diagnostic swept-body model retained `10.52mm` raw / `6.42mm` effective small-R90 clearance and `15.18/11.08mm` large-R90 clearance, but remains model-scope-unqualified and was not treated as an absolute safety certificate; regenerated the PC route table at input SHA `0d5289e2...a6edd`, passed precompute 14210, route-preview 33464, path-linear 166, all 129 vision tests, F413/F405 Debug builds, Python compile and diff checks (Ubuntu lacked `cc`, so only C/build checks fell back to the Mac); confirmed Pixel 8 USB SuperSpeed at 5Gbit/s and implemented `auto|usb|wifi` transfer selection for CLI/dashboard using an identity-checked ADB TCP forward around the existing authenticated resumable HTTP/ACK protocol, with physical `usb:` device filtering, explicit serial selection and Wi-Fi fallback; real Pixel HIL checked all 271 retained runs through `transport=usb`, then read a 170.4MB MP4 at 125.09MiB/s, and restarted the loopback dashboard on port8765 with the new code; rebuilt the committed host state as `fea3228-dirty` (ELF SHA-256 `1f91f27a...d92f`) and flashed/verified/reset it through ST-LINK `066CFF545771485067013914` at 3.24V, erasing application sectors 0..6 only; no UART, motor, fan, Codex-triggered run/search/shortest command, or identity/calibration/maze/trace-format/NVM operation was issued, and the small-R90 change requires three post-flash sub0 videos for validation. |
| 20260815-101506 | 20260815-101506-bd790-turn-analysis-large-r90-retune | Ubuntu計算機へ動画解析を分散し新盤面補正でmode2大回りR90を再調整 | n/a | partial | configured passwordless LAN-only SSH from the Mac to Ubuntu worker `BD790` (`BD790.local`, Ryzen 16C/32T, 60GiB RAM, RTX 5070 Ti), cloned the same branch/SHA, installed an isolated uv CPython 3.12 vision environment, and verified 129 Mac vision tests plus 32 targeted remote tests; rsynced and SHA/size-verified all artifacts for six recorder-0.5.7 runs `manual-1786772183531-run0001..0006`, then analyzed them remotely as three mode2 case0 sub1 large-R90 and three sub2 large-R180 repeats using the measured 8x8/90mm board layout and blue-centre trajectories; found the Pixel HFR lighting shifts the front red label toward orange and then nearly white after motion, so added a front-label-only HSV mask without widening the legacy red cue mask, while retaining area/24mm-ring/prediction rejection and using ordered straight-trajectory heading for the actual turn fit; sub1 measured median `133.932mm right / 206.104mm forward / -89.459deg` with sample SD `0.229/0.756mm/0.084deg` against the full-path `135/230/-90` target, and its current zero-slip primitive predicted the same large forward deficit; applied a residual-corrected next candidate `large-R90 alpha 9400->6900deg/s2, in 0->13.0mm, out 29.8->20.5mm`, predicting about `135.00/229.70mm` in the next video and a diagnostic simulator raw/effective body clearance of `15.18/11.08mm` for the measured 70x39mm envelope; sub2 measured diagnostic position `83.080/90.661mm` with `0.791/1.217mm` SD, but its endpoint-closing candidate intersects a canonical post in the swept-body model, so retained all large-R180 parameters pending a safer dedicated iteration; regenerated/verified the PC motion table (14210 checks), updated the host profile/timing baselines, passed route preview 33464 checks, runner linear 166 checks, profile audit 837 checks, F413/F405 Debug builds, vision tests, and diff checks; no Pixel/ADB mutation, firmware flash/reset, UART, motor, fan, run/search/shortest, identity/calibration/maze/trace-format/NVM operation was performed, and simulator clearance remains candidate-only until repeated video confirms the new R90 trajectory. |
| 20260814-103526 | 20260814-103526-f413-motor-gear-breakin | ギヤ慣らし用の左右連続50% dutyモードを追加・実行 | yes | yes | added UART `~` for the F413: it directly enables both motors forward at duty `500/1000` and deliberately returns to the command loop without a software stop path, so an ST-LINK reset returns the driver to boot-time disabled state; documented it as a red HIL command. `cmake --build --preset Debug-stm32f413`, `cmake --build --preset Debug-stm32f405`, and `git diff --check` passed; committed/pushed as `077c794`. The user explicitly confirmed the robot was lifted/secured and on external power. Initial flash attempts failed because ST-LINK `066CFF545771485067013914` reported 3.24V but could not obtain a core ID; after the user connected the debugger, connect-under-reset/hardware-reset detected STM32F413/F423 ID `0x463`, programmed and verified only application sectors `0..6`, then performed a software reset. UART `/dev/cu.usbmodem211202` at 921600 8N1 received one `~` command and returned `[HW-TEST][Motor] BREAK-IN ac...`, confirming the continuous break-in mode started. Motors are allowed and remain active at left/right forward 50% duty; no fan or NVM/identity/calibration/maze/trace-format operation was issued. |
| 20260812-070000 | 20260812-070000-full-board-metric-calibration | 四隅で発覚した30mm縮尺誤差を盤面多数点補正へ置換 | n/a | partial | accepted the user's ruler-based +/-2mm placement accuracy and reclassified the four 26--30mm inward corner errors as a systematic board-coordinate failure rather than placement noise; the four known points imply approximately `x*1.066` and `y*1.071` correction with sub-mm affine residual, while applying Pixel Camera2 intrinsic/distortion changes the edge result by only about 1mm, so the dominant defect is the configured versus physical fixed-marker metric span; retained the four ArUco markers for per-frame registration but added a separate dense `board_metric_geometry` polynomial map, an empty-board detector for a four-marker-anchored 8x8 lattice of flush matte 8mm cell-centre dots, a manifest/CSV fitter, fit/held-out evidence, SHA/layout/canonical/reference-plane bindings, and hard qualification gates requiring 32 total/24 fit/8 held-out points, 300000mm2 coverage, fit p95 <=0.75mm, held-out p95 <=1.0mm and maximum <=1.5mm; integrated a qualified map into markerless x/y/velocity output, known-pose label-plane fitting, and height-correction application, and made a new label-plane fit fail until the dense metric map exists; documented periodic-line limitations, the preferred permanent dot or removable rigid ChArUco/dot target, and a global-shutter fallback; 123 vision tests, Python compile, and diff checks passed; no firmware/params/build/flash, ADB/Pixel mutation, UART, motor, fan, run/search/shortest, identity/calibration/maze/trace/NVM operation was performed; the five captured poses remain diagnostic-only and the next action is installing/measuring the full-board target and qualifying its held-out map before repeating label-plane calibration |
| 20260812-031113 | 20260812-031113-pixel-057-fixed-focus-hil | Pixel 8へ0.5.7を保持更新し固定焦点ワンショットを実機確認 | n/a | yes | confirmed USB-debug Pixel 8 `38301FDJH0009W`, stopped the idle recorder, and upgraded `com.nightfall.hfrrecorder` from 0.5.5/code19 to 0.5.7/code21 with `adb install -r` using APK SHA-256 `14dda20d...fdec2`; selected only the one-time Play Protect non-submission path and preserved all 239 retained/acknowledged runs plus the existing Wi-Fi pairing; verified the new manual one-shot UI and authenticated Mac control, then captured, stopped, retained, Wi-Fi-collected, and acknowledged one 7.023s 1920x1080/240 diagnostic run as `manual-1786504038887-one-shot-run0001`; focus settled in 616.65ms with 65 stable observations, requested 1.05D and applied 1.0325859D, and all 1640 Camera2 results retained identical focus, AF_OFF, stationary lens, focal length, crop, zoom, intrinsic and distortion metadata at measured 239.99998fps with zero capture failures; the encoded MP4 contained 1637 frames at 239.9808fps with maximum PTS interval 4.366ms, and report-side size/SHA identities for video and both sidecars matched the collected bytes; the app was left open and idle with saved/acknowledged count 240; no firmware build/change/flash/reset, UART, motor, fan, run/search/shortest/path/tune, identity/calibration/maze/trace-format/NVM operation was performed, and the next action is a motor-off continuous five-pose label-plane calibration capture |
| 20260812-020130 | 20260812-020130-aruco-reference-plane-height | 3D造形ArUco上面2mmを視差校正基準面へ固定 | n/a | partial | recorded the user-confirmed current 3D-printed ArUco marker thickness/top-surface height as 2.0mm above the maze floor in the five-pose calibration manifest with fixture/date provenance; because the red front label is also at 2.0mm, fixed the geometry contract and regressions so red board coordinates remain unchanged while only the 10.0mm blue centre receives the 8.0mm relative-plane correction; added recorder 0.5.7/code21 manual one-shot capture to the Pixel UI, authenticated Wi-Fi API, CLI, and Mac dashboard; changed every HFR session to AF-off fixed 1.05D focus, required a preview-only 250ms stable/stationary-lens interval before arming or recording, and retained applied focus/AF/lens/static geometry in the report and per-frame sidecar; added report-side SHA-256/size identities for the MP4 and Camera2 sidecar plus a fail-closed host capture fingerprint that rejects cross-run mixing, metadata changes, moving focus, and recorder 0.5.6-or-earlier for absolute qualification while still loading legacy 0.5.5 diagnostically; bound this fingerprint into the four-fit/one-held-out label-plane calibration, height-correction application, and production verifier, and allowed the hand-obscured movement intervals between the five stationary placements while keeping each hold's strict stability gates; 113 vision tests, 29 turn-clearance tests, three optical/motion/Wi-Fi Java host tests, Android app/recorder assemble and lint, Python/JavaScript/shell/JSON syntax, and diff checks passed; the built recorder APK SHA-256 was `14dda20d...fdec2`; no Pixel install/recording/ADB device, firmware/source/parameter/build/flash, UART, motor, fan, run/search/shortest, identity/calibration/maze/trace-format/NVM operation was performed; final absolute-scene qualification remains blocked only on installing 0.5.7 and acquiring the one fixed-rig five-pose stationary capture, and the 2.0mm reference must be remeasured after any marker-fixture or mounting change |
| 20260811-130156 | 20260811-130156-label-plane-parallax-calibration | 青10mm・赤2mmラベルの視差補正と絶対掃引安全ゲートを構築 | n/a | partial | recorded the user-measured blue/red label surface heights as 10/2mm above the maze floor with the existing 24mm horizontal baseline and coincident blue/machine/turn centre; added the ray/parallel-plane correction `P=C+(H-h)/(H-h_ref)*(Q-C)` independently for both labels, a fail-closed fixed-camera fit using four board-spanning 2s stationary poses plus one independent held-out pose, hard span/hull/hold/stability/residual/camera-height gates, non-overwriting corrected CSV generation, and SHA-bound sidecars that verify the board layout, measured 70x39mm tracking geometry, camera geometry, source board calibration, unchanged-rig operator assertion, and original validity flags; made `turn_video_tune --propose-fit` require five corrected repeats with one coherent calibration, a zero blue-centre anchor, non-weakenable quality/step limits, and source SHA reporting; made absolute `turn_clearance video` require corrected trajectories, a measured 70x39mm-or-larger footprint, conservative uncertainty/margin floors, a qualified complete-obstacle scene bound to board and maze-topology hashes, non-weakenable completeness/interpolation/endpoint/heading limits, and trajectory/sidecar hashes, while normalized analysis remains diagnostic; added a portable current 60mm-marker board layout and five-pose manifest template; upgraded the Pixel recorder additively to 0.5.6/code20 so capture rows retain focal length, intrinsics, distortion, crop, zoom and active physical camera ID and reports retain static sensor geometry; 77 vision tests, 29 clearance tests, Android app/recorder assemble and lint, all three optical/motion/Wi-Fi host tests, Python compile, shell syntax and diff checks passed; no firmware parameter/source/build/flash, ADB/install, UART, motor, fan, run/search/shortest, identity/calibration/maze/trace-format/NVM operation was performed; absolute reanalysis and turn-parameter changes remain intentionally blocked until the common ArUco top-surface height above the maze floor is measured and the five-position stationary calibration is captured without moving the current camera/board rig |
| 20260811-110907 | 20260811-110907-measured-footprint-and-clearance-model-audit | 実測70x39mm外形を固定しR135掃引モデルをfail-closed化 | n/a | partial | recorded the user-confirmed completed `mini_r2_0_unit001` envelope as 70x39mm centred on the coincident blue-label/machine/turn centre (35mm front/rear, 19.5mm left/right) and made it the provenance-bearing default for every simulator/search/video report; expanded alpha search from one quantized closure pair to every bounded 0.5mm in/out pair that the actual 1ms discrete simulator places inside the endpoint/heading gates, with a 4096-pair/alpha guard; fixed-alpha 10250 robust evaluation now checks 19 candidates and improves the best diagnostic from 23.0/32.0 to 24.5/33.0mm, but raw/effective clearance is only 4.781/0.682mm against the required 3mm effective margin, so no parameter is emitted or applied; re-audited all 27 historical R135-in videos and found endpoint-fit/full-path-fit disagreement (trajectory-start-corrected K=0.0261 versus full-path K=0.0178 with 2.89mm RMSE, while the legacy normalized endpoint K=0.03303), so marked that artifact diagnostic-only and made non-zero model qualification fail closed unless an artifact explicitly declares `safety_qualified=true`; also made the unvalidated zero-slip ideal model diagnostic-only so omitting the empirical artifact cannot emit a false-safe C assignment; verified both previous bypasses now return status1 with zero qualified candidates even when geometric margin passes; optimized repeated clearance checks by sorting/caching obstacle geometry and pruning every AABB-separated obstacle after overlap; 26 clearance tests including brute-force AABB and R135/180 offset-grid equivalence, plus diff checks, passed; no firmware parameter, route table, build, flash, UART, ADB, motor, fan, run/search/shortest, identity/calibration/maze/trace-format/NVM operation was performed; new isolated multi-alpha/right-left video calibration and label-height-aware absolute scene registration remain required before applying R135-in changes |
| 20260811-070314 | 20260811-070314-clearance-aware-turn-tuning | 車体外形・壁・柱の余裕を使うターン調整系を実装 | n/a | partial | independently implemented a host clearance workflow after reviewing the unlicensed `pidream/turn_simulator01` visualization concept: `turn_clearance.py` evaluates a full asymmetric front/rear/left/right body rectangle against explicit standalone 6mm posts and wall panels, adaptively bounds between-frame corner motion, separates raw gap from mechanical/model-or-video/heading/interpolation uncertainty and requested free margin, reports contact/penetration/closest body feature, renders PNG/SVG-compatible plots, searches alpha while solving/quantizing canonical in/out offsets, and applies the same gate to measured trajectories; kept `turn_tune.py` general shortest default on configured angles for mode2 case1/2 while clearance reproduces angle-accumulator 45/90/135/180deg runs; video extraction aligns the complete nominal omega profile and rejects truncated angle/out-offset, insufficient pre/post-roll, large pose gaps, endpoint error, and heading error; normalized registration is explicitly a shape/repeatability gate while absolute board-coordinate registration with a matching measured scene is required for physical clearance; indexed nine R135-in parameter sets/27 non-contact videos plus the latest contact video/trace with portable parameter/report/trajectory/source digests; current mode2 R135-in `10250/3.5/22.0` zero-slip simulation first intersects the inner post at -63.3deg, consistent with the observed contact near -67deg; an R135-specific empirical velocity-heading-lag coefficient `K=0.03303s^2/m` fitted the final no-contact core endpoint to 0.52mm and is safety-eligible only when its artifact is explicitly bound and mode/code/side/speed/alpha/positive-entry scope matches; none of 29 candidates passed both zero-slip and empirical paths with the provisional 70x39mm envelope, default uncertainty, and 3mm margin, so the tool emits only a `best_diagnostic_do_not_apply`, no C assignments, and no firmware param change; eventual mode2 param changes require route-precompute regeneration/tests before build/run; 20 clearance/manifest tests, 26 video-pipeline tests, Python compile, and diff-check passed; no build/flash/UART/ADB/motor/fan/run/search/shortest/NVM operation was performed |
| 20260811-050856 | 20260811-050856-f413-diagonal-route-executable-hil | PC事前計算とsmall90回復でmode2斜め最短経路を実行可能化 | 3d15557 | yes | moved mode2 case6..9 turn geometry/poses, turn times, connector times, and wall-end approach times into a deterministic 76,720-byte const Flash table generated on the PC (input SHA `66692417...cde1`, zero RAM); added LOW-only wall states and a gated/recovery small90 fallback when nominal run-up or a stoppable terminal is unavailable; set the case6/7/8 orthogonal/diagonal speed and acceleration ladder to `1000/800 @ 1000`, `1250/900 @ 3000`, and `1500/1000 @ 4000`; changed the runner to coalesce adjacent S/DS codes and dry-preflight the complete path with the controller's exact constant-acceleration contract before enabling motors; route precompute 14210, route motion 1195, runner 153, saved-maze route/production-preflight integration 33464, slalom host 209, legacy codec 51, profile audit 837, fixed 240-configuration KERI matrix, solver exploration, F413 and both F405 Debug builds, and diff checks passed; committed/pushed `3d15557`, then built the intentionally dirty application (only preserved unrelated worklog/flashing edits; ELF SHA-256 `d3006c73...1311`, RAM 78.40%, Flash 21.63%) and flashed/verified/reset it through ST-LINK `066CFF545771485067013914` at 3.24V, erasing application sectors 0..6 only; read-only/non-motor UART `+` on `/dev/cu.usbmodem211202` loaded the saved FRAM maze and compiled `G(1,0)`, producing case6 in 7208ms with 17 codes/2 diagonal turns/1 diagonal straight/small recovery, case7 and case8 in 4314ms with 13 codes/5 diagonal turns/1 diagonal straight/no recovery, and case9 in 7208ms with the case6-style recovery path; every case ended status=ok, scratch=released at 138628/223232 bytes, motors=off, nvm=read-only; log `tools/logging/logs/f413_route_sweep_20260811T050856Z.log`; no motor, fan, run/search/shortest/path/tune, identity/calibration/maze/trace-format/protected-NVM command was issued, so physical validation remains case6 first, then case7 and case8 |
| 20260811-035341 | 20260811-035341-f413-saved-route-preview-hil | mode2 case6〜9の保存迷路経路導出を無走行で実機検証 | n/a | yes | added read-only/non-motor UART `+` to run the exact saved-FRAM/compiled-goal KERI planner for mode2 cases6..9, print any executable legacy path, and report per-case elapsed time; documented the command as green HIL and added elapsed telemetry coverage; route-preview host tests passed with 1096 checks, both F413 and F405 Debug builds passed, and `git diff --check` passed; flashed/verified the dirty F413 application through ST-LINK `066CFF545771485067013914` at 3.24V with software reset, erasing application sectors 0..6 only and preserving FRAM; non-motor UART `/dev/cu.usbmodem211202` first showed the older diagnostic-centre `K` load the FRAM maze with zero normalized wall mismatches and consume 117959ms before no-path, then exact `+` HIL loaded the saved map and compiled `G(1,0)` and returned `plan status=1`, `expanded=1`, `relaxed=0` for every case6..9 after 115025/115028/115024/115027ms respectively, emitting no path codes; FRAM `@` dump showed start `(0,0)` bounded east/south/west with the explored exit north, so the observed OP no-motion is a long synchronous motion-geometry preparation followed by failure to create any legal first nominal-speed #1--#5 edge, not a hang or FRAM-read failure; no motor, fan, run/search/shortest/path/tune, identity/calibration/maze/trace-format/protected-NVM operation was issued |
| 20260810-153151 | 20260810-153151-f413-mode2-diagonal-shortest-run | mode2 case6〜9へ斜め時間最短経路を接続 | 61039c4 | yes | imported the prior fixed-memory KERI #1--#5 diagonal planner foundation onto the current F413 branch and connected mode2 OP cases6..9 to executable route generation; run generation requires a valid saved FRAM maze and compiled `GOAL1..9`, uses each selected case's straight/diagonal limits plus all current calibrated mode2 turn timings, limits output to nominal-speed turns and a cardinal stop tail representable by the legacy runner, transactionally emits and validates `path[]`, and clears stale output on every failure; retained the compact 1ms trace staging capacity by leasing its 223232-byte RAM workspace only before trace/run start with IRQ-gated ownership; kept UART `K` as a non-motor diagnostic with its independent centre-goal/fallback policy; host checks passed with route motion 1171, clearance 53, planner 137, slalom planner 903, profile audit 837, legacy codec 17954, plan codec 30, pipeline 17, and F413 route 1092 checks under ASan/UBSan, plus solver exploration; Debug F413 built at RAM 78.40%/Flash 17.17% and both F405 targets built; committed `61039c4`, rebuilt clean, flashed/verified only application sectors 0..6 through ST-LINK `066CFF545771485067013914` at 3.24V with software reset, then non-motor UART `i,w,v` confirmed IMU/wall diagnostics, `fw_git_sha=61039c4`, `fw_git_dirty=0`, and zero motor outputs; no motor, fan, run/search/shortest/path/tune, identity/calibration/maze/trace-format/protected-NVM operation was issued, so first floor validation remains mode2 case6 on a known saved maze |
| 20260810-144319 | 20260810-144319-mode2-135out-final-validation | mode2斜め135度脱出の追試3本で収束確認 | n/a | no | analyzed the three newest transferred Pixel videos as mode2 case0 sub7 L135-out confirmation trials after the `alpha/out=8850deg/s2/12.0mm` correction; all three reports were complete with exact 5/0/0 START votes, 239.981fps encoded timing, zero Camera2 failures, and maximum encoded PTS intervals at most 4.611ms; the first two recordings missed STOP and lasted 28.40/22.45s, with 37.4ms CaptureResult timestamp gaps but continuous encoded video, while the third decoded STOP at exact 0/5/0; measured-layout extraction had zero homography fallback and blue-centre detection of 6757/6757, 5324/5325, and 4149/4149 frames; entry-trajectory heading fits spanned 93.59..95.19mm with residual p95 at most 0.190mm; the repeated endpoint median was 225.80mm right / 227.83mm forward with sample SD 0.97/0.18mm against the 225/230mm target, and paths were 601.98..602.57mm, so the residual 0.80/-2.17mm was accepted as converged and all mode2 135-out parameters were retained; angle telemetry remained excluded from tuning as requested; no firmware/source/parameter change, build, flash, reset, UART, ADB, motor, fan, run/search/shortest/path/tune command, or identity/calibration/maze/trace-format/protected-NVM operation was issued |
| 20260810-113305 | 20260810-113305-mode2-diagonal-exit-validation-retune | 追試9本から斜め脱出調整を収束・135outを再補正 | n/a | yes | inspected the nine newest transferred Pixel recordings and classified them by trajectory rather than assumed order as four mode2 case0 sub4 L45-out, two sub5 L-V90, and three sub7 L135-out trials; all nine had clean 5/0/0 START votes, 239.981fps encoded timing, and MP4 maximum PTS intervals at most 4.733ms; one file reported 32 Camera2 result failures without an encoded gap, two missed STOP, and two decoded STOP with one/two erasures, but every motion trajectory was retained; the widened seeded blue-label tracker obtained 4039/4053 or better centre frames for all sub4/sub5 videos and complete usable motion in all sub7 videos despite post-run LED/label overlap; entry-trajectory position frames measured sub4 median 133.76/456.68mm right/forward over four runs (SD 1.07/1.08) and sub5 -1.34/543.19mm over two runs (SD 1.59/0.88), so both were retained against 135/455 and 0/545mm targets; sub7 measured 229.07/229.37mm over three runs (SD 1.61/1.86) against 225/230mm, so retained velocity/angle/entry and changed only 135-out alpha/out `8200/10.5 -> 8850deg/s2/12.0mm`, whose model predicts a conservative -3.12/+0.44mm right/forward correction; all 53 vision tests, F413/F405 builds, solver-host exploration, turn simulation, and diff checks passed; built and flashed/verified dirty application `69ec88f` through ST-LINK `066CFF545771485067013914` at 3.24V using normal SWD/software reset, erasing only application sectors 0..5; no UART, ADB mutation, motor, fan, Codex-triggered run/search/shortest/path/tune, identity/calibration/maze/trace-format/protected-NVM operation was issued |
| 20260810-092849 | 20260810-092849-mode2-diagonal-exit-v90-retune | mode2斜め脱出・V90を9走行から初回調整 | n/a | yes | excluded the user's first failed no-space recording and classified the next nine transferred Pixel videos as three each of mode2 case0 sub4 L45-out, sub5 L-V90, and sub7 L135-out; all nine MP4s were complete at 239.981fps with zero Camera2 capture failures and clean 5/0/0 START votes, while two sub4 and two sub7 recordings missed STOP and ran 24.5..27.2s but retained complete motion; widened the matte-blue centre-label mask for the current overhead view and fixed `--initial-x/y-cell` so it seeds the selected blue-label tracker rather than only the green fallback; added `--heading-source trajectory-start` for multi-turn trials with an initial straight but no final straight, using the entry trajectory to remove label-height parallax from the position frame while retaining label yaw only as non-tuning telemetry; robust right/forward medians were sub4 148.29/476.95mm (SD 1.67/0.82), sub5 -10.90/535.58mm (SD 0.12/2.14), and sub7 234.93/235.22mm (SD 3.09/2.58) against 135/455, 0/545, and 225/230mm targets; retained all velocities and configured angles and applied a conservative 75% position correction: 45-out alpha/in `7700/15.0 -> 10500deg/s2/7.5mm`, V90 in/out `2.0/28.0 -> 12.8/27.2mm`, and 135-out alpha/out `6950/12.0 -> 8200deg/s2/10.5mm`; all 53 vision tests, Python compile, F413/F405 builds, solver-host exploration, three turn simulations, and diff checks passed; built and flashed/verified dirty application `078220a` through ST-LINK `066CFF545771485067013914` at 3.24V using normal SWD/software reset, erasing only application sectors 0..5; no UART, ADB mutation, motor, fan, Codex-triggered run/search/shortest/path/tune, identity/calibration/maze/trace-format/protected-NVM operation was issued |
| 20260810-081000 | 20260810-081000-mode2-diagonal-entry-postflash-validation | 書込み後6走行で斜め進入調整の収束と実行値を確認 | n/a | no | identified the six newest transferred Pixel recordings in `manual-1786342957398` as three mode2 case0 sub3 R45-in runs followed by three sub6 R135-in runs; all six completed with exact START 5/0/0 and STOP 0/5/0 votes, centre/front labels detected on every encoded frame, no homography fallback, and 239.981fps encoded timing; five had zero Camera2 capture failures, while run3 reported 23 CaptureResult callback failures including a 37.7ms sensor-result gap but its encoded MP4 remained continuous to 4.434ms maximum PTS interval and extracted completely; ordered blue-centre trajectory heading measured sub3 median 133.61mm right / 361.23mm forward / -45.85deg with sample SD 0.77mm / 1.57mm / 0.08deg against 135/365mm, and sub6 median 178.05mm / 97.43mm / -135.03deg with SD 1.61mm / 2.81mm / 0.18deg against 180/95mm; retained all parameters because residuals are already within 3.8mm and the observed change from the prior three-run set is smaller than trial dispersion, so another offset correction would overfit; read-only HIL on `/dev/cu.usbmodem211202` at 921600 used ST-LINK `066CFF545771485067013914` only for software reset/flash reads and UART `v` then completion-waited `V`: boot reported `6b4403d-dirty`, direct application reads confirmed R45-in `6200/44.6/23.5/10.5` and R135-in `10250/133.9/3.5/22.0`, and the retained full sub6 trace `tools/logging/logs/stm32_log_20260810_170901.csv` contained 2709 records at 1ms median period through forward/turn/diagonal/coast completion with target -135.0deg and retained angle target -135.202deg; trace analysis completed without any motor/fan/run/search/shortest command, firmware flash, or identity/calibration/maze/trace-format/protected-NVM write |
| 20260810-060344 | 20260810-060344-wifi-zero-artifact-recovery-and-diagonal-entry-trim | Wi-Fi転送停止を復旧し斜め進入の最終残差を補正 | n/a | partial | reproduced the user's Wi-Fi collection failure at `manual-1786340520382-run0004`: the Pixel had retained a diagnostic `status=error` report (`MediaRecorder produced no MP4 data`) with zero-byte capture/encoder artifacts, and the Mac collector treated an absent zero-byte `.part` file as complete before calling `os.replace`, raising `FileNotFoundError`; changed the resumable downloader to durably create a missing zero-byte partial before atomic publication and added a regression test; reran collection successfully, preserving and acknowledging the diagnostic run and transferring the second three-run session, after which Pixel status was saved=201/acknowledged=201 with no active transfer; analyzed the six requested latest complete videos as three mode2 case0 sub3 R45-in runs followed by three sub6 R135-in runs: all had exact START 5/0/0 and STOP 0/5/0 votes, 239.981fps encoded timing, zero Camera2 failures, 100% blue-centre tracking, at most two red-label misses in a sub3 video, and no homography fallback; ordered blue-centre straight-trajectory heading measured sub3 median 133.66mm right / 361.09mm forward / -45.86deg with sample SD 0.66mm / 0.51mm / 0.11deg against 135/365mm, and sub6 median 177.92mm / 97.05mm / -135.21deg with SD 0.92mm / 1.03mm / 0.15deg against 180/95mm; retained angles, velocities, and angular accelerations and changed only R45-in entry/exit `21.5/9.0 -> 23.5/10.5mm` and R135-in exit `19.5 -> 22.0mm`; all 51 vision tests, Python compile, F413/F405 builds, solver-host exploration, both turn simulations, and `git diff --check` passed; ST-LINK `066CFF545771485067013914` was visible at 3.24V but normal, low-speed UR/HW-reset, and HWRSTPULSE attempts all failed before erase with `Unable to get core ID`, so the new application was not written and existing MCU flash/NVM was untouched; no UART, ADB mutation, motor, fan, Codex-triggered run/search/shortest/path/tune, identity/calibration/maze/trace-format/protected-NVM operation was issued |
| 20260810-050554 | 20260810-050554-mode2-diagonal-entry-final-small-retune | 同一条件6走行から斜め進入の残差を小補正 | n/a | yes | analyzed the six newest transferred Pixel recordings as three mode2 case0 sub3 R45-in trials followed by three sub6 R135-in trials using ordered blue-centre straight-trajectory heading; every recording completed in 16.6..16.9s with exact 5/0/0 START and 0/5/0 STOP votes, 239.981fps encoded timing, zero Camera2 failures, and 100% blue-centre detection; sub3 measured median 134.08mm right / 362.18mm forward / -45.84deg with sample SD 0.94mm / 1.13mm / 0.12deg against the 135/365mm position target, with minimum fitted-straight span 96.50mm and maximum residual p95 0.281mm; sub6 measured median 181.92mm / 93.65mm / -135.52deg with SD 0.83mm / 1.47mm / 0.05deg against 180/95mm, minimum span 104.59mm, and maximum residual 0.228mm; retained both configured angles and velocities, used the measured isolated R45 exit response to change entry/exit `19.5/8.5 -> 21.5/9.0mm`, predicting roughly 134.8/364.9mm, and changed R135-in alpha/entry `9750/1.5 -> 10250deg/s2/3.5mm` while retaining 19.5mm exit, predicting roughly 179.8/95.1mm with 957deg/s peak omega below the 2200deg/s cap; all 50 vision tests, F413/F405 builds, solver-host exploration, exact-turn simulations, and `git diff --check` passed; flashed and verified the `0bdcdbf-dirty` F413 application through ST-LINK `066CFF545771485067013914` at 3.24V using connect-under-reset/hardware reset, erasing only application sectors 0..5 and resetting afterward; no UART, ADB, motor, fan, Codex-triggered run/search/shortest/path/tune, identity/calibration/maze/trace-format/protected-NVM operation was issued |
| 20260810-043417 | 20260810-043417-mode2-diagonal-entry-trajectory-retune | 軌跡方位による追試6走行から斜め進入を段階再補正 | n/a | yes | processed the six newest transferred Pixel recordings in chronological order as three mode2 case0 sub3 R45-in trials followed by three sub6 R135-in trials using the new ordered straight-trajectory heading; all six had clean 5/0/0 START votes, 239.981fps encoded timing, and zero Camera2 capture failures, while the third and fifth recordings missed STOP and ran 22.2/25.3s but retained complete motion; standard narrow-mask extraction detected the blue centre in every frame of five videos and 6007/6029 frames of the remaining long-tail sub6 video, with selected-motion valid fraction at least 0.997; sub3 measured median 144.89mm right / 372.39mm forward / -46.07deg with sample SD 0.29mm / 1.39mm / 0.17deg, minimum fitted-straight span 99.58mm, and maximum residual p95 0.317mm; sub6 measured median 182.71mm / 81.99mm / -135.62deg with SD 2.12mm / 1.57mm / 0.47deg, minimum span 102.52mm, and maximum residual 0.236mm; a same-board-position comparison showed that changing only R135-in entry from 1.5mm to zero moved forward displacement from 98.50mm to 81.99mm, exposing a non-linear zero-segment boundary, so restored the known 1.5mm value; retained all angles, velocities, angular accelerations, and entry values otherwise, and made an isolated conservative R45-in exit correction `16.0 -> 8.5mm`, geometrically predicting the next sub3 near 139.5/367.2mm right/forward; all 50 vision tests, F413/F405 builds, solver-host exploration, exact-turn simulations, and `git diff --check` passed; flashed and verified the `b669ad3-dirty` F413 application through ST-LINK `066CFF545771485067013914` at 3.24V using connect-under-reset/hardware reset, erasing only application sectors 0..5 and resetting afterward; no UART, ADB, motor, fan, Codex-triggered run/search/shortest/path/tune, identity/calibration/maze/trace-format/protected-NVM operation was issued |
| 20260810-041155 | 20260810-041155-trajectory-heading-diagonal-retune | 位置依存視差を避ける軌跡方位推定を実装し斜め進入を再調整 | n/a | yes | added `turn_video_tune.py --heading-source trajectory`, which estimates ordered start/end headings from cumulative-path fractions 8..32% and 68..92%, rejects either fit below 30mm projected span or above 3mm p95 perpendicular residual, requires zero anchor offsets, wraps turn yaw by requested side, and records source/span/residual/sample telemetry in the v2 report; documented that unequal-height blue/red labels have position-dependent floor-homography parallax and added synthetic tests proving trajectory heading ignores biased label yaw and rejects curved fit windows; formally reprocessed the four newest mode2 case0 sub3 R45-in trajectories, including changed board positions/headings and one 79.7%-valid diagnostic recovery, at median 152.06mm right / 355.59mm forward / -45.72deg with sample SD 1.17mm / 0.83mm / 0.21deg, and the three sub6 R135-in trajectories at median 181.92mm / 98.12mm / -135.11deg with SD 1.04mm / 2.02mm / 0.38deg; all fourteen line fits spanned at least 96.66mm and had residual p95 at most 0.438mm, confirming the prior large spatial spread was label-height parallax; kept angles, velocities, and angular accelerations unchanged as requested, applied a conservative 75% position correction to R45-in offsets `0.0/34.0 -> 19.5/16.0mm`, and used the non-negative entry-offset constraint for R135-in `1.5/19.5 -> 0.0/19.5mm`, predicting the next sub3 near 139.17/362.52mm right/forward and sub6 near 181.92/96.62mm; all 50 vision tests, Python compile, F413/F405 builds, solver-host exploration, exact-turn simulations, and `git diff --check` passed; flashed and verified the `9bc0702-dirty` F413 application through ST-LINK `066CFF545771485067013914` at 3.24V using connect-under-reset/hardware reset, erasing only application sectors 0..5 and resetting afterward; no UART, ADB, motor, fan, Codex-triggered run/search/shortest/path/tune, identity/calibration/maze/trace-format/protected-NVM operation was issued |
| 20260810-034827 | 20260810-034827-two-label-spatial-parallax-diagnosis | 配置変更7走行で二ラベル角度の位置依存パララックスを確認 | n/a | no | analyzed the seven newest transferred Pixel runs as four mode2 case0 sub3 R45-in trials deliberately split across two start positions/headings followed by three sub6 R135-in trials; all recordings contained complete runs, START was typed correctly in all seven, two missed STOP and ran 20.36/21.88s, and 13/2 isolated Camera2 failures caused no encoded trajectory gap; the narrow blue-label mask failed 81.9..88.2% of frames in three rotated/relocated sub3 videos because the matte blue label became pale cyan under view/illumination angle, while a diagnostic wider mask recovered 5204/5205 and 4837/4837 frames in two and retained a continuous motion core plus stable endpoint in the third; label-vector heading produced two incompatible sub3 groups near 163/351mm and 132/363mm right/forward despite stable 385.2..388.0mm endpoint radius and 414.6..416.9mm path length; fitting the ordered blue-centre trajectory direction on the initial/final straight segments instead reduced all four sub3 trials to 152.4+/-1.2mm right, 355.4+/-0.8mm forward, and -45.80+/-0.23deg, and reduced the three spatially varied sub6 trials to 182.3+/-1.0mm right, 97.2+/-2.0mm forward, and -135.14+/-0.38deg; this confirms that the prior fixed front-label bias is not valid over the full maze because the four ArUco markers define the floor plane while the blue battery-top and red PCB labels sit at different heights, making their apparent vector depend on image position, and supersedes the previous worklog assertion that the large position-dependent spread represented real run variation; no firmware parameter was changed and no build, flash, reset, UART, ADB, motor, fan, run/search/shortest/path/tune, identity/calibration/maze/trace-format/NVM operation was issued; the next correction should derive tuning-frame heading from the known straight trajectory segments or use labels at equal height before any further parameter edit |
| 20260810-023940 | 20260810-023940-mode2-diagonal-entry-convergence-retune | 追試6走行の局所応答からmode2斜め進入オフセットを再補正 | n/a | yes | processed the six newest transferred Pixel recordings as three mode2 case0 sub3 R45-in trials followed by three sub6 R135-in trials using the fixed four-marker 90mm layout and calibrated blue-centre/red-front 24mm pair; all six retained valid centre/front labels and homography on every encoded frame, one 21.47s file missed STOP but retained a complete run, and one file reported 32 Camera2 capture failures without any encoded-frame tracking loss; sub3 endpoints were 372.98/136.05, 380.21/145.76, and 378.10/147.98mm forward/right with median 378.10/145.76mm and yaw -48.40deg against 365/135/-45, exceeding the 5mm lateral repeatability gate, while sub6 was repeatable at mean 103.72+/-1.74mm forward, 177.84+/-0.23mm right, and -134.44+/-0.46deg against 95/180/-135; individual trajectory plots and pose windows confirmed real motion variation rather than tracker failure; retained configured angles, velocities, and angular accelerations, interpolating the prior/current local physical response through offsets only: R45-in in/out `0.5/36.5 -> 0.0/34.0mm` and R135-in `4.0/17.5 -> 1.5/19.5mm`; local measured response predicts roughly 365/135mm for sub3 and 95/180mm for sub6; F413/F405 builds, solver-host exploration, exact-angle simulations, and `git diff --check` passed, with one transient parallel Ninja log race cleared by the successful standalone F405 build; normal SWD flashing twice failed before erase with `Unable to get core ID`, then a non-destructive connect-under-reset recovered Device ID 0x463 and the `682576a-dirty` application was flashed and verified through ST-LINK `066CFF545771485067013914` at 3.24V using hardware reset, erasing only sectors 0..5 and software-resetting afterward; no UART, ADB, motor, fan, Codex-triggered run/search/shortest/path/tune, identity/calibration/maze/trace-format/protected-NVM operation was issued |
| 20260809-082646 | 20260809-082646-mode2-diagonal-entry-offset-retune | 追試6走行からmode2斜め進入の前後オフセットを再調整 | n/a | yes | analyzed the six newest transferred Pixel recordings in chronological order as three mode2 case0 sub3 R45-in trials followed by three sub6 R135-in trials using the fixed four-marker 90mm layout and calibrated blue-centre/red-front 24mm pair; all six had complete centre-label tracking and zero Camera2 capture failures, five had exact START 5/0/0 and STOP 0/5/0 votes, and the second file missed STOP but retained a complete trajectory in its 20.79s recording; sub3 turn-core heading-valid fractions were 0.775..0.796 and sub6 centre/front labels were valid on every frame; measured mean +/- sample SD endpoints were sub3 362.07+/-0.38mm forward, 132.75+/-2.00mm right, and -46.21+/-0.26deg against 365/135/-45, and sub6 84.49+/-0.52mm forward, 186.75+/-0.95mm right, and -133.53+/-0.51deg against 95/180/-135; retained both configured angles, velocities, and angular accelerations, and applied an approximately 90% geometry-only correction through deterministic straight offsets: R45-in in/out `0.0/33.5 -> 0.5/36.5mm` and R135-in `0.0/25.5 -> 4.0/17.5mm`; the measured-displacement model predicts sub3 near 364.69/134.87mm and sub6 near 94.15/181.09mm forward/right, while exact-angle simulation kept 431/937deg/s peak omega below the 2200deg/s cap; F413/F405 builds, solver-host exploration, exact-angle simulations, and `git diff --check` passed; flashed and verified the `c59393d-dirty` application through ST-LINK `066CFF545771485067013914` at 3.24V, erasing only application sectors 0..5 and software-resetting afterward; no UART, ADB, motor, fan, Codex-triggered run/search/shortest/path/tune, identity/calibration/maze/trace-format/protected-NVM operation was issued |
| 20260809-080125 | 20260809-080125-mode2-diagonal-entry-second-retune | 補正後6走行からmode2 45/135度斜め進入を二段目調整 | n/a | yes | inspected seven newly transferred Pixel files and classified the six requested trials by trajectory shape as three sub3 R45-in recordings (`manual-1786261343590` runs1/2 and `manual-1786261468723` run1) followed by three sub6 R135-in recordings (`manual-1786261570767` runs1..3); excluded only `manual-1786261468723-run0002`, whose 10.28s no-STOP video showed placement/manual movement rather than either turn and had 43.1% centre-label loss; five selected files had exact START 5/0/0 and STOP 0/5/0 votes, while the 26.71s sub3 file missed STOP but retained one complete stable trajectory and zero Camera2 capture failures; all selected motion poses were valid, turn-core two-label heading was valid, sub6 labels/homography were valid on every frame, and sub3 full-motion heading-valid fractions were 0.769..0.801 because the red label disappeared mainly after the useful turn; measured mean +/- sample SD endpoints after the first correction were sub3 361.27+/-1.51mm forward, 132.45+/-0.92mm right, and -46.20+/-1.25deg against 365/135/-45, and sub6 104.49+/-2.57mm forward, 179.54+/-0.98mm right, and -134.21+/-0.20deg against 95/180/-135; retained velocities and configured angles as requested, applying another approximately 75% position-only correction: R45-in alpha/out `6500/32.5 -> 6200/33.5`, and R135-in alpha/in/out `9150/3.5/22.0 -> 9750/0.0/25.5`; model plus measured residual predicts sub3 near 363.78/133.82mm and sub6 near 97.36/179.67mm forward/right, with 431/937deg/s omega peaks below the 2200deg/s cap; F413/F405 builds, solver-host exploration, exact-angle simulations, and `git diff --check` passed; flashed and verified the `e84d158-dirty` application through ST-LINK `066CFF545771485067013914` at 3.24V, erasing only sectors 0..5 and software-resetting afterward; no UART, ADB, motor, fan, Codex-triggered run/search/shortest/path/tune, identity/calibration/maze/trace-format/protected-NVM operation was issued |
| 20260809-073357 | 20260809-073357-mode2-diagonal-entry-retune | 6走行の上方動画からmode2 45/135度斜め進入を初回補正 | n/a | yes | analyzed the six user-recorded Pixel runs in session `manual-1786258819565` as three mode2 case0 sub3 R45-in trials followed by three sub6 R135-in trials using the fixed four-marker 90mm layout and calibrated blue-centre/red-front 24mm label pair; all six recordings completed with exact START 5/0/0 and STOP 0/5/0 short/long/erasure votes, and only run2 reported one isolated Camera2 capture failure; sub6 had valid centre/front labels and homography on every frame, while sub3 centre tracking remained complete in two trials and 3793/3949 in the third, its red label was absent mainly outside motion, and every detected turn-core frame retained valid two-label heading; measured mean +/- sample SD endpoints were sub3 361.94+/-0.74mm forward, 129.30+/-1.92mm right, and -46.47+/-0.56deg against the 365/135/-45 grid target, and sub6 113.74+/-0.09mm forward, 191.66+/-1.00mm right, and -134.01+/-0.74deg against 95/180/-135; kept both velocities and configured angles unchanged as requested, applied about 75% of the repeatable position residual by changing mode2 R45-in alpha/out `6360/28.0 -> 6500/32.5`, and R135-in alpha/in/out `6888/9.0/17.0 -> 9150/3.5/22.0`; model plus measured residual predicts the next sub3 near 364.24/132.12mm and sub6 near 99.76/183.07mm forward/right, with 442/907deg/s peak omega below the 2200deg/s cap; F413/F405 builds, solver-host exploration, both exact-angle simulations, and `git diff --check` passed; flashed and verified the `383a2a9-dirty` application image through ST-LINK `066CFF545771485067013914` at 3.24V, erasing only application sectors 0..5 and software-resetting afterward; no UART, ADB, motor, fan, Codex-triggered run/search/shortest/path/tune, identity/calibration/maze/trace-format/protected-NVM operation was issued |
| 20260809-065350 | 20260809-065350-mode2-diagonal-sub-path-continuity | mode2斜めターン調整subの不連続経路を修正 | n/a | yes | audited mode2 case0 sub3..7 against the path-code cardinal/diagonal state machine and the F405 source copied during the port; found that legacy sub4/sub5/sub7 placed diagonal straight `1001` directly after cardinal straight `203` without a 45/135-degree entry turn, and continued diagonal straight after a 45/135-degree exit, explaining the previously observed discontinuous motion; retained valid sub3 `203,701,1001` (R45-in) and sub6 `203,901,1001` (R135-in), changed sub4 to `203,701,1001,704` (R45-in setup then L45-out), sub5 to `203,701,1001,802,1001` (R45-in setup, L-V90, diagonal exit leg), and sub7 to `203,901,1001,904` (R135-in setup then L135-out); enlarged only the mode2 sub table to five codes and clarified trace labels; added a pre-motion case0 custom-path topology validator that starts cardinal, permits cardinal/diagonal straights only in the matching state, applies 45/135 entry and exit state transitions, requires V90 while diagonal, and rejects unsupported or discontinuous sequences before run features, trace logging, control start, or motor standby can begin; a host static check confirmed all five mode2 diagonal sequences and their intended final states, F413/F405 builds, solver-host exploration, and `git diff --check` passed; flashed and verified the `0e0c3ea-dirty` application image through ST-LINK `066CFF545771485067013914` at 3.24V, erasing only application sectors 0..5 and software-resetting afterward; no UART, ADB, motor, fan, Codex-triggered run/search/shortest/path/tune, identity/calibration/maze/trace-format/protected-NVM operation was issued |
| 20260809-062326 | 20260809-062326-mode2-r90-vision-verification | 補正後6走行を再測定してmode2小回りR90の出口だけ微調整 | n/a | yes | analyzed the user's six newly transferred runs in chronological order as three mode2 small-R90 and three large-R90 trials using the measured four-marker 90mm-grid layout and calibrated blue-centre/red-front 24mm label pair; all 28,558 frames had valid centre positions and fixed-marker homographies with zero fallback, while five recordings had clean 5/0/0 START and 0/5/0 STOP tokens and one 37.833s large-R90 recording missed STOP but retained a complete trajectory; small-R90 endpoints were 185.49/92.31, 185.88/90.52, and 185.45/92.59mm forward/right, giving 185.61+/-0.23 and 91.81+/-1.12mm with yaw -89.65+/-0.74deg against 185/90/-90; large-R90 endpoints were 230.64/134.34, 230.20/135.42, and 230.76/134.26mm, giving 230.53+/-0.30 and 134.67+/-0.65mm with yaw -89.74+/-0.17deg against 230/135/-90; the final large-R90 file exceeded the strict heading QA because the red label was intermittently absent in 553/3877 frames, mostly after motion, but its blue-centre position, start heading, endpoint, and 3324 valid red-label frames made the displacement usable; retained all alpha/angle/velocity values and the already accurate large-R90 parameters, changing only mode2 small-R90 `dist_offset_out` 29.8->28.4mm as an approximately 80% correction of the repeatable +1.81mm lateral residual; model plus measured residual predicts about 185.61/90.31mm; F413/F405 builds, solver-host exploration, small/large turn simulations, and `git diff --check` passed; flashed and verified the `7005386-dirty` application image through ST-LINK `066CFF545771485067013914` at 3.24V, erasing only application sectors 0..5 and software-resetting afterward; no UART, ADB, motor, fan, Codex-triggered run/search/shortest/tune, identity/calibration/maze/trace-format/protected-NVM operation was issued |
| 20260809-053300 | 20260809-053300-mode2-two-label-r90-refinement | 2ラベル実測9走行からmode2の小回り/大回りR90を再調整 | n/a | yes | analyzed the first nine of the user's ten newly transferred Pixel runs in chronological order as three mode2 small-R90, three large-R90, and three large-R180 trials (the trajectories correspond to current firmware `mode2 case0 sub0..2`, despite the request saying case1); processed all 36,622 selected 240fps frames with the measured four-marker 90mm-grid layout and calibrated blue-centre/red-front 24mm label pair, obtaining zero centre/front-label misses, zero invalid poses, and zero homography fallback frames; one 26.301s large-R90 file missed optical STOP but retained a complete stable trajectory and was usable; endpoint means +/- sample SD were small-R90 188.66+/-1.29mm forward, 89.09+/-1.20mm right, -88.77+/-0.59deg against 185/90/-90, large-R90 231.58+/-0.54mm, 135.74+/-1.20mm, -89.96+/-0.37deg against 230/135/-90, and large-R180 94.57+/-1.46mm, 89.84+/-0.55mm, -178.01+/-0.51deg against 95/90/-180; retained all configured angles as requested and left the already sub-millimetre large-R180 geometry unchanged; applied a bounded position-only correction to mode2 small-R90 `alpha_turn90` 22000->28000deg/s2 and `dist_offset_out` 26.0->29.8mm, and large-R90 `alpha_l_turn_90` 9000->9400deg/s2 and `dist_l_turn_out_90` 28.7->29.8mm, with entry offsets and velocities retained; simulation plus measured residual predicts about 185.84/89.87mm for small-R90 and 230.19/135.22mm for large-R90, with omega peaks 1296 and 751deg/s below the 2200deg/s path cap; F413/F405 builds, solver-host exploration, three turn simulations, and `git diff --check` passed; flashed and verified the `e3c942d-dirty` application image through ST-LINK `066CFF545771485067013914` at 3.24V, erasing only application sectors 0..5 and software-resetting afterward; no UART, ADB, motor, fan, Codex-triggered run/search/shortest/tune, identity/calibration/maze/trace-format/protected-NVM operation was issued |
| 20260809-045228 | 20260809-045228-pixel-stop-marker-manual-finish | 青ラベル近傍のSTOP見逃し対策と現在録画だけの手動終了を追加 | n/a | yes | analyzed the user's latest transferred session `manual-1786249023154`: runs 1..3 completed in about 16.55s with typed STOP, while run 4 recorded for 38.888s with a clean 5/0/0 START, no STOP token, 9,335 unique sensor frames at 239.99998fps, and zero Camera2 capture failures; frame analysis proved that the complete 900ms SYNC plus five 800ms STOP payload pulses were present, but at the run-4 endpoint one blue LED commonly occupied only one 480x270 preview pixel and the persistent 8mm blue centre label could outscore an actual LED during absolute-level SYNC learning; recorder v0.5.5/code19 now prefers rising components for initial SYNC geometry, uses the fixed learned coordinates to permit one-pixel LEDs only after acquisition, and still requires two separated known locations and the complete five-slot typed token; added a regression with a stronger persistent blue marker and three one-pixel LEDs; added Pixel, authenticated Wi-Fi API, CLI `finish-run`, and Mac dashboard **この撮影だけ終了** operations that finalize only the active MP4, retain continuous standby, and re-arm after two seconds, plus a `finishing-run` state that prevents duplicate GUI stop actions; optical/motion/Wi-Fi host tests, recorder assemble/lint, all 49 vision tests, Python/JavaScript/shell syntax, and `git diff --check` passed; installed v0.5.5 on Pixel 8 `38301FDJH0009W` without clearing data, used the non-optical HIL override to prove `recording -> finishing-run -> rearming` with `continuous_standby=true`, then explicitly stopped to idle; deleted only the two exact synthetic HIL directories `manual-1786250885764-run0001/0002` (about 59MiB total, not recoverable) and restored `saved=123/acknowledged=123`; a non-motor UART `;` attempt could not optically validate the new detector because the live Pixel frame contained the empty maze with no mouse, created no recording, and standby was cancelled cleanly; Pixel was left open and idle; no firmware change/build/flash/reset, motor, fan, run/search/shortest, identity/calibration/maze/trace-format/NVM operation was issued |
| 20260808-141901 | 20260808-141901-optical-start-motor-standby | 撮影START発光中は制御停止・モータ電源OFFを保証 | n/a | yes | confirmed that mode2 shortest/path, control tune, generic closed-loop test, and mode1 case0 test started `f413_ctrl_start()` before their blocking optical START hook, which raised MOTOR_STBY and ran the 1kHz controller at zero target throughout the token; changed all controlled-run entry ordering so the START hook finishes before `f413_ctrl_start()`, and made the shared/path/full-search START hooks call `f413_ctrl_stop()` first so PWM is stopped and MOTOR_STBY remains LOW for the entire optical token and guard; control/IMU calibration and motor-driver enable now occur only afterward, while existing STOP ordering remains control-stop before optical STOP; `cmake --build --preset Debug-stm32f413` and `git diff --check` passed (RAM 78.40%, FLASH 13.58%); built/flashed/verified the final `0e182c0-dirty` image through ST-LINK `066CFF545771485067013914` at 3.24V, erasing only application sectors 0..5, then software-reset and confirmed normal boot on `/dev/cu.usbmodem211202` at 921600 in `tools/logging/logs/f413_boot_20260808_232054.log`; an equivalent pre-commit image passed non-motor UART `i,w,v` (IMU WHO_AM_I=0x6B, wall PASS, trace dump complete) and saved `tools/logging/logs/stm32_log_20260808_231911.csv`; motors/fan were not allowed or commanded, no run/search/shortest/tune command was issued, and identity/calibration/maze/trace-format/protected NVM were not modified |
| 20260808-140753 | 20260808-140753-optical-calibration-recovery | 過大なPixel光学較正後に全STARTを見失う連続待機停止を解消 | n/a | yes | inspected the user's live stuck Pixel 8 state before restarting it: recorder v0.5.3 remained armed in `WAIT_PREAMBLE` but held an adaptive threshold of 2531, while the preceding four successful run reports measured START/STOP scores only 1219..1882; stationary non-motor UART `;` reproduced the failure with saved count unchanged at 117 and no decoded token; changed recorder v0.5.4/code18 to cap the adaptive frame-difference threshold at five times the configured lower bound (900 for the standard 180 profile) and to decode absolute-blue three-LED geometry against the configured component threshold rather than the possibly inflated adaptive value; added regressions proving recovery after severe single-component calibration noise and after a fully decoded mixed/invalid token; optical/motion/Wi-Fi host tests, Android assemble/lint, all 47 vision tests, F413/F405 builds, shell syntax, and diff checks passed; installed v0.5.4 on Pixel `38301FDJH0009W` without clearing data, then used the unchanged F413 firmware on UART `/dev/cu.usbmodem211202` at 921600 to emit `l` (an intentionally invalid 30s all-LED level), verified it returned to armed without recording, and emitted `;` then `,`; the following 36.307s diagnostic saved correctly with START=5/0/0 and STOP=0/5/0 short/long/erasure votes, scores 1429/1423 against threshold 200, 8,712 unique sensor frames at 239.99998fps, and zero Camera2 capture failures; Pixel was left idle at saved=118/acknowledged=104, the one 319,510,792-byte diagnostic video was retained, and no recording was deleted or transferred; no firmware change/flash/reset, motor, fan, run/search/shortest, identity/calibration/maze/trace-format/NVM operation was issued |
| 20260808-093529 | 20260808-093529-framed-optical-build-id | 固定長光学符号HILのF413ビルド識別子を追記 | n/a | yes | the application image used for the final stationary LED-only HIL embedded `FW_GIT_SHA=277986f`, `FW_GIT_DIRTY=1`, branch `codex/f413-search-port-complete`, build type `Debug`, and build time `2026-08-08T09:27:26Z`; it contained the exact protocol sources later committed as `85910fb`; the command sequence and no-motor scope/results are recorded in the adjacent final-HIL row |
| 20260808-093529 | 20260808-093529-framed-optical-final-hil | 固定長START/STOP光学符号の最終版を再配備して状態別判定を実証 | n/a | yes | extended the F413 all-off preamble from 2.2s to 2.5s so Pixel calibration may begin up to 400ms after the signal starts, added every two-slot erasure combination for both token types, and made the v0.5.3 report expose explicit `START`/`STOP` token types and vote counts while leaving obsolete rise-count fields null; optical/motion/Wi-Fi host tests, Android assemble/lint, all 47 vision tests, F413/F405 builds, solver-host exploration, and `git diff --check` passed; reinstalled recorder v0.5.3/code17 on Pixel 8 `38301FDJH0009W` without clearing app data and flashed/verified the final F413 application image through ST-LINK `066CFF545771485067013914` at 3.24V, erasing only application sectors 0..5; stationary non-motor UART HIL decoded a STOP-only token while armed as 0/5/0 short/long/erasure votes and ignored it without recording, decoded START while armed as 5/0/0 and started, decoded a second START while recording as 5/0/0 and ignored it, and then completed a fresh 31.699s START/STOP recording with explicit START=5/0/0 and STOP=0/5/0, 7,608 unique sensor frames at 239.99998fps and zero Camera2 capture failures; one intervening stress recording reached the 60s cap before its STOP token completed and was excluded from the STOP result; Pixel was left idle at saved=113/acknowledged=104, with the six stationary diagnostics (about 2.26GB) retained and no deletion/transfer; no motor, fan, run/search/shortest, identity/calibration/maze/trace-format/protected-NVM command was issued |
| 20260808-091726 | 20260808-091726-framed-optical-start-stop | START未検出後にSTOPが撮影開始になる光学符号の構造不良を解消 | n/a | yes | confirmed from the user's latest three retained reports that v0.5.2 START=5 and STOP=6 identical all-three-LED pulses were prefix-compatible: when START was missed, the first three STOP rises deterministically satisfied the armed START rule; replaced the state-dependent rise count with framed fixed-slot v1: 2.5s OFF preamble, 900ms common SYNC, 300ms gap, five 1.1s slots using 350ms START or 800ms STOP ON time, and 500ms final OFF; Pixel recorder v0.5.3/code17 now waits for all five slots, requires at least three homogeneous votes, treats missing slots as erasures and mixed votes as invalid, returns an explicit START/STOP type, ignores STOP while armed and START while recording, and records vote diagnostics; host tests cover every STOP prefix, every single-slot omission for both types, mixed invalid payloads, immediate post-arm calibration, mode/white/single-LED rejection, two-of-three payload LEDs, and preview dropout; optical/motion/Wi-Fi host tests, Android builds, F413/F405 builds, and `git diff --check` passed; installed v0.5.3 on Pixel 8 `38301FDJH0009W` without clearing app data and flashed/verified only F413 application sectors 0..5 through ST-LINK `066CFF545771485067013914` at 3.24V, then software-reset; non-motor UART LED HIL proved STOP-only remains armed twice, START begins recording, START-during-recording remains recording, and three consecutive held-terminal START/STOP pairs saved/re-armed with exact 5/0/0 and 0/5/0 short/long/erasure votes at 239.99998fps; one earlier diagnostic reached the 60s cap because the one-shot UART sender closed unreliably, not because STOP was misclassified; four diagnostic videos totaling about 1.42GB remain on Pixel (saved=111, acknowledged=104) and standby was stopped; no motor, fan, run/search/shortest, identity/calibration/maze/trace-format/protected-NVM command or deletion/transfer was issued |
| 20260808-080048 | 20260808-080048-pixel-optical-token-reliability | 冗長LED信号と欠落耐性判定で連続START/STOPを安定化 | n/a | yes | analyzed the latest eleven retained runs and identified three failure signatures: two recordings never opened the hard body-motion gate, one opened it but missed STOP, and recorded LED timing also showed that a transient preview dropout could count one long flash twice; replayed the missed 22.8s STOP at 40fps and found physical rises visible as 3/3/2/3 LEDs, then confirmed the revised logic decodes all four; changed F413 START/STOP to redundant five/six-flash tokens with a 1.8s all-off pre-roll while Pixel recorder v0.5.2/code16 still accepts after three/four valid rises; added 175ms confirmed-low debouncing, learned-location continuation with two of three LEDs, one-missing-pulse timing tolerance, and 500ms quiet re-arm after START; body motion remains report telemetry but no longer blocks STOP; passed optical/motion/Wi-Fi host tests, all 47 vision tests, Android assemble/lint, F413 and both F405 builds, solver-host exploration, Python/shell syntax, and `git diff --check`; installed v0.5.2 on Pixel 8 `38301FDJH0009W` while preserving 104 retained/acknowledged user runs; built `a2edd33-dirty` and flashed/verified only F413 application sectors 0..5 through ST-LINK `066CFF545771485067013914`, then software-reset; on `/dev/cu.usbmodem211202`, five consecutive stationary non-motor UART `;`/`,` LED pairs all transitioned armed->recording->complete->rearmed, each report had START and STOP, 239.99998fps, and zero capture failures, including one accepted two-LED START rise; removed only the five newly generated stationary diagnostic directories (about 775MB, not recoverable) from Pixel and restored idle `saved=104 acknowledged=104`; no motor, fan, run/search/shortest, identity/calibration/maze/trace-format/protected-NVM command was issued |
| 20260808-065254 | 20260808-065254-pixel-mac-live-dashboard | Mac常時監視GUIでPixel撮影保存と次走行可否を確認 | n/a | yes | added a dependency-free loopback Web dashboard over the existing authenticated Pixel Wi-Fi API, with 750ms automatic state polling, large armed/recording/rearming/idle/error/offline presentation, per-session/retained/untransferred counters, latest-run validation requiring the complete MP4/report/capture-result/encoder artifact set, explicit `保存確認済み・次の走行OK` feedback after re-arm, and a configurable long-recording warning for likely missed STOP/merged runs; added nonblocking buttons for continuous-standby start/stop, transfer, and stop-and-transfer while preserving capture/transfer exclusion, keeping the Pixel bearer credential server-side, and protecting loopback mutations with a per-launch token and CSP; added a Finder-openable macOS launcher, documentation, and HTTP/CSRF/artifact-completeness tests; against the real paired Pixel 8 app 0.5.1 at `192.168.40.23:46052`, the dashboard read idle/session-completed=3/saved=93/acknowledged=93 and validated latest `manual-1786167873058-run0003` as complete with a 68,869,759-byte MP4, then exercised GUI-path start to armed and stop back to idle without an optical START, leaving saved count 93 and no new run; all 47 vision tests, Python compilation, JavaScript syntax, zsh syntax, live HTTP asset/API checks, and `git diff --check` passed from `17796e5-dirty`; the configured Browser automation surface was unavailable for screenshot-level visual QA, so semantic page/API validation was used; no firmware change/build/flash/reset, ADB/UART, motor, fan, run/search/shortest, transfer/deletion, identity/calibration/maze/trace-format/NVM command was issued |
| 20260808-063213 | 20260808-063213-mode2-two-label-small-r90-retune | 2ラベル実測3回からmode2 small R90を再調整 | n/a | yes | inspected the user's intended nine mode2 case0 sub0..2 runs and found that Pixel recorder v0.5.1 itself completed only three files: run1 contains one small R90, the 45.3s run2 contains two small R90 trials separated by about 22s of empty-maze time because the first STOP token was missed, and run3 contains one large R90; Pixel authenticated status confirmed `completed=3`, so this was not a Mac transfer omission and only three small-R90, one large-R90, and zero large-R180 trials were available; applied the blue-centre/red-front 24mm calibration and measured the three small-R90 endpoint means as 193.09mm forward, 87.47mm right, and -89.48deg with sample standard deviations 0.88mm, 1.00mm, and 0.58deg against the retained 185/90mm target; retained velocity 300mm/s and angle 90deg, changed only mode2 `alpha_turn90` 14000->22000deg/s2 and `dist_offset_out` 17.2->26.0mm, whose bounded simulation predicts about 186.78/90.09mm by correcting 78% of forward error; left large-R90 and large-R180 parameters unchanged for lack of three trials; F413 and both F405 builds, solver-host exploration, turn simulation (1148.9deg/s peak below the 2200deg/s path cap), and `git diff --check` passed from `3cb57f9-dirty`; flashed and verified `build/Debug/nightfall_stm32f413.elf` through ST-LINK `066CFF545771485067013914`, erasing/writing only application sectors 0..5, then software-reset; no UART/ADB, motor, fan, Codex-triggered run/search/shortest, identity/calibration/maze/trace-format/protected-NVM command was issued |
| 20260808-053017 | 20260808-053017-red-front-label-heading | 青中心・赤前方ラベルによる機体yaw推定を実装・実走較正 | n/a | yes | added an independently tracked 8mm red front label 24mm ahead of the blue centre label and made its directed two-point vector the primary markerless heading while retaining body/cue/axis fallbacks; expected area, circularity, blue-centred baseline, temporal prediction, and yaw-rate gates reject red maze walls and the rear status LED; added per-frame front-label CSV/overlay/QA data and a strict circle-fit calibration tool for differential label-height parallax; processed the user's two latest 1920x1080/240fps runs and detected both labels with valid front-label heading in all 3834/3834 frames; the 181.3deg fit found right/forward apparent-vector bias -3.124/+1.834mm with 0.585mm radial residual p95, after which the measured start-to-end yaw changes were -90.75deg and -178.41deg and stationary 0.5s raw-yaw standard deviations were 0.22..0.42deg; visually verified both annotated tracks and stored ignored per-session CSV/plots/videos plus a hashed calibration JSON; all 43 vision tests, Python compilation, and `git diff --check` passed; no firmware build/change/flash/reset, UART, ADB, motor, fan, run/search/shortest, identity/calibration/maze/trace-format/NVM command was issued by Codex |
| 20260808-041420 | 20260808-041420-blue-center-label-tracking | 8mm青ラベルによる機体中心位置追跡を実装・実走検証 | n/a | yes | made the 8mm blue centre label the default markerless position source, using a Pixel-8-calibrated narrow HSV/channel mask, metric expected area, shape, and temporal prediction to reject the bluer optical START/STOP LEDs; kept green PCB/background silhouette and optional colour cue independent for heading, added `--position-only` so position QA can pass while unreliable silhouette heading remains explicitly reported, and exported per-frame label coordinates/area plus QA metadata and annotated video; changed measured-layout rectification to prefer all four marker centres because alternating corner/centre fits moved a static maze point by tens of canonical pixels; normalized near-integer HFR writer rates so a measured 239.914fps source produces a 240fps MP4 instead of an MPEG-4 timebase failure; processed the user's latest `manual-1786160181796-run0001/0002` recordings and detected the label in 1997/1997 and 1861/1861 frames with zero board-homography fallback, median label area 55px, and no raw canonical step above 3.56px; visually confirmed smooth U-turn and right-angle tracks and saved CSV/plot/annotated MP4 beneath each ignored session's `analysis_blue_label`; all 39 vision tests, Python compilation, and diff checks passed; no firmware build/change/flash/reset, UART, motor, fan, run/search/shortest, identity/calibration/maze/trace-format/NVM command was issued |
| 20260807-160119 | 20260807-160119-pixel-optical-token-hardening | Pixel START/STOP光学信号の見逃しとモード3灯誤カウントを対策 | n/a | yes | analyzed the latest overhead mode2 sub2 video and replayed its first STOP token through the production Java detector at 40fps for all six possible 240-to-40fps sample phases; all four encoded-video rises were individually strong and decoded offline, so the retained MP4 itself is usable while the live TextureView path still needed more margin; changed recorder v0.5.1/code15 to combine consecutive-frame blue rises with absolute blue-level detection, latch each physical ON interval as one rise, and keep the STOP detector paused until the body-motion gate opens; expanded the accepted rise spacing to 300..950ms; changed F413 optical tokens to begin with 1500ms all-LED OFF, then use 350ms ordinary ON and 300ms OFF, guaranteeing that an OP-UI all-three-LED mode indication or a partial moving-body sequence expires before token pulse 1; added host regressions for an earlier all-LED indication and gradual LED brightening; updated ADB collector/launcher version checks and documentation; passed optical/motion/Wi-Fi Java host tests, Android app/recorder builds, F413 and both F405 builds, shell syntax, and `git diff --check`; installed v0.5.1 on Pixel 8 `38301FDJH0009W` without deleting its 86 retained/acknowledged runs; built dirty `952c157` and flashed/verified only F413 application sectors 0..5 through ST-LINK `066CFF545771485067013914`, then software-reset; issued only non-motor UART LED diagnostics on `/dev/cu.usbmodem211202` (`l` and `;`); live optical confirmation could not complete because a one-second non-motor camera recording showed that the rear camera currently faces a dark cloth/obstruction rather than the maze or mouse; no motor, fan, run/search/shortest, identity/calibration/maze/trace-format/NVM command was issued |
| 20260807-144011 | 20260807-144011-pixel-overhead-remote-control | Pixel真上撮影を確認しMacからの無線撮影操作を追加 | n/a | yes | verified the newly frame-mounted Pixel 8 through the real 1920x1080/240fps HFR preview: the whole maze remains in frame and ordinary DICT_4X4_50 detection found all four fixed IDs 5/7/4/6; added recorder v0.5.0/code14 authenticated Wi-Fi endpoints for continuous-standby status/start/stop while preserving capture/transfer exclusion and explicit batch stop, plus `hfr_control.py` commands for status/start/stop/collect/stop-and-collect; installed over v0.4.1 without clearing 81 retained/acknowledged runs or pairing data, auto-discovered the Pixel at `192.168.40.23:46052`, exercised idempotent start/stop and live preview, confirmed unauthenticated control returns HTTP 401 and collection while armed exits busy, and left the app open but idle; Android assemble/lint, optical/motion/Wi-Fi Java host tests, all 35 vision tests, Python compile, shell syntax, and diff checks passed; no firmware change/build/flash/reset, UART, motor, fan, run/search/shortest, identity/calibration/maze/trace-format/NVM operation, or recording deletion was issued |
| 20260802-124559 | 20260802-124559-mode2-overhead-video-retune | 新カメラ画角の10走行を実寸座標で解析しmode2を再調整 | n/a | yes | analyzed all ten user-captured Pixel runs in session `manual-1785672598333` after the camera moved to a more overhead view; all ten videos completed at 1920x1080/240fps with valid optical START/STOP, comprising four small-R90, three large-R90, and three large-R180 trials; corrected two host-analysis weaknesses exposed by the new view: measured layouts now accept any three visible fixed markers and fall back to four marker centers when apparent marker-edge scale/lens distortion defeats corner RANSAC, while markerless velocity prediction now advances and normalizes velocity across temporary high-speed PCB-colour dropouts; unlike the superseded 60/65 displacement scaling, the four known marker centers directly preserve the measured 90mm grid; static foreground-hull medians were small-R90 209.1/92.4mm, large-R90 258.5/139.6mm, and large-R180 105.7/98.8mm forward/right against 185/90, 230/135, and 95/90mm; retained fixed 90/90/180deg angles and applied an intentionally partial correction: small-R90 alpha/in/out 9000/6.5/11.2->14000/0/17.2, large-R90 5200/1/11.5->9000/0/28.7, and large-R180 3600/14.1/20->4150/6.5/20; simulation predicts next endpoints about 194.8/90.6, 237.1/136.4, and 97.3/92.0mm; F413 and both F405 builds, solver-host exploration, all 35 vision tests, Python compilation, and diff checks passed; no firmware flash/reset, UART command, Codex-triggered motor/fan/run/search/shortest execution, calibration/maze/trace-format/NVM operation, or protected identity write was performed |
| 20260802-105837 | 20260802-105837-mode2-static-body-endpoint-retune | 直近sub2 traceで緑成分誤追跡を訂正しmode2ターンを再調整 | n/a | yes | analyzed the user's latest `trace_bin_20260802_195047.csv` for mode2 case0 sub2: all 1553 records decoded at a practical 1ms period with no abort, the 512ms turn held 481..514mm/s, reached -180.04deg against -180.001deg, and integrating real velocity with measured angle predicted about 110.7mm forward/100.1mm right; this disproved the prior 52.3/92.5mm endpoint from one rotating green connected component, while the static foreground centroid measured 106.0+/-0.6mm forward and 94.1+/-0.7mm right and agreed with trace; reprocessed all fifteen current videos using static body endpoints (green remains only the tracking seed), obtaining small-R90 201.7/79.1mm forward/right, large-R90 250.2/120.3mm, and large-R180 106.0/94.1mm versus 185/90, 230/135, and 95/90mm; applied an approximately 75% correction without changing 90/90/180deg angles: small-R90 in/out 19/3->6.5/11.2mm, large-R90 16/0.5->1/11.5mm, and large-R180 alpha 3350->3600deg/s2 plus out 11.5->20mm; candidate simulations predict residual measured errors near +4.1/-2.8mm, +5.2/-3.7mm, and +2.9/+0.4mm forward/right; this row supersedes the prior worklog claim that a single green component was the axle reference; no firmware flash/reset, UART command, motor/fan/run/search/shortest execution, calibration/maze/trace-format/NVM operation, or protected identity write was performed by Codex |
| 20260802-090441 | 20260802-090441-mode2-green-axle-calibrated-turn-tune | 60mm固定マーカと720度旋回で車軸基準mode2ターンを再調整 | n/a | yes | used the user's measured 60x60mm black ArUco side and the latest two mode1 case0 sub0 spot-spin traces/videos (`174805`, `174911`) to replace the earlier silhouette-centroid anchor assumption: both traces completed about -720deg, and the green-PCB centroid described only a 0.37/0.42mm radius around repeatable centers differing by under 0.04mm, so the green centroid is a practical markerless axle reference; retained the stable 65mm all-corner homography needed to absorb corner lens distortion but scaled relative displacements by the measured 60/65 ratio; reprocessed the illuminated mode2 runs with zero missing green positions and found axle endpoint means relative to the actual `DIST_FIRST_SEC=5mm` path target: small-R90 about +25mm lateral/-17mm forward error, large-R90 about +16/-13mm, and usable large-R180 trials about -15/-4mm; applied an intentionally half-error second iteration: small-R90 entry/exit 10/16->19/3mm with alpha 9000 retained, large-R90 alpha 4450->5200deg/s2 and entry/exit 1.5/1.0->16/0.5mm, large-R180 alpha 3900->3350deg/s2 and entry 12->14.1mm with exit 11.5mm retained; all angle values remain 90/90/180deg; F413 and both F405 builds, three turn simulations, and diff checks passed; no firmware flash/reset, UART command, motor/fan/run/search/shortest execution, calibration/maze/trace-format/NVM operation, or protected identity write was performed by Codex |
| 20260802-072653 | 20260802-072653-mode2-video-trace-turn-tune | Pixel軌跡と1ms traceからmode2 90度ターンを初回補正 | n/a | yes | analyzed the user's 15 mode2 case0 traces (five each for sub0 small-90, sub1 large-90, and sub2 large-180): all had unique payloads, correct mode/case/test metadata, contiguous practical 1ms sampling, no safety abort, and final IMU angle deltas tightly clustered around -89.9/-90.0/-179.9deg, so all configured angle values were retained; among 17 Pixel files, optical pre-trigger/timeout left complete usable trajectories for three small-90, three large-90, and one large-180 runs; mapped the seven trajectories to traces by speed correlation 0.989..0.997, with marker homography RMSE about 0.5px and missing body positions at most 5.5%; after compensating the approximately 11.5mm forward offset between the tracked body centroid and control reference, the three small-90 endpoints averaged about 12.3mm laterally and 10.0mm longitudinally short, the three large-90 endpoints about 6.1/5.3mm short, and the one large-180 endpoint only about 0.7/0.3mm short; applied a deliberately partial first correction only to mode2: small-90 alpha 10200->9000deg/s2 and entry/exit 8.0/12.8->10.0/16.0mm, large-90 alpha 4700->4450deg/s2 with offsets unchanged, and large-180 unchanged at 3900deg/s2 and 12.0/11.5mm; model prediction moves the two 90deg endpoints by roughly 40% of their measured error to limit sensitivity to the inferred markerless body anchor; F413 and both F405 builds, turn simulations, and diff checks passed; no firmware flash/reset, UART command, motor/fan/run/search/shortest execution, calibration/maze/trace-format/NVM operation, or protected identity write was performed by Codex |
| 20260802-052133 | 20260802-052133-pixel-continuous-rearm-wifi-fix | Pixel連続待機とWi-Fi排他制御の再待機競合を修正 | n/a | yes | diagnosed the user's v0.4.0 first-run behavior from the visible `Wi-Fi転送の完了後...` state: the new capture/transfer exclusion lease remained correctly held after a run, but the two-second continuous re-arm incorrectly tried to acquire the same lease again, treated its own lease as a transfer conflict, cancelled continuous mode, and then released the gate; changed recorder v0.4.1/code13 so one continuous session acquires the camera lease once and reuses it across every run/re-arm interval, while transfer remains rejected until the user explicitly ends standby; installed v0.4.1 on Pixel 8 `38301FDJH0009W` without clearing app data and exercised a no-mouse one-second HIL loop: saved count advanced across eight distinct videos while every sampled interval retained `capture_busy=true` and `active_transfers=0`, then a Pixel-side stop changed busy to false before Wi-Fi collection; collected and ffprobe-validated the user's retained 120.1MiB run plus all eight synthetic runs, removed only the eight synthetic Pixel directories after retaining their ignored Mac copies, and left the five user runs present and acknowledged on Pixel; Android build/lint, optical/motion/Wi-Fi Java host tests, all 31 vision tests, shell syntax, and diff checks passed; no firmware build/change/flash/reset, UART, motor, fan, run/search/shortest, identity/calibration/maze/trace-format/NVM operation was issued |
| 20260802-045932 | 20260802-045932-pixel-adb-free-wifi-collection | Pixel日常撮影をADB不要のWi-Fi収集へ移行 | n/a | yes | added Pixel recorder v0.4.0 authenticated LAN collection while retaining wired ADB for development: UDP discovery, a ten-minute/six-digit/eight-attempt pairing flow, persistent random 256-bit bearer token, allowlisted run inventory/artifact HTTP endpoints, byte-range resume, Mac-side size/nonce/ffprobe/atomic-publish validation, post-validation acknowledgment, and explicit Pixel-side deletion of acknowledged runs only; camera standby/recording, transfer, and deletion now use an atomic mutual-exclusion gate so 240fps capture remains uncontended; installed v0.4.0/code12 on Pixel 8 `38301FDJH0009W` (Android 17), auto-discovered it at `192.168.40.23:46052`, paired the permanent mode-0600 Mac credential, skipped and acknowledged four previously collected user runs without retransmitting them, transferred one synthetic 40.3MiB retained video plus sidecars over Wi-Fi in 9s, passed ffprobe, and confirmed capture-busy collection is rejected with exit 3 then succeeds after standby cancellation; removed only the synthetic run from Pixel after retaining its ignored Mac HIL copy, leaving all four user runs intact; Android build/lint, optical/motion/Wi-Fi Java host tests, all 31 vision tests in `.venv-vision`, Python compile, shell syntax, and `git diff --check` passed; no firmware build/change/flash/reset, UART, motor, fan, run/search/shortest, identity/calibration/maze/trace-format/NVM operation was issued |
| 20260802-041207 | 20260802-041207-pixel-3d-printed-aruco-check | 3D造形オレンジArUcoマーカをPixel実写検証 | n/a | yes | captured a stationary 1920x1080/240fps Pixel 8 clip under the current 1ms/ISO800 profile and detected the replacement orange/black `DICT_4X4_50` markers as the intended IDs 5/7/6/4; after the camera startup interval, ordinary grayscale OpenCV detection found all four markers in 299/301 frames (99.34%) and the three-marker homography set in the same 299/301, with only two isolated ID5 misses; detected black-vs-orange cell median gaps were 84..97 grayscale levels, stable marker-center jitter was at most 0.281px standard deviation per axis, and all four remained detectable after 0.3x downscaling in sampled stable frames; the far/top markers' shortest projected edges were about 39..42px, so the residual margin is dominated by current perspective/size rather than the orange material; a prior white-paper reference under the same nominal 1ms/ISO800/240fps profile achieved 836/909 all-four frames and 908/909 homography-ready frames after its first second, so white filament is not required for recognition; no firmware/app/code change, UART, motor, fan, run/search/shortest, flash/reset, identity/calibration/maze/trace-format/NVM command was issued |
| 20260802-033744 | 20260802-033744-pixel-five-run-continuous-review | Pixel連続5走行の保存・分割結果を確認 | n/a | yes | inspected the user's first five physical runs under Pixel recorder v0.3.8 continuous standby `manual-1785641124561`; Pixel reported four retained files rather than five: runs 1..3 each had accepted three-rise START, 260..389 changed-pixel motion, and four-rise STOP, while run 4 accepted START/motion but no STOP and reached the 60.007s recording limit; its two-second contact sheet visibly contains the fourth run, hand recovery around 20..24s, and the fifth run beginning around 26s, so all five physical runs are present but the final two are merged; collected all four files without deleting Pixel copies, totaling about 923MiB on Mac and 902MiB in Pixel app-private storage; strict full-decode QA passed all 25388 H.264 frames at 239.980802fps with zero PTS gaps, reverse/duplicate intervals, or identical adjacent decoded frames despite Camera2 reporting 11/32/0/0 capture failures; the final file requires splitting before one-run trajectory/tuning analysis; no application/firmware change, UART, motor, fan, run, search, shortest, flash/reset, identity/calibration/maze/trace-format/NVM command was issued |
| 20260802-031937 | 20260802-031937-pixel-continuous-optical-standby | Pixel連続光学撮影と走行別保存を実装 | n/a | yes | recovered the user's Pixel-started v0.3.7 run `manual-1785640008787` to session `Pixel_8_38301FDJH0009W_20260802T030725Z`; the report accepted a three-rise START at score 3890, 340-pixel body-motion gate, and four-rise STOP at score 2432, with 25.88ms recorder-start latency and 14.388s Camera2 elapsed time; although Camera2 reported four capture failures, strict host decoding of all 3413 H.264 frames measured 239.980802fps with zero PTS gaps, zero reverse/duplicate timestamps, and zero identical adjacent decoded frames, so the video is usable; changed Pixel recorder v0.3.8 manual operation to retain every run in a nonce-specific internal directory, automatically re-arm two seconds after each completed run, end the loop from a persistent Pixel button, preserve a final in-progress video, avoid storing a cancelled armed attempt, and stop before free space falls below 1GiB; added an idempotent collector for all retained manual runs while preserving one-shot Mac behavior; built/installed v0.3.8 on Pixel 8 `38301FDJH0009W`, exercised four distinct automatic 3s/240fps repeats without optical or mouse input, stopped the loop from Pixel, collected all four and verified second-pass duplicate skipping, then confirmed the normal optical profile reached `WAIT_RISE_1_OF_3` and cancelled cleanly; synthetic Pixel test runs were removed after collection while the user's original device copy and recovered Mac session were retained; Android build/lint, optical/motion host tests, all 29 vision tests, shell syntax, and diff checks passed; Codex issued no firmware, UART, motor, fan, run, search, shortest, flash/reset, identity/calibration/maze/trace-format/NVM command |
| 20260802-030324 | 20260802-030324-pixel-recorder-device-controls | Pixel単体の光学撮影待機・停止操作を追加 | n/a | yes | analyzed the user's matching F413 trace `trace_bin_20260802_115248.csv`: all 3300 records had contiguous sequence numbers, the median period was 1ms, 3166/3299 intervals were 1ms and 133 were 2ms, with only 36 two-ms intervals before motor output ended; the complete approximately 1.30m path was followed by 415 no-motor records and ended at +2.326mm distance / +0.008deg angle tracking error with no abort flags; added Pixel recorder v0.3.7 launcher controls whose manual arm selects the floor-tested 1920x1080/240fps, 72Mbps, 1ms, ISO800 optical profile, changes the second button from standby cancellation to manual recording stop, and preserves host intent configuration; cancellation now produces a normal `cancelled` report; built and installed v0.3.7 on Pixel 8 `38301FDJH0009W`, verified launcher/manual arm reached `WAIT_RISE_1_OF_3`, verified Pixel-side standby cancellation, and verified Pixel-side stopping of a host-launched non-optical 240fps capture with 1464 unique sensor timestamps at 239.99998fps, 1461 encoded frames, and zero capture failures; Codex issued no firmware, UART, motor, fan, run, search, shortest, flash/reset, identity/calibration/maze/trace-format/NVM command |
| 20260802-023706 | 20260802-023706-pixel-motion-gate-floor-hil | Pixel光学START・移動・STOP自動録画を実走確認 | n/a | yes | user executed one floor/maze run after Codex armed Pixel recorder v0.3.6 from commit `19cc1cd`; device report for session `Pixel_8_38301FDJH0009W_20260802T022815Z` detected the three-rise START with score 3877 at center `(95,221)`, started MediaRecorder after 30.87ms, opened the local-appearance motion gate 4.793s later with 505 changed pixels, detected the four-rise STOP with score 2687, and stopped after a 908.21ms tail; the 14.65s Camera2 session had zero capture failures, 3512 unique sensor timestamps, and a 3461-frame 1920x1080 H.264 file at 239.981fps; strict host timing/content QA passed with zero PTS gaps, zero duplicate/reverse intervals, and zero decoded duplicate frames; the host collector had already reached its former 300s pre-run timeout, but the Pixel remained armed and completed correctly, so artifacts were recovered manually and the optical wrapper default wait was increased to 1800s; Codex did not issue any motor/fan/run/search/shortest command, firmware was not changed/built/flashed/reset, and no identity/calibration/maze/trace-format/NVM operation was performed |
| 20260802-022606 | 20260802-022606-pixel-motion-gate-start-roi | Pixel光学録画の機体移動ゲートを実写対応 | n/a | yes | analyzed user run `Pixel_8_38301FDJH0009W_20260802T015924Z`: both runs were present in one 59.83s/14349-frame clip, but the v0.3.4 green-body gate saw no target because the 1ms/ISO800 PCB chroma was commonly below its fixed 18-count threshold; confirmed the actual first and second STOP tokens were four clean three-LED rises at `11.484..12.985s` and `53.142..54.643s`; replaced colour-dependent tracking with a fixed START-region appearance baseline that settles for 16 preview samples, averages eight samples, excludes blue-chroma/blue-dominant changes, rejects frame-wide illumination changes, and requires at least 120 local changed pixels for three samples; replay of the real moving clip detected departure at 3.978s with 371 changed pixels, while the stationary live clip never exceeded 18; added host tests for stationary LED activity, motion confirmation, and uniform light changes; built and installed recorder v0.3.6 on Pixel 8 `38301FDJH0009W`; non-motor UART `;` on `/dev/cu.usbmodem211202` produced START, and live Pixel UI reported `WAIT_MOTION baseline=yes changed=6`; Android capture had zero failures at 239.981 encoded fps; firmware was not changed, built, flashed, or reset, no motor/fan/run/search/shortest command was allowed or issued, and no identity/calibration/maze/trace-format/NVM operation was performed |
| 20260802-015800 | 20260802-015800-optical-stop-gate-trace-compaction | 光学START/STOP分離と1ms trace RAM欠落対策 | n/a | yes | diagnosed the latest user run: a false START began MediaRecorder early, then the real three-pulse START was consumed as STOP before motion, while the matching F413 trace dropped exactly at the 2048-record deferred-RAM boundary for 859ms; changed F413/Pixel recorder v0.3.4 to encode START as three all-LED pulses and STOP as four, added a green-body motion gate requiring at least 6 preview pixels for three consecutive samples before STOP decoding, and reported token/motion diagnostics; replaced the 2048x104-byte full-record staging ring with 4096 fast 44-byte records plus 4ms slow 42-byte snapshots, reconstructed seq from ring order, retained timestamp/distance/angle precision, quantized omega to 100mdps, expanded back to unchanged persistent schema v6, exposed dropped/clipped counts, and obtained 4092 usable 1ms deferred samples; F413 RAM is 256896B/320KiB (78.40%); built recorder APK and firmware `4d3c622-dirty`, installed Pixel v0.3.4 on `38301FDJH0009W`, flashed verified F413 application sectors 0..5 through ST-LINK `066CFF545771485067013914`, and captured boot on `/dev/cu.usbmodem211202` at 921600; stationary lamp-off HIL session `Pixel_8_38301FDJH0009W_20260802T014914Z` detected START in 26.4ms, then correctly ignored a four-pulse STOP while the unlit green target was unavailable, with 0 capture failures; non-motor UART `u,U` exercised compact staging and FRAM expansion with `overflow=0 dropped=0 compact_clipped=0`, and v6 rows plus compaction metadata were readable despite the known USB-UART character loss; passed F413/F405 builds, solver host, compact C and optical/motion Java host tests, Android assemble/lint, all 29 vision tests, Python compile, shell syntax, and `git diff --check`; motors/fan/run/search/shortest were not allowed or executed, identity/calibration/maze/protected NVM were untouched, and only the trace-log area was reformatted by the explicit non-motor trace validation |
| 20260802-005106 | 20260802-005106-pixel-optical-three-led-geometry | Pixel光学録画triggerを3灯同時3パルスに限定 | n/a | yes | compared the user's false-trigger session `Pixel_8_38301FDJH0009W_20260801T100643Z` with the deliberate token session `Pixel_8_38301FDJH0009W_20260801T100730Z` at the recorder's 480x270 sample scale: ordinary interaction produced one strong blue component on its first two rises and all three LEDs at most once, whereas the real token produced the same three principal LED components on all three rises about 500ms apart; changed Pixel recorder v0.3.3 to require three spatially separated blue-chroma connected components forming a non-collinear triangle on every pulse and to match that triangle across all three pulses, while retaining adaptive noise and total-score gates; exposed and reported `matched_leds`, added rejection tests for one LED pulsed three times, three individual LEDs in sequence, incomplete three-LED sequences, and a moving triangle; built and linted both Android apps, passed the optical host test, shell syntax, all 29 vision tests, and `git diff --check`; installed v0.3.3 on Pixel 8 `38301FDJH0009W`, visually confirmed `WAIT_FIRST_RISE`, and used only the non-motor UART `;` token twice on stationary F413 `/dev/cu.usbmodem211202` to complete START/STOP session `Pixel_8_38301FDJH0009W_20260802T004822Z`: both detections reported `matched_leds=3`, scores 4522/4506 against threshold 200, recording start latency 27.7ms, and a complete 6,221-frame 1920x1080 H.264 capture at 239.981fps; firmware was not changed, built, flashed, or reset, no motor/fan/run/search/shortest command was issued, and no identity/calibration/maze/trace-format/NVM operation was performed |
| 20260801-094512 | 20260801-094512-pixel-optical-white-motion-rejection | Pixel光学録画triggerの白色変動誤検出を修正 | n/a | yes | investigated the user's nominally armed session `Pixel_8_38301FDJH0009W_20260801T093406Z`, which had actually false-triggered both START and STOP and completed a 2.33s recording before the user saw `WAIT_FIRST_RISE`; offline 480x270 diagnostics measured local generic-brightness changes up to about 9,900 from white scene motion but blue rise only 107 below the configured 180 threshold, while the known-good F413 LED video produced blue-rise scores around 3,400; changed recorder v0.3.2 to decode blue chroma rather than generic brightness, added a synthetic three-pulse full-frame white-flash rejection test, added accepted score/hot-pixel/effective-threshold fields to reports, printed the two-second calibration instruction on the host, and added a two-second camera-HAL release delay to avoid transient CameraDevice error 2 after replacing or interrupting an armed app; built, installed, and linted v0.3.2, passed the detector test and all 29 vision tests, and observed Pixel 8 remain at `WAIT_FIRST_RISE` under the user's strong white illumination instead of false-triggering; the mouse was outside the current Pixel frame, so the final live blue-token START/STOP repeat remains pending placement; no firmware build/flash/UART, motor, fan, run/search/shortest, or NVM operation was performed |
| 20260801-092201 | 20260801-092201-f413-pixel-optical-record-trigger | F413可視LEDでPixel 8の240fps録画開始・終了を自動化 | n/a | yes | added one camera-rate-independent three-pulse token on all three F413 visible status LEDs before motion/trace start and after stop for test, tune, shortest/path, and full search paths, with a 300ms start guard; added non-motor UART `;` for stationary optical HIL; built `Debug-stm32f413` and both F405 targets from `9d1ca28-dirty`, then flashed and verified only F413 application sectors 0..5 through ST-LINK `066CFF545771485067013914` and software-reset the MCU; added Pixel recorder v0.3.0 preview-only optical arming, startup-exposure warmup/noise calibration, same-location three-rise decoding, encoder-surface handoff without a camera-HAL flush, 900ms stop tail, report timestamps, host detector tests, and an optical capture wrapper; a Pixel 8 `shiba` on Android 17/API37 completed a stationary lamp-off 1920x1080/240fps integration capture: 28.1ms start-detection-to-recording delay, 908.9ms stop-detection-to-stop delay, 6.23s elapsed, 239.99998fps sensor timestamps, 1,453 H.264 frames at 239.9808fps, and zero capture failures; visually verified the final start/stop LED pulses and LED-off tail in the MP4; Android builds, 29 vision tests, host detector tests, shell syntax, both firmware-family builds, ffprobe, and `git diff --check` passed; motors/fan/run/search/shortest were neither allowed nor executed, and no identity/calibration/maze/trace-format/NVM command was issued |
| 20260801-065300 | 20260801-065300-pixel8-maze-repeatability | Pixel 8上方240fps動画で同一走行の反復性を計測 | n/a | yes | firmware baseline was `124fb9f-dirty`; recorded three user-initiated maze runs with Pixel 8 Camera2 at 1920x1080/240fps, manual 1ms exposure, ISO800, EIS/OIS off, without Codex issuing any motor/fan/run command; each raw recording contained 4741 unique encoded frames over about 19.77s with zero PTS gaps or content duplicates, although run 3 narrowly exceeded the strict cadence-deviation-rate gate by 5/4740 intervals; tracked the green PCB centroid on all 3360 stable frames of each trial with zero missing positions and added an explicit bounded consecutive-homography fallback option for the fixed camera because the user's hand temporarily hid board markers during start; the three runs had provisional 2.894s mean active duration, 1.352m mean path length, 1.07mm start radial RMS, 2.63mm endpoint radial RMS, and normalized-path deviation from the three-run mean of 1.86mm median / 4.23mm p95; linked the user-captured reference trace `trace_bin_20260801_152631` to its video session and observed -90.94/-180.31/+180.90deg turns with 94.54mm mean lateral travel for the two 180deg turns; attempted read-only non-motor UART `v` and `V` dumps after the repeats but received no frame, so only the user-provided reference trace is associated; no firmware build/flash/reset, parameter edit, NVM/trace-format write, protected identity operation, or Codex-triggered movement was performed |
| 20260730-135321 | 20260730-135321-pixel8-hfr-camera-validation | Pixel 8のcustom 1080p/240 HFR制御とpreview同時動作を実機確認 | n/a | yes | probed connected Pixel 8 `shiba` on Android 16 / API 36: rear Camera2 ID0 is FULL and exposes fixed 120/240fps at 720p/1080p, H.264 1080p240 at 72Mbps, manual sensor control, REALTIME timestamps, and rolling-shutter-skew results; recording-only 1080p120/240 sessions completed, though result callbacks represented about one result per high-speed batch and the first 120fps trial had one startup PTS gap; added an intent/env-selectable TextureView preview and bumped the recorder to v0.2.0; verified preview+MediaRecorder 1080p240 with requested 1ms exposure, ISO400, and EIS/OIS off: 1,144 unique CaptureResult sensor timestamps at 240.000fps, applied exposure 0.999635ms, ISO400, rolling-shutter skew 4.542720ms, and a 1,141-frame H.264 MP4 at 239.981fps with zero PTS gaps and zero identical/near-identical adjacent frames; strict timing/content QA, Android assemble/lint, and visual frame inspection passed; selected Pixel preview+custom HFR as the primary backend and retained Xiaomi stock slow motion as fallback; no firmware build/flash/UART, motor, fan, run/search/shortest, calibration, maze/trace/NVM write, or protected identity command was run |
| 20260730-124500 | 20260730-124500-fixed-aruco-print-pack | 迷路固定ArUcoマーカの実寸印刷データを作成 | n/a | yes | added a deterministic `DICT_4X4_50` fixed-marker print-pack generator for IDs 5/7/6/4 in top-left/top-right/bottom-left/bottom-right order; generated a two-page A4 PDF with recommended 60mm and compact 40mm black-side options, one-module-or-greater white quiet zones, cut guides, labels, and a 100mm print-scale check plus individual dimensioned SVGs and a JSON manifest; rendered both PDF pages at 300dpi and visually inspected them, re-detected exactly IDs 4/5/6/7 on both pages, measured rendered black-side errors of 0.093%/0.199%, verified exact 210x297mm media boxes and text labels, and documented the 40px-at-1080p sizing rule; no firmware build/flash/UART, motor, fan, run/search/shortest, calibration, maze/trace/NVM write, or protected identity command was run |
| 20260730-122129 | 20260730-122129-xiaomi-hfr-desk-tracking | Xiaomi 13 Ultra純正HFR取得とマーカレス机上追跡を実機確認 | n/a | yes | probed connected Xiaomi 13 Ultra `2304FPN6DG` on Android 13 / MIUI `V14.0.5.0.TMAMIXM`: Camera2 ID0 advertises 1080p fixed 120/240/480fps, manual sensor, and REALTIME timestamps, but the vendor HAL rejected every constrained 120fps session at stream configuration, including MediaCodec, MediaRecorder, preview+record, record-only, and preview-only surfaces; added an experimental HFR recorder with CaptureResult/encoded-sample sidecars and a Xiaomi stock-camera collector; verified a prior stock `HSR_240` clip at 239.981fps with no PTS gaps/decoded duplicates, then collected the user's new hand-moved desk clip as 1920x1080 H.264, 2,823 frames, `com.android.capture.fps=240`, measured 239.981fps, zero gap rate, and zero identical-adjacent-frame rate; added a raw-pixel green-PCB-pair feasibility probe, which tracked 2,823/2,823 frames through partial hand occlusion with 148.6px median pair separation; verified Android assemble/lint, shell syntax, Python compile, all 24 vision unit tests, strict timing/content QA, and `git diff --check`; no firmware build/flash/UART, motor, fan, run/search/shortest, calibration, maze, trace-format, NVM, or protected identity command was run |
| 20260730-094005 | 20260730-094005-smartphone-markerless-turn-tuning | Android上方動画によるマーカレス軌跡・trace同期・ターン候補生成基盤を構築 | n/a | yes | kept fixed ArUco markers on the maze plane while removing the carried marker from estimation; validated green-PCB, foreground-hull, and rear-red-LED tracking against existing ID3 ground truth only after inference, with 515/515 frames tracked and a stationary-calibration/active-run hold-out of about 6.3mm position RMSE and 4.0deg yaw RMSE on the supplied 720p/30fps clip; added measured-mm fixed-marker layout and empty-background inputs, strict PTS/content timing QA, full-row/full-column trace fusion with sign/gain/ambiguity gates, independent heading validity, duplicate-trial rejection, turn-direction/error gates, and bounded candidate steps that never edit params; added a buildable API36 Camera2 capability probe with fresh nonce-bound per-device report collection; installed host-only FFmpeg/ffprobe 8.1.2, adb 37.0.1, JDK17, Android API/build-tools 36, and Gradle tooling; verified Python compile/unit tests, synthetic trace offset recovery, legacy and measured-layout real-video extraction, Camera probe assemble/lint, APK metadata, strict JSON, and `git diff --check`; no live hardware, flash, UART, motor, fan, run/search/shortest execution, calibration/NVM write, or protected identity operation was performed |
| 20260725-023821 | 20260725-023821-f413-uart-app-flash | F413大会機をROM UARTブートローダ経由で復旧書き込み | n/a | yes | built `Debug-stm32f413` from firmware `36bc073-dirty` with the user's current `f413_preorder` goal coordinates (`GOAL1=(7,7)`, `GOAL2=(7,8)`, `GOAL3=(8,7)`, `GOAL4=(8,8)`), producing a 210844-byte application binary with SHA-256 `a806120e416814774948805943812bf5da7862e62b973c2dbc8c3aafa250cdce`; after direct-Mac USB ST-LINK V3MINIE programming repeatedly stalled during sector erase, connected to the STM32F413 ROM bootloader as device `0x0463` through `/dev/cu.usbserial-55670290851` at 115200 8E1, erased only application sectors 0..5, preserved protected sectors 12..15, wrote the complete binary, and received ACK for GO at `0x08000000`; a subsequent 921600 8N1 non-motor `i,w,v` capture had no response while the board remained in its UART-boot setup, so normal-boot log confirmation requires returning BOOT to its normal state and resetting; no motor, fan, run, search, shortest, identity, calibration, maze, trace-format, FRAM, or protected-NVM command was issued |
| 20260724-111109 | 20260724-111109-f413-mode2-shortest-tuning-complete | F413 mode2最短走行の実機調整完了値を保存 | n/a | yes | user declared mode2 shortest-run tuning complete after confirming good physical behavior; checkpointed the final mode2 large-90 values (`velocity=500mm/s`, `alpha=4700deg/s^2`, `angle=90deg`, entry/exit `1.5/1.0mm`) and the user-selected large-180 values (`velocity=500mm/s`, `alpha=3900deg/s^2`, `angle=180deg`, entry/exit `12.0/11.5mm`); the latest prior trace `trace_bin_20260723_234754.csv` showed two complete 180deg turns at `180.32/180.53deg` with highly repeatable `94.79/94.85mm` lateral odometry, while the user prioritized the observed physical maze trajectory and accepted these settings; removed the stale `4640` candidate comment, verified `Debug-stm32f413` and `git diff --check`; no flash, UART command, motor/fan/search/shortest execution, calibration or NVM write, trace-destructive operation, or protected identity write was run by Codex; unrelated untracked WeAct adapter files remain untouched |
| 20260723-143810 | 20260723-143810-f413-wall-end-gate-large-turn-analysis | F413壁切れ検出ゲート同等化とmode2大回り90度調整 | n/a | yes | analyzed the latest user-run mode2 180deg trace `trace_bin_20260723_232510.csv`; the F405-compatible window derivative itself triggered clearly, but F413 still armed/labeled wall-end detection during every ordinary wall-controlled forward segment because normal wall-control polling reused `poll_wall_end(true)` and trace bit8 was inferred from the motor-forward phase, unlike F405's explicit `WALL_END && !SLALOM` gate; separated ordinary straight wall-control/derivative updates from explicitly armed wall-end monitoring, made trace bit8 reflect the actual runtime gate, and close the gate when a monitor segment ends; preserved the user's requested mode2 large-90 offsets `1.5mm/1.0mm`, whose two complete prior turns predict `90.16/90.17mm`; extended `analyze_wall_end_csv.py` to reject turn records followed by a trace time gap and analyze 180deg geometry; the two complete large-180 turns measured signed forward/lateral arc displacement `-0.75/85.73mm` and about `180.52deg`, yielding recommendations (not applied) of `alpha_l_turn_180=4250deg/s^2` and `dist_l_turn_out_180=11.5mm` with entry retained at `12mm`; the third apparent turn was excluded because a 1076ms trace gap truncates its phase; verified F413 and both F405 builds, solver-host exploration, all logging Python compilation, 90/180 analyzer output, and `git diff --check`; no flash, UART command, motor/fan/search/shortest execution, calibration or NVM write, trace-destructive operation, or protected identity write was run; unrelated untracked WeAct adapter files remain untouched |
| 20260723-231536 | 20260723-231536-f413-shortest-wall-end-deriv | F413最短走行の壁切れ判定をF405窓微分方式へ移植 | n/a | yes | analyzed the latest user-run mode2 case2 trace `trace_bin_20260723_225909.csv` and found no wall-end events because F413 compared a single wall-sensor sample delta against the F405 threshold 200, while the observed per-sample falls were only about -34 to -53; confirmed F405 uses two adjacent 18-sample sums in a 36-sample rolling buffer, divides their difference by 9, arms from the side-wall high threshold, and requires two derivative confirmations; ported that exact sampled-window behavior to F413 using coherent wall-sensor `sample_sequence` updates, retained the raw low-threshold fallback, and latched the trigger derivative; bumped wall trace observe metadata to v2, added an explicit layout flag, and repurposed trace reserved fields for current/trigger R/L derivatives while preserving event-time raw ADC values; added `analyze_wall_end_csv.py` to report wall-end sensor/derivative/position, distance from each event to the next turn, completed turn arc geometry, and recommended 90mm entry/exit offsets; preserved the user's mode2 large-turn tuning (`90deg`, entry `3mm`, exit `5mm`, large-180 `180deg`) as the current baseline; the old trace's first two complete turns integrate to mean arc travel `88.52/89.27mm`, but new offset tuning must use a post-port trace because the wall-end reference changes; verified F413 and both F405 builds, solver-host exploration, all Python logging tools, analyzer behavior on the old trace and a synthetic v2 event trace, and `git diff --check`; no flash, UART command, motor/fan/search/shortest execution, calibration or NVM write, trace-destructive operation, or protected identity write was run; unrelated untracked WeAct adapter files remain untouched |
| 20260723-223114 | 20260723-223114-f413-shortest-case1-wall-control | F413最短mode2 case1の壁衝突原因を修正 | n/a | yes | compared user-run shortest traces `trace_bin_20260723_221857.csv` (mode2 case1) and `trace_bin_20260723_221954.csv` (case2); case1 small-turn omega control itself was stable at two `-90deg` targets with about `-91.0deg` measured, but before the second turn a right wall-end at cumulative distance `552mm` left the shortest runner holding a stale `+68deg/s` wall correction because ordinary path segments only reapplied the previous correction instead of polling the wall runtime; this physically rotated about `+10.9deg` over the 45mm wall-end follow and another `+1.8deg` over the 8mm turn entry, while software angle resets hid the cumulative roughly `+12.8deg` heading error; case2 had no wall-end event and kept straight heading within about `0.5deg`, explaining the apparent case-only failure; changed normal shortest straight waits to update wall control through the same runtime polling path as exploration, disabled wall control only for the fixed follow distance after a detected wall end, and enabled the calibrated front-distance correction for mode2 case1 so its tuned small turn starts at the 44mm target when a front wall exists; verified F413 and both F405 builds, solver-host exploration, and `git diff --check`; no flash, UART command, motor/fan/search/shortest execution, NVM write, or trace-destructive operation was run; unrelated untracked WeAct adapter files remain untouched |
| 20260720-154227 | 20260720-154227-f413-shortest-parity | F413最短走行のF405ロジック同等化と32x32対応 | n/a | yes | completed the remaining structural F405 shortest-run port on F413: shortest small-turn front correction now uses the same calibrated unwarped front-sum distance API as exploration; per-mode wall-end hysteresis thresholds are applied and restored per session; consecutive large 90/180 turns use exit wall-end detection and `dist_wall_end`; mode2 case1/2 angle accumulation, mode2 case3-to-case4 mapping, and mode6 case4..9 front-correction flags match F405; mode2 small-turn values start from the completed F413 search tuning and all F413 suction-fan params are zero; added explicit 1500/1000/500mm/s straight/diagonal/turn tuning caps; raised the executable path bound to 1024, removed the final-code out-of-bounds read, added real timeout aborts, and made `MAZE_SIZE` overrideable with 16/32 and coordinate compile checks; verified normal F413 and both F405 builds, a separate `MAZE_SIZE=32` F413 build (RAM 290392B/320KiB, 88.62%), default solver-host exploration, a real 32x32 maze solver run compiled with `MAZE_SIZE=32`, Python logging compile, and `git diff --check`; no flash, UART command, motor/fan/search/shortest execution, calibration write, maze reset, trace-destructive operation, or protected NVM/identity write was run; unrelated untracked WeAct adapter files remain untouched |
| 20260720-060658 | 20260720-060658-f413-search-tuning-checkpoint | F413探索走行調整完了時点のユーザー設定を保存 | n/a | yes | checkpointed the user's completed first-pass exploration tuning: changed `searchRunParams[0/1].dist_wall_end` from `44.0mm` to `45.0mm`, enabled wall control, wall-end correction, front-wall correction, and angle accumulation for standard mode1 cases 1 through 4, and retained the added mode1 case comments; verified `Debug-stm32f413` and `git diff --check`; no flash, UART command, motor/fan/search/shortest execution, calibration write, maze reset, trace-destructive operation, or protected NVM/identity write was run; unrelated untracked WeAct adapter files remain untouched |
| 20260720-055027 | 20260720-055027-f413-front-match-fast-completion | F413探索の前壁位置合わせ完了待ちを短縮 | n/a | yes | replaced the front-match fixed-delay/single-sample completion checks with accumulated in-tolerance time (`25ms` yaw, `30ms` final), a `3ms` tolerated sensor-gap counter, and outer restart hysteresis; finite search matching now accepts a `10ms` relaxed window after `600ms`, limits normal control to `1000ms`, waits only `50ms` after successful completion, and distinguishes complete/relaxed/timeout/wall-lost/aborted/not-run outcomes; packed up to two match outcomes, elapsed times, and final position/yaw errors into the existing search `motion_end` arguments, preserving the approximately 6300-record capacity, and extended binary decode/analyzer output with `fm1/fm2`; verified a host state-machine test, F413/F405 builds, solver host explore simulation, Python compile, packed-result decode, old v6 raw/CSV compatibility, and `git diff --check`; no flash, UART command, motor/fan/search/shortest execution, calibration write, maze reset, trace-destructive operation, or protected NVM/identity write was run; preserved the user's unrelated uncommitted `search_run_params_split.c` wall-end distance change and untracked WeAct adapter files |
| 20260720-051635 | 20260720-051635-f413-search-wall-end-correction-confirm | F413探索の壁切れ距離補正動作を実走ログで確認 | n/a | yes | analyzed the user-run mode1 case2 full-search event log `tools/logging/logs/trace_bin_20260720_141324.csv`; the run contained 31 paired `wall_end`/`motion_end` actions, and cumulative-distance differences showed 44..46mm of travel after detection with a 44.94mm mean, confirming the existing F413 search flow stops the nominal 90mm monitor segment at wall-end detection and then executes `searchRunParams[0].dist_wall_end=44.0mm`; wall-end positions ranged from about 35.9mm to 51.1mm within the segment and both single-side and simultaneous R/L detections were captured; the user's working-tree change had enabled `F413_MODE1_FEATURES_ALL_ON_INIT` for mode1 case2, matching the log's active correction behavior, so committed and pushed that flag as `eb140f0`; verified `Debug-stm32f413` and `git diff --check`; no flash, UART command, motor/fan/search/shortest execution, calibration write, maze reset, trace-destructive command, or protected NVM/identity write was run by Codex |
| 20260720-044504 | 20260720-044504-f413-search-wall-end-diagnostics | F413探索の壁切れ位置ログと短音通知を追加 | ee2b3c7-dirty | yes | checkpointed and pushed the user's current F413 search tuning as `6f9bd6c` (`D_TIRE=14.39`, standard small-turn `alpha_turn90=10200`, mode1 case1/2 front-wall correction enabled while wall-end correction remains off); added search event `0xE6` for wall-end correction, recording cell/action context, right/left detection position relative to the monitored straight segment at 0.001mm resolution, detection elapsed time, segment length, cumulative control state, and event-time wall ADC values; host binary decode and `analyze_search_event_log.py` now display `side`, R/L segment position, elapsed time, segment length, and ADC; capped the extra detail events at 240 per run and report dropped count so the existing approximately 6000 core decision/motion records for the 3000-action guard still fit the roughly 6300-record FRAM trace capacity; added a 20ms nonblocking TIM11 buzzer notification serviced from the 1kHz TIM5 callback so the indication does not pause wall-end follow distance, gated to the F413 search path when `fan_duty==0`; verified F413/F405 builds, Python logging compile, solver host explore simulation, existing event-log analysis, synthetic `wall_end` rendering, and `git diff --check`; flashed application image `ee2b3c7-dirty` through ST-LINK SN `003B00273234511537333934` with verify/software reset, where dirty metadata is caused only by the preserved unrelated untracked `hardware/mini_r2_0/cad/kicad/WeAct-Adapter-5V/`; targeted non-motor UART `i` on `/dev/cu.usbmodem211202` returned `WHO_AM_I=0x6B expected=0x6B` although the known UART display character-loss issue omitted the final PASS text; no motor, fan, search/shortest run, calibration write, maze reset, trace-destructive command, or protected NVM/identity write was run by Codex |
| 20260712-180327 | 20260712-180327-direct-usb-uart-verification | 新MacのF413 UART欠落がUgreenハブ経路原因と確認 | n/a | yes | after the user moved ST-LINK V3MINIE `003B00273234511537333934` from the Ugreen composite hub to a MacBook Pro built-in USB-C port, IORegistry confirmed ST-LINK directly under the Apple USB host controller and the serial path changed from `/dev/cu.usbmodem211202` to `/dev/cu.usbmodem1102`; with clean firmware commit `7ec9f11` at restored 921600 baud, three independent non-motor UART `n` captures were complete (`FR/FL/R/L` labels and values intact), and detailed non-motor `:` output was also complete across all headings, CSV row, mean/stddev/min/max table, distance preview, and line endings; this isolates the byte loss to the prior Ugreen hub/cable USB CDC path rather than Migration Assistant data, Python, termios/custom baud, firmware formatting, or the Mac's native toolchain; no firmware/tool change was retained, and no motor, fan, run, or NVM/identity/calibration/map/trace write command was issued |
| 20260712-175336 | 20260712-175336-new-mac-uart-drop-diagnosis | 新Mac移行後のF413 UART文字欠落を環境切り分け | n/a | yes | diagnosed repeated UART byte-range loss on the new MacBook Pro: host is native arm64 macOS 26.5.1, system Python 3.9.6 runs arm64, Homebrew and ARM GCC are native `/opt/homebrew`, AppleUSBSerial exposes `/dev/cu.usbmodem211202`, and termios is 8N1 with flow control disabled; reproduced the same loss with repo `serial_terminal.py`, native-width macOS `IOSSIOSPEED`, standard 115200 baud without custom ioctl, and macOS `/usr/bin/screen`, excluding Python migration and 921600 custom-baud handling; IORegistry shows ST-LINK V3MINIE `003B00273234511537333934` behind a Ugreen composite USB hub, making the hub/cable/direct-connection path the next required test; restored clean firmware commit `7ec9f11` at normal 921600 after temporary 115200 testing and reset to safe boot; safety incident: while exiting `screen`, a `y` intended for the screen confirmation was forwarded to firmware and may have started the short motor-trace command without lifted confirmation; Codex immediately issued ST-LINK software reset, observed trace-stop text before reset, and performed no further motor/fan/run command; no intentional NVM/identity/calibration/map/trace write was performed |
| 20260712-173421 | 20260712-173421-f413-wall-distance-concise-output | F413距離校正nを4値のみの1行表示へ変更 | n/a | yes | changed normal UART `n` to keep the existing 512-frame averaging but print only `FR: ...  FL: ...  R: ...  L: ...`; moved the previous mean/stddev/min/max, CSV template, converted-distance, and validity diagnostics to the new non-motor `:` command and documented it in help/design/HIL safety; verified commit `7ec9f11` with `Debug-stm32f413`, `Debug-stm32f405`, and `git diff --check`, then flashed the clean F413 application through ST-LINK `003B00273234511537333934`; non-motor UART `n` was exercised repeatedly on `/dev/cu.usbmodem211202` at 921600 and calculation completed, but Codex capture still exhibited the separately known fixture byte-range loss even with experimental timer pauses and one-shot UART writes, so those ineffective transmission workarounds were removed before commit; no motors, fan, run command, or NVM/identity/calibration/map/trace write was allowed |
| 20260712-171711 | 20260712-171711-f413-wall-distance-readable-output | F413距離テーブル校正用n表示を転記しやすく整理 | n/a | yes | reformatted UART `n` around the repeated LUT-calibration workflow: added blank-line/result delimiters, made the first actionable block show the exact fitter CSV order `distance_mm,fr_delta,fl_delta,r_delta,l_delta`, emitted a directly editable `DIST_MM,FR,FL,R,L` row, replaced the long diagnostic CSV with an aligned mean/stddev/min/max table, and moved converted-distance/validity data into a compact preview section; verified commit `7d7006e` with `Debug-stm32f413`, `Debug-stm32f405`, `git diff --check`, flashed application sectors through ST-LINK `003B00273234511537333934`, and ran only non-motor UART `n` on `/dev/cu.usbmodem211202` at 921600; the command completed and showed the intended section/order, while the already-recorded current-fixture UART byte-drop issue still removed parts of some labels in Codex capture; no motors, fan, run command, NVM write, identity/calibration/map/trace mutation was allowed |
| 20260712-164747 | 20260712-164747-f413-wall-distance-average | F413距離テーブル校正用UART nを512点平均化 | n/a | yes | changed the non-motor UART `n` wall-distance diagnostic to average 512 distinct completed wall-sensor frames before applying the nonlinear distance conversion; added coherent full-frame publication with a sequence counter, Welford standard deviation, min/max, a compact `sensor_avg,FR,R,FL,L,count` row, and pause/resume around diagnostic output only; runtime wall control remains on the unchanged raw-ADC path; verified `Debug-stm32f413`, `Debug-stm32f405`, Python logging tools, and `git diff --check`; F413 HIL used ST-LINK `003B00273234511537333934` and UART `/dev/cu.usbmodem211202`, flashed only application sectors, allowed no motors/fan/run/NVM writes, and confirmed repeated `n` acquisitions complete with 512 samples in about 1024 ms and per-channel standard deviation around 1-2 ADC; the current fixture UART stream drops byte ranges at both 921600 and 460800 bps even after testing HAL and direct-TXE transmit paths, so those global trace experiments were reverted and the final firmware was restored to the normal 921600 bps setting |
| 20260705-131748 | 20260705-131748-f413-wall-sensor-distance-conversion | F413壁センサのADC距離変換レイヤとLUT作成ツールを追加 | n/a | yes | implemented a first-stage F413 wall-sensor distance conversion path without changing runtime wall control: `sensor_distance` now supports legacy linear interpolation plus shape-preserving PCHIP, F413 adds `f413_wall_distance` snapshots with mm/validity masks, UART non-motor command `n` prints raw delta and converted distance, and `params/f413_preorder/sensor_distance_lut.c` is the generated profile hook for measured LUTs; added `tools/logging/fit_sensor_distance.py` to group calibration CSV samples, enforce monotonicity, compare linear/PCHIP/log/invsqrt models, and emit calibrated C tables; updated `docs/ai/F413_SENSOR_DISTANCE_DESIGN.md` and HIL safety docs; verified `python3 -m py_compile tools/logging/*.py`, `cmake --build --preset Debug-stm32f413`, `cmake --build --preset Debug-stm32f405`, and `git diff --check`; no live hardware, flash, UART motor/fan/run command, calibration write, maze reset, trace format destructive operation, or protected NVM/identity write was run |
| 20260704-140250 | 20260704-140250-f413-mode1-correction-flags-off | F413 mode1標準探索の未調整補正フラグを一時OFFへ戻す | n/a | yes | user clarified front-wall correction and wall-end correction are intentionally disabled while their parameters remain untuned; reverted only the mode1 standard search case feature flags changed in the previous F405-equivalence pass, restoring case1..4 to `wall_end_correction_enabled=false` and `front_wall_correction_enabled=false`; left the search-flow port itself, event log support, post-goal safe-save guard, and phase-restart behavior unchanged; verified `cmake --build --preset Debug-stm32f413` and `git diff --check`; no live hardware, flash, UART motor/fan/run command, calibration write, maze reset, trace format destructive operation, or protected NVM/identity write was run |
| 20260704-135717 | 20260704-135717-f413-search-port-complete | F413探索走行のF405同等化残項目を移植 | n/a | yes | after the v6 search event log was confirmed usable, ported the remaining F405 search-flow semantics into F413 mode1: standard search cases now match F405 correction flags with front-wall correction enabled and wall-end disabled only for standard goal-style cases 1/3/4, full standard case2 and low-speed cases 5..8 use all corrections; added F405-style post-goal map-known tracking with `SEARCH_POST_GOAL_SAVE_NEW_CELL_THRESHOLD`, safe map-save guard that refuses to persist maps with no current route to the goal, route-fail event reason `map_save_guard`, and intermediate post-goal save at the stop before 180deg turns; changed multi-phase search (`goal->full` / `goal->start`) to stop, wait, reset control references, reverse `DIST_FIRST_SEC`, and run the entry section again before the second phase, matching the old second `adachi()` flow more closely; updated the search event analyzer to name `reverse_section` and `map_save_guard`; verified `python3 -m py_compile tools/logging/*.py`, `cmake --build --preset Debug-stm32f413`, `cmake --build --preset Debug-stm32f405`, `tools/solver_host/run_solver_host.sh --explore-sim --max-steps 512`, `python3 tools/logging/analyze_search_event_log.py tools/logging/logs/trace_bin_20260704_224453.csv`, and `git diff --check`; no live hardware, flash, UART motor/fan/run command, calibration write, maze reset, trace format destructive operation, or protected NVM/identity write was run |
| 20260802-095106 | 20260802-095106-diagonal-time-planner-host | 斜め対応時間最短経路プランナと動作変換のPC参照実装 | n/a | yes | extended the host reference planner to a half-grid, 8-heading, 17-speed-class Dijkstra covering orthogonal turns plus 45in/out, V90, 135in/out and diagonal connectors; objective is first G-cell entry while only a feasible same-direction straight tail may follow a connector goal crossing; added config-bound typed-action replay, required-open continuous turn tracing, optional board-outline turn clearance diagnostics, F413 mode2 primary and F405 mini mode2-5 comparison profiles, and PC-only exact-closure geometry seeds for every turn (current orthogonal timing retained; diagonal timing provisional); used a smooth positive-speed mapping so geometry length, boundary velocity, and calibrated duration remain coherent; replaced the legacy diagonal converter with a transactional codec, fixing incomplete diagonal endings, shared S2 ownership across chained runs, and 50-cell straight-code overflow; added a typed-to-legacy geometry gate that rejects diagonal terminal stops and never claims time equivalence; corrected the float-rounded mode4 half-cell braking boundary with a <=0.1um and <=1ppm self-consistent acceleration snap; verified ASan/UBSan unit/property/oracle/CLI tests, fixed-commit 24-maze x 5-profile x case8/9 matrix at 240/240 valid with all 240 strictly faster than orthogonal-only (344282..17999503us, mean 3806719.6us; legacy ok=81, terminal-diagonal=159), atomic matrix artifact publication, static analysis, explore simulation, and F405/F413 builds; no hardware, flash, UART, motor, fan, run, or NVM operation was performed; firmware planner/executor wiring remains gated on diagonal HIL tuning, full robot/straight swept clearance, runtime memory design, and typed execution or legacy runner upgrades |
| 20260802-071930 | 20260802-071930-orthogonal-time-planner-host | 直交時間最短経路プランナの机上参照実装 | n/a | yes | added a host-only phase 1-4 reference implementation: strict 16x16/32x32 competition-maze parsing, trapezoidal straight and raised-cosine turn time models, heading/boundary-state Dijkstra for small/large 90deg and large 180deg turns, typed-action replay validation, and legacy path-stream validation; the objective is time to first goal-cell entry while a feasible post-goal braking extension is planned but excluded from the score; verified 108 motion-model checks, 137 planner checks, ASan/UBSan variants, all 24 bundled competition mazes, all 54 mode/case profiles, CLI/legacy tests, static analysis, F405/F413 builds, and legacy explore simulation; no hardware, flash, UART, motor, fan, run, or NVM operation was performed; firmware integration and diagonal actions remain out of scope, and current turn-parameter geometric closure residuals plus swept-clearance validation are explicitly recorded as blockers before integration |
| 20260704-133408 | 20260704-133408-f413-search-wall-read-log | F413探索ログへ壁判断に使用したsnapshot列を追加 | n/a | yes | user asked to keep event-time wall sensor samples while also preserving the exact wall sensor values used for search map wall decisions; bumped trace schema to `0x00060000` / `nightfall_trace_csv_v6` and added `wall_read_fr/r/fl/l` columns after `adc_vbat`; F413 search event rows now keep `adc_fr/r/fl/l` as the event-time snapshot and fill `wall_read_*` from the latest `f413_search_step_read_and_write_current_wall()` snapshot actually used to derive `wall_info` and update `map[][]`; updated binary trace decoding with v3/v4/v5 compatibility plus v6 support, search event analyzer detail output, web visualizer fixed groups, and trace format/Codex state docs; verified old v5 raw log decode/analysis using `tools/logging/logs/trace_bin_20260704_220653.raw`, `python3 -m py_compile tools/logging/*.py`, `cmake --build --preset Debug-stm32f413`, `cmake --build --preset Debug-stm32f405`, and `git diff --check`; no live hardware, flash, UART motor/fan/run command, calibration write, maze reset, or protected NVM/identity write was run |
| 20260704-131629 | 20260704-131629-f413-search-side-wall-threshold | F413全面探索の早期終了原因を解析し側壁判定を調整 | n/a | yes | inspected latest search event log `tools/logging/logs/trace_bin_20260704_220653.{raw,csv}` after mode1 case2 full-start exploration ended at `(0,3)` before reaching the goal; found the run was not a goal phase but a FULL phase, and it stopped because `(0,3)` was first mapped as `cell=0x0011` with east open, then reread on the return path as `cell=0x0055` after the left sensor reported 255 against `WALL_BASE_L=160`, closing the east opening and making all unvisited cells unreachable; raised F413 side wall presence thresholds to 300 based on this log's false opening reflection value (255) versus true side wall values above roughly 500, and ported F405-style `sensor_kx` scaling into F413 search map wall classification so search params can adjust wall detection sensitivity; replayed the latest log's ADC values locally and confirmed the final `(0,3)` FULL smap changes from `-1` to `1`; verified `cmake --build --preset Debug-stm32f413` and `git diff --check`; no live hardware, flash, UART motor/fan/run command, calibration write, maze reset, trace format destructive operation, or protected NVM/identity write was run |
| 20260704-125757 | 20260704-125757-f413-op-ui-run-end-lock | F413探索/最短走行後のOP UI入力ロックを移植 | n/a | yes | confirmed F405 `led_wait()` alternates rear LEDs forever after run-end style flows so wall-sensor enter cannot immediately retrigger a run; added an F413 OP UI run-end lock that disables PUSH/enter and UART P/E operation UI input after mode1 search cases and mode2..7 shortest cases return, while alternating rear-right/rear-left LEDs at 400ms until reset; kept the main loop alive so non-OP UART diagnostics/log dump paths remain available after reset-oriented debugging, and did not apply the lock to case0 tuning/test actions; verified `cmake --build --preset Debug-stm32f413` and `git diff --check`; no live hardware, flash, UART motor/fan/run command, calibration write, maze reset, trace format destructive operation, or protected NVM/identity write was run |
| 20260704-123757 | 20260704-123757-f413-search-log-check-and-remaining-porting | F413探索イベントログ確認と探索残項目の移植 | n/a | yes | inspected latest search event log `tools/logging/logs/trace_bin_20260704_212659.{raw,csv}` and confirmed representative action-level records are usable across a full exploration, including session/phase/decision/motion summaries, smap, wall/map cells, speed and distance/angle targets/measured values, and known-straight acceleration flags; fixed host binary decode so phase rows report their status instead of `0`, added explicit `route_fail` event/reason decoding for future no-route diagnostics, changed F413 full-explore no-current-step behavior to F405-equivalent phase completion (`full_unreachable`) instead of route failure, and ported the remaining F405 forward wall-align recovery branch using F413 front-match/spot-turn primitives with angle-accum-safe return targets; verified `python3 -m py_compile tools/logging/trace_bin_dump.py tools/logging/analyze_search_event_log.py`, redecoded/analyzed the latest raw event log, `cmake --build --preset Debug-stm32f413`, and `git diff --check`; no live hardware, flash, UART motor/fan/run command, calibration write, maze reset, trace format destructive operation, or protected NVM/identity write was run |
| 20260704-044352 | 20260704-044352-f413-search-event-log-porting | F413探索イベントログ基盤とF405探索差分の追加移植 | n/a | yes | implemented a low-rate F413 search event log on the existing FRAM trace area, recording session/phase/decision/motion-summary records instead of enabling the 1ms auto trace during full exploration; expanded host binary trace decoding with numeric event columns and added `tools/logging/analyze_search_event_log.py` for readable search-event summaries; increased search action budget to 3000 so a 32x32/10min exploration can keep full-start-to-end representative records within trace capacity; ported F405-like search behavior for `drive_wait()` around stop-and-180 turns, angle-accum-safe 180deg targets, known-straight dash acceleration/deceleration, and front-wall match/split-turn handling; retained existing user tuning edits in `params/f413_preorder/*` and `f413_mode1.c`; verified `python3 -m py_compile tools/logging/trace_bin_dump.py tools/logging/analyze_search_event_log.py`, `python3 -m py_compile tools/flashing/flash_stlink tools/flashing/flash_uart tools/flashing/make_identity_block.py tools/logging/*.py`, `cmake --build --preset Debug-stm32f413`, and `git diff --check`; F413 HIL: ST-LINK SN `003B00273234511537333934`, flashed `build/Debug/nightfall_stm32f413.elf` first from `9361512-dirty` and then clean `85a8280`, UART `/dev/cu.usbmodem111202`, motors/fan/search/shortest not commanded, non-motor `i,w` PASS after both flashes with IMU WHO_AM_I `0x6B` and wall read PASS |
| 20260704-031807 | 20260704-031807-f413-wall-control-deriv-threshold-name | F413壁制御の微分しきい値を用途名へ改名 | n/a | yes | user noted `WALL_DIFF_THR` is no longer a raw difference threshold after the F413 wall-control path was changed to use wall-end derivative values; confirmed F405 keeps the old raw wall-control difference threshold as `WALL_DIFF_THR=22`, while both F405 mini/classic use `WALL_END_DERIV_FALL_THR=200` for wall-end falling-derivative detection; renamed the F413 parameter to `WALL_CTRL_DERIV_FALL_THR` and set it to `200`, matching the F405 wall-end derivative threshold as the initial tuning point while keeping it independently adjustable from `WALL_END_DERIV_FALL_THR`; verified `cmake --build --preset Debug-stm32f413` and `git diff --check`; no live hardware, flash, UART motor/fan/run command, calibration write, maze reset, trace format change, or protected NVM/identity write was run |
| 20260704-031021 | 20260704-031021-f413-wall-control-drop-deriv | F413壁制御の壁切れ急変ガードを壁切れ微分値へ統合 | n/a | yes | user confirmed theoretical turn angles are now acceptable, corrected `WALL_BASE_L` back to `160`, and requested porting the F405 wall-control wall-drop mitigation using the wall-end derivative path rather than a separate previous-AD implementation; confirmed F405 `wall_PID()` raises the per-side wall-present threshold by 30 when sensor change exceeds `WALL_DIFF_THR`, while F413 had `WALL_DIFF_THR` defined but unused in wall control; changed F413 wall control to derive control-side wall presence from `g_wall_end.deriv_r/l`, using `WALL_DIFF_THR` as the separate wall-control falling-derivative threshold and keeping `WALL_END_DERIV_FALL_THR` for wall-end correction; when both control-side walls are absent, F413 now feeds `wall_error=0` through the existing LPF/slew path instead of immediately resetting, matching F405 decay behavior more closely; verified `cmake --build --preset Debug-stm32f413` and `git diff --check`; no live hardware, flash, UART motor/fan/run command, calibration write, maze reset, trace format change, or protected NVM/identity write was run |
| 20260621-174046 | 20260621-174046-f413-search-stop-tail | F413探索停止距離ばらつき低減のためsearch-step終端判定と停止tailを修正 | n/a | yes | user requested applying the two proposed mitigations after distance tuning exposed about +/-5mm stop variation; reviewed prior stop logs including `tools/logging/logs/trace_bin_20260620_164647.csv`, `trace_bin_20260620_204224.csv`, and `trace_bin_20260620_214750.csv`, where search/path stop endpoints overshot the distance target by several mm and then sharply dropped target velocity; changed `f413_search_step_wait_ctrl_target()` from a 10ms guarded wait to a 1ms guarded wait, matching path-run behavior and reducing endpoint detection latency at 300-500mm/s; added a search-step stop tail helper so successful final stops hold target velocity/omega at zero for `path_coast_ms` while control and auto trace remain active before `f413_ctrl_stop()`, allowing encoder distance/velocity logs to capture the residual settling interval; verified `cmake --build --preset Debug-stm32f413`, `cmake --build --preset Debug-stm32f405`, and `git diff --check`; no ST-LINK flash, motor, fan, search run, shortest run, or NVM-destructive command was performed, and the existing user edits in `params/f413_preorder/params.h` were left untouched |
| 20260620-124048 | 20260620-124048-f413-mode1-search-run-entry | F413 mode1 case1〜8から通常探索走行を起動できる入口を追加 | n/a | yes | user clarified that UART commands cannot be used while running in a maze and requested F405-equivalent mode1 case1+ exploration entries; added `F413_OP_UI_ACTION_SEARCH_RUN_CASE` and routed F413 OP UI mode1 case1..8 to an automatic search session instead of the single UART-driven step flow; implemented `f413_search_step_run_search_case_once()` using the existing F413 wall snapshot/map update/action selection/motion primitives, with F405-style case mapping: case1/5 goal->full, case2/6 full, case3/7 goal->start, case4/8 goal-only, and standard/low speed selected from `searchRunParams[0/1]`; a search run now keeps one trace session across the whole mode execution and updates `op_sub=(y<<4)|x` plus `test_id=0x80|(next_rel<<2)|dir` per action so logs can be inspected after the cable is reconnected; verified `cmake --build --preset Debug-stm32f413`, `cmake --build --preset Debug-stm32f405`, `tools/solver_host/run_solver_host.sh --explore-sim --max-steps 512`, and `git diff --check`; no ST-LINK flash, motor, fan, search run, shortest run, or NVM-destructive command was performed by Codex |
| 20260620-121817 | 20260620-121817-f413-maze-test-search-context-log | F413簡易迷路テスト向けに探索ステップcontextログを追加 | n/a | yes | after committing the tuned F413 control migration as `e414841`, prepared the next simple-maze validation phase by preserving the existing wall delta / wall-end trace fields and adding compact search-step context into the standard trace context fields during UART/OP search step runs: for `op_mode=1, op_case=4`, `op_sub=(y<<4)|x` and `test_id=0x80|(next_rel<<2)|dir`, so logs can be grouped by current cell, heading, and selected relative action without consuming the wall reserved fields; added CSV metadata documenting this encoding; verified `cmake --build --preset Debug-stm32f413`, `cmake --build --preset Debug-stm32f405`, `tools/solver_host/run_solver_host.sh --explore-sim --max-steps 512`, and `git diff --check`; no ST-LINK flash, motor, fan, search, shortest, or NVM-destructive command was performed in this turn |
| 20260620-115319 | 20260620-115319-f413-translation-pwm-ff | F413並進速度制御へPWMフィードフォワードを追加 | n/a | yes | reviewed latest trace `tools/logging/logs/trace_bin_20260620_204224.csv` after the user observed good turn tracking but small translational velocity tracking variation; confirmed the prior segment-boundary velocity discontinuity was gone except for final stop behavior, and estimated the existing PI output during straight motion was dominated by about 70-90 PWM of static/rolling load plus smaller velocity and acceleration terms; added tunable translation feed-forward terms `FF_TRANSLATION_STATIC_PWM_*`, `FF_TRANSLATION_VELOCITY_PWM_*`, and `FF_TRANSLATION_ACCEL_PWM_*`, applied them to the translational PWM output from the raw path velocity/acceleration reference rather than the distance-corrected target velocity, and emitted the coefficients in trace CSV metadata; initial fan-off values are conservative (`45`, `0.040`, `0.0040`) while fan-on FF remains zero; verified `cmake --build --preset Debug-stm32f413`, `cmake --build --preset Debug-stm32f405`, and `git diff --check`; no ST-LINK flash, motor, fan, or run command was performed in this turn |
| 20260620-075545 | 20260620-075545-f413-path-distance-continuity | F413 path直進セグメント境界の速度目標不連続を低減 | n/a | yes | reviewed latest decoded trace `tools/logging/logs/trace_bin_20260620_164647.csv` after the user observed audible chatter and target-velocity steps; found `target_distance_mm`/`distance_mm` reset at straight segment boundaries causing target velocity drops such as 210->162mm/s and 554->497mm/s, plus a final overshoot-induced negative target velocity from the 10ms wait cadence; changed `f413_path_run_drive_segment()` to keep cumulative distance state across path segments and wait for current distance plus the segment length instead of resetting distance/PID state at every segment, and changed the path wait loop cadence from 10ms to 1ms to reduce endpoint overshoot; verified `cmake --build --preset Debug-stm32f413`, `cmake --build --preset Debug-stm32f405`, `tools/solver_host/run_solver_host.sh --explore-sim --max-steps 512`, and `git diff --check`; no ST-LINK flash, motor, fan, or run command was performed in this turn |
| 20260620-143417 | 20260620-143417-f413-omega-profile-control-tick | F413 case0ターン目標ω生成を制御tick側へ移動 | n/a | yes | user observed the latest mode2 case0 log still looked oscillatory and pointed out that the target omega itself was staircase-like; confirmed `trace_bin_20260620_142746.csv` showed large target omega steps such as about -37/-139/-280/-421dps during one turn, consistent with the path runner updating `f413_ctrl_set_omega()` from the main context while trace/NVM auto-step work can stall that context; added F413 control APIs to start/stop a cosine omega profile owned by the 1kHz control tick, updated the case0 smooth-turn runner to start the profile once and only wait/guard from main context, and kept the user's adjusted omega gains/lead values unchanged; verified `cmake --build --preset Debug-stm32f413`, `cmake --build --preset Debug-stm32f405`, and `git diff --check`; no ST-LINK flash, motor, fan, or run command was performed |
| 20260620-051554 | 20260620-051554-f413-case0-continuous-test-speed | F413 mode2 case0確認向けにテスト速度接続を旧作寄りへ修正 | n/a | yes | user observed likely speed discontinuity between the straight lead-in and turn in case0 tests; changed the F413 OP path-code test runner so segments inside one `mode2..7 case0` test sequence no longer insert a coast/zero-velocity pause after every path code, and straight/diagonal lead-in segments choose the next turn's capped turn velocity when followed by a turn, matching the old F405 mini style of entering a slalom at turn speed; raised `NIGHTFALL_F413_OP_TEST_VEL_CAP` / turn cap to 500mm/s for mode2 confirmation while retaining `NIGHTFALL_F413_OP_TEST_OMEGA_CAP`; verified `cmake --build --preset Debug-stm32f413`, `cmake --build --preset Debug-stm32f405`, and `git diff --check`; no ST-LINK flash, motor, fan, or run command was performed |
| 20260620-045217 | 20260620-045217-f413-case0-smooth-omega-profile | F413 mode2..7 case0テストに滑らかな角速度プロファイルを適用 | n/a | yes | user confirmed the latest omega tracking improved with the lead compensation and requested trying it outside mode9 case0; updated the F413 OP path-code test runner so `mode2..7 case0 sub0..7` turn motions use an F405-derived cosine-blended omega profile from the mode turn `alpha_*` / angle params instead of a step angle target, while leaving solver-path real shortest execution on the existing angle-target path; capped test turn velocity with `NIGHTFALL_F413_OP_TEST_TURN_VEL_CAP` and omega with `NIGHTFALL_F413_OP_TEST_OMEGA_CAP`, preserving the existing safe test-speed posture; verified `cmake --build --preset Debug-stm32f413`, `cmake --build --preset Debug-stm32f405`, and `git diff --check`; no ST-LINK flash, motor, fan, or run command was performed |
| 20260615-075836 | 20260615-075836-f413-omega-lead-ff | F413角速度目標の先読み補償とPWM FF設定を追加 | n/a | yes | implemented a 5ms target-omega lead path for the F413 omega loop, clamped by `FF_OMEGA_LEAD_MAX_DPS`, and added zero-default `FF_OMEGA_PWM_*` / `FF_OMEGA_ACCEL_PWM_*` params for later plant-delay tuning; normal run and tune run now share the same omega-output helper, obsolete local F413 omega FF macro was removed from the f413 params profile, and CSV metadata now records the active omega lead/FF settings; verified `cmake --build --preset Debug-stm32f413`, `cmake --build --preset Debug-stm32f405`, and `git diff --check`; no ST-LINK flash, motor, fan, or run command was performed |
| 20260615-065757 | 20260615-065757-f413-remove-gyro-lpf-trace-candidates | F413 IMU Z複数LPF候補ログを削除しtrace v5へ更新 | n/a | yes | user decided the IMU Z LPF candidate comparison was no longer needed; removed the 2/5/10/20ms gyro Z LPF state/getters and CSV columns, kept `gyro_z_raw_mdps`, bumped trace schema to `0x00050000` / `nightfall_trace_csv_v5`, updated firmware CSV dump, binary dump tooling with v3/v4/v5 layout compatibility, PlotJuggler export, visualizer, trace format spec, and AI state docs; verified `cmake --build --preset Debug-stm32f413`, `cmake --build --preset Debug-stm32f405`, `python3 -m py_compile tools/logging/*.py`, `git diff --check`, v4 raw binary decode using `trace_bin_20260615_153244.raw`, and PlotJuggler export of `trace_bin_20260615_153244.csv`; no ST-LINK flash, motor, fan, or run command was performed |
| 20260615-054540 | 20260615-054540-f413-gyro-lpf-trace-v4 | F413 IMU Z角速度の生値/複数LPF候補をtrace v4へ追加 | n/a | yes | user requested logging to compare IMU raw gyro Z against several LPF time constants for turn-response/noise tuning; bumped trace schema to `0x00040000` / `nightfall_trace_csv_v4`, added `gyro_z_raw_mdps` and 2/5/10/20ms LPF fields to F413 control samples, CSV/bin dump, PlotJuggler export, and web visualizer omega plots; kept existing F413 control omega LPF behavior at the hardcoded 20ms path while logging alternative candidates; reduced F413 trace RAM ring from 2048 to 1536 records so v4 record growth still leaves RAM headroom (`241840 B / 320 KB = 73.80%`); verified `cmake --build --preset Debug-stm32f413`, Python py_compile for logging tools, `git diff --check`, and v3 raw binary log decode/export compatibility using `trace_bin_20260615_135328.raw`; no ST-LINK flash, motor, fan, or run command was performed, and the existing uncommitted `params/f413_preorder/params.h` gain-tuning edits were intentionally left separate |
| 20260607-114059 | 20260607-114059-f413-imu-diag-module-split | F413 IMU診断を専用モジュールへ分離 | n/a | yes | on branch `codex/f413-test-run-split` after commit `6a1278f`, moved F413 IMU SPI register access, WHO_AM_I check, manual gyro-angle test, and accelerometer observation test from `main.c` into `f413_imu_diag.h/c`; updated run-session IMU health check to use `f413_imu_diag_whoami_ok()` and left UART/OP routing in `main.c`; verified `cmake --build --preset Debug-stm32f413`, `cmake --build --preset Debug-stm32f405`, and `git diff --check`; F413 HIL: ST-LINK SN `003B00273234511537333934`, UART `/dev/cu.usbmodem111202` at 921600, motors/fan not commanded, flashed `build/Debug/nightfall_stm32f413.elf`, non-motor smoke `i,w,v` passed with IMU `WHO_AM_I=0x6B`, wall PASS, bounded CSV `tools/logging/logs/stm32_log_20260607_204030.csv`; also verified split search status/dump path with non-destructive UART `[,@` (`[SEARCH-STATE] ... fram=OK`, `[SEARCH-DUMP] source=FRAM`) |
| 20260607-113602 | 20260607-113602-f413-search-step-module-split | F413 search step/map操作を専用モジュールへ分離 | n/a | yes | on branch `codex/f413-test-run-split` after commit `5a49795`, moved F413 search preview, state reset, step runner, map probe/status/clear/dump, local BFS step map, relative decision, and shared `map/visited/smap/mouse` handling from `main.c` into `f413_search_step.h/c`; kept `main.c` as config/routing glue through callbacks for stop switch, wall snapshot, trace context/run hooks, trace flags, tick, and straight wall-control application; verified `cmake --build --preset Debug-stm32f413`, `cmake --build --preset Debug-stm32f405`, `tools/solver_host/run_solver_host.sh --explore-sim --max-steps 512`, `python3 -m py_compile tools/flashing/flash_stlink tools/flashing/flash_uart tools/flashing/make_identity_block.py tools/hil/f413_safe_hil.py`, and `git diff --check`; attempted F413 flash/non-motor HIL via ST-LINK SN `003B00273234511537333934` and UART `/dev/cu.usbmodem112202`, but the host reported `No ST-Link detected` and no `/dev/cu.usbmodem*`, so no firmware was flashed and no motor/fan/NVM command was run in this HIL attempt |
| 20260607-111918 | 20260607-111918-f413-test-run-module-split | F413 test-run状態機械を専用モジュールへ分離 | n/a | yes | on branch `codex/f413-test-run-split` at firmware `stable/classic/unit001/s20260404-nationals-161-g3e18ec6-dirty`, moved F413 test-run name/arm/button state, single-motor `6`-`9`, and closed-loop tests `1`-`5` from `main.c` into `f413_test_run.h/c` with callback boundaries for trace, run-session guard, wall-control, encoder, motor, tick/delay, and result metadata; added `f413_test_run.c` to F413 CMake and left `main.c` as configuration/routing glue; verified `cmake --build --preset Debug-stm32f413`, `cmake --build --preset Debug-stm32f405`, `tools/solver_host/run_solver_host.sh --explore-sim --max-steps 512`, `python3 -m py_compile tools/flashing/flash_stlink tools/flashing/flash_uart tools/flashing/make_identity_block.py tools/hil/f413_safe_hil.py`, and `git diff --check`; flashed F413 via ST-LINK SN `003B00273234511537333934` and UART `/dev/cu.usbmodem112202` at 921600 with motors allowed because the user confirmed the machine was lifted/fixed; non-motor smoke passed (`i,w,v`, WHO_AM_I `0x6B`, wall PASS, bounded CSV `tools/logging/logs/stm32_log_20260607_201426.csv`); motor HIL passed UART `6,7,8,9` with expected active-side signs (`enc_l=2828`, `enc_r=3118`, `enc_l=-3328`, `enc_r=-2411`); OP UI direct closed-loop test passed via `PPPPPPPPEPE` (`mode8 case1`) with `straight 3 cells heading hold` OK `dist=274mm angle=-0deg` |
| 20260607-052144 | 20260607-052144-f413-codex-hil-loop-smoke | CodexからF413実機HIL基本ループを確認 | n/a | yes | on branch `codex/codex-primary-migration-docs` commit `cc146a1`, configured `Debug`, built `Debug-stm32f413` and `Debug-stm32f405`, flashed F413 via ST-LINK SN `003B00273234511537333934`, verified UART `/dev/cu.usbmodem112202` at 921600; non-motor `i,w,V` passed (`WHO_AM_I=0x6B`, wall PASS) and saved `tools/logging/logs/stm32_log_20260607_141602.csv`; motor allowed because machine was lifted/secured, ran UART `y,V` and saved/analyzed `stm32_log_20260607_141810.csv` with 899 records and forward/coast/reverse flags, then ran UART `6,7` and got `enc_l=2803` and `enc_r=3181`; observed `y` trace flags are present but open-loop motor trace CSV reports `motor_out_l/r=0` and `d_enc=(0,0)`, so future tooling/code should distinguish flag-only open-loop trace from sampled motor/encoder fields; fixed `tools/hil/f413_safe_hil.py reset-capture` to use non-interactive serial capture because `serial_terminal.py` produced a 0-byte boot log in Codex execution |
| 20260607-045854 | 20260607-045854-codex-git-github-policy | Codex移行資料のGit/GitHub管理方針を整理 | n/a | yes | added `docs/ai/GIT_GITHUB_POLICY.md`; updated `AGENTS.md`, Codex onboarding, and AI README to make branch/commit/PR/backup policy explicit; one-off migration backups are kept Git-ignored while canonical docs/tools are committed and published through a draft PR |
| 20260607-044540 | 20260607-044540-codex-primary-migration | Codex主担当移行の入口資料を整備 | n/a | yes | backed up Windsurf/Cascade-era docs to `docs/ai/archive/codex-migration-backup-20260607/`; added root `AGENTS.md`, `docs/ai/CODEX_ONBOARDING.md`, `docs/ai/F413_PORTING_STATE.md`, `docs/ai/HIL_SAFETY.md`, and safe non-motor HIL wrapper `tools/hil/f413_safe_hil.py`; updated AI state/readme/policy docs for Codex primary operation |
| 20260405-022753 | 20260405-022753-codex-delegation-smoke-test | codex delegation smoke test | 0 | no | handoff: /Users/xfa273/workspace/micromouse/nightfall-fw/docs/ai/archive/delegation-legacy/HANDOFFS/20260405-022753-codex-delegation-smoke-test-result.md |
| 20260405-022914 | 20260405-022914-codex-delegation-smoke-test-v2 | codex delegation smoke test v2 | 0 | no | handoff: /Users/xfa273/workspace/micromouse/nightfall-fw/docs/ai/archive/delegation-legacy/HANDOFFS/20260405-022914-codex-delegation-smoke-test-v2-result.md |
| 20260405-030155 | 20260405-030155-add-delegation-ops-section-to-dev-plan | add delegation ops section to dev plan | 0 | no | handoff: /Users/xfa273/workspace/micromouse/nightfall-fw/docs/ai/archive/delegation-legacy/HANDOFFS/20260405-030155-add-delegation-ops-section-to-dev-plan-result.md |
| 20260405-030300 | 20260405-030155-add-delegation-ops-section-to-dev-plan | apply diff | n/a | yes | source: /Users/xfa273/workspace/micromouse/nightfall-fw/docs/ai/archive/delegation-legacy/HANDOFFS/20260405-030155-add-delegation-ops-section-to-dev-plan.diff |
| 20260405-030516 | 20260405-030516-phase3-nvm-identity-robustness-and-f405-address | phase3 nvm identity robustness and f405 address | 0 | no | handoff: /Users/xfa273/workspace/micromouse/nightfall-fw/docs/ai/archive/delegation-legacy/HANDOFFS/20260405-030516-phase3-nvm-identity-robustness-and-f405-address-result.md |
| 20260405-030803 | 20260405-030516-phase3-nvm-identity-robustness-and-f405-address | apply diff | n/a | yes | source: /Users/xfa273/workspace/micromouse/nightfall-fw/docs/ai/archive/delegation-legacy/HANDOFFS/20260405-030516-phase3-nvm-identity-robustness-and-f405-address.diff |
| 20260405-032752 | 20260405-032752-phase3-f405-identity-safe-mode-and-f413-identity | phase3 f405 identity safe mode and f413 identity address finalize | 0 | no | handoff: /Users/xfa273/workspace/micromouse/nightfall-fw/docs/ai/archive/delegation-legacy/HANDOFFS/20260405-032752-phase3-f405-identity-safe-mode-and-f413-identity-result.md |
| 20260405-033600 | 20260405-032752-phase3-f405-identity-safe-mode-and-f413-identity | apply diff (manual) | n/a | yes | source: /Users/xfa273/workspace/micromouse/nightfall-fw/docs/ai/archive/delegation-legacy/HANDOFFS/20260405-032752-phase3-f405-identity-safe-mode-and-f413-identity.diff |
| 20260406-114530 | 20260406-114530-migrate-hatena-post-2024-12-26 | migrate hatena post 2024-12-26 | 0 | no | handoff: /Users/xfa273/workspace/micromouse/nightfall-fw/docs/ai/archive/delegation-legacy/HANDOFFS/20260406-114530-migrate-hatena-post-2024-12-26-result.md |
| 20260406-115019 | 20260406-114530-migrate-hatena-post-2024-12-26 | apply diff | n/a | yes | source: /Users/xfa273/workspace/micromouse/nightfall-fw/docs/ai/archive/delegation-legacy/HANDOFFS/20260406-114530-migrate-hatena-post-2024-12-26.diff |
| 20260406-115844 | 20260406-115844-migrate-remaining-hatena-micromouse-posts | migrate remaining hatena micromouse posts | 0 | no | handoff: /Users/xfa273/workspace/micromouse/nightfall-fw/docs/ai/archive/delegation-legacy/HANDOFFS/20260406-115844-migrate-remaining-hatena-micromouse-posts-result.md |
| 20260406-120659 | 20260406-115844-migrate-remaining-hatena-micromouse-posts | apply diff | n/a | yes | source: /Users/xfa273/workspace/micromouse/nightfall-fw/docs/ai/archive/delegation-legacy/HANDOFFS/20260406-115844-migrate-remaining-hatena-micromouse-posts.diff |
| 20260406-122249 | 20260406-122249-migrate-three-additional-hatena-posts | migrate three additional hatena posts | 0 | no | handoff: /Users/xfa273/workspace/micromouse/nightfall-fw/docs/ai/archive/delegation-legacy/HANDOFFS/20260406-122249-migrate-three-additional-hatena-posts-result.md |
| 20260406-123224 | 20260406-122249-migrate-three-additional-hatena-posts | apply diff | n/a | yes | source: /Users/xfa273/workspace/micromouse/nightfall-fw/docs/ai/archive/delegation-legacy/HANDOFFS/20260406-122249-migrate-three-additional-hatena-posts.diff |
| 20260418-120841 | 20260418-120841-cascade-only-policy-update | switch to Cascade-only execution policy | n/a | n/a | updated AGENTS/docs/workflows to suspend Codex delegation |
| 20260418-123044 | 20260418-123044-f413-mini-r2-0-unit001-identity-bringup | F413 mini初号機にapp+identityを書き込み | n/a | yes | flashed build/Debug/nightfall_stm32f413.bin and build/identity/mini_r2_0_unit001.bin (family=mini, board_id=0x00020000, rev=2.0, unit=1) |
| 20260418-125125 | 20260418-125125-f413-uart-trace-temporary-mode | F413のログ経路を暫定UART運用へ固定 | n/a | yes | set NIGHTFALL_TRACE_F413_USE_UART=1 in cmake, fixed trace.c huart1 extern, rebuilt Debug-stm32f413 and reflashed via flash_uart |
| 20260418-130633 | 20260418-130633-f413-nvm-uart-cli-verification-entry | F413のdistance/sensor/maze検証入口をUARTコマンドで追加 | n/a | yes | add NVM test commands(h/a/d/s/m) in f413 main.c, rebuild Debug-stm32f413 for checklist step5 execution |
| 20260418-130835 | 20260418-130835-f413-nvm-uart-cli-flash | F413へNVM UART検証入口付きファームを再書き込み | n/a | yes | flashed build/Debug/nightfall_stm32f413.bin (45864 bytes) via flash_uart --erase app; profile stm32f413 protected sectors 12-15 |
| 20260418-131145 | 20260418-131145-f413-nvm-step5-device-pass | F413実機でNVM step5（save/load + load-only）を確認 | n/a | yes | serial logs show a-command overall PASS and reboot after A-command load-only PASS for distance/sensor/maze |
| 20260418-131324 | 20260418-131324-f413-step5-doc-sync | F413実機検証結果をPhase3/計画系ドキュメントへ反映 | n/a | yes | updated EXPERIMENT_LOG, PHASE3_CHECKLIST, NVM_MIGRATION_PLAN, NIGHTFALL_FW_2026_DEVELOPMENT_PLAN with Step2-5 verification status |
| 20260418-131948 | 20260418-131948-f413-fram-backend-enable | F413 NVMをFRAM backendへ切替実装 | n/a | yes | updated nvm.c backend dispatch (identity=internal flash, others=external FRAM), built Debug-stm32f413 and reflashed new binary (49456 bytes) |
| 20260418-132520 | 20260418-132520-f413-fram-distance-save-fix | FRAM distance save失敗の根因修正（base=0判定） | n/a | yes | fixed nvm_get_area_info() to allow FRAM offset base 0x00000000, rebuilt Debug-stm32f413 and reflashed new binary (49464 bytes) |
| 20260418-132958 | 20260418-132958-f413-fram-trace-log-test-entry | F413 NVMテストへtrace_log(FRAM)検証コマンドを追加 | n/a | yes | add UART commands t/T for NVM_AREA_TRACE_LOG save-load and load-only verify, rebuilt Debug-stm32f413 and reflashed binary (50336 bytes) |
| 20260419-062400 | 20260419-062400-f413-fram-device-verify-all-areas | F413 FRAM backendの全NVM area実機検証を完了 | n/a | yes | user logs confirm `a/A/t/T` all PASS for distance/sensor/maze/trace (`GIT=7f02576 DIRTY=1`), docs synchronized (EXPERIMENT_LOG/NVM_MIGRATION_PLAN/PHASE3_CHECKLIST/DEVELOPMENT_PLAN) |
| 20260419-063200 | 20260419-063200-f413-hardware-bringup-cli-and-checklist | F413ハード単体確認コマンドとチェックリストを整備 | n/a | yes | added UART hardware test commands `w/p/i/b/o/e/g` in f413 main.c, built Debug-stm32f413/Debug-stm32f405 successfully, added docs/F413_HARDWARE_BRINGUP_CHECKLIST.md |
| 20260419-065500 | 20260419-065500-f413-wall-sensor-cli-adc-read-fix | F413壁センサCLIのADC読取失敗を修正 | n/a | yes | replaced scan-based wall test read with per-channel single conversion (`HAL_ADC_ConfigChannel` + poll), restore original ADC config after test via `MX_ADC1_Init()`, rebuilt Debug-stm32f413 |
| 20260419-074400 | 20260419-074400-f413-encoder-cli-window-and-restart-fix | F413エンコーダCLIを3秒測定へ改修 | n/a | yes | changed `e` command to 3000ms window, added encoder stop/counter reset/start/stop sequence to avoid intermittent `FAIL(start L)`, rebuilt Debug-stm32f413, updated bring-up checklist step 6 |
| 20260419-104700 | 20260419-104700-f413-led-30s-uart-test | F413にLED30秒点灯UARTテストを追加 | n/a | yes | added command `l/L` to turn on all LEDs for 30000ms for photo capture, updated CLI help and bring-up checklist, rebuilt Debug-stm32f413 |
| 20260425-073000 | 20260425-073000-phase4-trace-log-schema-v1 | Phase4 trace_log形式v1固定とUART検証コマンドを実装 | n/a | yes | added `nvm_trace_log.(h/c)` with header/record schema + format/append/read API, updated F413 CLI (`q/r/R`) and help, set trace area schema version in nvm table, updated migration plan/spec docs, built Debug-stm32f413 and Debug-stm32f405 |
| 20260430-174800 | 20260430-174800-phase4-trace-log-csv-selftest | Phase4 trace_logにCSV dumpと自己検証コマンドを追加 | n/a | yes | added F413 UART commands `v/V` (CSV dump with `#mm_columns`) and `k/K` (format+append+readback selftest), updated trace-log spec/migration/development docs, rebuilt Debug-stm32f413 and Debug-stm32f405 |
| 20260430-175600 | 20260430-175600-phase4-trace-log-auto-capture | Phase4 trace_logに定周期自動収集コマンドを追加 | n/a | yes | added F413 UART commands `u`(start auto) and `U`(stop auto), periodic append service in main loop (10ms), auto records set flag bit15, updated docs/specs, rebuilt Debug-stm32f413 and Debug-stm32f405 |
| 20260430-180200 | 20260430-180200-phase4-trace-log-csv-fw-meta | trace CSVダンプへFW/identityメタ情報を追加 | n/a | yes | `v` command now emits `#fw_*` lines (target/version/build/git/schema/family/board/rev/unit), updated trace-log format spec, rebuilt Debug-stm32f413 and Debug-stm32f405 |
| 20260430-180800 | 20260430-180800-phase4-trace-log-csv-all-dump | trace CSVダンプに全件取得コマンドVを追加 | n/a | yes | split CSV dump into `v`(latest 256) and `V`(all stored records), updated trace-log format spec, rebuilt Debug-stm32f413 and Debug-stm32f405 |
| 20260430-181200 | 20260430-181200-phase4-trace-log-run-hook-wrapper | trace log開始停止をrun hookラッパー経由に整理 | n/a | yes | `u/U` command path now calls `nightfall_trace_log_on_run_start/stop`, CLI help/spec wording updated to run-hook semantics for future run event linkage, rebuilt Debug-stm32f413 and Debug-stm32f405 |
| 20260430-181700 | 20260430-181700-phase4-trace-log-auto-step-lightweight | trace自動収集ループのヘッダ読出しを削減して軽量化 | n/a | yes | auto step now uses RAM-managed `g_trace_log_auto_seq` instead of `nvm_trace_log_get_header()` every 10ms tick, keeping output schema unchanged, rebuilt Debug-stm32f413 and Debug-stm32f405 |
| 20260430-182300 | 20260430-182300-machine-naming-and-identity-rules | 機体命名と識別子ルールを確定し起動ログ/CSVへ反映 | n/a | yes | clarified 3-layer naming (`FW_TARGET` / `machine_name` / `machine_unit`), fixed board_id encoding rule (`0x00MMNNVV`) in policy/spec docs, updated F413 boot log and trace CSV metadata to emit family name and machine names, rebuilt Debug-stm32f413 and Debug-stm32f405 |
| 20260430-183100 | 20260430-183100-run-hook-connected-to-smoke-path | run start/stop hookをF413実行経路へ接続 | n/a | yes | wired `g` command path to `nightfall_trace_log_on_run_start/stop` via smoke+trace session wrapper, added auto start/stop idempotent guards (`already running/stopped`), updated trace-log spec/help wording, rebuilt Debug-stm32f413 and Debug-stm32f405 |
| 20260430-183600 | 20260430-183600-smoke-trace-auto-step-fix | g実行中にtrace auto_stepが回らない不具合を修正 | n/a | yes | fixed `g` smoke+trace path where loop-level `auto_step` was not reached during blocking smoke command, inserted explicit `nightfall_trace_log_auto_step()` calls between smoke subtests and before stop hook; resolves `auto: STOP total=0` symptom, rebuilt Debug-stm32f413 and Debug-stm32f405 |
| 20260430-184200 | 20260430-184200-run-session-idle-command | runセッション最小検証コマンドxを追加 | n/a | yes | added `x/X` command to run 1000ms idle trace session via `run-start`/`run-stop` hook path without motor actuation, prints `[RUN-TEST]` logs, updated CLI help and trace-log spec, rebuilt Debug-stm32f413 and Debug-stm32f405 |
| 20260430-184900 | 20260430-184900-run-session-motor-command | runセッション短時間モータ検証コマンドyを追加 | n/a | yes | added `y/Y` command to run short forward/reverse motor pulses inside run-start/stop hook trace session, added auto-step wait helper for deterministic 10ms capture during blocking waits, updated trace-log spec and F413 bring-up checklist, rebuilt Debug-stm32f413 and Debug-stm32f405 |
| 20260430-185400 | 20260430-185400-run-session-phase-flags | runセッション位相をtrace flagsへ記録 | n/a | yes | added v1 flag bits for idle/forward/coast/reverse/smoke phases and mode-flag propagation in auto capture path, updated `x/y/g` to set phase flags during run sessions, documented new flag map and checklist expectations, rebuilt Debug-stm32f413 and Debug-stm32f405 |
| 20260430-190200 | 20260430-190200-host-trace-phase-analyzer | trace CSV位相要約のホストツールを追加 | n/a | yes | added `tools/logging/analyze_trace_csv.py` to summarize phase segments from `flags` bits and validate expected session phases (`--expect x/y`), updated logging README and trace-log spec host workflow, validated script with `python3 -m py_compile` |
| 20260424-102129 | 20260424-102129-blog-machine-pages-template | ブログトップ機体一覧リンクと機体紹介テンプレートを追加 | n/a | yes | added `docs/blog/machines/*/README.md` templates and linked from `docs/blog/README.md`; deploy via GitHub Pages |
| 20260430-101900 | 20260430-101900-logging-default-path-repo-and-analyzer-dir-fallback | CSVログ既定保存先をrepo内へ統一し解析の空ファイル誤選択を改善 | n/a | yes | changed defaults to `tools/logging/logs` in `serial_capture_csv.py`/`.sh` and `visualizer/web_visualizer.py`; `analyze_trace_csv.py` now picks latest CSV containing trace rows when a directory is given |
| 20260430-102700 | 20260430-102700-serial-capture-inline-command-send | CSVキャプチャ中にUARTコマンド送信を可能化 | n/a | yes | extended `tools/logging/serial_capture_csv.py` with `--send` auto command sequence and interactive stdin command send, so `q/y/V` can be issued without opening another serial monitor; updated `tools/logging/README.md` |
| 20260430-103800 | 20260430-103800-run-trace-x-validation-and-next-plan | x実測検証完了と探索/最短統合作業計画の追加 | n/a | yes | validated `q,x,V` capture with `analyze_trace_csv.py --expect x` (idle phase), hardened `serial_capture_csv.py` (skip non-ASCII cmd, graceful serial read stop), corrected checklist idle flag expectation to `32770`, and added Phase 4.5 plan for F413 exploration/shortest integration in development plan |
| 20260430-104100 | 20260430-104100-analyzer-expect-aware-file-select | analyzeのディレクトリ選択をexpect位相連動に改善 | n/a | yes | updated `tools/logging/analyze_trace_csv.py` to prefer latest CSV matching `--expect x/y` when a directory is given, avoiding x/y連続試験での誤ファイル選択; updated `tools/logging/README.md` |
| 20260430-120500 | 20260430-120500-phase45-safe-zj-run-entry | Phase4.5 step1としてz/j安全run-trace入口を追加 | n/a | yes | added F413 UART commands `z`(search-safe) and `j`(shortest-safe) with low-speed short motion, PUSH-switch immediate abort, trace flags bit6/bit7 logging, updated F413 help text, trace-log format spec, bring-up checklist, and development plan progress note |
| 20260430-123323 | 20260430-123323-phase45-zj-csv-validation-and-analyzer | Phase4.5 step2としてz/j実測検証とhost解析導線を整備 | n/a | yes | confirmed z/j measured CSV flags and switch-abort behavior, extended `tools/logging/analyze_trace_csv.py` with `--expect z/j` (including directory auto-select), and synced `tools/logging/README.md` / `docs/F413_HARDWARE_BRINGUP_CHECKLIST.md` / `docs/NVM_TRACE_LOG_FORMAT_SPEC.md` / development plan |
| 20260430-124200 | 20260430-124200-phase45-zj-run-guard-and-abort-flags | Phase4.5 step3としてz/jにrun guardと停止理由flagsを統合 | n/a | yes | integrated guard checks in F413 `z/j` path for switch/wall/encoder/imu faults, emit abort reason flags bit8-bit11 in trace CSV, updated trace-log spec / bring-up checklist / development plan, rebuilt Debug-stm32f413 |
| 20260430-130100 | 20260430-130100-serial-capture-ctrlc-exit-fix | serial_capture_csvのCtrl+C終了不能を修正 | n/a | yes | changed `tools/logging/serial_capture_csv.py` to non-blocking serial open and non-blocking stdin incremental read (removed blocking `readline` path) so SIGINT can terminate reliably; validated with `python3 -m py_compile` |
| 20260430-131600 | 20260430-131600-trace-analyzer-abort-summary-and-signed-enc-delta | z/j解析の停止理由要約とエンコーダ差分表示を改善 | n/a | yes | updated `tools/logging/analyze_trace_csv.py` to print abort_count(bit8-bit11) and compute segment `d_enc` as signed 16-bit delta to suppress wrap artifacts; updated `tools/logging/README.md`; validated by `py_compile` and sample `--expect z/j` runs |
| 20260430-132300 | 20260430-132300-phase45-zj-entry-wrapper-step4 | Phase4.5 step4としてz/jを探索/最短実行入口ラッパーへ接続 | n/a | yes | added F413 `nightfall_run_search_trace_entry_once` / `nightfall_run_shortest_trace_entry_once` and routed UART `z/j` through these entry points (safe fallback path retained), updated help/checklist/development plan wording, rebuilt Debug-stm32f413 |
| 20260430-133000 | 20260430-133000-phase45-zj-real-path-gate-macro | F413 z/j入口の本経路切替ゲートをCMake定義化 | n/a | yes | added `NIGHTFALL_F413_REAL_RUN_PATH_ENABLED=0` compile definition in `cmake/stm32cubemx/CMakeLists.txt`, made main.c gate configurable with fallback default, and added explicit gate-on trace messages at z/j entry wrappers; rebuilt Debug-stm32f413 |
| 20260430-133900 | 20260430-133900-phase45-zj-real-path-draft-bfs | Phase4.5 step5としてz/j入口に本経路ドラフト算出を追加 | n/a | yes | added gate-on draft path check in F413 main.c (`nvm_maze_load_map` + BFS shortest-step estimation to goal) and entry logs before safe fallback execution, updated development plan and trace-log spec notes, rebuilt Debug-stm32f413 |
| 20260430-134600 | 20260430-134600-phase45-zj-real-path-draft-metrics | z/j入口の本経路ドラフト指標を拡張 | n/a | yes | enhanced F413 gate-on BFS draft output to include turn count and straight segment count in addition to steps by reconstructing path from predecessor chain; updated development plan/spec notes; rebuilt Debug-stm32f413 |
| 20260501-000000 | 20260501-000000-phase45-step6-solver-integration | Phase4.5 step6: solver/path/maze_gridモジュールをF413ビルドに統合 | n/a | yes | created `params/f413_preorder/` (params.h + run params), `f413_solver_bridge.c` (MAIN_C_ globals + load_map_from_eeprom NVM adapter), added solver.c/solver_params.c/path.c/maze_grid.c to F413 CMake sources, replaced BFS draft in z/j entry wrappers with `solver_build_path()` (Dijkstra + simplify + L-turn conversion), rebuilt Debug-stm32f413 (RAM 55KB/320KB, FLASH 81KB/1536KB) and Debug-stm32f405 |
| 20260501-001500 | 20260501-001500-phase45-step7-solver-path-execution | Phase4.5 step7: solver-path オープンループ走行セッションを実装 | n/a | yes | added `nightfall_run_solver_path_session_once()` to F413 main.c: reads solver-generated `path[]` codes and executes open-loop motor commands (straight=forward×time, turn=rotate×time, coast between segments), with guard checks and trace flags (new bit12=SOLVER_PATH_FLAG); z/j entry wrappers call this when solver succeeds, fallback to safe session on failure; updated development plan Step7; rebuilt Debug-stm32f413 (RAM 55KB, FLASH 83KB) and Debug-stm32f405 |
| 20260501-084700 | 20260501-084700-phase45-step8-closed-loop-control | Phase4.5 step8: TIM5 1kHz PID速度制御とクローズドループ走行 | n/a | yes | created `f413_control.c/h` with TIM5 1kHz interrupt: TIM3/TIM4 encoder velocity/omega calculation + P+FF velocity/omega control + TIM2 motor PWM output; added `HAL_TIM_PeriodElapsedCallback` in main.c; rewrote solver path session to use `f413_ctrl_start/stop/set_velocity/set_omega` with distance(45mm×N)/angle(90°/180°) target completion; rebuilt Debug-stm32f413 (RAM 55KB/320KB, FLASH 84KB/1536KB) and Debug-stm32f405 |
| 20260501-090000 | 20260501-090000-phase45-step8-imu-and-encoder-direction | Step8補: IMU角速度制御追加とエンコーダ方向確定 | n/a | yes | added ISM330DHCX IMU init/read/offset/LPF to f413_control.c (角速度をエンコーダ差動→IMUジャイロに変更); confirmed encoder direction from y-command CSV (forward=counter decrease → *(-1.0f) for positive velocity); rebuilt Debug-stm32f413 |
| 20260501-105700 | 20260501-105700-phase45-test-mode | 調整用テストモードを追加 | n/a | yes | added UART commands 1-5 for direct test execution (S3/S6 straight, R90/L90 turn, S3+R90+S3 combo) with closed-loop control + trace log; added F command for button-armed untethered execution (disconnect UART → button press → test runs → FRAM save → reconnect → V dump); rebuilt Debug-stm32f413 (RAM 55KB, FLASH 86KB) |
| 20260506-054700 | 20260506-054700-f413-migration-backup-before-doc-sync | F413移植作業ツリーをバックアップ | n/a | yes | created and pushed `backup/20260506-1447-before-f413-doc-sync` with WIP commit `e3d925b` before documentation synchronization; excluded generated `site/` and captured CSV logs from commit |
| 20260506-055000 | 20260506-055000-f413-phase45-doc-sync | F413 Phase4.5進捗ドキュメント同期 | n/a | yes | updated development plan, trace-log format spec, bring-up checklist, and logging README for `NIGHTFALL_F413_REAL_RUN_PATH_ENABLED=1`, closed-loop solver path, trace flag bit12, and UART test commands `1`-`9`/`F` |
| 20260506-061540 | 20260506-061540-workspace-context-cleanup | コンテクスト消費削減のためワークスペースを軽量化 | n/a | yes | removed stale `.ai/worktrees` + generated `build*`/`site`/`tools/logging/logs` and added root `.codeiumignore` (`_sandbox`, `docs/blog`, `docs/datasheets`, hardware CAD assets, generated artifacts) |
| 20260506-061859 | 20260506-061859-delegation-ignore-policy-sync | 委譲関連資産を復活指示まで無視する運用へ整理 | n/a | yes | updated `AGENTS.md`, `docs/ai/STATE.md`, `docs/ai/README.md`, and root `.codeiumignore` to keep delegation assets as archive but out of normal reference/index scope |
| 20260506-062604 | 20260506-062604-delegation-legacy-archive-move | 委譲関連の不要資産をアーカイブへ移動して整理 | n/a | yes | consolidated delegation legacy assets under `docs/ai/archive/delegation-legacy/` and synchronized references/ignore paths |
| 20260506-063912 | 20260506-063912-f413-motor-encoder-control-prehw | F413モータ/エンコーダ/並進制御の実機前確認 | n/a | yes | fixed F413 open-loop motor helper and trace CSV `motor_out_l/r` mapping to match hardware (`TIM2_CH3=left`, `TIM2_CH1=right`); rebuilt Debug-stm32f413 and Debug-stm32f405 successfully; next step is device verification with UART commands `o/e/6/7/8/9/1` |
| 20260506-064543 | 20260506-064543-agents-archive-and-remove | AGENTS運用ルールをアーカイブ化して削除 | n/a | yes | moved root `AGENTS.md` to `docs/ai/archive/AGENTS.md`, updated related references, and prepared clean git state before resuming migration work |
| 20260506-065803 | 20260506-065803-f413-encoder-sign-and-zero-alias | F413実機エンコーダ確認結果を反映 | n/a | yes | added UART `0` alias for motor test (`o`) to avoid zero/O confusion; fixed encoder delta display to handle TIM3/TIM4 wraparound and invert right encoder sign; updated closed-loop velocity calculation with `L=+1`, `R=-1`; rebuilt Debug-stm32f413 successfully |
| 20260506-072341 | 20260506-072341-f413-hw-enc-open-loop-simplify | F413片側モータ+エンコーダ確認の実機結果を反映 | n/a | yes | user confirmed motor test `0/o` and encoder test `e` are OK; changed UART `6`-`9` HW encoder/motor checks to bypass run guard and trace auto logging, using direct `nightfall_motor_set()` + `HAL_Delay()` like `0/o`; removed unreachable legacy guarded `6`-`9` switch cases; rebuilt Debug-stm32f413 successfully |
| 20260506-073400 | 20260506-073400-f413-motor-channel-direction-fix | F413片側モータ回転方向の実機結果を反映 | n/a | yes | user observed UART `6`-`9` motor selection/direction mismatch; corrected F413 motor mapping to `TIM2_CH1=left`, `TIM2_CH3=right`, `L_DIR RESET=forward`, `R_DIR SET=forward` in `nightfall_motor_set()`, trace motor output sampling, and closed-loop `f413_ctrl_tick()` motor output; rebuilt Debug-stm32f413 successfully |
| 20260506-075903 | 20260506-075903-f413-mp6551-in1-in2-control | F413 MP6551モータドライバ入力制御を修正 | n/a | yes | checked `hardware/mini_r2_0/cad/HM_Nightfall-mini-2e_v1.sch`: `MOTOR_*_PWM` connects to MP6551 `IN1`, `MOTOR_*_DIR` connects to `IN2`, and `MOTOR_STBY` connects to `EN1/EN2`; fixed `nightfall_motor_set()` and closed-loop `f413_ctrl_tick()` to treat stop as `IN1=0, IN2=0` and use inverted PWM when driving the `IN2` direction, avoiding inactive motor full-drive; rebuilt Debug-stm32f413 successfully |
| 20260506-080359 | 20260506-080359-f413-motor-encoder-hw-pass | F413片側モータ+エンコーダ実機確認PASS | n/a | yes | user confirmed UART `6`-`9` now match expected motor selection/direction and encoder signs (`6` L fwd positive, `7` R fwd positive, `8` L rev negative, `9` R rev negative); fixed test log display for inactive motor `IN2=RESET`; next step is closed-loop checks with UART `1`/`2` |
| 20260506-081341 | 20260506-081341-f413-imu-manual-angle-test | F413手動旋回IMU角度テストを追加 | n/a | yes | added UART `I` command for manual IMU yaw verification without motor drive: configures ISM330DHCX gyro, samples stationary Z gyro offset, then logs `omega_z` and integrated `angle` for 8 seconds at 200ms print intervals; expected sign is CCW/left positive and CW/right negative |
| 20260506-082819 | 20260506-082819-f413-turn-angle-control-port | F413旋回角度制御を移植 | e25dc3e | yes | user confirmed IMU yaw direction/angle OK; committed and pushed user CAD updates separately as `e25dc3e Update mini CAD files`; ported F413 turn control toward F405 structure by adding angle-target API, angle outer loop, omega PID I/D state, signed angle wait for UART `3`/`4`/`5`, and using target angle for solver turns; rebuilt Debug-stm32f413 successfully |
| 20260506-083720 | 20260506-083720-f413-turn-button-start-delay | F413旋回テストをボタン始動+2秒静止待ちへ変更 | n/a | yes | changed UART `3`/`4`/`5` to arm the selected turn test instead of running immediately, so the UART cable can be disconnected before motion; button release now waits 2 seconds before `nightfall_test_run()`, allowing the IMU offset recalibration inside `f413_ctrl_start()` to happen after the robot settles |
| 20260506-084513 | 20260506-084513-f413-turn-gain-increase | F413旋回ゲインを実機結果に基づき増加 | n/a | yes | user confirmed turn direction/behavior look correct but gain was too low to complete 90deg; increased angle/omega gains and omega feed-forward, raised omega integral limit, and added minimum rotation PWM when commanded omega is above a small threshold to overcome static friction near the end of the turn; rebuilt Debug-stm32f413 successfully |
| 20260506-085323 | 20260506-085323-f413-straight-heading-hold-test | F413直進+方位保持テストを用意 | n/a | yes | user confirmed UART `3` can turn right 90deg though oscillatory and deferred detailed turn tuning; changed UART `1`/`2` straight tests to reset angle and enable angle target 0deg while running velocity control, changed `5` straight segments to the same heading-hold behavior, made motion tests `1`-`5` button-armed, and limited minimum rotation PWM to near-zero target velocity so straight heading correction does not force bang-bang minimum PWM; rebuilt Debug-stm32f413 successfully |
| 20260506-090136 | 20260506-090136-f413-last-test-csv-meta | F413直前テスト結果をCSVメタに追加 | n/a | yes | user confirmed UART `1` heading-hold straight test looked good and provided CSV; noted encoder columns stay near the 30000 center because the control loop recenters TIM3/TIM4 every tick, so added `#last_test_id`, `#last_test_status`, `#last_test_dist_mm`, and `#last_test_angle_deg` meta lines to `V` CSV output without changing the NVM trace record schema or CSV columns; rebuilt Debug-stm32f413 successfully |
| 20260506-091335 | 20260506-091335-f413-imu-accel-velocity-fusion | F413速度推定にIMU加速度補助を追加 | n/a | yes | user pointed out encoder distance works but 1kHz velocity is resolution-limited with 13.5mm wheel and 100ppr encoder; kept distance integration encoder-based, added forward accelerometer offset sampling and acceleration-integrated velocity corrected back toward encoder velocity with a short time constant for control feedback, and added UART `c/C` IMU accelerometer test that prints offset-compensated ax/ay/az and integrated vx/vy/vz for forward-axis/sign verification; rebuilt Debug-stm32f413 successfully |
| 20260506-092708 | 20260506-092708-f413-forward-accel-axis-y | F413前進加速度軸をY+へ修正 | n/a | yes | user confirmed IMU accelerometer Y+ is forward direction; UART `1` with previous X-axis velocity fusion still completed at `#last_test_dist_mm=300` and `#last_test_angle_deg=-2`; changed `F413_IMU_FORWARD_ACCEL_REG` from X to Y with positive sign and updated UART `c/C` guidance text; rebuilt Debug-stm32f413 successfully |
| 20260506-094701 | 20260506-094701-f413-path-code-step1 | F413 solver path実行をF405 path code体系へ近づけた | n/a | no | started F405 mini parity porting with a low-risk F413-side step: kept existing UART `z/j` solver path runner, added F405 shortest-run parameter lookup, capped requested speeds to the existing safe F413 path velocity, used diagonal half-cell distance for diagonal straight codes, and executed 45/V90/135/large-turn path codes with their parameterized angles instead of degenerating all non-90 codes to 90deg; rebuilt Debug-stm32f413 and Debug-stm32f405 successfully |
| 20260506-100000 | 20260506-100000-f413-path-heading-hold-step2 | F413 solver path実行の方位保持と符号付き旋回判定 | n/a | yes | continued F405 mini parity porting: enabled angle target 0deg during F413 solver path straight/diagonal segments and changed solver path turn wait from absolute-angle completion to signed-angle completion; `cmake --build --preset Debug-stm32f413`, `cmake --build --preset Debug-stm32f405`, and `git diff --check` succeeded |
| 20260507-193400 | 20260507-193400-f413-solver-host-sample-test | F413経路導出のホストサンプルテスト導線を追加 | n/a | no | added `tools/solver_host/run_solver_host.sh` and host shim sources to compile the shared F405/F413 `solver_build_path()` on macOS with F413 preorder params; supports internal open 16x16 sample and KeriLab-style C array files via `--maze-c-array`; verified internal mode2/case1, C-array mode2/case1, and internal case8 runs, then rebuilt Debug-stm32f413 and Debug-stm32f405 successfully |
| 20260507-194500 | 20260507-194500-f413-solver-host-kerilab-maze | KeriLab `.maze` 形式のホスト経路導出確認を追加 | n/a | no | extended `tools/solver_host/solver_host.c` to parse KeriLab text `.maze` files directly via `--maze`, added `tools/solver_host/run_kerilab_samples.sh` to fetch representative 32x32 maze files from `kerikun11/micromouse-maze-data` and run `solver_build_path()` against them, and added `tools/solver_host/README.md`; verified a 16x16 real sample directly plus the default 32x32 sample set, then ran `git diff --check`, `cmake --build --preset Debug-stm32f413`, and `cmake --build --preset Debug-stm32f405` successfully |
| 20260507-195400 | 20260507-195400-f413-turn-log-analysis-phase6 | F413 solver/path移植完了整理とターン評価解析を追加 | n/a | no | accepted small-turn and large-turn path support as the F413 solver/path migration completion point, explicitly deferred diagonal path conversion/running to a post-migration phase, and started Phase 6 by adding `tools/logging/analyze_turn_csv.py` for turn tuning metrics from trace CSV (`omega_z_mdps` integration, final angle error, overshoot, settling time, motor output summary); verified with a synthetic -90deg sample, then ran `git diff --check`, `cmake --build --preset Debug-stm32f413`, and `cmake --build --preset Debug-stm32f405` successfully |
| 20260507-200200 | 20260507-200200-f413-button-sensor-led-op-ui | F413にボタン・壁センサenter・LEDモード表示の操作UIを追加 | n/a | no | ported an F405-like operation flow to the F413 preorder main loop while keeping all UART commands: PUSH advances modes 0-7 on press edge, LED1-3 display the selected mode in binary, and a front-right wall response with front-left non-response is treated as enter after consecutive confirmations; current modes are idle, wall sensor test, S3, R90, L90, S3+R90+S3, search-entry, and shortest-entry; motion modes keep a 2s start delay and existing run guards; `git diff --check`, `cmake --build --preset Debug-stm32f413`, and `cmake --build --preset Debug-stm32f405` succeeded |
| 20260507-202400 | 20260507-202400-f413-op-ui-enter-threshold | F413操作UIのenter閾値を実測値に基づき調整 | n/a | yes | user confirmed mode1 works and measured front sensor delta as roughly 0-50 with no target and 1000+ with a wall; lowered the F413 operation UI front-right enter threshold from 300 to 150 and widened the front-left non-response threshold from 120 to 250 so a hand gesture can also trigger enter with margin, while keeping the 3-sample consecutive confirmation; `git diff --check`, `cmake --build --preset Debug-stm32f413`, and `cmake --build --preset Debug-stm32f405` succeeded |
| 20260507-203000 | 20260507-203000-f413-f405-compatible-op-mode-tree | F413操作UIをF405互換のモード/ケース体系へ拡張 | n/a | no | replaced the temporary F413 0-7 flat operation UI with an F405-compatible selection tree: top-level mode 0-9, mode1-7 case 0-9, and mode1-7 case0 sub 0-9; PUSH beep now uses the F405 `select_mode()` formula `(11-selected)*400`, and enter beep uses tone 900 as two short beeps; safe already-ported entries are wired to F413 wall/IMU tests, S3/R90/S6 motion tests, search entry, and shortest entry where applicable, while unported mode/case/sub selections print their intended F405 meaning and a no-op reason; `git diff --check`, `cmake --build --preset Debug-stm32f413`, and `cmake --build --preset Debug-stm32f405` succeeded |
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
