xfa273/nightfall-fw/hardware/mini_r2_0/notes/erc_fix1.png

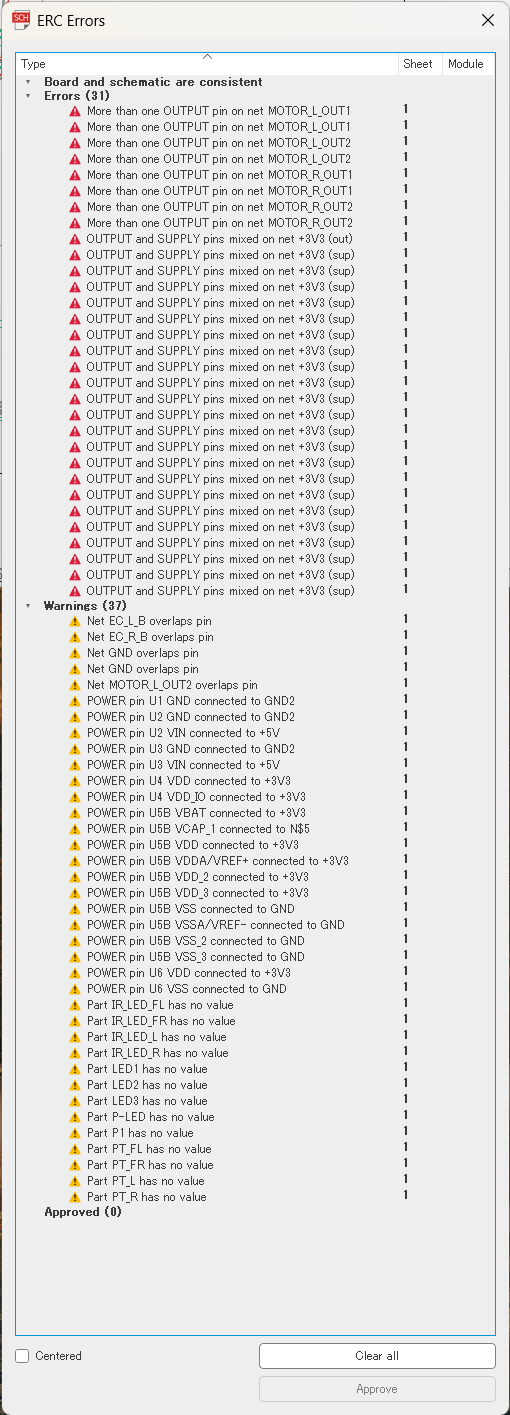
hardware/mini_r2_0/notes/erc_fix1.png
