xfa273/nightfall-fw/hardware/mini_r2_0/cad/Nightfall-mini-2e_v1_fix1.pdf

GND | GND2 +3V³
STM32F413CHU6TRUFQFPN-48_7X7X0P55MM-M | +3V³

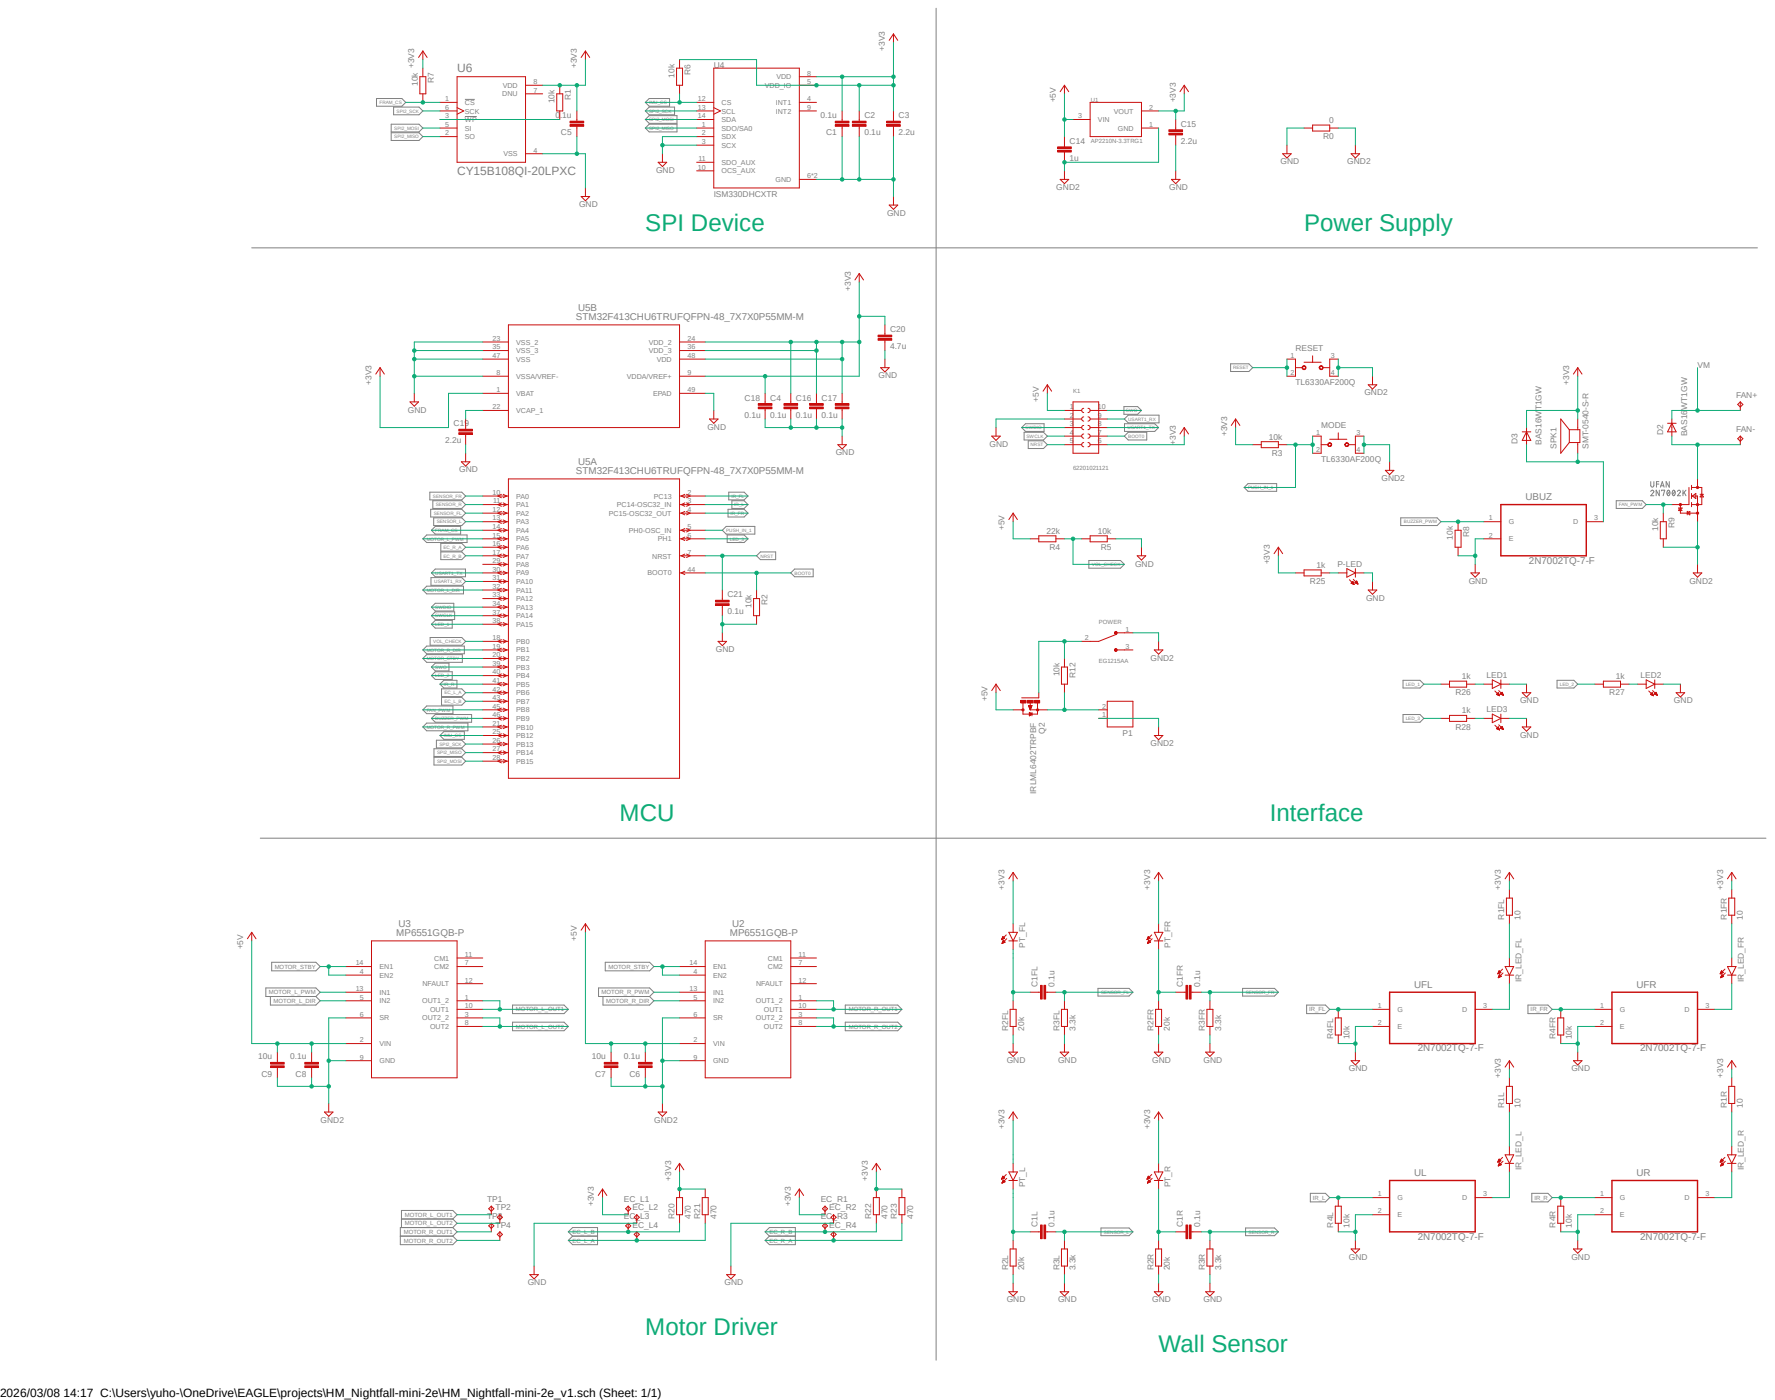
[picture p67: page 1]

2026/03/08 14:17 C:\Users\yuho-\OneDrive\EAGLE\projects\HM_Nightfall-mini-2e\HM_Nightfall-mini-2e_v1.sch (Sheet: 1/1)
