xfa273/nightfall-fw/hardware/mini_r2_0/notes/f413_cad_pin_list.pdf

f413_cad_pin_list.md | 2026-03-07

# STM32F413CHU6 CAD参照ピンリスト（Nightfall F413 Preorder）

### 最終更新: 2026-03-07

このファイルは、回路図/CAD作業時に参照するための固定ピン⼀覧です。

### 対象MCU: STM32F413CHU6 (UFQFPN48)

### ⽣成元: CubeMXプロジェクト HM_Nightfall_f413_preorder.ioc

参照ソース:

### cubemx_project/HM_Nightfall_f413_preorder/HM_Nightfall_f413_preorder.io

c

### cubemx_project/HM_Nightfall_f413_preorder/Core/Inc/main.h cubemx_project/HM_Nightfall_f413_preorder/Core/Src/stm32f4xx_hal_msp.c

## 1. 信号ベース⼀覧（CAD配線⽤）

信号名 | MCUピン | 種別 | 周辺機能/AF | 備考
SENSOR_FR | PA0 | ADC⼊⼒ | ADC1_IN0 | フロント右センサ
SENSOR_R | PA1 | ADC⼊⼒ | ADC1_IN1 | 右センサ
SENSOR_FL | PA2 | ADC⼊⼒ | ADC1_IN2 | フロント左センサ
SENSOR_L | PA3 | ADC⼊⼒ | ADC1_IN3 | 左センサ
VOL_CHECK | PB0 | ADC⼊⼒ | ADC1_IN8 | バッテリ電圧監視
EC_R_A | PA6 | タイマ⼊⼒ | TIM3_CH1 / AF2 | 右エンコーダA
EC_R_B | PA7 | タイマ⼊⼒ | TIM3_CH2 / AF2 | 右エンコーダB
EC_L_A | PB6 | タイマ⼊⼒ | TIM4_CH1 / AF2 | 左エンコーダA
EC_L_B | PB7 | タイマ⼊⼒ | TIM4_CH2 / AF2 | 左エンコーダB
MOTOR_L_PWM | PA5 | PWM出⼒ | TIM2_CH1 / AF1 | 左モータPWM
MOTOR_R_PWM | PB10 | PWM出⼒ | TIM2_CH3 / AF1 | 右モータPWM（CH4ではなくCH3）
FAN_PWM | PB8 | PWM出⼒ | TIM10_CH1 / AF3 | 吸引ファンPWM
BUZZER_PWM | PB9 | PWM出⼒ | TIM11_CH1 / AF3 | ブザーPWM
MOTOR_L_DIR | PA11 | GPIO出⼒ | - | 左モータDIR
MOTOR_R_DIR | PB1 | GPIO出⼒ | - | 右モータDIR
MOTOR_STBY | PB2 | GPIO出⼒ | - | モータドライバSTBY
FRAM_CS | PA4 | GPIO出⼒ | - | SPI2共有バスのFRAM CS

USART1_TX | PA9 | UART | USART1_TX / AF7 | ログ/デバッグ⽤
USART1_RX | PA10 | UART | USART1_RX / AF7 | ログ/デバッグ⽤

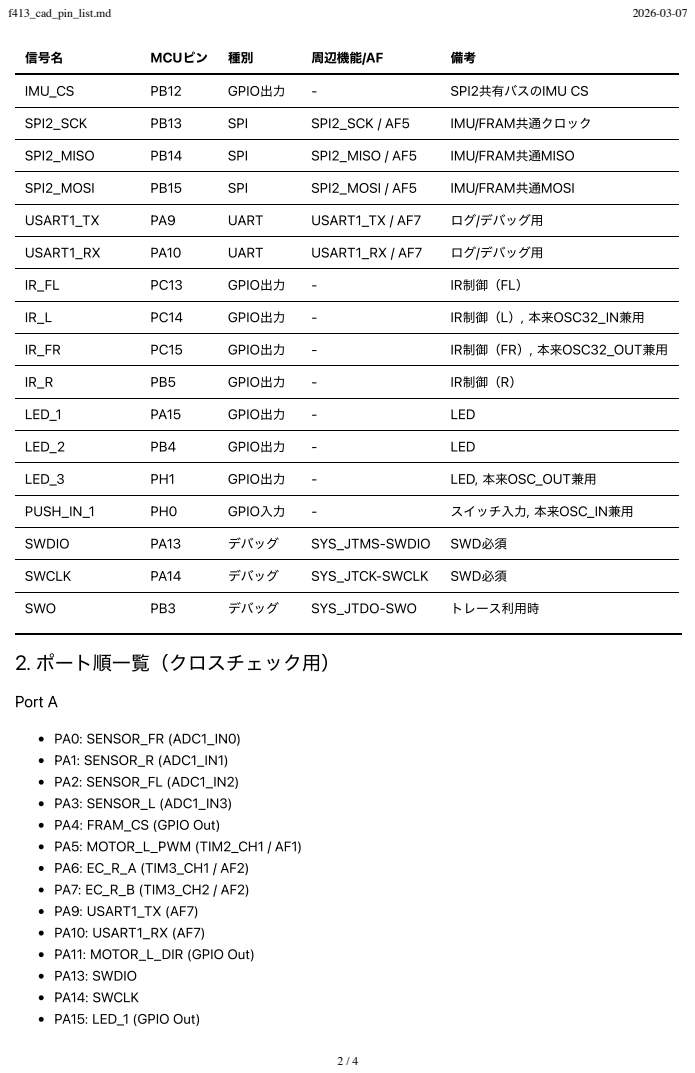
[picture p69: page 2]
信号名; MCUピン; 周辺機能/AF; IMU_CS; GPIO出⼒; SPI2共有バスのIMU CS; SPI2_SCK; SPI; SPI2_SCK / AF5; IMU/FRAM共通クロック; SPI2_MISO; SPI2_MISO / AF5; IMU/FRAM共通MISO; SPI2_MOSI; SPI2_MOSI / AF5; IMU/FRAM共通MOSI; IR制御（FL）; IR制御（L）, 本来OSC32_IN兼⽤; IR制御（FR）, 本来OSC32_OUT兼⽤; IR制御（R）; LED_1; LED; LED_2; LED_3; LED, 本来OSC_OUT兼⽤; PUSH_IN_1; GPIO⼊⼒; スイッチ⼊⼒, 本来OSC_IN兼⽤; SWDIO; デバッグ; SYS_JTMS-SWDIO; SWD必須; SWCLK; SYS_JTCK-SWCLK; SWO; SYS_JTDO-SWO; トレース利⽤時; 2. ポート順⼀覧（クロスチェック⽤）; Port A; PA0: SENSOR_FR (ADC1_IN0)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

## Port B

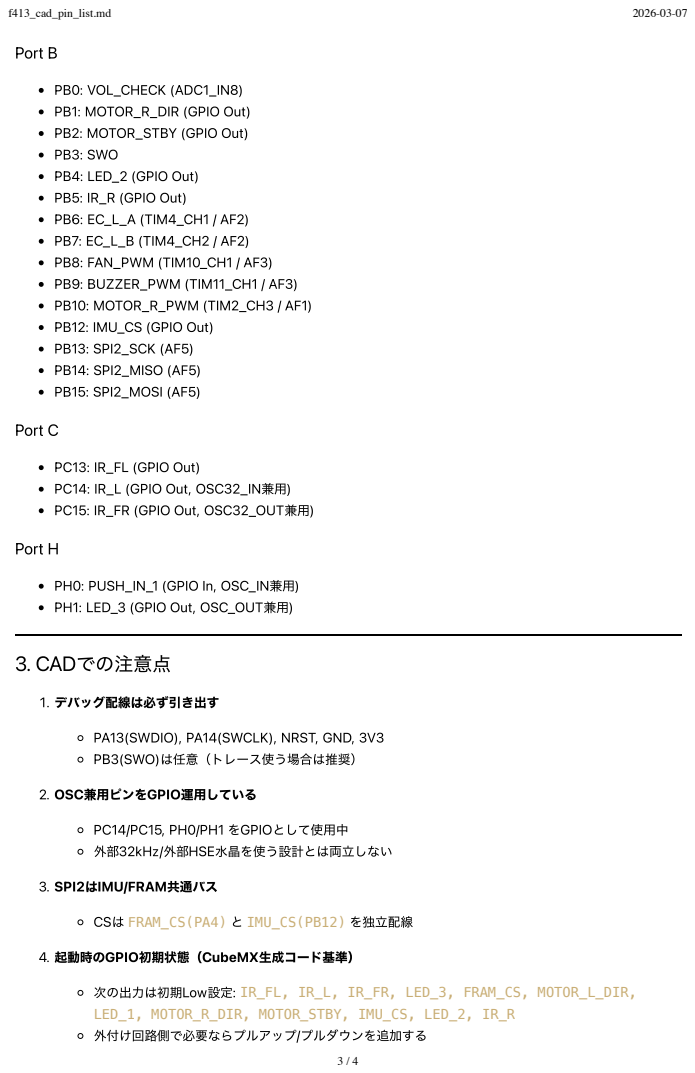
[picture p70: page 3]
PB0: VOL_CHECK (ADC1_IN8); PB1: MOTOR_R_DIR (GPIO Out); PB2: MOTOR_STBY (GPIO Out); PB3: SWO; PB4: LED_2 (GPIO Out); PB5: IR_R (GPIO Out); PB6: EC_L_A (TIM4_CH1 / AF2); PB7: EC_L_B (TIM4_CH2 / AF2); PB8: FAN_PWM (TIM10_CH1 / AF3) PB9: BUZZER_PWM (TIM11_CH1 / AF3); PB10: MOTOR_R_PWM (TIM2_CH3 / AF1); PB12: IMU_CS (GPIO Out); PB13: SPI2_SCK (AF5); PB14: SPI2_MISO (AF5); PB15: SPI2_MOSI (AF5); Port C; PC13: IR_FL (GPIO Out); PC14: IR_L (GPIO Out, OSC32_IN兼⽤); PC15: IR_FR (GPIO Out, OSC32_OUT兼⽤)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

PA13(SWDIO), PA14(SWCLK), NRST, GND, 3V3
PB3(SWO)は任意（トレース使う場合は推奨）

. OSC兼⽤ピンをGPIO運⽤している

PC14/PC15, PH0/PH1 をGPIOとして使⽤中
外部32kHz/外部HSE⽔晶を使う設計とは両⽴しない

CSは FRAM_CS(PA4) と IMU_CS(PB12) を独⽴配線

. 起動時のGPIO初期状態（CubeMX⽣成コード基準）

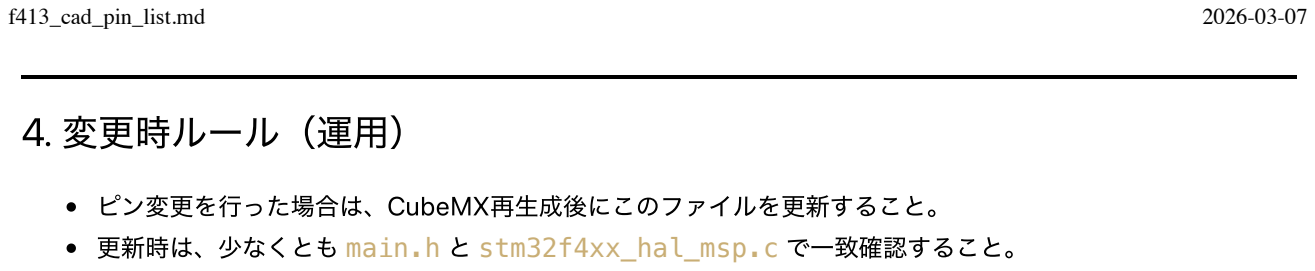
[picture p71: figure]
4. 変更時ルール（運⽤）; ピン変更を⾏った場合は、CubeMX再⽣成後にこのファイルを更新すること。

### 更新時は、少なくとも main.h と stm32f4xx_hal_msp.c で⼀致確認すること。
