xfa273/nightfall-fw/hardware/mini_r2_0/cad/kicad/HM_Nightfall-mini-2e_Encoder-PCB-L/HM_Nightfall-mini-2e_Encoder-PCB-L_v1.kicad_pcb

## KiCad design hardware/mini_r2_0/cad/kicad/HM_Nightfall-mini-2e_Encoder-PCB-L/HM_Nightfall-mini-2e_Encoder-PCB-L_v1.kicad_pcb (2026-09-23)

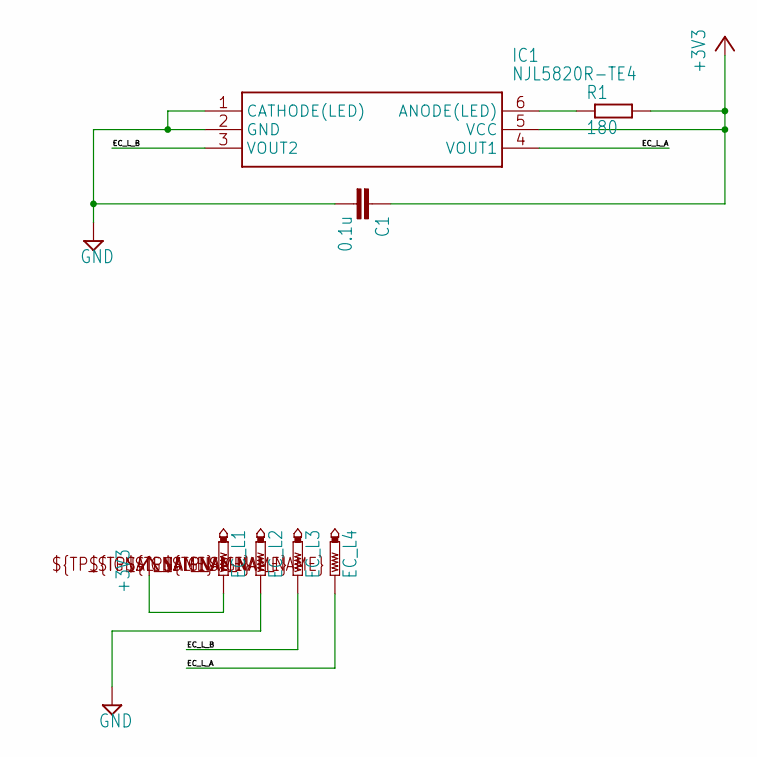
[picture p72: schematic HM_Nightfall-mini-2e_Encoder-PCB-L_v1.kicad_sch]

Parts:
C1: 0.1u; C0402
EC_L1, EC_L2, EC_L3, EC_L4: PTR1TP06SQ; TP06SQ
IC1: NJL5820R-TE4; NJL5820RTE4
R1: 180; R0402

Connections:
+3V3: C1.1, EC_L1.TP, IC1.5 (VCC), R1.2
EC_L_A: EC_L4.TP, IC1.4 (VOUT1)
EC_L_B: EC_L3.TP, IC1.3 (VOUT2)
GND: C1.2, EC_L2.TP, IC1.1 (CATHODE(LED)), IC1.2 (GND)
unnamed: IC1.6 (ANODE(LED)), R1.1

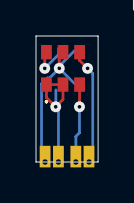
[picture p73: board HM_Nightfall-mini-2e_Encoder-PCB-L_v1.kicad_pcb from above]

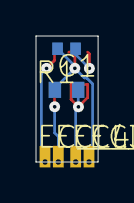
[picture p74: board HM_Nightfall-mini-2e_Encoder-PCB-L_v1.kicad_pcb from below]

Board: 2 copper layers, 3.4 x 7.0 mm, 7 parts (6 on the bottom side), 5 nets.
