xfa273/nightfall-fw/hardware/mini_r2_0/cad/kicad/HM_Nightfall-mini-2e_Encoder-PCB-R/HM_Nightfall-mini-2e_Encoder-PCB-R_v1.kicad_pcb

## KiCad design hardware/mini_r2_0/cad/kicad/HM_Nightfall-mini-2e_Encoder-PCB-R/HM_Nightfall-mini-2e_Encoder-PCB-R_v1.kicad_pcb (2026-09-23)

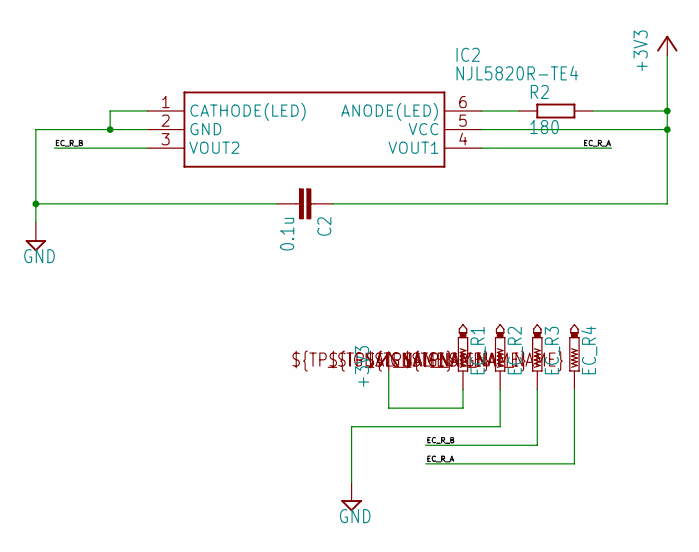
[picture p75: schematic HM_Nightfall-mini-2e_Encoder-PCB-R_v1.kicad_sch]

Parts:
C2: 0.1u; C0402
EC_R1, EC_R2, EC_R3, EC_R4: PTR1TP06SQ; TP06SQ
IC2: NJL5820R-TE4; NJL5820RTE4
R2: 180; R0402

Connections:
+3V3: C2.1, EC_R1.TP, IC2.5 (VCC), R2.2
EC_R_A: EC_R4.TP, IC2.4 (VOUT1)
EC_R_B: EC_R3.TP, IC2.3 (VOUT2)
GND: C2.2, EC_R2.TP, IC2.1 (CATHODE(LED)), IC2.2 (GND)
unnamed: IC2.6 (ANODE(LED)), R2.1

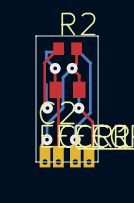
[picture p76: board HM_Nightfall-mini-2e_Encoder-PCB-R_v1.kicad_pcb from above]

Board: 2 copper layers, 3.4 x 7.0 mm, 7 parts (1 on the bottom side), 5 nets.
