xfa273/nightfall-fw/hardware/mini_r2_0/cad/kicad/HM_Nightfall-mini-2e/HM_Nightfall-mini-2e_v1.kicad_pcb

## KiCad design hardware/mini_r2_0/cad/kicad/HM_Nightfall-mini-2e/HM_Nightfall-mini-2e_v1.kicad_pcb (2026-09-23)

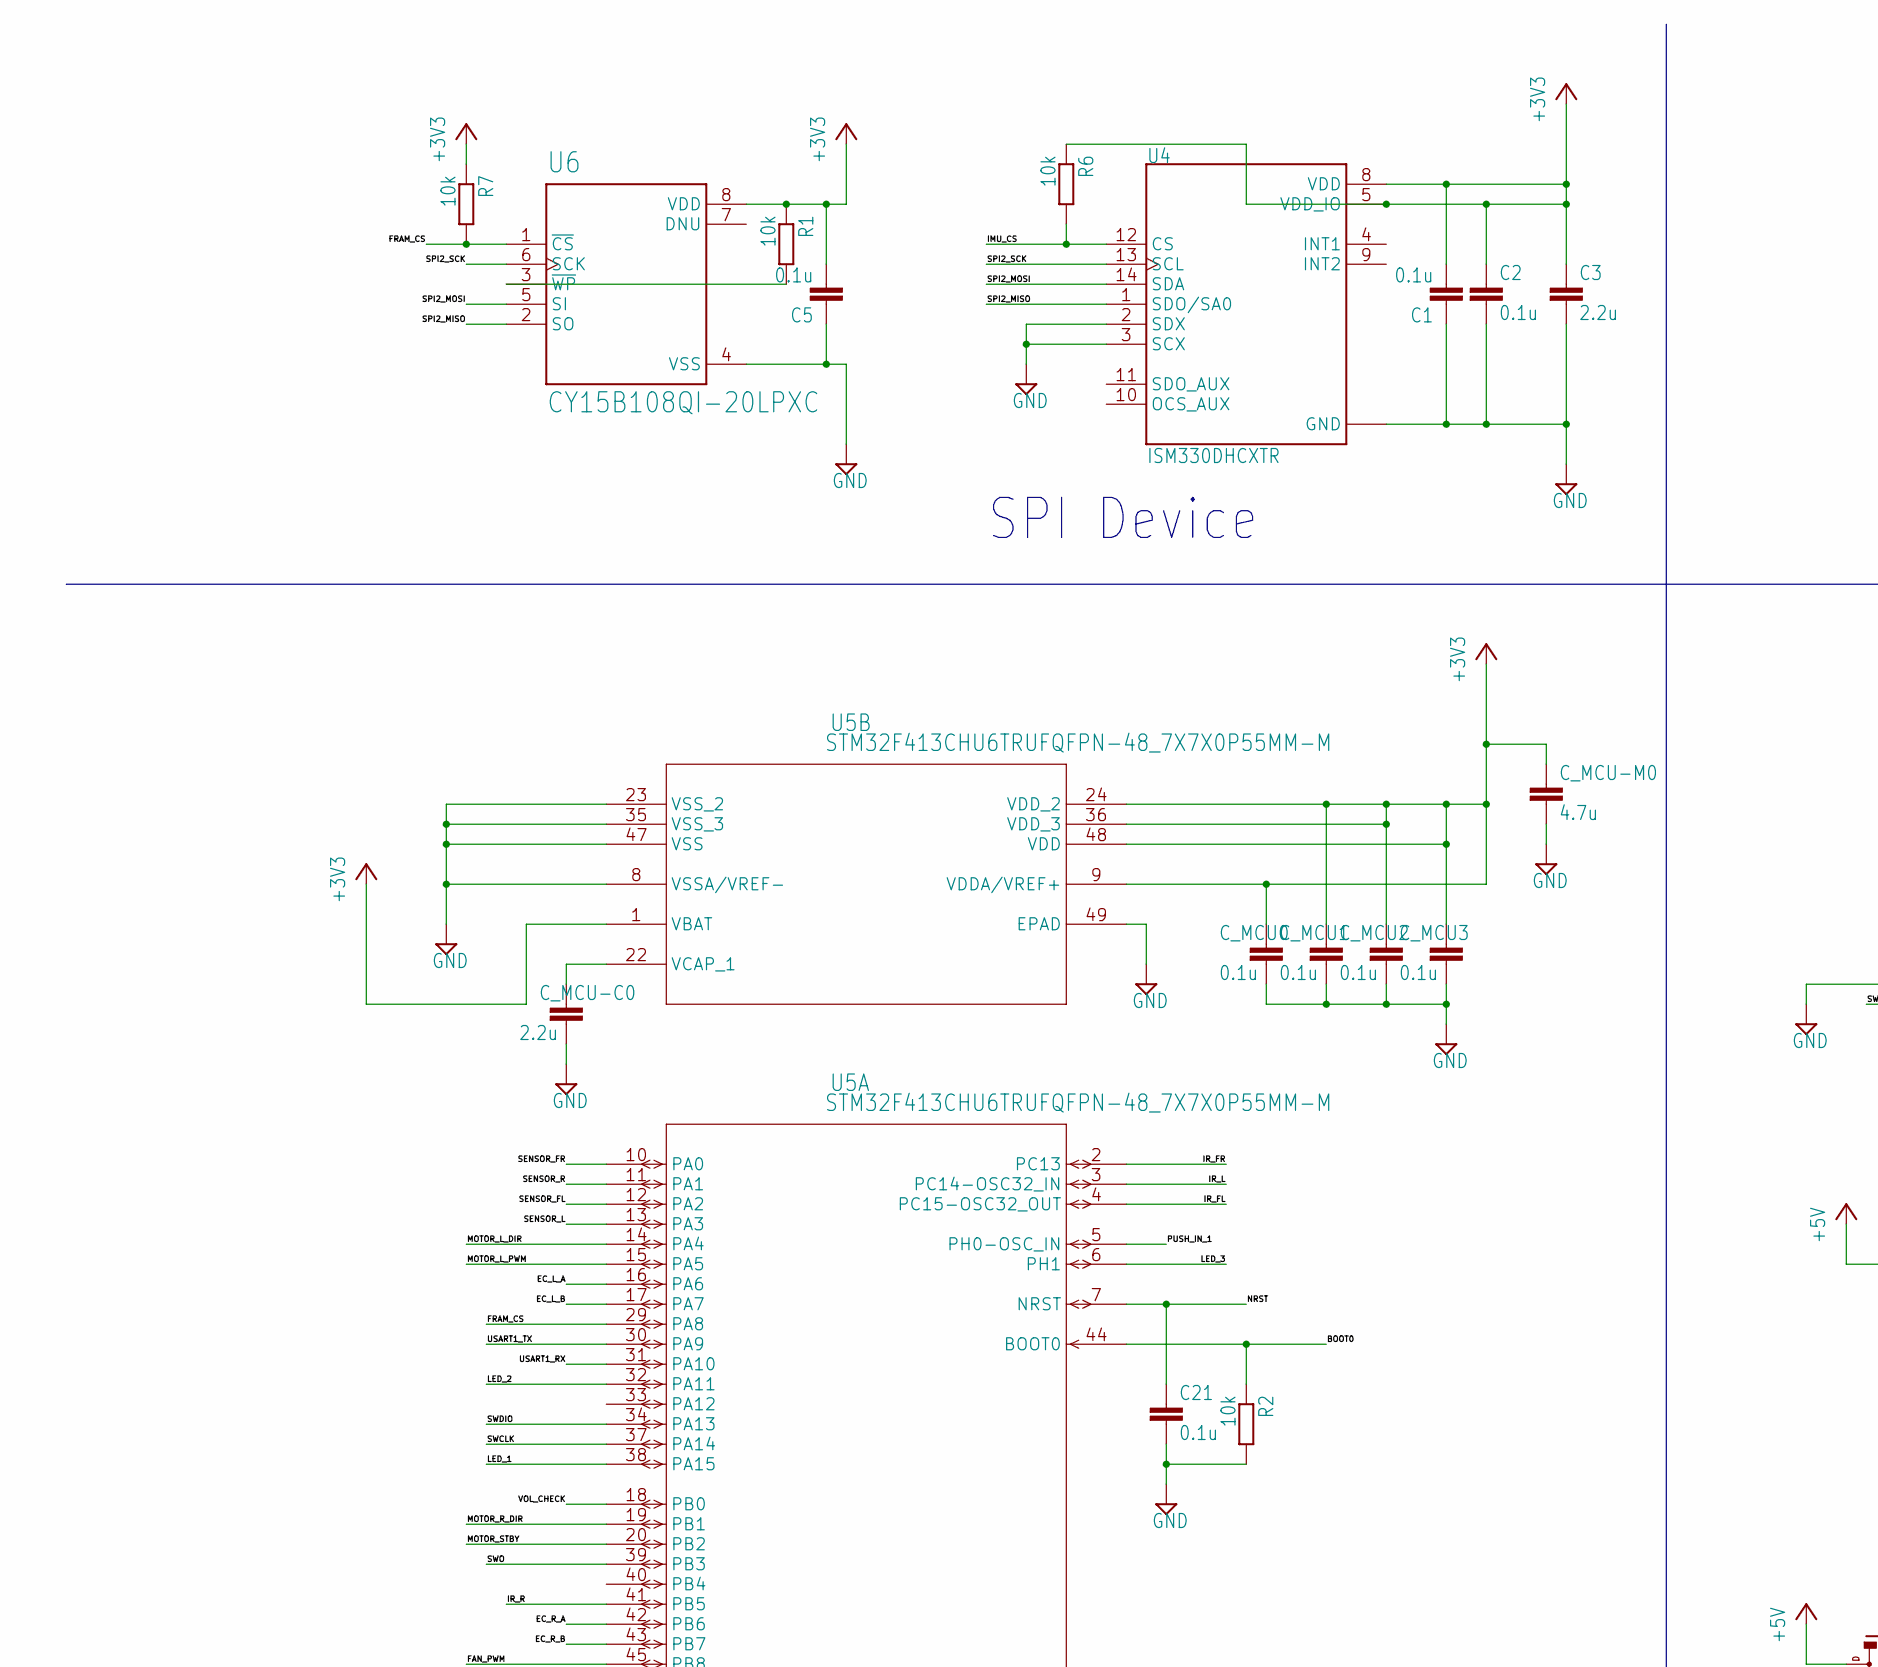
[picture p77: schematic HM_Nightfall-mini-2e_v1.kicad_sch, part in row 1, column 1]

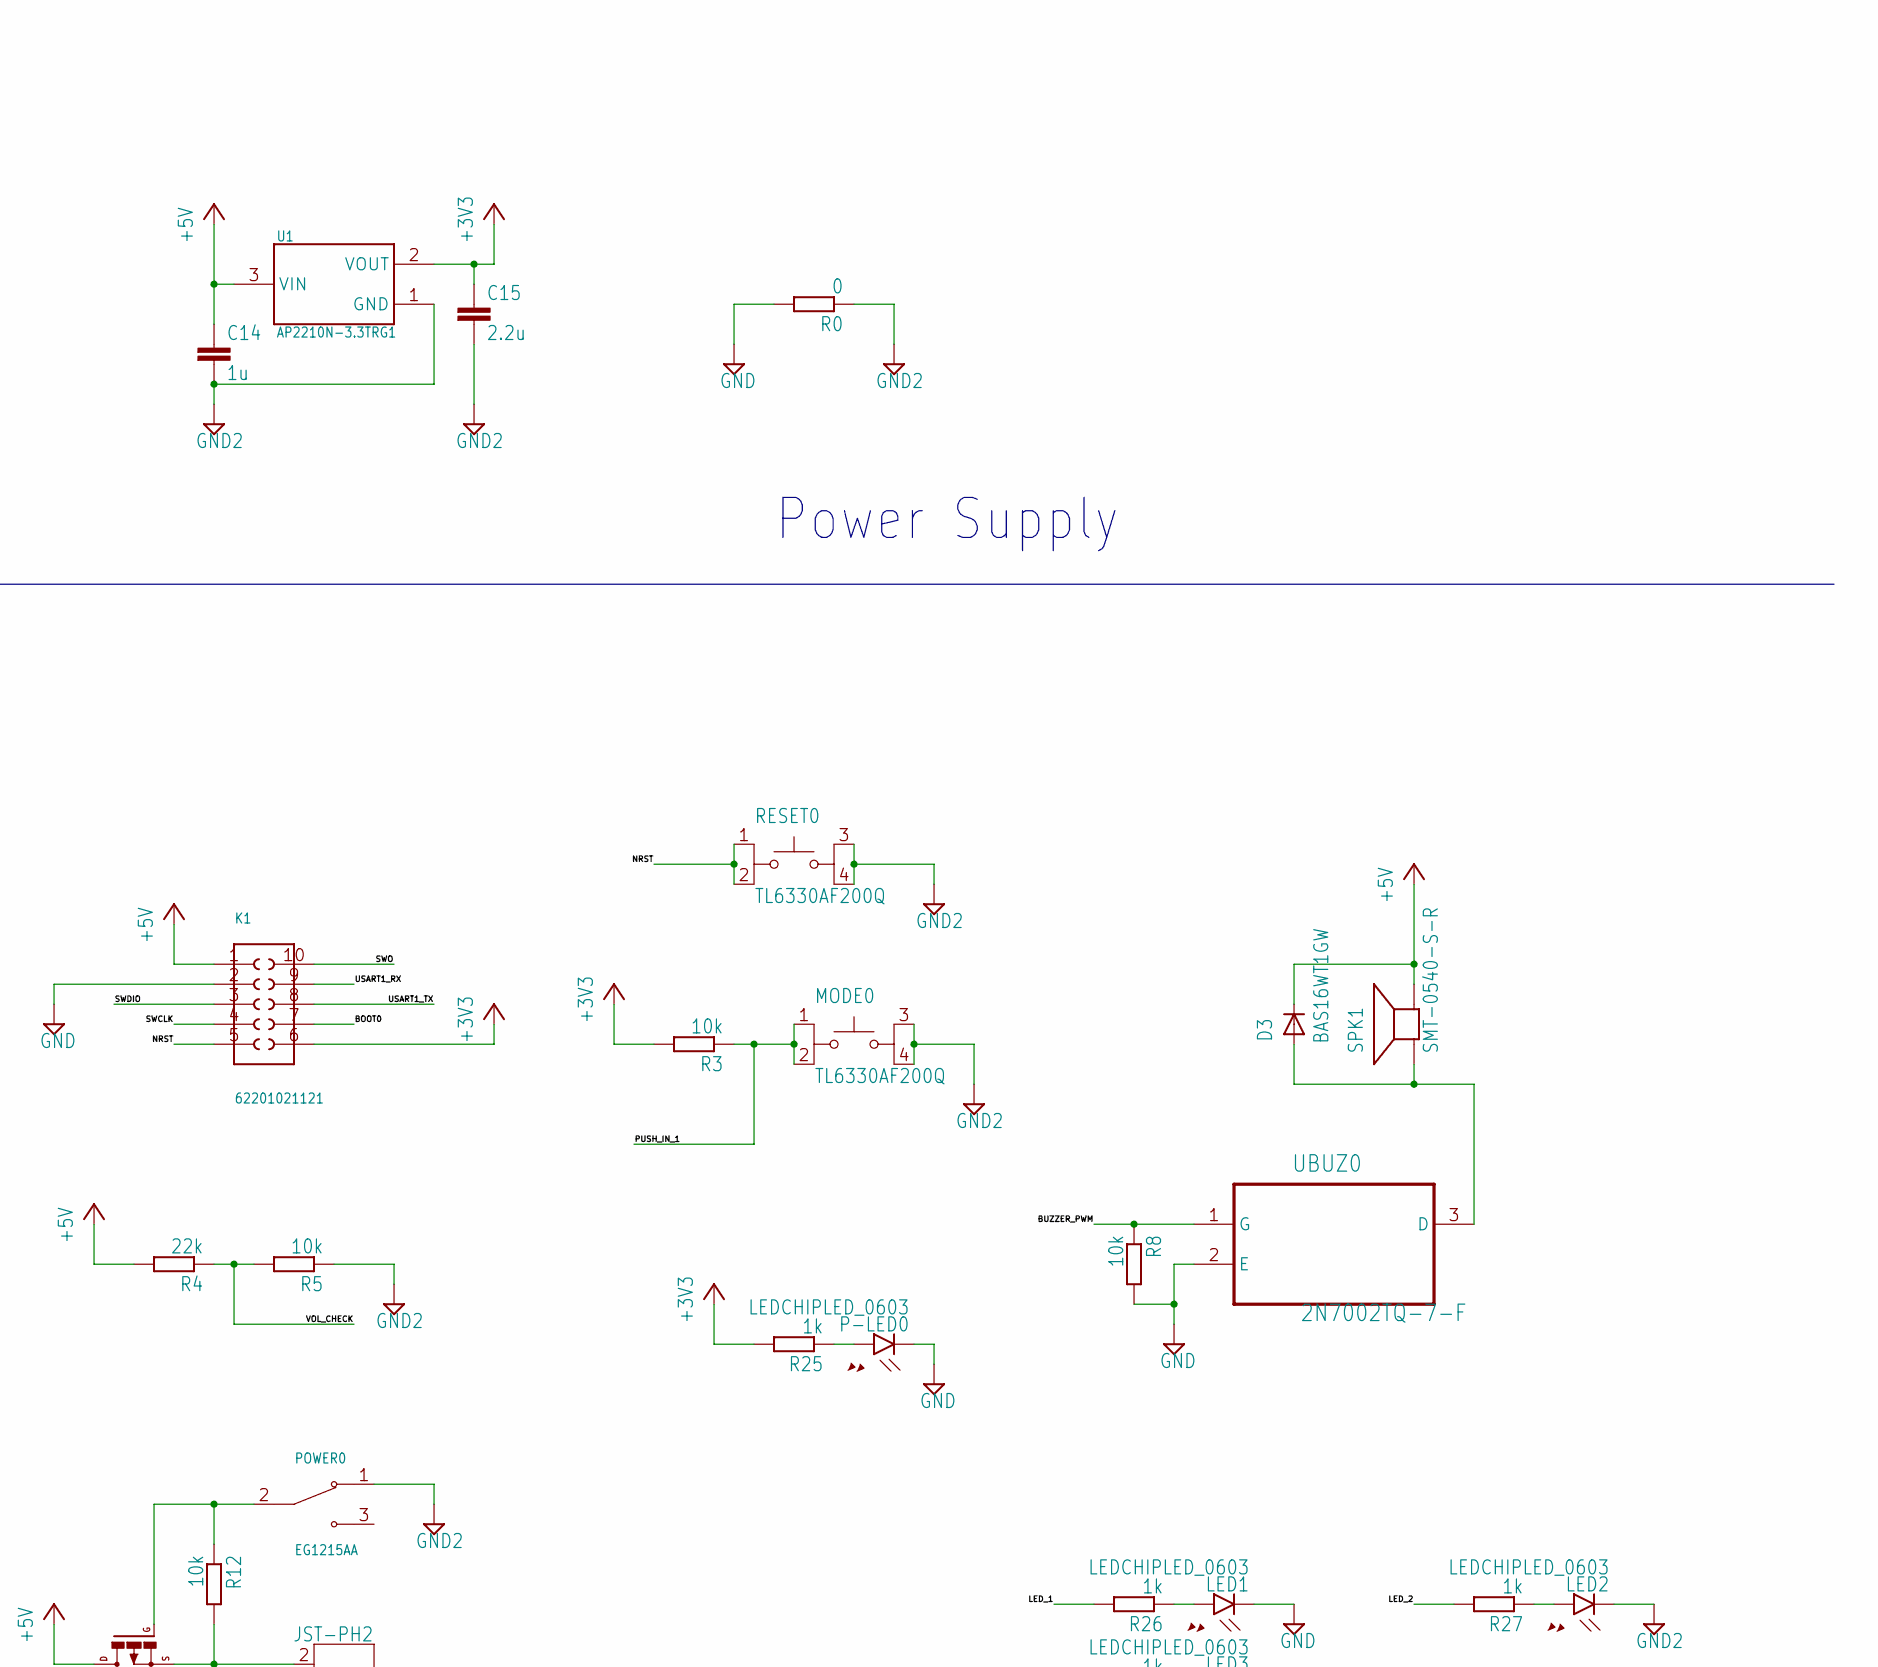
[picture p78: schematic HM_Nightfall-mini-2e_v1.kicad_sch, part in row 1, column 2]

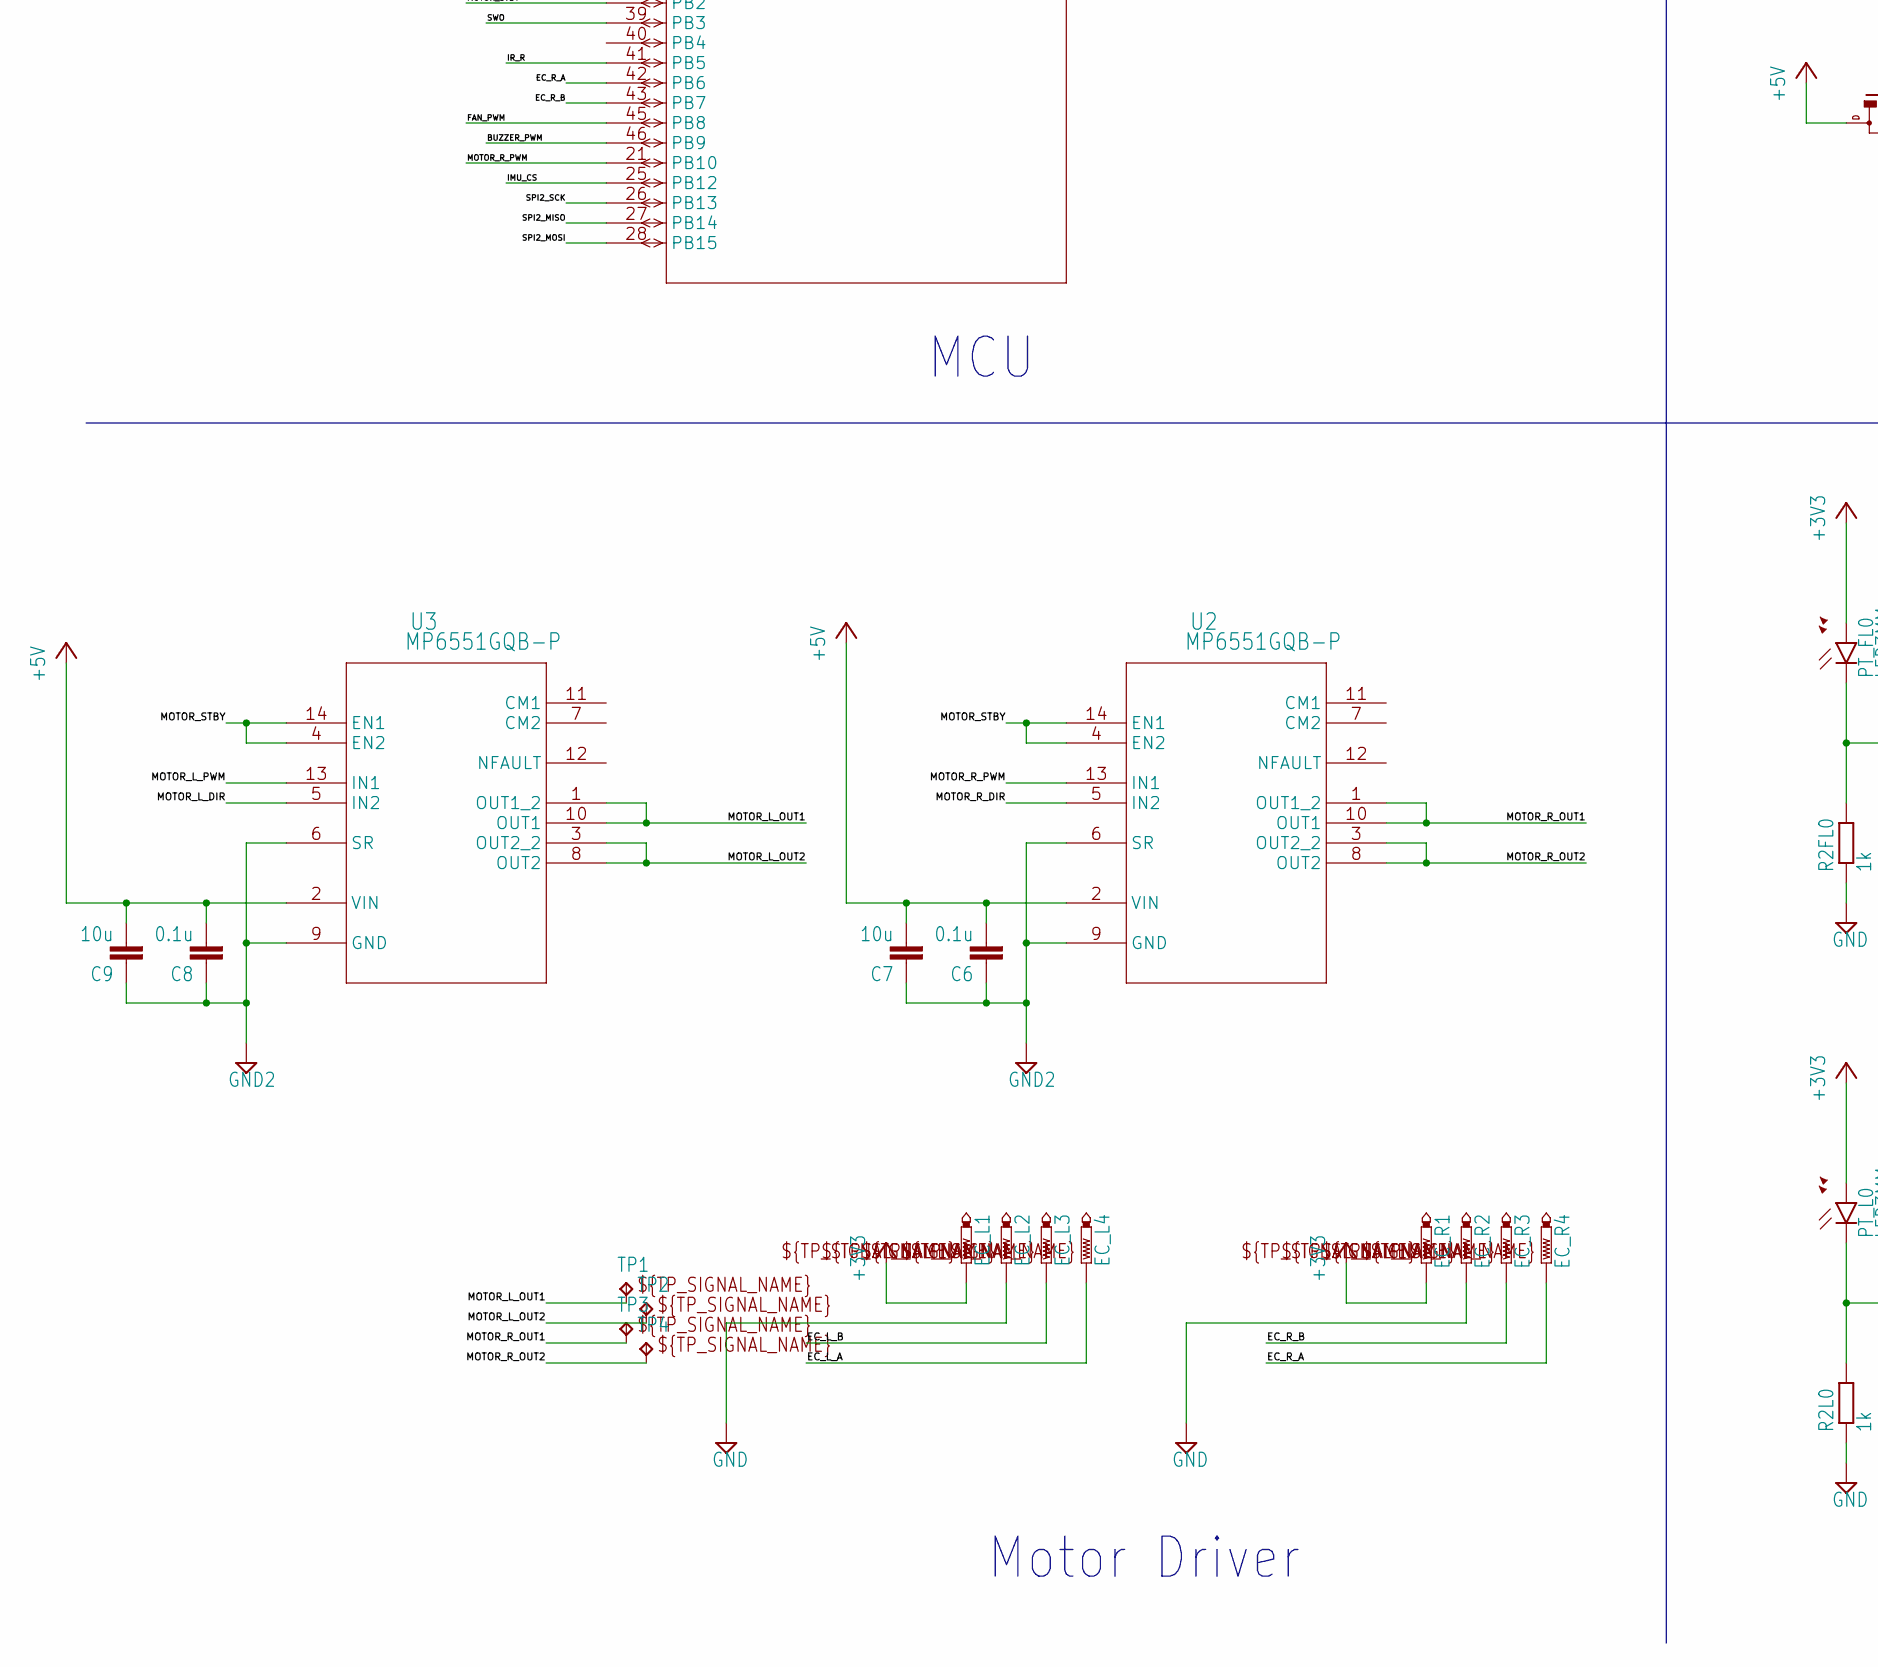
[picture p79: schematic HM_Nightfall-mini-2e_v1.kicad_sch, part in row 2, column 1]

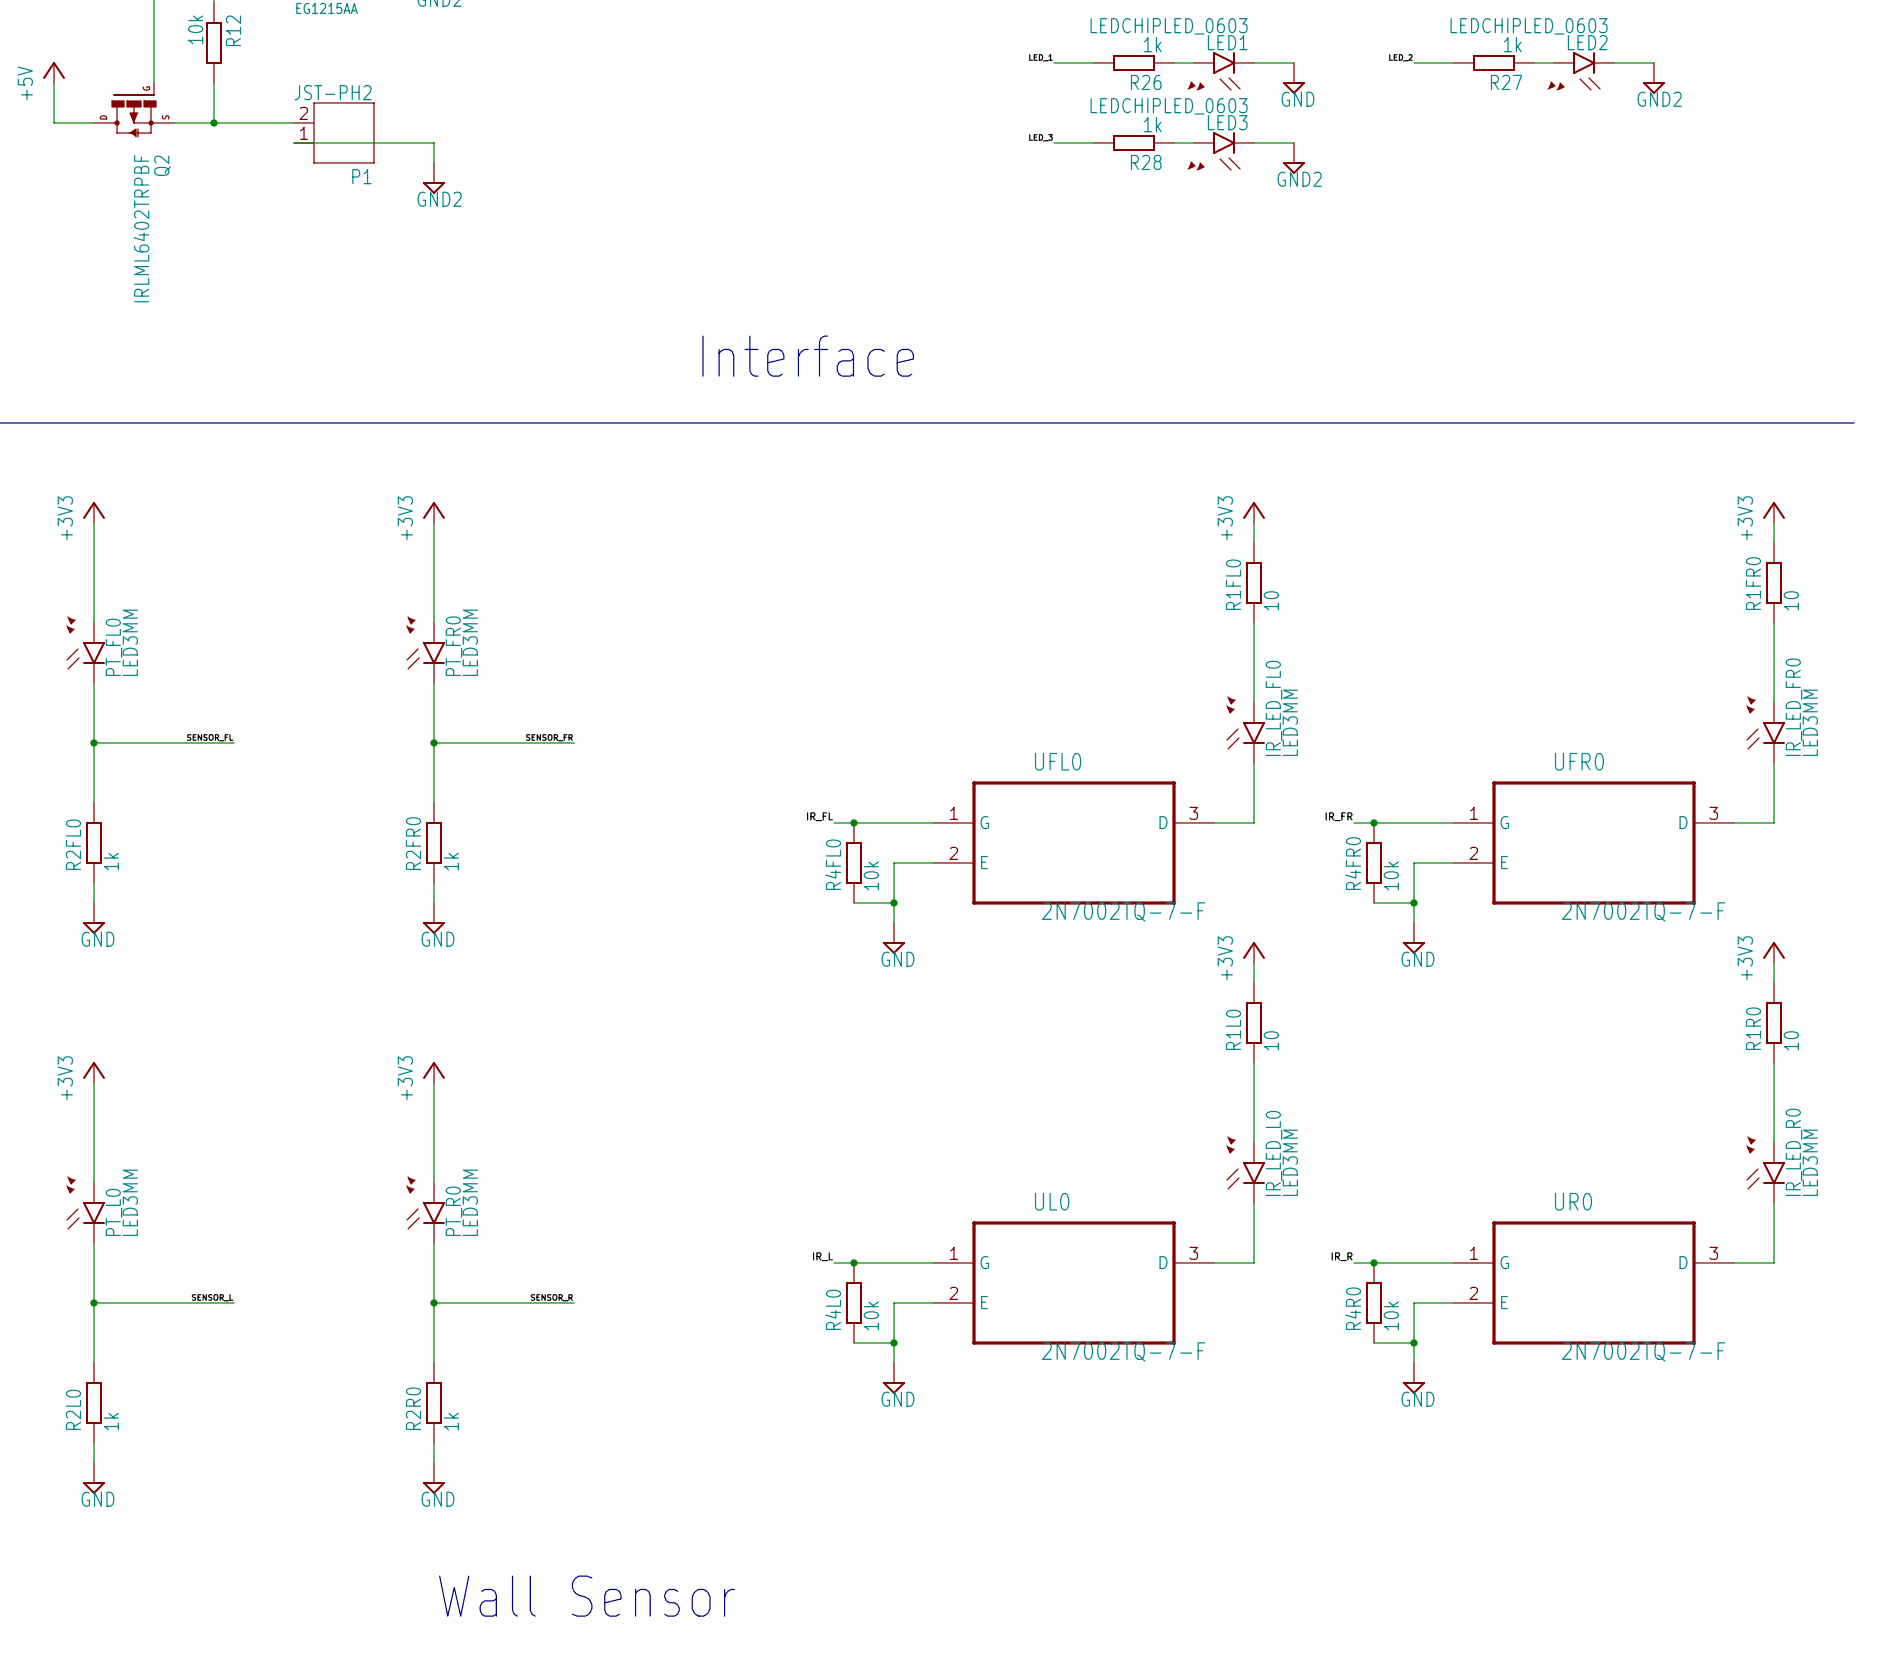
[picture p80: schematic HM_Nightfall-mini-2e_v1.kicad_sch, part in row 2, column 2]

Parts:
C1, C2, C5, C6, C8, C21: 0.1u; C0402
C3, C15: 2.2u; C0402
C7, C9: 10u; C0402
C14: 1u; C0402
C_MCU0, C_MCU1, C_MCU2, C_MCU3: 0.1u; C0402
C_MCU-C0: 2.2u; C0402
C_MCU-M0: 4.7u; C0402
D3: BAS16WT1GW; SOT323
EC_L1, EC_L2, EC_L3, EC_L4: PTR1TP06SQ; TP06SQ
EC_R1, EC_R2, EC_R3, EC_R4: PTR1TP06SQ; TP06SQ
IR_LED_FL0: LED3MM
IR_LED_FR0: LED3MM
IR_LED_L0: LED3MM
IR_LED_R0: LED3MM
K1: 62201021121
LED1, LED2, LED3: LEDCHIPLED_0603; CHIPLED_0603
MODE0: TL6330AF200Q; SW_TL6330AF200Q
P1: JST-PH2
P-LED0: LEDCHIPLED_0603; CHIPLED_0603
POWER0: EG1215AA; SW_EG1215AA
PT_FL0: LED3MM
PT_FR0: LED3MM
PT_L0: LED3MM
PT_R0: LED3MM
Q2: IRLML6402TRPBF; SOT23
R0: 0; R0402
R1, R2, R3, R4FL0, R4FR0, R4L0, R4R0, R5, R6, R7, R8, R12: 10k; R0402
R1FL0, R1FR0, R1L0, R1R0: 10; R0402
R2FL0, R2FR0, R2L0, R2R0, R25, R26, R27, R28: 1k; R0402
R4: 22k; R0402
RESET0: TL6330AF200Q; SW_TL6330AF200Q
SPK1: SMT-0540-S-R
TP1, TP2, TP3, TP4: TPB1,27; B1,27
U1: AP2210N-3.3TRG1; SOT95P280X145-3N
U2, U3: MP6551GQB-P; QFN-14_MP6551_MNP
U4: ISM330DHCXTR; PQFN50P250X300X86-14N
U5: STM32F413CHU6TRUFQFPN-48_7X7X0P55MM-M; UFQFPN-48_7X7X0P55MM-M
U6: CY15B108QI-20LPXC; SON65P328X323X55-8N
UBUZ0: 2N7002TQ-7-F; SOT50P160X90-3N
UFL0: 2N7002TQ-7-F; SOT50P160X90-3N
UFR0: 2N7002TQ-7-F; SOT50P160X90-3N
UL0: 2N7002TQ-7-F; SOT50P160X90-3N
UR0: 2N7002TQ-7-F; SOT50P160X90-3N

Connections:
+3V3: C1.2, C2.1, C3.1, C5.2, C15.1, C_MCU0.1, C_MCU1.1, C_MCU2.1, C_MCU3.1, C_MCU-M0.1, EC_L1.TP, EC_R1.TP, K1.6, PT_FL0.A, PT_FR0.A, PT_L0.A, PT_R0.A, R1.1, R1FL0.2, R1FR0.2, R1L0.2, R1R0.2, R3.2, R6.1, R7.1, R25.2, U1.2 (VOUT), U4.5 (VDD_IO), U4.8 (VDD), U5.1 (VBAT), U5.9 (VDDA/VREF+), U5.24 (VDD_2), U5.36 (VDD_3), U5.48 (VDD), U6.8 (VDD)
+5V: C6.2, C7.2, C8.2, C9.2, C14.1, D3.3 (K), K1.1, Q2.3 (D), R4.2, SPK1.+ (-), U1.3 (VIN), U2.2 (VIN), U3.2 (VIN)
BOOT0: K1.7, R2.1, U5.44 (BOOT0)
BUZZER_PWM: R8.1, U5.46 (PB9), UBUZ0.1 (G)
EC_L_A: EC_L4.TP, U5.16 (PA6)
EC_L_B: EC_L3.TP, U5.17 (PA7)
EC_R_A: EC_R4.TP, U5.42 (PB6)
EC_R_B: EC_R3.TP, U5.43 (PB7)
FAN_PWM: U5.45 (PB8)
FRAM_CS: R7.2, U5.29 (PA8), U6.1 (~CS)
GND: C1.1, C2.2, C3.2, C5.1, C21.2, C_MCU0.2, C_MCU1.2, C_MCU2.2, C_MCU3.2, C_MCU-C0.2, C_MCU-M0.2, EC_L2.TP, EC_R2.TP, K1.2, LED1.C, P-LED0.C, R0.2, R2.2, R2FL0.1, R2FR0.1, R2L0.1, R2R0.1, R4FL0.1, R4FR0.1, R4L0.1, R4R0.1, R8.2, U4.2 (SDX), U4.3 (SCX), U4.6 (GND), U4.7 (GND), U5.8 (VSSA/VREF-), U5.23 (VSS_2), U5.35 (VSS_3), U5.47 (VSS), U5.49 (EPAD), U6.4 (VSS), UBUZ0.2 (E), UFL0.2 (E), UFR0.2 (E), UL0.2 (E), UR0.2 (E)
GND2: C6.1, C7.1, C8.1, C9.1, C14.2, C15.2, LED2.C, LED3.C, MODE0.3, MODE0.4, P1.1, POWER0.1, R0.1, R5.1, RESET0.3, RESET0.4, U1.1 (GND), U2.6 (SR), U2.9 (GND), U3.6 (SR), U3.9 (GND)
IMU_CS: R6.2, U4.12 (CS), U5.25 (PB12)
IR_FL: R4FL0.2, U5.4 (PC15-OSC32_OUT), UFL0.1 (G)
IR_FR: R4FR0.2, U5.2 (PC13), UFR0.1 (G)
IR_L: R4L0.2, U5.3 (PC14-OSC32_IN), UL0.1 (G)
IR_R: R4R0.2, U5.41 (PB5), UR0.1 (G)
LED_1: R26.2, U5.38 (PA15)
LED_2: R27.2, U5.32 (PA11)
LED_3: R28.2, U5.6 (PH1)
MOTOR_L_DIR: U3.5 (IN2), U5.14 (PA4)
MOTOR_L_OUT1: TP1.TP, U3.1 (OUT1_2), U3.10 (OUT1)
MOTOR_L_OUT2: TP2.TP, U3.3 (OUT2_2), U3.8 (OUT2)
MOTOR_L_PWM: U3.13 (IN1), U5.15 (PA5)
MOTOR_R_DIR: U2.5 (IN2), U5.19 (PB1)
MOTOR_R_OUT1: TP3.TP, U2.1 (OUT1_2), U2.10 (OUT1)
MOTOR_R_OUT2: TP4.TP, U2.3 (OUT2_2), U2.8 (OUT2)
MOTOR_R_PWM: U2.13 (IN1), U5.21 (PB10)
MOTOR_STBY: U2.4 (EN2), U2.14 (EN1), U3.4 (EN2), U3.14 (EN1), U5.20 (PB2)
unnamed: IR_LED_FL0.K (C), UFL0.3 (D)
unnamed: R1.2, U6.3 (~WP)
unnamed: C_MCU-C0.1, U5.22 (VCAP_1)
unnamed: P1.2, Q2.2 (S), R12.2
unnamed: IR_LED_FL0.A, R1FL0.1
unnamed: IR_LED_L0.K (C), UL0.3 (D)
unnamed: POWER0.2, Q2.1 (G), R12.1
unnamed: IR_LED_L0.A, R1L0.1
unnamed: IR_LED_FR0.K (C), UFR0.3 (D)
unnamed: P-LED0.A, R25.1
unnamed: D3.1 (A), SPK1.- (+), UBUZ0.3 (D)
unnamed: LED1.A, R26.1
unnamed: IR_LED_FR0.A, R1FR0.1
unnamed: IR_LED_R0.K (C), UR0.3 (D)
unnamed: IR_LED_R0.A, R1R0.1
unnamed: LED2.A, R27.1
unnamed: LED3.A, R28.1
NRST: C21.1, K1.5, RESET0.1, RESET0.2, U5.7 (NRST)
PUSH_IN_1: MODE0.1, MODE0.2, R3.1, U5.5 (PH0-OSC_IN)
SENSOR_FL: PT_FL0.K (C), R2FL0.2, U5.12 (PA2)
SENSOR_FR: PT_FR0.K (C), R2FR0.2, U5.10 (PA0)
SENSOR_L: PT_L0.K (C), R2L0.2, U5.13 (PA3)
SENSOR_R: PT_R0.K (C), R2R0.2, U5.11 (PA1)
SPI2_MISO: U4.1 (SDO/SA0), U5.27 (PB14), U6.2 (SO)
SPI2_MOSI: U4.14 (SDA), U5.28 (PB15), U6.5 (SI)
SPI2_SCK: U4.13 (SCL), U5.26 (PB13), U6.6 (SCK)
SWCLK: K1.4, U5.37 (PA14)
SWDIO: K1.3, U5.34 (PA13)
SWO: K1.10, U5.39 (PB3)
USART1_RX: K1.9, U5.31 (PA10)
USART1_TX: K1.8, U5.30 (PA9)
VOL_CHECK: R4.1, R5.2, U5.18 (PB0)

Notes on the sheet:
Wall Sensor
MCU
Power Supply
SPI Device
Interface
Motor Driver

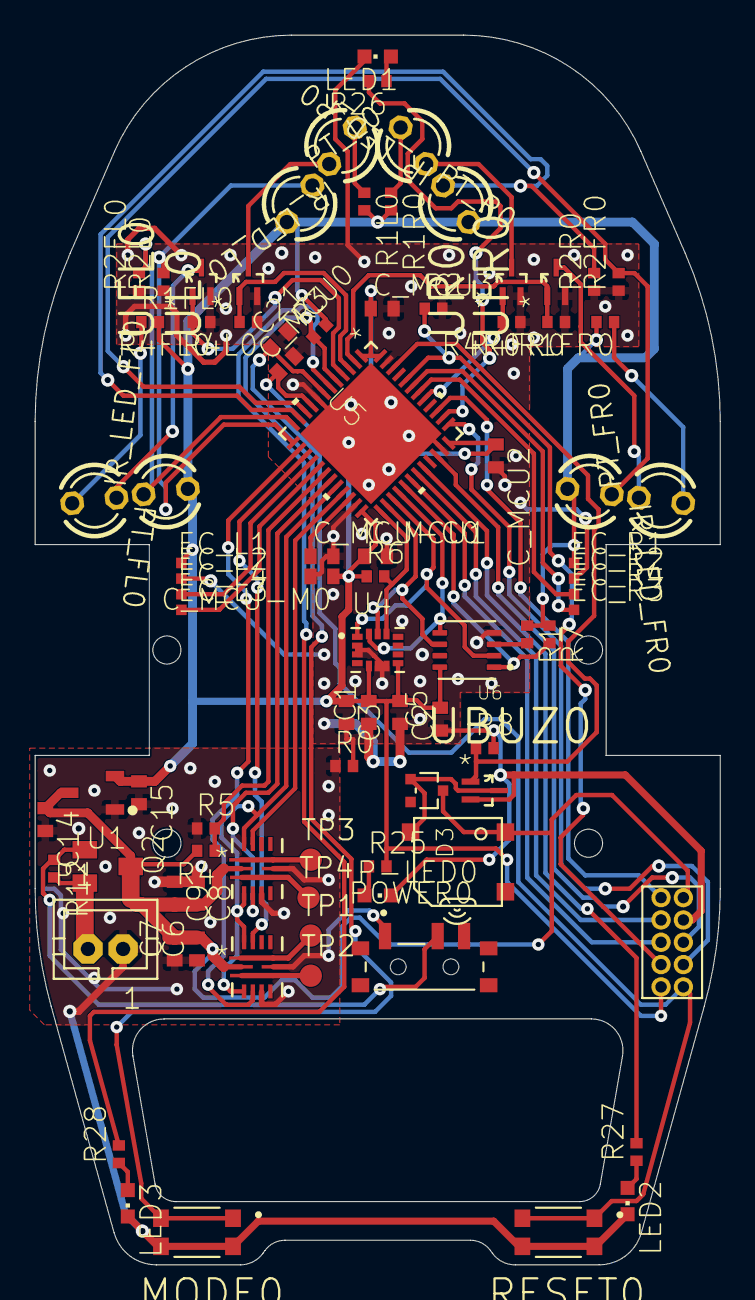
[picture p81: board HM_Nightfall-mini-2e_v1.kicad_pcb from above]

Board: 2 copper layers, 39.0 x 70.0 mm, 86 parts (0 on the bottom side), 60 nets.
