xfa273/nightfall-fw/hardware/mini_r2_0/cad/kicad/WeAct-Adapter-5V/WeAct-Adapter-5V.kicad_pcb

## KiCad design hardware/mini_r2_0/cad/kicad/WeAct-Adapter-5V/WeAct-Adapter-5V.kicad_pcb (2026-09-23)

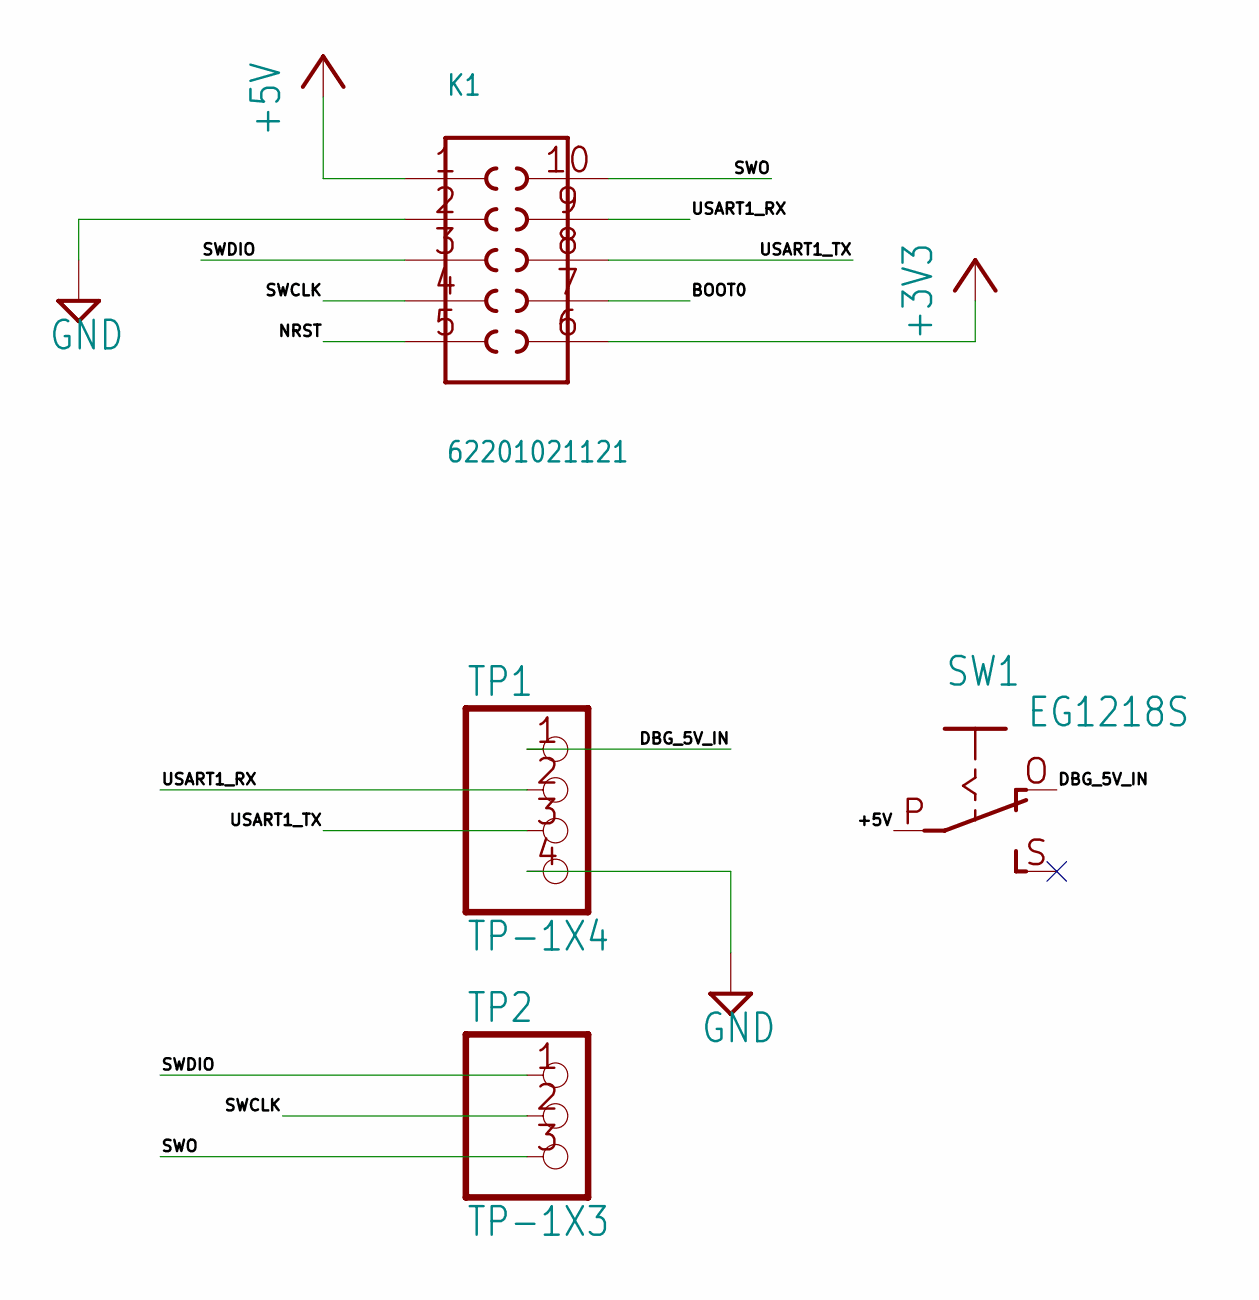
[picture p82: schematic WeAct-Adapter-5V.kicad_sch]

Parts:
K1: 62201021121
SW1: EG1218S; EG1218
TP1: TP-1X4; 1X04
TP2: TP-1X3; 1X03

Connections:
+3V3: K1.6
+5V: K1.1, SW1.P
BOOT0: K1.7
DBG_5V_IN: SW1.O, TP1.1
GND: K1.2, TP1.4
NRST: K1.5
SWCLK: K1.4, TP2.2
SWDIO: K1.3, TP2.1
SWO: K1.10, TP2.3
USART1_RX: K1.9, TP1.2
USART1_TX: K1.8, TP1.3

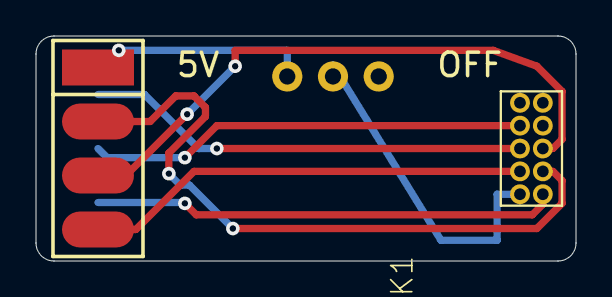
[picture p83: board WeAct-Adapter-5V.kicad_pcb from above]

Board: 2 copper layers, 30.0 x 12.5 mm, 4 parts (1 on the bottom side), 8 nets.
