xfa273/nightfall-fw/hardware/mini_r2_0/cad/kicad/UART-Adapter/UART-Adapter.kicad_pcb

## KiCad design hardware/mini_r2_0/cad/kicad/UART-Adapter/UART-Adapter.kicad_pcb (2026-06-06)

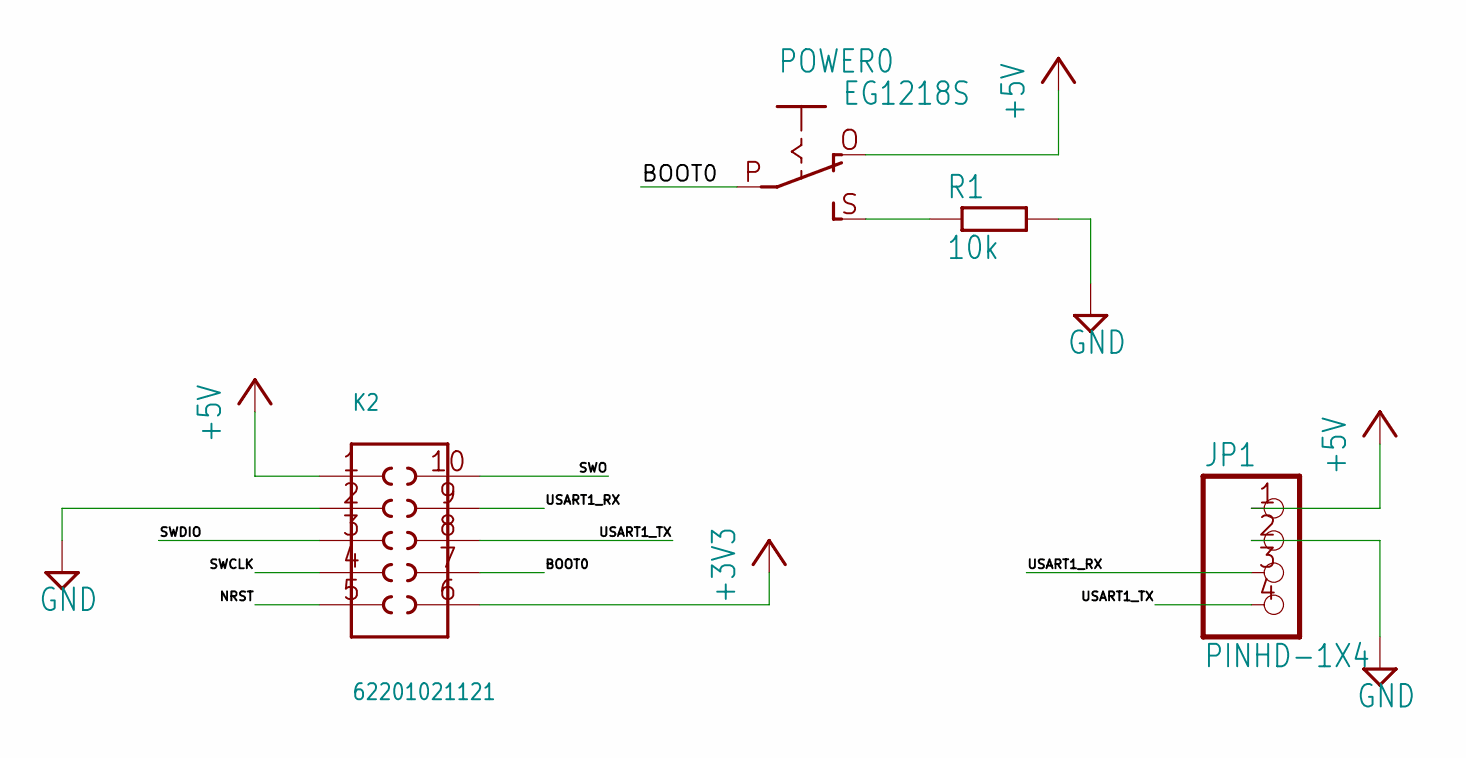
[picture p84: schematic UART-Adapter.kicad_sch]

Parts:
JP1: PINHD-1X4; 1X04
K2: 62201021121
POWER0: EG1218S; EG1218
R1: 10k; R0603

Connections:
+3V3: K2.6
+5V: JP1.1, K2.1, POWER0.O
BOOT0: K2.7, POWER0.P
GND: JP1.2, K2.2, R1.2
unnamed: POWER0.S, R1.1
NRST: K2.5
SWCLK: K2.4
SWDIO: K2.3
SWO: K2.10
USART1_RX: JP1.3, K2.9
USART1_TX: JP1.4, K2.8

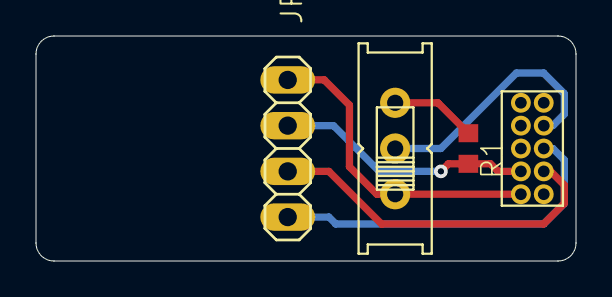
[picture p85: board UART-Adapter.kicad_pcb from above]

Board: 2 copper layers, 30.0 x 12.5 mm, 4 parts (0 on the bottom side), 6 nets.
