xfa273/nightfall-fw/hardware/mini_r1_0/cad/eagle/HM_Nightfall-mini_v1.brd

## EAGLE design hardware/mini_r1_0/cad/eagle/HM_Nightfall-mini_v1.brd (2026-05-06)

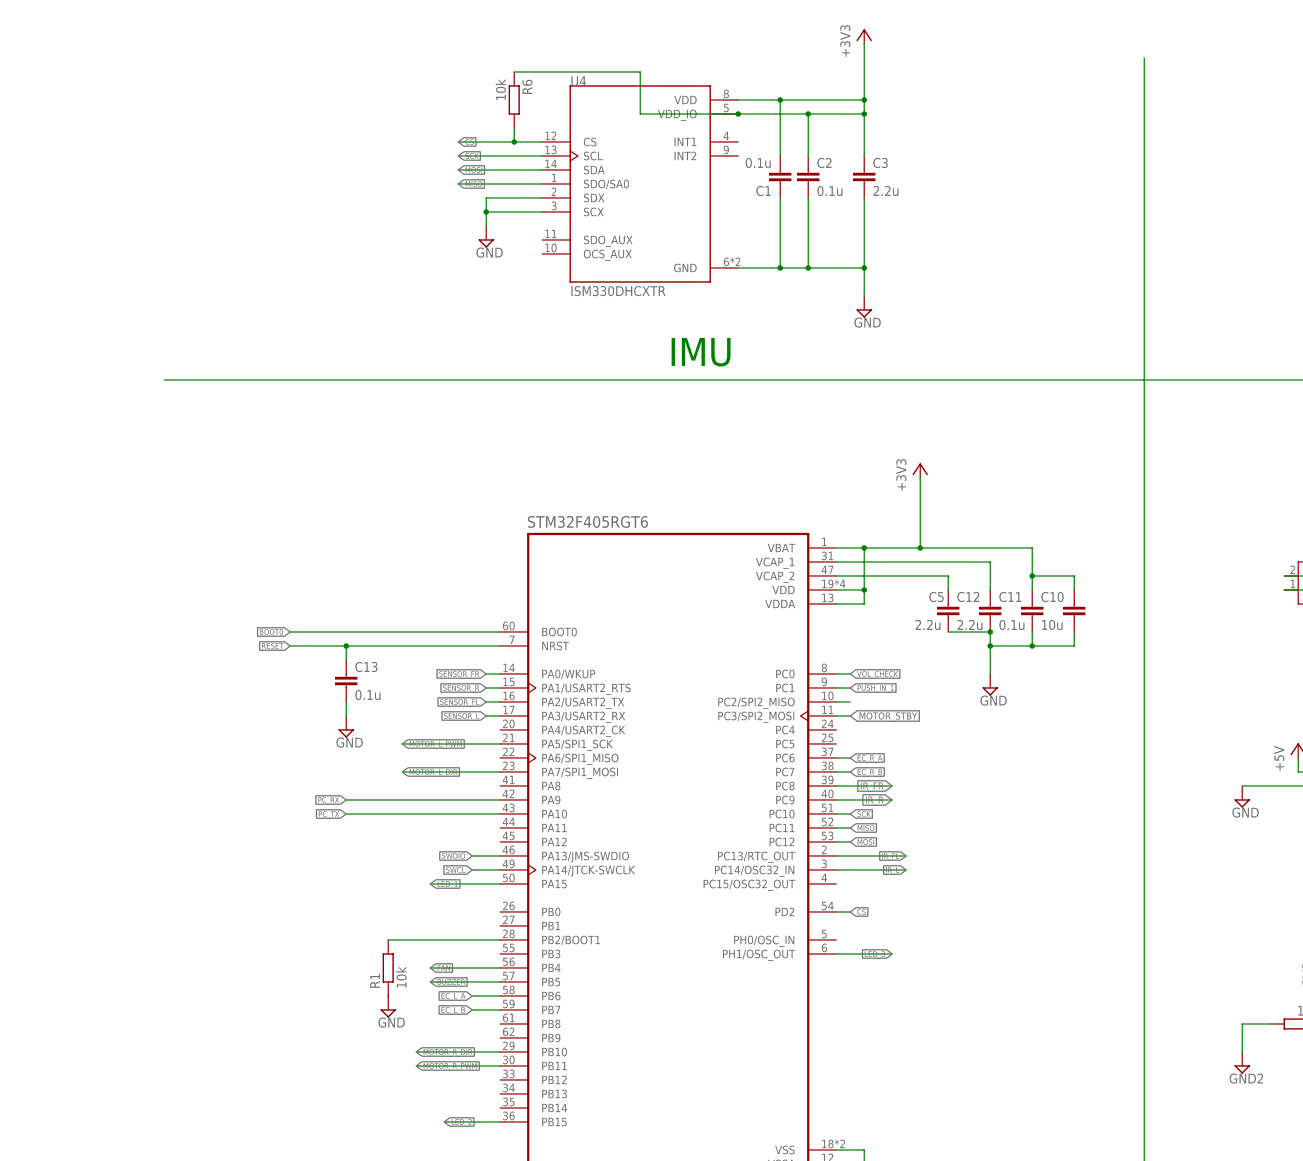
[picture p86: schematic HM_Nightfall-mini_v1.sch, part in row 1, column 1]

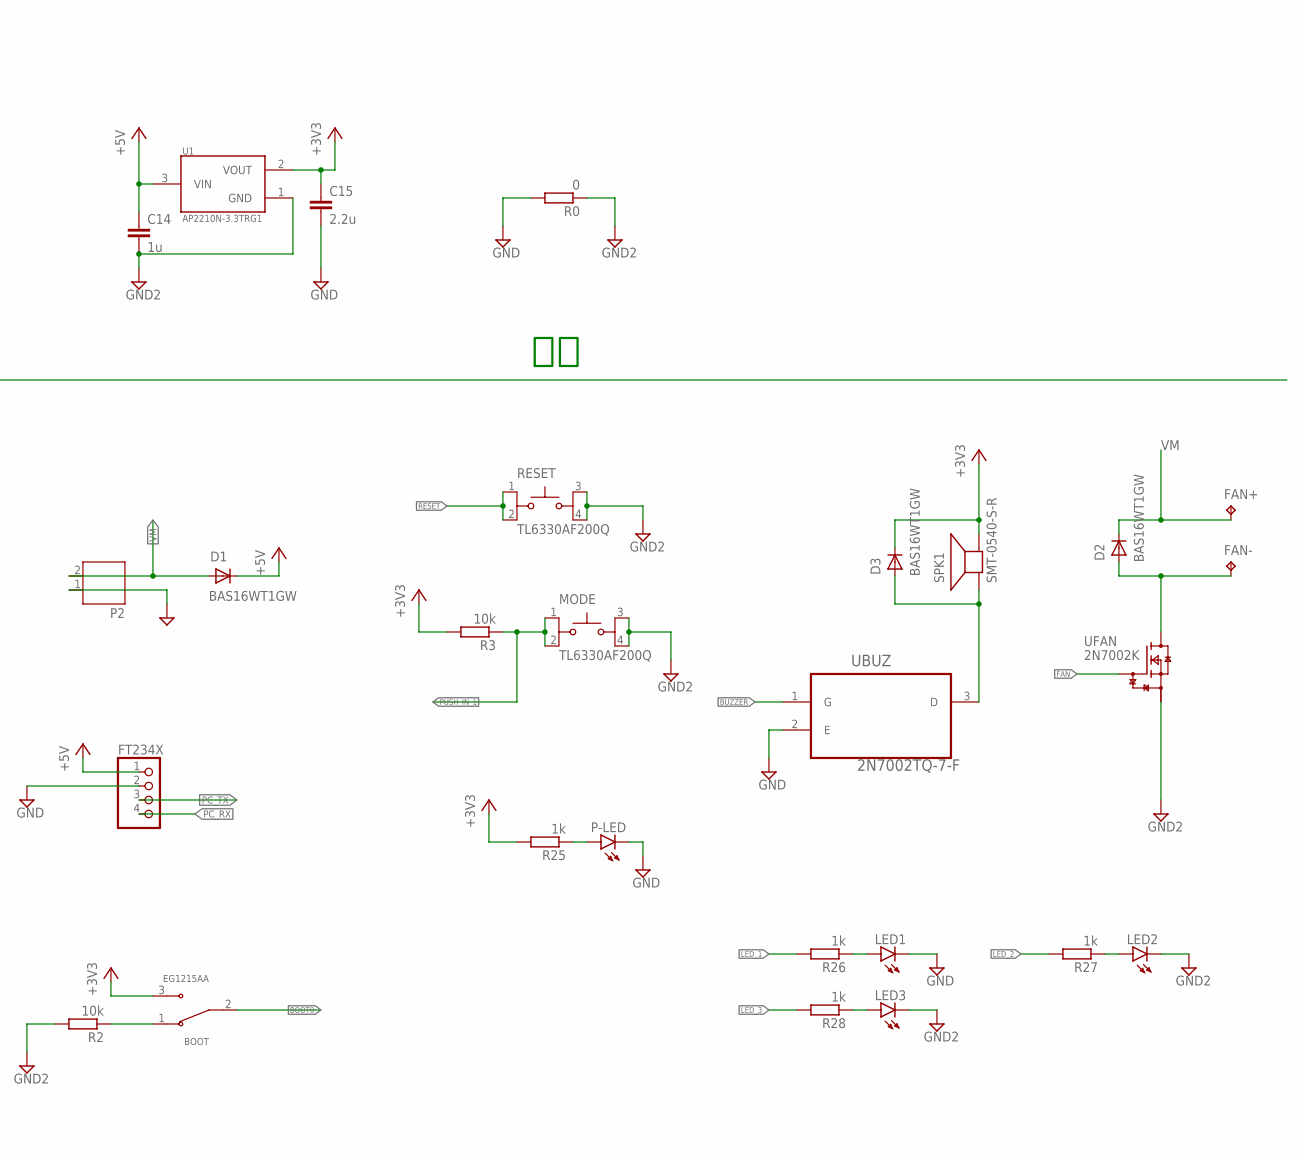
[picture p87: schematic HM_Nightfall-mini_v1.sch, part in row 1, column 2]

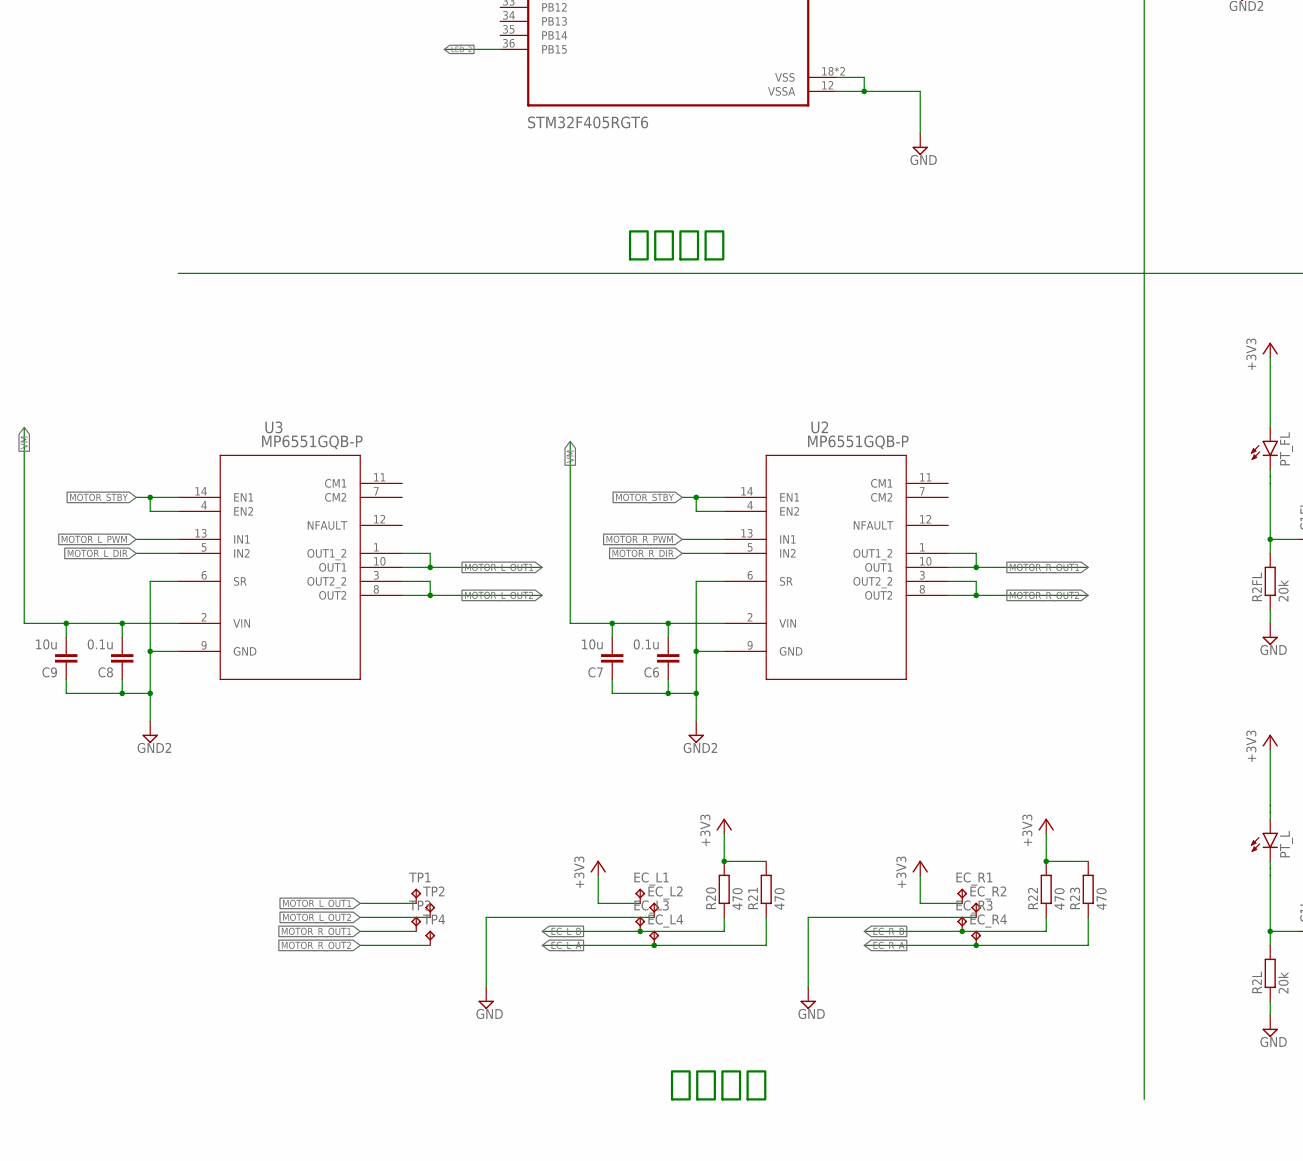
[picture p88: schematic HM_Nightfall-mini_v1.sch, part in row 2, column 1]

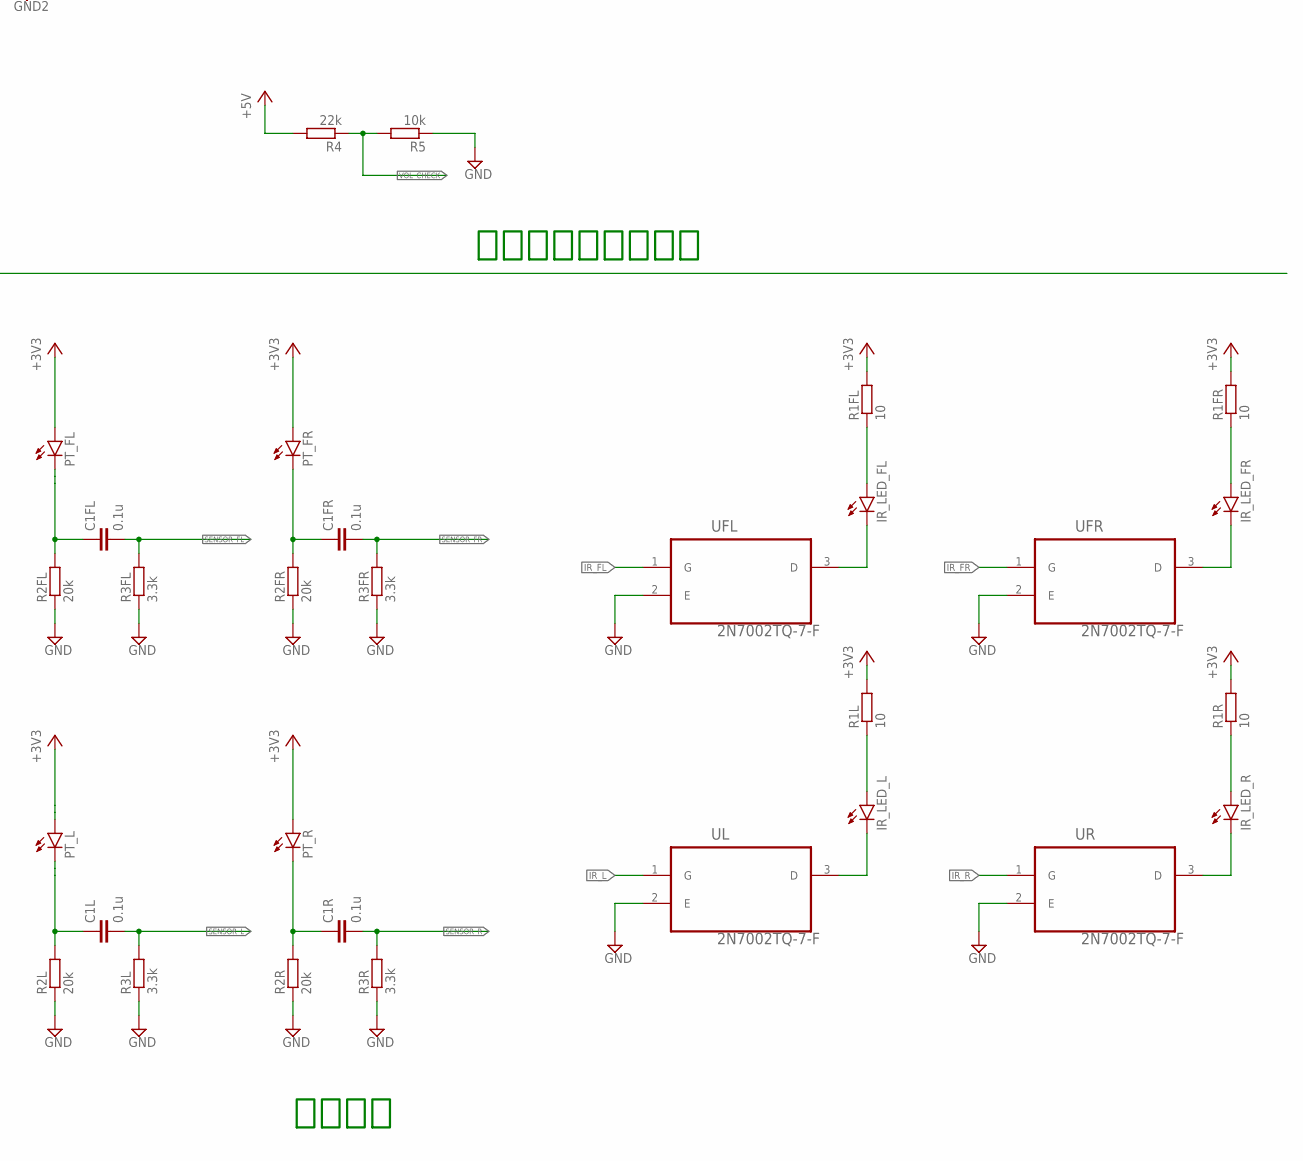
[picture p89: schematic HM_Nightfall-mini_v1.sch, part in row 2, column 2]

Parts:
BOOT: EG1215AA; SW_EG1215AA
C1, C1FL, C1FR, C1L, C1R, C2, C6, C8, C11, C13: 0.1u; C0402
C3, C5, C12, C15: 2.2u; C0402
C7, C9, C10: 10u; C0402
C14: 1u; C0402
D1, D2, D3: BAS16WT1GW; SOT323
EC_L1, EC_L2, EC_L3, EC_L4: TPB1,27; B1,27
EC_R1, EC_R2, EC_R3, EC_R4: TPB1,27; B1,27
FAN+: TPB1,27; B1,27
FAN-: TPB1,27; B1,27
FT234X: PINHD-1X4; 1X04
IR_LED_FL: LED3MM
IR_LED_FR: LED3MM
IR_LED_L: LED3MM
IR_LED_R: LED3MM
LED1, LED2, LED3: LEDCHIPLED_0603; CHIPLED_0603
MODE: TL6330AF200Q; SW_TL6330AF200Q
P2: JST-PH2
P-LED: LEDCHIPLED_0603; CHIPLED_0603
PT_FL: LED3MM
PT_FR: LED3MM
PT_L: LED3MM
PT_R: LED3MM
R0: 0; R0402
R1, R2, R3, R5, R6: 10k; R0402
R1FL, R1FR, R1L, R1R: 10; R0402
R2FL, R2FR, R2L, R2R: 20k; R0402
R3FL, R3FR, R3L, R3R: 3.3k; R0402
R4: 22k; R0402
R20, R21, R22, R23: 470; R0402
R25, R26, R27, R28: 1k; R0402
RESET: TL6330AF200Q; SW_TL6330AF200Q
SPK1: SMT-0540-S-R
STM32F405RGT6: STM32F405RGT6; QFP50P1200X1200X160-64N
TP1, TP2, TP3, TP4: TPB1,27; B1,27
U1: AP2210N-3.3TRG1; SOT95P280X145-3N
U2, U3: MP6551GQB-P; QFN-14_MP6551_MNP
U4: ISM330DHCXTR; PQFN50P250X300X86-14N
UBUZ: 2N7002TQ-7-F; SOT50P160X90-3N
UFAN: 2N7002K; SOT23
UFL: 2N7002TQ-7-F; SOT50P160X90-3N
UFR: 2N7002TQ-7-F; SOT50P160X90-3N
UL: 2N7002TQ-7-F; SOT50P160X90-3N
UR: 2N7002TQ-7-F; SOT50P160X90-3N

Connections:
+3V3: BOOT.3, C1.2, C2.1, C3.1, C10.1, C11.1, C15.1, D3.3 (K), EC_L1.TP, EC_R1.TP, PT_FL.A, PT_FR.A, PT_L.A, PT_R.A, R1FL.2, R1FR.2, R1L.2, R1R.2, R3.2, R6.1, R20.2, R21.2, R22.2, R23.2, R25.2, SPK1.+ (-), STM32F405RGT6.1 (VBAT), STM32F405RGT6.13 (VDDA), STM32F405RGT6.19 (VDD), STM32F405RGT6.32 (VDD), STM32F405RGT6.48 (VDD), STM32F405RGT6.64 (VDD), U1.2 (VOUT), U4.5 (VDD_IO), U4.8 (VDD)
+5V: C14.1, D1.3 (K), FT234X.1, R4.2, U1.3 (VIN)
BOOT0: BOOT.2, STM32F405RGT6.60 (BOOT0)
BUZZER: STM32F405RGT6.57 (PB5), UBUZ.1 (G)
CS: R6.2, STM32F405RGT6.54 (PD2), U4.12 (CS)
EC_L_A: EC_L4.TP, R21.1, STM32F405RGT6.58 (PB6)
EC_L_B: EC_L3.TP, R20.1, STM32F405RGT6.59 (PB7)
EC_R_A: EC_R4.TP, R23.1, STM32F405RGT6.37 (PC6)
EC_R_B: EC_R3.TP, R22.1, STM32F405RGT6.38 (PC7)
FAN: STM32F405RGT6.56 (PB4), UFAN.1 (G)
GND: C1.1, C2.2, C3.2, C5.2, C10.2, C11.2, C12.2, C13.2, C15.2, EC_L2.TP, EC_R2.TP, FT234X.2, LED1.C, P-LED.C, R0.2, R1.1, R2FL.1, R2FR.1, R2L.1, R2R.1, R3FL.1, R3FR.1, R3L.1, R3R.1, R5.1, STM32F405RGT6.12 (VSSA), STM32F405RGT6.18 (VSS), STM32F405RGT6.63 (VSS), U4.2 (SDX), U4.3 (SCX), U4.6 (GND), U4.7 (GND), UBUZ.2 (E), UFL.2 (E), UFR.2 (E), UL.2 (E), UR.2 (E)
GND2: C6.1, C7.1, C8.1, C9.1, C14.2, LED2.C, LED3.C, MODE.3, MODE.4, P2.1, R0.1, R2.2, RESET.3, RESET.4, U1.1 (GND), U2.6 (SR), U2.9 (GND), U3.6 (SR), U3.9 (GND), UFAN.2 (S)
IR_FL: STM32F405RGT6.2 (PC13/RTC_OUT), UFL.1 (G)
IR_FR: STM32F405RGT6.39 (PC8), UFR.1 (G)
IR_L: STM32F405RGT6.3 (PC14/OSC32_IN), UL.1 (G)
IR_R: STM32F405RGT6.40 (PC9), UR.1 (G)
LED_1: R26.2, STM32F405RGT6.50 (PA15)
LED_2: R27.2, STM32F405RGT6.36 (PB15)
LED_3: R28.2, STM32F405RGT6.6 (PH1/OSC_OUT)
MISO: STM32F405RGT6.52 (PC11), U4.1 (SDO/SA0)
MOSI: STM32F405RGT6.53 (PC12), U4.14 (SDA)
MOTOR_L_DIR: STM32F405RGT6.23 (PA7/SPI1_MOSI), U3.5 (IN2)
MOTOR_L_OUT1: TP1.TP, U3.1 (OUT1_2), U3.10 (OUT1)
MOTOR_L_OUT2: TP2.TP, U3.3 (OUT2_2), U3.8 (OUT2)
MOTOR_L_PWM: STM32F405RGT6.21 (PA5/SPI1_SCK), U3.13 (IN1)
MOTOR_R_DIR: STM32F405RGT6.29 (PB10), U2.5 (IN2)
MOTOR_R_OUT1: TP3.TP, U2.1 (OUT1_2), U2.10 (OUT1)
MOTOR_R_OUT2: TP4.TP, U2.3 (OUT2_2), U2.8 (OUT2)
MOTOR_R_PWM: STM32F405RGT6.30 (PB11), U2.13 (IN1)
MOTOR_STBY: STM32F405RGT6.11 (PC3/SPI2_MOSI), U2.4 (EN2), U2.14 (EN1), U3.4 (EN2), U3.14 (EN1)
unnamed: D2.1 (A), FAN-.TP, UFAN.3 (D)
unnamed: IR_LED_FL.K (C), UFL.3 (D)
unnamed: C1FL.1, PT_FL.K (C), R2FL.2
unnamed: C1FR.1, PT_FR.K (C), R2FR.2
unnamed: IR_LED_FL.A, R1FL.1
unnamed: C1L.1, PT_L.K (C), R2L.2
unnamed: IR_LED_L.K (C), UL.3 (D)
unnamed: C1R.1, PT_R.K (C), R2R.2
unnamed: C5.1, STM32F405RGT6.47 (VCAP_2)
unnamed: C12.1, STM32F405RGT6.31 (VCAP_1)
unnamed: R1.2, STM32F405RGT6.28 (PB2/BOOT1)
unnamed: IR_LED_L.A, R1L.1
unnamed: IR_LED_FR.K (C), UFR.3 (D)
unnamed: BOOT.1, R2.1
unnamed: P-LED.A, R25.1
unnamed: D3.1 (A), SPK1.- (+), UBUZ.3 (D)
unnamed: LED1.A, R26.1
unnamed: IR_LED_FR.A, R1FR.1
unnamed: IR_LED_R.K (C), UR.3 (D)
unnamed: IR_LED_R.A, R1R.1
unnamed: LED2.A, R27.1
unnamed: LED3.A, R28.1
PC_RX: FT234X.4, STM32F405RGT6.42 (PA9)
PC_TX: FT234X.3, STM32F405RGT6.43 (PA10)
PUSH_IN_1: MODE.1, MODE.2, R3.1, STM32F405RGT6.9 (PC1)
PUSH_IN_2: STM32F405RGT6.10 (PC2/SPI2_MISO)
RESET: C13.1, RESET.1, RESET.2, STM32F405RGT6.7 (NRST)
SCK: STM32F405RGT6.51 (PC10), U4.13 (SCL)
SENSOR_FL: C1FL.2, R3FL.2, STM32F405RGT6.16 (PA2/USART2_TX)
SENSOR_FR: C1FR.2, R3FR.2, STM32F405RGT6.14 (PA0/WKUP)
SENSOR_L: C1L.2, R3L.2, STM32F405RGT6.17 (PA3/USART2_RX)
SENSOR_R: C1R.2, R3R.2, STM32F405RGT6.15 (PA1/USART2_RTS)
SWCL: STM32F405RGT6.49 (PA14/JTCK-SWCLK)
SWDIO: STM32F405RGT6.46 (PA13/JMS-SWDIO)
VM: C6.2, C7.2, C8.2, C9.2, D1.1 (A), D2.3 (K), FAN+.TP, P2.2, U2.2 (VIN), U3.2 (VIN)
VOL_CHECK: R4.1, R5.2, STM32F405RGT6.8 (PC0)

Notes on the sheet:
マイコン
インターフェース他
モータ系
センサ系
IMU

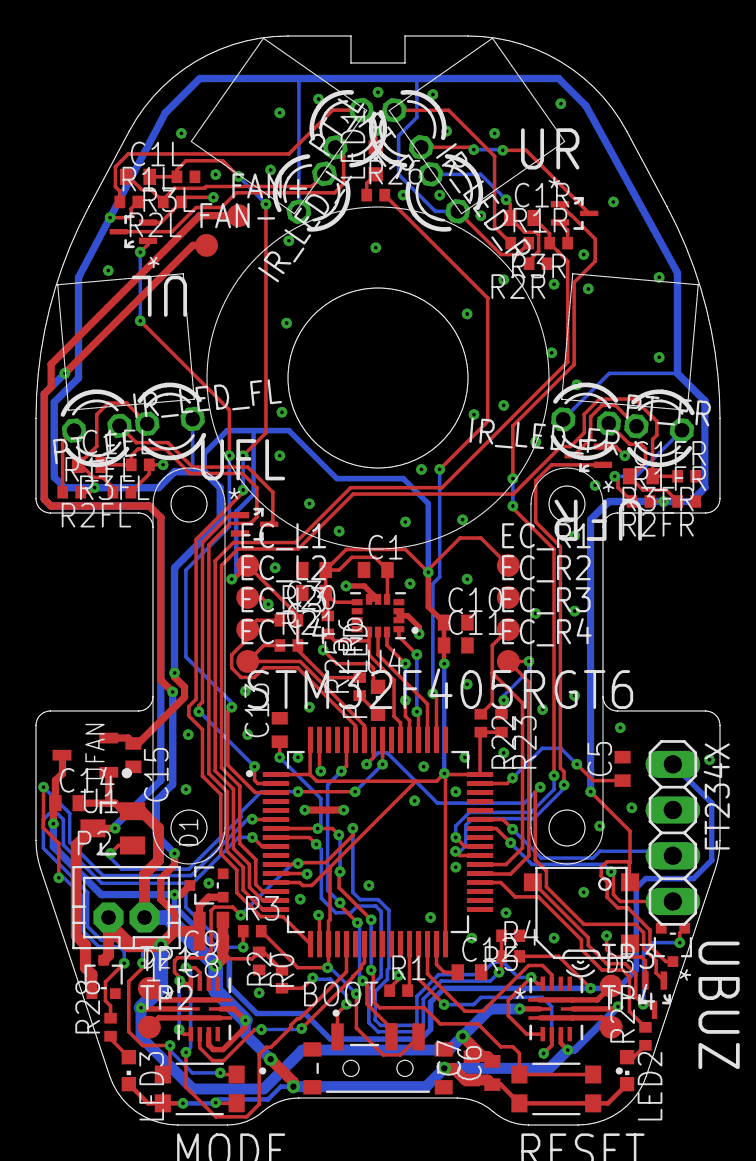
[picture p90: board HM_Nightfall-mini_v1.brd from above]

Board: 2 copper layers, 38.0 x 60.5 mm, 91 parts (0 on the bottom side), 63 nets.
