xfa273/nightfall-fw/hardware/mini_r2_0/cad/eagle/STLink-Adapter.brd

## EAGLE design hardware/mini_r2_0/cad/eagle/STLink-Adapter.brd (2026-05-31)

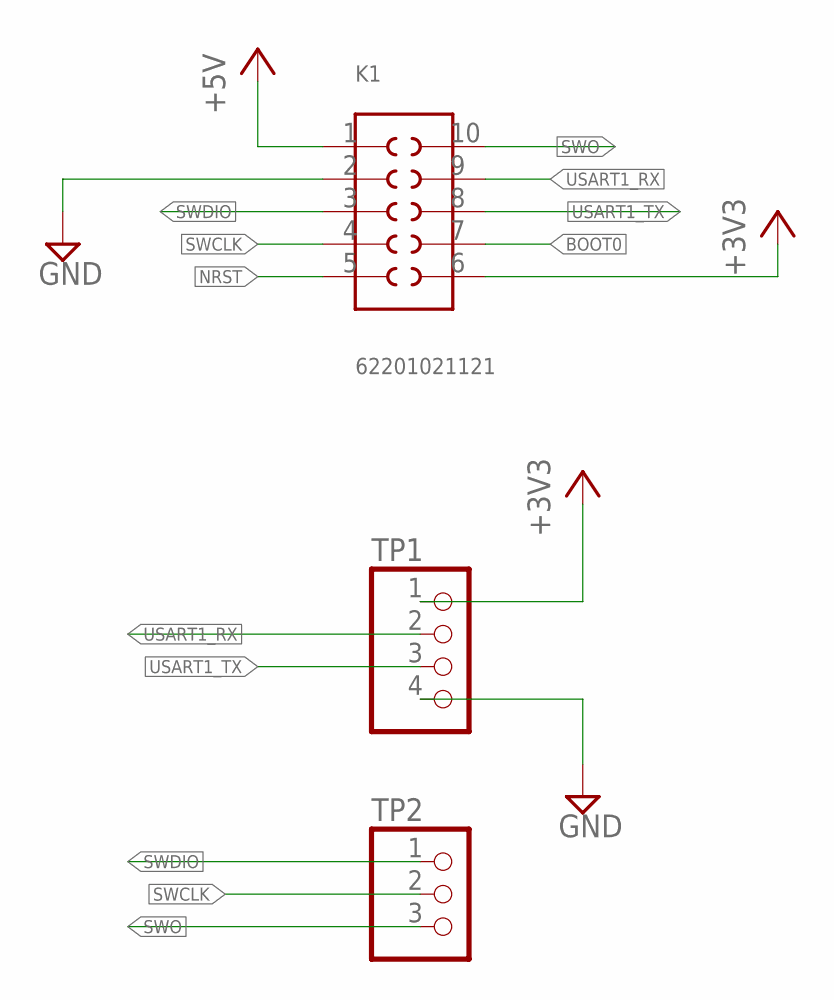
[picture p91: schematic STLink-Adapter.sch]

Parts:
K1: 62201021121
TP1: TP-1X4; 1X04
TP2: TP-1X3; 1X03

Connections:
+3V3: K1.6, TP1.1
+5V: K1.1
BOOT0: K1.7
GND: K1.2, TP1.4
NRST: K1.5
SWCLK: K1.4, TP2.2
SWDIO: K1.3, TP2.1
SWO: K1.10, TP2.3
USART1_RX: K1.9, TP1.2
USART1_TX: K1.8, TP1.3

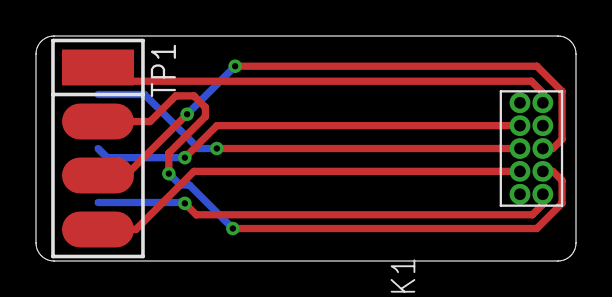
[picture p92: board STLink-Adapter.brd from above]

Board: 2 copper layers, 30.0 x 12.5 mm, 3 parts (1 on the bottom side), 7 nets.
