xfa273/nightfall-fw/hardware/mini_r2_0/cad/eagle/HM_Nightfall-mini-2e_v1.brd

## EAGLE design hardware/mini_r2_0/cad/eagle/HM_Nightfall-mini-2e_v1.brd (continued)

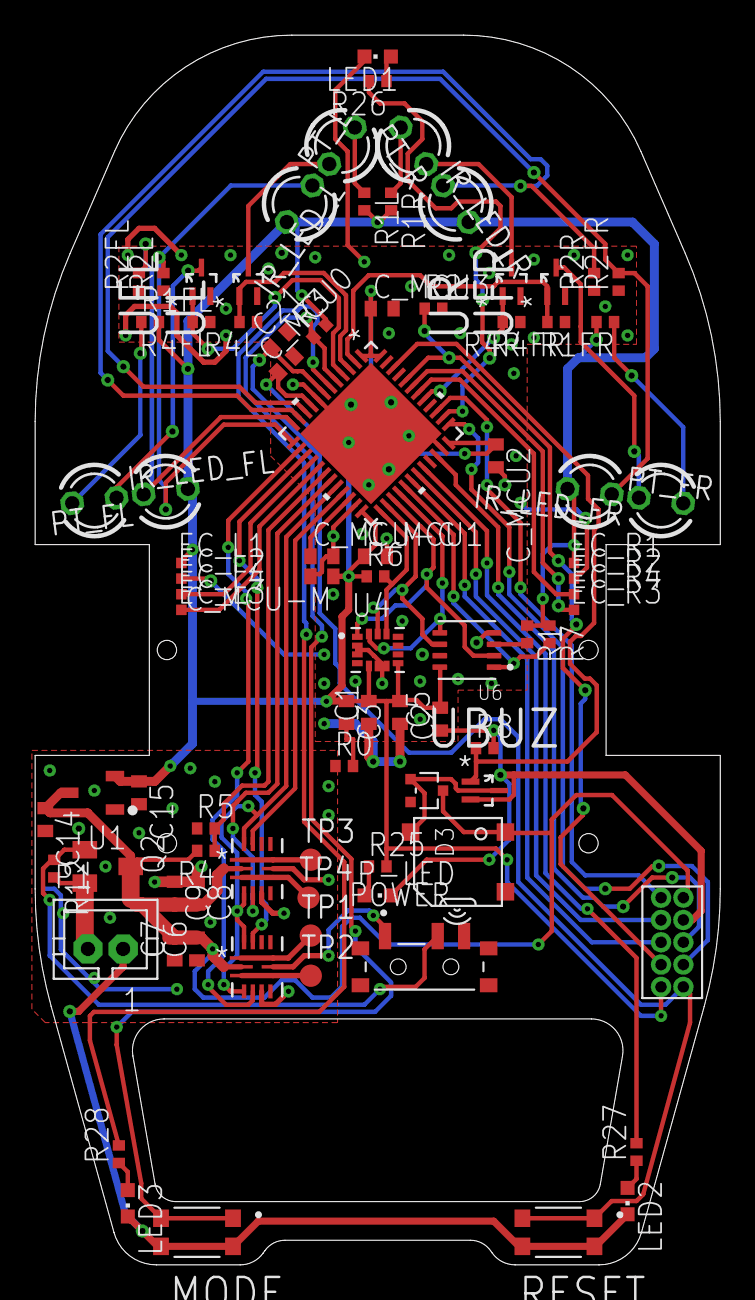
[picture p101: board HM_Nightfall-mini-2e_v1.brd from above]

Board: 2 copper layers, 39.0 x 70.0 mm, 86 parts (0 on the bottom side), 60 nets.
