xfa273/nightfall-fw/platform/stm32f413/HM_Nightfall_f413_preorder/HM_Nightfall_f413_preorder.ioc

Mcu.UserName=STM32F413CHUx
PA0.GPIO_Label=SENSOR_FR
PA0.Signal=ADCx_IN0
PA1.GPIO_Label=SENSOR_R
PA1.Signal=ADCx_IN1
PA10.Signal=USART1_RX
PA11.GPIO_Label=LED_2
PA11.Signal=GPIO_Output
PA13.Signal=SYS_JTMS-SWDIO
PA14.Signal=SYS_JTCK-SWCLK
PA15.GPIO_Label=LED_1
PA15.Signal=GPIO_Output
PA2.GPIO_Label=SENSOR_FL
PA2.Signal=ADCx_IN2
PA3.GPIO_Label=SENSOR_L
PA3.Signal=ADCx_IN3
PA4.GPIO_Label=MOTOR_L_DIR
PA4.Signal=GPIO_Output
PA5.GPIO_Label=MOTOR_L_PWM
PA5.Signal=S_TIM2_CH1_ETR
PA6.GPIO_Label=EC_L_A
PA6.Signal=S_TIM3_CH1
PA7.GPIO_Label=EC_L_B
PA7.Signal=S_TIM3_CH2
PA8.GPIO_Label=FRAM_CS
PA8.Signal=GPIO_Output
PA9.Signal=USART1_TX
PB0.GPIO_Label=VOL_CHECK
PB0.Signal=ADCx_IN8
PB1.GPIO_Label=MOTOR_R_DIR
PB1.Signal=GPIO_Output
PB10.GPIO_Label=MOTOR_R_PWM
PB10.Signal=S_TIM2_CH3
PB12.GPIO_Label=IMU_CS
PB12.Signal=GPIO_Output
PB13.Signal=SPI2_SCK
PB14.Signal=SPI2_MISO
PB15.Signal=SPI2_MOSI
PB2.GPIO_Label=MOTOR_STBY
PB2.Signal=GPIO_Output
PB3.Signal=SYS_JTDO-SWO
PB5.GPIO_Label=IR_R
PB5.Signal=GPIO_Output
PB6.GPIO_Label=EC_R_A
PB6.Signal=S_TIM4_CH1
PB7.GPIO_Label=EC_R_B
PB7.Signal=S_TIM4_CH2
PB8.GPIO_Label=FAN_PWM
PB8.Signal=S_TIM10_CH1
PB9.GPIO_Label=BUZZER_PWM
PB9.Signal=S_TIM11_CH1
PC13.GPIO_Label=IR_FR
PC13.Signal=GPIO_Output
PC14-OSC32_IN.GPIO_Label=IR_L
PC14-OSC32_IN.Signal=GPIO_Output
PC15-OSC32_OUT.GPIO_Label=IR_FL
PC15-OSC32_OUT.Signal=GPIO_Output
