xfa273/nightfall-fw/platform/stm32f413/HM_Nightfall_f413_preorder/Core/Src/f413_control.c

/**
 * @file f413_control.c
 * @brief F413 クローズドループ速度/角速度制御
 *
 * TIM5 1kHz 割り込みで以下を実行する:
 *   1. TIM3(左)/TIM4(右) エンコーダの差分から並進速度を算出
 *   2. ISM330DHCX (SPI2) から角速度を読み取り（IMUベース）
 *   3. P+FF 制御で並進/回転の出力を計算
 *   4. TIM2 CH1(左)/CH3(右) PWM + GPIO 方向ピンでモータを駆動
 *
 * 旋回制御は F405 と同様に IMU を正本とし、エンコーダは並進のみ使用する。
 */

#include "f413_control.h"
#include "f413_motor_pwm.h"
#include "f413_measurements.h"
#include "f413_motion_stop.h"
#include "main.h"
#include "f413_hw.h"
#include "params.h"
#include <math.h>
#include <string.h>

/* ---------- ハードウェア定数 ---------- */
#define F413_CTRL_DT              (0.001f)   /* 制御周期 [s] (1kHz) */
#define F413_CTRL_ENCODER_CENTER  (30000U)   /* エンコーダカウンタ中央値 */
#define F413_CTRL_CPR_WHEEL       (f413_machine_hardware()->encoder_cpr)
#define F413_CTRL_D_TIRE          (D_TIRE)   /* タイヤ直径 [mm], F405同様params.hで調整 */
#define F413_CTRL_TREAD           (f413_machine_hardware()->tread_mm)
#define F413_CTRL_PWM_MAX         F413_MOTOR_PWM_MAX
#define F413_CTRL_ENCODER_SIGN_L  (f413_machine_hardware()->encoder_sign_l)
#define F413_CTRL_ENCODER_SIGN_R  (f413_machine_hardware()->encoder_sign_r)

/* ---------- 制御ゲイン ---------- */
#define F413_CTRL_ANGLE_OMEGA_MAX (4000.0f)
#ifndef F413_CTRL_TUNE_STRAIGHT_ANGLE_OMEGA_MAX
#define F413_CTRL_TUNE_STRAIGHT_ANGLE_OMEGA_MAX (60.0f)
#endif
#define F413_CTRL_TRANS_FF_MIN_VEL_ABS (1.0f)
#define F413_CTRL_TRANS_FF_MIN_ACCEL_ABS (1.0f)
#ifndef CTRL_ENABLE_ANTI_WINDUP
#define CTRL_ENABLE_ANTI_WINDUP 0
#endif
#ifndef CTRL_OUTPUT_MAX
#define CTRL_OUTPUT_MAX 1000.0f
#endif
#ifndef CTRL_DISTANCE_OUTER_DIV
#define CTRL_DISTANCE_OUTER_DIV 1
#endif
#if (CTRL_DISTANCE_OUTER_DIV < 1)
#undef CTRL_DISTANCE_OUTER_DIV
#define CTRL_DISTANCE_OUTER_DIV 1
#endif
#ifndef CTRL_ANGLE_OUTER_DIV
#define CTRL_ANGLE_OUTER_DIV 1
#endif
#if (CTRL_ANGLE_OUTER_DIV < 1)
#undef CTRL_ANGLE_OUTER_DIV
#define CTRL_ANGLE_OUTER_DIV 1
#endif

/* ---------- IMU (ISM330DHCX) 定数 ---------- */
#define F413_IMU_WHO_AM_I_REG     (0x0FU)
#define F413_IMU_WHO_AM_I_VAL     (0x6BU)
#define F413_IMU_CTRL1_XL         (0x10U)    /* 加速度設定 */
#define F413_IMU_CTRL1_XL_833HZ_16G (0x74U)
#define F413_IMU_CTRL2_G          (0x11U)    /* ジャイロ設定 */
#define F413_IMU_CTRL3_C          (0x12U)    /* 制御レジスタ3 */
#define F413_IMU_OUTZ_G_L         (0x26U)    /* ジャイロ Z軸 LOW byte */
#define F413_IMU_OUTZ_G_H         (0x27U)    /* ジャイロ Z軸 HIGH byte */
#define F413_IMU_OUTX_XL_L        (0x28U)
#define F413_IMU_OUTY_XL_L        (0x2AU)
#define F413_IMU_GYRO_SENSITIVITY (0.14f)    /* FS=4000dps → 140mdps/LSB [deg/s/LSB] */
#define F413_IMU_ACCEL_SENS_MG    (0.488f)   /* FS=±16g */
#define F413_IMU_GRAVITY_MM_S2    (9.80665f)
#define F413_IMU_OFFSET_SAMPLES   (500U)     /* オフセット測定回数 */
#define F413_IMU_OFFSET_SETTLE_MS (200U)     /* 静定待ち [ms] */
#define F413_IMU_FORWARD_ACCEL_REG  (f413_machine_hardware()->imu_forward_accel_reg)
#define F413_IMU_FORWARD_ACCEL_SIGN (f413_machine_hardware()->imu_forward_accel_sign)
#define F413_CTRL_VEL_ACCEL_COMP_WINDOW_MAX_MS (64U)
#define F413_CTRL_TUNE_TOTAL_MS   (800U)
#define F413_CTRL_TUNE_RAMP_MS    (400U)
#define F413_CTRL_TUNE_TRAP_EDGE_MS (100U)
#define F413_CTRL_TUNE_DIST_LIMIT_MM (650.0f)
#define F413_CTRL_TUNE_ANGLE_LIMIT_DEG (400.0f)

/* Window bounds are checked by the boot profile resolver (1..64 ms). */

/* ---------- エンコーダ変換定数 ---------- */
static float s_enc_to_mm;

/* ---------- HAL ハンドル (main.c で定義) ---------- */
extern TIM_HandleTypeDef htim2;
extern TIM_HandleTypeDef htim3;
extern TIM_HandleTypeDef htim4;
extern TIM_HandleTypeDef htim5;
extern SPI_HandleTypeDef hspi2;

/* ---------- 状態変数 ---------- */
static volatile bool s_running = false;
static bool s_imu_ok = false;

static volatile float s_acceleration_interrupt = 0.0f;
static volatile float s_velocity_interrupt = 0.0f;
static volatile float s_velocity_profile_target = 0.0f;
static volatile float s_velocity_profile_direction = 0.0f;
static volatile float s_velocity_profile_end_distance = 0.0f;
static volatile uint8_t s_velocity_profile_clamp_enabled = 0U;
static volatile uint8_t s_distance_feedback_enabled = 1U;
static volatile float s_omega_interrupt = 0.0f;
static volatile float s_target_distance = 0.0f;
static volatile float s_target_velocity = 0.0f;
static volatile float s_target_angle = 0.0f;
static volatile float s_target_omega = 0.0f;
static volatile float s_heading_omega_correction = 0.0f;
static volatile bool s_angle_target_enabled = false;
static volatile bool s_omega_profile_active = false;
static volatile float s_omega_profile_peak = 0.0f;
static volatile float s_omega_profile_t_acc = 0.0f;
static volatile float s_omega_profile_t_cruise = 0.0f;
static volatile float s_omega_profile_t_total = 0.0f;
static volatile float s_omega_profile_elapsed = 0.0f;

static volatile float s_real_distance = 0.0f;
static volatile float s_real_velocity = 0.0f;
static volatile float s_real_angle = 0.0f;
static volatile float s_real_omega = 0.0f;
static volatile float s_encoder_angle = 0.0f;
static volatile float s_encoder_omega = 0.0f;
static volatile float s_encoder_distance_l = 0.0f;
static volatile float s_encoder_distance_r = 0.0f;
static volatile float s_encoder_speed_l = 0.0f;
static volatile float s_encoder_speed_r = 0.0f;
static volatile int16_t s_encoder_delta_l = 0;
static volatile int16_t s_encoder_delta_r = 0;
static volatile float s_distance_error = 0.0f;
static volatile float s_distance_error_error = 0.0f;
static volatile float s_previous_distance_error = 0.0f;
static volatile float s_distance_integral = 0.0f;
static volatile float s_velocity_error = 0.0f;
static volatile float s_velocity_error_error = 0.0f;
static volatile float s_previous_velocity_error = 0.0f;
static volatile float s_velocity_integral = 0.0f;
static volatile float s_angle_error = 0.0f;
static volatile float s_angle_error_error = 0.0f;
static volatile float s_previous_angle_error = 0.0f;
static volatile float s_angle_integral = 0.0f;
static volatile float s_omega_error = 0.0f;
static volatile float s_omega_error_error = 0.0f;
static volatile float s_previous_omega_error = 0.0f;
static volatile float s_omega_integral = 0.0f;
static float s_previous_omega_ref = 0.0f;
static bool s_previous_omega_ref_valid = false;
static volatile float s_out_translation = 0.0f;
static volatile float s_out_rotate = 0.0f;
static volatile int16_t s_motor_out_l = 0;
static volatile int16_t s_motor_out_r = 0;

static float s_omega_z_offset  = 0.0f;
static float s_omega_z_raw = 0.0f;
static float s_omega_z_filtered = 0.0f;
static bool  s_omega_z_lpf_inited = false;
static float s_accel_forward_offset = 0.0f;
static float s_accel_forward_filtered = 0.0f;
static bool  s_accel_forward_lpf_inited = false;
static float s_accel_velocity = 0.0f;
static float s_real_velocity_lpf = 0.0f;
static bool s_real_velocity_lpf_inited = false;
static float s_velocity_accel_comp_encoder_buf[F413_CTRL_VEL_ACCEL_COMP_WINDOW_MAX_MS];
static float s_velocity_accel_comp_accel_buf[F413_CTRL_VEL_ACCEL_COMP_WINDOW_MAX_MS];
static float s_velocity_accel_comp_encoder_sum = 0.0f;
static float s_velocity_accel_comp_accel_sum = 0.0f;
static uint16_t s_velocity_accel_comp_index = 0U;
static uint16_t s_velocity_accel_comp_count = 0U;
static uint16_t s_distance_outer_count = 0U;
static float s_distance_velocity_feedback = 0.0f;
static uint16_t s_angle_outer_count = 0U;
static float s_omega_ref_accel = 0.0f;
static float s_omega_ref_lead = 0.0f;

static volatile bool s_spi2_busy = false;
static volatile bool s_imu_motion_sample_valid = false;
static volatile bool s_tune_active = false;
static volatile bool s_tune_done = false;
static volatile uint8_t s_tune_axis = F413_CTRL_TUNE_AXIS_VELOCITY;
static volatile uint8_t s_tune_set = 0U;
static volatile uint8_t s_tune_pattern = F413_CTRL_TUNE_PATTERN_STEP;
static volatile uint16_t s_tune_tick = 0U;
static volatile float s_tune_reference = 0.0f;

static bool f413_ctrl_use_fan_on_gains(void)
{
    return f413_hw_fan_is_running();
}

static void f413_ctrl_cancel_omega_profile(void)
{
    s_omega_profile_active = false;
    s_omega_profile_peak = 0.0f;
    s_omega_profile_t_acc = 0.0f;
    s_omega_profile_t_cruise = 0.0f;
    s_omega_profile_t_total = 0.0f;
    s_omega_profile_elapsed = 0.0f;
}

static float f413_ctrl_sample_omega_profile(float t_s)
{
    const float pi = 3.14159265358979323846f;
    const float omega_peak_abs = fabsf(s_omega_profile_peak);
    float omega_abs;
    float sign;

    if ((s_omega_profile_t_total <= 0.0f) ||
        (s_omega_profile_t_acc <= 0.0f) ||
        (omega_peak_abs <= 0.0f) ||
        (t_s <= 0.0f))
    {
        return 0.0f;
    }

    if (t_s < s_omega_profile_t_acc)
    {
        const float x = pi * (t_s / s_omega_profile_t_acc);
        omega_abs = 0.5f * omega_peak_abs * (1.0f - cosf(x));
    }
    else if (t_s < (s_omega_profile_t_acc + s_omega_profile_t_cruise))
    {
        omega_abs = omega_peak_abs;
    }
    else if (t_s < s_omega_profile_t_total)
    {
        const float td = t_s - (s_omega_profile_t_acc + s_omega_profile_t_cruise);
        const float x = pi * (td / s_omega_profile_t_acc);
        omega_abs = 0.5f * omega_peak_abs * (1.0f + cosf(x));
    }
    else
    {
        return 0.0f;
    }

    sign = (s_omega_profile_peak < 0.0f) ? -1.0f : 1.0f;
    return sign * omega_abs;
}

static void f413_ctrl_update_omega_profile(void)
{
    if (!s_omega_profile_active)
    {
        return;
    }

    if (s_omega_profile_elapsed >= s_omega_profile_t_total)
    {
        s_omega_interrupt = 0.0f;
        s_omega_profile_active = false;
        return;
    }

    s_omega_interrupt = f413_ctrl_sample_omega_profile(s_omega_profile_elapsed);
    s_omega_profile_elapsed += F413_CTRL_DT;
}

static float f413_ctrl_lpf_update(float previous, float input, float tau_s)
{
    float alpha;

    if (tau_s <= 0.0f)
    {
        return input;
    }
    alpha = F413_CTRL_DT / (tau_s + F413_CTRL_DT);
    if (alpha < 0.0f)
    {
        alpha = 0.0f;
    }
    else if (alpha > 1.0f)
    {
        alpha = 1.0f;
    }
    return previous + alpha * (input - previous);
}

static float f413_ctrl_sign_or_zero(float value, float threshold_abs)
{
    if (value > threshold_abs)
    {
        return 1.0f;
    }
    if (value < -threshold_abs)
    {
        return -1.0f;
    }
    return 0.0f;
}

static float f413_ctrl_translation_ff_output(float velocity_ref_mm_s,
                                             float accel_ref_mm_s2,
                                             float ff_static_pwm,
                                             float ff_velocity_pwm,
                                             float ff_accel_pwm)
{
    float sign = f413_ctrl_sign_or_zero(velocity_ref_mm_s,
                                        F413_CTRL_TRANS_FF_MIN_VEL_ABS);
    float out = (ff_velocity_pwm * velocity_ref_mm_s) +
                (ff_accel_pwm * accel_ref_mm_s2);

    if (sign == 0.0f)
    {
        sign = f413_ctrl_sign_or_zero(accel_ref_mm_s2,
                                      F413_CTRL_TRANS_FF_MIN_ACCEL_ABS);
    }
    if (sign != 0.0f)
    {
        out += ff_static_pwm * sign;
    }
    return out;
}

static void f413_ctrl_reset_velocity_accel_comp(void)
{
    memset(s_velocity_accel_comp_encoder_buf, 0, sizeof(s_velocity_accel_comp_encoder_buf));
    memset(s_velocity_accel_comp_accel_buf, 0, sizeof(s_velocity_accel_comp_accel_buf));
    s_velocity_accel_comp_encoder_sum = 0.0f;
    s_velocity_accel_comp_accel_sum = 0.0f;
    s_velocity_accel_comp_index = 0U;
    s_velocity_accel_comp_count = 0U;
    s_accel_velocity = 0.0f;
}

static void f413_ctrl_reset_omega_ff_state(void)
{
    s_previous_omega_ref = 0.0f;
    s_previous_omega_ref_valid = false;
    s_omega_ref_accel = 0.0f;
    s_omega_ref_lead = 0.0f;
}

static void f413_ctrl_sync_distance_feedback_to_real(void)
{
    s_target_distance = s_real_distance;
    s_distance_error = 0.0f;
    s_distance_error_error = 0.0f;
    s_previous_distance_error = 0.0f;
    s_distance_integral = 0.0f;
    s_distance_velocity_feedback = 0.0f;
    s_distance_outer_count = 0U;
}

static float f413_ctrl_update_velocity_accel_comp(float encoder_velocity_mm_s,
                                                  float accel_forward_mm_s2)
{
    const uint16_t window = (uint16_t)VELOCITY_ACCEL_COMP_WINDOW_MS;
    const uint16_t index = s_velocity_accel_comp_index;
    uint16_t count;
    float encoder_avg;
    float accel_avg;
    float avg_time_s;

    if (s_velocity_accel_comp_count >= window)
    {
        s_velocity_accel_comp_encoder_sum -= s_velocity_accel_comp_encoder_buf[index];
        s_velocity_accel_comp_accel_sum -= s_velocity_accel_comp_accel_buf[index];
    }
    else
    {
        s_velocity_accel_comp_count++;
    }

    s_velocity_accel_comp_encoder_buf[index] = encoder_velocity_mm_s;
    s_velocity_accel_comp_accel_buf[index] = accel_forward_mm_s2;
    s_velocity_accel_comp_encoder_sum += encoder_velocity_mm_s;
    s_velocity_accel_comp_accel_sum += accel_forward_mm_s2;

    s_velocity_accel_comp_index++;
    if (s_velocity_accel_comp_index >= window)
    {
        s_velocity_accel_comp_index = 0U;
    }

    count = s_velocity_accel_comp_count;
    encoder_avg = s_velocity_accel_comp_encoder_sum / (float)count;
    accel_avg = s_velocity_accel_comp_accel_sum / (float)count;
    avg_time_s = (float)count * F413_CTRL_DT;
    return encoder_avg + (accel_avg * avg_time_s * 0.5f * VELOCITY_ACCEL_COMP_GAIN);
}

static void f413_ctrl_reset_pid_state(void)
{
    s_target_distance = 0.0f;
    s_target_velocity = 0.0f;
    s_target_angle = 0.0f;
    s_target_omega = 0.0f;
    s_heading_omega_correction = 0.0f;
    s_real_distance = 0.0f;
    s_real_velocity = 0.0f;
    s_real_angle = 0.0f;
    s_real_omega = 0.0f;
    s_encoder_angle = 0.0f;
    s_encoder_omega = 0.0f;
    s_encoder_distance_l = 0.0f;
    s_encoder_distance_r = 0.0f;
    s_encoder_speed_l = 0.0f;
    s_encoder_speed_r = 0.0f;
    s_encoder_delta_l = 0;
    s_encoder_delta_r = 0;
    s_distance_error = 0.0f;
    s_distance_error_error = 0.0f;
    s_previous_distance_error = 0.0f;
    s_distance_integral = 0.0f;
    s_velocity_error = 0.0f;
    s_velocity_error_error = 0.0f;
    s_previous_velocity_error = 0.0f;
    s_velocity_integral = 0.0f;
    s_angle_error = 0.0f;
    s_angle_error_error = 0.0f;
    s_previous_angle_error = 0.0f;
    s_angle_integral = 0.0f;
    s_omega_error = 0.0f;
    s_omega_error_error = 0.0f;
    s_previous_omega_error = 0.0f;
    s_omega_integral = 0.0f;
    f413_ctrl_cancel_omega_profile();
    f413_ctrl_reset_omega_ff_state();
    s_out_translation = 0.0f;
    s_out_rotate = 0.0f;
    s_motor_out_l = 0;
    s_motor_out_r = 0;
    s_omega_z_raw = 0.0f;
    s_omega_z_filtered = 0.0f;
    s_omega_z_lpf_inited = false;
    s_accel_forward_filtered = 0.0f;
    s_accel_forward_lpf_inited = false;
    f413_ctrl_reset_velocity_accel_comp();
    s_real_velocity_lpf = 0.0f;
    s_real_velocity_lpf_inited = false;
    s_imu_motion_sample_valid = false;
    s_distance_outer_count = 0U;
    s_distance_velocity_feedback = 0.0f;
    s_distance_feedback_enabled = 1U;
    s_angle_outer_count = 0U;
}

static void f413_ctrl_reset_profile_state(void)
{
    s_acceleration_interrupt = 0.0f;
    s_velocity_interrupt = 0.0f;
    s_velocity_profile_target = 0.0f;
    s_velocity_profile_direction = 0.0f;
    s_velocity_profile_end_distance = 0.0f;
    s_velocity_profile_clamp_enabled = 0U;
    s_distance_feedback_enabled = 1U;
    s_omega_interrupt = 0.0f;
    s_heading_omega_correction = 0.0f;
    s_angle_target_enabled = false;
    f413_ctrl_cancel_omega_profile();
}

static float f413_ctrl_tune_get_peak(uint8_t axis, uint8_t set)
{
    if (axis == F413_CTRL_TUNE_AXIS_DISTANCE)
    {
        switch (set)
        {
            case 0U: return 270.0f;
            case 1U: return 180.0f;
            case 2U: return 360.0f;
            default: return 270.0f;
        }
    }
    if (axis == F413_CTRL_TUNE_AXIS_ANGLE)
    {
        switch (set)
        {
            case 0U: return 360.0f;
            case 1U: return 180.0f;
            case 2U: return 360.0f;
            default: return 360.0f;
        }
    }
    if (axis == F413_CTRL_TUNE_AXIS_VELOCITY)
    {
        switch (set)
        {
            case 0U: return 300.0f;
            case 1U: return 1000.0f;
            case 2U: return 2000.0f;
            default: return 300.0f;
        }
    }
    switch (set)
    {
        case 0U: return 1000.0f;
        case 1U: return 1000.0f;
        case 2U: return 2000.0f;
        default: return 1000.0f;
    }
}

static float f413_ctrl_tune_ref_step(float peak, uint16_t t_ms, uint16_t on_ms)
{
    return (t_ms < on_ms) ? peak : 0.0f;
}

static float f413_ctrl_clamp_omega_abs(float omega_deg_s, float omega_max_deg_s)
{
    if (omega_deg_s > omega_max_deg_s)
    {
        return omega_max_deg_s;
    }
    if (omega_deg_s < -omega_max_deg_s)
    {
        return -omega_max_deg_s;
    }
    return omega_deg_s;
}

static float f413_ctrl_clamp_angle_omega(float omega_deg_s)
{
    return f413_ctrl_clamp_omega_abs(omega_deg_s, F413_CTRL_ANGLE_OMEGA_MAX);
}

static void f413_ctrl_reset_angle_outer_state(void)
{
    s_target_omega = 0.0f;
    s_angle_outer_count = 0U;
    s_angle_error = 0.0f;
    s_previous_angle_error = 0.0f;
    s_angle_error_error = 0.0f;
    s_angle_integral = 0.0f;
}

static void f413_ctrl_update_angle_outer_loop(float kp_a,
                                              float ki_a,
                                              float kd_a,
                                              float ff_a)
{
    if ((ff_a == 1.0f) && (kp_a == 0.0f) && (ki_a == 0.0f) && (kd_a == 0.0f))
    {
        f413_ctrl_reset_angle_outer_state();
        return;
    }

    s_angle_error = s_target_angle - s_real_angle;
    s_angle_outer_count++;
    if (s_angle_outer_count >= (uint16_t)CTRL_ANGLE_OUTER_DIV)
    {
        s_angle_outer_count = 0U;
        s_angle_integral += s_angle_error;
        s_angle_error_error = s_angle_error - s_previous_angle_error;
        s_previous_angle_error = s_angle_error;
        s_target_omega = f413_ctrl_clamp_angle_omega(((ff_a - 1.0f) * s_omega_interrupt) +
                                                      (kp_a * s_angle_error) +
                                                      (ki_a * s_angle_integral) +
                                                      (kd_a * s_angle_error_error));
    }
}

static float f413_ctrl_update_omega_output(float omega_ref,
                                           float kp_o,
                                           float ki_o,
                                           float kd_o,
                                           float ff_omega,
                                           float ff_omega_accel,
                                           float lead_time_s)
{
    float omega_ref_control;
    float omega_lead_term;
    float rotate_ff;
    float o_i_next;

    if (s_previous_omega_ref_valid)
    {
        s_omega_ref_accel = (omega_ref - s_previous_omega_ref) / F413_CTRL_DT;
    }
    else
    {
        s_omega_ref_accel = 0.0f;
        s_previous_omega_ref_valid = true;
    }
    s_previous_omega_ref = omega_ref;

    omega_lead_term = lead_time_s * s_omega_ref_accel;
    omega_lead_term = f413_ctrl_clamp_omega_abs(omega_lead_term, FF_OMEGA_LEAD_MAX_DPS);
    omega_ref_control = omega_ref + omega_lead_term;
    s_omega_ref_lead = omega_ref_control;

    rotate_ff = -((ff_omega * omega_ref) + (ff_omega_accel * s_omega_ref_accel));

    s_omega_error = s_real_omega - omega_ref_control;
    o_i_next = s_omega_integral + s_omega_error;
    s_omega_error_error = s_omega_error - s_previous_omega_error;
    if (CTRL_ENABLE_ANTI_WINDUP)
    {
        const float out_candidate = rotate_ff +
                                    (kp_o * s_omega_error) +
                                    (ki_o * o_i_next) +
                                    (kd_o * s_omega_error_error);
        const int would_saturate = (fabsf(out_candidate) > CTRL_OUTPUT_MAX) ? 1 : 0;
        const int drives_further = (((out_candidate > 0.0f) && (s_omega_error > 0.0f)) ||
                                    ((out_candidate < 0.0f) && (s_omega_error < 0.0f))) ? 1 : 0;
        if (!(would_saturate && drives_further))
        {
            s_omega_integral = o_i_next;
        }
    }
    else
    {
        s_omega_integral = o_i_next;
    }
    s_previous_omega_error = s_omega_error;

    return rotate_ff +
           (kp_o * s_omega_error) +
           (ki_o * s_omega_integral) +
           (kd_o * s_omega_error_error);
}

static float f413_ctrl_tune_ref_triangle(float peak, uint16_t t_ms, uint16_t ramp_ms)
{
    if (ramp_ms == 0U)
    {
        return 0.0f;
    }
    if (t_ms < ramp_ms)
    {
        return peak * ((float)t_ms / (float)ramp_ms);
    }
    if (t_ms < (uint16_t)(2U * ramp_ms))
    {
        return peak * ((float)((2U * ramp_ms) - t_ms) / (float)ramp_ms);
    }
    return 0.0f;
}

static float f413_ctrl_tune_ref_trapezoid(float peak,
                                          uint16_t t_ms,
                                          uint16_t acc_ms,
                                          uint16_t hold_ms,
                                          uint16_t dec_ms)
{
    const uint16_t t1 = acc_ms;
    const uint16_t t2 = (uint16_t)(acc_ms + hold_ms);
    const uint16_t t3 = (uint16_t)(acc_ms + hold_ms + dec_ms);
    if ((acc_ms == 0U) || (dec_ms == 0U))
    {
        return 0.0f;
    }
    if (t_ms < t1)
    {
        return peak * ((float)t_ms / (float)acc_ms);
    }
    if (t_ms < t2)
    {
        return peak;
    }
    if (t_ms < t3)
    {
        return peak * ((float)(t3 - t_ms) / (float)dec_ms);
    }
    return 0.0f;
}

static uint16_t f413_ctrl_tune_ceil_ms(float value_ms)
{
    if (value_ms < 1.0f)
    {
        return 1U;
    }
    if (value_ms > 60000.0f)
    {
        return 60000U;
    }
    return (uint16_t)ceilf(value_ms);
}

static float f413_ctrl_tune_get_integral_target(uint8_t axis, uint8_t set)
{
    if ((axis == F413_CTRL_TUNE_AXIS_VELOCITY) ||
        (axis == F413_CTRL_TUNE_AXIS_DISTANCE))
    {
        return f413_ctrl_tune_get_peak(F413_CTRL_TUNE_AXIS_DISTANCE, set);
    }
    return f413_ctrl_tune_get_peak(F413_CTRL_TUNE_AXIS_ANGLE, set);
}

static float f413_ctrl_tune_get_rate_peak(uint8_t axis, uint8_t set)
{
    if ((axis == F413_CTRL_TUNE_AXIS_VELOCITY) ||
        (axis == F413_CTRL_TUNE_AXIS_DISTANCE))
    {
        return f413_ctrl_tune_get_peak(F413_CTRL_TUNE_AXIS_VELOCITY, set);
    }
    return f413_ctrl_tune_get_peak(F413_CTRL_TUNE_AXIS_OMEGA, set);
}

static void f413_ctrl_tune_get_profile(uint8_t axis,
                                       uint8_t set,
                                       uint8_t pattern,
                                       float* rate_peak,
                                       uint16_t* on_ms,
                                       uint16_t* ramp_ms,
                                       uint16_t* hold_ms,
                                       uint16_t* end_ms)
{
    const float peak = f413_ctrl_tune_get_rate_peak(axis, set);
    const float target = f413_ctrl_tune_get_integral_target(axis, set);

    *rate_peak = peak;
    *on_ms = F413_CTRL_TUNE_TOTAL_MS;
    *ramp_ms = F413_CTRL_TUNE_RAMP_MS;
    *hold_ms = (uint16_t)(F413_CTRL_TUNE_TOTAL_MS - (2U * F413_CTRL_TUNE_TRAP_EDGE_MS));
    *end_ms = F413_CTRL_TUNE_TOTAL_MS;

    if (pattern == F413_CTRL_TUNE_PATTERN_STEP)
    {
        *on_ms = f413_ctrl_tune_ceil_ms((target * 1000.0f) / fmaxf(peak, 1.0f));
        *end_ms = *on_ms;
    }
    else if (pattern == F413_CTRL_TUNE_PATTERN_TRIANGLE)
    {
        *ramp_ms = f413_ctrl_tune_ceil_ms((target * 1000.0f) / fmaxf(peak, 1.0f));
        *end_ms = (uint16_t)(2U * (*ramp_ms));
    }
    else
    {
        const float effective_ms = (target * 1000.0f) / fmaxf(peak, 1.0f);
        if (effective_ms <= (float)F413_CTRL_TUNE_TRAP_EDGE_MS)
        {
            *hold_ms = 0U;
        }
        else
        {
            *hold_ms = f413_ctrl_tune_ceil_ms(effective_ms - (float)F413_CTRL_TUNE_TRAP_EDGE_MS);
        }
        *end_ms = (uint16_t)((2U * F413_CTRL_TUNE_TRAP_EDGE_MS) + *hold_ms);
    }
}

static void f413_ctrl_tune_finish_now(void)
{
    s_tune_active = false;
    s_tune_done = true;
    s_tune_reference = 0.0f;
    s_acceleration_interrupt = 0.0f;
    s_velocity_interrupt = 0.0f;
    s_omega_interrupt = 0.0f;
    s_target_velocity = 0.0f;
    s_target_omega = 0.0f;
    s_heading_omega_correction = 0.0f;
    s_out_translation = 0.0f;
    s_out_rotate = 0.0f;
}

/* ========================================================== */
/* IMU SPI helpers (ISM330DHCX on SPI2, CS = IMU_CS)          */
/* ========================================================== */

static uint8_t imu_read_byte(uint8_t reg)
{
    uint8_t tx[2] = { (uint8_t)(reg | 0x80U), 0x00U };
    uint8_t rx[2] = { 0U, 0U };

    HAL_GPIO_WritePin(FRAM_CS_GPIO_Port, FRAM_CS_Pin, GPIO_PIN_SET);
    HAL_GPIO_WritePin(IMU_CS_GPIO_Port, IMU_CS_Pin, GPIO_PIN_RESET);
    (void)HAL_SPI_TransmitReceive(&hspi2, tx, rx, 2U, 10U);
    HAL_GPIO_WritePin(IMU_CS_GPIO_Port, IMU_CS_Pin, GPIO_PIN_SET);
    return rx[1];
}

static void imu_write_byte(uint8_t reg, uint8_t val)
{
    uint8_t tx[2] = { (uint8_t)(reg & 0x7FU), val };

    HAL_GPIO_WritePin(FRAM_CS_GPIO_Port, FRAM_CS_Pin, GPIO_PIN_SET);
    HAL_GPIO_WritePin(IMU_CS_GPIO_Port, IMU_CS_Pin, GPIO_PIN_RESET);
    (void)HAL_SPI_Transmit(&hspi2, tx, 2U, 10U);
    HAL_GPIO_WritePin(IMU_CS_GPIO_Port, IMU_CS_Pin, GPIO_PIN_SET);
}

static int16_t imu_read16_le(uint8_t reg_l)
{
    /* バーストリード: 1回のCS cycleで lo+hi を連続読取。
       ISM330DHCX は IF_INC=1 (CTRL3_C) なので自動アドレスインクリメントされ、
       BDU=1 により読取完了まで出力レジスタが更新されない。 */
    uint8_t tx[3] = { (uint8_t)(reg_l | 0x80U), 0x00U, 0x00U };
    uint8_t rx[3] = { 0U, 0U, 0U };

    HAL_GPIO_WritePin(FRAM_CS_GPIO_Port, FRAM_CS_Pin, GPIO_PIN_SET);
    HAL_GPIO_WritePin(IMU_CS_GPIO_Port, IMU_CS_Pin, GPIO_PIN_RESET);
    (void)HAL_SPI_TransmitReceive(&hspi2, tx, rx, 3U, 10U);
    HAL_GPIO_WritePin(IMU_CS_GPIO_Port, IMU_CS_Pin, GPIO_PIN_SET);

    return (int16_t)((uint16_t)rx[2] << 8U | (uint16_t)rx[1]);
}

static float imu_read_gyro_z_dps(void)
{
    return (float)imu_read16_le(F413_IMU_OUTZ_G_L) *
           F413_IMU_GYRO_SENSITIVITY *
           F413_IMU_GYRO_Z_SCALE;
}

static float imu_read_accel_forward_mm_s2(void)
{
    return (float)imu_read16_le(F413_IMU_FORWARD_ACCEL_REG) *
           F413_IMU_ACCEL_SENS_MG *
           F413_IMU_GRAVITY_MM_S2 *
           F413_IMU_FORWARD_ACCEL_SIGN;
}

static bool imu_init_ism330(void)
{
    uint8_t who = imu_read_byte(F413_IMU_WHO_AM_I_REG);
    if (who != F413_IMU_WHO_AM_I_VAL)
    {
        return false;
    }

    /* CTRL3_C: BDU=1, IF_INC=1 */
    imu_write_byte(F413_IMU_CTRL3_C, 0x44U);
    HAL_Delay(10U);

    /* CTRL2_G: ODR=833Hz, FS=4000dps (0x70 | 0x01 = 0x71) */
    imu_write_byte(F413_IMU_CTRL2_G, 0x71U);
    HAL_Delay(10U);

    /* CTRL1_XL: ODR=833Hz, FS=±16g */
    imu_write_byte(F413_IMU_CTRL1_XL, F413_IMU_CTRL1_XL_833HZ_16G);
    HAL_Delay(10U);

    return true;
}

static void imu_get_motion_offsets(void)
{
    float gyro_sum = 0.0f;
    float accel_sum = 0.0f;
    uint32_t i;

    HAL_Delay(F413_IMU_OFFSET_SETTLE_MS);

    for (i = 0U; i < F413_IMU_OFFSET_SAMPLES; i++)
    {
        gyro_sum += imu_read_gyro_z_dps();
        accel_sum += imu_read_accel_forward_mm_s2();
        HAL_Delay(1U);
    }

    s_omega_z_offset = gyro_sum / (float)F413_IMU_OFFSET_SAMPLES;
    s_omega_z_raw = 0.0f;
    s_omega_z_filtered = 0.0f;
    s_omega_z_lpf_inited = false;
    s_accel_forward_offset = accel_sum / (float)F413_IMU_OFFSET_SAMPLES;
    s_accel_forward_filtered = 0.0f;
    s_accel_forward_lpf_inited = false;
    f413_ctrl_reset_velocity_accel_comp();
}

/* ========================================================== */
/* Public API                                                  */
/* ========================================================== */

void f413_ctrl_init(void)
{
    if (!f413_machine_has(F413_CAP_DRIVE | F413_CAP_IMU)) return;
    s_enc_to_mm = (F413_CTRL_D_TIRE * 3.14159265f) / F413_CTRL_CPR_WHEEL;
    s_running = false;
    f413_ctrl_reset_profile_state();
    f413_ctrl_reset_pid_state();
    s_accel_forward_offset = 0.0f;

    /* IMU 初期化 + ジャイロオフセット取得 */
    s_imu_ok = imu_init_ism330();
    if (s_imu_ok)
    {
        imu_get_motion_offsets();
    }

    /* エンコーダ開始 */
    __HAL_TIM_SET_COUNTER(&htim3, F413_CTRL_ENCODER_CENTER);
    __HAL_TIM_SET_COUNTER(&htim4, F413_CTRL_ENCODER_CENTER);
    (void)HAL_TIM_Encoder_Start(&htim3, TIM_CHANNEL_ALL);
    (void)HAL_TIM_Encoder_Start(&htim4, TIM_CHANNEL_ALL);

    /* TIM5 割り込み開始 (1kHz) */
    (void)HAL_TIM_Base_Start_IT(&htim5);
}

void f413_ctrl_start(void)
{
    if (!f413_machine_has(F413_CAP_DRIVE | F413_CAP_IMU)) return;
    /* 走行直前に IMU オフセットを再取得（静止状態で校正） */
    if (s_imu_ok)
    {
        imu_get_motion_offsets();
    }

    /* 状態をリセットしてから有効化 */
    f413_ctrl_reset_profile_state();
    f413_ctrl_reset_pid_state();

    __HAL_TIM_SET_COUNTER(&htim3, F413_CTRL_ENCODER_CENTER);
    __HAL_TIM_SET_COUNTER(&htim4, F413_CTRL_ENCODER_CENTER);

    /* モータ有効化 (IN1/IN2=0 で停止状態にしてから STBY = HIGH, PWM開始) */
    HAL_GPIO_WritePin(MOTOR_STBY_GPIO_Port, MOTOR_STBY_Pin, GPIO_PIN_RESET);
    HAL_GPIO_WritePin(MOTOR_L_DIR_GPIO_Port, MOTOR_L_DIR_Pin, GPIO_PIN_RESET);
    HAL_GPIO_WritePin(MOTOR_R_DIR_GPIO_Port, MOTOR_R_DIR_Pin, GPIO_PIN_RESET);
    (void)HAL_TIM_PWM_Start(&htim2, TIM_CHANNEL_1);
    (void)HAL_TIM_PWM_Start(&htim2, TIM_CHANNEL_3);
    __HAL_TIM_SET_COMPARE(&htim2, TIM_CHANNEL_1, 0U);
    __HAL_TIM_SET_COMPARE(&htim2, TIM_CHANNEL_3, 0U);
    HAL_GPIO_WritePin(MOTOR_STBY_GPIO_Port, MOTOR_STBY_Pin, GPIO_PIN_SET);

    s_running = true;
}

void f413_ctrl_stop(void)
{
    s_running = false;
    s_tune_active = false;
    f413_ctrl_reset_profile_state();
    s_target_velocity = 0.0f;
    s_target_omega    = 0.0f;
    s_out_translation = 0.0f;
    s_out_rotate = 0.0f;
    s_velocity_integral = 0.0f;
    s_omega_integral = 0.0f;
    s_motor_out_l = 0;
    s_motor_out_r = 0;

    /* モータ停止 */
    __HAL_TIM_SET_COMPARE(&htim2, TIM_CHANNEL_1, 0U);
    __HAL_TIM_SET_COMPARE(&htim2, TIM_CHANNEL_3, 0U);
    HAL_GPIO_WritePin(MOTOR_L_DIR_GPIO_Port, MOTOR_L_DIR_Pin, GPIO_PIN_RESET);
    HAL_GPIO_WritePin(MOTOR_R_DIR_GPIO_Port, MOTOR_R_DIR_Pin, GPIO_PIN_RESET);
    (void)HAL_TIM_PWM_Stop(&htim2, TIM_CHANNEL_1);
    (void)HAL_TIM_PWM_Stop(&htim2, TIM_CHANNEL_3);
    HAL_GPIO_WritePin(MOTOR_STBY_GPIO_Port, MOTOR_STBY_Pin, GPIO_PIN_RESET);
}

void f413_ctrl_set_velocity(float velocity_mm_s)
{
    const uint32_t primask = __get_PRIMASK();
    __disable_irq();
    if (s_distance_feedback_enabled != 0U)
    {
        f413_ctrl_sync_distance_feedback_to_real();
    }
    s_distance_feedback_enabled = 0U;
    s_acceleration_interrupt = 0.0f;
    s_velocity_interrupt = velocity_mm_s;
    s_velocity_profile_target = velocity_mm_s;
    s_velocity_profile_direction = 0.0f;
    s_velocity_profile_clamp_enabled = 0U;
    s_target_velocity = velocity_mm_s;
    __set_PRIMASK(primask);
}

void f413_ctrl_clear_velocity_feedback(void)
{
    const uint32_t primask = __get_PRIMASK();
    __disable_irq();
    s_velocity_integral = 0.0f;
    s_previous_velocity_error = s_target_velocity - s_real_velocity;
    s_velocity_error_error = 0.0f;
    __set_PRIMASK(primask);
}

void f413_ctrl_set_velocity_profile(float start_velocity_mm_s,
                                    float target_velocity_mm_s,
                                    float distance_mm)
{
    if (distance_mm <= 0.001f)
    {
        f413_ctrl_set_velocity(target_velocity_mm_s);
        return;
    }

    /* Publish the endpoint and profile atomically to the 1 kHz interrupt. */
    const uint32_t primask = __get_PRIMASK();
    __disable_irq();
    if (f413_ctrl_use_fan_on_gains() && s_distance_feedback_enabled &&
        s_velocity_interrupt == 0.0f && s_velocity_profile_target == 0.0f &&
        start_velocity_mm_s == 0.0f && target_velocity_mm_s != 0.0f &&
        !s_omega_profile_active && s_omega_interrupt == 0.0f)
    {
        /* Release powered stationary holding into rolling motion. The yaw I
         * needed to overcome stationary friction/fan spinup must not launch
         * the robot in the opposite direction to its heading correction.
         * Preserve both measured and requested pose, and translation state.
         * The cleared angle outer loop also changes the omega reference;
         * invalidate derivative history so that change is not an FF impulse.
         */
        s_omega_integral = 0.0f;
        s_previous_omega_error = s_real_omega -
            (s_omega_interrupt + s_target_omega + s_heading_omega_correction);
        s_omega_error_error = 0.0f;
        f413_ctrl_reset_omega_ff_state();
    }
    f413_ctrl_sync_distance_feedback_to_real();
    s_distance_feedback_enabled = 1U;
    s_velocity_interrupt = start_velocity_mm_s;
    s_target_velocity = start_velocity_mm_s;
    s_velocity_profile_target = target_velocity_mm_s;
    s_velocity_profile_clamp_enabled = 1U;
    s_acceleration_interrupt =
        ((target_velocity_mm_s * target_velocity_mm_s) -
         (start_velocity_mm_s * start_velocity_mm_s)) /
        (2.0f * distance_mm);
    s_velocity_profile_direction = s_acceleration_interrupt;
    s_velocity_profile_end_distance = s_target_distance + distance_mm;
    __set_PRIMASK(primask);
}

bool f413_ctrl_stop_profile_complete(void)
{
    return s_velocity_profile_clamp_enabled &&
           s_velocity_profile_target == 0.0f &&
           s_velocity_interrupt == 0.0f && s_acceleration_interrupt == 0.0f;
}

void f413_ctrl_set_omega(float omega_deg_s)
{
    f413_ctrl_cancel_omega_profile();
    s_omega_interrupt = omega_deg_s;
    s_target_omega = 0.0f;
}

void f413_ctrl_start_omega_profile(float signed_omega_peak_deg_s,
                                   float accel_time_s,
                                   float cruise_time_s)
{
    f413_ctrl_cancel_omega_profile();
    if ((signed_omega_peak_deg_s == 0.0f) || (accel_time_s <= 0.0f))
    {
        s_omega_interrupt = 0.0f;
        s_target_omega = 0.0f;
        return;
    }
    if (cruise_time_s < 0.0f)
    {
        cruise_time_s = 0.0f;
    }

    s_omega_profile_peak = signed_omega_peak_deg_s;
    s_omega_profile_t_acc = accel_time_s;
    s_omega_profile_t_cruise = cruise_time_s;
    s_omega_profile_t_total = (2.0f * accel_time_s) + cruise_time_s;
    s_omega_profile_elapsed = 0.0f;
    s_omega_interrupt = 0.0f;
    s_target_omega = 0.0f;
    s_omega_profile_active = true;
}

void f413_ctrl_stop_omega_profile(void)
{
    f413_ctrl_cancel_omega_profile();
    s_omega_interrupt = 0.0f;
    s_target_omega = 0.0f;
}

void f413_ctrl_set_angle_target(float angle_deg)
{
    f413_ctrl_cancel_omega_profile();
    s_target_angle = angle_deg;
    s_angle_target_enabled = true;
    f413_ctrl_reset_angle_outer_state();
}

void f413_ctrl_clear_angle_target(void)
{
    s_angle_target_enabled = false;
    f413_ctrl_reset_angle_outer_state();
}

void f413_ctrl_set_heading_omega_correction(float omega_deg_s)
{
    if (omega_deg_s > WALL_CTRL_MAX)
    {
        omega_deg_s = WALL_CTRL_MAX;
    }
    else if (omega_deg_s < -WALL_CTRL_MAX)
    {
        omega_deg_s = -WALL_CTRL_MAX;
    }
    s_heading_omega_correction = omega_deg_s;
}

void f413_ctrl_tune_start(uint8_t axis, uint8_t set, uint8_t pattern)
{
    if (axis > F413_CTRL_TUNE_AXIS_ANGLE)
    {
        axis = F413_CTRL_TUNE_AXIS_VELOCITY;
    }
    if (set > 2U)
    {
        set = 0U;
    }
    if (pattern > F413_CTRL_TUNE_PATTERN_TRAPEZOID)
    {
        pattern = F413_CTRL_TUNE_PATTERN_STEP;
    }

    f413_ctrl_reset_profile_state();
    f413_ctrl_reset_pid_state();
    s_tune_axis = axis;
    s_tune_set = set;
    s_tune_pattern = pattern;
    s_tune_tick = 0U;
    s_tune_reference = 0.0f;
    s_tune_done = false;
    s_tune_active = true;
}

void f413_ctrl_tune_stop(void)
{
    f413_ctrl_tune_finish_now();
}

bool f413_ctrl_tune_is_active(void)
{
    return s_tune_active;
}

bool f413_ctrl_tune_is_done(void)
{
    return s_tune_done;
}

void f413_ctrl_tune_clear_done(void)
{
    s_tune_done = false;
}

uint8_t f413_ctrl_tune_get_axis(void)
{
    return s_tune_axis;
}

uint8_t f413_ctrl_tune_get_set(void)
{
    return s_tune_set;
}

uint8_t f413_ctrl_tune_get_pattern(void)
{
    return s_tune_pattern;
}

float f413_ctrl_tune_get_reference(void)
{
    return s_tune_reference;
}

float f413_ctrl_get_distance(void)      { return s_real_distance; }
float f413_ctrl_get_angle(void)         { return s_real_angle; }
void  f413_ctrl_reset_distance(void)
{
    s_real_distance = 0.0f;
    s_encoder_distance_l = 0.0f;
    s_encoder_distance_r = 0.0f;
    s_target_distance = 0.0f;
    s_distance_error = 0.0f;
    s_distance_error_error = 0.0f;
    s_previous_distance_error = 0.0f;
    s_distance_integral = 0.0f;
    s_distance_velocity_feedback = 0.0f;
    s_distance_outer_count = 0U;
}
void  f413_ctrl_reset_angle(void)
{
    s_real_angle = 0.0f;
    s_encoder_angle = 0.0f;
    s_encoder_omega = 0.0f;
    s_target_angle = 0.0f;
    s_angle_target_enabled = false;
    f413_ctrl_reset_angle_outer_state();
}
float f413_ctrl_get_real_velocity(void) { return s_real_velocity; }
float f413_ctrl_get_real_omega(void)    { return s_real_omega; }
float f413_ctrl_get_log_angle(void)      { return s_imu_motion_sample_valid ? s_real_angle : s_encoder_angle; }
float f413_ctrl_get_log_real_omega(void) { return s_imu_motion_sample_valid ? s_real_omega : s_encoder_omega; }
float f413_ctrl_get_target_distance(void) { return s_target_distance; }
float f413_ctrl_get_target_velocity(void) { return s_target_velocity; }
float f413_ctrl_get_target_omega(void)    { return s_omega_interrupt + s_target_omega + s_heading_omega_correction; }
float f413_ctrl_get_target_angle(void)    { return s_target_angle; }
float f413_ctrl_get_accel_velocity(void)  { return s_accel_velocity; }
float f413_ctrl_get_accel_forward(void)   { return s_accel_forward_filtered; }
float f413_ctrl_get_gyro_z_raw(void)      { return s_omega_z_raw; }
uint16_t f413_ctrl_get_velocity_accel_comp_window_ms(void) { return (uint16_t)VELOCITY_ACCEL_COMP_WINDOW_MS; }
bool f413_ctrl_velocity_accel_comp_control_enabled(void) { return (VELOCITY_ACCEL_COMP_ENABLE_CONTROL != 0U); }
bool f413_ctrl_velocity_accel_comp_turn_control_enabled(void)
{
    return (VELOCITY_ACCEL_COMP_ENABLE_DURING_OMEGA_PROFILE != 0U);
}
int16_t f413_ctrl_get_motor_out_l(void)   { return s_motor_out_l; }
int16_t f413_ctrl_get_motor_out_r(void)   { return s_motor_out_r; }
int16_t f413_ctrl_get_log_encoder_delta_l(void) { return s_encoder_delta_l; }
int16_t f413_ctrl_get_log_encoder_delta_r(void) { return s_encoder_delta_r; }
bool f413_ctrl_angle_target_enabled(void) { return s_angle_target_enabled; }
bool  f413_ctrl_is_running(void)        { return s_running; }
bool  f413_ctrl_spi2_busy(void)         { return s_spi2_busy; }

/* ========================================================== */
/* 1kHz 割り込みハンドラ                                       */
/* ========================================================== */

void f413_ctrl_tick(void)
{
    float real_velocity_raw;
    float omega_raw = s_real_omega;
    float accel_forward_for_comp = s_accel_forward_filtered;
    float out_l;
    float out_r;
    uint32_t duty_l;
    uint32_t duty_r;
    f413_motor_pwm_command_t pwm_l;
    f413_motor_pwm_command_t pwm_r;
    const bool use_fan_on_gains = f413_ctrl_use_fan_on_gains();
    const float kp_d = use_fan_on_gains ? KP_DISTANCE_FAN_ON : KP_DISTANCE_FAN_OFF;
    const float ki_d = use_fan_on_gains ? KI_DISTANCE_FAN_ON : KI_DISTANCE_FAN_OFF;
    const float kd_d = use_fan_on_gains ? KD_DISTANCE_FAN_ON : KD_DISTANCE_FAN_OFF;
    const float ff_d = use_fan_on_gains ? FF_DISTANCE_FAN_ON : FF_DISTANCE_FAN_OFF;
    const float kp_v = use_fan_on_gains ? KP_VELOCITY_FAN_ON : KP_VELOCITY_FAN_OFF;
    const float ki_v = use_fan_on_gains ? KI_VELOCITY_FAN_ON : KI_VELOCITY_FAN_OFF;
    const float kd_v = use_fan_on_gains ? KD_VELOCITY_FAN_ON : KD_VELOCITY_FAN_OFF;
    const float ff_ts = use_fan_on_gains ? FF_TRANSLATION_STATIC_PWM_FAN_ON :
                                            FF_TRANSLATION_STATIC_PWM_FAN_OFF;
    const float ff_tv = use_fan_on_gains ? FF_TRANSLATION_VELOCITY_PWM_FAN_ON :
                                            FF_TRANSLATION_VELOCITY_PWM_FAN_OFF;
    const float ff_ta = use_fan_on_gains ? FF_TRANSLATION_ACCEL_PWM_FAN_ON :
                                            FF_TRANSLATION_ACCEL_PWM_FAN_OFF;
    const float kp_a = use_fan_on_gains ? KP_ANGLE_FAN_ON : KP_ANGLE_FAN_OFF;
    const float ki_a = use_fan_on_gains ? KI_ANGLE_FAN_ON : KI_ANGLE_FAN_OFF;
    const float kd_a = use_fan_on_gains ? KD_ANGLE_FAN_ON : KD_ANGLE_FAN_OFF;
    const float ff_a = use_fan_on_gains ? FF_ANGLE_FAN_ON : FF_ANGLE_FAN_OFF;
    const float kp_o = use_fan_on_gains ? KP_OMEGA_FAN_ON : KP_OMEGA_FAN_OFF;
    const float ki_o = use_fan_on_gains ? KI_OMEGA_FAN_ON : KI_OMEGA_FAN_OFF;
    const float kd_o = use_fan_on_gains ? KD_OMEGA_FAN_ON : KD_OMEGA_FAN_OFF;
    const float ff_o = use_fan_on_gains ? FF_OMEGA_PWM_FAN_ON : FF_OMEGA_PWM_FAN_OFF;
    const float ff_oa = use_fan_on_gains ? FF_OMEGA_ACCEL_PWM_FAN_ON : FF_OMEGA_ACCEL_PWM_FAN_OFF;

    if (!s_running)
    {
        return;
    }

    /* ---- エンコーダ読取 ---- */
    int32_t enc_l = (int32_t)__HAL_TIM_GET_COUNTER(&htim3) - (int32_t)F413_CTRL_ENCODER_CENTER;
    int32_t enc_r = (int32_t)__HAL_TIM_GET_COUNTER(&htim4) - (int32_t)F413_CTRL_ENCODER_CENTER;
    __HAL_TIM_SET_COUNTER(&htim3, F413_CTRL_ENCODER_CENTER);
    __HAL_TIM_SET_COUNTER(&htim4, F413_CTRL_ENCODER_CENTER);

    /* 方向補正: 前進でカウンタ減少 → enc_l<0 → (-1.0f)で正速度に変換
       （実機ログ 2026-05-01 で確認済み: forward→counter decrease） */
    float dist_l = (float)enc_l * s_enc_to_mm * F413_CTRL_ENCODER_SIGN_L;
    float dist_r = (float)enc_r * s_enc_to_mm * F413_CTRL_ENCODER_SIGN_R;
    s_encoder_delta_l = (int16_t)lrintf((float)enc_l * F413_CTRL_ENCODER_SIGN_L);
    s_encoder_delta_r = (int16_t)lrintf((float)enc_r * F413_CTRL_ENCODER_SIGN_R);
    s_encoder_speed_l = dist_l / F413_CTRL_DT;
    s_encoder_speed_r = dist_r / F413_CTRL_DT;
    s_encoder_omega = ((s_encoder_speed_r - s_encoder_speed_l) / F413_CTRL_TREAD) * (180.0f / 3.14159265f);
    s_encoder_angle += s_encoder_omega * F413_CTRL_DT;
    s_encoder_distance_l += dist_l;
    s_encoder_distance_r += dist_r;
    real_velocity_raw = (s_encoder_speed_l + s_encoder_speed_r) * 0.5f;

    if (!s_real_velocity_lpf_inited)
    {
        s_real_velocity_lpf = real_velocity_raw;
        s_real_velocity_lpf_inited = true;
    }
    else
    {
        s_real_velocity_lpf = f413_ctrl_lpf_update(s_real_velocity_lpf,
                                                   real_velocity_raw,
                                                   F413_VELOCITY_LPF_TAU);
    }
    s_real_distance = (s_encoder_distance_l + s_encoder_distance_r) * 0.5f;

    /* 角速度 [deg/s] — IMU ジャイロから (F405 read_IMU() と同等)
       SPI2 が FRAM 操作中（HAL busy）ならこの tick の IMU 読取をスキップし前回値を維持 */
    if (s_imu_ok && hspi2.State == HAL_SPI_STATE_READY)
    {
        s_spi2_busy = true;
        /* IMU Z軸: CCW(左旋回)=正, CW(右旋回)=負 → 制御系と一致。符号反転不要。
           （2026-05-01: 旋回逆転の原因はPWMチャネル左右逆だった） */
        omega_raw = imu_read_gyro_z_dps() - s_omega_z_offset;
        s_omega_z_raw = omega_raw;
        if (!s_omega_z_lpf_inited)
        {
            s_omega_z_filtered = omega_raw;
            s_omega_z_lpf_inited = true;
        }
        else
        {
            s_omega_z_filtered = f413_ctrl_lpf_update(s_omega_z_filtered, omega_raw, F413_IMU_GYRO_Z_LPF_TAU);
        }
        omega_raw = s_omega_z_filtered;

        float accel_raw = imu_read_accel_forward_mm_s2() - s_accel_forward_offset;
        accel_raw = f413_imu_centre_forward_accel(accel_raw, omega_raw,
            f413_machine_hardware()->imu_forward_offset_mm);
        accel_forward_for_comp = accel_raw;
        if (!s_accel_forward_lpf_inited)
        {
            s_accel_forward_filtered = accel_raw;
            s_accel_forward_lpf_inited = true;
        }
        else
        {
            s_accel_forward_filtered = f413_ctrl_lpf_update(s_accel_forward_filtered,
                                                            accel_raw,
                                                            F413_IMU_ACCEL_FORWARD_LPF_TAU);
        }
        s_spi2_busy = false;
        s_imu_motion_sample_valid = true;
    }

    s_accel_velocity = f413_ctrl_update_velocity_accel_comp(real_velocity_raw, accel_forward_for_comp);
    /* Feedback must represent actual motion, including overspeed. Do not
     * clip the estimate to a bring-up ceiling or the commanded velocity. */

    if (VELOCITY_ACCEL_COMP_ENABLE_CONTROL != 0U)
    {
    /*
     * A turn produces lateral acceleration near v*omega.  Until the IMU-axis
     * cross-coupling is calibrated, feeding that component into the forward
     * velocity estimator makes the translation PI alternately back off and
     * surge.  Use the existing 3 ms encoder LPF instead.  It remains
     * independent of turn direction without adding the roughly 15 ms group
     * delay of the accelerometer estimator's 30 ms moving window.
     */
      s_real_velocity = (s_omega_profile_active &&
          VELOCITY_ACCEL_COMP_ENABLE_DURING_OMEGA_PROFILE == 0U) ?
          s_real_velocity_lpf : s_accel_velocity;
    }
    else
    {
      s_real_velocity = s_real_velocity_lpf;
    }

    s_real_omega = omega_raw;
    s_real_angle += s_real_omega * F413_CTRL_DT;

    if (s_tune_active)
    {
        const uint16_t t_ms = s_tune_tick;
        float rate_peak;
        uint16_t on_ms;
        uint16_t ramp_ms;
        uint16_t hold_ms;
        uint16_t end_ms;
        float rate_ref;
        float ref;

        f413_ctrl_tune_get_profile(s_tune_axis,
                                   s_tune_set,
                                   s_tune_pattern,
                                   &rate_peak,
                                   &on_ms,
                                   &ramp_ms,
                                   &hold_ms,
                                   &end_ms);

        if (s_tune_pattern == F413_CTRL_TUNE_PATTERN_STEP)
        {
            rate_ref = f413_ctrl_tune_ref_step(rate_peak, t_ms, on_ms);
        }
        else if (s_tune_pattern == F413_CTRL_TUNE_PATTERN_TRIANGLE)
        {
            rate_ref = f413_ctrl_tune_ref_triangle(rate_peak, t_ms, ramp_ms);
        }
        else
        {
            rate_ref = f413_ctrl_tune_ref_trapezoid(rate_peak, t_ms,
                                                    F413_CTRL_TUNE_TRAP_EDGE_MS,
                                                    hold_ms,
                                                    F413_CTRL_TUNE_TRAP_EDGE_MS);
        }
        ref = rate_ref;

        if (((s_tune_axis == F413_CTRL_TUNE_AXIS_VELOCITY) ||
             (s_tune_axis == F413_CTRL_TUNE_AXIS_DISTANCE)) &&
            (fabsf(s_real_distance) > F413_CTRL_TUNE_DIST_LIMIT_MM))
        {
            f413_ctrl_tune_finish_now();
        }
        else if (((s_tune_axis == F413_CTRL_TUNE_AXIS_OMEGA) ||
                  (s_tune_axis == F413_CTRL_TUNE_AXIS_ANGLE)) &&
                 (fabsf(s_real_angle) > F413_CTRL_TUNE_ANGLE_LIMIT_DEG))
        {
            f413_ctrl_tune_finish_now();
        }
        else
        {
            if (s_tune_axis == F413_CTRL_TUNE_AXIS_VELOCITY)
            {
                s_velocity_interrupt = rate_ref;
                s_target_distance += rate_ref * F413_CTRL_DT;
                s_target_velocity = rate_ref;
                s_omega_interrupt = 0.0f;
                s_target_omega = 0.0f;
                s_heading_omega_correction = 0.0f;
            }
            else if (s_tune_axis == F413_CTRL_TUNE_AXIS_OMEGA)
            {
                s_velocity_interrupt = 0.0f;
                s_target_velocity = 0.0f;
                s_omega_interrupt = rate_ref;
                s_target_angle += rate_ref * F413_CTRL_DT;
                s_target_omega = 0.0f;
                s_heading_omega_correction = 0.0f;
            }
            else if (s_tune_axis == F413_CTRL_TUNE_AXIS_DISTANCE)
            {
                s_velocity_interrupt = 0.0f;
                s_target_distance += rate_ref * F413_CTRL_DT;
                ref = s_target_distance;
                s_distance_error = s_target_distance - s_real_distance;
                s_distance_outer_count++;
                if (s_distance_outer_count >= (uint16_t)CTRL_DISTANCE_OUTER_DIV)
                {
                    s_distance_outer_count = 0U;
                    s_distance_integral += s_distance_error;
                    s_distance_error_error = s_distance_error - s_previous_distance_error;
                    s_previous_distance_error = s_distance_error;
                    s_distance_velocity_feedback = (kp_d * s_distance_error) +
                                                   (ki_d * s_distance_integral) +
                                                   (kd_d * s_distance_error_error);
                }
                s_target_velocity = (ff_d * rate_ref) + s_distance_velocity_feedback;
                s_omega_interrupt = 0.0f;
                s_target_omega = 0.0f;
                s_heading_omega_correction = 0.0f;
            }
            else
            {
                s_velocity_interrupt = 0.0f;
                s_target_velocity = 0.0f;
                s_omega_interrupt = 0.0f;
                s_target_angle += rate_ref * F413_CTRL_DT;
                ref = s_target_angle;
                s_angle_error = s_target_angle - s_real_angle;
                s_angle_outer_count++;
                if (s_angle_outer_count >= (uint16_t)CTRL_ANGLE_OUTER_DIV)
                {
                    s_angle_outer_count = 0U;
                    s_angle_integral += s_angle_error;
                    s_angle_error_error = s_angle_error - s_previous_angle_error;
                    s_previous_angle_error = s_angle_error;
                    s_target_omega = f413_ctrl_clamp_angle_omega((ff_a * rate_ref) +
                                                                  (kp_a * s_angle_error) +
                                                                  (ki_a * s_angle_integral) +
                                                                  (kd_a * s_angle_error_error));
                }
                s_heading_omega_correction = 0.0f;
            }

            s_tune_reference = ref;

            if ((s_tune_axis == F413_CTRL_TUNE_AXIS_VELOCITY) ||
                (s_tune_axis == F413_CTRL_TUNE_AXIS_DISTANCE))
            {
                if ((kp_a == 0.0f) && (ki_a == 0.0f) && (kd_a == 0.0f))
                {
                    s_target_omega = 0.0f;
                    s_angle_outer_count = 0U;
                    s_angle_error = 0.0f;
                    s_previous_angle_error = 0.0f;
                    s_angle_error_error = 0.0f;
                    s_angle_integral = 0.0f;
                }
                else
                {
                    s_angle_error = s_target_angle - s_real_angle;
                    s_angle_outer_count++;
                    if (s_angle_outer_count >= (uint16_t)CTRL_ANGLE_OUTER_DIV)
                    {
                        s_angle_outer_count = 0U;
                        s_angle_integral += s_angle_error;
                        s_angle_error_error = s_angle_error - s_previous_angle_error;
                        s_previous_angle_error = s_angle_error;
                        s_target_omega = f413_ctrl_clamp_omega_abs((kp_a * s_angle_error) +
                                                                    (ki_a * s_angle_integral) +
                                                                    (kd_a * s_angle_error_error),
                                                                    F413_CTRL_TUNE_STRAIGHT_ANGLE_OMEGA_MAX);
                    }
                }
            }

            {
                float v_i_next = s_velocity_integral + (s_target_velocity - s_real_velocity);
                s_velocity_error = s_target_velocity - s_real_velocity;
                s_velocity_error_error = s_velocity_error - s_previous_velocity_error;
                if (CTRL_ENABLE_ANTI_WINDUP)
                {
                    const float out_candidate = (kp_v * s_velocity_error) +
                                                (ki_v * v_i_next) +
                                                (kd_v * s_velocity_error_error);
                    const int would_saturate = (fabsf(out_candidate) > CTRL_OUTPUT_MAX) ? 1 : 0;
                    const int drives_further = (((out_candidate > 0.0f) && (s_velocity_error > 0.0f)) ||
                                                ((out_candidate < 0.0f) && (s_velocity_error < 0.0f))) ? 1 : 0;
                    if (!(would_saturate && drives_further))
                    {
                        s_velocity_integral = v_i_next;
                    }
                }
                else
                {
                    s_velocity_integral = v_i_next;
                }
                s_out_translation =
                    f413_ctrl_translation_ff_output(s_velocity_interrupt,
                                                    s_acceleration_interrupt,
                                                    ff_ts,
                                                    ff_tv,
                                                    ff_ta) +
                    (kp_v * s_velocity_error) +
                    (ki_v * s_velocity_integral) +
                    (kd_v * s_velocity_error_error);
                s_previous_velocity_error = s_velocity_error;
            }

            {
                const float omega_ref = s_omega_interrupt + s_target_omega + s_heading_omega_correction;
                s_out_rotate = f413_ctrl_update_omega_output(omega_ref,
                                                              kp_o,
                                                              ki_o,
                                                              kd_o,
                                                              ff_o,
                                                              ff_oa,
                                                              FF_OMEGA_LEAD_TIME_S);
            }

            s_tune_tick++;
            if (s_tune_tick >= end_ms)
            {
                f413_ctrl_tune_finish_now();
            }
        }
    }
    else
    {
        f413_ctrl_update_omega_profile();

        if (s_velocity_profile_clamp_enabled)
        {
            float velocity = s_velocity_interrupt;
            float acceleration = s_acceleration_interrupt;
            f413_motion_profile_advance(&velocity, &acceleration,
                                       s_velocity_profile_target, F413_CTRL_DT);
            s_velocity_interrupt = velocity;
            s_acceleration_interrupt = acceleration;
        }
        else
        {
            s_velocity_interrupt += s_acceleration_interrupt * F413_CTRL_DT;
        }
        const bool stop_profile_complete = f413_ctrl_stop_profile_complete();
        if (stop_profile_complete)
        {
            /* Avoid a permanently short endpoint from discrete integration. */
            s_target_distance = s_velocity_profile_end_distance;
        }
        else
        {
            s_target_distance += s_velocity_interrupt * F413_CTRL_DT;
        }

        if (s_distance_feedback_enabled != 0U)
        {
            s_distance_error = s_target_distance - s_real_distance;
            s_distance_outer_count++;
            if (s_distance_outer_count >= (uint16_t)CTRL_DISTANCE_OUTER_DIV)
            {
                s_distance_outer_count = 0U;
                s_distance_integral += s_distance_error;
                s_distance_error_error = s_distance_error - s_previous_distance_error;
                s_previous_distance_error = s_distance_error;
                s_distance_velocity_feedback = (kp_d * s_distance_error) +
                                               (ki_d * s_distance_integral) +
                                               (kd_d * s_distance_error_error);
            }
        }
        else
        {
            s_distance_error = 0.0f;
            s_distance_error_error = 0.0f;
            s_previous_distance_error = 0.0f;
            s_distance_integral = 0.0f;
            s_distance_velocity_feedback = 0.0f;
            s_distance_outer_count = 0U;
        }
        s_target_velocity = (ff_d * s_velocity_interrupt) + s_distance_velocity_feedback;
        if (s_velocity_profile_clamp_enabled != 0U)
        {
            s_target_velocity = f413_motion_profile_limit(s_target_velocity,
                s_velocity_profile_target, s_velocity_profile_direction,
                stop_profile_complete);
        }

        s_velocity_error = s_target_velocity - s_real_velocity;
        {
            float v_i_next = s_velocity_integral + s_velocity_error;
            s_velocity_error_error = s_velocity_error - s_previous_velocity_error;
            if (CTRL_ENABLE_ANTI_WINDUP)
            {
                const float out_candidate = (kp_v * s_velocity_error) +
                                            (ki_v * v_i_next) +
                                            (kd_v * s_velocity_error_error);
                const int would_saturate = (fabsf(out_candidate) > CTRL_OUTPUT_MAX) ? 1 : 0;
                const int drives_further = (((out_candidate > 0.0f) && (s_velocity_error > 0.0f)) ||
                                            ((out_candidate < 0.0f) && (s_velocity_error < 0.0f))) ? 1 : 0;
                if (!(would_saturate && drives_further))
                {
                    s_velocity_integral = v_i_next;
                }
            }
            else
            {
                s_velocity_integral = v_i_next;
            }
            s_out_translation =
                f413_ctrl_translation_ff_output(stop_profile_complete ? s_target_velocity : s_velocity_interrupt,
                                                s_acceleration_interrupt,
                                                ff_ts,
                                                ff_tv,
                                                ff_ta) +
                (kp_v * s_velocity_error) +
                (ki_v * s_velocity_integral) +
                (kd_v * s_velocity_error_error);
            s_previous_velocity_error = s_velocity_error;
        }

        if (s_omega_profile_active)
        {
            s_target_angle += (s_omega_interrupt + s_heading_omega_correction) * F413_CTRL_DT;
            f413_ctrl_update_angle_outer_loop(kp_a, ki_a, kd_a, ff_a);
        }
        else
        {
            if (!s_angle_target_enabled)
            {
                s_target_angle += (s_omega_interrupt + s_heading_omega_correction) * F413_CTRL_DT;
            }
            f413_ctrl_update_angle_outer_loop(kp_a, ki_a, kd_a, ff_a);
        }

        {
            const float omega_ref = s_omega_interrupt + s_target_omega + s_heading_omega_correction;
            s_out_rotate = f413_ctrl_update_omega_output(omega_ref,
                                                          kp_o,
                                                          ki_o,
                                                          kd_o,
                                                          ff_o,
                                                          ff_oa,
                                                          FF_OMEGA_LEAD_TIME_S);
        }
    }

    /* 左右出力 */
    out_l = s_out_translation + s_out_rotate;
    out_r = s_out_translation - s_out_rotate;
    s_motor_out_l = (int16_t)lrintf(fmaxf(fminf(out_l, (float)F413_CTRL_PWM_MAX), -(float)F413_CTRL_PWM_MAX));
    s_motor_out_r = (int16_t)lrintf(fmaxf(fminf(out_r, (float)F413_CTRL_PWM_MAX), -(float)F413_CTRL_PWM_MAX));

    /* ---- モータ出力 ---- */
    duty_l = (uint32_t)fminf(fabsf(out_l), (float)F413_CTRL_PWM_MAX);
    duty_r = (uint32_t)fminf(fabsf(out_r), (float)F413_CTRL_PWM_MAX);

    pwm_l = f413_motor_pwm_encode(true, out_l >= 0.0f, (uint16_t)duty_l);
    pwm_r = f413_motor_pwm_encode(false, out_r >= 0.0f, (uint16_t)duty_r);

    /* ハードウェア配線: TIM2_CH1=左モータ, TIM2_CH3=右モータ
       MP6551 入力: PWM pin=IN1, DIR pin=IN2, STBY pin=EN1/EN2 */
    if (pwm_l.in2_high)
    {
        __HAL_TIM_SET_COMPARE(&htim2, TIM_CHANNEL_1, pwm_l.compare);
        HAL_GPIO_WritePin(MOTOR_L_DIR_GPIO_Port, MOTOR_L_DIR_Pin, GPIO_PIN_SET);
    }
    else
    {
        HAL_GPIO_WritePin(MOTOR_L_DIR_GPIO_Port, MOTOR_L_DIR_Pin, GPIO_PIN_RESET);
        __HAL_TIM_SET_COMPARE(&htim2, TIM_CHANNEL_1, pwm_l.compare);
    }

    if (pwm_r.in2_high)
    {
        __HAL_TIM_SET_COMPARE(&htim2, TIM_CHANNEL_3, pwm_r.compare);
        HAL_GPIO_WritePin(MOTOR_R_DIR_GPIO_Port, MOTOR_R_DIR_Pin, GPIO_PIN_SET);
    }
    else
    {
        HAL_GPIO_WritePin(MOTOR_R_DIR_GPIO_Port, MOTOR_R_DIR_Pin, GPIO_PIN_RESET);
        __HAL_TIM_SET_COMPARE(&htim2, TIM_CHANNEL_3, pwm_r.compare);
    }
}
