xfa273/nightfall-fw/platform/stm32f413/HM_Nightfall_f413_preorder/Core/Inc/main.h

#define IR_FR_Pin GPIO_PIN_13
#define IR_FR_GPIO_Port GPIOC
#define IR_L_Pin GPIO_PIN_14
#define IR_L_GPIO_Port GPIOC
#define IR_FL_Pin GPIO_PIN_15
#define IR_FL_GPIO_Port GPIOC
#define PUSH_IN_1_Pin GPIO_PIN_0
#define PUSH_IN_1_GPIO_Port GPIOH
#define LED_3_Pin GPIO_PIN_1
#define LED_3_GPIO_Port GPIOH
#define SENSOR_FR_Pin GPIO_PIN_0
#define SENSOR_FR_GPIO_Port GPIOA
#define SENSOR_R_Pin GPIO_PIN_1
#define SENSOR_R_GPIO_Port GPIOA
#define SENSOR_FL_Pin GPIO_PIN_2
#define SENSOR_FL_GPIO_Port GPIOA
#define SENSOR_L_Pin GPIO_PIN_3
#define SENSOR_L_GPIO_Port GPIOA
#define MOTOR_L_DIR_Pin GPIO_PIN_4
#define MOTOR_L_DIR_GPIO_Port GPIOA
#define MOTOR_L_PWM_Pin GPIO_PIN_5
#define MOTOR_L_PWM_GPIO_Port GPIOA
#define EC_L_A_Pin GPIO_PIN_6
#define EC_L_A_GPIO_Port GPIOA
#define EC_L_B_Pin GPIO_PIN_7
#define EC_L_B_GPIO_Port GPIOA
#define VOL_CHECK_Pin GPIO_PIN_0
#define VOL_CHECK_GPIO_Port GPIOB
#define MOTOR_R_DIR_Pin GPIO_PIN_1
#define MOTOR_R_DIR_GPIO_Port GPIOB
#define MOTOR_STBY_Pin GPIO_PIN_2
#define MOTOR_STBY_GPIO_Port GPIOB
#define MOTOR_R_PWM_Pin GPIO_PIN_10
#define MOTOR_R_PWM_GPIO_Port GPIOB
#define IMU_CS_Pin GPIO_PIN_12
#define IMU_CS_GPIO_Port GPIOB
#define FRAM_CS_Pin GPIO_PIN_8
#define FRAM_CS_GPIO_Port GPIOA
#define LED_2_Pin GPIO_PIN_11
#define LED_2_GPIO_Port GPIOA
#define LED_1_Pin GPIO_PIN_15
#define LED_1_GPIO_Port GPIOA
#define IR_R_Pin GPIO_PIN_5
#define IR_R_GPIO_Port GPIOB
#define EC_R_A_Pin GPIO_PIN_6
#define EC_R_A_GPIO_Port GPIOB
#define EC_R_B_Pin GPIO_PIN_7
#define EC_R_B_GPIO_Port GPIOB
#define FAN_PWM_Pin GPIO_PIN_8
#define FAN_PWM_GPIO_Port GPIOB
#define BUZZER_PWM_Pin GPIO_PIN_9
#define BUZZER_PWM_GPIO_Port GPIOB
