xfa273/nightfall-fw/platform/stm32f413/HM_Nightfall_f413_preorder/Core/Src/f413_wall_sensor.c

#include "f413_wall_sensor.h"

#include <math.h>
#include <string.h>

#include "f413_hw.h"
#include "main.h"
#include "nvm_params.h"
#include "params.h"

#define F413_WALL_SENSOR_ADC_CHANNELS (9U)
#define F413_WALL_SENSOR_SAT_ADC (4090U)

extern ADC_HandleTypeDef hadc1;
extern TIM_HandleTypeDef htim6;

static volatile uint8_t g_wall_sensor_adc_phase = 0U;
static volatile uint8_t g_wall_sensor_adc_inflight = 0U;
static volatile uint8_t g_wall_sensor_ready_mask = 0U;
static volatile uint16_t g_wall_adc_dma_off[F413_WALL_SENSOR_ADC_CHANNELS];
static volatile uint16_t g_wall_adc_dma_on[F413_WALL_SENSOR_ADC_CHANNELS];
static volatile uint16_t g_wall_adc_r_off = 0U;
static volatile uint16_t g_wall_adc_l_off = 0U;
static volatile uint16_t g_wall_adc_fr_off = 0U;
static volatile uint16_t g_wall_adc_fl_off = 0U;
static volatile uint16_t g_wall_adc_r_raw = 0U;
static volatile uint16_t g_wall_adc_l_raw = 0U;
static volatile uint16_t g_wall_adc_fr_raw = 0U;
static volatile uint16_t g_wall_adc_fl_raw = 0U;
static volatile uint16_t g_wall_adc_r = 0U;
static volatile uint16_t g_wall_adc_l = 0U;
static volatile uint16_t g_wall_adc_fr = 0U;
static volatile uint16_t g_wall_adc_fl = 0U;
static volatile uint16_t g_wall_adc_vbat = 0U;
static volatile uint16_t g_wall_offset_r = 0U;
static volatile uint16_t g_wall_offset_l = 0U;
static volatile uint16_t g_wall_offset_fr = 0U;
static volatile uint16_t g_wall_offset_fl = 0U;
static volatile uint16_t g_wall_base_l;
static volatile uint16_t g_wall_base_r;
static volatile uint16_t g_wall_base_f = 0U;
static volatile uint32_t g_wall_sensor_publish_guard = 0U;
static volatile f413_wall_sensor_snapshot_t g_wall_sensor_completed;

static void f413_wall_sensor_publish_completed(void)
{
  uint32_t sample_sequence = g_wall_sensor_completed.sample_sequence + 1U;

  g_wall_sensor_publish_guard++;
  __DMB();
  g_wall_sensor_completed.sample_sequence = sample_sequence;
  g_wall_sensor_completed.fr_off = g_wall_adc_fr_off;
  g_wall_sensor_completed.r_off = g_wall_adc_r_off;
  g_wall_sensor_completed.fl_off = g_wall_adc_fl_off;
  g_wall_sensor_completed.l_off = g_wall_adc_l_off;
  g_wall_sensor_completed.vbat_off = g_wall_adc_vbat;
  g_wall_sensor_completed.fr_on = g_wall_adc_fr_raw;
  g_wall_sensor_completed.r_on = g_wall_adc_r_raw;
  g_wall_sensor_completed.fl_on = g_wall_adc_fl_raw;
  g_wall_sensor_completed.l_on = g_wall_adc_l_raw;
  g_wall_sensor_completed.vbat_on = g_wall_adc_vbat;
  g_wall_sensor_completed.fr_delta = (int32_t)g_wall_adc_fr;
  g_wall_sensor_completed.r_delta = (int32_t)g_wall_adc_r;
  g_wall_sensor_completed.fl_delta = (int32_t)g_wall_adc_fl;
  g_wall_sensor_completed.l_delta = (int32_t)g_wall_adc_l;
  g_wall_sensor_completed.front_wall = (g_wall_adc_fr > WALL_BASE_FR) ||
                                        (g_wall_adc_fl > WALL_BASE_FL);
  g_wall_sensor_completed.right_wall = g_wall_adc_r > WALL_BASE_R;
  g_wall_sensor_completed.left_wall = g_wall_adc_l > WALL_BASE_L;
  g_wall_sensor_completed.saturated = (g_wall_adc_fr_raw >= F413_WALL_SENSOR_SAT_ADC) ||
                                      (g_wall_adc_r_raw >= F413_WALL_SENSOR_SAT_ADC) ||
                                      (g_wall_adc_fl_raw >= F413_WALL_SENSOR_SAT_ADC) ||
                                      (g_wall_adc_l_raw >= F413_WALL_SENSOR_SAT_ADC);
  __DMB();
  g_wall_sensor_publish_guard++;
}

static uint16_t f413_wall_sensor_subtract_u16(uint16_t on, uint16_t off, uint16_t offset)
{
  int32_t value = (int32_t)on - (int32_t)off - (int32_t)offset;

  if (value <= 0)
  {
    return 0U;
  }
  if (value > 65535)
  {
    return 65535U;
  }
  return (uint16_t)value;
}

static bool f413_sensor_params_is_nvm_test_blob(const nvm_sensor_params_t* params)
{
  if (params == NULL)
  {
    return false;
  }

  return (params->base_l == 1111U) &&
         (params->base_r == 1222U) &&
         (params->base_f == 1333U) &&
         (params->wall_offset_r == 200U) &&
         (params->wall_offset_l == 210U) &&
         (params->wall_offset_fr == 220U) &&
         (params->wall_offset_fl == 230U);
}

static HAL_StatusTypeDef f413_wall_sensor_adc_dma_start(volatile uint16_t* dst)
{
  if (dst == NULL)
  {
    return HAL_ERROR;
  }

  (void)HAL_ADC_Stop_DMA(&hadc1);
  return HAL_ADC_Start_DMA(&hadc1, (uint32_t*)dst, F413_WALL_SENSOR_ADC_CHANNELS);
}

static void f413_wall_sensor_load_params(void)
{
  nvm_sensor_params_t params;

  if (!nvm_params_sensor_load(&params) ||
      f413_sensor_params_is_nvm_test_blob(&params))
  {
    nvm_params_sensor_defaults(&params);
  }

  g_wall_offset_r = params.wall_offset_r;
  g_wall_offset_l = params.wall_offset_l;
  g_wall_offset_fr = params.wall_offset_fr;
  g_wall_offset_fl = params.wall_offset_fl;
  g_wall_base_l = (params.base_l != 0U) ? params.base_l : WALL_CTRL_BASE_L;
  g_wall_base_r = (params.base_r != 0U) ? params.base_r : WALL_CTRL_BASE_R;
  g_wall_base_f = params.base_f;
}

static void f413_wall_sensor_apply_saved_params(const nvm_sensor_params_t* params)
{
  if (params == NULL)
  {
    return;
  }

  g_wall_offset_r = params->wall_offset_r;
  g_wall_offset_l = params->wall_offset_l;
  g_wall_offset_fr = params->wall_offset_fr;
  g_wall_offset_fl = params->wall_offset_fl;
  g_wall_base_l = (params->base_l != 0U) ? params->base_l : WALL_CTRL_BASE_L;
  g_wall_base_r = (params->base_r != 0U) ? params->base_r : WALL_CTRL_BASE_R;
  g_wall_base_f = params->base_f;
}

static void f413_wall_sensor_load_edit_params(nvm_sensor_params_t* params)
{
  if (params == NULL)
  {
    return;
  }

  if (!nvm_params_sensor_load(params) ||
      f413_sensor_params_is_nvm_test_blob(params))
  {
    nvm_params_sensor_defaults(params);
  }
}

static bool f413_wall_sensor_wait_snapshot(f413_wall_sensor_snapshot_t* out, uint32_t timeout_ms)
{
  uint32_t start_ms;

  if (out == NULL)
  {
    return false;
  }

  start_ms = HAL_GetTick();
  do
  {
    if (f413_wall_sensor_read_snapshot(out))
    {
      return true;
    }
    HAL_Delay(1U);
  } while ((HAL_GetTick() - start_ms) <= timeout_ms);

  return false;
}

static uint16_t f413_wall_sensor_avg_u32(uint32_t sum, uint16_t count)
{
  if (count == 0U)
  {
    return 0U;
  }
  sum /= (uint32_t)count;
  if (sum > 65535U)
  {
    return 65535U;
  }
  return (uint16_t)sum;
}

static void f413_ir_emitters_set(GPIO_PinState fr,
                                 GPIO_PinState r,
                                 GPIO_PinState fl,
                                 GPIO_PinState l)
{
  HAL_GPIO_WritePin(IR_FR_GPIO_Port, IR_FR_Pin, fr);
  HAL_GPIO_WritePin(IR_R_GPIO_Port, IR_R_Pin, r);
  HAL_GPIO_WritePin(IR_FL_GPIO_Port, IR_FL_Pin, fl);
  HAL_GPIO_WritePin(IR_L_GPIO_Port, IR_L_Pin, l);
}

bool f413_wall_sensor_start_async(void)
{
  f413_wall_sensor_load_params();
  g_wall_sensor_adc_phase = 0U;
  g_wall_sensor_adc_inflight = 0U;
  g_wall_sensor_ready_mask = 0U;
  memset((void*)g_wall_adc_dma_off, 0, sizeof(g_wall_adc_dma_off));
  memset((void*)g_wall_adc_dma_on, 0, sizeof(g_wall_adc_dma_on));
  memset((void*)&g_wall_sensor_completed, 0, sizeof(g_wall_sensor_completed));
  g_wall_sensor_publish_guard = 0U;
  f413_ir_emitters_set(GPIO_PIN_RESET, GPIO_PIN_RESET, GPIO_PIN_RESET, GPIO_PIN_RESET);
  return HAL_TIM_Base_Start_IT(&htim6) == HAL_OK;
}

bool f413_wall_sensor_pause_async(void)
{
  HAL_StatusTypeDef timer_status = HAL_TIM_Base_Stop_IT(&htim6);

  (void)HAL_ADC_Stop_DMA(&hadc1);
  g_wall_sensor_adc_inflight = 0U;
  g_wall_sensor_adc_phase = 0U;
  f413_ir_emitters_set(GPIO_PIN_RESET, GPIO_PIN_RESET, GPIO_PIN_RESET, GPIO_PIN_RESET);
  return timer_status == HAL_OK;
}

bool f413_wall_sensor_resume_async(void)
{
  g_wall_sensor_adc_inflight = 0U;
  g_wall_sensor_adc_phase = 0U;
  f413_ir_emitters_set(GPIO_PIN_RESET, GPIO_PIN_RESET, GPIO_PIN_RESET, GPIO_PIN_RESET);
  return HAL_TIM_Base_Start_IT(&htim6) == HAL_OK;
}

bool f413_wall_sensor_read_snapshot(f413_wall_sensor_snapshot_t* out)
{
  uint32_t guard_before;
  uint32_t guard_after;

  if (out == NULL)
  {
    return false;
  }
  if ((g_wall_sensor_ready_mask & 0x03U) != 0x03U)
  {
    return false;
  }

  do
  {
    guard_before = g_wall_sensor_publish_guard;
    if ((guard_before & 1U) != 0U)
    {
      continue;
    }
    __DMB();
    memcpy(out, (const void*)&g_wall_sensor_completed, sizeof(*out));
    __DMB();
    guard_after = g_wall_sensor_publish_guard;
  } while ((guard_before != guard_after) || ((guard_after & 1U) != 0U));

  return out->sample_sequence != 0U;
}

bool f413_wall_sensor_read_average(f413_wall_sensor_average_t* out,
                                   uint16_t sample_count,
                                   uint32_t sample_interval_ms,
                                   uint32_t timeout_ms)
{
  f413_wall_sensor_snapshot_t sample;
  uint64_t sum_fr_off = 0U, sum_r_off = 0U, sum_fl_off = 0U, sum_l_off = 0U;
  uint64_t sum_fr_on = 0U, sum_r_on = 0U, sum_fl_on = 0U, sum_l_on = 0U;
  uint64_t sum_vbat = 0U;
  double mean_fr = 0.0, mean_r = 0.0, mean_fl = 0.0, mean_l = 0.0;
  double m2_fr = 0.0, m2_r = 0.0, m2_fl = 0.0, m2_l = 0.0;
  uint32_t last_sequence = 0U;
  uint32_t start_ms;
  bool saturated = false;

  if ((out == NULL) || (sample_count == 0U))
  {
    return false;
  }

  memset(out, 0, sizeof(*out));
  start_ms = HAL_GetTick();
  while (out->sample_count < sample_count)
  {
    uint16_t n;
    double delta;

    if ((HAL_GetTick() - start_ms) > timeout_ms)
    {
      out->elapsed_ms = HAL_GetTick() - start_ms;
      return false;
    }
    if (!f413_wall_sensor_read_snapshot(&sample) ||
        (sample.sample_sequence == last_sequence))
    {
      HAL_Delay(1U);
      continue;
    }

    last_sequence = sample.sample_sequence;
    n = (uint16_t)(out->sample_count + 1U);
    out->sample_count = n;
    sum_fr_off += sample.fr_off;
    sum_r_off += sample.r_off;
    sum_fl_off += sample.fl_off;
    sum_l_off += sample.l_off;
    sum_fr_on += sample.fr_on;
    sum_r_on += sample.r_on;
    sum_fl_on += sample.fl_on;
    sum_l_on += sample.l_on;
    sum_vbat += sample.vbat_off;
    saturated = saturated || sample.saturated;

#define F413_WALL_SENSOR_ACCUM(value, mean, m2) \
    do { \
      delta = (double)(value) - (mean); \
      (mean) += delta / (double)n; \
      (m2) += delta * ((double)(value) - (mean)); \
    } while (0)
    F413_WALL_SENSOR_ACCUM(sample.fr_delta, mean_fr, m2_fr);
    F413_WALL_SENSOR_ACCUM(sample.r_delta, mean_r, m2_r);
    F413_WALL_SENSOR_ACCUM(sample.fl_delta, mean_fl, m2_fl);
    F413_WALL_SENSOR_ACCUM(sample.l_delta, mean_l, m2_l);
#undef F413_WALL_SENSOR_ACCUM

    if (n == 1U)
    {
      out->fr_delta_min = out->fr_delta_max = sample.fr_delta;
      out->r_delta_min = out->r_delta_max = sample.r_delta;
      out->fl_delta_min = out->fl_delta_max = sample.fl_delta;
      out->l_delta_min = out->l_delta_max = sample.l_delta;
    }
    else
    {
      if (sample.fr_delta < out->fr_delta_min) out->fr_delta_min = sample.fr_delta;
      if (sample.r_delta < out->r_delta_min) out->r_delta_min = sample.r_delta;
      if (sample.fl_delta < out->fl_delta_min) out->fl_delta_min = sample.fl_delta;
      if (sample.l_delta < out->l_delta_min) out->l_delta_min = sample.l_delta;
      if (sample.fr_delta > out->fr_delta_max) out->fr_delta_max = sample.fr_delta;
      if (sample.r_delta > out->r_delta_max) out->r_delta_max = sample.r_delta;
      if (sample.fl_delta > out->fl_delta_max) out->fl_delta_max = sample.fl_delta;
      if (sample.l_delta > out->l_delta_max) out->l_delta_max = sample.l_delta;
    }

    if (sample_interval_ms != 0U)
    {
      HAL_Delay(sample_interval_ms);
    }
  }

  out->elapsed_ms = HAL_GetTick() - start_ms;
  out->mean.sample_sequence = last_sequence;
#define F413_WALL_SENSOR_MEAN_U16(sum) ((uint16_t)(((sum) + (sample_count / 2U)) / sample_count))
  out->mean.fr_off = F413_WALL_SENSOR_MEAN_U16(sum_fr_off);
  out->mean.r_off = F413_WALL_SENSOR_MEAN_U16(sum_r_off);
  out->mean.fl_off = F413_WALL_SENSOR_MEAN_U16(sum_fl_off);
  out->mean.l_off = F413_WALL_SENSOR_MEAN_U16(sum_l_off);
  out->mean.vbat_off = F413_WALL_SENSOR_MEAN_U16(sum_vbat);
  out->mean.fr_on = F413_WALL_SENSOR_MEAN_U16(sum_fr_on);
  out->mean.r_on = F413_WALL_SENSOR_MEAN_U16(sum_r_on);
  out->mean.fl_on = F413_WALL_SENSOR_MEAN_U16(sum_fl_on);
  out->mean.l_on = F413_WALL_SENSOR_MEAN_U16(sum_l_on);
  out->mean.vbat_on = out->mean.vbat_off;
#undef F413_WALL_SENSOR_MEAN_U16
  out->mean.fr_delta = (int32_t)(mean_fr + 0.5);
  out->mean.r_delta = (int32_t)(mean_r + 0.5);
  out->mean.fl_delta = (int32_t)(mean_fl + 0.5);
  out->mean.l_delta = (int32_t)(mean_l + 0.5);
  out->mean.front_wall = (out->mean.fr_delta > WALL_BASE_FR) ||
                         (out->mean.fl_delta > WALL_BASE_FL);
  out->mean.right_wall = out->mean.r_delta > WALL_BASE_R;
  out->mean.left_wall = out->mean.l_delta > WALL_BASE_L;
  out->mean.saturated = saturated;

  if (sample_count > 1U)
  {
    double denominator = (double)(sample_count - 1U);
    out->fr_delta_stddev = (float)sqrt(m2_fr / denominator);
    out->r_delta_stddev = (float)sqrt(m2_r / denominator);
    out->fl_delta_stddev = (float)sqrt(m2_fl / denominator);
    out->l_delta_stddev = (float)sqrt(m2_l / denominator);
  }
  return true;
}

bool f413_wall_sensor_read_adc_raw(uint16_t* fr, uint16_t* r, uint16_t* fl, uint16_t* l, uint16_t* vbat)
{
  if ((fr == NULL) || (r == NULL) || (fl == NULL) || (l == NULL) || (vbat == NULL))
  {
    return false;
  }

  if ((g_wall_sensor_ready_mask & 0x03U) != 0x03U)
  {
    return false;
  }

  *fr = g_wall_adc_fr;
  *r = g_wall_adc_r;
  *fl = g_wall_adc_fl;
  *l = g_wall_adc_l;
  *vbat = g_wall_adc_vbat;
  return true;
}

void f413_wall_sensor_get_control_base(uint16_t* base_l, uint16_t* base_r, uint16_t* base_f)
{
  if (base_l != NULL)
  {
    *base_l = g_wall_base_l;
  }
  if (base_r != NULL)
  {
    *base_r = g_wall_base_r;
  }
  if (base_f != NULL)
  {
    *base_f = g_wall_base_f;
  }
}

HAL_StatusTypeDef f413_wall_sensor_calibrate_offsets_and_save(uint16_t sample_count,
                                                              uint32_t sample_interval_ms,
                                                              nvm_sensor_params_t* saved)
{
  nvm_sensor_params_t params;
  f413_wall_sensor_snapshot_t wall;
  uint32_t sum_r = 0U;
  uint32_t sum_l = 0U;
  uint32_t sum_fr = 0U;
  uint32_t sum_fl = 0U;
  HAL_StatusTypeDef st;

  if (sample_count == 0U)
  {
    return HAL_ERROR;
  }

  f413_wall_sensor_load_edit_params(&params);

  for (uint16_t i = 0U; i < sample_count; i++)
  {
    int32_t dr;
    int32_t dl;
    int32_t dfr;
    int32_t dfl;

    if (!f413_wall_sensor_wait_snapshot(&wall, 200U))
    {
      return HAL_TIMEOUT;
    }

    dr = (int32_t)wall.r_on - (int32_t)wall.r_off;
    dl = (int32_t)wall.l_on - (int32_t)wall.l_off;
    dfr = (int32_t)wall.fr_on - (int32_t)wall.fr_off;
    dfl = (int32_t)wall.fl_on - (int32_t)wall.fl_off;

    sum_r += (uint32_t)((dr > 0) ? dr : 0);
    sum_l += (uint32_t)((dl > 0) ? dl : 0);
    sum_fr += (uint32_t)((dfr > 0) ? dfr : 0);
    sum_fl += (uint32_t)((dfl > 0) ? dfl : 0);
    f413_hw_show_led_blink(F413_HW_LED_REAR_RIGHT_MASK,
                           HAL_GetTick(),
                           F413_HW_LED_BLINK_TOGGLE_MS);
    HAL_Delay(sample_interval_ms);
  }

  params.wall_offset_r = f413_wall_sensor_avg_u32(sum_r, sample_count);
  params.wall_offset_l = f413_wall_sensor_avg_u32(sum_l, sample_count);
  params.wall_offset_fr = f413_wall_sensor_avg_u32(sum_fr, sample_count);
  params.wall_offset_fl = f413_wall_sensor_avg_u32(sum_fl, sample_count);

  st = nvm_params_sensor_save(&params);
  if (st == HAL_OK)
  {
    f413_wall_sensor_apply_saved_params(&params);
    if (saved != NULL)
    {
      *saved = params;
    }
  }
  return st;
}

HAL_StatusTypeDef f413_wall_sensor_calibrate_side_base_and_save(uint16_t sample_count,
                                                                uint32_t sample_interval_ms,
                                                                nvm_sensor_params_t* saved)
{
  nvm_sensor_params_t params;
  f413_wall_sensor_snapshot_t wall;
  uint32_t sum_l = 0U;
  uint32_t sum_r = 0U;
  uint32_t sum_f = 0U;
  HAL_StatusTypeDef st;

  if (sample_count == 0U)
  {
    return HAL_ERROR;
  }

  f413_wall_sensor_load_edit_params(&params);

  for (uint16_t i = 0U; i < sample_count; i++)
  {
    if (!f413_wall_sensor_wait_snapshot(&wall, 200U))
    {
      return HAL_TIMEOUT;
    }

    sum_l += (uint32_t)((wall.l_delta > 0) ? wall.l_delta : 0);
    sum_r += (uint32_t)((wall.r_delta > 0) ? wall.r_delta : 0);
    sum_f += (uint32_t)((wall.fl_delta > 0) ? wall.fl_delta : 0);
    sum_f += (uint32_t)((wall.fr_delta > 0) ? wall.fr_delta : 0);
    f413_hw_show_led_blink(F413_HW_LED_REAR_RIGHT_MASK,
                           HAL_GetTick(),
                           F413_HW_LED_BLINK_TOGGLE_MS);
    HAL_Delay(sample_interval_ms);
  }

  params.base_l = f413_wall_sensor_avg_u32(sum_l, sample_count);
  params.base_r = f413_wall_sensor_avg_u32(sum_r, sample_count);
  params.base_f = f413_wall_sensor_avg_u32(sum_f, sample_count);

  st = nvm_params_sensor_save(&params);
  if (st == HAL_OK)
  {
    f413_wall_sensor_apply_saved_params(&params);
    if (saved != NULL)
    {
      *saved = params;
    }
  }
  return st;
}

void f413_wall_sensor_get_debug_state(uint16_t* off_r,
                                      uint16_t* off_l,
                                      uint16_t* off_fr,
                                      uint16_t* off_fl,
                                      uint8_t* ready_mask,
                                      uint8_t* phase,
                                      uint8_t* inflight)
{
  if (off_r != NULL)
  {
    *off_r = g_wall_offset_r;
  }
  if (off_l != NULL)
  {
    *off_l = g_wall_offset_l;
  }
  if (off_fr != NULL)
  {
    *off_fr = g_wall_offset_fr;
  }
  if (off_fl != NULL)
  {
    *off_fl = g_wall_offset_fl;
  }
  if (ready_mask != NULL)
  {
    *ready_mask = g_wall_sensor_ready_mask;
  }
  if (phase != NULL)
  {
    *phase = g_wall_sensor_adc_phase;
  }
  if (inflight != NULL)
  {
    *inflight = g_wall_sensor_adc_inflight;
  }
}

void f413_wall_sensor_tim6_tick(void)
{
  HAL_StatusTypeDef st = HAL_OK;
  uint8_t start_dma = 0U;

  if (g_wall_sensor_adc_inflight != 0U)
  {
    return;
  }

  switch (g_wall_sensor_adc_phase & 0x07U)
  {
    case 0U:
      HAL_GPIO_WritePin(IR_R_GPIO_Port, IR_R_Pin, GPIO_PIN_RESET);
      HAL_GPIO_WritePin(IR_L_GPIO_Port, IR_L_Pin, GPIO_PIN_RESET);
      break;
    case 1U:
      st = f413_wall_sensor_adc_dma_start(g_wall_adc_dma_off);
      start_dma = 1U;
      break;
    case 2U:
      HAL_GPIO_WritePin(IR_R_GPIO_Port, IR_R_Pin, GPIO_PIN_SET);
      HAL_GPIO_WritePin(IR_L_GPIO_Port, IR_L_Pin, GPIO_PIN_SET);
      break;
    case 3U:
      st = f413_wall_sensor_adc_dma_start(g_wall_adc_dma_on);
      start_dma = 1U;
      break;
    case 4U:
      HAL_GPIO_WritePin(IR_FR_GPIO_Port, IR_FR_Pin, GPIO_PIN_RESET);
      HAL_GPIO_WritePin(IR_FL_GPIO_Port, IR_FL_Pin, GPIO_PIN_RESET);
      break;
    case 5U:
      st = f413_wall_sensor_adc_dma_start(g_wall_adc_dma_off);
      start_dma = 1U;
      break;
    case 6U:
      HAL_GPIO_WritePin(IR_FR_GPIO_Port, IR_FR_Pin, GPIO_PIN_SET);
      HAL_GPIO_WritePin(IR_FL_GPIO_Port, IR_FL_Pin, GPIO_PIN_SET);
      break;
    case 7U:
      st = f413_wall_sensor_adc_dma_start(g_wall_adc_dma_on);
      start_dma = 1U;
      break;
    default:
      g_wall_sensor_adc_phase = 0U;
      break;
  }

  if ((start_dma != 0U) && (st == HAL_OK))
  {
    g_wall_sensor_adc_inflight = 1U;
  }
  else if (start_dma == 0U)
  {
    g_wall_sensor_adc_phase = (uint8_t)((g_wall_sensor_adc_phase + 1U) & 0x07U);
  }
}

void f413_wall_sensor_adc_complete(ADC_HandleTypeDef* hadc)
{
  if ((hadc == NULL) || (hadc->Instance != ADC1))
  {
    return;
  }

  switch (g_wall_sensor_adc_phase & 0x07U)
  {
    case 3U:
    {
      uint16_t r_off = (uint16_t)(((uint32_t)g_wall_adc_dma_off[0] + (uint32_t)g_wall_adc_dma_off[2]) / 2U);
      uint16_t l_off = (uint16_t)(((uint32_t)g_wall_adc_dma_off[1] + (uint32_t)g_wall_adc_dma_off[3]) / 2U);
      uint16_t r_on = (uint16_t)(((uint32_t)g_wall_adc_dma_on[0] + (uint32_t)g_wall_adc_dma_on[2]) / 2U);
      uint16_t l_on = (uint16_t)(((uint32_t)g_wall_adc_dma_on[1] + (uint32_t)g_wall_adc_dma_on[3]) / 2U);

      g_wall_adc_r_off = r_off;
      g_wall_adc_l_off = l_off;
      g_wall_adc_r_raw = r_on;
      g_wall_adc_l_raw = l_on;
      g_wall_adc_r = f413_wall_sensor_subtract_u16(r_on, r_off, g_wall_offset_r);
      g_wall_adc_l = f413_wall_sensor_subtract_u16(l_on, l_off, g_wall_offset_l);
      HAL_GPIO_WritePin(IR_R_GPIO_Port, IR_R_Pin, GPIO_PIN_RESET);
      HAL_GPIO_WritePin(IR_L_GPIO_Port, IR_L_Pin, GPIO_PIN_RESET);
      g_wall_sensor_ready_mask |= 0x01U;
      break;
    }
    case 7U:
    {
      uint16_t fr_off = (uint16_t)(((uint32_t)g_wall_adc_dma_off[4] + (uint32_t)g_wall_adc_dma_off[6]) / 2U);
      uint16_t fl_off = (uint16_t)(((uint32_t)g_wall_adc_dma_off[5] + (uint32_t)g_wall_adc_dma_off[7]) / 2U);
      uint16_t fr_on = (uint16_t)(((uint32_t)g_wall_adc_dma_on[4] + (uint32_t)g_wall_adc_dma_on[6]) / 2U);
      uint16_t fl_on = (uint16_t)(((uint32_t)g_wall_adc_dma_on[5] + (uint32_t)g_wall_adc_dma_on[7]) / 2U);

      g_wall_adc_fr_off = fr_off;
      g_wall_adc_fl_off = fl_off;
      g_wall_adc_fr_raw = fr_on;
      g_wall_adc_fl_raw = fl_on;
      g_wall_adc_fr = f413_wall_sensor_subtract_u16(fr_on, fr_off, g_wall_offset_fr);
      g_wall_adc_fl = f413_wall_sensor_subtract_u16(fl_on, fl_off, g_wall_offset_fl);
      g_wall_adc_vbat = g_wall_adc_dma_off[8];
      HAL_GPIO_WritePin(IR_FR_GPIO_Port, IR_FR_Pin, GPIO_PIN_RESET);
      HAL_GPIO_WritePin(IR_FL_GPIO_Port, IR_FL_Pin, GPIO_PIN_RESET);
      g_wall_sensor_ready_mask |= 0x02U;
      f413_wall_sensor_publish_completed();
      break;
    }
    default:
      break;
  }

  g_wall_sensor_adc_inflight = 0U;
  g_wall_sensor_adc_phase = (uint8_t)((g_wall_sensor_adc_phase + 1U) & 0x07U);
}
