xfa273/nightfall-fw/platform/stm32f413/HM_Nightfall_f413_preorder/Core/Inc/f413_control.h

/**
 * @file f413_control.h
 * @brief F413 最小限クローズドループ速度/角速度制御
 *
 * TIM5 1kHz 割り込みでエンコーダを読み取り、P制御で
 * TIM2 (モータPWM) を駆動する。
 */

#ifndef F413_CONTROL_H_
#define F413_CONTROL_H_

#include <stdbool.h>
#include <stdint.h>

#define F413_CTRL_TUNE_AXIS_VELOCITY  (0U)
#define F413_CTRL_TUNE_AXIS_OMEGA     (1U)
#define F413_CTRL_TUNE_AXIS_DISTANCE  (2U)
#define F413_CTRL_TUNE_AXIS_ANGLE     (3U)

#define F413_CTRL_TUNE_PATTERN_STEP      (0U)
#define F413_CTRL_TUNE_PATTERN_TRIANGLE  (1U)
#define F413_CTRL_TUNE_PATTERN_TRAPEZOID (2U)

#ifdef __cplusplus
extern "C" {
#endif

/* 初期化（TIM5割り込み開始） — main初期化後に1回呼ぶ */
void f413_ctrl_init(void);

/* 制御開始/停止。startはPWMを開始してMOTOR_STBYを上げるため、走行前信号の完了後に呼ぶ。 */
void f413_ctrl_start(void);
void f413_ctrl_stop(void);

/* 目標値設定（走行中に随時呼ぶ） */
void f413_ctrl_set_velocity(float velocity_mm_s);
/* Clear pushing effort before wall recovery; preserve odometry and IMU state. */
void f413_ctrl_clear_velocity_feedback(void);
void f413_ctrl_set_velocity_profile(float start_velocity_mm_s,
                                    float target_velocity_mm_s,
                                    float distance_mm);
bool f413_ctrl_stop_profile_complete(void);
void f413_ctrl_set_omega(float omega_deg_s);
void f413_ctrl_start_omega_profile(float signed_omega_peak_deg_s,
                                   float accel_time_s,
                                   float cruise_time_s);
void f413_ctrl_stop_omega_profile(void);
void f413_ctrl_set_angle_target(float angle_deg);
void f413_ctrl_clear_angle_target(void);
void f413_ctrl_set_heading_omega_correction(float omega_deg_s);
void f413_ctrl_tune_start(uint8_t axis, uint8_t set, uint8_t pattern);
void f413_ctrl_tune_stop(void);
bool f413_ctrl_tune_is_active(void);
bool f413_ctrl_tune_is_done(void);
void f413_ctrl_tune_clear_done(void);
uint8_t f413_ctrl_tune_get_axis(void);
uint8_t f413_ctrl_tune_get_set(void);
uint8_t f413_ctrl_tune_get_pattern(void);
float f413_ctrl_tune_get_reference(void);

/* 累積量取得 */
float f413_ctrl_get_distance(void);
float f413_ctrl_get_angle(void);

/* 累積量リセット */
void f413_ctrl_reset_distance(void);
void f413_ctrl_reset_angle(void);

/* 実測値取得（デバッグ/ログ用） */
float f413_ctrl_get_real_velocity(void);
float f413_ctrl_get_real_omega(void);
float f413_ctrl_get_log_angle(void);
float f413_ctrl_get_log_real_omega(void);
float f413_ctrl_get_target_distance(void);
float f413_ctrl_get_target_velocity(void);
float f413_ctrl_get_target_omega(void);
float f413_ctrl_get_target_angle(void);
float f413_ctrl_get_accel_velocity(void);
float f413_ctrl_get_accel_forward(void);
float f413_ctrl_get_gyro_z_raw(void);
uint16_t f413_ctrl_get_velocity_accel_comp_window_ms(void);
bool f413_ctrl_velocity_accel_comp_control_enabled(void);
bool f413_ctrl_velocity_accel_comp_turn_control_enabled(void);
int16_t f413_ctrl_get_motor_out_l(void);
int16_t f413_ctrl_get_motor_out_r(void);
int16_t f413_ctrl_get_log_encoder_delta_l(void);
int16_t f413_ctrl_get_log_encoder_delta_r(void);
bool f413_ctrl_angle_target_enabled(void);

/* 1kHz 割り込みハンドラ（HAL_TIM_PeriodElapsedCallback から呼ぶ） */
void f413_ctrl_tick(void);

/* 制御が有効かどうか */
bool f413_ctrl_is_running(void);

/* SPI2 バス排他: 割り込みコンテキストの IMU 読取中は true を返す。
   メインループ側の FRAM 操作はこれが false の間のみ安全。 */
bool f413_ctrl_spi2_busy(void);

#ifdef __cplusplus
}
#endif

#endif /* F413_CONTROL_H_ */
