xfa273/nightfall-fw/platform/stm32f405/Core/Src/logging.c

#include "global.h"
#include "interrupt.h"
#include "logging.h"
#include "build_info.h"
#include "stdio.h"

// 現在のログプロファイル（取得内容の切替）
static volatile LogProfile s_log_profile = LOG_PROFILE_OMEGA;

static const char *s_mm_columns_velocity = "timestamp,velocity_interrupt,real_velocity,p_term_velocity,i_term_velocity,d_term_velocity,out_r,out_l";
static const char *s_mm_columns_distance = "timestamp,target_distance,real_distance,p_term_distance,i_term_distance,d_term_distance,out_r,out_l";
static const char *s_mm_columns_omega = "timestamp,omega_interrupt,real_omega,p_term_omega,i_term_omega,d_term_omega,out_r,out_l";
static const char *s_mm_columns_angle = "timestamp,target_angle,real_angle,p_term_angle,i_term_angle,d_term_angle,out_r,out_l";
static const char *s_mm_columns_noise = "timestamp,omega_z_raw,encoder_speed_l_raw,encoder_speed_r_raw,real_velocity_lpf,real_omega_lpf,dummy2,dummy3";

static void log_print_fw_meta(void) {
    printf("#fw_version=%s\n", FW_VERSION);
    printf("#params_tune_version=%s\n", PARAMS_TUNE_VERSION);
    printf("#fw_target=%s\n", FW_TARGET);
    printf("#fw_build_type=%s\n", FW_BUILD_TYPE);
    printf("#fw_build_time_utc=%s\n", FW_BUILD_TIME_UTC);
    printf("#fw_git_describe=%s\n", FW_GIT_DESCRIBE);
    printf("#fw_git_sha=%s\n", FW_GIT_SHA);
    printf("#fw_git_branch=%s\n", FW_GIT_BRANCH);
    printf("#fw_git_dirty=%d\n", (int)FW_GIT_DIRTY);
}

static void log_print_mm_columns(const char *cols) {
    printf("#mm_columns=%s\n", cols);
}

void log_set_profile(LogProfile profile) { s_log_profile = profile; }

// 速度ログ（log_buffer）をCSV出力
void log_print_velocity_all(void) {
    printf("=== Micromouse Log Data (CSV Format, VELOCITY) ===\n");
    printf("Total entries: %d\n", log_buffer.count);
    printf("CSV Format: timestamp,param1,param2,param3,param4,param5,param6,param7\n");
    printf("--- CSV Data Start ---\n");
    log_print_fw_meta();
    log_print_mm_columns(s_mm_columns_velocity);

    uint16_t count = log_buffer.count > MAX_LOG_ENTRIES ? MAX_LOG_ENTRIES : log_buffer.count;
    uint16_t start = log_buffer.count > MAX_LOG_ENTRIES ? log_buffer.head : 0;

    for (uint16_t i = 0; i < count; i++) {
        uint16_t idx = (start + i) % MAX_LOG_ENTRIES;
        volatile LogEntry *entry = &log_buffer.entries[idx];
        printf("%lu,%.3f,%.3f,%.3f,%.3f,%.3f,%.3f,%.3f\n",
               entry->timestamp - log_buffer.start_time,
               entry->target_omega,
               entry->actual_omega,
               entry->p_term_omega,
               entry->i_term_omega,
               entry->d_term_omega,
               entry->motor_out_r,
               entry->motor_out_l);
    }

    printf("--- CSV Data End ---\n");
    printf("=== End of Log ===\n");
}

void log_print_noise_all(void) {
    printf("=== Micromouse Log Data (CSV Format, NOISE) ===\n");
    printf("Total entries: %d\n", log_buffer.count);
    printf("CSV Format: timestamp,param1,param2,param3,param4,param5,param6,param7\n");
    printf("--- CSV Data Start ---\n");
    log_print_fw_meta();
    log_print_mm_columns(s_mm_columns_noise);

    uint16_t count = log_buffer.count > MAX_LOG_ENTRIES ? MAX_LOG_ENTRIES : log_buffer.count;
    uint16_t start = log_buffer.count > MAX_LOG_ENTRIES ? log_buffer.head : 0;

    for (uint16_t i = 0; i < count; i++) {
        uint16_t idx = (start + i) % MAX_LOG_ENTRIES;
        volatile LogEntry *entry = &log_buffer.entries[idx];
        printf("%lu,%.3f,%.3f,%.3f,%.3f,%.3f,%.3f,%.3f\n",
               entry->timestamp - log_buffer.start_time,
               entry->target_omega,
               entry->actual_omega,
               entry->p_term_omega,
               entry->i_term_omega,
               entry->d_term_omega,
               entry->motor_out_r,
               entry->motor_out_l);
    }

    printf("--- CSV Data End ---\n");
    printf("=== End of Log ===\n");
}

// 距離ログ（log_buffer2）をCSV出力
void log_print_distance_all(void) {
    printf("=== Micromouse Log Data (CSV Format, DISTANCE) ===\n");
    printf("Total entries: %d\n", log_buffer2.count);
    printf("CSV Format: timestamp,param1,param2,param3,param4,param5,param6,param7\n");
    printf("--- CSV Data Start ---\n");
    log_print_fw_meta();
    log_print_mm_columns(s_mm_columns_distance);

    uint16_t count = log_buffer2.count > MAX_LOG_ENTRIES ? MAX_LOG_ENTRIES : log_buffer2.count;
    uint16_t start = log_buffer2.count > MAX_LOG_ENTRIES ? log_buffer2.head : 0;

    for (uint16_t i = 0; i < count; i++) {
        uint16_t idx = (start + i) % MAX_LOG_ENTRIES;
        volatile LogEntry *entry = &log_buffer2.entries[idx];
        printf("%lu,%.3f,%.3f,%.3f,%.3f,%.3f,%.3f,%.3f\n",
               entry->timestamp - log_buffer2.start_time,
               entry->target_omega,
               entry->actual_omega,
               entry->p_term_omega,
               entry->i_term_omega,
               entry->d_term_omega,
               entry->motor_out_r,
               entry->motor_out_l);
    }

    printf("--- CSV Data End ---\n");
    printf("=== End of Log ===\n");
}

// 角速度ログ（log_buffer）をCSV出力
void log_print_omega_all(void) {
    printf("=== Micromouse Log Data (CSV Format, OMEGA) ===\n");
    printf("Total entries: %d\n", log_buffer.count);
    printf("CSV Format: timestamp,param1,param2,param3,param4,param5,param6,param7\n");
    printf("--- CSV Data Start ---\n");
    log_print_fw_meta();
    log_print_mm_columns(s_mm_columns_omega);

    uint16_t count = log_buffer.count > MAX_LOG_ENTRIES ? MAX_LOG_ENTRIES : log_buffer.count;
    uint16_t start = log_buffer.count > MAX_LOG_ENTRIES ? log_buffer.head : 0;

    for (uint16_t i = 0; i < count; i++) {
        uint16_t idx = (start + i) % MAX_LOG_ENTRIES;
        volatile LogEntry *entry = &log_buffer.entries[idx];
        printf("%lu,%.3f,%.3f,%.3f,%.3f,%.3f,%.3f,%.3f\n",
               entry->timestamp - log_buffer.start_time,
               entry->target_omega,
               entry->actual_omega,
               entry->p_term_omega,
               entry->i_term_omega,
               entry->d_term_omega,
               entry->motor_out_r,
               entry->motor_out_l);
    }

    printf("--- CSV Data End ---\n");
    printf("=== End of Log ===\n");
}

// 角度ログ（log_buffer2）をCSV出力
void log_print_angle_all(void) {
    printf("=== Micromouse Log Data (CSV Format, ANGLE) ===\n");
    printf("Total entries: %d\n", log_buffer2.count);
    printf("CSV Format: timestamp,param1,param2,param3,param4,param5,param6,param7\n");
    printf("--- CSV Data Start ---\n");
    log_print_fw_meta();
    log_print_mm_columns(s_mm_columns_angle);

    uint16_t count = log_buffer2.count > MAX_LOG_ENTRIES ? MAX_LOG_ENTRIES : log_buffer2.count;
    uint16_t start = log_buffer2.count > MAX_LOG_ENTRIES ? log_buffer2.head : 0;

    for (uint16_t i = 0; i < count; i++) {
        uint16_t idx = (start + i) % MAX_LOG_ENTRIES;
        volatile LogEntry *entry = &log_buffer2.entries[idx];
        printf("%lu,%.3f,%.3f,%.3f,%.3f,%.3f,%.3f,%.3f\n",
               entry->timestamp - log_buffer2.start_time,
               entry->target_omega,
               entry->actual_omega,
               entry->p_term_omega,
               entry->i_term_omega,
               entry->d_term_omega,
               entry->motor_out_r,
               entry->motor_out_l);
    }

    printf("--- CSV Data End ---\n");
    printf("=== End of Log ===\n");
}

LogProfile log_get_profile(void) { return s_log_profile; }

/**
 * @brief ロギングシステムを初期化する
 */
void log_init(void) {
    // 速度/角速度 等（主）
    log_buffer.head = 0;
    log_buffer.count = 0;
    log_buffer.logging_active = 0;
    log_buffer.start_time = 0;

    // 距離/角度 等（副）
    log_buffer2.head = 0;
    log_buffer2.count = 0;
    log_buffer2.logging_active = 0;
    log_buffer2.start_time = 0;
}

/**
 * @brief 現在のプロファイルに基づいて1サンプル分のログを記録する（割り込みから呼ぶ）
 * @note 取得する変数は後で編集予定のため、現状は既存(角速度系)の内容を各プロファイルで共通に記録
 */
void log_capture_tick(void) {
    if (!log_buffer.logging_active) {
        return;
    }

    uint32_t current_time = HAL_GetTick();

    switch (s_log_profile) {

    case LOG_PROFILE_OMEGA:
        // 角速度（主バッファ）
        {
            const bool use_fan_on_gains = drive_use_fan_on_gains();
            const float kp_o = use_fan_on_gains ? KP_OMEGA_FAN_ON : KP_OMEGA_FAN_OFF;
            const float ki_o = use_fan_on_gains ? KI_OMEGA_FAN_ON : KI_OMEGA_FAN_OFF;
            const float kd_o = use_fan_on_gains ? KD_OMEGA_FAN_ON : KD_OMEGA_FAN_OFF;
            log_add_entry(
                (uint16_t)log_buffer.count,
                omega_interrupt,
                real_omega,
                kp_o * omega_error,
                ki_o * omega_integral,
                kd_o * omega_error_error,
                (float)out_r,
                (float)out_l,
                current_time
            );
        }
        // 角度（副バッファ）
        if (log_buffer2.logging_active && log_buffer2.count < MAX_LOG_ENTRIES) {
            uint16_t pos2 = log_buffer2.head;
            log_buffer2.entries[pos2].count = (uint16_t)log_buffer2.count;
            // フィールド名は共通だが、角度系を格納する
            log_buffer2.entries[pos2].target_omega = target_angle; // 目標角度
            log_buffer2.entries[pos2].actual_omega = real_angle;   // 実角度
            const bool use_fan_on_gains = drive_use_fan_on_gains();
            const float kp_a = use_fan_on_gains ? KP_ANGLE_FAN_ON : KP_ANGLE_FAN_OFF;
            const float ki_a = use_fan_on_gains ? KI_ANGLE_FAN_ON : KI_ANGLE_FAN_OFF;
            const float kd_a = use_fan_on_gains ? KD_ANGLE_FAN_ON : KD_ANGLE_FAN_OFF;
            log_buffer2.entries[pos2].p_term_omega = kp_a * angle_error;
            log_buffer2.entries[pos2].i_term_omega = ki_a * angle_integral;
            log_buffer2.entries[pos2].d_term_omega = kd_a * angle_error_error;
            log_buffer2.entries[pos2].motor_out_r = (float)out_r;
            log_buffer2.entries[pos2].motor_out_l = (float)out_l;
            log_buffer2.entries[pos2].timestamp = current_time;
            log_buffer2.head = (pos2 + 1) % MAX_LOG_ENTRIES;
            log_buffer2.count++;
        }
        break;

    case LOG_PROFILE_VELOCITY:
        // 並進速度（主バッファ）
        {
            const bool use_fan_on_gains = drive_use_fan_on_gains();
            const float kp_v = use_fan_on_gains ? KP_VELOCITY_FAN_ON : KP_VELOCITY_FAN_OFF;
            const float ki_v = use_fan_on_gains ? KI_VELOCITY_FAN_ON : KI_VELOCITY_FAN_OFF;
            const float kd_v = use_fan_on_gains ? KD_VELOCITY_FAN_ON : KD_VELOCITY_FAN_OFF;
            log_add_entry(
                (uint16_t)log_buffer.count,
                velocity_interrupt,
                real_velocity,
                kp_v * velocity_error,
                ki_v * velocity_integral,
                kd_v * velocity_error_error,
                (float)out_r,
                (float)out_l,
                current_time
            );
        }

        // 並進距離（副バッファ）
        if (log_buffer2.logging_active && log_buffer2.count < MAX_LOG_ENTRIES) {
            uint16_t pos2 = log_buffer2.head;
            log_buffer2.entries[pos2].count = (uint16_t)log_buffer2.count;
            log_buffer2.entries[pos2].target_omega = target_distance;
            log_buffer2.entries[pos2].actual_omega = real_distance;
            const bool use_fan_on_gains = drive_use_fan_on_gains();
            const float kp_d = use_fan_on_gains ? KP_DISTANCE_FAN_ON : KP_DISTANCE_FAN_OFF;
            const float ki_d = use_fan_on_gains ? KI_DISTANCE_FAN_ON : KI_DISTANCE_FAN_OFF;
            const float kd_d = use_fan_on_gains ? KD_DISTANCE_FAN_ON : KD_DISTANCE_FAN_OFF;
            log_buffer2.entries[pos2].p_term_omega = kp_d * distance_error;
            log_buffer2.entries[pos2].i_term_omega = ki_d * distance_integral;
            log_buffer2.entries[pos2].d_term_omega = kd_d * distance_error_error;
            log_buffer2.entries[pos2].motor_out_r = (float)out_r;
            log_buffer2.entries[pos2].motor_out_l = (float)out_l;
            log_buffer2.entries[pos2].timestamp = current_time;
            log_buffer2.head = (pos2 + 1) % MAX_LOG_ENTRIES;
            log_buffer2.count++;
        }
        break;
    
    case LOG_PROFILE_DISTANCE:
        // 並進距離（副バッファ）
        if (log_buffer2.logging_active && log_buffer2.count < MAX_LOG_ENTRIES) {
            uint16_t pos2 = log_buffer2.head;
            log_buffer2.entries[pos2].count = (uint16_t)log_buffer2.count;
            log_buffer2.entries[pos2].target_omega = target_distance;
            log_buffer2.entries[pos2].actual_omega = real_distance;
            const bool use_fan_on_gains = drive_use_fan_on_gains();
            const float kp_d = use_fan_on_gains ? KP_DISTANCE_FAN_ON : KP_DISTANCE_FAN_OFF;
            const float ki_d = use_fan_on_gains ? KI_DISTANCE_FAN_ON : KI_DISTANCE_FAN_OFF;
            const float kd_d = use_fan_on_gains ? KD_DISTANCE_FAN_ON : KD_DISTANCE_FAN_OFF;
            log_buffer2.entries[pos2].p_term_omega = kp_d * distance_error;
            log_buffer2.entries[pos2].i_term_omega = ki_d * distance_integral;
            log_buffer2.entries[pos2].d_term_omega = kd_d * distance_error_error;
            log_buffer2.entries[pos2].motor_out_r = (float)out_r;
            log_buffer2.entries[pos2].motor_out_l = (float)out_l;
            log_buffer2.entries[pos2].timestamp = current_time;
            log_buffer2.head = (pos2 + 1) % MAX_LOG_ENTRIES;
            log_buffer2.count++;
        }
        // 並進速度（主バッファ）も併記しておく（閲覧側でVELOCITYを選ばれても空にならないように）
        {
            const bool use_fan_on_gains = drive_use_fan_on_gains();
            const float kp_v = use_fan_on_gains ? KP_VELOCITY_FAN_ON : KP_VELOCITY_FAN_OFF;
            const float ki_v = use_fan_on_gains ? KI_VELOCITY_FAN_ON : KI_VELOCITY_FAN_OFF;
            const float kd_v = use_fan_on_gains ? KD_VELOCITY_FAN_ON : KD_VELOCITY_FAN_OFF;
            log_add_entry(
                (uint16_t)log_buffer.count,
                velocity_interrupt,
                real_velocity,
                kp_v * velocity_error,
                ki_v * velocity_integral,
                kd_v * velocity_error_error,
                (float)out_r,
                (float)out_l,
                current_time
            );
        }
        break;
    case LOG_PROFILE_CUSTOM:
        {
            log_add_entry(
                (uint16_t)log_buffer.count,
                omega_z_raw,
                encoder_speed_l,
                encoder_speed_r,
                real_velocity,
                real_omega,
                0.0f,
                0.0f,
                current_time
            );
        }
        break;
    default:
        break;
    }
}

/**
 * @brief ロギングを開始する
 * @param start_time 開始時間（ms）
 * @note この関数はMF.FLAG.GET_LOG_1フラグも操作します
 */
void log_start(uint32_t start_time) {
    // 主ログ開始
    log_buffer.head = 0;
    log_buffer.count = 0;
    log_buffer.logging_active = 1;
    log_buffer.start_time = start_time;

    // 副ログ開始
    log_buffer2.head = 0;
    log_buffer2.count = 0;
    log_buffer2.logging_active = 1;
    log_buffer2.start_time = start_time;

    // ロギングフラグを設定
    MF.FLAG.GET_LOG_1 = 1;
    MF.FLAG.GET_LOG_2 = 1;
}

/**
 * @brief ロギングを停止する
 * @note この関数はMF.FLAG.GET_LOG_1フラグも操作します
 */
void log_stop(void) {
    log_buffer.logging_active = 0;
    log_buffer2.logging_active = 0;

    // ロギングフラグをクリア
    MF.FLAG.GET_LOG_1 = 0;
    MF.FLAG.GET_LOG_2 = 0;
}

/**
 * @brief ログにデータを追加する（割り込みハンドラから呼ばれる）
 * @param index サンプルカウント/インデックス
 * @param target_omega 目標角速度
 * @param actual_omega 実際の角速度
 * @param p_term_omega 角速度制御のP項
 * @param i_term_omega 角速度制御のI項
 * @param d_term_omega 角速度制御のD項
 * @param motor_out_r 右モーター出力
 * @param motor_out_l 左モーター出力
 * @param timestamp タイムスタンプ（ms）
 */
void log_add_entry(uint16_t index, float target_omega, float actual_omega,
                  float p_term_omega, float i_term_omega, float d_term_omega,
                  float motor_out_r, float motor_out_l, uint32_t timestamp) {
    
    if (!log_buffer.logging_active || log_buffer.count >= MAX_LOG_ENTRIES) {
        return;
    }
    
    uint16_t position = log_buffer.head;
    
    // データをバッファに格納
    log_buffer.entries[position].count = index;
    log_buffer.entries[position].target_omega = target_omega;
    log_buffer.entries[position].actual_omega = actual_omega;
    log_buffer.entries[position].p_term_omega = p_term_omega;
    log_buffer.entries[position].i_term_omega = i_term_omega;
    log_buffer.entries[position].d_term_omega = d_term_omega;
    log_buffer.entries[position].motor_out_r = motor_out_r;
    log_buffer.entries[position].motor_out_l = motor_out_l;
    log_buffer.entries[position].timestamp = timestamp;
    
    // ヘッドとカウントを更新
    log_buffer.head = (position + 1) % MAX_LOG_ENTRIES;
    log_buffer.count++;
}

/**
 * @brief ログデータをシリアルポートに出力する（micromouse_log_visualizer用CSV形式）
 */
void log_print_all(void) {
    printf("=== Micromouse Log Data (CSV Format) ===\n");
    printf("Total entries: %d\n", log_buffer.count);
    printf("CSV Format: timestamp,target_omega,actual_omega,p_term_omega,i_term_omega,d_term_omega,motor_out_r,motor_out_l\n");
    printf("--- CSV Data Start ---\n");
    
    // CSV形式でデータを出力（micromouse_log_visualizer用）
    // 形式: timestamp,target_omega,actual_omega,p_term_omega,i_term_omega,d_term_omega,motor_out_r,motor_out_l
    
    uint16_t count = log_buffer.count > MAX_LOG_ENTRIES ? MAX_LOG_ENTRIES : log_buffer.count;
    uint16_t start = log_buffer.count > MAX_LOG_ENTRIES ? log_buffer.head : 0;
    
    for (uint16_t i = 0; i < count; i++) {
        uint16_t idx = (start + i) % MAX_LOG_ENTRIES;
        volatile LogEntry *entry = &log_buffer.entries[idx];
        
        // CSV形式: timestamp,param1,param2,param3,param4,param5,param6,param7
        // timestamp = entry->timestamp - log_buffer.start_time (相対時間)
        // param1 = target_omega
        // param2 = actual_omega  
        // param3 = p_term_omega
        // param4 = i_term_omega
        // param5 = d_term_omega
        // param6 = motor_out_r
        // param7 = motor_out_l
        printf("%lu,%.3f,%.3f,%.3f,%.3f,%.3f,%.3f,%.3f\n",
               entry->timestamp - log_buffer.start_time,
               entry->target_omega,
               entry->actual_omega,
               entry->p_term_omega,
               entry->i_term_omega,
               entry->d_term_omega,
               entry->motor_out_r,
               entry->motor_out_l);
    }
    
    printf("--- CSV Data End ---\n");
    printf("=== End of Log ===\n");
}

/**
 * @brief ログデータを純粋なCSV形式で出力する（可視化ツール貼り付け用）
 */
void log_print_csv_only(void) {
    // 純粋なCSVデータのみを出力（説明行なし）
    // 可視化ツールのテキストエリアに直接貼り付け可能
    
    uint16_t count = log_buffer.count > MAX_LOG_ENTRIES ? MAX_LOG_ENTRIES : log_buffer.count;
    uint16_t start = log_buffer.count > MAX_LOG_ENTRIES ? log_buffer.head : 0;
    
    for (uint16_t i = 0; i < count; i++) {
        uint16_t idx = (start + i) % MAX_LOG_ENTRIES;
        volatile LogEntry *entry = &log_buffer.entries[idx];
        
        // CSV形式: timestamp,param1,param2,param3,param4,param5,param6,param7
        // timestampは相対時間（0始まり）
        printf("%lu,%.3f,%.3f,%.3f,%.3f,%.3f,%.3f,%.3f\n",
               entry->timestamp - log_buffer.start_time,
               entry->target_omega,
               entry->actual_omega,
               entry->p_term_omega,
               entry->i_term_omega,
               entry->d_term_omega,
               entry->motor_out_r,
               entry->motor_out_l);
    }
}
