xfa273/nightfall-fw/platform/stm32f413/HM_Nightfall_f413_preorder/Core/Src/f413_path_run.c

#include "f413_path_run.h"

#if (NIGHTFALL_F413_REAL_RUN_PATH_ENABLED != 0U)

#include <math.h>

#include "legacy_path_codec.h"
#include "motion_time.h"
#include "params.h"
#include "shortest_run_params.h"
#include "f413_trace_flags.h"

typedef enum
{
  F413_PATH_RUN_PREFLIGHT_OK = 0,
  F413_PATH_RUN_PREFLIGHT_INVALID_ARGUMENT,
  F413_PATH_RUN_PREFLIGHT_INVALID_LEGACY_PATH,
  F413_PATH_RUN_PREFLIGHT_INFEASIBLE_LINEAR,
  F413_PATH_RUN_PREFLIGHT_SPEED_DISCONTINUITY,
  F413_PATH_RUN_PREFLIGHT_PREPARED_CAPACITY,
} f413_path_run_preflight_status_t;

typedef struct
{
  f413_path_run_preflight_status_t status;
  NfLegacyPathStatus legacy_status;
  size_t index;
  uint16_t code;
} f413_path_run_preflight_result_t;

/*
 * A 16x16 shortest path cannot contain more than 256 distinct linear runs.
 * Keep only the controller inputs needed at execution time instead of the
 * double-precision host plan.  Building nf_motion_linear_plan() while the
 * motors are already running otherwise leaves the preceding velocity command
 * active for several milliseconds on the F413 and changes the physical path.
 */
#define F413_PATH_RUN_MAX_PREPARED_LINEAR_ACTIONS (256U)

typedef struct
{
  uint16_t path_index;
  uint8_t phase_count;
  bool execute_plan;
  float entry_velocity_mm_s;
  float exit_velocity_mm_s;
  float phase_distance_mm[NF_MOTION_LINEAR_MAX_PHASES];
  float phase_exit_velocity_mm_s[NF_MOTION_LINEAR_MAX_PHASES];
} f413_path_run_prepared_linear_t;

typedef struct
{
  f413_path_run_prepared_linear_t actions[F413_PATH_RUN_MAX_PREPARED_LINEAR_ACTIONS];
  size_t count;
  float stop_distance_mm;
} f413_path_run_prepared_path_t;

#if !defined(NIGHTFALL_F413_PATH_LINEAR_PLAN_HOST_TEST) || \
    defined(NIGHTFALL_F413_PATH_DISTANCE_CURSOR_HOST_TEST)
/*
 * The distance controller keeps the preceding velocity active while the main
 * loop changes from one path action to the next.  Starting every following
 * action from the then-current encoder position makes that transition travel
 * additive: several individually small gaps can move a complete path by more
 * than one centimetre.  Keep an absolute endpoint for consecutive straight
 * portions instead.  Any forward travel between calls therefore consumes the
 * following portion rather than extending the path.
 *
 * A timed turn core is intentionally an empirical primitive.  Its measured
 * end position becomes the next cursor origin; only the straight in/out and
 * path-code transition gaps are compensated here.
 */
typedef struct
{
  float endpoint_mm;
  bool active;
} f413_path_run_distance_cursor_t;

static void f413_path_run_distance_cursor_reset(
    f413_path_run_distance_cursor_t* cursor,
    float position_mm)
{
  if (cursor == NULL)
  {
    return;
  }
  cursor->endpoint_mm = position_mm;
  cursor->active = isfinite(position_mm);
}

static void f413_path_run_distance_cursor_invalidate(
    f413_path_run_distance_cursor_t* cursor)
{
  if (cursor != NULL)
  {
    cursor->endpoint_mm = 0.0f;
    cursor->active = false;
  }
}

static bool f413_path_run_distance_cursor_advance(
    f413_path_run_distance_cursor_t* cursor,
    float current_position_mm,
    float requested_distance_mm,
    float* target_position_mm,
    float* remaining_distance_mm)
{
  float remaining;

  if ((cursor == NULL) || !cursor->active ||
      !isfinite(cursor->endpoint_mm) ||
      !isfinite(current_position_mm) ||
      !isfinite(requested_distance_mm) ||
      (requested_distance_mm < 0.0f) ||
      (target_position_mm == NULL) || (remaining_distance_mm == NULL))
  {
    return false;
  }

  cursor->endpoint_mm += requested_distance_mm;
  remaining = cursor->endpoint_mm - current_position_mm;
  *target_position_mm = cursor->endpoint_mm;
  *remaining_distance_mm = (remaining > 0.0f) ? remaining : 0.0f;
  return isfinite(cursor->endpoint_mm) && isfinite(*remaining_distance_mm);
}
#endif

static bool f413_path_run_store_prepared_linear(
    f413_path_run_prepared_path_t* prepared,
    size_t path_index,
    float entry_velocity_mm_s,
    float exit_velocity_mm_s,
    const NfLinearPlan* plan,
    bool execute_plan)
{
  f413_path_run_prepared_linear_t* action;
  size_t phase_index;

  if (prepared == NULL)
  {
    return true;
  }
  if ((prepared->count >= F413_PATH_RUN_MAX_PREPARED_LINEAR_ACTIONS) ||
      (path_index > UINT16_MAX) || !isfinite(entry_velocity_mm_s) ||
      !isfinite(exit_velocity_mm_s) ||
      (execute_plan && ((plan == NULL) ||
                        (plan->phase_count > NF_MOTION_LINEAR_MAX_PHASES))))
  {
    return false;
  }

  action = &prepared->actions[prepared->count];
  action->path_index = (uint16_t)path_index;
  action->phase_count = execute_plan ? (uint8_t)plan->phase_count : 0U;
  action->execute_plan = execute_plan;
  action->entry_velocity_mm_s = entry_velocity_mm_s;
  action->exit_velocity_mm_s = exit_velocity_mm_s;
  for (phase_index = 0U; phase_index < NF_MOTION_LINEAR_MAX_PHASES; phase_index++)
  {
    action->phase_distance_mm[phase_index] = 0.0f;
    action->phase_exit_velocity_mm_s[phase_index] = 0.0f;
  }
  for (phase_index = 0U; phase_index < action->phase_count; phase_index++)
  {
    const double distance_mm = plan->phases[phase_index].distance_mm;
    const double phase_exit_velocity_mm_s =
        plan->phases[phase_index].exit_velocity_mm_s;
    if (!isfinite(distance_mm) || (distance_mm < 0.0) ||
        !isfinite(phase_exit_velocity_mm_s) ||
        (phase_exit_velocity_mm_s < 0.0))
    {
      return false;
    }
    action->phase_distance_mm[phase_index] = (float)distance_mm;
    action->phase_exit_velocity_mm_s[phase_index] =
        (float)phase_exit_velocity_mm_s;
  }
  prepared->count++;
  return true;
}

static bool f413_path_run_make_linear_plan(float distance_mm,
                                            float entry_velocity_mm_s,
                                            float exit_velocity_mm_s,
                                            const NfLinearLimits* limits,
                                            NfLinearPlan* out)
{
  if ((limits == NULL) || (out == NULL) ||
      !isfinite(distance_mm) || (distance_mm <= 0.0f) ||
      !isfinite(entry_velocity_mm_s) || (entry_velocity_mm_s < 0.0f) ||
      !isfinite(exit_velocity_mm_s) || (exit_velocity_mm_s < 0.0f))
  {
    return false;
  }

  return nf_motion_linear_plan(limits,
                               (double)distance_mm,
                               (double)entry_velocity_mm_s,
                               (double)exit_velocity_mm_s,
                               out) == NF_MOTION_OK;
}

static bool f413_path_run_is_straight_code(uint16_t code)
{
  return (code > NF_LEGACY_PATH_STRAIGHT_BASE) &&
         (code <= NF_LEGACY_PATH_STRAIGHT_MAX);
}

static bool f413_path_run_is_diagonal_code(uint16_t code)
{
  return (code > NF_LEGACY_PATH_DIAGONAL_STRAIGHT_BASE) &&
         (code <= NF_LEGACY_PATH_DIAGONAL_STRAIGHT_MAX);
}

static bool f413_path_run_is_small_turn_code(uint16_t code)
{
  return (code == NF_LEGACY_PATH_SMALL_RIGHT_90) ||
         (code == NF_LEGACY_PATH_SMALL_LEFT_90);
}

static bool f413_path_run_is_large_turn_code(uint16_t code)
{
  return (code == NF_LEGACY_PATH_LARGE_RIGHT_90) ||
         (code == NF_LEGACY_PATH_LARGE_RIGHT_180) ||
         (code == NF_LEGACY_PATH_LARGE_LEFT_90) ||
         (code == NF_LEGACY_PATH_LARGE_LEFT_180);
}

static bool f413_path_run_turn_velocity_from_code(
    uint16_t code,
    const ShortestRunModeParams_t* params,
    float* out_velocity_mm_s)
{
  float velocity;

  if ((params == NULL) || (out_velocity_mm_s == NULL))
  {
    return false;
  }
  switch (code)
  {
    case NF_LEGACY_PATH_SMALL_RIGHT_90:
    case NF_LEGACY_PATH_SMALL_LEFT_90:
      velocity = params->velocity_turn90;
      break;
    case NF_LEGACY_PATH_LARGE_RIGHT_90:
    case NF_LEGACY_PATH_LARGE_LEFT_90:
      velocity = params->velocity_l_turn_90;
      break;
    case NF_LEGACY_PATH_LARGE_RIGHT_180:
    case NF_LEGACY_PATH_LARGE_LEFT_180:
      velocity = params->velocity_l_turn_180;
      break;
    case NF_LEGACY_PATH_RIGHT_45_IN:
    case NF_LEGACY_PATH_LEFT_45_IN:
      velocity = params->velocity_turn45in;
      break;
    case NF_LEGACY_PATH_RIGHT_45_OUT:
    case NF_LEGACY_PATH_LEFT_45_OUT:
      velocity = params->velocity_turn45out;
      break;
    case NF_LEGACY_PATH_RIGHT_V90:
    case NF_LEGACY_PATH_LEFT_V90:
      velocity = params->velocity_turnV90;
      break;
    case NF_LEGACY_PATH_RIGHT_135_IN:
    case NF_LEGACY_PATH_LEFT_135_IN:
      velocity = params->velocity_turn135in;
      break;
    case NF_LEGACY_PATH_RIGHT_135_OUT:
    case NF_LEGACY_PATH_LEFT_135_OUT:
      velocity = params->velocity_turn135out;
      break;
    default:
      return false;
  }
  *out_velocity_mm_s = velocity;
  return isfinite(*out_velocity_mm_s) && (*out_velocity_mm_s > 0.0f);
}

/* Isolated turn tests approach and leave at the configured turn speed. A
 * mixed-turn test needs the fastest turn in its sequence. Ordinary shortest
 * paths and straight-only tests retain the case's full straight speeds.
 * Derive this once, before both preflight and execution; never mutate params.
 */
static inline ShortestRunCaseParams_t f413_path_run_session_case_params(
    const uint16_t* codes,
    size_t capacity,
    const ShortestRunModeParams_t* mode_params,
    const ShortestRunCaseParams_t* case_params,
    bool test_mode_run)
{
  ShortestRunCaseParams_t selected = *case_params;
  float turn_speed = 0.0f;
  if (test_mode_run && (codes != NULL))
  {
    for (size_t i = 0U; (i < capacity) && (codes[i] != 0U); i++)
    {
      float velocity;
      if (f413_path_run_turn_velocity_from_code(codes[i], mode_params, &velocity) &&
          (velocity > turn_speed))
      {
        turn_speed = velocity;
      }
    }
  }
  if (turn_speed > 0.0f)
  {
    if (selected.velocity_straight > turn_speed)
    {
      selected.velocity_straight = turn_speed;
    }
    if (selected.velocity_d_straight > turn_speed)
    {
      selected.velocity_d_straight = turn_speed;
    }
  }
  return selected;
}

static bool f413_path_run_straight_limits(
    const ShortestRunModeParams_t* mode_params,
    const ShortestRunCaseParams_t* case_params,
    NfLinearLimits* out)
{
  if ((mode_params == NULL) || (case_params == NULL) || (out == NULL))
  {
    return false;
  }

  out->vmax_mm_s = case_params->velocity_straight;
  out->switch_velocity_mm_s = mode_params->accel_switch_velocity;
  out->accel_low_mm_s2 = case_params->acceleration_straight;
  out->accel_high_mm_s2 = case_params->acceleration_straight_dash;
  return (out->vmax_mm_s > 0.0) && (out->accel_low_mm_s2 > 0.0) &&
         (out->accel_high_mm_s2 > 0.0);
}

static bool f413_path_run_diagonal_limits(
    const ShortestRunModeParams_t* mode_params,
    const ShortestRunCaseParams_t* case_params,
    NfLinearLimits* out)
{
  if ((mode_params == NULL) || (case_params == NULL) || (out == NULL))
  {
    return false;
  }

  out->vmax_mm_s = case_params->velocity_d_straight;
  out->switch_velocity_mm_s = 0.0;
  out->accel_low_mm_s2 = case_params->acceleration_d_straight;
  out->accel_high_mm_s2 = case_params->acceleration_d_straight_dash;
  return (out->vmax_mm_s > 0.0) && (out->accel_high_mm_s2 > 0.0);
}

/* Start and final half-cell use one constant-acceleration controller command.
 * Honour vmax and every acceleration regime that command crosses. */
static float f413_path_run_boundary_speed(
    const ShortestRunModeParams_t* mode_params,
    const ShortestRunCaseParams_t* case_params, float distance_mm)
{
  NfLinearLimits limits;
  if (!f413_path_run_straight_limits(mode_params, case_params, &limits) ||
      !isfinite(limits.vmax_mm_s) || !isfinite(limits.switch_velocity_mm_s) ||
      !isfinite(limits.accel_low_mm_s2) || !isfinite(limits.accel_high_mm_s2) ||
      !isfinite(distance_mm) || distance_mm <= 0.0f)
  {
    return NAN;
  }
  const float switch_speed = (float)limits.switch_velocity_mm_s;
  const float accel = (float)(switch_speed <= 0.0f
      ? limits.accel_high_mm_s2 : limits.accel_low_mm_s2);
  float speed = fminf((float)limits.vmax_mm_s, sqrtf(2.0f * distance_mm * accel));
  if (switch_speed > 0.0f && speed > switch_speed)
  {
    const float shared_accel = fminf(accel, (float)limits.accel_high_mm_s2);
    speed = fminf(speed, fmaxf(switch_speed, sqrtf(2.0f * distance_mm * shared_accel)));
  }
  return speed;
}

static float f413_path_run_next_straight_exit_velocity(
    uint16_t next_code,
    const ShortestRunModeParams_t* mode_params,
    const ShortestRunCaseParams_t* case_params)
{
  float turn_velocity;

  if (f413_path_run_turn_velocity_from_code(
          next_code, mode_params, &turn_velocity))
  {
    return turn_velocity;
  }
  if (next_code == 0U)
  {
    return f413_path_run_boundary_speed(mode_params, case_params, (float)DIST_HALF_SEC);
  }
  if (f413_path_run_is_straight_code(next_code) && (case_params != NULL))
  {
    return case_params->velocity_straight;
  }
  return 0.0f;
}

static float f413_path_run_next_diagonal_exit_velocity(
    uint16_t next_code,
    const ShortestRunModeParams_t* mode_params,
    const ShortestRunCaseParams_t* case_params,
    float test_terminal_velocity_mm_s)
{
  float turn_velocity;

  if (f413_path_run_turn_velocity_from_code(
          next_code, mode_params, &turn_velocity))
  {
    return turn_velocity;
  }
  if (f413_path_run_is_diagonal_code(next_code) && (case_params != NULL))
  {
    return case_params->velocity_d_straight;
  }
  if ((next_code == 0U) && isfinite(test_terminal_velocity_mm_s) &&
      (test_terminal_velocity_mm_s > 0.0f))
  {
    /* Keep the primitive's exit speed. Case0 stopping distance is derived
     * from the selected case's acceleration limits during preflight. */
    return test_terminal_velocity_mm_s;
  }
  return 0.0f;
}

static bool f413_path_run_make_test_terminal_profile(
    float entry_velocity_mm_s,
    const NfLinearLimits* limits,
    NfConstantAccelProfile* out)
{
  double acceleration_limit;
  double distance_mm;
  if ((limits == NULL) || (out == NULL) || !isfinite(entry_velocity_mm_s) ||
      (entry_velocity_mm_s < 0.0f))
  {
    return false;
  }
  /* A single monotonic stop must fit every acceleration regime it crosses.
   * Extend only the explicit case0 test's free-space tail, never raise the
   * configured acceleration to squeeze a stop into 45 mm. */
  acceleration_limit = limits->switch_velocity_mm_s <= 0.0
      ? limits->accel_high_mm_s2 : limits->accel_low_mm_s2;
  if (entry_velocity_mm_s > limits->switch_velocity_mm_s)
  {
    acceleration_limit = fmin(acceleration_limit, limits->accel_high_mm_s2);
  }
  if (!isfinite(acceleration_limit) || acceleration_limit <= 0.0)
  {
    return false;
  }
  distance_mm = fmax((double)DIST_HALF_SEC,
      (double)entry_velocity_mm_s * entry_velocity_mm_s / (2.0 * acceleration_limit));
  /* Round upward so the float sent to the controller cannot shorten braking. */
  distance_mm = ceil(distance_mm * 1000.0) / 1000.0;
  return nf_motion_constant_accel_profile(
      limits, distance_mm, entry_velocity_mm_s, 0.0, out) == NF_MOTION_OK;
}

static bool f413_path_run_make_wall_end_approach_plan(
    uint32_t straight_steps,
    float entry_velocity_mm_s,
    float turn_velocity_mm_s,
    const NfLinearLimits* limits,
    NfLinearPlan* out_plan,
    bool* out_execute_before_buffer)
{
  if ((straight_steps == 0U) || (out_plan == NULL) ||
      (out_execute_before_buffer == NULL))
  {
    return false;
  }

  /*
   * S1 is wholly owned by the wall-end segment, which performs the entry to
   * turn-speed profile.  S2+ reaches turn speed before reserving the final S1
   * for wall-end detection at constant speed.
   */
  *out_execute_before_buffer = straight_steps > 1U;
  if (!*out_execute_before_buffer)
  {
    NfConstantAccelProfile buffer_profile;
    return nf_motion_constant_accel_profile(
               limits,
               (double)DIST_HALF_SEC,
               (double)entry_velocity_mm_s,
               (double)turn_velocity_mm_s,
               &buffer_profile) == NF_MOTION_OK;
  }
  return f413_path_run_make_linear_plan(
      (float)(straight_steps - 1U) * (float)DIST_HALF_SEC,
      entry_velocity_mm_s,
      turn_velocity_mm_s,
      limits,
      out_plan);
}

static bool f413_path_run_turn_enters_diagonal(uint16_t code)
{
  return (code == NF_LEGACY_PATH_RIGHT_45_IN) ||
         (code == NF_LEGACY_PATH_LEFT_45_IN) ||
         (code == NF_LEGACY_PATH_RIGHT_135_IN) ||
         (code == NF_LEGACY_PATH_LEFT_135_IN);
}

static bool f413_path_run_turn_exits_diagonal(uint16_t code)
{
  return (code == NF_LEGACY_PATH_RIGHT_45_OUT) ||
         (code == NF_LEGACY_PATH_LEFT_45_OUT) ||
         (code == NF_LEGACY_PATH_RIGHT_135_OUT) ||
         (code == NF_LEGACY_PATH_LEFT_135_OUT);
}

#if !defined(NIGHTFALL_F413_PATH_LINEAR_PLAN_HOST_TEST) || \
    defined(NIGHTFALL_F413_PATH_DISTANCE_CURSOR_HOST_TEST)
static uint16_t f413_path_run_motor_phase_flags(uint16_t trace_flags,
                                                uint16_t motor_flag)
{
  const uint16_t motor_mask = (uint16_t)(NIGHTFALL_F413_TRACE_MODE_MOTOR_FWD_FLAG |
                                        NIGHTFALL_F413_TRACE_MODE_MOTOR_REV_FLAG |
                                        NIGHTFALL_F413_TRACE_MODE_MOTOR_COAST_FLAG);
  return (uint16_t)((trace_flags & (uint16_t)~motor_mask) | motor_flag);
}

static uint16_t f413_path_run_turn_offset_trace_flags(uint16_t trace_flags)
{
  /*
   * Every turn entry/exit offset is powered forward motion, including the
   * diagonal primitives that deliberately disable wall control.  Keep the
   * motor flag independent of that wall-control choice: the auto trace logger
   * uses this flag to defer blocking FRAM writes until the motors stop.
   */
  return f413_path_run_motor_phase_flags(
      trace_flags, NIGHTFALL_F413_TRACE_MODE_MOTOR_FWD_FLAG);
}
#endif

static f413_path_run_preflight_result_t f413_path_run_preflight_prepare(
    const uint16_t* codes,
    size_t capacity,
    const ShortestRunModeParams_t* mode_params,
    const ShortestRunCaseParams_t* case_params,
    float initial_velocity_mm_s,
    bool wall_end_correction_enabled,
    bool test_mode_run,
    f413_path_run_prepared_path_t* prepared)
{
  f413_path_run_preflight_result_t result = {
      F413_PATH_RUN_PREFLIGHT_OK, NF_LEGACY_PATH_OK, 0U, 0U};
  NfLegacyPathResult legacy;
  NfLinearLimits straight_limits;
  NfLinearLimits diagonal_limits;
  float speed_now = initial_velocity_mm_s;
  bool diagonal = false;
  size_t index = 0U;

  if (prepared != NULL)
  {
    prepared->count = 0U;
    prepared->stop_distance_mm = 0.0f;
  }

  if ((codes == NULL) || (capacity == 0U) || (mode_params == NULL) ||
      (case_params == NULL) || !isfinite(initial_velocity_mm_s) ||
      (initial_velocity_mm_s < 0.0f) ||
      !f413_path_run_straight_limits(
          mode_params, case_params, &straight_limits))
  {
    result.status = F413_PATH_RUN_PREFLIGHT_INVALID_ARGUMENT;
    return result;
  }
  if (codes[0] == 0U)
  {
    result.status = F413_PATH_RUN_PREFLIGHT_INVALID_LEGACY_PATH;
    result.code = 0U;
    return result;
  }

  legacy = nf_legacy_path_validate(codes, capacity);
  if ((legacy.status != NF_LEGACY_PATH_OK) &&
      !(test_mode_run &&
        (legacy.status == NF_LEGACY_PATH_ENDS_DIAGONAL)))
  {
    result.status = F413_PATH_RUN_PREFLIGHT_INVALID_LEGACY_PATH;
    result.legacy_status = legacy.status;
    result.index = legacy.index;
    result.code = legacy.code;
    return result;
  }

  while (codes[index] != 0U)
  {
    const uint16_t code = codes[index];

    if (f413_path_run_is_straight_code(code))
    {
      uint32_t steps = 0U;
      size_t end = index;
      const uint16_t previous_code = (index > 0U) ? codes[index - 1U] : 0U;
      uint16_t next_code;
      float exit_velocity;
      NfLinearPlan plan;
      bool skip_wall_end;
      bool execute_plan = true;

      while (f413_path_run_is_straight_code(codes[end]))
      {
        steps += (uint32_t)(codes[end] - NF_LEGACY_PATH_STRAIGHT_BASE);
        end++;
      }
      next_code = codes[end];
      exit_velocity = f413_path_run_next_straight_exit_velocity(
          next_code, mode_params, case_params);
      skip_wall_end =
          (steps == 1U) &&
          ((f413_path_run_is_large_turn_code(previous_code) &&
            f413_path_run_is_small_turn_code(next_code)) ||
           (f413_path_run_is_small_turn_code(previous_code) &&
            f413_path_run_is_large_turn_code(next_code)));
      if (wall_end_correction_enabled && !skip_wall_end &&
          (f413_path_run_is_small_turn_code(next_code) ||
           f413_path_run_is_large_turn_code(next_code)))
      {
        bool execute_before_buffer;
        if (!f413_path_run_make_wall_end_approach_plan(
                steps, speed_now, exit_velocity, &straight_limits, &plan,
                &execute_before_buffer))
        {
          result.status = F413_PATH_RUN_PREFLIGHT_INFEASIBLE_LINEAR;
        }
        execute_plan = execute_before_buffer;
      }
      else if (!f413_path_run_make_linear_plan(
                   (float)steps * (float)DIST_HALF_SEC,
                   speed_now, exit_velocity, &straight_limits, &plan))
      {
        result.status = F413_PATH_RUN_PREFLIGHT_INFEASIBLE_LINEAR;
      }
      if (result.status != F413_PATH_RUN_PREFLIGHT_OK)
      {
        result.index = index;
        result.code = code;
        return result;
      }
      if (!f413_path_run_store_prepared_linear(
              prepared, index, speed_now, exit_velocity,
              execute_plan ? &plan : NULL, execute_plan))
      {
        result.status = F413_PATH_RUN_PREFLIGHT_PREPARED_CAPACITY;
        result.index = index;
        result.code = code;
        return result;
      }
      speed_now = exit_velocity;
      index = end;
      continue;
    }

    if (f413_path_run_is_diagonal_code(code))
    {
      uint32_t steps = 0U;
      size_t end = index;
      float exit_velocity;
      NfLinearPlan plan;

      if (!f413_path_run_diagonal_limits(mode_params, case_params, &diagonal_limits))
      {
        result.status = F413_PATH_RUN_PREFLIGHT_INVALID_ARGUMENT;
        result.index = index;
        result.code = code;
        return result;
      }
      while (f413_path_run_is_diagonal_code(codes[end]))
      {
        steps +=
            (uint32_t)(codes[end] - NF_LEGACY_PATH_DIAGONAL_STRAIGHT_BASE);
        end++;
      }
      exit_velocity = f413_path_run_next_diagonal_exit_velocity(
          codes[end], mode_params, case_params,
          (test_mode_run && (codes[end] == 0U)) ? speed_now : 0.0f);
      if (!f413_path_run_make_linear_plan(
              (float)steps * (float)DIST_D_HALF_SEC,
              speed_now, exit_velocity, &diagonal_limits, &plan))
      {
        result.status = F413_PATH_RUN_PREFLIGHT_INFEASIBLE_LINEAR;
        result.index = index;
        result.code = code;
        return result;
      }
      if (!f413_path_run_store_prepared_linear(
              prepared, index, speed_now, exit_velocity, &plan, true))
      {
        result.status = F413_PATH_RUN_PREFLIGHT_PREPARED_CAPACITY;
        result.index = index;
        result.code = code;
        return result;
      }
      speed_now = exit_velocity;
      index = end;
      continue;
    }

    {
      float turn_velocity;
      if (!f413_path_run_turn_velocity_from_code(
              code, mode_params, &turn_velocity))
      {
        result.status = F413_PATH_RUN_PREFLIGHT_INVALID_LEGACY_PATH;
        result.index = index;
        result.code = code;
        return result;
      }
      if (fabsf(speed_now - turn_velocity) > 0.5f)
      {
        result.status = F413_PATH_RUN_PREFLIGHT_SPEED_DISCONTINUITY;
        result.index = index;
        result.code = code;
        return result;
      }
      speed_now = turn_velocity;
      if (f413_path_run_turn_enters_diagonal(code))
      {
        diagonal = true;
      }
      else if (f413_path_run_turn_exits_diagonal(code))
      {
        diagonal = false;
      }
      index++;
    }
  }

  if (diagonal && !test_mode_run)
  {
    /* Normally caught by the shared grammar; keep the execution invariant. */
    result.status = F413_PATH_RUN_PREFLIGHT_INVALID_LEGACY_PATH;
    result.legacy_status = NF_LEGACY_PATH_ENDS_DIAGONAL;
    result.index = index;
    return result;
  }
  {
    NfConstantAccelProfile stop_profile;
    const bool valid_stop = test_mode_run
        ? f413_path_run_make_test_terminal_profile(
              speed_now, diagonal ? &diagonal_limits : &straight_limits, &stop_profile)
        : (nf_motion_constant_accel_profile(
               &straight_limits, (double)DIST_HALF_SEC, (double)speed_now,
               0.0, &stop_profile) == NF_MOTION_OK);
    if (!valid_stop)
    {
      result.status = F413_PATH_RUN_PREFLIGHT_INFEASIBLE_LINEAR;
      result.index = index;
      result.code = 0U;
      return result;
    }
    if (prepared != NULL)
    {
      prepared->stop_distance_mm = (float)stop_profile.distance_mm;
    }
  }
  return result;
}

#if defined(NIGHTFALL_F413_PATH_LINEAR_PLAN_HOST_TEST)
static f413_path_run_preflight_result_t f413_path_run_preflight(
    const uint16_t* codes,
    size_t capacity,
    const ShortestRunModeParams_t* mode_params,
    const ShortestRunCaseParams_t* case_params,
    float initial_velocity_mm_s,
    bool wall_end_correction_enabled,
    bool test_mode_run)
{
  return f413_path_run_preflight_prepare(
      codes, capacity, mode_params, case_params, initial_velocity_mm_s,
      wall_end_correction_enabled, test_mode_run, NULL);
}
#endif

#if !defined(NIGHTFALL_F413_PATH_LINEAR_PLAN_HOST_TEST)

#include "f413_control.h"
#include "f413_hw.h"
#include "f413_run_features.h"
#include "f413_run_session.h"
#include "f413_trace_flags.h"
#include "f413_trace_log.h"
#include "f413_trace_sample.h"
#include "f413_wall_distance.h"
#include "f413_wall_runtime.h"
#include "main.h"
#include "params.h"
#include "search.h"
#include "shortest_run_params.h"
#include "trace.h"

typedef struct {
  float signed_angle_deg;
  float alpha_deg_s2;
  float omega_max_deg_s;
  float velocity_mm_s;
  float dist_in_mm;
  float dist_out_mm;
  bool front_wall_entry;
  bool wall_control_offsets;
  bool large_turn;
} f413_path_run_turn_t;

typedef struct {
  float omega_peak_deg_s;
  float t_acc_s;
  float t_cruise_s;
  float t_total_s;
} f413_path_run_smooth_turn_t;

extern uint16_t path[];

static f413_path_run_prepared_path_t g_f413_path_run_prepared_path;
static f413_path_run_distance_cursor_t g_f413_path_run_distance_cursor;

#if (NIGHTFALL_F413_PATH_MAX_CODES > ROUTE_MAX_LEN)
#error "F413 path execution limit exceeds path[] capacity"
#endif

static const ShortestRunModeParams_t* f413_path_run_mode_params(uint8_t mode)
{
  switch (mode)
  {
    case 2U: return &shortestRunModeParams2;
    case 3U: return &shortestRunModeParams3;
    case 4U: return &shortestRunModeParams4;
    case 5U: return &shortestRunModeParams5;
    case 6U: return &shortestRunModeParams6;
    case 7U: return &shortestRunModeParams7;
    default: return &shortestRunModeParams2;
  }
}

static const ShortestRunCaseParams_t* f413_path_run_case_params(uint8_t mode, uint8_t case_index)
{
  uint8_t idx = 0U;

  if ((case_index >= 1U) && (case_index <= 9U))
  {
    idx = (uint8_t)(case_index - 1U);
  }

  switch (mode)
  {
    case 2U: return &shortestRunCaseParamsMode2[idx];
    case 3U: return &shortestRunCaseParamsMode3[idx];
    case 4U: return &shortestRunCaseParamsMode4[idx];
    case 5U: return &shortestRunCaseParamsMode5[idx];
    case 6U: return &shortestRunCaseParamsMode6[idx];
    case 7U: return &shortestRunCaseParamsMode7[idx];
    default: return &shortestRunCaseParamsMode2[idx];
  }
}

static void f413_path_run_prepare_straight_angle_control(void)
{
  if (!f413_run_features_angle_accum_mode())
  {
    f413_ctrl_reset_angle();
  }
  f413_ctrl_clear_angle_target();
}

static void f413_path_run_prepare_turn_angle_control(void)
{
  if (!f413_run_features_angle_accum_mode())
  {
    f413_ctrl_reset_angle();
  }
  f413_ctrl_clear_angle_target();
  f413_wall_runtime_control_clear();
}

static bool f413_path_run_turn_from_code(uint16_t code,
                                         const ShortestRunModeParams_t* params,
                                         f413_path_run_turn_t* turn)
{
  float angle = 0.0f;
  float accum_angle = 0.0f;
  float alpha = 0.0f;
  float velocity;
  bool right = false;

  if ((params == NULL) || (turn == NULL))
  {
    return false;
  }
  turn->front_wall_entry = false;
  turn->wall_control_offsets = false;
  turn->large_turn = false;

  switch (code)
  {
    case 300U:
      angle = params->angle_turn_90; alpha = params->alpha_turn90;
      accum_angle = 90.0f;
      turn->dist_in_mm = params->dist_offset_in;
      turn->dist_out_mm = params->dist_offset_out;
      turn->front_wall_entry = true;
      turn->wall_control_offsets = true;
      right = true; break;
    case 400U:
      angle = params->angle_turn_90; alpha = params->alpha_turn90;
      accum_angle = 90.0f;
      turn->dist_in_mm = params->dist_offset_in;
      turn->dist_out_mm = params->dist_offset_out;
      turn->front_wall_entry = true;
      turn->wall_control_offsets = true;
      right = false; break;
    case 501U:
      angle = params->angle_l_turn_90; alpha = params->alpha_l_turn_90;
      accum_angle = 90.0f;
      turn->dist_in_mm = params->dist_l_turn_in_90;
      turn->dist_out_mm = params->dist_l_turn_out_90;
      turn->front_wall_entry = false;
      turn->wall_control_offsets = true;
      turn->large_turn = true;
      right = true; break;
    case 601U:
      angle = params->angle_l_turn_90; alpha = params->alpha_l_turn_90;
      accum_angle = 90.0f;
      turn->dist_in_mm = params->dist_l_turn_in_90;
      turn->dist_out_mm = params->dist_l_turn_out_90;
      turn->front_wall_entry = false;
      turn->wall_control_offsets = true;
      turn->large_turn = true;
      right = false; break;
    case 502U:
      angle = params->angle_l_turn_180; alpha = params->alpha_l_turn_180;
      accum_angle = 180.0f;
      turn->dist_in_mm = params->dist_l_turn_in_180;
      turn->dist_out_mm = params->dist_l_turn_out_180;
      turn->front_wall_entry = false;
      turn->wall_control_offsets = true;
      turn->large_turn = true;
      right = true; break;
    case 602U:
      angle = params->angle_l_turn_180; alpha = params->alpha_l_turn_180;
      accum_angle = 180.0f;
      turn->dist_in_mm = params->dist_l_turn_in_180;
      turn->dist_out_mm = params->dist_l_turn_out_180;
      turn->front_wall_entry = false;
      turn->wall_control_offsets = true;
      turn->large_turn = true;
      right = false; break;
    case 701U:
      angle = params->angle_turn45in; alpha = params->alpha_turn45in;
      accum_angle = 45.0f;
      turn->dist_in_mm = params->dist_turn45in_in;
      turn->dist_out_mm = params->dist_turn45in_out;
      turn->front_wall_entry = false;
      right = true; break;
    case 702U:
      angle = params->angle_turn45in; alpha = params->alpha_turn45in;
      accum_angle = 45.0f;
      turn->dist_in_mm = params->dist_turn45in_in;
      turn->dist_out_mm = params->dist_turn45in_out;
      turn->front_wall_entry = false;
      right = false; break;
    case 703U:
      angle = params->angle_turn45out; alpha = params->alpha_turn45out;
      accum_angle = 45.0f;
      turn->dist_in_mm = params->dist_turn45out_in;
      turn->dist_out_mm = params->dist_turn45out_out;
      turn->front_wall_entry = false;
      right = true; break;
    case 704U:
      angle = params->angle_turn45out; alpha = params->alpha_turn45out;
      accum_angle = 45.0f;
      turn->dist_in_mm = params->dist_turn45out_in;
      turn->dist_out_mm = params->dist_turn45out_out;
      turn->front_wall_entry = false;
      right = false; break;
    case 801U:
      angle = params->angle_turnV90; alpha = params->alpha_turnV90;
      accum_angle = 90.0f;
      turn->dist_in_mm = params->dist_turnV90_in;
      turn->dist_out_mm = params->dist_turnV90_out;
      turn->front_wall_entry = false;
      right = true; break;
    case 802U:
      angle = params->angle_turnV90; alpha = params->alpha_turnV90;
      accum_angle = 90.0f;
      turn->dist_in_mm = params->dist_turnV90_in;
      turn->dist_out_mm = params->dist_turnV90_out;
      turn->front_wall_entry = false;
      right = false; break;
    case 901U:
      angle = params->angle_turn135in; alpha = params->alpha_turn135in;
      accum_angle = 135.0f;
      turn->dist_in_mm = params->dist_turn135in_in;
      turn->dist_out_mm = params->dist_turn135in_out;
      turn->front_wall_entry = false;
      right = true; break;
    case 902U:
      angle = params->angle_turn135in; alpha = params->alpha_turn135in;
      accum_angle = 135.0f;
      turn->dist_in_mm = params->dist_turn135in_in;
      turn->dist_out_mm = params->dist_turn135in_out;
      turn->front_wall_entry = false;
      right = false; break;
    case 903U:
      angle = params->angle_turn135out; alpha = params->alpha_turn135out;
      accum_angle = 135.0f;
      turn->dist_in_mm = params->dist_turn135out_in;
      turn->dist_out_mm = params->dist_turn135out_out;
      turn->front_wall_entry = false;
      right = true; break;
    case 904U:
      angle = params->angle_turn135out; alpha = params->alpha_turn135out;
      accum_angle = 135.0f;
      turn->dist_in_mm = params->dist_turn135out_in;
      turn->dist_out_mm = params->dist_turn135out_out;
      turn->front_wall_entry = false;
      right = false; break;
    default: return false;
  }

  if (f413_run_features_angle_accum_mode() && (accum_angle > 0.0f))
  {
    angle = accum_angle;
  }
  if (!isfinite(angle) || angle <= 0.0f || !isfinite(alpha) || alpha <= 0.0f ||
      !isfinite(params->turn_omega_max) || params->turn_omega_max < 0.0f ||
      !isfinite(turn->dist_in_mm) || turn->dist_in_mm < 0.0f ||
      !isfinite(turn->dist_out_mm) || turn->dist_out_mm < 0.0f)
  {
    return false;
  }

  if (!f413_path_run_turn_velocity_from_code(code, params, &velocity))
  {
    return false;
  }
  turn->signed_angle_deg = right ? -fabsf(angle) : fabsf(angle);
  turn->alpha_deg_s2 = alpha;
  turn->omega_max_deg_s = params->turn_omega_max;
  turn->velocity_mm_s = velocity;
  return true;
}

static f413_path_run_smooth_turn_t f413_path_run_build_smooth_turn(float angle_deg,
                                                                   float alpha_deg_s2,
                                                                   float omega_cap_deg_s)
{
  f413_path_run_smooth_turn_t profile = {0.0f, 0.0f, 0.0f, 0.0f};
  const float angle_abs = fabsf(angle_deg);
  float rounding_scale = TURN_OMEGA_PROFILE_ROUNDING_SCALE;

  if ((angle_abs <= 0.0f) || (alpha_deg_s2 <= 0.0f))
  {
    return profile;
  }

  profile.omega_peak_deg_s = sqrtf((2.0f * alpha_deg_s2 * angle_abs) / 3.0f);
  if (omega_cap_deg_s > 0.0f)
  {
    profile.omega_peak_deg_s = fminf(profile.omega_peak_deg_s, omega_cap_deg_s);
  }
  if (profile.omega_peak_deg_s <= 0.0f)
  {
    return profile;
  }

  if (rounding_scale < 0.1f)
  {
    rounding_scale = 0.1f;
  }

  profile.t_acc_s = (profile.omega_peak_deg_s / alpha_deg_s2) * rounding_scale;
  profile.t_cruise_s = (angle_abs / profile.omega_peak_deg_s) - profile.t_acc_s;
  if (profile.t_cruise_s < 0.0f)
  {
    profile.t_cruise_s = 0.0f;
    profile.omega_peak_deg_s = angle_abs / profile.t_acc_s;
    if (omega_cap_deg_s > 0.0f)
    {
      profile.omega_peak_deg_s = fminf(profile.omega_peak_deg_s, omega_cap_deg_s);
    }
    profile.t_cruise_s = (angle_abs / profile.omega_peak_deg_s) - profile.t_acc_s;
    if (profile.t_cruise_s < 0.0f)
    {
      profile.t_cruise_s = 0.0f;
    }
  }
  profile.t_total_s = (2.0f * profile.t_acc_s) + profile.t_cruise_s;
  return profile;
}

static bool f413_path_run_print_turn_profiles_before_run(
    const ShortestRunModeParams_t* mode_params)
{
  uint16_t index;

  for (index = 0U; index < NIGHTFALL_F413_PATH_MAX_CODES; index++)
  {
    const uint16_t code = path[index];
    f413_path_run_turn_t turn;
    f413_path_run_smooth_turn_t profile;

    if (code == 0U)
    {
      return true;
    }
    if (f413_path_run_is_straight_code(code) ||
        f413_path_run_is_diagonal_code(code))
    {
      continue;
    }
    if (!f413_path_run_turn_from_code(code, mode_params, &turn))
    {
      return false;
    }
    profile = f413_path_run_build_smooth_turn(turn.signed_angle_deg,
                                              turn.alpha_deg_s2,
                                              turn.omega_max_deg_s);
    if (profile.t_total_s <= 0.0f)
    {
      return false;
    }
    /*
     * Float formatting is intentionally completed while motor standby is
     * still off.  Printing this line at the live straight-to-turn boundary
     * previously extended the approach distance at the old velocity.
     */
    trace_printf(
        "[OP-UI][PATH-TEST] turn[%u] code=%u angle=%.1f alpha=%.0f omega=%.0f v=%.0f t=%.0fms\r\n",
        (unsigned int)index,
        (unsigned int)code,
        (double)turn.signed_angle_deg,
        (double)turn.alpha_deg_s2,
        (double)profile.omega_peak_deg_s,
        (double)turn.velocity_mm_s,
        (double)(profile.t_total_s * 1000.0f));
  }
  return false;
}

static void f413_path_run_trace_on_run_start(void)
{
  if (ENABLE_AUTO_VIDEO_CAPTURE != 0U)
  {
    /* Keep the driver in standby for the complete optical START token. */
    f413_ctrl_stop();
    trace_printf("[RUN-START] control stopped, motor standby during optical START\r\n");
    trace_printf("[VIDEO-SYNC] optical START fixed-slot SHORT token\r\n");
    f413_hw_emit_video_sync_start_pattern();
    HAL_Delay(F413_HW_VIDEO_SYNC_START_GUARD_MS);
  }
  trace_printf("[TRACE-LOG] run-hook: start\r\n");
  f413_trace_log_auto_start();
}

static void f413_path_run_trace_on_run_stop(void)
{
  trace_printf("[TRACE-LOG] run-hook: stop tail=%u ms\r\n",
               (unsigned int)F413_TRACE_LOG_STOP_TAIL_MS_DEFAULT);
  f413_trace_log_auto_stop_after_tail(F413_TRACE_LOG_STOP_TAIL_MS_DEFAULT);
  if (ENABLE_AUTO_VIDEO_CAPTURE != 0U)
  {
    trace_printf("[VIDEO-SYNC] optical STOP fixed-slot LONG token\r\n");
    f413_hw_emit_video_sync_stop_pattern();
  }
}

static f413_run_session_abort_reason_t f413_path_run_wait_ctrl_target(
    float target, bool is_angle,
    f413_run_session_guard_t* guard,
    uint16_t trace_flags,
    bool wall_control_gate,
    bool diagonal_control_gate)
{
  f413_run_session_abort_reason_t reason = F413_RUN_SESSION_ABORT_NONE;
  uint32_t deadline = HAL_GetTick() + NIGHTFALL_F413_PATH_TIMEOUT_MS;

  while (1)
  {
    if (is_angle)
    {
      float current = f413_ctrl_get_angle();
      if (((target >= 0.0f) && (current >= target)) ||
          ((target < 0.0f) && (current <= target)))
      {
        break;
      }
    }
    else
    {
      /* A zero-speed test tail may settle just short of the exact endpoint.
       * Once its profile completes, let the bounded position/speed settle
       * check below the path loop decide completion instead of waiting for
       * an encoder crossing with an almost-zero correction command.
       */
      if (f413_run_features_test_mode_run() &&
          f413_ctrl_stop_profile_complete())
      {
        break;
      }
      float current = fabsf(f413_ctrl_get_distance());
      if (current >= fabsf(target))
      {
        break;
      }
    }

    if ((int32_t)(HAL_GetTick() - deadline) >= 0)
    {
      return F413_RUN_SESSION_ABORT_TIMEOUT;
    }

    f413_trace_log_set_mode_flags(trace_flags);
    reason = f413_run_session_wait_with_auto_step_guarded(1U, guard);
    if (!is_angle && diagonal_control_gate)
    {
      f413_wall_runtime_poll_diagonal(true);
    }
    else if (!is_angle && wall_control_gate &&
             ((trace_flags & NIGHTFALL_F413_TRACE_MODE_MOTOR_FWD_FLAG) != 0U))
    {
      /* Keep shortest-run wall control on the same live update path as search. */
      f413_wall_runtime_poll_straight(true);
    }
    else
    {
      f413_wall_runtime_control_apply(false);
    }
    if (reason != F413_RUN_SESSION_ABORT_NONE)
    {
      return reason;
    }
  }
  return F413_RUN_SESSION_ABORT_NONE;
}

#define F413_PATH_RUN_TEST_STOP_SETTLE_MAX_MS       (250U)
#define F413_PATH_RUN_TEST_STOP_VELOCITY_MM_S       (20.0f)
#define F413_PATH_RUN_TEST_STOP_POSITION_ERROR_MM   (0.75f)
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
