xfa273/nightfall-fw/(commit log)

2025-12-29 chore: 初期構成と運用ドキュメント
2025-12-29 feat: mini_v1_1をnightfall-fwへ移植（ビルド基準点）
2025-12-29 feat: mini/classic 2ターゲット化 + params分離の土台
2025-12-31 fix: avoid mass erase to preserve flash sensor params
2026-01-11 feat: add wall-end deriv to sensor log
2026-01-11 refactor: drop wall-end deriv log and extend sensor log
2026-01-13 Keep omega=0 during velocity tune test
2026-01-21 control: clamp velocity profile and add encoder velocity LPF
2026-01-22 fix(search): keep make_smap return value compatible
    [search.c]
2026-01-24 fix: accelerate at search start
    [search.c]
2026-01-26 fix: toggle angle outer loop by gains
    [control.c]
2026-01-29 tune(mini_v1_1): update angle/omega PID gains
2026-02-02 fan noise test log + IMU omega LPF + classic gain tuning
    [control.c, logging.c, logging.h, params.h, test_mode.c]
2026-02-02 add fan duty to search params
2026-02-02 add suction fan stabilize delay
    [drive.c, params.h]
2026-02-02 tune classic shortest params and update test paths
    [mode4.c, mode5.c, mode6.c]
2026-02-02 align mode7 with mode6 shortest run
    [mode7.c, run.c]
2026-02-02 tune: classic params + disable wall_end correction in mode4/mode7
    [mode4.c, mode7.c, params.h]
2026-02-04 tune: update classic shortest/search params and mode behavior
    [mode2.c, mode5.c, mode7.c, params.h]
2026-02-07 Add turn-angle margin failsafe (cmd angle + 90deg)
    [drive.c, params.h]
2026-02-07 WIP: expand led_write to 3 args and tune classic params
2026-02-07 Fix led_write call sites (add 3rd arg)
    [auxiliary.h, search.c]
2026-02-08 exp: do not disable wall-end correction in mode shortcuts
    [mode3.c, mode6.c, mode7.c]
2026-02-08 fix: turn-angle failsafe triggers on reverse spin
    [drive.c]
2026-02-08 tune(classic_v2): adjust wall/battery/front-align and search turn params
2026-02-08 fix: enable failsafes during search run
    [search.c]
2026-02-09 tune(mini_v1_1): update params and shortest/search behaviors
    [mode2.c, mode4.c, params.h, search.c]
2026-02-09 fix: avoid wall control spike after turns
    [control.c]
2026-02-09 fix: clear diagonal control when disabled
    [control.c]
2026-02-09 mini_v1_1: fan-on omega gains align with fan-off
2026-02-11 params(mini): tune omega gains for fan on
2026-02-11 tune(mini): update omega gains and shortest params
    [mode4.c, mode5.c, params.h]
2026-02-11 tune(mini): adjust params and enable front-wall correction
    [mode4.c, mode5.c, params.h]
2026-02-11 build: fix warnings (unused funcs, dup init)
    [mode1.c, mode7.c]
2026-02-11 tune: update mini_v1_1 shortest params
    [mode4.c, params.h]
2026-02-14 tune: save current param and mode adjustments
2026-02-14 feat: disable wall-end blink and keep mode-specific LED behavior
2026-02-14 fix: use normal decel profile for shortest goal stop
    [run.c]
2026-02-14 fix(search): re-enable known-straight accel/decel path
    [search.c]
2026-02-14 feat: search accel wall-end timing and shortest start large-turn exception
    [drive.c, drive.h, path.c, path.h, search.c, solver.c]
2026-02-15 feat: angle accumulation mode for shortest run turns - use target_angle for turn termination instead of real_angle - accumulate angle across motions to auto-correct drift - override turn angle params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
    [drive.c, global.h, mode2.c, mode3.c, mode4.c, mode5.c, mode6.c, mode7.c]
2026-02-15 fix: enable failsafe recovery path in test run mode
    [drive.c, run.c]
2026-02-15 fix: keep fan active before run and unify ccw rotation sign
    [control.c, drive.c, drive.h, mode4.c, params.h, run.c]
2026-02-15 fix: prevent pre-run control output and tune classic angle pid
    [interrupt.c, params.h]
2026-02-15 feat(search): allow disabling wall-end correction in exploration and tune params
    [drive.c, mode1.c, params.h]
2026-02-15 tune(mini): adjust low-speed search dist_offset_out to 14mm
2026-02-15 feat(search): conditional heading reset after 3 dual-wall straight cells
    [drive.c, search.c]
2026-02-15 fix(search): restore driveR angle reset for dead-end 180 turns
    [drive.c]
2026-02-15 feat(search): add one-side wall heading reset and mode1 flag control
    [mode1.c, search.c]
2026-02-15 fix(search): avoid over-deceleration after known straight accel
    [drive.c]
2026-02-15 feat(search): parameterize angle-reset wall streak thresholds
    [params.h, search.c]
2026-02-15 fix(search): gate super-rotate angle reset by front-wall correction
    [drive.c, drive.h, search.c]
2026-02-16 fix(drive): make driveR phase checks relative to start angle
    [drive.c]
2026-02-16 tune(mini): raise angle-reset streak thresholds and kp_wall
    [params.h]
2026-02-16 feat(test): add IMU drift/noise CSV capture in test mode
    [test_mode.c]
2026-02-16 feat(imu): average offset and use LPF omega for angle integration
2026-02-16 tune(mini): adjust mode4/5 shortest params and control flags
    [mode4.c, mode5.c, params.h]
2026-02-18 Tune turn control and params: fan ON/OFF angle gains, turn profile rounding, shortest/search parameter updates
    [control.c, drive.c, logging.c, mode4.c, mode5.c, params.h, search.c]
2026-02-18 Fix shortest run precheck: halt before run when no path is derived
    [run.c, solver.c, solver.h]
2026-02-19 tune(classic): raise fan-on angle PID gains
2026-02-19 control: switch fan gain selection by suction power threshold
2026-02-19 tune(classic): finalize shortest small-turn adjustments
    [mode3.c, mode4.c, mode6.c, mode7.c, params.h]
2026-02-19 tune(classic): retune shortest large-turn and case params
2026-02-20 tune(classic): retune search and shortest run parameters
    [mode1.c, params.h]
2026-02-21 tune(params): refine fan threshold and search gains
2026-02-21 fix(search): suppress buzzer when search fan duty is configured
    [auxiliary.c, drive.c, drive.h, search.c]
2026-02-21 tune(search): adjust wall-end correction settings for mini goal/full run
    [mode1.c]
2026-02-21 fix(route): support 1024-step paths for 32x32 maze
    [run.c, search.h]
2026-02-21 tune(shortest): update mode1 wall-end flags and speed profiles
    [mode1.c]
2026-02-22 fix(search): temporarily mute buzzer during adachi run
    [auxiliary.c, drive.c, search.c]
2026-04-04 docs: add dev policy update, 2026 development plan, and phase0 inventory
    [HM_Nightfall-mini-2e_v1.brd, HM_Nightfall-mini-2e_v1.sch]
2026-04-04 structure: create hardware/mini_r2_0/ and copy CAD/notes from _sandbox
    [HM_Nightfall-mini-2e_v1.brd, HM_Nightfall-mini-2e_v1.sch]
2026-04-04 structure: copy F413 CubeMX project from _sandbox to platform/stm32f413/
2026-04-04 version: rename classic_r1_0 -> classic_r2_0, update CMake targets to nightfall_mini_r1_1 / nightfall_classic_r2_0
    HW Rev assignments:
    mini r1.1 (gen1 half-size, board rev 1)
    classic r2.0 (gen2 classic, board rev 0)
    FW Version: v1.0.0 (national competition baseline)
    Params/Tune: t1.0
    Both targets build successfully.
2026-04-04 docs: update PHASE0_INVENTORY migration tables for classic_r2_0 and current CMake targets
2026-04-04 version: unify HW Rev to r1.0 for both mini and classic
    Both machines start at r1.0 as the first version under the new policy.
    Previous naming was inconsistent and not based on the current convention.
    Renamed:
    mini_r1_1 -> mini_r1_0 (HW r1.0)
    classic_r2_0 -> classic_r1_0 (HW r1.0)
    CMake targets:
    nightfall_mini_r1_0
    nightfall_classic_r1_0
    Stable manifests and inventory docs updated accordingly.
    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
2026-04-04 build: embed FW_VERSION from CMakeLists.txt into build_info.h
    FW_VERSION is now defined in CMakeLists.txt and always embedded
    in build_info.h regardless of git tag presence. This prevents
    the version string from disappearing when building from an
    untagged commit.
    - CMakeLists.txt: set(FW_VERSION "1.0.0")
    - gen_build_info.cmake: accept FW_VERSION, emit #define FW_VERSION
    - main.c: boot message uses FW_VERSION instead of FW_GIT_DESCRIBE
    - logging.c, test_mode.c, sensor.c: add #fw_version to log metadata
    FW_GIT_DESCRIBE remains as supplementary git info.
    [logging.c, main.c, sensor.c, test_mode.c]
2026-04-04 version: add PARAMS_TUNE_VERSION t1.0 to params.h and boot/log output
    - params/mini_r1_0/params.h: define PARAMS_TUNE_VERSION "t1.0"
    - params/classic_r1_0/params.h: define PARAMS_TUNE_VERSION "t1.0"
    - main.c: add tune= to boot message
    - logging.c, test_mode.c, sensor.c: add #params_tune_version to log metadata
2026-04-04 phase1: add board and nvm structure skeleton with responsibility docs
2026-04-04 phase1: formalize hardware board directories and sandbox pointers
2026-04-04 phase2: add f413 swo startup trace and record phase progress
2026-04-04 phase2: add shared trace api and checklist workflow
2026-04-04 docs: record phase2 trace bootstrap commit id
2026-04-18 docs: switch to cascade-only execution policy
2026-05-06 Update mini CAD files
    [HM_Nightfall-mini-2e_v1.brd, HM_Nightfall-mini_v1.brd, HM_Nightfall-mini_v1.sch]
2026-05-06 Start F413 turn tests by button
2026-05-06 Fuse F413 accel into velocity estimate
2026-05-07 Add F413 solver host sample test
2026-05-07 Add F413 button sensor operation UI
2026-05-07 Expand F413 FRAM trace log format
2026-05-07 Fix F413 trace CSV long lines
    [main.c, serial_capture_csv.py]
2026-05-09 Add F413 direct straight UART test
2026-05-09 Add F413 UART operation UI controls
2026-05-09 Record F413 UART operation UI controls
2026-05-09 Use ST-LINK reset for F413 UART UI workflow
    [main.c]
2026-05-09 Protect F413 FRAM trace log SPI transactions
2026-05-09 Add F413 wall sensor snapshot API
2026-05-09 Log F413 wall trace observations
2026-05-09 Add F413 search map probe
2026-05-09 Add F413 search map debug UART
2026-05-09 Wire F413 nonmotor OP maintenance cases
2026-05-10 Tune F413 fixed velocity distance gains
    [params.h]
2026-05-17 Add PlotJuggler export for trace logs
2026-05-17 Add fixed PlotJuggler log launcher
    [export_plotjuggler_csv.py]
2026-05-17 Add fixed FRAM trace web log viewer
2026-05-17 Improve FRAM trace web viewer usability
2026-05-17 Tighten FRAM trace web viewer labels
2026-05-17 Remove FRAM trace subplot titles
2026-05-17 Trim FRAM trace plot margins
2026-05-17 Reduce FRAM trace plot margins
2026-05-17 Tighten Streamlit viewer page padding
2026-05-17 Tighten FRAM trace legend margin
2026-05-17 Polish FRAM trace viewer grid styling
2026-05-17 Log F413 tune encoder deltas
2026-05-17 Lower F413 velocity tune target to 300
2026-05-17 Update F413 velocity tune labels
2026-05-17 Show F413 motor outputs above averages
2026-05-17 Distinguish overlapping motor outputs in visualizer
2026-05-17 Fix F413 real omega update
    [f413_control.c]
2026-05-17 Fix F413 omega control sign
    [f413_control.c]
2026-05-17 Stabilize F413 omega damping
    [f413_control.c]
2026-05-17 Use normal motor output lines in visualizer
2026-05-17 Increase F413 trace log rate to 1ms
2026-05-19 Buffer F413 1ms trace logs in RAM
2026-05-19 Add target distance trace column
2026-05-19 Split serial CSV captures on trace runs
2026-05-19 Add F413 binary trace dump
2026-05-19 Increase F413 UART trace speed
2026-05-20 Auto-decode binary trace capture
2026-05-20 Raise F413 angle omega limit to IMU range
2026-05-20 Save F413 fan-off tuning gains
2026-05-23 Sample F413 trace logs at control tick
2026-05-31 Document hardware CAD migration rules
2026-05-31 Import mini r2 Eagle source set
    [HM_Nightfall-mini-2e_Encoder-PCB-L_v1.brd, HM_Nightfall-mini-2e_Encoder-PCB-L_v1.sch, HM_Nightfall-mini-2e_Encoder-PCB-R_v1.brd, HM_Nightfall-mini-2e_Encoder-PCB-R_v1.sch, HM_Nightfall-mini-2e_v1.brd, HM_Nightfall-mini-2e_v1.sch, STLink-Adapter.brd, STLink-Adapter.sch]
2026-05-31 Normalize imported Eagle file modes
    [HM_Nightfall-mini-2e_v1.sch]
2026-05-31 Import legacy final Eagle source sets
    [CM_Nightfall-Air_Fan-Mount_v1.brd, CM_Nightfall-Air_v1.brd, CM_Nightfall-Air_v1.sch, HM_Nightfall-mini_Fan-Mount_v1.brd, HM_Nightfall-mini_v1.brd, HM_Nightfall-mini_v1.sch, Skirt-Base-PCB.brd]
2026-06-06 Import mini r2 KiCad project
    [HM_Nightfall-mini-2e_v1.kicad_pcb, HM_Nightfall-mini-2e_v1.kicad_sch]
2026-06-06 Document mini r2 KiCad subboard projects
2026-06-06 Import mini r2 left encoder KiCad project
    [HM_Nightfall-mini-2e_Encoder-PCB-L_v1.kicad_pcb, HM_Nightfall-mini-2e_Encoder-PCB-L_v1.kicad_sch]
2026-06-06 Import mini r2 KiCad subboard projects
    [HM_Nightfall-mini-2e_Encoder-PCB-R_v1.kicad_pcb, HM_Nightfall-mini-2e_Encoder-PCB-R_v1.kicad_sch, STLink-Adapter.kicad_pcb, STLink-Adapter.kicad_sch, UART-Adapter.kicad_pcb, UART-Adapter.kicad_sch]
2026-06-06 Classify mini r2 KiCad review findings
2026-06-06 Apply JLCPCB rules to mini r2 KiCad projects
    [HM_Nightfall-mini-2e_v1.kicad_pcb]
2026-06-06 Refine JLCPCB DRC policy for mini r2
    [HM_Nightfall-mini-2e_v1.kicad_pcb]
2026-06-06 Fix mini r2 KiCad DRC conversion issues
    [HM_Nightfall-mini-2e_v1.kicad_pcb, STLink-Adapter.kicad_pcb, UART-Adapter.kicad_pcb]
2026-06-06 Archive mini r2 KiCad order candidate
    [HM_Nightfall-mini-2e_v1-B_Cu.gbl, HM_Nightfall-mini-2e_v1-B_Mask.gbs, HM_Nightfall-mini-2e_v1-B_Paste.gbp, HM_Nightfall-mini-2e_v1-B_SilkS.gbo, HM_Nightfall-mini-2e_v1-Edge_Cuts.gm1, HM_Nightfall-mini-2e_v1-F_Cu.gtl, HM_Nightfall-mini-2e_v1-F_Mask.gts, HM_Nightfall-mini-2e_v1-F_Paste.gtp]
2026-06-06 Stream F413 trace logs to FRAM
2026-06-06 Port F413 wall sensors to async ADC DMA
2026-06-06 Add sensor plots to web log visualizer
2026-06-06 Fix F413 wall sensor zero readings
    [HM_Nightfall_f413_preorder.ioc, main.c]
2026-06-06 Split F413 wall sensor module
2026-06-06 Split F413 trace auto module
2026-06-06 Split F413 trace diagnostics
2026-06-07 Split F413 motor run session
2026-06-07 Split F413 shortest safe run session
    [f413_run_session.c, f413_run_session.h, main.c]
2026-06-07 [codex] Set up Codex migration workflow (#11)
    * Set up Codex migration workflow
    * Verify F413 HIL loop
    * Document F413 tune HIL readiness
    * Propagate reset capture failures
    * Fail early timed captures
    * Harden safe HIL capture wrapper
    ---------
    [f413_safe_hil.py]
2026-06-07 Split F413 IMU diagnostics
2026-06-07 Split F413 trace sample module
2026-06-07 Split F413 UART CLI
2026-06-15 Fix F413 encoder distance scaling
    [f413_control.c, f413_hw_diag.c, params.h]
2026-06-15 Add F413 accel compensated velocity logging
2026-06-15 Enable F413 accel compensated velocity control
2026-06-15 Show all trace fields in web visualizer
2026-06-15 Add F413 gyro LPF trace logging
2026-06-15 Tune F413 omega control and simplify gyro trace
2026-06-20 Add F413 maze test search context trace
2026-06-21 Fix F413 constant velocity turn control
    [f413_control.c]
2026-06-21 Reduce F413 search stop endpoint jitter
    [f413_search_step.c]
2026-06-21 Tune F413 search distance calibration
2026-06-21 Fix F413 search turn position update
    [f413_search_step.c]
2026-06-27 Make F413 mode9 case3 monitor wall sensors
2026-07-04 Add search wall-read sensor columns
2026-07-04 Complete F413 search flow port
2026-07-04 Disable untuned F413 mode1 corrections
    [f413_mode1.c]
2026-07-05 docs: design f413 sensor distance conversion
2026-07-05 docs: clarify sensor distance interpolation design
2026-07-05 docs: recommend pchip for f413 sensor distance
2026-07-05 feat: add f413 wall sensor distance conversion
2026-07-12 feat: average F413 wall distance calibration samples
2026-07-12 refactor: clarify wall sensor LUT output
2026-07-12 refactor: simplify wall distance UART output
2026-07-12 docs: record new Mac UART diagnosis
2026-07-12 docs: record direct USB UART verification
2026-07-19 feat(f413): calibrate front wall distance matching
    [sensor_distance_calibration.csv]
2026-07-19 feat(f413): stage front wall matching
2026-07-19 docs(ai): record staged front match HIL
2026-07-19 feat(f413): trace front wall matching
2026-07-19 fix(logging): read binary front match CSV
    [analyze_front_match_csv.py]
2026-07-19 fix(f413): stabilize front wall matching
    [analyze_front_match_csv.py, f413_search_step.c, params.h]
2026-07-19 fix(f413): slow front wall position matching
    [f413_search_step.c, f413_trace_sample.c, params.h]
2026-07-19 fix(f413): fully stop settled front matching
    [f413_search_step.c]
2026-07-20 fix(f413): back away from too-close front walls
    [analyze_front_match_csv.py, f413_front_match.c, f413_front_match.h, f413_search_step.c, params.h]
2026-07-20 fix(f413): serialize runtime IMU diagnostics
    [analyze_search_event_log.py, f413_imu_diag.c]
2026-07-20 docs(ai): record search IMU abort fix
2026-07-20 feat(f413): use distance for search front correction
    [f413_mode1.c, f413_search_step.c]
2026-07-20 fix(f413): finish search deceleration before turns
    [f413_search_step.c]
2026-07-20 feat(f413): enable wall-end correction in full search
    [f413_mode1.c]
2026-07-20 Complete F413 shortest-run parity
    [analyze_search_event_log.py, f413_mode2.c, f413_mode3.c, f413_mode4.c, f413_mode5.c, f413_mode6.c, f413_mode7.c, f413_mode_shortest.c]
2026-07-23 Fix F413 shortest wall-end heading drift
    [f413_mode2.c, f413_path_run.c]
2026-07-23 Fix F413 wall-end gate and tune large turns
    [analyze_wall_end_csv.py, f413_path_run.c, f413_wall_runtime.c, f413_wall_runtime.h]
2026-07-27 hardware: add switched WeAct debugger adapter
    [BOM.csv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]
2026-07-27 hardware: simplify WeAct adapter silkscreen
    [WeAct-Adapter-5V-B_Cu.gbl, WeAct-Adapter-5V-B_Mask.gbs, WeAct-Adapter-5V-B_Silkscreen.gbo, WeAct-Adapter-5V-Edge_Cuts.gm1, WeAct-Adapter-5V-F_Cu.gtl, WeAct-Adapter-5V-F_Mask.gts, WeAct-Adapter-5V-F_Silkscreen.gto, WeAct-Adapter-5V-job.gbrjob]
2026-07-30 Add print-ready fixed ArUco marker pack
    [generate_fixed_aruco_print_pack.py, test_generate_fixed_aruco_print_pack.py]
2026-08-01 vision: track green PCB centroid
2026-08-01 feat: trigger Pixel recording from F413 LEDs
2026-08-01 fix: reject white motion in optical trigger
    [HfrRecorder.java, MainActivity.java, OpticalTriggerDetector.java]
2026-08-02 fix: require three simultaneous optical LEDs
    [HfrRecorder.java, MainActivity.java, OpticalTriggerDetector.java]
2026-08-02 fix(f413): harden optical capture and trace buffering
    [HfrRecorder.java, MainActivity.java, MotionGateDetectorHostTest.java, OpticalTriggerDetector.java, f413_hw.c, f413_hw.h]
2026-08-02 fix(vision): detect run motion from start-region change
    [HfrRecorder.java, MainActivity.java, MotionGateDetectorHostTest.java]
2026-08-02 fix(vision): extend optical capture arm timeout
2026-08-02 fix(vision): preserve Pixel continuous standby
    [MainActivity.java, test_collect_wifi_runs.py]
2026-08-02 Retune mode2 turns from axle-calibrated video
2026-08-02 Retune mode2 turns from trace-validated endpoints
2026-08-07 fix(vision): harden optical run tokens
    [MainActivity.java, OpticalTriggerDetector.java, f413_hw.c]
2026-08-08 feat(vision): track mouse center with blue label
2026-08-08 tune(f413): tighten mode2 small right turn
2026-08-08 fix(vision): harden repeated optical run sync
    [MainActivity.java, OpticalTriggerDetector.java, f413_hw.c, f413_path_run.c, f413_search_step.c, f413_uart_cli.c]
2026-08-08 fix(vision): distinguish optical start and stop tokens
    [HfrRecorder.java, MainActivity.java, OpticalTriggerDetector.java, f413_hw.c, f413_path_run.c, f413_search_step.c, f413_uart_cli.c]
2026-08-08 fix(vision): recover from noisy optical calibration
    [OpticalTriggerDetector.java]
2026-08-08 fix(f413): keep motors off during optical start
    [f413_control.h, f413_control_tune_run.c, f413_path_run.c, f413_search_step.c, f413_test_run.c, main.c]
2026-08-09 fix(vision): harden optical stop and add run finish
    [MainActivity.java, OpticalTriggerDetector.java, test_hfr_control.py, test_hfr_dashboard.py]
2026-08-09 Fix mode2 diagonal turn test paths
    [f413_mode2.c, f413_mode_shortest.c]
2026-08-10 Add read-only F413 maze fixture fallback
    [f413_route_preview.c, f413_route_preview_host_tests.c]
2026-08-10 Enable F413 diagonal shortest paths
    [f413_mode2.c, f413_mode3.c, f413_mode4.c, f413_mode5.c, f413_mode6.c, f413_mode7.c, f413_mode_shortest.c, f413_mode_shortest.h]
2026-08-11 Add clearance-aware turn tuning workflow
    [test_turn_clearance.py, turn_clearance.py, turn_tune.py]
2026-08-11 Refine measured turn clearance calibration
    [test_turn_clearance.py, turn_clearance.py]
2026-08-11 Add label-plane parallax calibration
2026-08-12 Bind turn calibration to the 2 mm marker plane
2026-08-12 Add full-board metric calibration
    [board_metric_observations.template.csv]
2026-08-14 Correct measured maze camera layout
    [probe_board_line_grid.py, test_board_layout.py, test_board_metric_geometry.py]
2026-08-14 Add F413 continuous motor gear break-in mode
2026-08-14 Record F413 gear break-in HIL
2026-08-15 Fix dashboard current-run stop state
    [test_hfr_control.py, test_hfr_dashboard.py]
2026-08-15 Fix F413 case0 terminal turn tests
    [f413_path_run.c, f413_path_run_linear_tests.c, f413_route_preview_host_tests.c]
2026-08-15 f413: retune mode2 large R90 clearance
    [f413_route_preview_host_tests.c, slalom_profile_baseline.c]
2026-08-16 Stabilize F413 diagonal 45 entry turn
    [f413_route_preview_host_tests.c, slalom_profile_baseline.c]
2026-08-16 fix(f413): credit path transition travel
    [f413_path_run.c, f413_path_run_linear_tests.c]
2026-08-16 fix optical trigger acquisition at maze endpoints
    [OpticalTriggerDetector.java, f413_hw.c]
2026-08-23 Retune mode2 V90 for lower lateral slip
    [slalom_profile_baseline.c]
2026-08-23 Defer trace flush through turn offsets
2026-08-23 Record V90 trace flush diagnosis
2026-08-23 Restore V90 after trace timing fix
2026-08-23 fix(f413): align first section to rear wall start
    [f413_path_run.c, f413_path_run_linear_tests.c, f413_route_preview.c, f413_route_preview_host_tests.c, params.h, slalom_profile_baseline.c]
2026-08-23 tune(f413): recalibrate encoder distance scale
2026-08-23 fix(f413): track distance through turn cores
    [f413_control.c, f413_control.h, f413_path_run.c]
2026-08-29 fix(f413): keep timed turn velocity constant
    [f413_control.c, f413_control.h, f413_path_run.c]
2026-08-29 fix(f413): isolate turn speed from lateral acceleration
    [f413_control.c, f413_control.h, f413_trace_sample.c, params.h]
2026-08-29 docs: record turn velocity estimator diagnosis
2026-08-29 fix(f413): reduce turn velocity feedback delay
    [f413_control.c, f413_trace_sample.c, params.h]
2026-08-30 Correct mini r3 debug power path record
2026-08-30 Record mini r3 Q2 power switch diagnosis
2026-08-30 Record mini r3 D5-fixed debug-power retest
2026-08-30 Correct mini r3 retest power state
2026-08-30 Record mini r3 bench-power retest
2026-08-30 Record mini r3 IMU thermal anomaly
2026-08-30 Record mini r3 replacement IMU retest
2026-08-30 Record successful mini r3 IMU retest
2026-08-30 Fix F413 IMU accelerometer range
    [f413_control.c, f413_imu_diag.c]
2026-08-30 Record mini r3 IMU range HIL
2026-08-31 Record mini r3 wall sensor HIL
2026-09-05 Record mini r3 motor encoder and fan HIL
2026-09-05 docs: record mini r3 motor PWM asymmetry isolation
2026-09-05 docs: record mini r3 zero-ohm SR motor retest
2026-09-05 fix(f413): match swapped mini r3 left motor leads
    [f413_control.c, f413_hw.c, f413_motor_pwm.h, f413_motor_pwm_tests.c, f413_test_run.c]
2026-09-06 fix(f413): account for mini r3 IMU mounting and add bounded bench checks
    [f413_control.c, f413_hw_diag.c, f413_hw_diag.h, f413_imu_diag.c, f413_machine.c, f413_machine.h, f413_machine_tests.c, f413_measurements.h]
2026-09-06 fix(f413): reject legacy test calibration and preserve active bench encoders
    [f413_diag.c, f413_hw_diag.c, f413_nvm_params_tests.c, nvm_params.c]
2026-09-06 docs(f413): record mini r3 provisional no-wall calibration and UI recovery
2026-09-06 Calibrate mini r3 front distance from body centre
    [front_centre_20260906.csv]
2026-09-06 Record mini r3 centre-reference front calibration HIL
2026-09-06 Add mini r3 body-centre side sensor distance tables
    [side_centre_20260906.csv]
2026-09-06 Record recurring sensor calibration overwrite diagnosis
2026-09-06 fix(f413): lock destructive NVM diagnostics in normal builds
    [f413_diag.c, f413_diag.h, f413_nvm_guard_tests.c, f413_trace_diag.c, f413_uart_cli.c]
2026-09-06 docs(hil): record exact mini r3 sensor recovery and NVM guard verification
2026-09-12 feat(params): recalibrate mini r3 wall LUTs after optical shielding
    [front_centre_20260912.csv, side_centre_20260912.csv]
2026-09-12 docs(hil): document shielded wall calibration and pending device update
2026-09-12 docs(hil): record mini r3 left motor nonresponse and safe handoff
2026-09-12 docs(hil): suspend mini r3 powered tests after idle U2 heating
2026-09-12 docs(hil): record mini r3 U2 unpowered diode measurements
2026-09-12 docs(hil): compare U2 and U3 diode readings and narrow repair checks
2026-09-15 docs(hil): assess solder-related U2 failure and next-board prevention
2026-09-15 docs(hil): assess omitted C21 reset filtering and prototype limits
2026-09-20 feat(f413): register mini r3 unit002 with standard wiring
2026-09-20 docs(hil): record unit002 LED confirmation and idle current
2026-09-20 Reinforce encoder board terminals with plated half-holes
    [HM_Nightfall-mini-2e_Encoder-PCB-L_v1.kicad_pcb, HM_Nightfall-mini-2e_Encoder-PCB-R_v1.kicad_pcb]
2026-09-20 Package left and right encoder PCB fabrication files
2026-09-20 Enlarge main PCB mounting holes to 1.6 mm and reroute traces
    [HM_Nightfall-mini-2e_v1.kicad_pcb]
2026-09-20 Package main PCB fabrication files with 1.6 mm mount holes
2026-09-20 docs(hil): record unit002 direction repeat and fan confirmation
2026-09-20 fix(f413): match unit002 left motor polarity to installed wiring
    [f413_machine_tests.c, f413_registry.c]
2026-09-20 docs(hil): verify unit002 corrected motor directions
2026-09-20 docs(hil): record unit002 wall calibration transfer and tuning gates
2026-09-20 docs(hil): record UART blocker before unit002 translation tuning
2026-09-20 tune(f413): add conservative r3 fan-off translation gains
2026-09-21 fix(f413): restore IMU-assisted velocity feedback for mini r3
    [f413_machine_tests.c, params.h]
2026-09-21 docs(hil): record IMU feedback restore and blocked SWD flash
2026-09-21 tune(f413): save user-accepted mini r3 2S fan-off gains
2026-09-21 docs(tuning): checkpoint r3 fan-off tune and front-wall reference audit
2026-09-21 calibrate(f413): extend mini r3 front-wall LUT to 110 mm
    [front_centre_20260921.csv, front_centre_extension_20260921.csv]
2026-09-21 fix(f413): terminate deceleration safely before front alignment
    [f413_control.c, f413_control.h, f413_control_stop_tests.c, f413_machine_tests.c, f413_motion_stop.h, f413_search_step.c, f413_stop_approach_tests.c, main.h]
2026-09-21 fix(f413): recover near-wall alignment with bounded retreat
    [f413_control.c, f413_control.h, f413_control_stop_tests.c, f413_machine_tests.c, f413_motion_stop.h, f413_search_step.c, f413_stop_approach_tests.c, params.h]
2026-09-21 fix(f413): hold starting pose before suction spinup
    [f413_control_stop_tests.c, f413_path_run.c, f413_suction_session_tests.c, params.h]
2026-09-21 fix(f413): remove suction startup timeout and ramp fan duty
    [f413_fan_pwm_tests.c, f413_hw.c, f413_hw.h, f413_path_run.c, f413_suction_session_tests.c, params.h]
2026-09-21 fix(f413): slow suction ramp and extend startup hold
    [f413_path_run.c, f413_suction_session_tests.c, params.h]
2026-09-21 fix(logging): normalize display units and remove scaled angular duplicates
    [export_plotjuggler_csv.py, test_trace_units.py]
2026-09-21 docs: record mode6 velocity feedback ceiling diagnosis
2026-09-21 fix(f413): honor run parameters and remove bring-up overrides
    [f413_control.c, f413_control_gain_tests.c, f413_control_velocity_tests.c, f413_machine_tests.c, f413_mode2.c, f413_mode2_dispatch_tests.c, f413_mode4_suction_tests.c, f413_mode6_suction_tests.c]
2026-09-22 docs: record post-limit suction velocity tracking diagnosis
2026-09-22 tune(mini-r3): improve suction heading tracking and yaw feedforward
2026-09-22 fix(f413): release suction hold feedback and bound test-stop settling
    [f413_control.c, f413_control_stop_tests.c, f413_path_run.c, f413_suction_session_tests.c, params.h]
2026-09-22 feat(mini-r3): configure suction modes 3 through 7 for staged tuning
2026-09-22 Retain F413 trace runs in FRAM and export per-run logs
2026-09-22 Extend F413 case0 large 180 turn run-up by 90 mm
2026-09-22 fix(logging): detect stale captures and verify per-run CSV output
    [serial_capture_csv.py, test_trace_retention.py]
2026-09-23 fix(f413): resolve all machine parameters through selected profile
    [check_f413_param_coverage.py, f413_machine.c, f413_machine.h, f413_machine_tests.c, f413_route_preview.c, f413_runtime_aliases.h]
2026-09-23 fix(f413): account for search processing travel between segments
    [f413_search_distance_tests.c, f413_search_step.c, params.h]
2026-09-23 test(tuning): match current firmware profile cap behavior
