xfa273/nightfall-fw/(notices)

Notices in the files:
platform/stm32f413/HM_Nightfall_f413_preorder/Core/Inc/main.h:
Copyright (c) 2026 STMicroelectronics.
All rights reserved.
This software is licensed under terms that can be found in the LICENSE file
parts and their libraries:
COPYRIGHT: Copyright (C) 2025 Ultra Librarian. All rights reserved.
pinheader_1m27: Copyright: Würth Elektronik
COPYRIGHT: Copyright (C) 2026 Ultra Librarian. All rights reserved.
